bruce2012lu/AIDCtms_design202609/coolingplate/design/cfd_grace_cpu/GRACE_CPU_ICEM网格方案_v1.0.md

# Grace CPU 冷却区 ICEM 网格方案 v1.0

对象是 CP-GRACE-MC-01 的 CPU 区共轭传热网格：水、底板铜、肋、盖板帽和 TIM。这里的流固耦合是共轭传热，固体要解导热，流体壁面要解出层流速度剖面。不是结构应力网格。

几何取自《NVIDIA Grace GB300 冷板详细设计报告》v1.0 第 4 节，以及 `CP-GRACE-MC-01_calc.py`、`make_grace_concept.py` 的 `closeup()`。内存宽槽、整板孔板和盖板分流腔不在这个计算域里。

## 1. 通道

CPU 窗口 X 80–120 mm、Y 44–76 mm，热流 260 W / (40 mm × 32 mm) = 203125 W/m²。槽宽 0.40 mm，深 1.20 mm，节距 0.80 mm，沿 Y 长 32 mm，共 48 条。肋宽 0.40 mm。`closeup()` 用 49 根肋把 48 条槽夹在中间，肋场宽 38.8 mm，在 40 mm 窗口里每侧余 0.60 mm。

水力直径 0.60 mm。CPU 分到 0.47 L/min 时，槽内 0.34 m/s，Re = 310，层流。入口延长和出口延长各 6.0 mm，等于 10 Dh，截面与槽相同。延长段不加热。

水按报告的 40 °C：992 kg/m³，4179 J/kg·K，6.53×10⁻⁴ Pa·s，0.632 W/m·K。铜按 C11000，390 W/m·K。TIM 厚 80 μm 不在 Grace 图里，先用 B300 共轭算例的 8.818 W/m·K，等 TIM 图再换。

## 2. 单通道计算域

一个内部节距，x = 0 和 x = 0.80 mm 在肋的中面，对称。槽壁在 x = 0.20 和 0.60 mm。

局部 y 从上游延长段的端面算起，流动沿 +y。和冷板坐标的关系是板面 Y = 82 − y。y = 6 mm 是槽入口，板面 Y = 76；y = 38 mm 是槽出口，板面 Y = 44。冷液从后侧进液腔一侧进入，从前侧离开。

| 块 | 范围 (mm) | 单元 | 分布 |
|---|---|---|---|
| 左半肋 | x 0–0.20 | 6 | 贴槽壁 20 μm，比 1.203 |
| 流体 | x 0.20–0.60 | 32 | 两侧壁 2.5 μm，比 1.190 |
| 右半肋 | x 0.60–0.80 | 6 | 与左半肋镜像 |
| 进口延长 | y 0–6 | 30 | 0.20 mm |
| 加热段 | y 6–38 | 160 | 0.20 mm |
| 出口延长 | y 38–44 | 30 | 0.20 mm |
| TIM | z −0.08–0，仅加热段 | 4 | 均匀 20 μm |
| 底板铜 | z 0–2.0 | 18 | 上下表面 20 μm，比 1.404 |
| 槽高 | z 2.0–3.2 | 44 | 底和顶 2.5 μm，比 1.191 |
| 盖板帽 | z 3.2–4.2 | 9 | 贴流体 20 μm，比 1.404 |

z 3.2–3.5 的分型密封面含在盖板帽里。盖板在 z = 4.2 mm 以上没有进网格，切面是绝热。这条槽的热量从芯片侧进来，多出来的盖板铜对芯片温升只有零点几开的量级。

单元数：流体 309760，肋 116160，底板 174240，盖板帽 87120，TIM 28160，合计 **715440**。小于 100 万。

msh 用米。ICEM replay 用毫米。不要把两者叠在同一个视图里。

## 3. 边界层为什么够共轭计算

B300 方案里驻点要求首层 ≤ 3 μm、y⁺ < 1、壁面法向 ≥ 10 层、增长 ≤ 1.2，槽宽 ≥ 8、槽深 ≥ 12，肋和余铜厚度方向 ≥ 6。Grace 这条槽没有射流驻点，Re = 310，按层流矩形槽来落这些数。

槽宽的一半是 0.20 mm。首层 2.5 μm、增长不超过 1.2 时，16 层刚好铺到中面，整宽 32 层，相邻比 1.190。槽深的一半是 0.60 mm，同样的首层得到 22 层，整深 44 层，比 1.191。层流的速度剖面就是整条法向，所以没有再在边界层外面接一套粗核心。

充分发展矩形槽（Shah & London，短边/长边 = 1/3）的壁面摩擦给出 y⁺ = 0.214。入口剪切按充分发展的 5 倍估计，y⁺ = 0.48。两数都小于 1。这是估算，不是 Fluent 打出的 y⁺。

固体不跟流体共用 2.5 μm。铜里 20 W/cm² 穿过 2 mm 底板大约 1 K，首层 20 μm、增长 ≤ 1.5、厚度方向不少于 6 层。流体和铜在界面上的法向尺寸可以差一截，界面本身共节点。

流向 0.20 mm，第一层单元的长宽比是 80。正交六面体的正交质量是 1。长宽比 80 对这条层流槽可以接受；若把流向收到 0.10 mm，单通道会超过 100 万。

热充分发展长度比 32 mm 还长，整段都在发展。0.20 mm 的流向步长够描述沿程 Nu，不够代替实验。

## 4. 边界

| 区域 | 类型 | 值 |
|---|---|---|
| inlet | 质量流入口 | 1.61888889×10⁻⁴ kg/s，313.15 K |
| outlet | 压力出口 | 表压 0 |
| sym | 对称 | x = 0 和 x = 0.80 mm |
| wall_heat | 热流 | 203125 W/m²，在 TIM 底面 |
| wall_cu_fluid | 双侧壁 | 铜–水共轭 |
| wall_tim_cu | 双侧壁 | TIM–铜共轭 |
| wall_adi | 壁 | 热流 0 |

一个节距上的加热功率是 5.20 W。48 个这样的节距是 249.6 W；窗口两侧多出来的铜在整列网格里，凑满 260 W。

进口面积核对过：1408 个面，0.480 mm²，等于 0.40 × 1.20。出口同样 1408。加热面和 TIM–铜界面都是 7040。四个润湿面（底、顶、两侧）合计 33440，与 32×220×2 + 44×220×2 一致。进口面法向指向域内 +y，出口指向域内 −y，加热面指向域内 +z。

层流。不要套 B300 射流那套转捩 SST。

## 5. 整列 48 槽

单通道 715440 < 100 万，所以整列按同一套壁面法向往下排。

| 项 | 值 |
|---|---|
| 肋 / 槽 | 49 根肋，48 条槽，肋场 38.8 mm，居中于 X 80–120 |
| 窗口内余铜 | 每侧 0.60 mm，受热 |
| 窗口外肩 | 每侧 2.0 mm，不受热，用来留横向扩热 |
| 域 | 板面 X 78–122，Y 38–82（含两端延长），z −0.08–4.2 |
| 流体 | 32 × 48 = 1536 列，14868480 单元 |
| 内部肋 | 47 × 12 列；两根外肋各 6 列，只在贴流体的一侧加密 |
| 铜 | 18652040 |
| TIM | 1360640，只铺在 40 mm 窗口的加热段 |
| 合计 | **34881160** |

整列的铜是连在一起的，横向扩热在网格里。每条槽仍然是各自的进口和出口，流量按 48 等分。盖板里的进液腔、出液腔和入口孔板没有建。腔对 48 条槽的分配不在这套网格里。

3488 万单元的 ASCII msh 大约几个 GB，这次没有写出文件。骨架和单元预算在 `icem/build_grace_cpu_array.rpl` 和 `icem/array_budget.txt`。流体首层、增长和流向步长与单通道相同。

## 6. 文件

| 文件 | 作用 |
|---|---|
| `mesh/write_grace_cpu_hex.py` | 分布、单元预算、写 msh 和 replay |
| `mesh/grace_cpu_channel.msh` | 单通道 Fluent 网格，115 MB，米 |
| `mesh/grace_cpu_channel_info.txt` | 单元数、首层、y⁺ 估算、分区面数 |
| `icem/build_grace_cpu_channel.rpl` | 单通道 80 个角点、184 条边，毫米 |
| `icem/build_grace_cpu_array.rpl` | 整列 102 条分块线，毫米 |
| `fluent/grace_cpu_channel_check.jou` | 读网格并 mesh/check |
| `fluent/grace_cpu_channel_setup.jou` | 层流、能量、材料、边界，不迭代 |

ICEM：打开已有的 ICEM，File → Replay Scripts → Replay，选 rpl。Replay 保存 tetin 和边的节点数，不在批处理里生成 71 万六面体。Fluent 读 msh，不要读 tin。

本机 `E:\cae\programfiles\Ansys2026` 下没有 `fluent.exe` 和 `icemcfd.bat`，所以没有 ICEM 质量报告，也没有 Fluent 的 mesh/check。上面的面数和法向是对 msh 本身核对的。正交质量还没有软件打印。

重新生成：

```
python mesh/write_grace_cpu_hex.py
```
