bruce2012lu/AIDCtms_design202609/coolingplate/design/cfd_grace_cpu/GRACE_CPU_交错流网格方案_v1.0.md

# Grace CPU 冷却区交错流网格方案 v1.0

对象是 CP-GRACE-MC-01 的 CPU 区共轭传热网格。流固耦合指铜和水一起解导热与层流，不是结构应力。

坐标按《NVIDIA Grace GB300 冷板详细设计报告》v1.0 第 4 节：原点在冷板左下角，X 沿托盘宽度，Y 沿托盘进深、朝后面板和 GPU，芯片面 z = 0 朝下。CPU 窗口 X 80–120、Y 44–76，即 40 × 32 mm。

平行方案的 48 条槽沿 Y 同向流，流体沿程温升约 8 K，铜板温差落在 Y 上。本方案把相邻槽改成对向流，用肋和底板里的横向导热把这条沿程温差抹平。平均对流温升仍约 12 K。下面的 0.026 K 是集总估算，不是 CFD 结果。

平行槽的网格和说明留在 `mesh/grace_cpu_channel.msh`、`GRACE_CPU_ICEM网格方案_v1.0.md`。当前算例是这一对交错槽。

## 1. 一对槽

局部坐标：x 沿节距，y 沿流向，z 向上。局部 y = 0 是板面 Y = 44，局部 y = 32 是板面 Y = 76。板面 Y = 44 + 局部 y。

一对宽 1.60 mm，是两个 0.80 mm 节距。24 对就是原来的 48 条槽。本网格只含一对，对称面在肋中面 x = 0 和 x = 1.60。整列 48 槽没有写出。

| 块 | 局部 x (mm) | 流向 |
|---|---|---|
| 左半肋 | 0–0.20 | 对称面在 x = 0 |
| 偶数槽 | 0.20–0.60 | +Y，从前侧流向后面板 |
| 整肋 | 0.60–1.00 | |
| 奇数槽 | 1.00–1.40 | −Y，从后侧流向托盘前侧 |
| 右半肋 | 1.40–1.60 | 对称面在 x = 1.60 |

槽宽 0.40 mm，深 1.20 mm（z 2.0–3.2），加热段长 32 mm。水按报告 40 °C。铜 C11000，k = 390 W/m·K。TIM 厚 80 μm，k = 8.818 W/m·K，沿用 B300 共轭算例，等 Grace 的 TIM 图再换。热流 203125 W/m² 只加在局部 y 0–32 的 TIM 底面。

## 2. 进出口和 Z 向汇流

槽端在 Y 向封死。流体从水平廊道进入，碰到封板后经竖孔落入槽道。回液反过来，从槽端竖孔升进廊道再水平离开。供液在靠窗口的一侧，回液在外侧，两条槽不会短路。

| 口 | 局部 y | 板面 Y | 占的半节距 | 流动 |
|---|---|---|---|---|
| 奇数槽出口 | −8 | 36 | x 0.80–1.60 | 离开，朝前 |
| 偶数槽进口 | −4 | 40 | x 0–0.80 | 进入，朝后 |
| 加热段 | 0–32 | 44–76 | | |
| 奇数槽进口 | 36 | 80 | x 0.80–1.60 | 进入，朝前 |
| 偶数槽出口 | 40 | 84 | x 0–0.80 | 离开，朝后 |

偶数槽流体在局部 y −2.5 到 37.5，两端是铜壁。奇数槽流体在局部 y −5.5 到 34.5，两端是铜壁。竖孔只占槽宽 0.40 mm，z 3.2–4.3。廊道占半个节距 0.80 mm，z 4.3–5.6，高 1.30 mm。盖板网格收到 z = 6.6，顶面绝热。冷板总厚仍是 8.0 mm，z 6.6 以上没有进这个计算域。

这两个廊道是槽端的局部转弯，不是报告里横贯整板的后侧进液腔和前侧出液腔。把 24 对连起来的供液轨、回液轨不在网格里。两个进口各给一条槽的设计流量，用来代表汇流已经配好。

## 3. 网格

全六面体，正交。msh 用米，ICEM replay 用毫米。不要叠在同一个视图里。

| 项 | 值 |
|---|---|
| 单元 | 2487936（流体 718464，铜 1741312，TIM 28160） |
| 分割 | x 88，y 304，z 96 |
| 流向相邻比 | 最大 1.678 |
| 文件 | `mesh/grace_cpu_counterflow_pair.msh`，407 MB |

槽的三个润湿方向都有边界层。槽宽、槽深的流体首层 2.5 μm，增长不超过 1.2。槽宽 32 层，槽深 44 层。铜和 TIM 的首层 20 μm，增长不超过 1.5，厚度方向不少于 6 层。四个 Y 向封板的两侧都是 2.5 μm，所以封板两边的格子对齐。廊道和盖板不是受热面，那里用 20 μm 起的固体分布。流向核心格 0.40 mm。第一层流向长宽比约 160。

平行槽那次按充分发展摩擦估过 y⁺ = 0.214，入口剪切按 5 倍估是 0.48。这条槽的截面、Re 和首层与那次相同，量级仍小于 1。这是估算，不是 Fluent 打出的 y⁺。

偶数槽和奇数槽的流体没有共面，短路面数是 0。四个口的面积都是 1.04×10⁻⁶ m²，等于 0.80 mm × 1.30 mm。加热面 5.12×10⁻⁵ m²，等于 32 mm × 1.60 mm。一对的加热功率是 10.4 W，24 对是 249.6 W；窗口两侧多出来的铜在整列里，凑满 260 W。

进口面法向已在写出时核对：偶数进口指向域内 +Y，奇数进口指向域内 −Y，偶数出口指向域内 −Y，奇数出口指向域内 +Y。

## 4. 边界

| 区域 | 类型 | 值 |
|---|---|---|
| inlet_even、inlet_odd | 质量流入口 | 各 1.61888889×10⁻⁴ kg/s，313.15 K |
| outlet_even、outlet_odd | 压力出口 | 表压 0，回流温度 313.15 K |
| sym | 对称 | x = 0 和 x = 1.60 mm |
| wall_heat | 热流 | 203125 W/m²，TIM 底面 |
| wall_cu_fluid | 双侧壁 | 铜–水共轭 |
| wall_tim_cu | 双侧壁 | TIM–铜共轭 |
| wall_adi | 壁 | 热流 0 |

层流。不要套 B300 射流那套转捩 SST。

算例在 `fluent/grace_cpu_counterflow_setup.jou`，只读网格、设材料、能量、层流和边界，不迭代。`fluent/grace_cpu_counterflow_check.jou` 只做 mesh/check。本机 `E:\cae\programfiles\Ansys2026` 下没有 Fluent / ICEM 可执行文件，这两个 journal 还没有跑过。

ICEM 骨架是 `icem/build_grace_cpu_counterflow.rpl`。用 File → Replay Scripts → Replay 打开，不要另起一个 icemcfd。Fluent 只读 msh。

## 5. 一维对照

`calc_counterflow.py` 的输出。Nu = 4.8 仍是三边受热矩形槽的假设。两次 90° 转弯各取 K = 1.5，是估算。

| 量 | 平行 Y，48 槽 × 32 mm | 交错 Y，同样 48 槽 × 32 mm |
|---|---|---|
| 槽内流速 | 0.340 m/s | 0.340 m/s |
| Re | 310 | 310 |
| 槽道压降 | 0.707 kPa | 0.707 kPa |
| 两次转弯 | | 另加 0.172 kPa |
| 对流温升 | 11.96 K | 11.96 K |
| 流体温升 | 8.01 K | 8.01 K |
| 铜的沿程温差 | 约 8 K，沿 Y | 集总估算相邻槽壁面差 0.026 K |

肋和 2 mm 底板在 0.80 mm 节距上的横向导热，远大于一条槽沿 32 mm 把 8 K 拉平所需要的轴向导热。轴向导热算下来，8 K 温差只能带走 0.156 W。所以交错流要靠相邻槽的横向耦合，不是靠铜把热量沿流向传回去。
