bruce2012lu/AIDCtms_design202609/coolingplate/design/cfd_grace_LLDDRM/GRACE_LPDDR_ICEM网格方案_v1.0.md

# CP-GRACE-MC-01 LPDDR 冷却区 ICEM 网格 v1.0

对象是 Grace 冷板左侧 LPDDR5X 窗口里的平行宽槽，不是 CPU 的 48 条 0.40 mm 微通道。单通道节距单元 693770 个六面体，低于 100 万，因此按同一套边分布做了整侧 6 槽阵列，4162620 个六面体。

网格是按 ICEM 六面体分块的边参数生成的直角结构网格。Replay 只建几何。本文件没有 ICEM GUI 质量签字，也没有 Fluent 求解，所以 y+ 是层流摩阻估算，不是求解器输出。

## 1. 依据

口径来自 `design/NVIDIA_Grace_GB300_冷板详细设计报告_v1.0_20260926.html` 和 `design/memory/semantic/cp-grace-mc01.md`。概念图 `make_grace_concept.py` 里的内存肋是加粗示意，不作为网格尺寸。

| 项 | 冻结值 |
|---|---|
| 窗口 | 左窗 X 14–64，Y 25–95，即 50 × 70 mm。右窗同一套网格，X 平移到 136 |
| 槽 | 6 条，宽 1.20 mm，深 0.80 mm，流向沿 Y，长 70 mm |
| 节距 | 50/6 = 8.333333 mm。报告写「约 8 mm」，这里把它铺满候选窗口 |
| 槽间铜 | 壁到壁 7.133 mm。节距单元两侧各半条肋，半肋 3.5667 mm |
| 高度 | z 0–2.0 底板；z 2.0–2.8 槽或肋；z 2.8–3.2 槽顶铜 0.40 mm。CPU 槽才用满 1.20 mm 到分型面 |
| 流量 | 单侧 0.036 L/min，单槽 9.920×10⁻⁵ kg/s。水按 40 °C |
| 热流 | 一侧 20 W / (50×70 mm) = 5714.29 W/m²，加在 z = 0 |
| 不在本域 | 每侧入口限流缝 0.80 × 1.20 mm。它在进液腔上游，本网格入口已经是缝后的槽流量 |

局部坐标：x = X − 14，y = Y − 25，z = z。入口在 y = 70（板坐标 Y = 95），出口在 y = 0（Y = 25），流动沿 −Y。

## 2. 流固耦合对边界层的要求

这里的流固耦合指共轭传热：流体与 C11000 铜共节点，热流和壁面剪切都由近壁网格积分，不用壁面函数。

| 判据 | 采用值 | 本网格 |
|---|---|---|
| 流体第一层 | 12 μm | 槽宽、槽深两侧都是 12 μm |
| 贴壁 y+ | < 1 | 包络流速估算最大约 0.73 |
| 流体法向增长率 | ≤ 1.20 | 宽向 1.178，深向 1.173 |
| 壁到中心的层数 | ≥ 10 | 半宽 14 层，半深 12 层 |
| 铜侧第一层 | 与流体同为 12 μm | 肋、底板、槽顶都是 |
| 铜侧离开湿壁的增长率 | ≤ 1.25 | 肋 1.250，底板 1.246，槽顶 1.173 |
| 界面 | 共形，无悬挂节点 | 同一套直角分块 |
| 正交 | 直角六面体 | 正交质量为 1，未做 ICEM 行列式检查 |
| 长宽比 | 流体 ≤ 35，固体 ≤ 40 | 流体 33.2，固体 35.5 |

y+ 用矩形槽 Fanning 摩阻（Shah & London，短边/长边 = 0.667，fRe = 14.715，Darcy fRe = 58.86）。水力直径 0.96 mm。第一层 12 μm。1.5 是层流矩形槽最大剪切相对平均剪切的估算系数，不是 CFD 结果。

| 工况 | 流速 | Re | y+ = 1 的高度 | 12 μm 的平均 y+ | 乘 1.5 后 |
|---|---|---|---|---|---|
| 分流 0.104 m/s | 0.1042 m/s | 152 | 28.7 μm | 0.42 | 0.63 |
| 报告表 0.11 m/s | 0.110 m/s | 160 | 27.9 μm | 0.43 | 0.64 |
| 包络 0.70/0.55 | 0.140 m/s | 204 | 24.8 μm | 0.48 | 0.73 |

包络仍低于 1。设计点是层流，不需要 SST 壁面函数；12 μm 是为了把粘性底层直接算出来。

## 3. 分块

一个节距，x 从肋中面到肋中面：

```
z=3.2   wall_cap（绝热）
        +---------------- 槽顶铜 solid ----------------+
z=2.8   |  半肋 solid  |  流体 1.20×0.80  |  半肋 solid  |
z=2.0   +---------------- 底板铜 solid ----------------+
z=0     wall_heat（5714.29 W/m²）

x:  sym | 3.5667 mm | 1.20 mm | 3.5667 mm | sym
```

阵列把这个节距重复 6 次，铺满 x = 0–50 mm。窗外是实铜而不是镜像槽，所以阵列两侧用绝热壁 `wall_side`，不用对称。单通道节距单元才用肋中面 `sym`。

流向一条块，0–70 mm。入口端第一格 0.080 mm，出口端 0.20 mm，增长率 1.10，核心格不超过 0.40 mm。

## 4. ICEM 边参数（毫米）

流体两条边是两端对称的几何级数，可以直接填进 Blocking → Edge Params。

| 边 | 节点数 | 起点间距 | 比 1 | 终点间距 | 比 2 |
|---|---|---|---|---|---|
| 槽宽 1.20 | 29 | 0.012 | 1.1779 | 0.012 | 1.1779 |
| 槽深 0.80 | 25 | 0.012 | 1.1725 | 0.012 | 1.1725 |
| 流向 70 | 188 | 0.20（出口） | 1.10 | 0.080（入口） | 1.10，格不大于 0.40 |

铜边从湿壁向外几何增长，第一层仍是 0.012。

| 边 | 节点数 | 湿壁间距 | 比 |
|---|---|---|---|
| 半肋 3.5667 | 22 | 0.012 | 1.250，格不大于 0.45 |
| 底板 2.0，加密在 z=2 | 18 | 0.012 | 1.2459 |
| 槽顶 0.40，加密在 z=2.8 | 13 | 0.012 | 1.1725 |

## 5. 单元数

| 网格 | 单元 | 流体 | 铜 | nx × ny × nz |
|---|---|---|---|---|
| 单通道节距 | 693770 | 125664 | 568106 | 70 × 187 × 53 |
| 左侧 6 槽阵列 | 4162620 | 753984 | 3408636 | 420 × 187 × 53 |

单通道低于 100 万，所以阵列用了同一套分布，没有再加粗。阵列约为 6 倍节距，两侧半肋在相邻节距上合成整肋。

## 6. Fluent 边界

单位是米。两个单元区：`fluid`、`solid_cu`（C11000，k = 385 W/m·K）。耦合壁两侧都有单元，类型是 wall。

| 区 | 类型 | 单通道 | 阵列 |
|---|---|---|---|
| inlet | mass-flow-inlet | 9.920×10⁻⁵ kg/s，313.15 K | 5.952×10⁻⁴ kg/s，313.15 K |
| outlet | pressure-outlet | 0 Pa | 0 Pa |
| wall_heat | wall | z=0，5714.29 W/m² | 同左 |
| wall_cap | wall | z=3.2，绝热 | 同左 |
| wall_end | wall | 铜在 y=0 和 y=70 的端面，绝热 | 同左 |
| wall_cu_fluid | wall，coupled | 槽底、槽顶、两侧壁 | 6 条槽的全部湿壁 |
| sym | symmetry | 两个肋中面 | 无 |
| wall_side | wall，绝热 | 无 | x=0 和 x=50 |

粘性用层流。能量打开。这是边界设置，不是已经算完的场。

## 7. 文件

| 文件 | 作用 |
|---|---|
| `mesh/lpddr_mesh.py` | 边分布、单元预算、Fluent msh、ICEM replay |
| `mesh/sizing_report.txt` | 单元数、增长率、y+ 估算 |
| `mesh/lpddr_channel_cht.msh` | 单通道共轭网格，米 |
| `mesh/lpddr_array_cht.msh` | 6 槽阵列共轭网格，米 |
| `icem/build_lpddr_channel.rpl` | 单通道几何 replay，毫米 |
| `icem/build_lpddr_array.rpl` | 阵列几何 replay，毫米 |
| `icem/lpddr_channel.tin` / `lpddr_array.tin` | ICEM 已写出的几何 |
| `icem/run_channel.bat` / `run_array.bat` | 调 ANSYS 2026 R1 ICEM 批处理 |

两条 replay 已在本机批处理跑通，许可证检出 `cfd_preppost`，并写出上面两个 tin。tin 是几何和 part 名。体积网格是 Fluent msh，按同一套边参数生成，不是 ICEM Blocking 里求出的网格。

## 8. 还没有做的

- ICEM 只保存了几何 tin，没有在 Blocking 里做行列式、角度和负体积签字。直角分块的正交性来自坐标轴对齐。
- 没有跑 Fluent，因此没有求解器 y+、热阻和压降。
- 入口限流缝和进、出液腔没有划进这个窗口。六条槽的流量按均分给定。
- 右窗不另做网格，把左窗 msh 的 X 加上 122 mm 即可。
