bruce2012lu/AIDCtms_design202609/coolingplate/design/cfd_HBM/mesh/hbm_array_info.txt

case array
nx 400
ny 143
nz 84
cells_fluid 1121120
cells_cu 3340480
cells_tim 216000
cells_total 4677600
ratio_x 1.1779
ratio_y 1.2000
ratio_z 2.0000
yplus_DP-A 0.455 Re 516.8 tau 1.392
yplus_DP-B 0.499 Re 620.2 tau 1.671
first_fluid_mm 0.008
first_solid_mm 0.016
Le_mm 11.4286
heated_cells_y 90
nodes 4908240
faces 14142494
msh D:\agents2026\agents2026\agents\AIDCtms\coolingplate\design\cfd_HBM\mesh\hbm_w08h20.msh
mdot_kg_s 3.30733333e-03
q_Wm2 205000.0
k_tim 8.818342
width_mm 11.0
zone interior 13750970
zone wall_cu_fluid 136136
zone wall_tim_cu 36000
zone inlet 7840
zone outlet 7840
zone wall_heat 36000
zone wall_adiabat 144320
zone wall_side 23388
