bruce2012lu/AIDCtms_design202609/coolingplate/design/cfd/uc01b_2.4x3.0/UC01b_ICEM_Fluent_工作方案_v1.0.md

# UC-01b 单孔单元胞 ICEM / Fluent 工作方案与计划

**文档编号：** AIDC-B300-CFD-UC01b-PLAN-001  
**版本：** v1.0  
**日期：** 2026-09-21  
**算例：** UC-01b　各向异性单孔流体 coupon  
**目录：** `design/cfd/uc01b_2.4x3.0/`  
**本文件性质：** 开工方案 + 执行计划。**不是**仿真结果报告。结果报告只能在 Fluent 至少跑出残差 / 监视器之后另写。

---

> **2026-09-25 已收敛并写盘（DP-A，网格不改）。** 9×12 = 108 孔/die，共 216。施加 q''=579282.4074074075 W/m²（57.92824074074075 W/cm²，名义 55.16975308641976 的 1.05 倍），单孔 ṁ=1.2249382716049385×10⁻⁴ kg/s（不加 5%）。`fluent/uc01b_cht_v2_n216_q105.cas.h5`（115480951 字节，12:15:11）与 `.dat.h5`（461963782 字节，12:15:19）。日志 `logs/fluent_cht_v2_n216_q105.log`：`8587  1.6618e-07  1.3524e-07  1.7518e-07  2.5383e-07  9.9436e-07  5.8504e-07  2.4913e-04`，随后 `8587 solution is converged`，`write-case-data` 完成。4 核 + GPU。omega=2.4913e-04 不是收敛判据。当前结果是这场：U=0.9824 m/s，Re_D=597.1。TIM 底 341.9327 K，静压差 1088.1265 Pa。

## 0. 结论（先读）

本算例只做 **一孔 + 三短槽 + ±X 回液缝上抽** 的流体单元胞，禁止整板 95×75 mm、禁止 128 孔共轭、禁止把槽当成「一条长河」的 bank 流。

| 冻结项 | 值 |
|---|---|
| 单元胞 | \(S_x=3.0\) mm（沿槽）× \(S_y=2.4\) mm（跨槽） |
| 孔径 | **D = 0.40 mm**（主方案）。`model.py` GEO 默认仍是 0.50 mm，本文凡引用一维带会同时给出 D=0.50 原值与 D=0.40 重算 |
| 间隙 / 槽 | H = 2.0 mm；槽 0.40×1.50 mm，节距 0.80 mm，中槽对孔 |
| 回液 | 物理缝宽 0.80 mm，落在 ±X 端，上抽。本胞各见半缝 0.40 mm（与 X 向邻胞共享） |
| 单孔质量流 | **ṁ = 1.2249382716049385×10⁻⁴ kg/s** ＝ GPU 1.60 L/min ÷ 216 孔（DP-A，iter 8587）。**不是** 2.0 L/min/孔 |
| 工质 | DI 水 40 °C，常物性 |
| 第一案模型 | **层流必跑**（Re_D = 597.1）。SST 低 Re 为包络，有时间再跑 |
| 网格 | 首层 ≤ 3 μm，目标 y⁺ < 1；hex 优先，目标 0.8–2.5 M；hex blocking 过难则 tet/prism 并声明 |
| 整板压降窗 | **20 kPa 是冷板本体窗，不含 UQD** |
| 四步流程 | ① 本方案 → ② ICEM 几何+网格 → ③ Fluent 计算（必做）→ ④ 结果报告 HTML+MD |

ANSYS 本机根：`E:\cae\programfiles\Ansys2026`。实际版本树为 **2026 R1 / v261**：

- `AWP_ROOT261` = `E:\cae\programfiles\Ansys2026\ANSYS Inc261\v261`
- ICEM：`...\v261\icemcfd\win64_amd\bin\icemcfd.bat`
- Fluent：`...\v261\fluent\ntbin\win64\fluent.exe`

---

## 1. 目标、范围、非目标

### 1.1 目标

1. 用 ICEM 建出与 `calc/model.py` GEO + `UC01_壁面射流与三槽流路说明.html` / `fig_walljet.py` 对齐的 **单孔流体域**。
2. 打出可被 Fluent 读入的网格（优先结构化 hex：孔 O-grid + 槽 H 网格；不行则 tet/prism）。
3. 用 TUI journal 启动 Fluent：**层流、水 40 °C、ṁ = 1.224938e-4 kg/s、回液缝压力出口**。已收敛场是 iter 8587。
4. 至少得到残差曲线和若干监视器（ΔP、若可能则 wall_imp 面平均 h）。不要求过夜收敛。
5. 用实测残差/监视器写结果报告。禁止编造云图或「已收敛」的 Nu。

### 1.2 非目标（本周禁止）

- 95×75 mm 整板、128 孔、HBM 槽、静压箱+水嘴全模。
- 用本单元胞 h 外推整板 R_θ,c-in（设计报告 v2.0 §10.3）。
- 1/4 对称（进出口沿程不对称，报告已禁）。
- 长槽 bank 流（全流量单向穿全部槽）。真实拓扑是 **单孔就近排走**。
- PG25、热点 2.5×、堵塞 20%（C08–C10）。
- 把 2.0 L/min 当成单孔流量。
- 把 20 kPa 当成「含 UQD 的机柜接口压降」。

### 1.3 读者与责任

| 角色 | 责任 |
|---|---|
| Agent | 写方案、ICEM replay/Tcl、Fluent journal、批处理、日志、对照表；不得编造未跑出的场 |
| 人（仿真） | 许可证、ICEM GUI 救阻塞、目视网格、过夜收敛、是否开 SST |
| 人（热设计） | 出口定义若要改口、D=0.40 是否回写 GEO |

---

## 2. 几何冻结表

坐标系：原点在中槽底面中心；**+X 沿槽 / 平行槽**；**+Y 跨槽 / 垂直槽**；**+Z 向上**（射流 −Z 打到壁面）。

### 2.1 与代码 / 说明页的对照

| 量 | 符号 | UC-01b 本算例 | `model.py` GEO 默认 | 出处 |
|---|---|---|---|---|
| 沿槽节距 | S_x | **3.0 mm** | S_jet = 3.0 mm | 用户冻结；GEO |
| 跨槽节距 | S_y | **2.4 mm** | （原说明页曾按 3.0 画顶视） | 用户冻结；三槽刚好装满 |
| 孔径 | D | **0.40 mm** | 0.50 mm | 用户最近取值；说明页 UC-01b |
| 间隙（盖下表面→肋顶） | H | 2.0 mm | H_jet = 2.0 | GEO |
| H/D | — | **5.0** | 4.0 | 派生 |
| S_x/D，S_y/D | — | **7.5，6.0** | 6.0，6.0（按 S=3、D=0.50） | 派生 |
| 相对喷嘴面积 f | A_jet/(S_x S_y) | **0.01745** | 0.02182（D=0.50、S=3×3） | 派生 |
| 盖板厚 | t_lid | 2.5 mm（流体域建孔段；固体可切） | 2.5 | GEO |
| 短静压箱 | H_plenum | ≥ 2.0 mm（≥5D，能建就建） | 计划建议 ≥4D | 本方案 |
| 槽宽 × 槽深 | ch_w × ch_h | 0.40 × 1.50 mm | 同左 | GEO / fig_walljet |
| 槽节距 / 肋厚 | ch_p / rib | 0.80 / 0.40 mm | 同左 | GEO |
| 回液缝物理宽 | w_slit | 0.80 mm | 同左 | fig_walljet `SLIT` |
| 本胞可见半缝 | w_slit/2 | **0.40 mm**（±X 各一条） | 说明页「周期缝本胞各见一半」 | 冻结 |
| 余铜 | t_base,cu | 不建（流体-only） | 2.0 mm | UC-01；UC-02 才共轭 |

### 2.2 Y 向三槽装填（必须 2.4 mm 刚好）

`3×槽 + 2×满肋 + 2×半肋 = 3×0.40 + 2×0.40 + 2×0.20 = 2.40 mm`。

| Y 区间 (mm) | 零件 | 说明 |
|---|---|---|
| [−1.20, −1.00] | 半肋（周期/对称面） | 邻胞共享 |
| [−1.00, −0.60] | 侧槽 − | 中心 Y = −0.80 |
| [−0.60, −0.20] | 满肋 | |
| [−0.20, +0.20] | **中槽** | 正对孔 |
| [+0.20, +0.60] | 满肋 | |
| [+0.60, +1.00] | 侧槽 + | 中心 Y = +0.80 |
| [+1.00, +1.20] | 半肋（周期/对称面） | 邻胞共享 |

侧槽中心距孔轴 r = 0.80 mm ≈ **2.0 D**，落在壁面射流扫过带（说明页图 2）。

### 2.3 X 向回液与槽长

| X 区间 (mm) | 零件 |
|---|---|
| [−1.50, −1.10] | −X 半缝（上抽） |
| [−1.10, +1.10] | 三槽 + 间隙主体（槽长 2.20 mm） |
| [+1.10, +1.50] | +X 半缝（上抽） |

若有人要求「缝宽 0.80 全部落在本胞、不与 X 邻胞共享」，记为备选 **UC-01b-isolated**，本方案不采用。

### 2.4 Z 向堆叠（流体-only coupon）

| Z (mm) | 域 | 网格要点 |
|---|---|---|
| 0 → 1.50 | 三槽腔 + 两端回液缝根部 | 槽底 = wall_imp（中槽驻点在此） |
| 1.50 → 3.50 | 间隙 H=2.0；肋顶是壁面射流贴壁面 | 肋顶加密 |
| 3.50 → 6.00 | 盖板孔段 ⌀0.40，长 2.5 mm | 轴向 ≥ 8 层；径向 ≥ 8–12 |
| 6.00 → 8.00 | 短静压箱 ≥ 2 mm | 顶面 = inlet_jet |

固体铜、盖板实体、余铜 **第一案不建**。

### 2.5 流路（禁止改口）

**下射 → 驻点 → 壁面射流沿 ±X（并扫入侧槽）→ 回液缝向上抽走。**

- ① 自由射流：孔内 / 间隙中尚未撞壁，方向 −Z。
- ② 驻点：仅中槽底正对孔。
- ③ 壁面射流：转 90° 后贴肋顶 / 槽口的薄剪切层，**不是**槽底导管流。
- 回液：±X 端缝向上。Y 向邻孔在 Y=±1.2 mm 相遇，预期 **喷泉 / 上洗**。

### 2.6 命名零件（ICEM parts = Fluent zones）

| Part | 类型 | 位置 |
|---|---|---|
| `inlet_jet` | mass-flow-inlet | 静压箱顶（或孔顶，若未建箱） |
| `wall_orifice` | wall | 孔圆柱壁 |
| `wall_lid` | wall | 盖板下表面（间隙顶，除孔外） |
| `wall_imp` | wall，等温建议 50 °C | 槽底 + 驻点铜壁 |
| `fin` | wall | 肋侧壁 + 肋顶 |
| `return_slot` | pressure-outlet | 两条回液缝顶面（上抽出口） |
| `periodic_y` 或 `SYM` | periodic 或 symmetry | Y = ±1.2 mm |
| `fluid` | cell zone | 全部流体 |

X 向两端是回液出口，**不是**周期面。

### 2.7 D = 0.40 而不是 0.50

主方案锁定 **D = 0.40 mm**。仅当 ICEM 孔周 O-grid 在 0.40 上数值病态（边长比极端、负体积）时，允许先用 0.50 调试 blocking，但必须：

1. 在日志里写明原因；
2. **仍然交付 0.40 的 replay / 网格作为主文件**；
3. 不得把 0.50 网格的 Nu 当成 0.40 结果。

本方案判断：0.40 与槽宽同量级，blocking 并不比 0.50 更难，**不换直径**。

---

## 3. 水力 / 热力锚点（DP-A）

工质 DI 水 40 °C（`WATER40`）：ρ = 992.2 kg/m³，μ = 6.53×10⁻⁴ Pa·s，k = 0.631 W/m·K，c_p = 4179 J/kg·K，Pr = 4.325。

### 3.1 流量拆分（不得读错）

| 量 | 值 | 含义 |
|---|---|---|
| 冷板总流量 | **2.00 L/min** | DP-A 整板，**不是单孔** |
| GPU 份额 | 80% → **1.60 L/min** | `SPLIT_GPU` |
| HBM 份额 | 0.40 L/min | 本单元胞不建 |
| 孔数 | **216**（9×12 × 2 die） | iter 8587 的阵列 |
| 单孔体积流 | 1.60 / 128 = **0.0125 L/min** | |
| 单孔质量流 | 992.2 × (1.60/60000) / 216 = **1.224938×10⁻⁴ kg/s** | Fluent 入口，iter 8587 |

176 孔备选：ṁ = 1.503×10⁻⁴ kg/s。本算例 **不用**，除非书面改口。

### 3.2 射流状态（同一 ṁ，不同 D）

| | D = 0.50（GEO / 报告 §9） | **D = 0.40（本算例）** |
|---|---|---|
| U | 1.061 m/s | **0.9824 m/s**（iter 8587） |
| Re_D | 806 | **597.1** |
| 孔口 ΔP（K=1.8） | 1.01 kPa | **2.45 kPa** |
| Martin 有效域 | Re < 2000，外推 | **仍 < 2000，仍外推** |

V4 锚定（本几何、D=0.40）：把 ṁ 放到 Re_D = 3000 → ṁ ≈ 6.15×10⁻⁴ kg/s，V ≈ 4.94 m/s。**不是运行点**，本周不必跑；G3 关闭前不得把设计点 Nu 当成已锚定。

### 3.3 一维对照带（阶段 4 的尺子）

设计报告乐观/保守带按 **D=0.50、S=3×3、Re=806** 算出：

| 模型 | h 或 h_eff | 对流热阻 | 说明 |
|---|---|---|---|
| 乐观 Martin 面平均 | 51470 W/m²K | 0.0128 °C/W | Re 外推 |
| 保守 短槽+驻点核 | 27460 W/m²K | 0.0241 °C/W | h_ch≈6379，h_stag≈32181 |
| 目标 R_θ,c-in | — | 整板 0.028 °C/W | 单元胞 **不可比** |

Re_D=597.1，低于 Martin 1977 的 Re≥2000，不引用 Martin 的 h。  
**本周可比：** 孔口 ΔP 量级（对 2.45 kPa）、wall_imp 面平均 h 是否落在数万 W/m²K、层流残差是否下降。  
**本周不可比：** 整板 R、歧管 3–5 kPa、128 孔流量偏差。

### 3.4 必须写在方案里的两句约束

1. **20 kPa 是冷板本体压降窗（目标 18、上限 20），不含 UQD / 快接头。** 单元胞孔口只有约 1–3 kPa，对不上 20 kPa 是正常的。
2. **2.0 L/min 是整板总流量。** 单孔 0.0125 L/min。把 2.0 填进 mass-flow-inlet 视为本计划失败。

---

## 4. ICEM 工作流

顺序锁死：**几何 → 命名 parts → blocking → 生成网格 → 质量表 → 写出 Fluent msh**。不得先加密再补面名。

### 4.1 几何

优先在 ICEM 内用点/线/面/体素构造（便于 replay），不必先经过整板 STEP。

1. 建外盒与半缝、三槽腔、间隙、孔圆柱、短静压箱。
2. 布尔得到单一流体体。
3. 尺寸与 §2 误差 < 0.01 mm。
4. 孔必须是圆；第一案可用等面积方孔（边长 0.3545 mm）作 **应急网格**，但 ICEM 主文件仍应建圆孔。

批处理：

```bat
set AWP_ROOT261=E:\cae\programfiles\Ansys2026\ANSYS Inc261\v261
set AWP_ROOT=%AWP_ROOT261%
"%AWP_ROOT261%\icemcfd\win64_amd\bin\icemcfd.bat" -batch -script build_uc01b.rpl
```

GUI：ICEM → File → Replay Scripts → Replay / 打开本目录 `.rpl`。

### 4.2 Parts

按 §2.6 建 family。导出前用 `ic_geo_set_part` / blocking association 对齐，避免 Fluent 里出现 `wall.1` 匿名面。

### 4.3 Blocking（hex 优先）

| 区域 | 拓扑意图 |
|---|---|
| 孔 + 静压箱 | O-grid，径向 ≥ 8–12，轴向 ≥ 8 |
| 间隙 | H 网格，法向 ≥ 20；肋顶第一层 ≤ 3 μm |
| 三槽 | 各一条砖，槽宽 ≥ 8 层，槽深几何增长 |
| 回液缝 | 竖向砖，与槽端 1:1 对接 |
| Y 边界 | 半肋处周期或对称，两侧点数必须一致 |

若 O-grid 关联失败：改 tet + 壁面 prism（首层仍 ≤ 3 μm），在日志写明「非 hex」，**不要假称已做结构化质量检查**。

### 4.4 网格指标

| 指标 | 目标 | 第一案可接受 |
|---|---|---|
| 壁面第一层 | ≤ 3 μm | 必须 |
| 驻点法向层数 | ≥ 15 | ≥ 10 可开算，报告注明 |
| 孔径向 | ≥ 8–12 | 8 |
| 孔轴向 | ≥ 8 | 8 |
| 间隙法向 | ≥ 20 | 12 |
| 单元数（hex） | 0.8–2.5 M | 为出残差可先 0.2–0.8 M，正式套再加密 |
| 正交质量 | min > 0.15 | 负体积 = 失败 |
| y⁺（设计点） | < 1 | 用 V=1.66 m/s 估：3 μm 大约 y⁺≈0.5–1.2 |
| y⁺（V4 Re=3000） | < 1 | 速度×3，可能要 1 μm；本周可不跑 V4 |

粗/中/细 1 : 1.5 : 2.25 是 G2 关闭条件，不是第一次出残差的条件。

### 4.5 质量门（未跑 ICEM 不得声称已检查）

必须留下：单元数、min/max 正交、负体积数、第一层厚度、导出 `.msh` 路径。许可证或 GUI 挡住时，保留脚本 + 完整错误日志。

---

## 5. Fluent 设置（必做，不是可选项）

### 5.1 启动

```bat
set AWP_ROOT261=E:\cae\programfiles\Ansys2026\ANSYS Inc261\v261
"%AWP_ROOT261%\fluent\ntbin\win64\fluent.exe" 3ddp -t8 -g -i fluent\uc01b_laminar.jou
```

核数不得超过许可证。许可证失败必须原文记入日志，不得改写成「已算完」。

### 5.2 模型

| 项 | 第一案（必跑） | 第二案（有时间） |
|---|---|---|
| 名称 | UC-01b-L-1008 | UC-01b-S-1008 |
| 状态 | 稳态、不可压、双精度 | 同左 |
| 粘性 | **层流** | k-ω SST 低 Re / 增强壁面 |
| 能量 | 开（为了 h） | 开 |
| 工质 | 水，常物性 40 °C | 同左 |
| ṁ | 1.224938e-4 kg/s | 同左 |
| T_in | 313.15 K | 同左 |
| 出口 | return_slot，P_gauge = 0 | 同左 |
| wall_imp | 等温 323.15 K | 同左 |
| 其他壁 | 绝热 | 同左 |
| Y 面 | 先 SYM，后可改 periodic | 同左 |
| 迭代 | 50–200 步即可交差；过夜收敛另排 | 同左 |

γ-Re_θ 本单元胞不强制。

### 5.3 边界与 ṁ

- `inlet_jet`：mass-flow-inlet，ṁ = **1.224938e-4 kg/s**，垂直于面，T = 313.15 K。施加 q''=579282.41 W/m²。
- `return_slot`：pressure-outlet，0 Pa（表压），回流 T = 313.15 K。
- 禁止把 2.0 L/min 或 1.60 L/min 整支路填进单孔入口。

### 5.4 监视与提取

1. 连续性 / x,y,z 动量残差。
2. 能量残差（若开能量）。
3. 入口平均静压（相对出口 ≈ 孔+弯+缝 ΔP）。
4. 质量不平衡。
5. 若能量已开：`wall_imp` 面平均 h（参考 T = T_in）。

写出：`fluent/residual.out`、`fluent/monitors.csv`、`fluent/uc01b_L.cas.h5`（或 `.cas`）。  
**未迭代出的云图不得出现在结果报告里。**

### 5.5 收敛（过夜标准，本周不强制）

报告 §10.8：连续/动量 < 1e-4，能量 < 1e-6；h 与 ΔP 连续 500 步漂移 < 0.5%；质量不平衡 < 0.1%。  
本周成功定义：journal 能启动 + 至少数十步残差落盘。残差仍高必须照实写。

---

## 6. 闸门 G0–G4

前一扇门不关，后一扇门的「结论」不得宣布。脚本可以提前写。

| 闸门 | Go 条件 | 未满足时允许 | 禁止 |
|---|---|---|---|
| **G0 环境** | 找到 ICEM 与 Fluent 可执行文件；许可证能 checkout ≥ 4 核 | 写方案、写脚本、写几何 | 声称「CFD 已完成」 |
| **G1 几何** | 尺寸 = 冻结表，parts 名齐全 | 改 replay | 进入「网格已合格」 |
| **G2 网格** | 有 `.msh`；无负体积；第一层 ≤ 3 μm 或声明未达；单元数已记录 | 粗网格开 Fluent 出残差 | 声称 y⁺ 已检查（若求解器没跑） |
| **G3 短算** | Fluent 层流至少起步，残差/监视器落盘 | 写真实残差 | 编造 Nu、云图、过夜收敛 |
| **G4 与 1D 对照** | 报出 ΔP 与（若有）h；对照 §3；层流 vs SST 若只跑了层流必须声明 | 指出超带原因 | 改孔径/槽深、外推整板 R |

设计报告还有 G5 扩阵（8×8），本算例不做。

V4（Re≈3000 对 Martin <15%）仍是科学锚，本周不作为交货门；G4 只能说「设计点包络的起步」，不能说「Martin 已锚定」。

---

## 7. 风险

| 编号 | 风险 | 等级 | 缓解 |
|---|---|---|---|
| RK-Y1 | **Y=±1.2 mm 喷泉 / 上洗**。Sy/2 只有 3D，邻孔壁面射流在周期/对称面相撞，侧槽分流与 h 会被抬或被歪 | 高 | Y 面先 SYM（强制喷泉，与周期阵列一致）；结果里必须讨论；不得把 UC h 当整板边缘孔 |
| RK-Re | Re_D=597.1 < Martin 下限 2000（iter 8587） | 高 | 本周只报数字与带宽；V4 另案 |
| RK-HEX | 圆孔 + 三槽 + 半缝的 hex blocking 在纯 Tcl 下极易失败 | 中 | replay 先求「能出网格」；失败则 tet/prism 或等面积方孔应急 hex，日志诚实 |
| RK-LIC | 许可证拒绝 ICEM hexa / Fluent | 高 | 全文保留错误；不改写成成功 |
| RK-BC | 把回液缝建成 X 周期，或建成沿槽长出流（bank） | 高 | parts 名写死；flow 只许上抽 |
| RK-Q | 入口误填 2.0 L/min | 高 | journal 写死 1.224938e-4；方案 §3.4 |
| RK-dP | 用单元胞 ΔP 去对 20 kPa | 中 | 20 kPa 不含 UQD，且含歧管；单元胞只对孔口 kPa 量级 |
| RK-y+ | 3 μm 在驻点可能贴着 y⁺≈1，V4 会超 | 中 | 设计点先跑；V4 再减首层 |
| RK-RPL | 未在 GUI 录过的 replay 一改拓扑就断 | 中 | 人可录一条黄金 replay；Agent 只改参数 |

开放项（本方案已给默认，改口须书面）：

| 编号 | 默认 |
|---|---|
| O-01 出口 | ±X 半缝上抽 = UC-01b。不用环缝、不用槽端水平出流 |
| O-02 网格器 | ICEM hex 优先；失败 tet/prism 或应急笛卡尔 hex |
| O-03 Y 边界 | 先 SYM，后 periodic |
| O-04 孔数 | 128。不用 176 |
| O-05 孔径 | 0.40 mm 主文件 |

---

## 8. 成功判据（对 1D 的 h、ΔP）

| 提取 | 和谁比 | 本周通过线 |
|---|---|---|
| 残差文件存在 | — | journal 启动且迭代 ≥ 1 |
| 质量不平衡 | 0 | 能报出来就写；< 0.1% 是过夜线 |
| 入口–出口 ΔP | D=0.40、K=1.8 → **2.45 kPa** | 量级 0.5–8 kPa 可讨论；差一个数量级先查出口 |
| wall_imp 面平均 h | 报告带 2.7e4–5.1e4（D=0.50）；本几何 Martin 外推 ~6.5e4 | 能提取就对照；提取失败如实写 |
| 层流 vs SST | 差 >20% 只给区间 | 本周只跑层流则声明「无 SST 包络」 |
| 整板 R_θ,c-in | 0.0202–0.0355 °C/W | **禁止用本算例关闭** |

---

## 9. 文件树

```
design/cfd/uc01b_2.4x3.0/
  UC01b_ICEM_Fluent_工作方案_v1.0.html
  UC01b_ICEM_Fluent_工作方案_v1.0.md          ← 本文件
  README.md
  icem/
    build_uc01b.rpl / build_uc01b.tcl
    uc01b.prj, .tin, .blk, .uns            （跑通才有）
  mesh/
    write_hex_msh.py                       （应急笛卡尔 hex）
    uc01b.msh                              （跑通才有）
  fluent/
    uc01b_laminar.jou
    uc01b_sst.jou                          （可选）
    residual.out / monitors.csv            （跑通才有）
  logs/
    ansys_paths.txt
    icem_batch.log
    fluent_batch.log
  UC01b_ICEM_Fluent_结果报告_v1.0.html       ← 步骤 4，Fluent 起步后才写
  UC01b_ICEM_Fluent_结果报告_v1.0.md
```

---

## 10. 谁跑什么、工时

| 步骤 | 内容 | 谁 | 工时 |
|---|---|---|---|
| 1 | 本方案 HTML+MD | Agent | 1–1.5 h |
| 2a | ICEM 几何 + replay | Agent | 3–6 h（hex 上限） |
| 2b | 批处理出 msh；失败则 tet 或应急 hex | Agent；人救 GUI | 1–3 h |
| 2c | 网格 QA 表 | Agent 摘日志；人看切面 | 1–2 h |
| 3a | Fluent 层流 journal + 短残差 | Agent 批处理 | 1–3 h |
| 3b | SST 包络 | Agent / 人 | +1–2 h（可选） |
| 3c | 过夜收敛 | 人 | 另排，本周不占 |
| 4 | 结果报告 HTML+MD（只写真实输出） | Agent | 1–2 h |
| **合计（本周最小闭环）** | | | **约 8–16 h** |
| 正式三套网格 + V4 + SST | | | 再 +1–2 工作日 |

---

## 11. 执行顺序（冻结，四步）

1. **方案+计划**（本 HTML / 本 MD）写完并自检目录、闸门、ṁ、20 kPa、2.0 L/min。
2. **ICEM 几何 + 网格**。批处理优先；失败留日志。不得在无网格时写结果报告。
3. **Fluent 计算（必做）**。层流第一。即使只跑几十步，也要残差文件。
4. **结果报告 HTML+MD**。只引用步骤 3 的文件。没有残差就还不能写第 4 步。

---

## 12. 与既有文档的关系

| 文档 | 关系 |
|---|---|
| `calc/model.py` | 数值唯一源。本算例 D、S_y 按用户冻结覆盖 GEO |
| 设计报告 v2.0 §9 / §10 | Q1 局部 h 的需求规格；C01 整板不在本周 |
| `CFD-AI_Agent_能力评估与工作计划_v1.0` | 能力边界与 G0–G5；本文件是 UC-01b 的开工令 |
| `UC01_壁面射流与三槽流路说明.html` | 流路与三区；S_y 已从 3.0 收到 2.4 |

---

*AIDCtms / coolingplate / design / cfd / uc01b_2.4x3.0 · 工作方案 v1.0 · 2026-09-21*  
*保证点 DP-A 1100 W @ 2.0 L/min（整板）· GPU 1.60 L/min / 216 · ṁ_jet = 1.224938e-4 kg/s · iter 8587*  
*20 kPa 冷板窗不含 UQD。本文不是仿真报告。*
