bruce2012lu/AIDCtms_design202609/coolingplate/design/cfd/uc01b_2.4x3.0lessmesh/memory/semantic/uc01b-lessmesh-bc216.md

# UC-01b lessmesh 216 孔边界

- confidence: 0.85
- valid_until: 2026-12-31
- last_verified: 2026-09-25
- expired: false

当前设计场是 `fluent/uc01b_cht_less_bc216.cas.h5`，iter 421，`solution is converged`。`inlet_jet` 是单孔，质量流 **1.225e-4 kg/s**（未乘 108/216）。`wall_heat` 热流 **579282 W/m²**。Y 向胞 2.4 mm，未重划网格。静压降 **1091.51 Pa**。TIM 底 **342.096 K**。窗口在质量流报告 TUI 报错后退出（`set-batch-options` 遇错退出），场已在报错前写完。
