bruce2012lu/AIDCtms_design202609/coolingplate/design/cfd_grace_cpu/NVIDIA_Grace_GB300_冷板详细设计报告_v1.0_20260926.html

COLD PLATE DETAILED DESIGN · GRACE ON GB300 NVL2

# NVIDIA Grace GB300 冷板详细设计报告

一颗 Grace 一块铜。平行微通道覆盖 CPU 裸片，宽槽覆盖两侧 LPDDR5X。型号 CP-GRACE-MC-01。

AIDC-GRACE-CP-MC-001 v1.0 · 2026-09-26 单相水 · 紫铜 · 两层 300 W 含内存 候选外形 · 待盖板图

## 0. 结论

GB300 计算托盘上的 Grace 用一块独立的两层铜冷板，型号 CP-GRACE-MC-01。热设计点 300 W，已经包含 LPDDR5X。CPU 区走平行微通道，内存区走低速宽槽，板上不设微射流。进液口在板的左侧，出液口在右侧，从后面板沿 PCB 两侧绕过来，不穿过 B300 冷板。

300 W单颗 Grace，含内存

0.55 L/min设计流量 · 温升约 8 K

10 kPa支路压降目标，靠入口孔板配平

2 块 / 托盘每块 NVL2 一颗 Grace

这一版能冻结的，和还不能冻结的：功率、工质、流路拓扑、和 B300 冷板的水力关系可以冻结。平面外形、裸片窗口、螺孔还没有官方盖板图，下文尺寸凡是标「候选」的，等 ICD 替换，不作为加工发放尺寸。

## 1. 范围与口径

项 | 口径
对象 | Lenovo GB300 NVL72 计算托盘上的一颗 NVIDIA Grace。一块冷板盖住该颗 CPU 及其板载 LPDDR5X。
数量 | 每块 GB300 NVL2（一块 HPM）一颗 Grace、一块冷板。一个计算托盘两块。不覆盖 B300、CX-8、NVSwitch。
来源底账 | 参考摘录。功率以 Lenovo Press LP2357 为准。
不用的口径 | Grace CPU Superchip 的约 500 W 模块；Grace C1 的 140–250 W 档；宣传材料里的内存约 16 W；B300 冷板的 1100 W / 2.0 L/min / 128 孔。
核算 | 一维水力，脚本 CP-GRACE-MC-01_calc.py。对流用充分发展矩形槽 Nu = 4.8 的假设。这是方案筛选用的数量级，不是 CFD 证明。

## 2. 热源

项 | 设计采用 | 置信度
整板功率 | 300 W，Lenovo 写明含内存功耗 | 高
形态 | 72 核 Arm Neoverse V2，BGA 焊在 HPM 上。内存是板载 LPDDR5X，最高 480 GB / 颗，峰值带宽最高 384 GB/s | 高
功率分工 | CPU 裸片按 260 W 设计通道，两侧内存合计按 40 W 设计通道。两项相加仍是 300 W，不另加 | 中低 无官方功率地图。40 W 高于宣传材料里的约 16 W，用来给内存区留裕量
热图形状 | 一颗 CPU 裸片在中部，LPDDR5X 在两侧。公开模组是这个格局；GB300 盖板图未公布，窗口尺寸是候选 | 中
面热流（候选窗口） | CPU 窗口 40 × 32 mm 上 260 W → 20 W/cm²。一侧内存 50 × 70 mm 上 20 W → 0.6 W/cm²。裸片若缩到 25 × 25 mm，CPU 热流约 42 W/cm²，仍由微通道承担 | 随窗口变

进液按与 B300 冷板相同的计算温度 40 °C。结温上限公开页没有给死，本版不写保证结温，只给冷板侧的壳–进液目标。

## 3. 方案

B300 冷板用三层铜和 128 个微射流，是为了双 die 上大约 57 W/cm² 的平均热流和更高的热点。Grace 的整板只有 300 W，CPU 窗口上大约 20 W/cm²。这个热流用平行微通道就够，再做一层射流静压箱会多一道 0.5 mm 孔的堵塞风险，对这块板没有对应的热收益。

| CP-B300-JM-01 | CP-GRACE-MC-01
热设计点 | 1100 W（不含 Grace） | 300 W（含内存）
结构 | 三层：底板、喷嘴板、静压箱盖。总厚 12.5 mm | 两层：槽底板、带分流腔的盖板。总厚 8.0 mm
CPU / GPU 区 | 128 孔射流 + 短槽 | 48 条平行微通道，没有喷嘴
内存区 | HBM 无喷嘴、限速 | 两侧宽槽，近壁速度约 0.1 m/s
设计流量 | 2.0 L/min | 0.55 L/min
接头方向 | 进液边朝后面板，回液沿盖顶折返 | 左进右出，管子沿 PCB 两侧接到后面板
材料 | 三件都是 C11000 / TU1 | 两件都是 C11000 / TU1，与 GPU 冷板同材

两块冷板在托盘歧管上并联。Grace 的通道本身只有大约 0.7 kPa，若直接并到约 10 kPa 的 GPU 支路，Grace 会把流量吸走。所以在 Grace 入口设孔板，把整条 Grace 支路配到 10 kPa。孔板负责配平，通道负责换热，两件事分开。

## 4. 几何

坐标：原点在冷板左下角，X 沿托盘宽度，Y 沿托盘进深、朝向后面板和 GPU。芯片面是 z = 0，朝下贴 Grace 模组。

### 4.1 外形与厚度（候选平面，厚度按本方案）

特征 | 尺寸 | 状态
冷板外形 | 200 × 120 × 8.0 mm | 平面候选 宽度对齐两块并排的 B300 冷板，待盖板图
CPU 通道窗 | X 80–120，Y 44–76，即 40 × 32 mm，居中 | 候选
左 / 右内存窗 | 各 50 × 70 mm，X 14–64 与 X 136–186，Y 25–95 | 候选
密封边 | 四周 6 mm 实铜 | 方案
z 0–2.0 | 底板剩余铜 | 方案
z 2.0–3.2 | 通道，深 1.2 mm | 方案
z 3.2–3.5 | 分型密封面 | 方案
z 3.5–6.0 | 盖板内腔，深 2.5 mm。后侧为进液腔，前侧为出液腔 | 方案
z 6.0–8.0 | 盖板顶 | 方案

自绘图 1 · 俯视，芯片面朝下。冷液从左侧进入后侧进液腔，同时喂给 CPU 槽和两侧内存槽，再汇入前侧出液腔，从右侧离开。内存因此和 CPU 吃到同一股进液，而不是先流过一侧内存再进 CPU。

自绘图 2 · 厚度方向。两件铜。通道开在底板上，腔开在盖板上。总厚 8.0 mm，低于 B300 冷板的 12.5 mm。

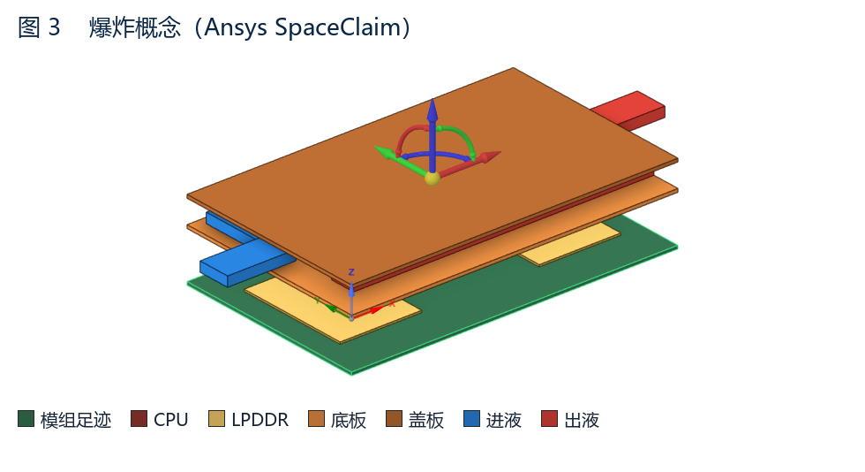
[picture p46: coolingplate/design/out/grace/fig_grace_iso.png]
SpaceClaim 爆炸概念图


图 3 · Ansys SpaceClaim 概念图。 自下而上：模组足迹（CPU 与两侧 LPDDR）、槽底板、进液腔与出液腔、盖板。左蓝右红是接头。图中小坐标轴是软件原点，不是流道。

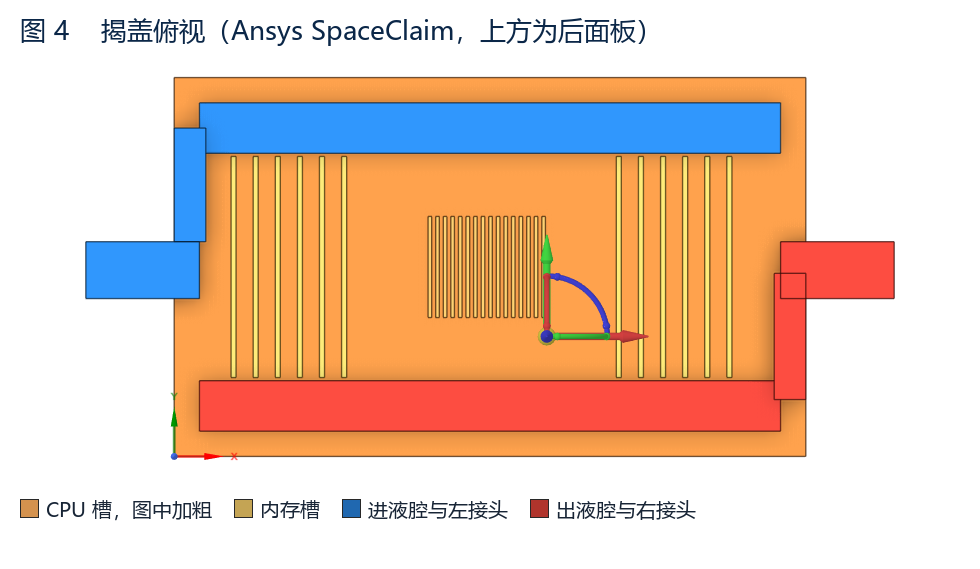
[picture p47: coolingplate/design/out/grace/fig_grace_top.png]
SpaceClaim 揭盖俯视


图 4 · 揭盖俯视。 上方蓝条是进液腔，朝后面板；下方红条是出液腔。冷液从左接头进入进液腔，穿过中部 CPU 槽和两侧内存槽，从右接头离开。为了在整板尺度上看得见，CPU 肋在这张图里加粗了，真实槽距见图 5。

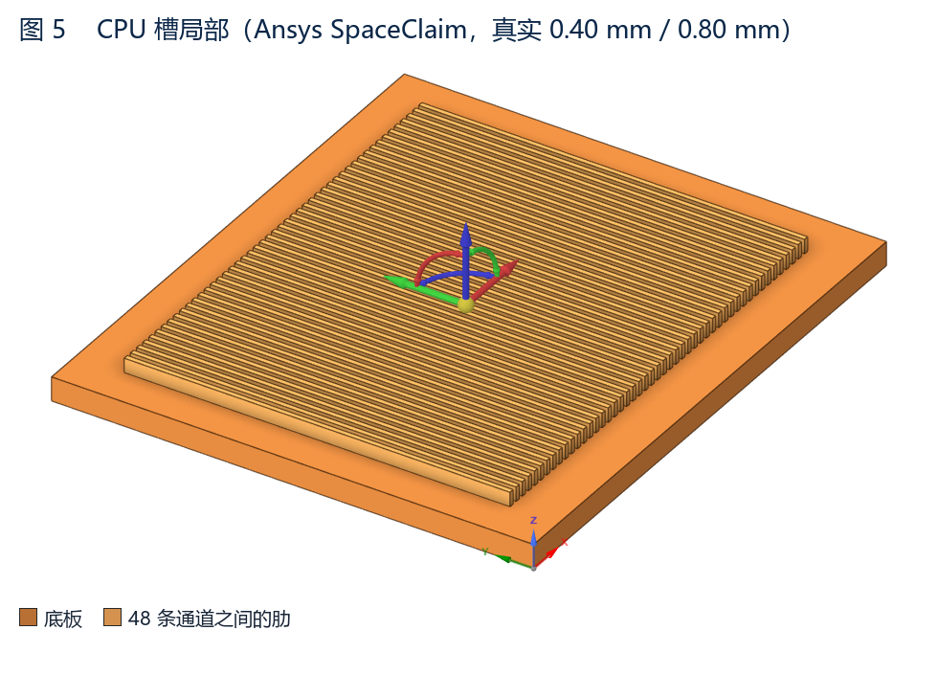
[picture p48: coolingplate/design/out/grace/fig_grace_channels.png]
SpaceClaim CPU 微通道局部


图 5 · CPU 区局部，按报告尺寸建模。 48 条通道，槽宽 0.40 mm，节距 0.80 mm，深 1.20 mm，流向沿 Y，长 32 mm。

### 4.2 通道

| CPU 区 | 每一侧内存区
条数 | 48 | 6
槽宽 × 深 | 0.40 × 1.20 mm | 1.20 × 0.80 mm
节距 | 0.80 mm | 约 8 mm，铺在 50 mm 窗内
流向长度 | 32 mm，沿 Y | 70 mm，沿 Y
水力直径 | 0.60 mm | 0.96 mm
入口限流 | 无。流量由整板入口孔板和通道自身阻力决定 | 每侧一条 0.80 × 1.20 mm 缝，把该侧压降补到与 CPU 通道同一量级

内存缝是为了分流比。若两侧宽槽直接并在同一对腔上，按层流阻力估算，内存会分走大约四成流量，而它只占大约 13% 的功率。缝把每侧在设计流量下的压降补到与 CPU 通道接近，使内存合计约 0.08 L/min、CPU 约 0.47 L/min。

### 4.3 接头与孔板

左右两侧各一个管接头，外径 8 mm、内径 6 mm，与 B300 冷板建议的管子同一规格。0.55 L/min 时管内流速约 0.32 m/s。接头钎在盖板侧面，落在腔的高度上。

入口孔板做在进液接头里，送样用可换镶件。4 个直径 1.04 mm 的孔，等效于一个直径 2.07 mm 的锐边孔（流量系数按 0.62）。四孔是为了避免单孔堵塞把整板切断。孔板在 0.55 L/min 下大约承担 9.3 kPa，加上 CPU 通道约 0.7 kPa，支路合计约 10 kPa。直径在托盘实测后冻结，本数是配平计算值。

## 5. 热工水力

水按 40 °C：密度 992 kg/m³，比热 4179 J/kg·K，粘度 6.53×10⁻⁴ Pa·s，导热系数 0.632 W/m·K。300 W、流体温升 8 K 时，体积流量为 0.543 L/min，设计取 0.55 L/min。包络流量 0.70 L/min，留给 PG25 或内存占比高于 40 W 的情况。B300 冷板在 2.0 L/min、1100 W 下的流体温升也是大约 8 K，两块板的温升口径一致。

量 | CPU 通道 | 单侧内存通道
分配流量 | 0.47 L/min | 0.036 L/min
槽内流速 | 0.34 m/s | 0.11 m/s
雷诺数 | 310 | 153
通道压降 | 0.71 kPa | 0.17 kPa（缝另外补约 0.5 kPa）
对流系数 | 约 5100 W/m²·K | 约 3200 W/m²·K
对流温升 | 260 W 下约 12 K | 20 W 下约 5 K

压降用充分发展层流 f = 64/Re，再加入口 0.5、出口 0.81 的局部损失。没有计入发展段的额外摩阻，所以 0.71 kPa 是通道压降的下限量级。即便发展段把它抬高一两倍，仍然远低于 10 kPa 的支路目标，差额继续由孔板承担。

对流用 Nu = 4.8（三边受热、深宽比 3 的充分发展矩形槽的量级假设）。发展段的真实 Nu 更高，所以 12 K 偏保守。换热面积按槽的两侧壁加槽底。这个 12 K 只是铜–流体，不含硅、TIM 和盖板内的梯度。

冷板侧目标：CPU 区壳–进液热阻 < 0.080 °C/W（260 W 下小于 21 K）。一维对流约占 0.046 °C/W，剩下留给 TIM2 和扩热。这是目标，要等共轭仿真和热测试件闭合。内存区 0.6 W/cm²，5 K 量级的对流温升不是设计驱动项，驱动项是速度和分流。

和托盘的水力关系：Grace 支路目标压降 10 kPa，窗口 8–12 kPa，与 B300 冷板的设计压降同一档。送样上限沿用 GPU 冷板的 18 kPa，极限 20 kPa。这样孔板可以把两路配平，而不是靠把 Grace 通道刻得很细去“制造”压降。

## 6. 材料、工艺与装配

项 | 推荐 | 原因
材料 | 底板、盖板都用 C11000 / TU1 | 与 B300 冷板同材，避免电偶、钎料和膨胀不一致
底板 | 送样 CNC。直槽在量产可以铲齿 | Grace 的槽是平行直槽，铲齿一次能成形。B300 的分区短槽做不到这一点
盖板 | CNC 铣腔 | 腔深 2.5 mm，没有微孔
送样装配 | 螺钉 + 密封圈，孔板镶件可换 | 配平孔的直径要在托盘上改，先不要焊死
量产装配 | 真空钎焊，焊后精铣贴芯片面 | 与 B300 冷板同一条产线逻辑。钎料槽躲开 0.40 mm 通道和内存缝
贴芯片面 | 平面度 ≤ 0.05 mm，Ra ≤ 0.8 μm | 与 B300 冷板同一进厂要求
过滤 | 回路仍按 ≤ 25 μm | 限制孔是 B300 的 0.50 mm 射流孔。Grace 的 1.04 mm 孔板不是回路里最小的孔

去离子水和 PG25 都要做流量–压降曲线。孔板若只在水上配平，换成 PG25 后支路压降会升高，托盘分流要重看。

## 7. 在托盘上的放法

芯片面朝下。冷板放在每块 NVL2 的前侧，两块 B300 冷板靠后面板。进液管沿 PCB 左缘从后面板供液歧管下来，接入左接头；出液管沿 PCB 右缘回到后面板回液歧管。管子在 GPU 冷板外侧，不从 GPU 冷板上面跨过。

零件只做一种手性。若两块 NVL2 在托盘上镜像，由管子对调左右，不另做一块镜像铜板。

单板 0.55 L/min 是冷板设计流量。托盘实际分到 Grace 的流量由歧管和孔板共同决定，要以托盘水力 ICD 为准。若四块 GPU 冷板实际是串联或半串联，Grace 仍应从供液歧管单独取水，避免吃到 GPU 的预热。

## 8. 待确认

# | 事项 | 现在的处理

1 | 盖板图、裸片与 LPDDR 坐标、螺孔 | 200 × 120 外形和两个窗口都是候选。通道数按窗口裁，节距不变
2 | CPU / 内存功率地图 | 260 / 40 是设计分工，总和锁在 300 W
3 | 结温与 TIM2 | 只给壳–进液目标 0.080 °C/W。TIM 品牌按整机
4 | 托盘串并联与单板实分流量 | 冷板按并联、0.55 L/min、支路 10 kPa 设计。ICD 若不同，只改孔板，不改槽
5 | 堆高 | 8.0 mm 低于 GPU 冷板。仍要核对 Grace 模组的压装高度
6 | 共轭仿真与热测试件 | 本报告的 12 K 是一维估算。发放前用 CFD 核对 Nu，并用热测试件核对壳温

核算脚本：CP-GRACE-MC-01_calc.py。记忆：memory/semantic/cp-grace-mc01.md。来源：参考_GB300_Grace_CPU与液冷边界_20260926.html。

CP-GRACE-MC-01 详细设计报告 v1.0 · 2026-09-26 · AIDCtms / coolingplate / design
功率来自 Lenovo GB300 公开规格。平面尺寸为候选。热阻与压降是一维估算，未经 CFD 与实件验证。
