bruce2012lu/AIDCtms_design202609/coolingplate/design/cfd/uc01b_2.4x3.0lessmesh12cells/UC01b_lessmesh_ICEM_Fluent_结果报告_v1.0.html

AIDC-B300-CFD-UC01b-LESS-RES-002 · iter 380 · m425_bc216

# UC-01b lessmesh ICEM / Fluent 结果报告 v1.0

当前场只有 iter 380，fluent/uc01b_cht_less_m425_bc216（cas 140055032 字节，13:37:13；dat 443504689 字节，13:37:24）。网格 4259680 HEXA。TIM 底 341.38529 K（68.24 °C）。静压差 1087.0927 Pa。残差已收敛。面速度积分入口、出口都是 1.22500×10⁻⁴ kg/s。质量加权能量比 1.0015。

2026-09-25 iter 380 已收敛 216 孔 · q'' 57.928 W/cm² Re_D = 597

TIM 底341.38529 K

静压 ΔP1087.0927 Pa

R(T_TIM−T_in)0.031341 K/W

能量比（质量加权）1.0015

温度、压差和热阻来自 logs/fluent_cht_less_m425_gpu.log。进出口流量和出口质量加权温度由同一 cas/dat 的面速度积分得到，Fluent 日志里没有这条积分。不是细网格 iter 8587（TIM 底 341.9327 K，ΔP 1088.1265 Pa）。也不是更稀的 2115436 单元 iter 421（ΔP 1091.51 Pa，TIM 底 342.096 K）。热流云图、总压差、GCI、y+ 本场未导出。

## 1. 边界与收敛

量 | iter 380
场 | uc01b_cht_less_m425_bc216.cas.h5 / .dat.h5
阵列 | 9×12 / die，两 die 216。单孔 D=0.40 mm。进口区只有 inlet_jet 一个孔
网格 | mesh/uc01b_cht_less.msh，11:42。2055516 + 2083716 + 120448 = 4259680 HEXA。Y 向胞宽 2.4 mm，孔心未移动
施加 q'' | 579282 W/m²（57.928 W/cm²），216 胞合计 900.899 W
ṁ | 期刊设定 1.225×10⁻⁴ kg/s。面速度积分：入口 1.22500×10⁻⁴ kg/s，出口 1.22500×10⁻⁴ kg/s（比入口 +0.00033%）。不是 ×108，也不是 ×216
入口 / 回流 | 313.15 K。出口 return_slot 表压 0。return_slot:015 为邻铜壁面
求解 | SST k-ω，能量，共轭。3ddp -t4 -gpu，4 进程共用 RTX 4090
残差 | 6.2412e-07 6.2793e-07 1.9747e-06 2.6352e-06 9.9059e-07 1.1046e-06 1.6245e-04，solution is converged
静压差 | 入口 1087.0927 Pa，出口 0，ΔP = 1087.0927 Pa

## 2. 温度

TIM 底 wall_heat 面积加权 341.38529 K（68.24 °C）。68.24 °C = 341.38529 − 273.15。

面 | iter 380
TIM 底 wall_heat | 面积加权 341.38529 K；本面 341.375–341.394 K
TIM 中面，z=−2.0364 mm | 338.991–339.010 K，低于底面
TIM–Cu wall_tim_cu | 面积加权 336.13005 K；切面 336.120–336.139 K
铜座中面，z=−1.0284 mm | 334.638–334.725 K
铜–水整个界面 wall_cu_fluid | 面积加权 326.59968 K（53.45 °C）
铜–水底面 z=0（界面的一部分） | 332.485–333.538 K
出口 return_slot | 面积加权 320.90984 K（47.76 °C）；质量加权 321.309 K；面上 318.693–322.009 K
入口 | 313.15 K（40 °C）。面速度均匀 0.98265 m/s
出口温升 / 能量温升 | 质量加权 8.159 K / 8.147 K = 1.0015。面积加权 7.760 K / 8.147 K = 0.952，是加权偏低，不是能量缺口

TIM bottom 380

图 2-1 iter 380，TIM 底面 wall_heat。面积加权 341.38529 K（68.24 °C）。本面 341.375–341.394 K。场 uc01b_cht_less_m425_bc216。

TIM mid 380

图 2-2 iter 380，TIM 中面 z=−2.0364 mm。338.991–339.010 K，低于底面 341.38529 K。

## 3. 热阻

R(T_TIM−T_in) = (341.38529 − 313.15) / 900.899 = 0.031341 K/W。已含 TIM、铜和对流，不再加 R_TIM2 与 R_wall。单胞 (341.38529 − 313.15) / 4.17083 = 6.770 K/W。

定义 | 两 die
R(T_TIM−T_in)，除以 900.899 W | 0.031341 K/W
R_conv = (326.59968 − 313.15) / 900.899 | 0.014929 K/W
R_c-in = R_TIM2(0.004–0.008) + R_wall(0.003392) + R_conv | 0.022321–0.026321 K/W
q''/(T_TIM−T_in) | 2.052×10⁴ W/(m²·K)。不是湿面局部对流系数
q''/(T_cu−water−T_in) | 4.307×10⁴ W/(m²·K)。同一施加 q''，不是局部对流系数

0.031341 与 0.022321–0.026321 不能相加。质量加权能量比 1.0015。Re_D=597 < 2000，不引用 Martin，不把目标热阻写成已经关闭。

## 4. 速度与 Re

U = ṁ / (ρ·π·D²/4) = 0.9825 m/s。ρ=992.2 kg/m³，D=0.40 mm，μ=6.53×10⁻⁴ Pa·s，ṁ=1.225×10⁻⁴ kg/s。Re_D = ρUD/μ = 597.1。入口面上速度是均匀的 0.98265 m/s。下表 |V|max 来自各切面，不要把 0.9825 m/s 当成切面极值。

切面 | 水温度 | |V|max
槽中水，最近平面 z=0.674 mm（网格上没有正好 0.750 mm 的面） | 313.45–331.91 K | 1.374 m/s
z=2.500 mm 间隙 | 313.15–324.28 K | 1.658 m/s
圆孔水，最近平面 z=4.750 mm（没有正好 4.711 mm 的面） | 313.15–322.05 K | 1.624 m/s（Vz 向下）
Y=0 | 313.15–332.68 K | 1.699 m/s
Y=0.800 mm | 317.50–333.44 K | 0.491 m/s
X=0 | 313.15–333.33 K | 1.699 m/s
X=0.566 mm | 315.74–333.36 K | 0.762 m/s
X=1.300 mm | 316.99–333.36 K；固体 333.33–339.96 K，与水同一温度色标 | 0.510 m/s
X=0.400 mm 孔外槽内 | 315.42–333.34 K；固体 318.59–339.95 K | 0.754 m/s
X=1.100 mm 回液缝唇 | 316.69–333.44 K；固体 318.67–339.96 K | 0.621 m/s
Y=0.400 mm 肋中 | 317.32–333.32 K；固体 318.59–339.96 K | 0.527 m/s
Y=1.000 mm 侧槽中心 | 317.76–333.32 K；固体 318.65–339.96 K | 0.436 m/s
z=0.217 mm 驻点上方（没有正好 0.150 mm 的面） | 313.90–332.72 K；固体 331.83–332.78 K | 0.966 m/s
z=3.500 mm 间隙顶全平面 | 313.15–322.35 K；固体 318.71–318.88 K | 1.699 m/s（轴向，平面内箭头低于作图阈值）
z=7.000 mm 上腔孔断面 | 313.15 K（入口水温） | 1.368 m/s（轴向）
回液缝入口 | 319.28–322.35 K | 0.137 m/s
回液缝中段 z=4.750 mm | 318.74–322.05 K | 0.118 m/s
出口 return_slot | 面积加权 320.90984 K；面上 318.69–322.01 K | 0.110 m/s

总压差、GCI、y+ 这场没有导出，本页不写。

## 5. 云图（iter 380）

下列图从 uc01b_cht_less_m425_bc216 的 cas/dat 切出，不是细网格的 n216_i8587_*.png。槽中水用网格上最近的 z=0.674 mm，圆孔用 z=4.750 mm。每张温度云图只有一把色标，流体和固体温度用这一把。速度是另一幅分图，用自己的速度色标。

TIM copper

图 5-1 TIM–Cu。336.120–336.139 K。面积加权仍是 336.13005 K。iter 380。

copper mid

图 5-2 铜座中面 z=−1.028 mm。334.638–334.725 K。iter 380。

copper floor

图 5-3 铜–水底面 z=0。332.485–333.538 K。整个铜–水界面面积加权仍是 326.59968 K。iter 380。

rib mid

图 5-4 肋中固体，z=0.674 mm。331.124–332.010 K。iter 380。

rib top

图 5-5 肋顶固体，z=1.500 mm。329.729–331.224 K。iter 380。

orifice and slots

图 5-6 z=4.750 mm。喷孔与出流导流槽。填色是速度，黑线是温度等值线。喷孔水 |V| 最大 1.624 m/s，水温 313.15–322.05 K。iter 380。

mid slot

图 5-7 槽中水 z=0.674 mm。313.45–331.91 K，|V|max 1.374 m/s。iter 380。

gap

图 5-8 z=2.500 mm 间隙水。313.15–324.28 K，|V|max 1.658 m/s。iter 380。

orifice fluid

图 5-9 z=4.750 mm 圆孔水。313.15–322.05 K，|Vz|max 1.624 m/s。iter 380。

slit inlet

图 5-10 回液缝入口。319.28–322.35 K，|V|max 0.137 m/s。iter 380。

return mid

图 5-11 回液缝中段 z=4.750 mm。318.74–322.05 K，|V|max 0.118 m/s。iter 380。

outlet

图 5-12 return_slot。面积加权 320.90984 K，面上 318.69–322.01 K，|V|max 0.110 m/s。iter 380。

Y0

图 5-13 Y=0。水 313.15–332.68 K，|V|max 1.699 m/s。iter 380。

side

图 5-14 Y=0.800 mm。水 317.50–333.44 K，|V|max 0.491 m/s。iter 380。

X0

图 5-15 X=0。水 313.15–333.33 K，|V|max 1.699 m/s。iter 380。

X mid

图 5-16 X=0.566 mm。水 315.74–333.36 K，|V|max 0.762 m/s。左图流体与固体共用一把温度色标，右图是速度。iter 380。

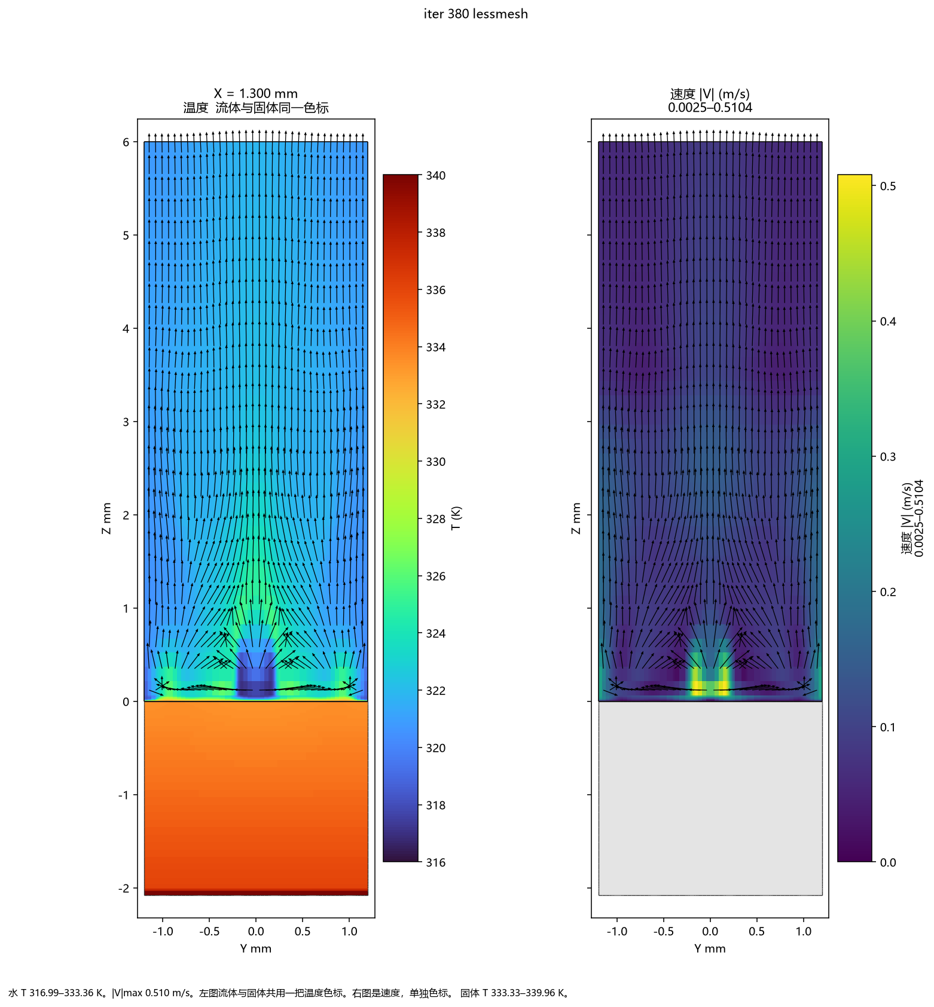
[picture p49: coolingplate/design/cfd/uc01b_2.4x3.0lessmesh12cells/figs/m425_x13_TV.png]
X 1.3


图 5-17 X=1.300 mm。水 316.99–333.36 K，固体 333.33–339.96 K，左图共用一把温度色标，箭头是平面内速度。右图 |V|max 0.510 m/s，单独速度色标。iter 380。

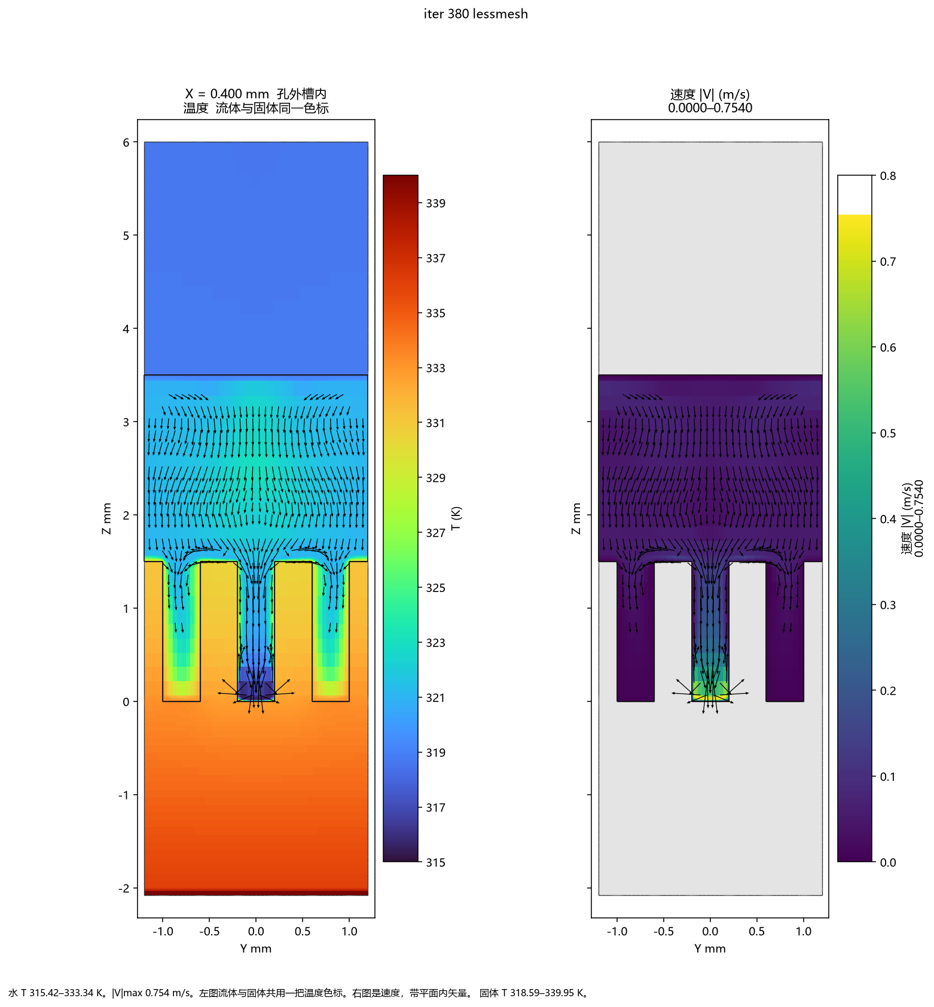
[picture p50: coolingplate/design/cfd/uc01b_2.4x3.0lessmesh12cells/figs/m425_x04_TV.png]
X 0.4


图 5-18 X=0.400 mm，孔外、槽内。X=0.200 mm 与圆孔相切，云图破碎，这张改到孔外。水 315.42–333.34 K，固体 318.59–339.95 K，|V|max 0.754 m/s。iter 380。

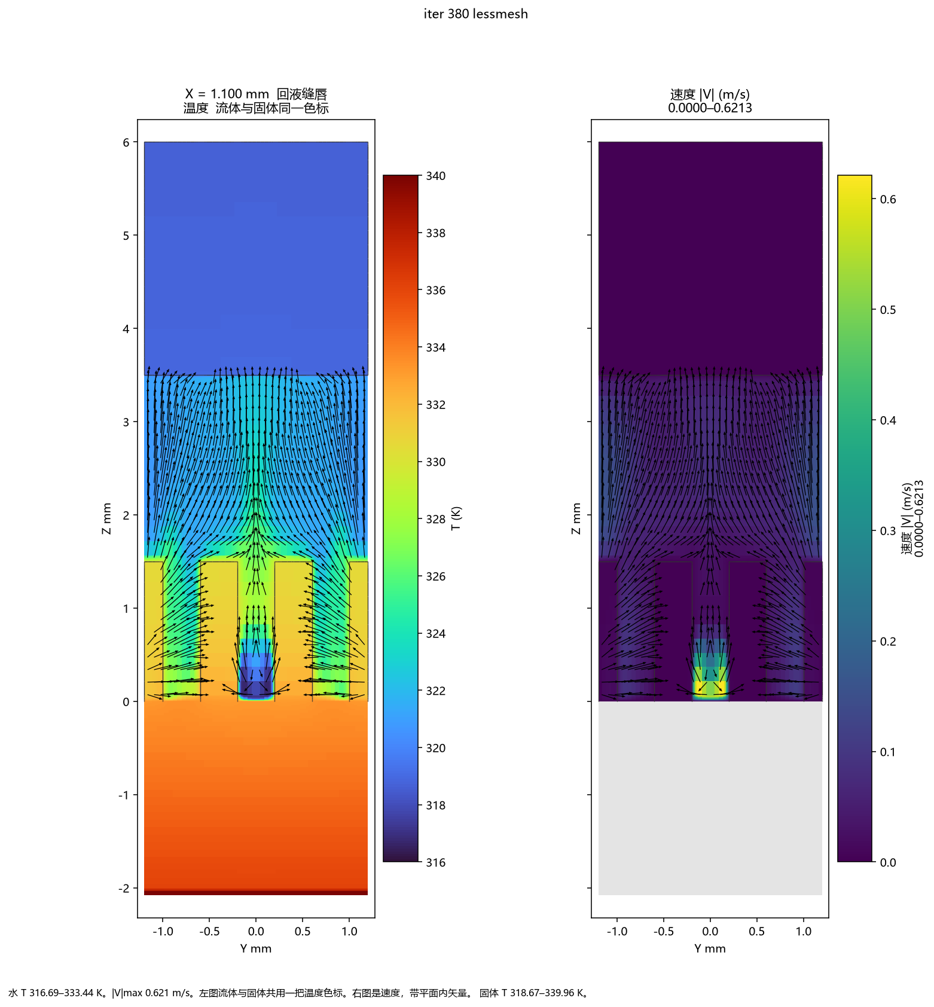
[picture p51: coolingplate/design/cfd/uc01b_2.4x3.0lessmesh12cells/figs/m425_x11_TV.png]
X 1.1


图 5-19 X=1.100 mm，回液缝唇。水 316.69–333.44 K，固体 318.67–339.96 K，|V|max 0.621 m/s。iter 380。

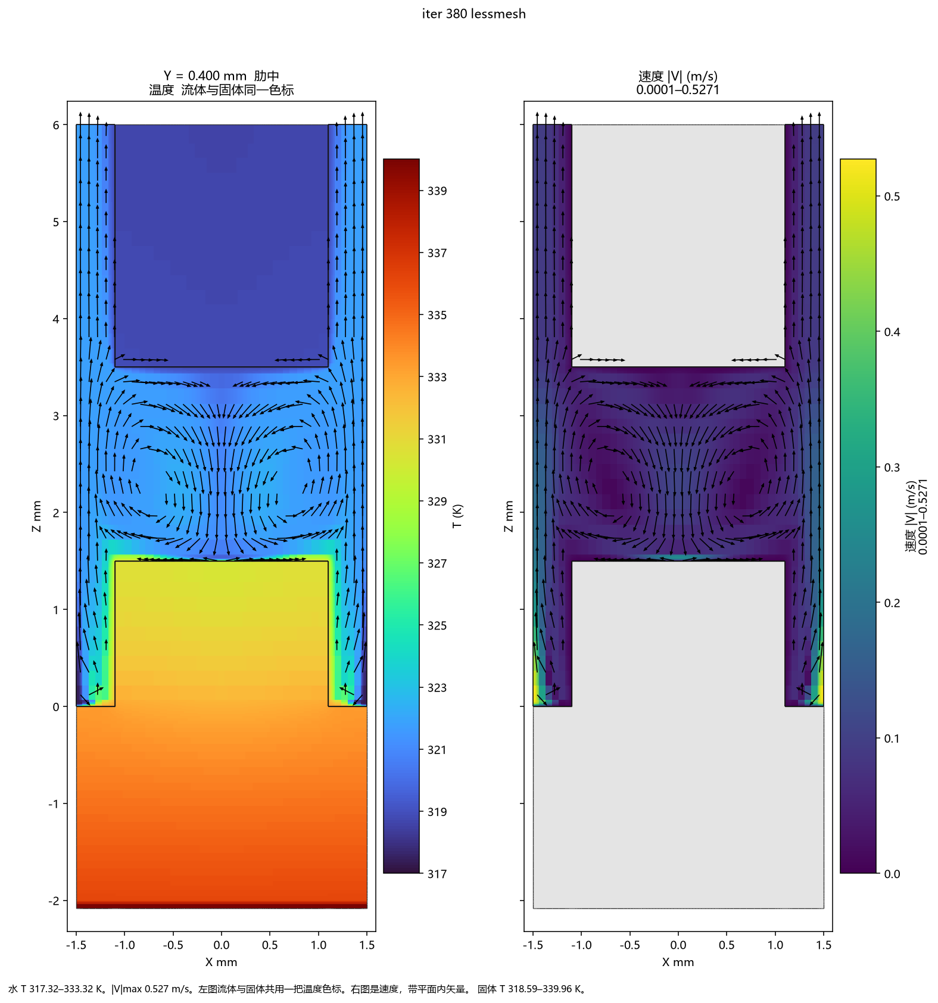
[picture p52: coolingplate/design/cfd/uc01b_2.4x3.0lessmesh12cells/figs/m425_y04_TV.png]
Y 0.4


图 5-20 Y=0.400 mm，肋中。Y=0.200 mm 是槽壁且与圆孔相切，云图破碎，这张改到肋内。水 317.32–333.32 K，固体 318.59–339.96 K，|V|max 0.527 m/s。iter 380。

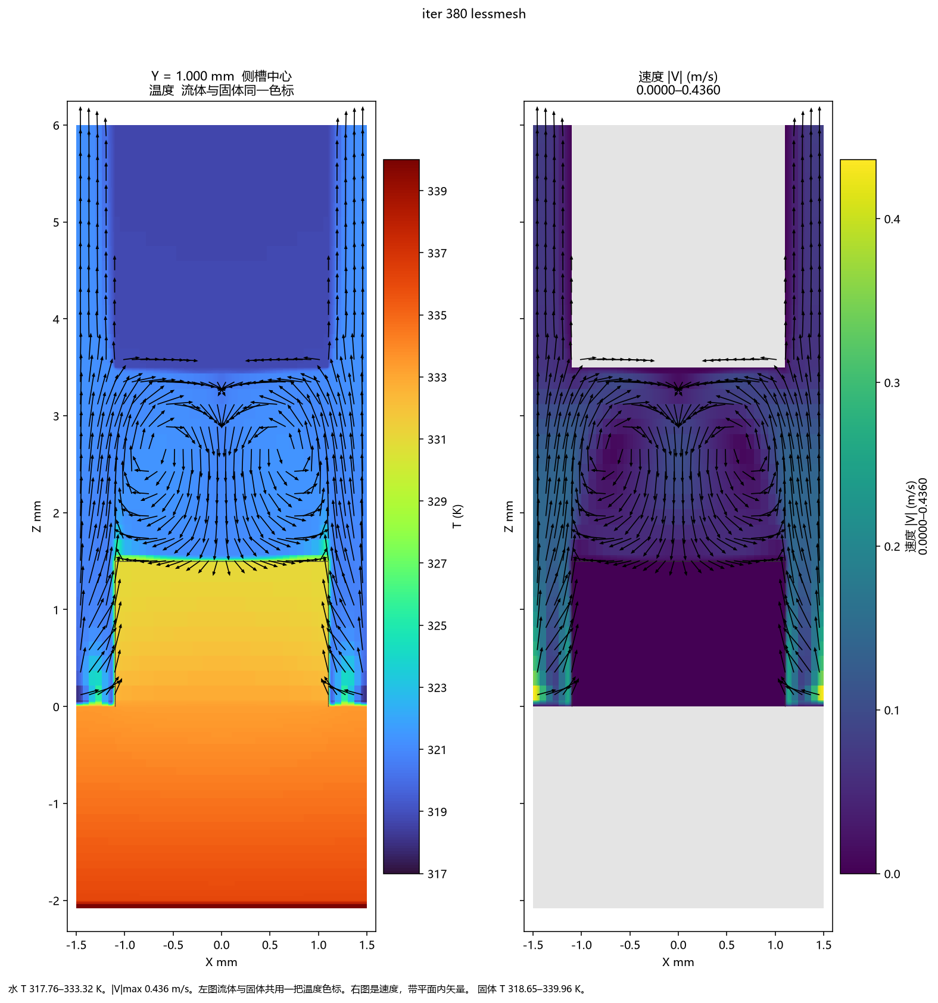
[picture p53: coolingplate/design/cfd/uc01b_2.4x3.0lessmesh12cells/figs/m425_y10_TV.png]
Y 1.0


图 5-21 Y=1.000 mm，侧槽中心。水 317.76–333.32 K，固体 318.65–339.96 K，|V|max 0.436 m/s。iter 380。

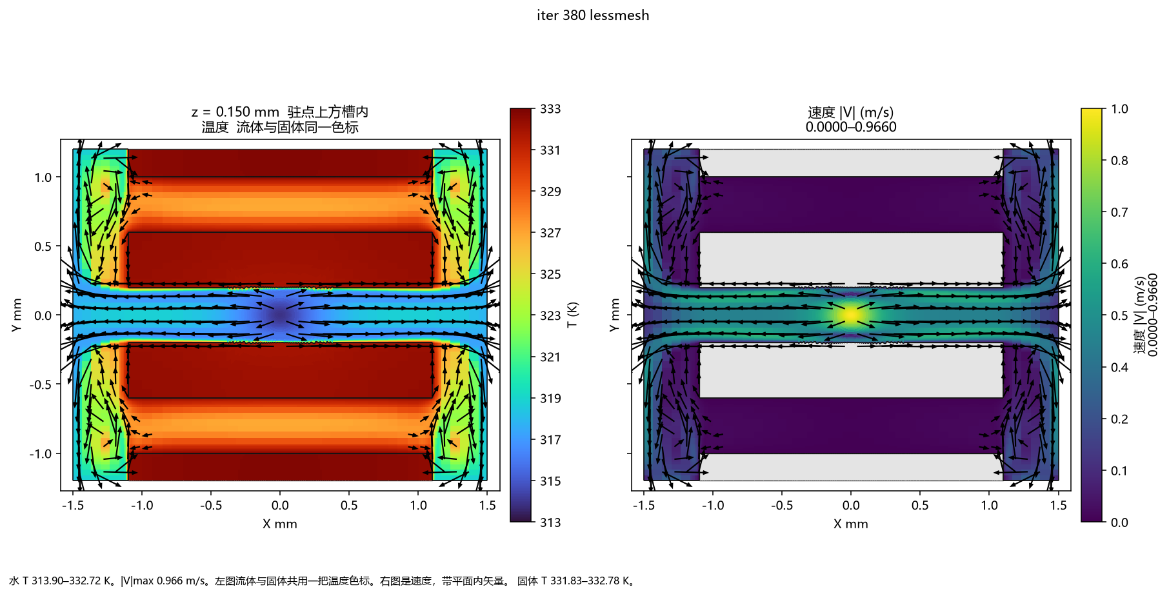
[picture p54: coolingplate/design/cfd/uc01b_2.4x3.0lessmesh12cells/figs/m425_z015_TV.png]
z impingement


图 5-22 z=0.217 mm，驻点上方槽内（网格上没有正好 0.150 mm 的面）。水 313.90–332.72 K，固体 331.83–332.78 K，|V|max 0.966 m/s。iter 380。

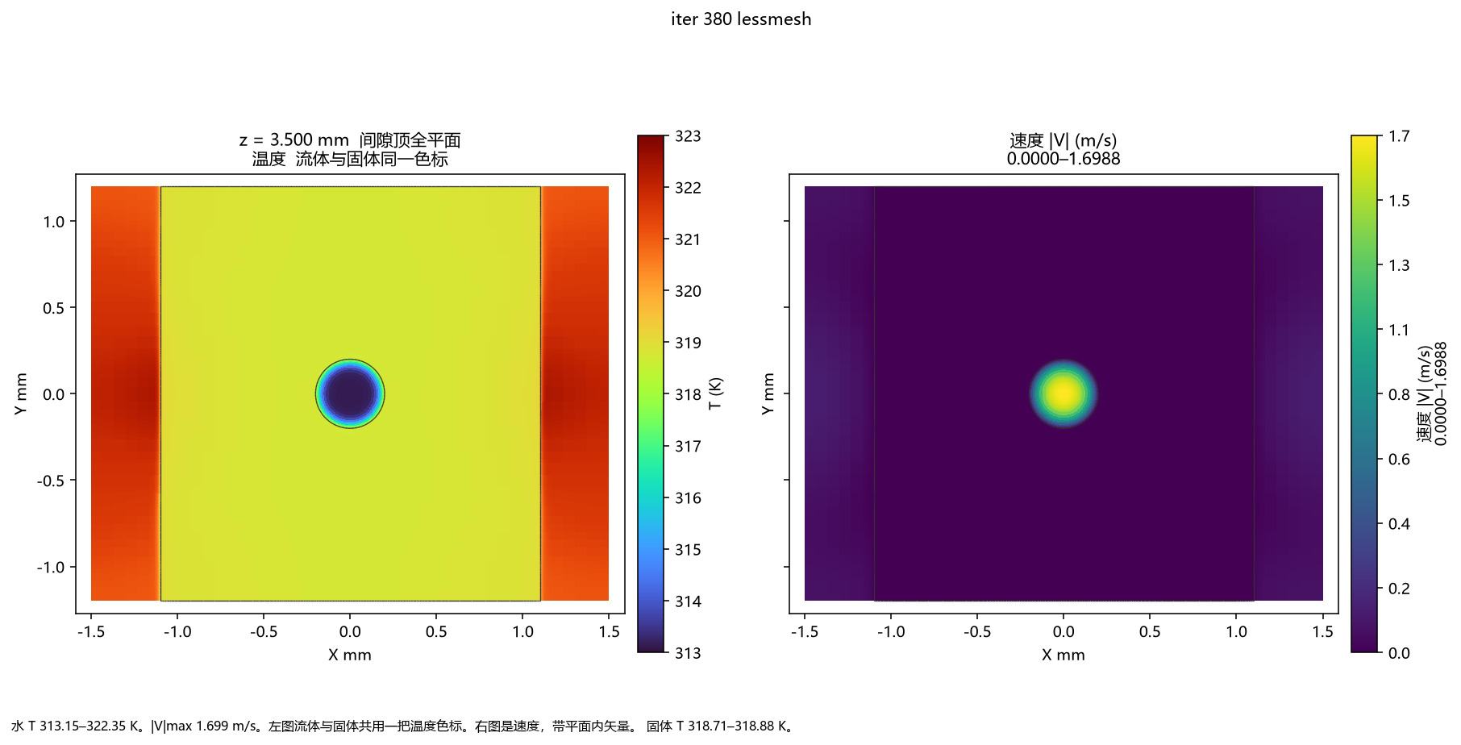
[picture p55: coolingplate/design/cfd/uc01b_2.4x3.0lessmesh12cells/figs/m425_z35_TV.png]
z 3.5 full


图 5-23 z=3.500 mm，间隙顶全平面。水 313.15–322.35 K，固体 318.71–318.88 K，|V|max 1.699 m/s。主速度沿轴向，平面内分量低于箭头阈值。iter 380。

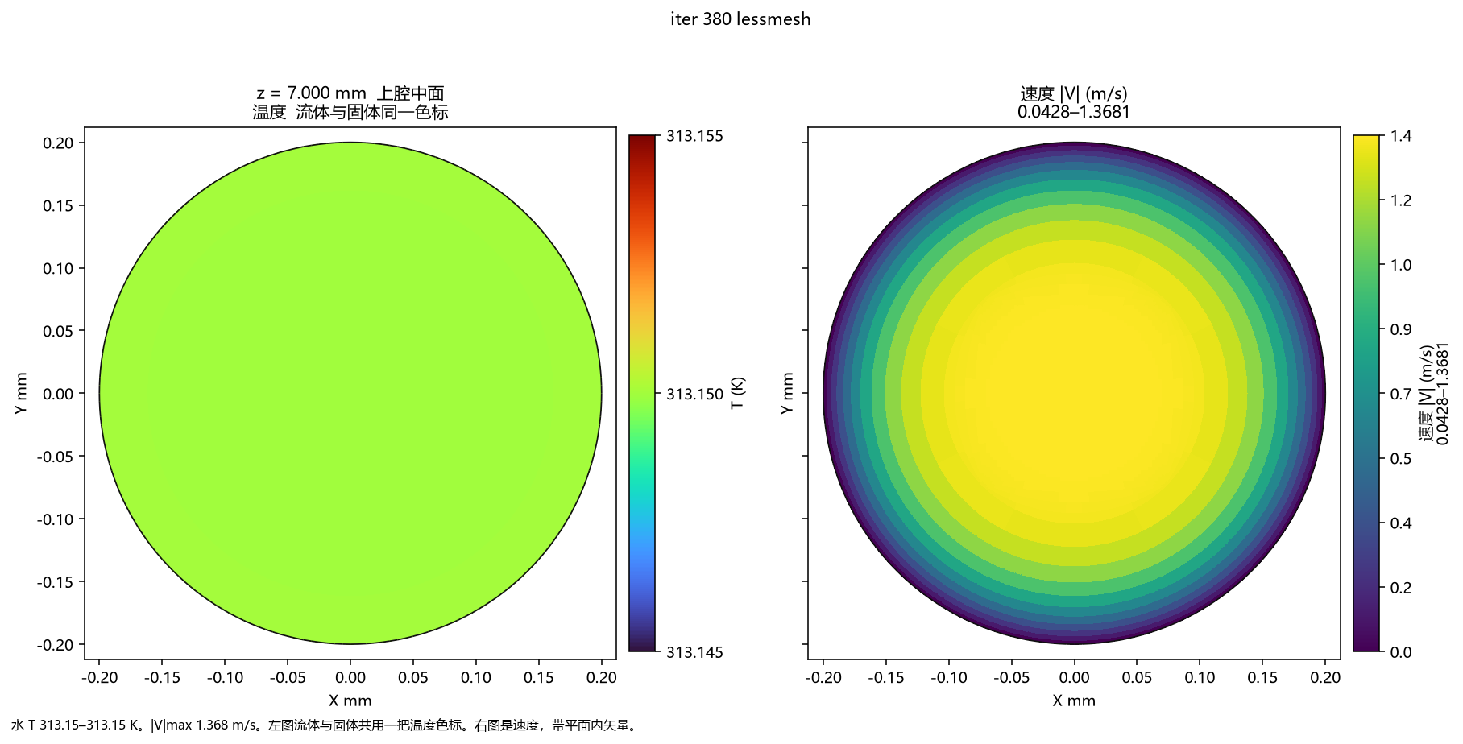
[picture p56: coolingplate/design/cfd/uc01b_2.4x3.0lessmesh12cells/figs/m425_z70_TV.png]
z 7 plenum


图 5-24 z=7.000 mm，上腔孔断面。只有圆孔里的水，313.15 K，|V|max 1.368 m/s，方向沿孔轴。iter 380。

## 6. 网格剖面（不是温度）

来源 mesh/uc01b_cht_less.msh，与 iter 380 同一套网格。4259680 HEXA，底面四边形 30112。首层 0.0025 mm，n_BL=10，增长 1.2。孔外过渡 0.080 mm，缝唇外 0.0675 mm，槽芯 Y 0.045 mm，肋芯 0.068 mm。图上只有单元面。

mesh TIM bottom

图 6-1 网格。TIM 底面 wall_heat。30112 个四边形。不是温度云图。

mesh floor

图 6-2 网格。铜–水底面，z=0。

mesh rib

图 6-3 网格。肋顶平面，z=1.500 mm。

mesh orifice

图 6-4 网格。孔板，z=4.750 mm。喷孔是圆。

mesh X0

图 6-5 网格。X=0 竖直切面。

mesh Y0

图 6-6 网格。Y=0 中槽竖直切面。

mesh boundary layer

图 6-7 网格。Y=0，放大铜–水底面附近。水侧有边界层加密。

AIDC-B300-CFD-UC01b-LESS-RES-002 · 2026-09-25
只收录 iter 380，场 uc01b_cht_less_m425_bc216。网格 4259680 HEXA。TIM 底 341.38529 K（68.24 °C）。静压差 1087.0927 Pa。入口、出口质量流量积分都是 1.22500×10⁻⁴ kg/s。质量加权能量比 1.0015。云图与网格剖面在 figs/m425_*.png。未导出的量：热流云图、总压差、GCI、y+。
