bruce2012lu/AIDCtms_design202609/coolingplate/design/cfd/uc01b_2.4x3.0/UC01b_1D与CFD契合性对比_v1.0.html

AIDC-B300-CFD-UC01b-CMP-001 · 对照 · 不关闭设计

# UC-01b 一维设计与 CFD 契合性对比 v1.0

DP-A、圆孔 D=0.40 mm、iter 529。CFD 来自 uc01b_cht_v2_n216_q105_sym。TIM 底 341.9268 K（68.78 °C）。X=0.556 mm 上 ±Y 温差中位 0.631 K，流场不能称为对称。

2026-09-25 边界契合 U / Re 契合 静压部分契合 能量未闭合 R_c-in 未关闭

施加 q''57.928 W/cm²

CFD 静压1085.97 Pa

能量比0.951

R(T_TIM−T_in)0.031942

X=0 上 ±Y 温差中位 0.0018 K，但 X=0.556 mm 上 ±Y 温差中位 0.631 K、最大 5.64 K，流场不能称为对称。CFD 列是 iter 529，场 uc01b_cht_v2_n216_q105_sym。

## 1. 分条结论

一维设计点仍是整板 1100 W、2.0 L/min。两 die GPU 热 858 W，GPU 支路 1.60 L/min。216 孔名义 q''=55.170 W/cm²。施加边界 ×1.05 = 57.928 W/cm²，这是边界冗余，不改 1100 W。单孔流量 0.007407 L/min，ṁ=1.2249382716049385×10⁻⁴ kg/s。

Re_D=597.1，低于 Martin 1977 的 Re≥2000，不引用 Martin h。能量比 0.951，未闭合，热阻不写成设计已关闭。R(T_TIM−T_in)=0.031942 K/W 已含导热，不再加 R_TIM2 与 R_wall。

## 2. 对照表

项目 | 一维设计点 | CFD iter 529
整板 | 1100 W，2.0 L/min | 本胞不是整板
两 die GPU | 858 W，1.60 L/min | 边界功率 900.9 W（858×1.05）
孔数 / 单孔流量 | 216；0.007407 L/min | 同一口径。质量流量积分未再打印
q'' | 名义 55.170 W/cm² | 施加 579282.4074074075 W/m²（57.928 W/cm²）
TIM 底 | — | 341.9268 K（68.78 °C），本面 341.905–341.947 K
铜–水 / 出口 | — | 326.8120 K / 320.8987 K
入口 | 313.15 K | 313.15 K
静压差 | 本页不另造孔口损失 | 1085.97 Pa（入口邻接流体 1085.97 Pa，出口约 0）
U / Re_D | Re<2000，Martin 不用 | 0.9824 m/s / 597.1
R(T_TIM−T_in) | — | 0.031942 K/W（除以 900.9 W，不加 R_TIM2、R_wall）
R_conv / R_c-in | — | 0.015165 / 0.022557–0.026557 K/W
能量 | — | 7.74875 / 8.14772 = 0.951，未闭合

## 3. 热阻两条链

场链 0.031942 K/W 与构造链 0.022557–0.026557 K/W 不能相加。总压差这场没有导出。

## 4. 压差

iter 529 的静压差是 1085.97 Pa。总压没有导出，不与静压混比。

## 5. 引用

收敛句在 logs/fluent_cht_v2_n216_q105_sym.log：529 solution is converged。喷孔 |V| 0.034–1.627 m/s，两侧导流槽 |V| 0.00053–0.111 m/s。槽中水 z=0.750 mm 为 313.40–332.32 K。dat 里的面热流数组不是 W/m²，施加值仍是 579282.4074074075。未导出：GCI、y+、质量流量积分。

AIDCtms / uc01b_2.4x3.0 · 1D 与 CFD 契合性对比 v1.0 · 2026-09-25
数值来自 iter 529 场 uc01b_cht_v2_n216_q105_sym。X=0.556 mm 上 ±Y 温差中位 0.631 K，流场不能称为对称。
