bruce2012lu/AIDCtms_design202609/coolingplate/design/cfd/uc01b_2.4x3.0/UC01b_ICEM_Fluent_工作方案_v1.0.html

AIDC-B300-CFD-UC01b-PLAN-001 · 方案 + 计划 · 不是结果报告

# UC-01b 单孔单元胞 ICEM / Fluent 工作方案与计划

各向异性流体 coupon：Sx=3.0 mm（沿槽）× Sy=2.4 mm（跨槽）。 2026-09-25 DP-A 已收敛：iter 8587，4 核 GPU。 施加 q''=579282.4074074075 W/m²，ṁ=1.2249382716049385×10⁻⁴ kg/s。 场 uc01b_cht_v2_n216_q105（cas 12:15:11，dat 12:15:19）。 残差 1.6618e-07 / 1.3524e-07 / 1.7518e-07 / 2.5383e-07 / 9.9436e-07 / 5.8504e-07 / 2.4913e-04。 TIM 底 341.9327 K，铜–水 326.81594 K，出口 320.90048 K，入口 313.15 K，静压差 1088.1265 Pa。 R(T_TIM−T_in)=0.031949 K/W（900.9 W），不再加 R_TIM2 与 R_wall。R_conv=0.015169 K/W，R_c-in=0.022561–0.026561 K/W。出口温升 7.75048 K / 能量 8.14772 K = 0.951，能量未闭合。 当前入口是 ṁ=1.224938×10⁻⁴ kg/s，U=0.9824 m/s，Re_D=597.1。 三槽 0.40×1.50 节距 0.80，D=0.40 mm（GEO 默认 0.50 仅作对照）， H=2.0 mm，±X 回液缝 0.80 上抽。 单孔 ṁ = 1.224938×10⁻⁴ kg/s（1.60 L/min ÷ 216）。

文档 PLAN-001 版本 v1.0 2026-09-21 ANSYS 2026 R1 / v261 D = 0.40 mm 2.4 × 3.0 mm ReD=597 < 2000 禁止整板起步

保证点 DP-A1100 W @ 2.0 L/min（整板）

单孔 ṁ1.224938e-4 kg/s

冷板压降窗20 kPa，不含 UQD

第一案模型层流 · 水 40 °C

## 0. 结论（先读这一页）

本算例只做一孔 + 三短槽 + ±X 回液缝上抽的流体单元胞。 禁止 95×75 mm 整板、禁止 128 孔共轭、禁止把槽当成「一条长河」的 bank 流。 2.0 L/min 是整板总流量，不是单孔。20 kPa 是冷板本体窗，不含 UQD。 本文是开工令，不是仿真报告；结果报告必须等 Fluent 至少写出残差。

2.4 × 3.0Sy 跨槽 × Sx 沿槽，mm

⌀0.40主孔径（GEO 默认 0.50 不覆盖）

597iter 8587 的 ReD，Martin 下限 2000

四步锁死方案 → 网格 → 求解 → 报告

ANSYS 已定位（2026 R1 / v261）。 AWP_ROOT261 = E:\cae\programfiles\Ansys2026\ANSYS Inc261\v261。 ICEM：icemcfd\win64_amd\bin\icemcfd.bat。 Fluent：fluent\ntbin\win64\fluent.exe。 许可证能否 checkout 要到批处理时才知道。

## 1. 目标、范围、非目标

### 1.1 目标

1. ICEM 建出与 calc/model.py GEO 及 UC01_壁面射流与三槽流路说明.html / fig_walljet.py 对齐的单孔流体域。
2. 打出 Fluent 可读网格：优先结构化 hex（孔 O-grid + 槽 H 网格）；不行则 tet/prism 并声明。
3. TUI journal 启动 Fluent：层流、水 40 °C、ṁ = 1.224938e-4 kg/s、回液缝压力出口。已收敛场是 iter 8587。
4. 至少得到残差与若干监视器（ΔP，若可能则 wall_imp 面平均 h）。不要求过夜收敛。
5. 用实测残差/监视器写结果报告。禁止编造云图。

### 1.2 非目标（本周禁止）

- 整板、128 孔、HBM、静压箱+水嘴全模；
- 用本单元胞 h 外推整板 Rθ,c-in（设计报告 v2.0 §10.3）；
- 1/4 对称；长槽 bank 流；
- PG25 / 热点 2.5× / 堵塞 20%；
- 把 2.0 L/min 当单孔流量；把 20 kPa 当「含 UQD 的接口压降」。

### 1.3 责任

角色 | 责任
Agent | 方案、replay/Tcl、journal、批处理、日志、对照表；不编造未跑出的场
人（仿真） | 许可证、ICEM GUI 救阻塞、目视网格、过夜收敛、是否开 SST
人（热设计） | 出口定义改口、D=0.40 是否回写 GEO

## 2. 几何冻结表

坐标系：原点在中槽底面中心；+X 沿槽；+Y 跨槽；+Z 向上（射流 −Z 打壁）。

### 2.1 与代码 / 说明页对照

量 | 符号 | UC-01b 本算例 | GEO 默认 | 出处
沿槽节距 | Sx | 3.0 mm | S_jet = 3.0 | 用户冻结；GEO
跨槽节距 | Sy | 2.4 mm | （说明页顶视曾按 3.0） | 用户冻结；三槽装满
孔径 | D | 0.40 mm | 0.50 mm | 用户取值；说明页
间隙 | H | 2.0 mm | 同左 | GEO
H/D | — | 5.0 | 4.0 | 派生
Sx/D，Sy/D | — | 7.5，6.0 | 6.0，6.0 | 派生
相对喷嘴面积 | f | 0.01745 | 0.02182 | Ajet/(SxSy)
盖板厚 | t_lid | 2.5 mm（流体建孔段） | 2.5 | GEO
短静压箱 | H_plenum | ≥ 2.0 mm（能建就建） | ≥4D 建议 | 本方案
短槽 | w×h，p | 0.40×1.50，节距 0.80 | 同左 | GEO / fig_walljet
回液缝物理宽 | w_slit | 0.80 mm | 同左 | fig_walljet
本胞可见半缝 | w_slit/2 | 0.40 mm × 2 | 周期缝各见一半 | 冻结
余铜 | t_base,cu | 不建（流体-only） | 2.0 mm | UC-02 才共轭

### 2.2 Y 向三槽装填（2.4 mm 刚好）

3×槽 + 2×满肋 + 2×半肋 = 1.20 + 0.80 + 0.40 = 2.40 mm。

Y 区间 (mm) | 零件 | 说明
[−1.20, −1.00] | 半肋 | 周期/对称面，邻胞共享
[−1.00, −0.60] | 侧槽 − | 中心 Y=−0.80，r/D≈2
[−0.60, −0.20] | 满肋
[−0.20, +0.20] | 中槽 | 正对孔，驻点在槽底
[+0.20, +0.60] | 满肋
[+0.60, +1.00] | 侧槽 + | 中心 Y=+0.80
[+1.00, +1.20] | 半肋 | 周期/对称面

### 2.3 X 向回液

X 区间 (mm) | 零件
[−1.50, −1.10] | −X 半缝（上抽）
[−1.10, +1.10] | 三槽 + 间隙主体，槽长 2.20 mm
[+1.10, +1.50] | +X 半缝（上抽）

备选「缝宽 0.80 全部落在本胞」记为 UC-01b-isolated，本方案不采用。

### 2.4 Z 向堆叠

Z (mm) | 域 | 网格要点
0 → 1.50 | 三槽腔 + 缝根 | 槽底 = wall_imp
1.50 → 3.50 | 间隙 H=2.0 | 肋顶 = 壁面射流贴壁，加密
3.50 → 6.00 | 盖板孔段 ⌀0.40 | 轴向 ≥8，径向 ≥8–12
6.00 → 8.00 | 短静压箱 ≥2 mm | 顶面 = inlet_jet

图 2-1 单孔各向异性单元胞 橙条 = 回液上抽。青块 = 三槽。禁止改成沿槽长出流。

### 2.5 流路（禁止改口）

下射 → 驻点 → 壁面射流沿 ±X（并扫入侧槽）→ 回液缝向上。 自由射流不是壁面射流；槽底导管流也不是。Y=±1.2 mm 处邻孔相撞，预期喷泉。

### 2.6 命名零件

Part | 类型 | 位置
inlet_jet | mass-flow-inlet | 静压箱顶
wall_orifice | wall | 孔圆柱壁
wall_lid | wall | 盖板下表面
wall_imp | wall，等温 50 °C | 槽底 / 驻点
fin | wall | 肋侧 + 肋顶
return_slot | pressure-outlet | 两条缝顶面
periodic_y 或 SYM | periodic / symmetry | Y=±1.2
fluid | cell zone | 全部流体

### 2.7 D=0.40 不换 0.50

仅当 0.40 的 O-grid 数值病态时允许用 0.50 调试 blocking，但必须交付 0.40 主文件，并写原因。 本方案判断两者难度同量级，不换直径。

## 3. 水力 / 热力锚点（DP-A）

工质 WATER40：ρ=992.2，μ=6.53×10⁻⁴，k=0.631，cp=4179，Pr=4.325。

### 3.1 流量拆分

量 | 值 | 含义
冷板总流量 | 2.00 L/min | 整板，不是单孔
GPU 份额 | 80% → 1.60 L/min | SPLIT_GPU
孔数 | 128 | 默认；176 须书面改口
单孔体积流 | 0.0125 L/min | 1.60/128
单孔质量流 | 1.224938×10⁻⁴ kg/s | Fluent 入口，iter 8587

ṁ₁ = ρ × Q_GPU / N_jet / 60000 = 992.2 × 1.60 / 128 / 60000 1.224938×10⁻⁴ kg/s 176 孔备选为 1.503×10⁻⁴ kg/s，本算例不用。

### 3.2 射流状态

| D=0.50（报告 §9） | D=0.40（本算例）
U | 1.061 m/s | 0.9824 m/s（iter 8587，ṁ=1.224938×10⁻⁴ kg/s）
ReD | 806 | 597.1
孔口 ΔP（K=1.8） | 1.01 kPa | 2.45 kPa
Martin 窗 | 外推 | 仍外推

V4 锚定（本几何）：ṁ≈6.15×10⁻⁴ kg/s 使 ReD=3000。本周不必跑。

### 3.3 一维对照带

模型 | h 或 h_eff | 说明
乐观 Martin（报告，D=0.50） | 51470 W/m²K | Re 外推
保守 短槽+驻点核 | 27460 W/m²K | h_ch≈6379，h_stag≈32181
Martin 改用本几何 D=0.40 | ~64600 W/m²K | 仍外推，仅作量级
整板 Rθ,c-in | 0.0202–0.0355 °C/W | 单元胞不可比

两句硬约束。 （1）20 kPa 是冷板本体窗（目标 18），不含 UQD；单元胞孔口只有约 1–3 kPa。 （2）2.0 L/min 是整板总流量。把 2.0 填进 mass-flow-inlet 视为计划失败。

## 4. ICEM 工作流

顺序锁死：几何 → 命名 parts → blocking → 网格 → 质量表 → Fluent msh。不得先加密再补面名。

### 4.1 几何

ICEM 内点/线/面/体素构造，布尔成单一流体体，与 §2 误差 < 0.01 mm。孔必须是圆；应急网格允许等面积方孔（边长 0.3545 mm），主 replay 仍建圆孔。

set AWP_ROOT261=E:\cae\programfiles\Ansys2026\ANSYS Inc261\v261 "%AWP_ROOT261%\icemcfd\win64_amd\bin\icemcfd.bat" -batch -script build_uc01b.rpl GUI：File → Replay Scripts → 打开本目录 .rpl。

### 4.2–4.3 Parts 与 blocking

Parts 见 §2.6。孔+箱 O-grid；间隙 H 网格；三槽各一砖；回液竖砖与槽端对接；Y 两侧点数一致。 O-grid 失败则 tet+prism（首层仍 ≤3 μm），日志写明「非 hex」。

### 4.4 网格指标

指标 | 目标 | 第一案可接受
壁面第一层 | ≤ 3 μm | 必须
驻点法向层数 | ≥ 15 | ≥10 可开算
孔径向 / 轴向 | ≥8–12 / ≥8 | 8 / 8
间隙法向 | ≥ 20 | 12
单元数（hex） | 0.8–2.5 M | 出残差可先 0.2–0.8 M
正交质量 | min > 0.15 | 负体积 = 失败
y⁺（设计点） | < 1 | 3 μm 约 0.5–1.2

未跑通 ICEM 不得声称网格已质量检查。许可证挡住则留脚本 + 完整错误日志。

## 5. Fluent 设置（必做）

"%AWP_ROOT261%\fluent\ntbin\win64\fluent.exe" 3ddp -t8 -g -i fluent\uc01b_laminar.jou 无 GUI 双精度；核数不得超过许可证

项 | 第一案（必跑） | 第二案（有时间）
名称 | UC-01b-L-1008 | UC-01b-S-1008
粘性 | 层流 | k-ω SST 低 Re
ṁ / T_in | 1.224938e-4 kg/s 313.15 K | 同左
出口 | return_slot，Pg=0 | 同左
wall_imp | 等温 323.15 K | 同左
Y 面 | 先 SYM | 同左
迭代 | 50–200 步交差 | 同左

监视：残差、入口平均静压、质量不平衡、wall_imp 面平均 h（参考 Tin）。 写出 residual.out / monitors.csv。 过夜标准（连续/动量 <1e-4，能量 <1e-6）本周不强制。 未迭代出的云图不得进结果报告。

## 6. 闸门 G0–G4

闸门 | Go 条件 | 未满足时允许 | 禁止
G0 环境 | ICEM+Fluent 可执行文件；许可 ≥4 核 | 写方案与脚本 | 声称 CFD 已完成
G1 几何 | 尺寸=冻结表，parts 齐全 | 改 replay | 宣称网格合格
G2 网格 | 有 msh、无负体积、单元数已记 | 粗网格出残差 | 未求解就报 y⁺
G3 短算 | 层流起步，残差落盘 | 写真实残差 | 编造 Nu / 云图
G4 对照 | 报出 ΔP 与（若有）h | 指出超带原因 | 改孔径、外推整板 R

G5 扩阵（8×8）本算例不做。V4 Martin 锚定本周不是交货门。

## 7. 风险与开放项

编号 | 风险 | 等级 | 缓解
RK-Y1 | Y=±1.2 mm 喷泉/上洗，侧槽 h 被歪 | 高 | 先 SYM；不把 UC h 当边缘孔
RK-Re | ReD=597.1 < 2000（iter 8587） | 高 | 只报数字与带宽；V4 另案
RK-HEX | 圆孔+三槽 hex Tcl 易失败 | 中 | tet/prism 或等面积方孔应急
RK-LIC | 许可证拒绝 | 高 | 全文保留错误
RK-BC | 回液建成 X 周期或 bank 出流 | 高 | parts 写死，只许上抽
RK-Q | 入口误填 2.0 L/min | 高 | journal 写死 1.224938e-4
RK-dP | 用单元胞 ΔP 对 20 kPa | 中 | 20 kPa 不含 UQD，且含歧管

开放项默认：O-01 半缝上抽；O-02 ICEM hex 优先；O-03 Y 先 SYM；O-04 128 孔；O-05 D=0.40。

## 8. 成功判据（对 1D 的 h、ΔP）

提取 | 对照 | 本周通过线
残差文件 | — | journal 启动且迭代 ≥1
入口–出口 ΔP | 2.45 kPa（K=1.8，D=0.40） | 量级 0.5–8 kPa 可讨论
wall_imp 面平均 h | 2.7e4–5.1e4（报告带）；本几何 ~6.5e4 | 能提取就对照
层流 vs SST | 差 >20% 只给区间 | 只跑层流须声明
整板 R | 0.0202–0.0355 °C/W | 禁止用本算例关闭

## 9. 文件树

design/cfd/uc01b_2.4x3.0/
  UC01b_ICEM_Fluent_工作方案_v1.0.html
  UC01b_ICEM_Fluent_工作方案_v1.0.md
  README.md
  icem/     build_uc01b.rpl .tcl   （.prj/.msh 跑通才有）
  mesh/     write_hex_msh.py       （应急笛卡尔 hex）
  fluent/   uc01b_laminar.jou
  logs/     ansys_paths.txt  icem_batch.log  fluent_batch.log
  UC01b_ICEM_Fluent_结果报告_v1.0.html / .md   ← 步骤 4，Fluent 起步后才写

## 10. 谁跑什么、工时

步骤 | 内容 | 谁 | 工时
1 | 本方案 HTML+MD | Agent | 1–1.5 h
2a–c | ICEM 几何/网格/QA | Agent；人救 GUI | 5–11 h
3a | Fluent 层流短残差 | Agent 批处理 | 1–3 h
3b | SST（可选） | Agent / 人 | +1–2 h
3c | 过夜收敛 | 人 | 另排
4 | 结果报告（只写真实输出） | Agent | 1–2 h
本周最小闭环合计约 8–16 h；正式三套网格 + V4 + SST 再 +1–2 工作日

## 11. 执行顺序（冻结，四步）

1. 方案+计划（本 HTML / 配套 MD）。
2. ICEM 几何 + 网格。失败留日志。
3. Fluent 计算（必做）。层流第一，至少数十步残差。
4. 结果报告 HTML+MD。只引用步骤 3。没有残差就不能写第 4 步。

## 12. 与既有文档的关系

文档 | 关系
calc/model.py | 数值唯一源。本算例 D、Sy 按用户冻结覆盖 GEO
设计报告 v2.0 §9 / §10 | Q1 局部 h；C01 整板不在本周
CFD-AI Agent 能力评估 v1.0 | 能力边界与 G0–G5；本文是 UC-01b 开工令
UC01 壁面射流说明 | 流路与三区；Sy 已从 3.0 收到 2.4

同目录 Markdown 与本文内容对等，可脱离浏览器阅读。结果报告是另一对 HTML+MD，必须在 Fluent 起步之后写。

AIDC-B300-CFD-UC01b-PLAN-001 · 工作方案 v1.0 · 2026-09-21
型号 CP-B300-JM-01 | DP-A 1100 W @ 2.0 L/min（整板） | GPU 1.60 L/min / 216 | ṁjet = 1.224938e-4 kg/s | iter 8587
20 kPa 冷板窗不含 UQD。本文不是仿真报告，不是许可证申请书。
ANSYS 2026 R1 / v261 | E:\cae\programfiles\Ansys2026\ANSYS Inc261\v261
