bruce2012lu/AIDCtms_design202609/coolingplate/design/cfd/uc01b_2.4x3.0/UC01b_ICEM_Fluent_结果报告_v1.0.html

AIDC-B300-CFD-UC01b-RES-001 · iter 529 · n216_q105_sym

# UC-01b ICEM / Fluent 结果报告 v1.0

当前场是 iter 529，fluent/uc01b_cht_v2_n216_q105_sym（2026-09-25 16:00，从混合初始化重算，不读 7900 或 8587 的数据）。TIM 底 341.9268 K（68.78 °C）。X=0.556 mm 上 ±Y 温差中位仍是 0.63 K，不能称为对称。上一场 8587 的中位差是 0.66 K。

2026-09-25 iter 529 已收敛 216 孔 · q'' 57.928 W/cm² Re_D = 597

TIM 底341.9268 K

静压 ΔP1085.97 Pa

R(T_TIM−T_in)0.031942 K/W

能量比0.951 未闭合

本页温度、压差和云图来自 uc01b_cht_v2_n216_q105_sym，iter 529。混合初始化后重算。X=0 上 ±Y 温差中位 0.0018 K；X=0.556 mm 上 ±Y 温差中位 0.63 K、最大 5.64 K，与上一场 8587 的 0.66 K / 5.70 K 同一量级，不称为对称场。没有 GCI，没有 y+。

## 1. 边界与收敛

量 | iter 529
场 | uc01b_cht_v2_n216_q105_sym.cas.h5（115480749 字节）/ .dat.h5（458025534 字节），16:00
阵列 | 9×12 / die，两 die 216。单孔 D=0.40 mm。没有对称边界
施加 q'' | 579282.41 W/m²（57.928 W/cm²），216 胞合计 900.9 W
ṁ | 1.2249382716049385×10⁻⁴ kg/s，方向 −Z。入口 W=−0.9826 m/s
残差 | 1.3062e-07 1.1074e-07 1.3559e-07 1.8577e-07 9.2473e-07 3.3142e-07 2.4924e-04，529 solution is converged
静压差 | 入口邻接流体 1085.97 Pa，出口 0.001 Pa，ΔP = 1085.97 Pa

## 2. 温度

TIM 底 wall_heat 面积加权 341.9268 K（68.78 °C）。68.78 °C = 341.9268 − 273.15。

面 | iter 529
TIM 底 wall_heat，z=−2.080 mm | 面积加权 341.9268 K；本面 341.905–341.947 K
TIM 中面，z=−2.0336 mm | 338.878–338.920 K
TIM–Cu wall_tim_cu | 面积加权 336.6716 K
铜–水整个界面 wall_cu_fluid | 面积加权 326.8120 K（53.66 °C）
出口 return_slot | 面积加权 320.8987 K（47.75 °C）；面上 318.652–322.318 K
入口 | 313.15 K（40 °C）
出口温升 / 能量温升 | 7.74875 K / 8.14772 K = 0.951，能量未闭合

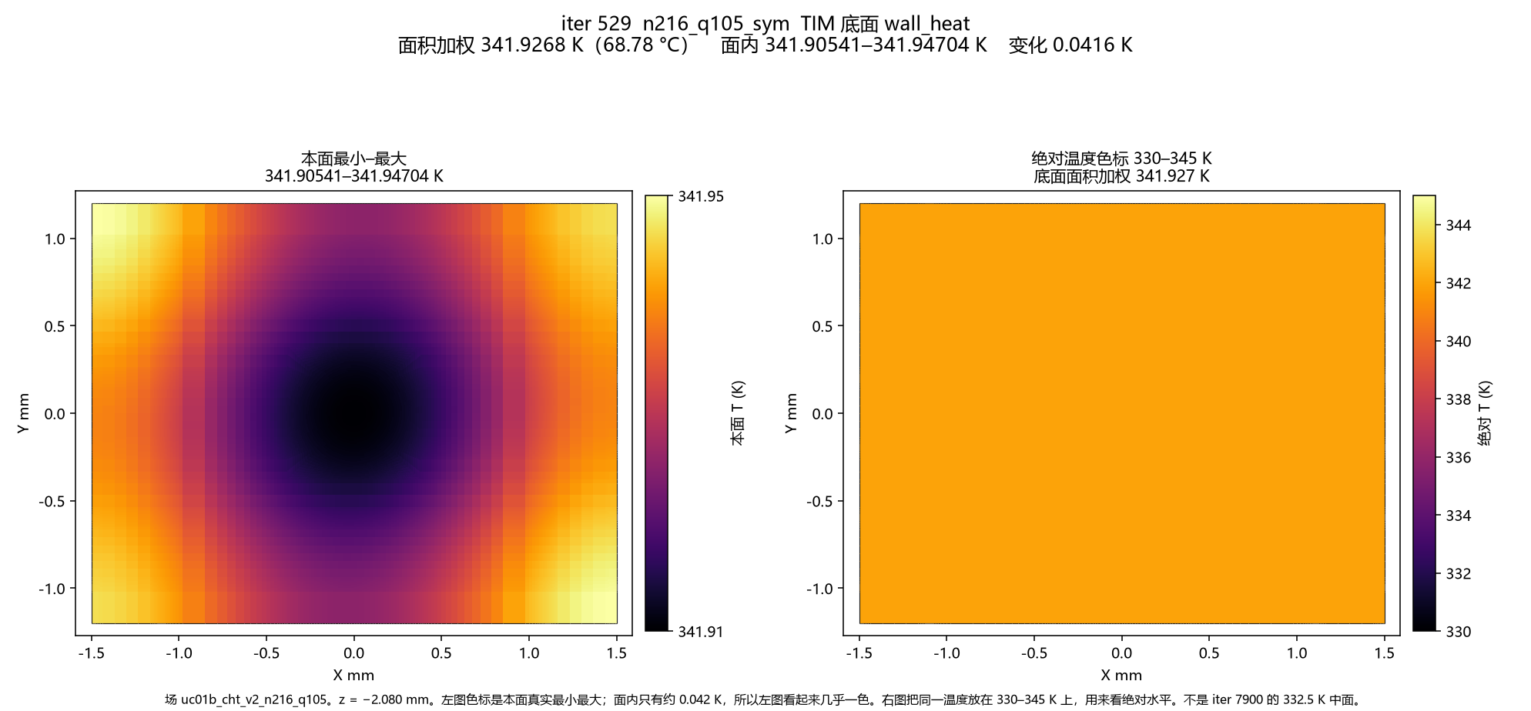
[picture p57: coolingplate/design/cfd/uc01b_2.4x3.0/figs/n216_sym_wall_heat_T.png]
TIM bottom iter 529


图 2-1 iter 529，TIM 底面 wall_heat，z=−2.080 mm。面积加权 341.9268 K（68.78 °C）。本面 341.905–341.947 K。右图色标 330–345 K。场 n216_q105_sym。

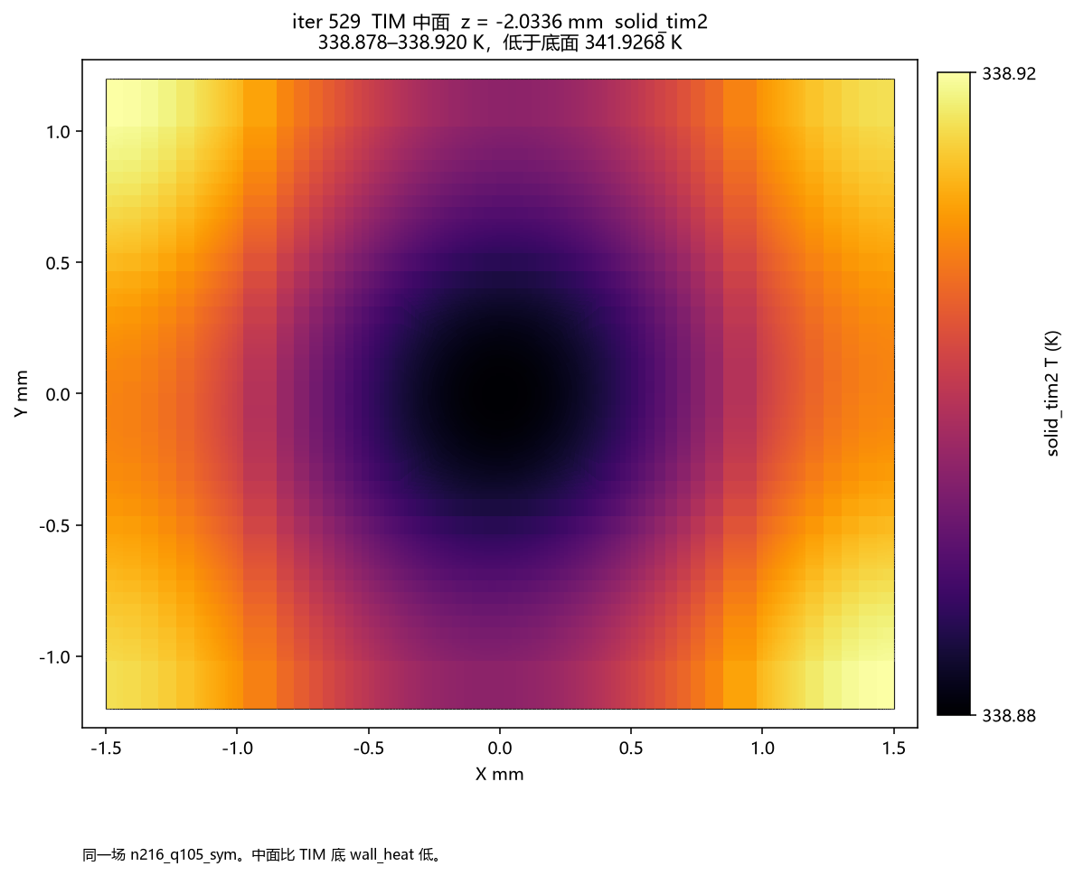
[picture p58: coolingplate/design/cfd/uc01b_2.4x3.0/figs/n216_sym_ztim_mid_T.png]
TIM mid iter 529


图 2-2 iter 529，TIM 中面 z=−2.0336 mm。338.878–338.920 K，低于底面。

## 3. 热阻

R(T_TIM−T_in) = (341.9268 − 313.15) / 900.9 = 0.031942 K/W。已含 TIM、铜和对流，不再加 R_TIM2 与 R_wall。

定义 | 两 die
R(T_TIM−T_in)，除以 900.9 W | 0.031942 K/W
R_conv = (326.8120 − 313.15) / 900.9 | 0.015165 K/W
R_c-in = R_TIM2(0.004–0.008) + R_wall(0.003392) + R_conv | 0.022557–0.026557 K/W

能量未闭合。Re_D=597 < 2000，不引用 Martin。X=0.556 mm 的 ±Y 偏置还在，热阻不写成设计已关闭。

## 4. 速度、Re 与对称性

U = 0.9824 m/s，Re_D = 597.1。入口 W=−0.9826 m/s，U=V=0。

X=0 的 ±Y 温差中位 0.0018 K，最大 0.092 K。两侧出流槽平均温度 320.616 K 与 320.614 K。X=0.556 mm 的 ±Y 温差中位 0.631 K，最大 5.64 K（肋顶 Y=±0.658 mm，Z=1.507 mm：321.89 K 对 327.52 K）。上一场 8587 是中位 0.66 K、最大 5.70 K。这一场不称为对称。

切面（iter 529） | 范围
z=4.711 mm 喷孔 | |V| 0.034–1.627 m/s；T 313.15–318.42 K
z=4.711 mm 两侧导流槽 | |V| 0.00053–0.111 m/s；T 318.70–322.38 K
X=0.556 mm 水 | T 315.73–334.18 K；|V|max 0.759 m/s

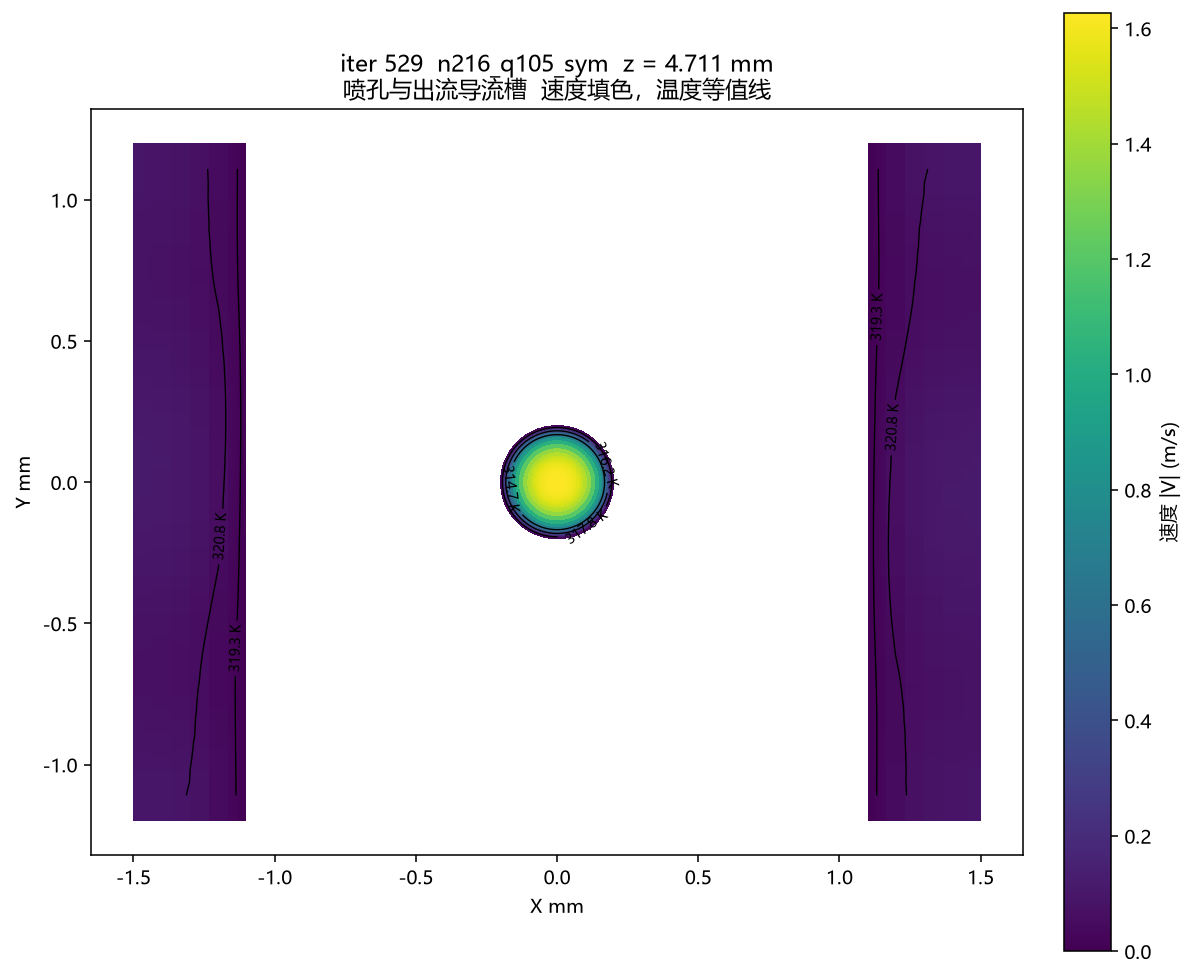
[picture p59: coolingplate/design/cfd/uc01b_2.4x3.0/figs/n216_sym_zorif_slot_vel.png]
orifice and slots


图 4-1 iter 529，z=4.711 mm。喷孔和两侧矩形出流槽都是流体。填色是速度，黑线是温度等值线。

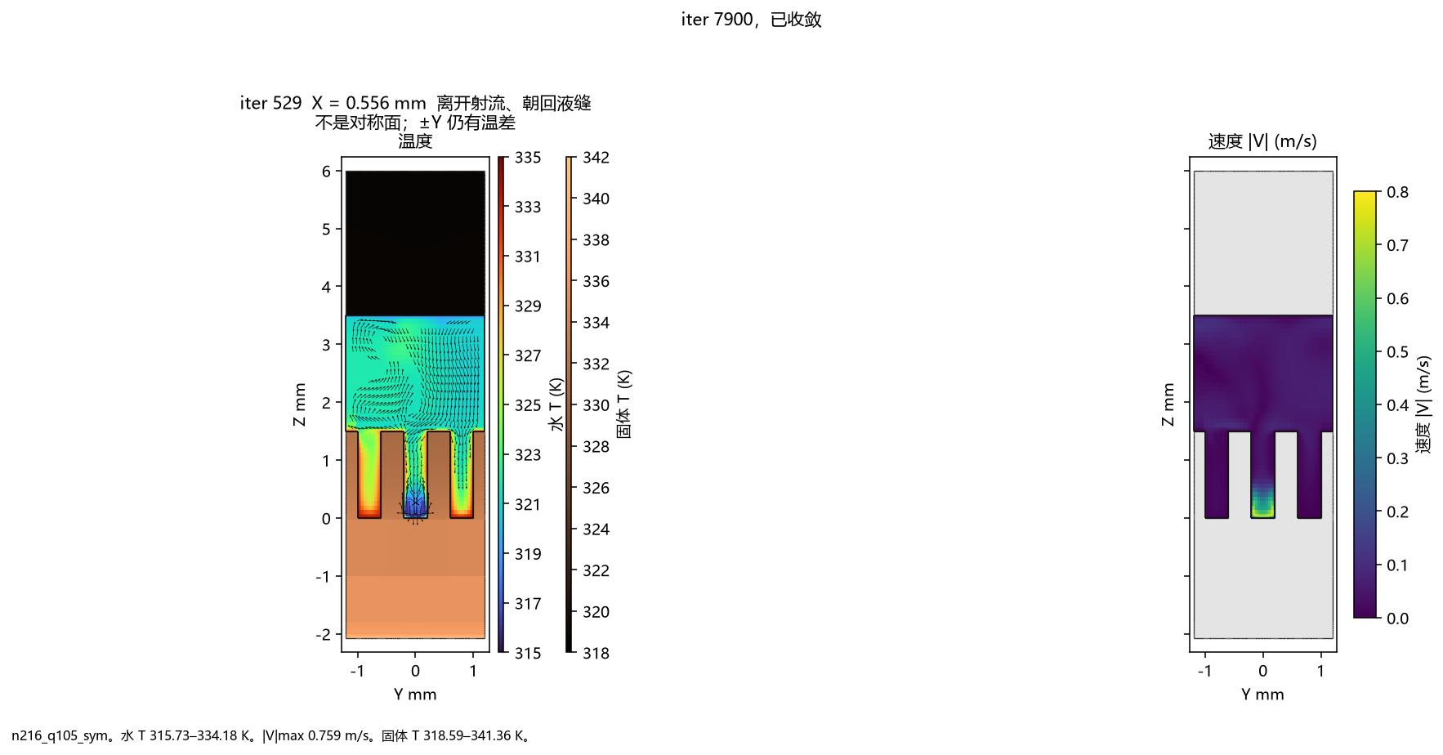
[picture p60: coolingplate/design/cfd/uc01b_2.4x3.0/figs/n216_sym_xmid_TV.png]
X 0.556


图 4-2 iter 529，X=0.556 mm。这一刀不是对称面。水 315.73–334.18 K，|V|max 0.759 m/s。±Y 温差中位仍是 0.63 K。

## 5. 剖面（iter 529）

下面都是 n216_q105_sym。X=0 上 ±Y 温差中位 0.0018 K，但 X=0.556 mm 上中位 0.631 K、最大 5.64 K，不称为对称。面积加权：TIM 底 341.9268 K，铜–水 326.8120 K，TIM–Cu 336.6716 K，出口 320.8987 K，入口 313.15 K。入口邻接流体静压 1085.97 Pa，出口 0.001 Pa。dat 里的面热流数组不是 W/m²，施加 q'' 仍是期刊 579282.4074074075。质量流量积分未再打印。

切面 | 温度或速度
TIM–Cu z=−2.000 mm | 336.650–336.692 K
铜座中面 z=−1.000 mm | 335.004–335.208 K
铜–水底面 z=0 | 332.67–334.34 K（固体侧；整个铜–水界面面积加权 326.8120 K）
肋中 z=0.750 mm 固体 | 331.258–332.398 K
肋顶 z=1.500 mm | 329.89–331.69 K
孔板固体 z=4.711 mm | 318.605–318.691 K
槽中水 z=0.750 mm | 313.40–332.32 K，|V|max 1.406 m/s
间隙 z=2.500 mm | 313.15–324.14 K，|V|max 1.656 m/s
圆孔水 z=4.711 mm | 313.15–322.38 K，|V|max 1.627 m/s
回液缝入口 z=3.500 mm | 319.15–322.64 K，|V|max 0.121 m/s
回液缝中段 z=4.711 mm | 318.702–322.375 K，|V|max 0.111 m/s
出口 z=6 mm | 318.65–322.32 K，|V|max 0.108 m/s
Y=0 | 水 313.15–333.33 K，|V|max 1.699 m/s
Y=0.800 mm | 水 317.84–334.23 K，|V|max 0.458 m/s
X=0 | 水 313.15–334.13 K，|V|max 1.699 m/s

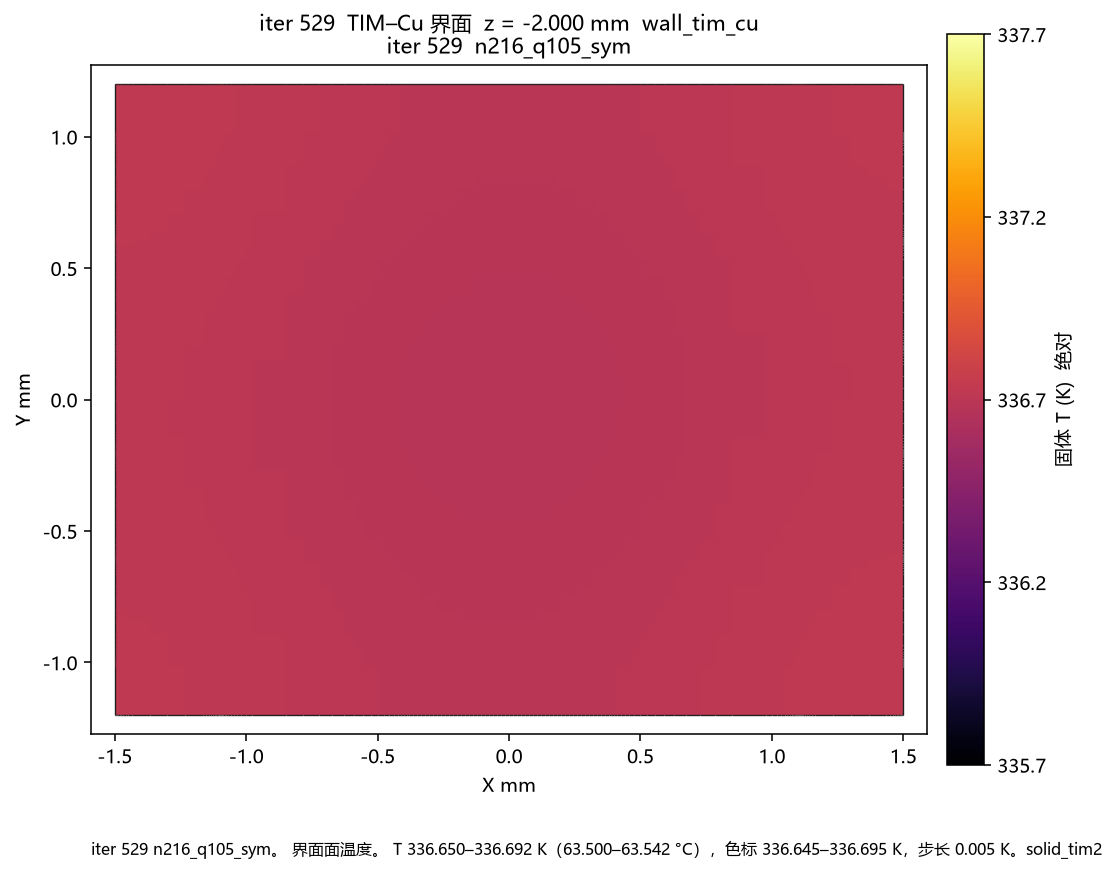
[picture p61: coolingplate/design/cfd/uc01b_2.4x3.0/figs/n216_sym_ztimcu_T.png]
TIM copper


图 5-1 iter 529，TIM–Cu，z=−2.000 mm。336.650–336.692 K。n216_q105_sym。

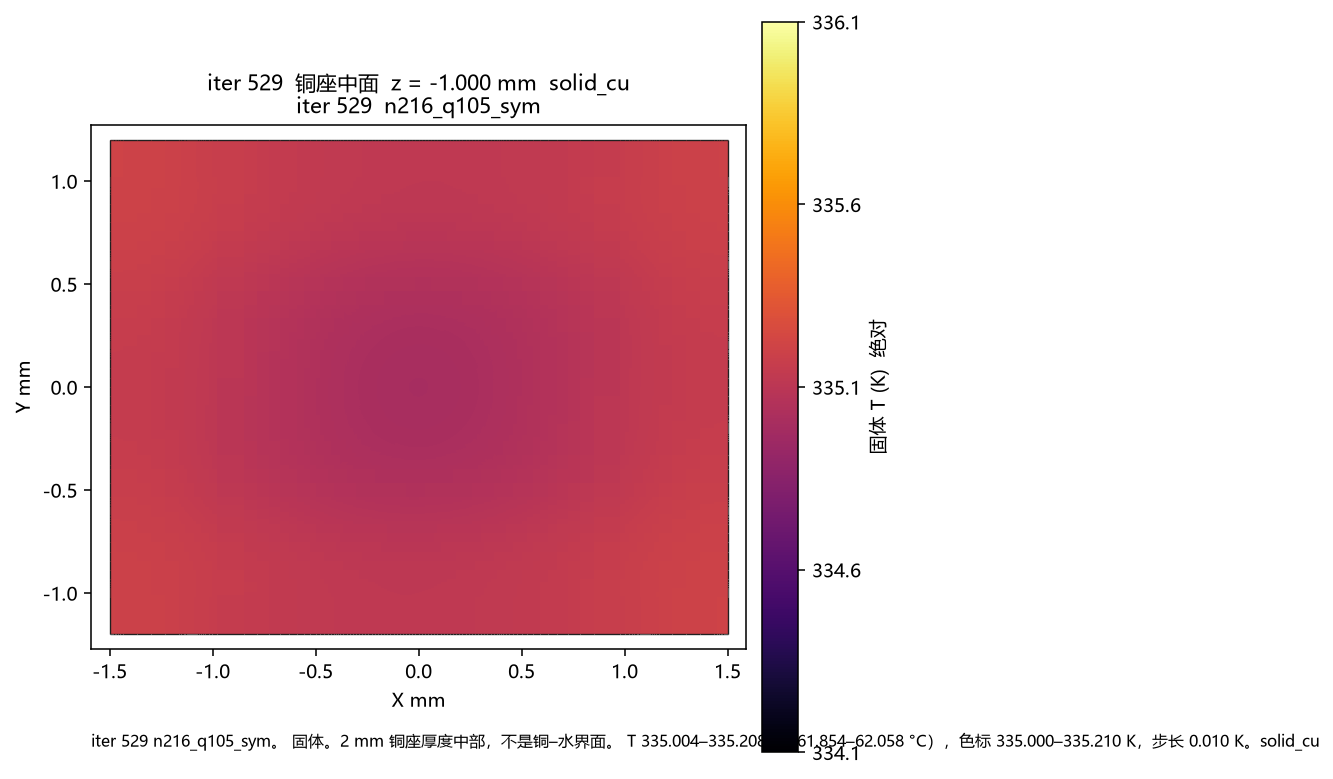
[picture p62: coolingplate/design/cfd/uc01b_2.4x3.0/figs/n216_sym_zcu_mid_T.png]
copper mid


图 5-2 iter 529，铜座中面，z=−1.000 mm。335.004–335.208 K。

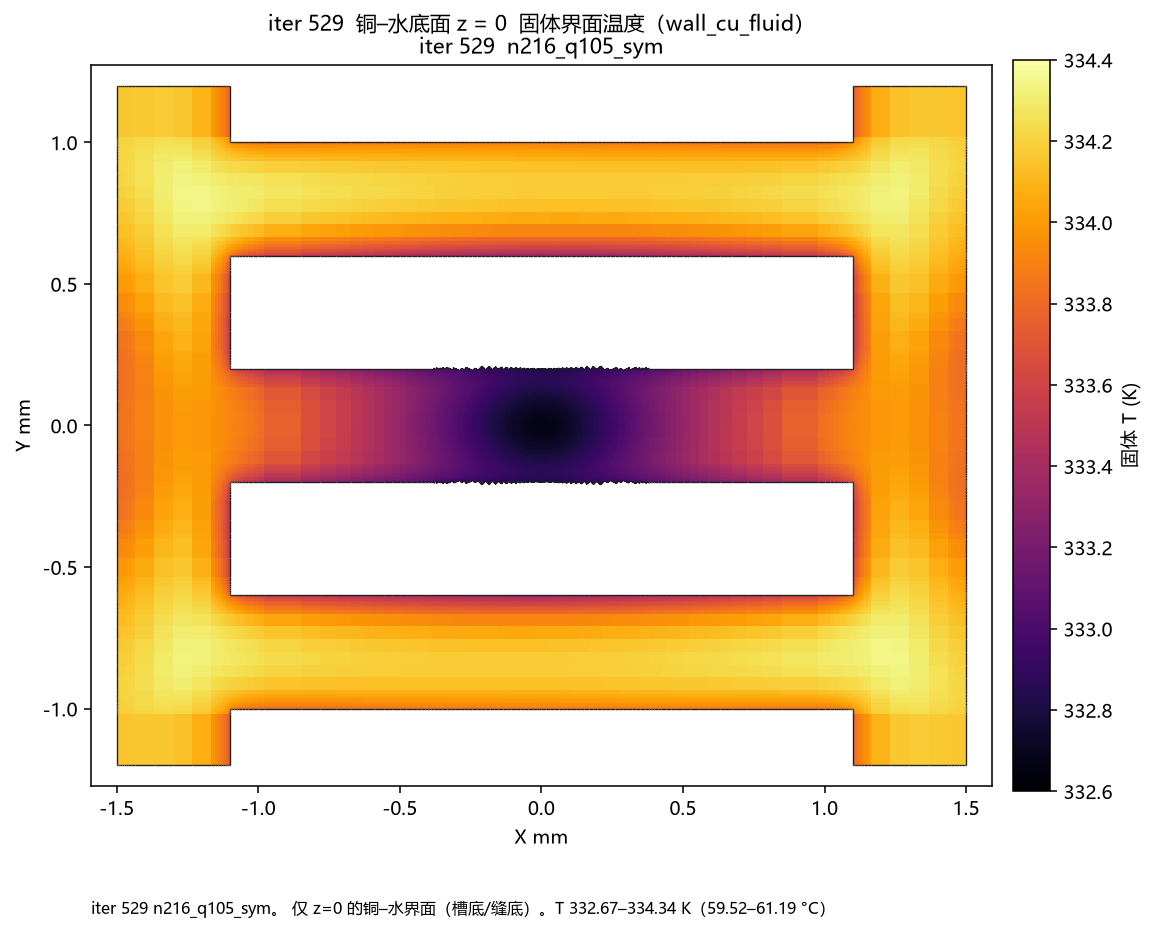
[picture p63: coolingplate/design/cfd/uc01b_2.4x3.0/figs/n216_sym_z0_T.png]
floor


图 5-3 iter 529，铜–水底面 z=0，固体侧。332.67–334.34 K。

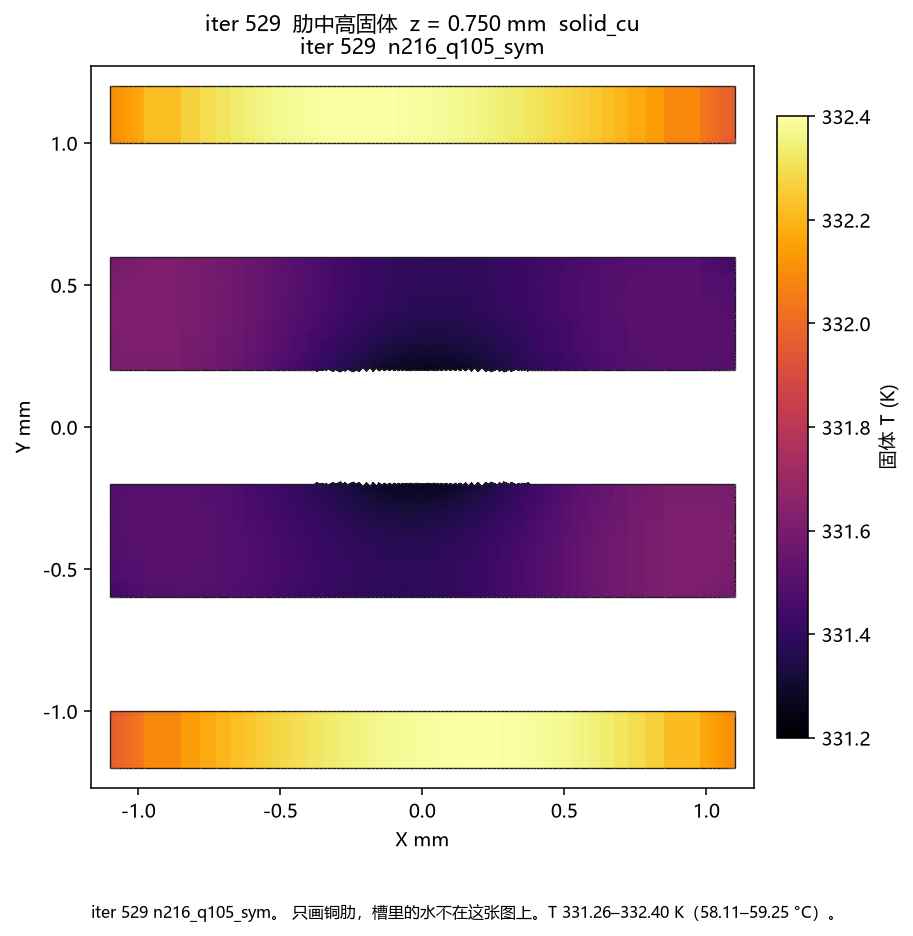
[picture p64: coolingplate/design/cfd/uc01b_2.4x3.0/figs/n216_sym_zrib_mid_T.png]
rib mid


图 5-4 iter 529，肋中固体，z=0.750 mm。331.258–332.398 K。

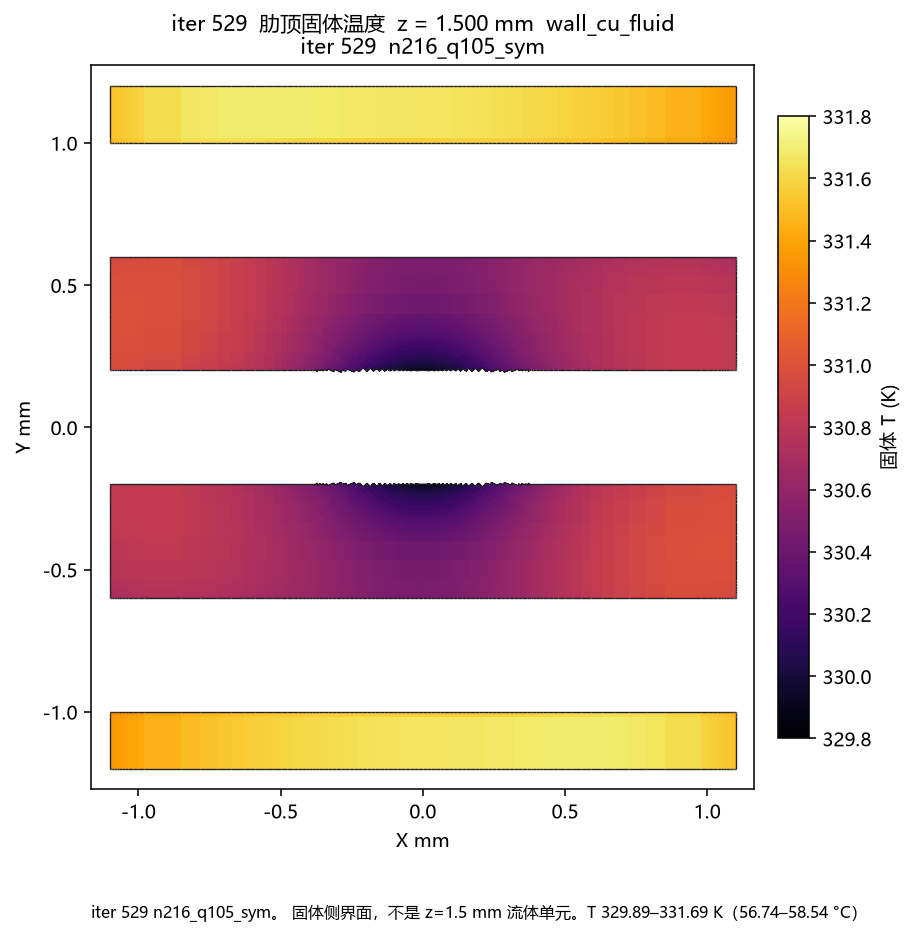
[picture p65: coolingplate/design/cfd/uc01b_2.4x3.0/figs/n216_sym_zrib_solid_T.png]
rib top


图 5-5 iter 529，肋顶，z=1.500 mm。329.89–331.69 K。

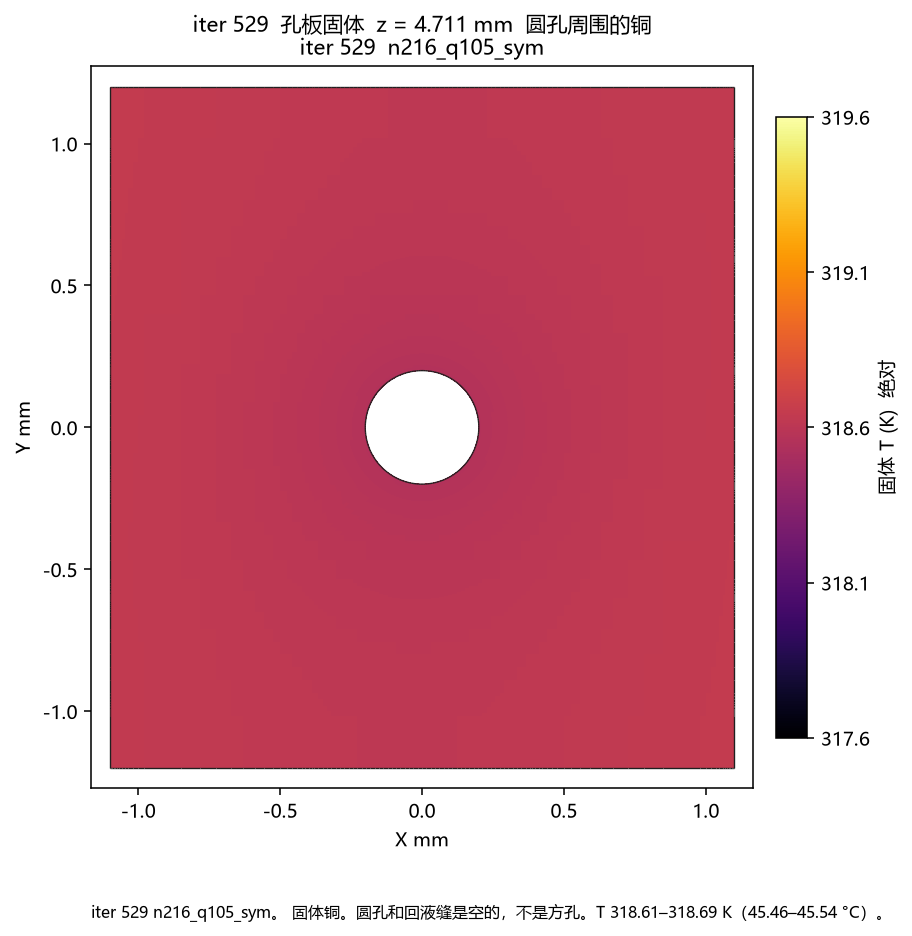
[picture p66: coolingplate/design/cfd/uc01b_2.4x3.0/figs/n216_sym_zorif_solid_T.png]
orifice solid


图 5-6 iter 529，孔板固体，z=4.711 mm。318.605–318.691 K。圆孔和导流槽在这张固体图上是空的；流体速度见图 4-1。

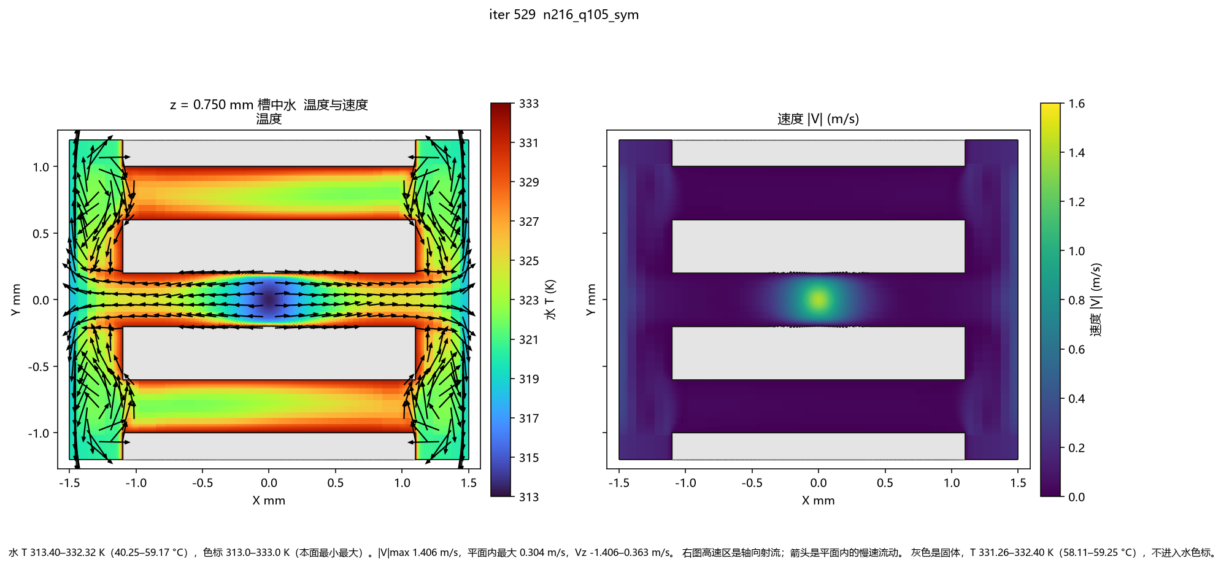
[picture p67: coolingplate/design/cfd/uc01b_2.4x3.0/figs/n216_sym_zmid_TV.png]
mid slot


图 5-7 iter 529，z=0.750 mm 槽中水。313.40–332.32 K，|V|max 1.406 m/s。

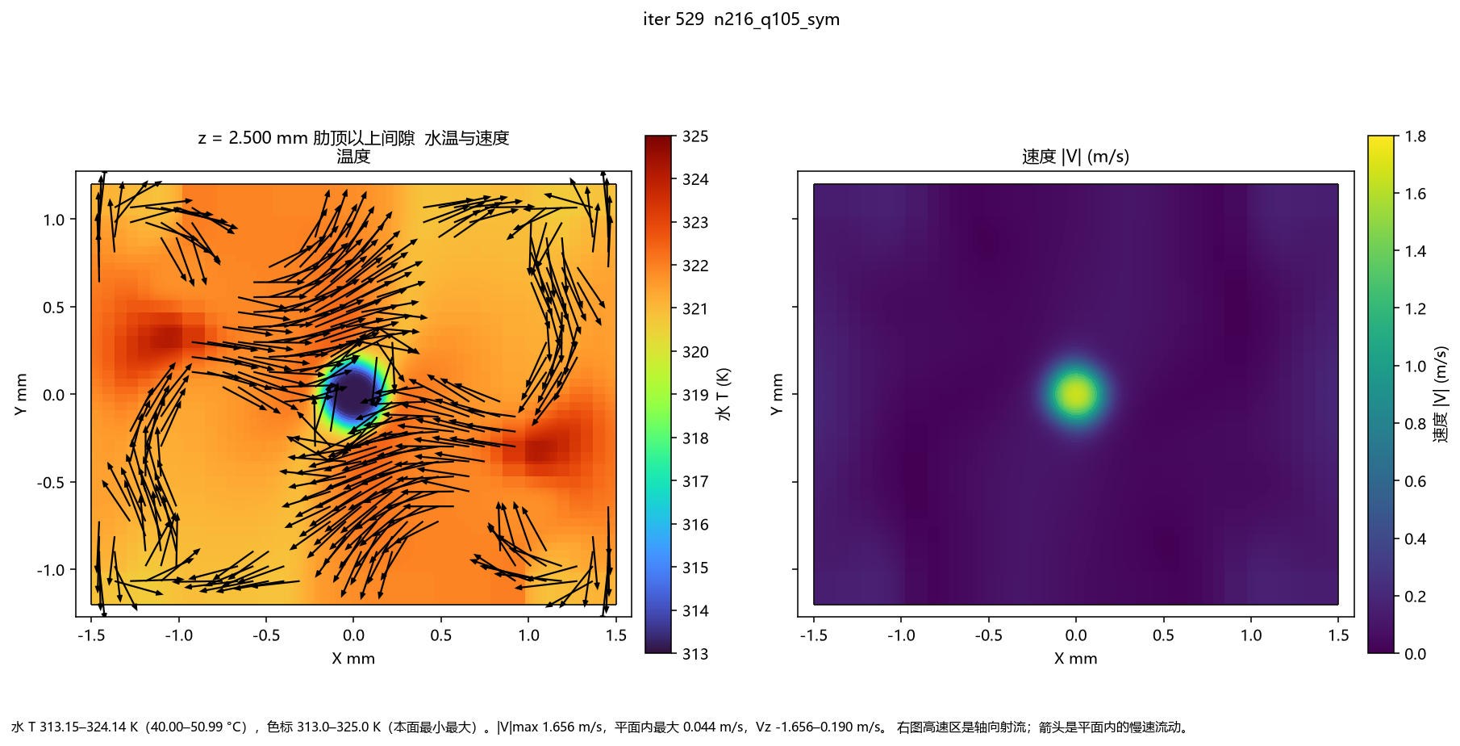
[picture p68: coolingplate/design/cfd/uc01b_2.4x3.0/figs/n216_sym_zgap_TV.png]
gap


图 5-8 iter 529，z=2.500 mm 间隙。313.15–324.14 K，|V|max 1.656 m/s。

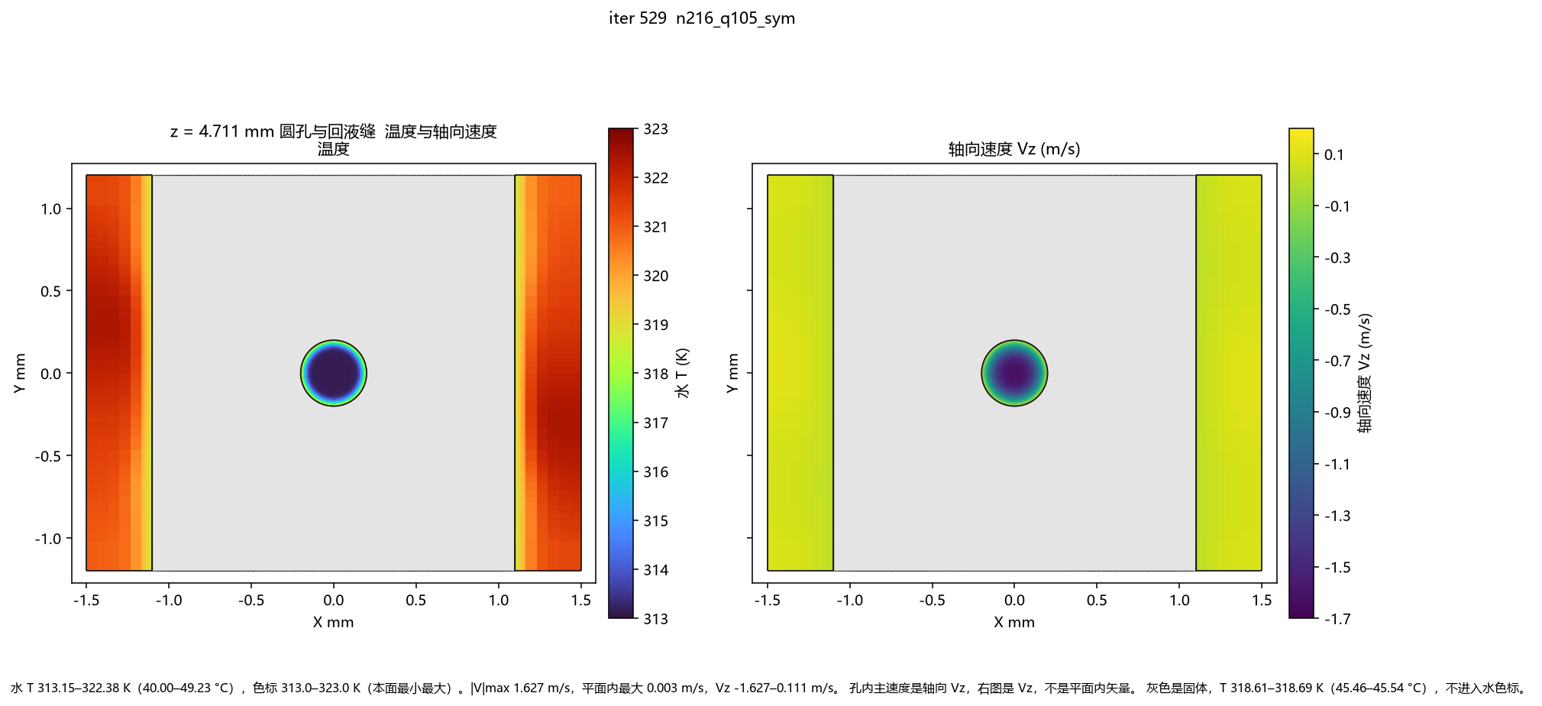
[picture p69: coolingplate/design/cfd/uc01b_2.4x3.0/figs/n216_sym_zorif_TV.png]
orifice fluid


图 5-9 iter 529，z=4.711 mm 圆孔与缝内的水。313.15–322.38 K，|V|max 1.627 m/s。

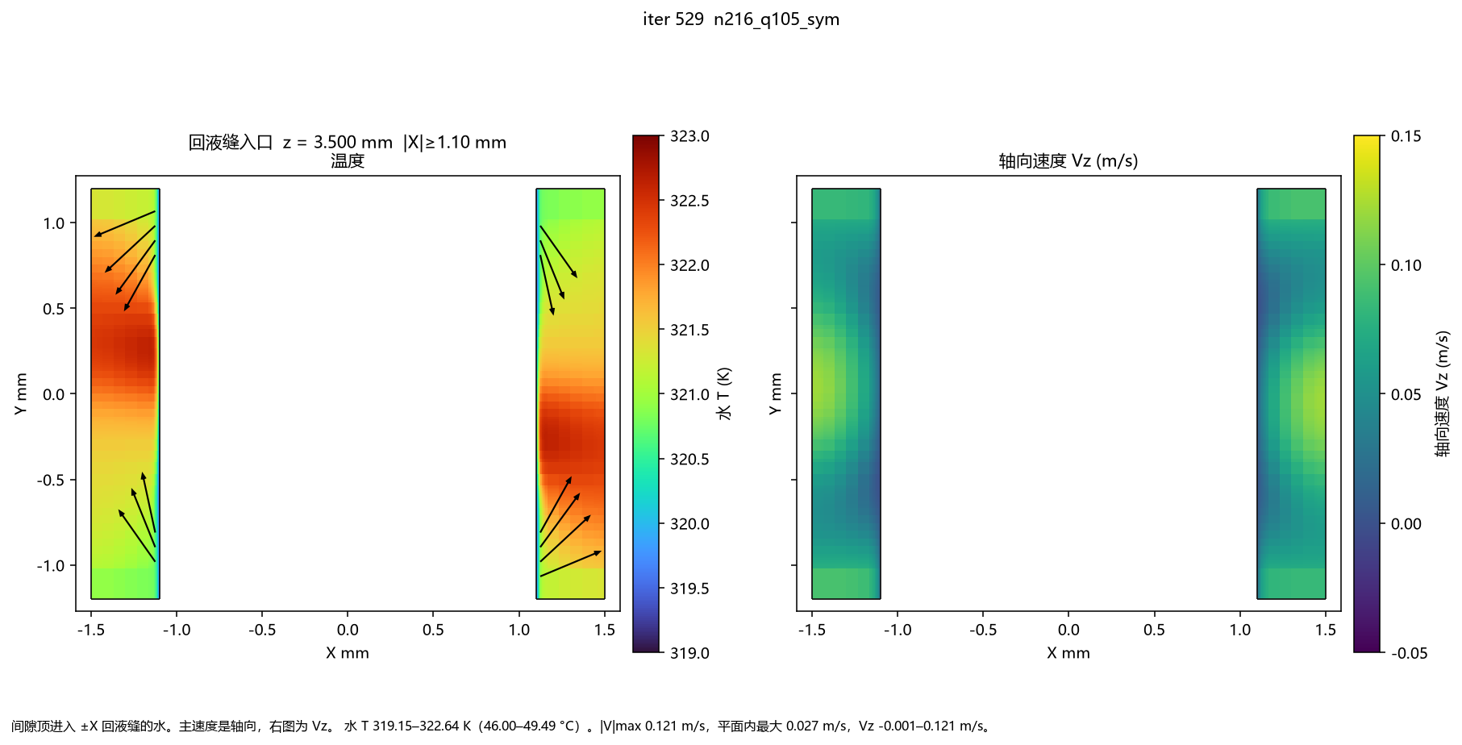
[picture p70: coolingplate/design/cfd/uc01b_2.4x3.0/figs/n216_sym_slitin_TV.png]
slit inlet


图 5-10 iter 529，回液缝入口 z=3.500 mm。319.15–322.64 K，|V|max 0.121 m/s。

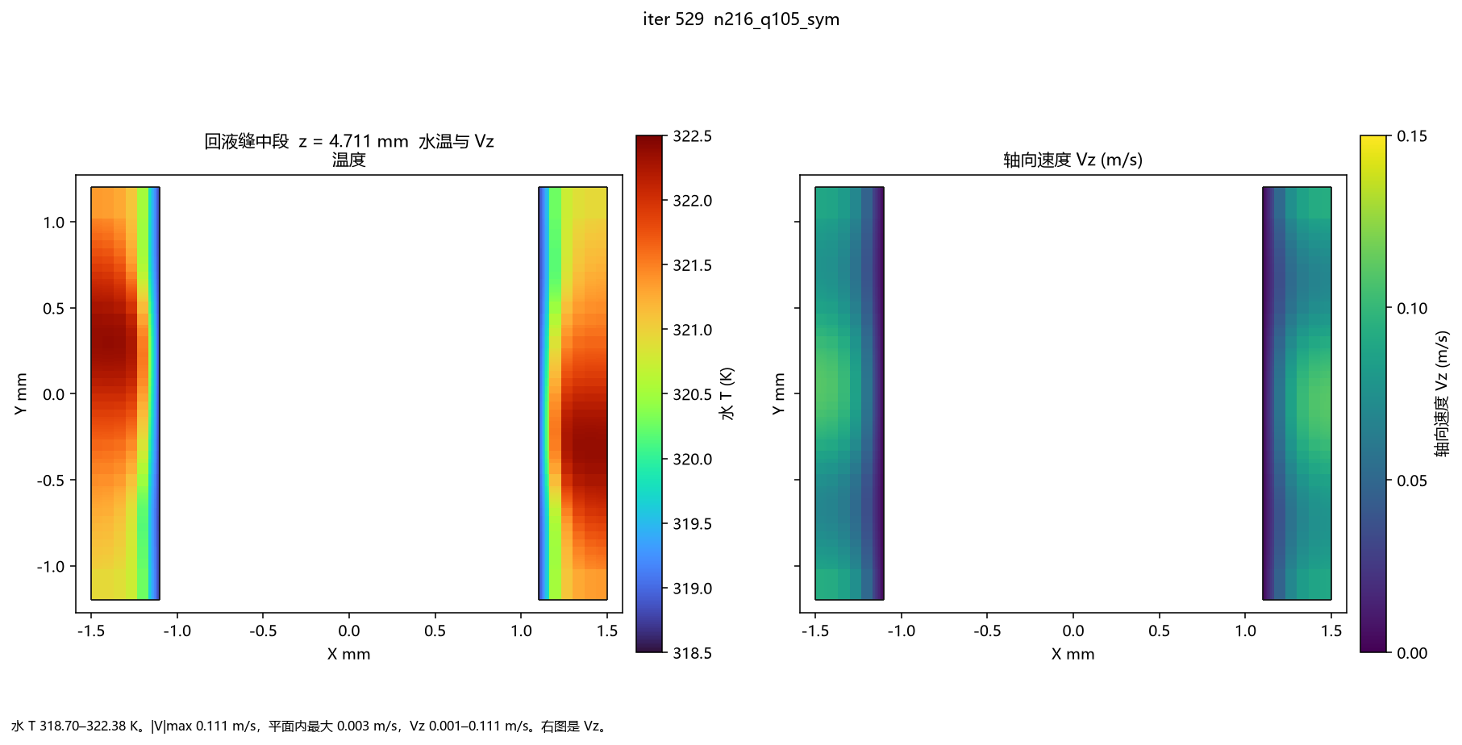
[picture p71: coolingplate/design/cfd/uc01b_2.4x3.0/figs/n216_sym_zreturn_mid_TV.png]
return mid


图 5-11 iter 529，回液缝中段 z=4.711 mm。318.702–322.375 K，|V|max 0.111 m/s。

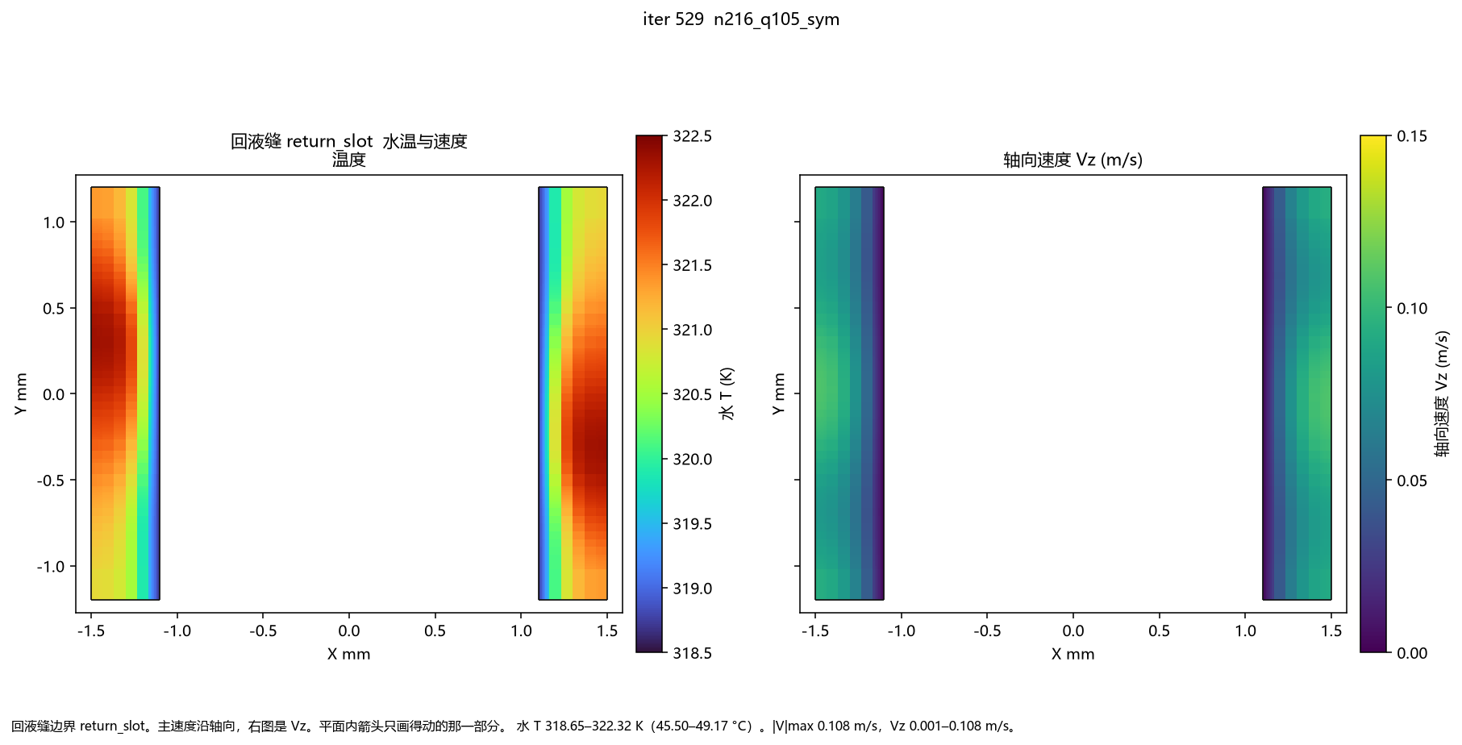
[picture p72: coolingplate/design/cfd/uc01b_2.4x3.0/figs/n216_sym_return_TV.png]
outlet


图 5-12 iter 529，出口 z=6 mm。318.65–322.32 K，|V|max 0.108 m/s。面积加权 320.8987 K。

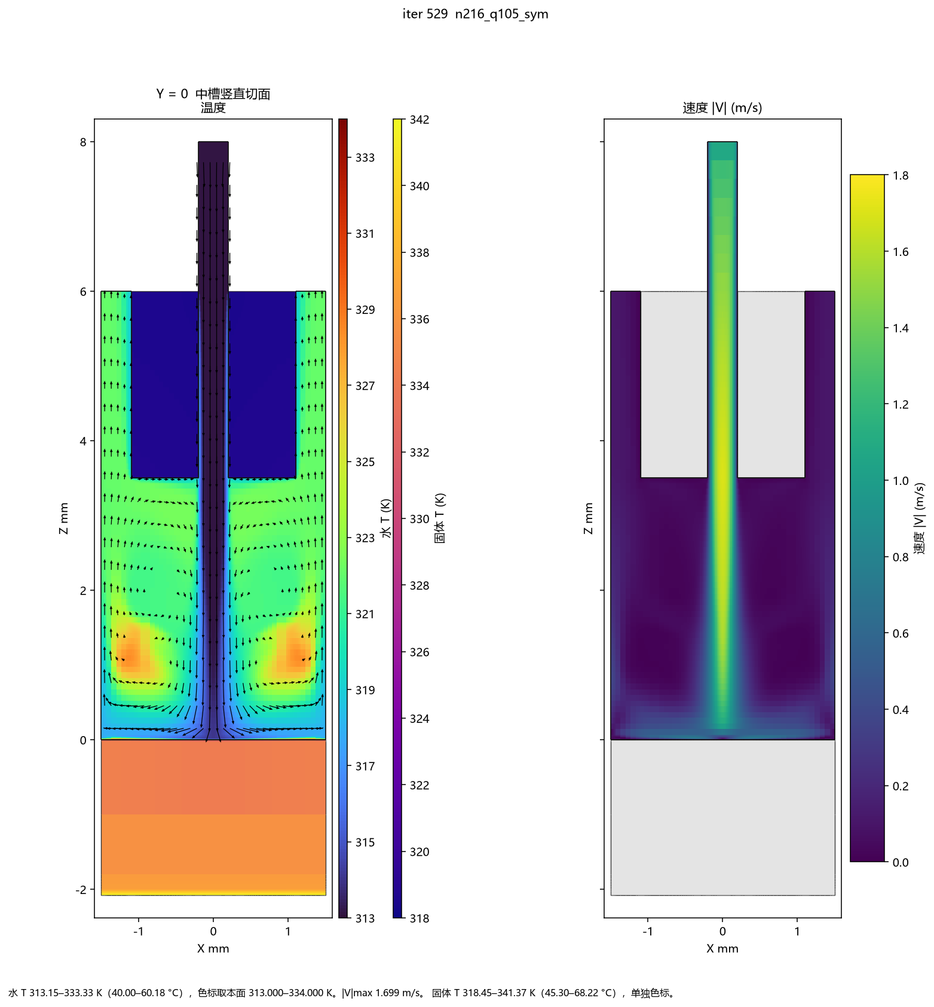
[picture p73: coolingplate/design/cfd/uc01b_2.4x3.0/figs/n216_sym_y0_TV.png]
Y0


图 5-13 iter 529，Y=0。水 313.15–333.33 K，|V|max 1.699 m/s。

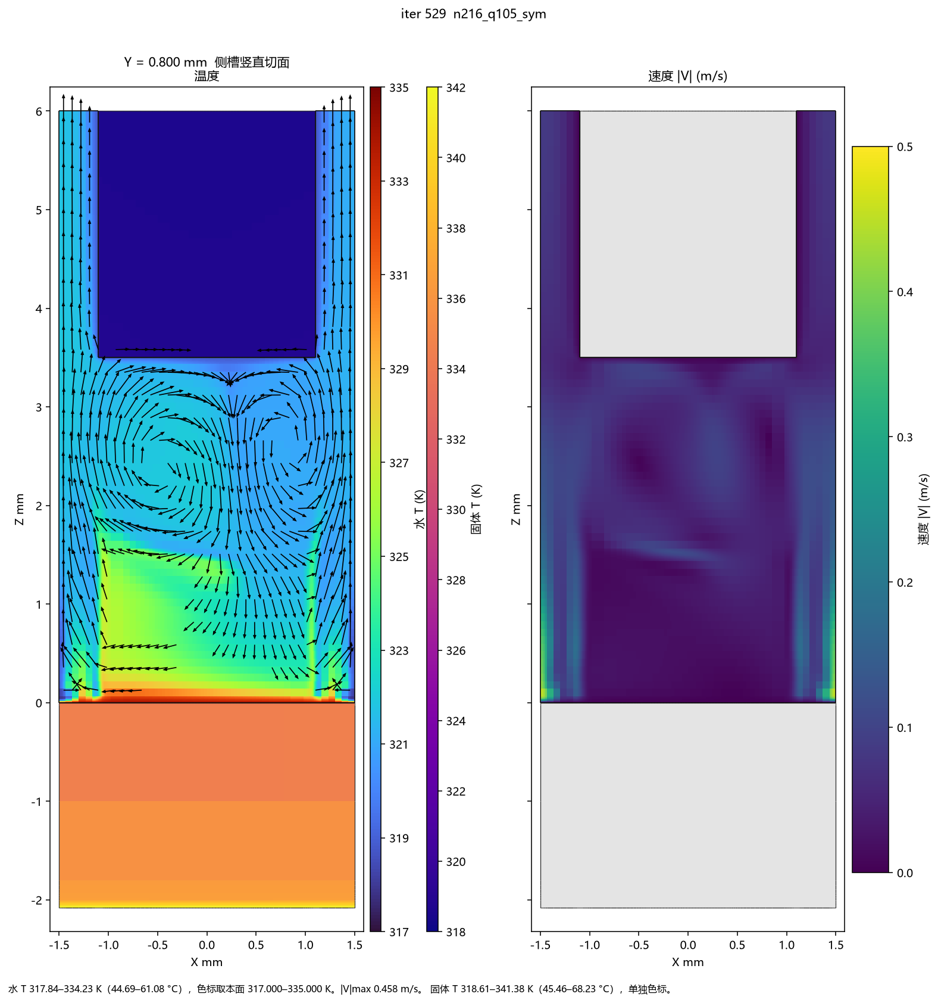
[picture p74: coolingplate/design/cfd/uc01b_2.4x3.0/figs/n216_sym_yside_TV.png]
Y side


图 5-14 iter 529，Y=0.800 mm。水 317.84–334.23 K，|V|max 0.458 m/s。

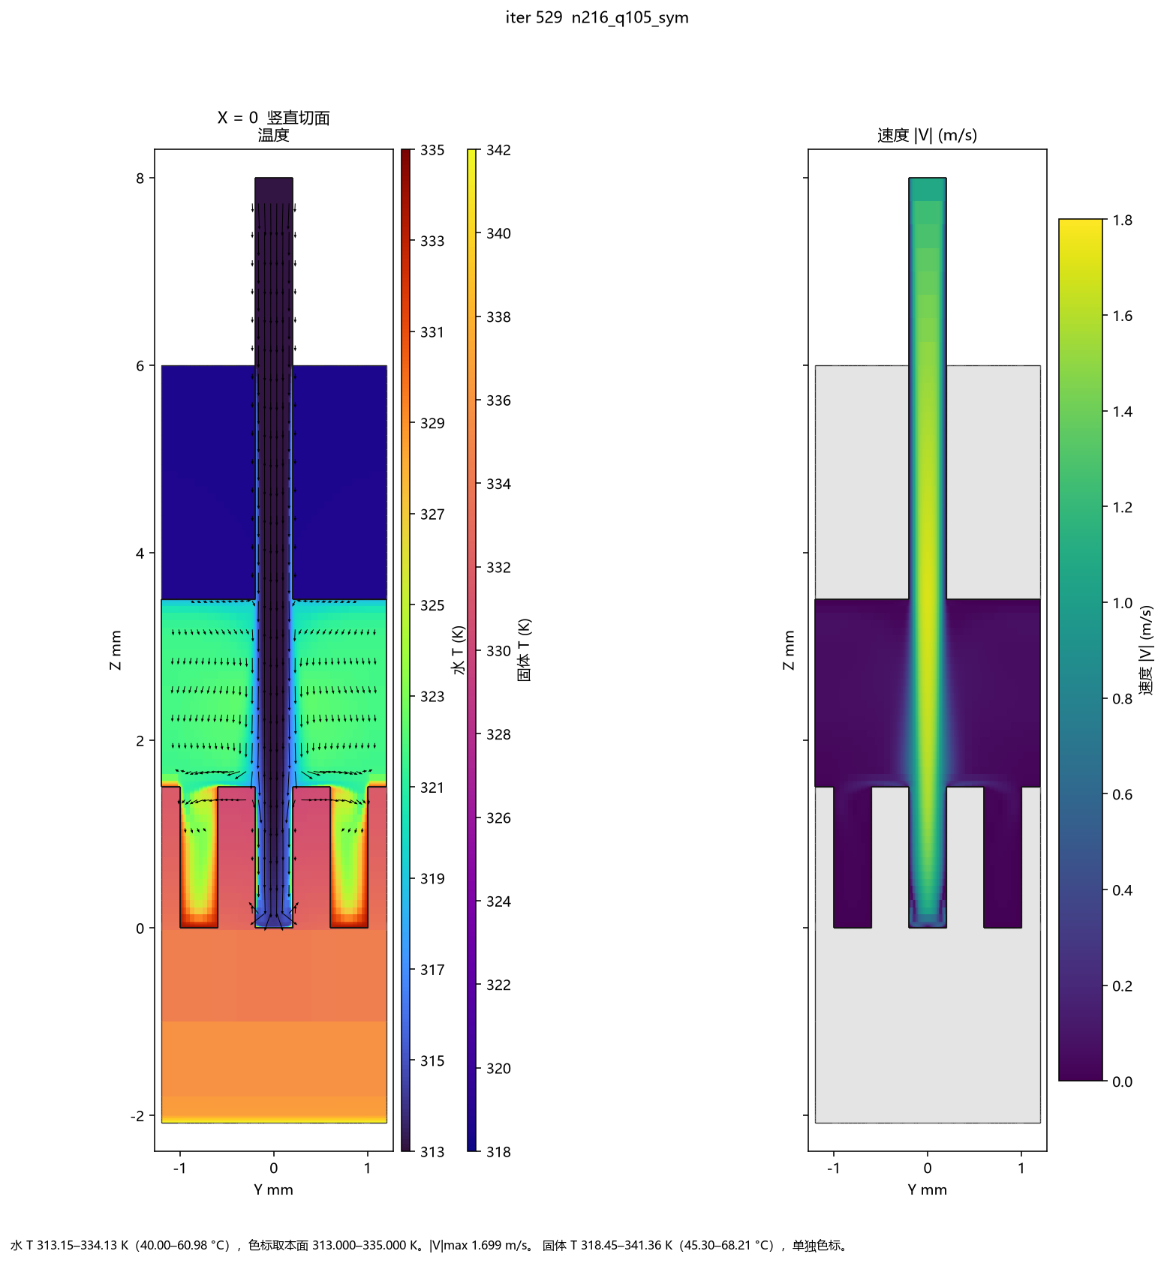
[picture p75: coolingplate/design/cfd/uc01b_2.4x3.0/figs/n216_sym_x0_TV.png]
X0


图 5-15 iter 529，X=0。水 313.15–334.13 K，|V|max 1.699 m/s。这一面 ±Y 温差中位 0.0018 K。

## 6. 网格剖面（不是温度）

来源 mesh/uc01b_cht_v2.msh，4472280 HEXA，与这场用的是同一套网格。图上只有单元面，没有温度。坐标是毫米。

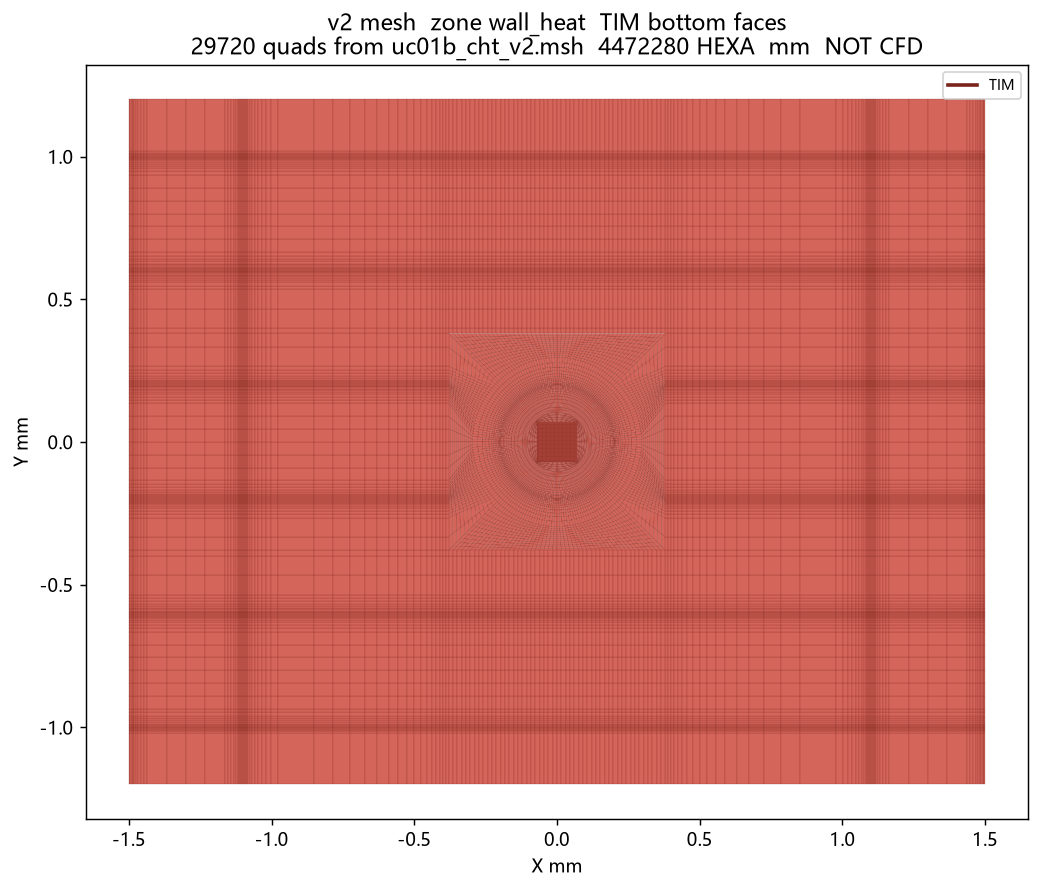
[picture p76: coolingplate/design/cfd/uc01b_2.4x3.0/figs/n216_mesh_wall_heat.png]
mesh TIM bottom


图 6-1 网格。TIM 底面区域 wall_heat，z=−2.080 mm。29720 个四边形。不是温度云图。

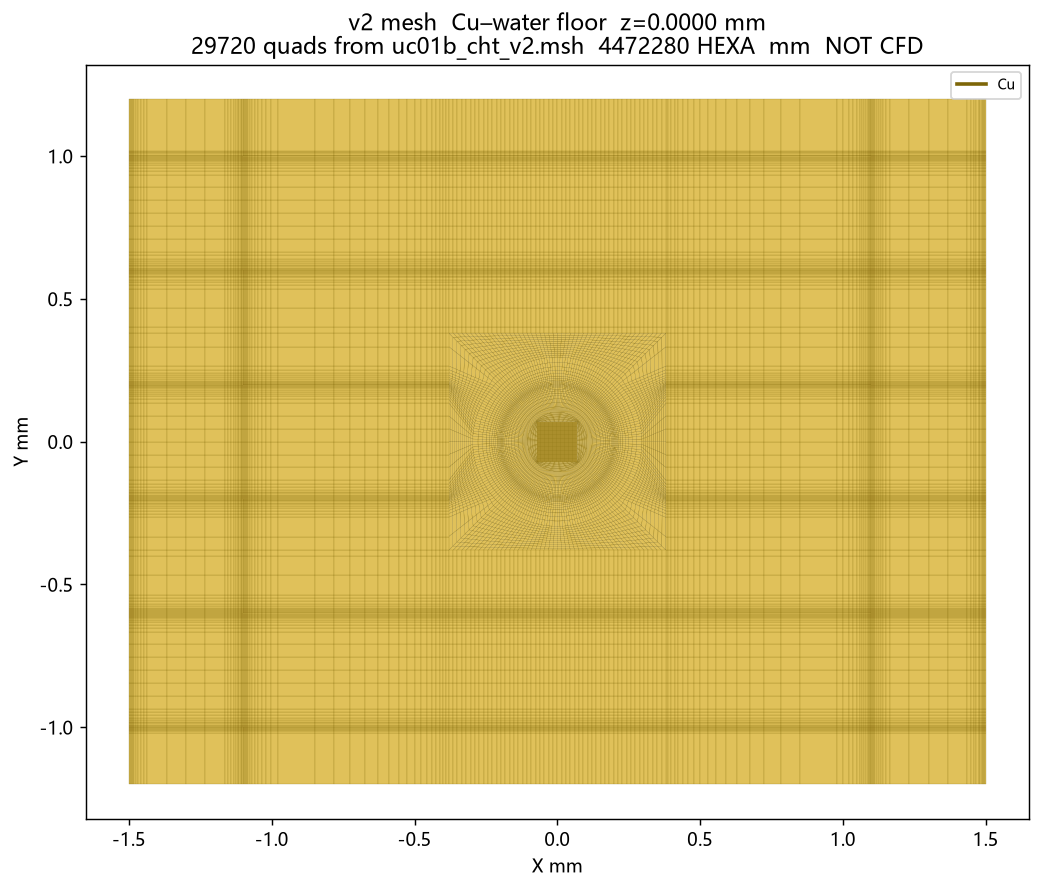
[picture p77: coolingplate/design/cfd/uc01b_2.4x3.0/figs/n216_mesh_z_floor.png]
mesh floor


图 6-2 网格。铜–水底面，z=0。

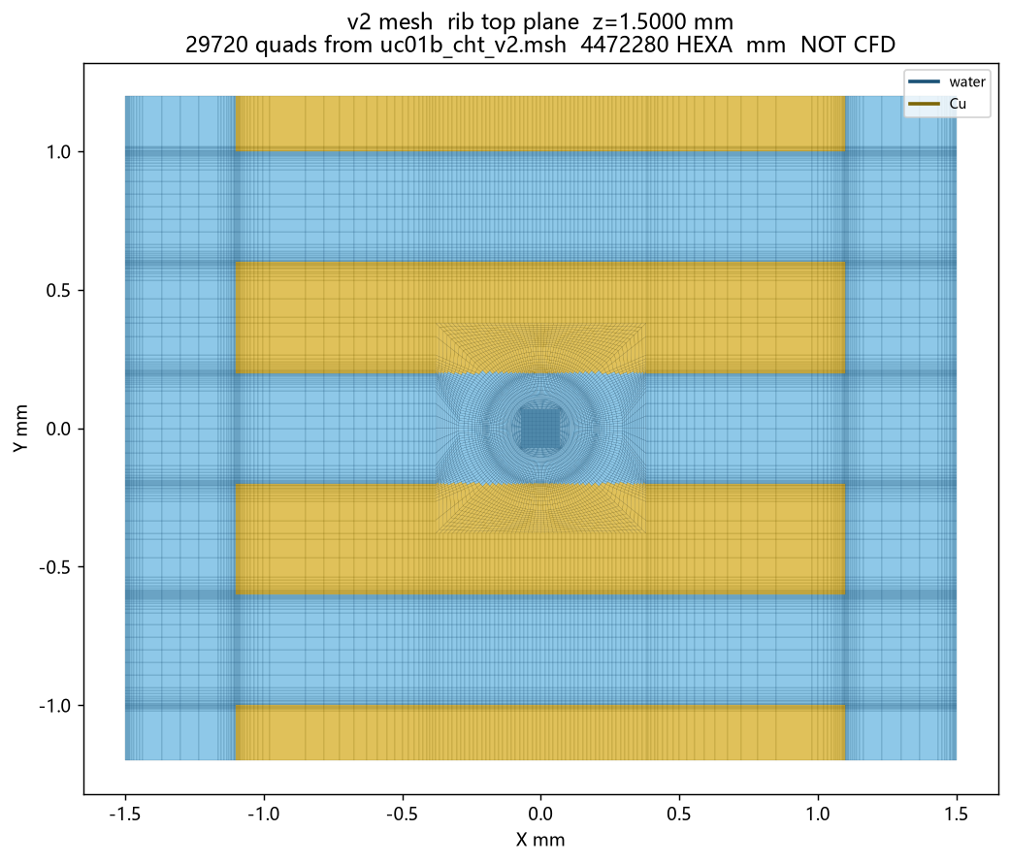
[picture p78: coolingplate/design/cfd/uc01b_2.4x3.0/figs/n216_mesh_z_rib.png]
mesh rib


图 6-3 网格。肋顶平面，z=1.500 mm。

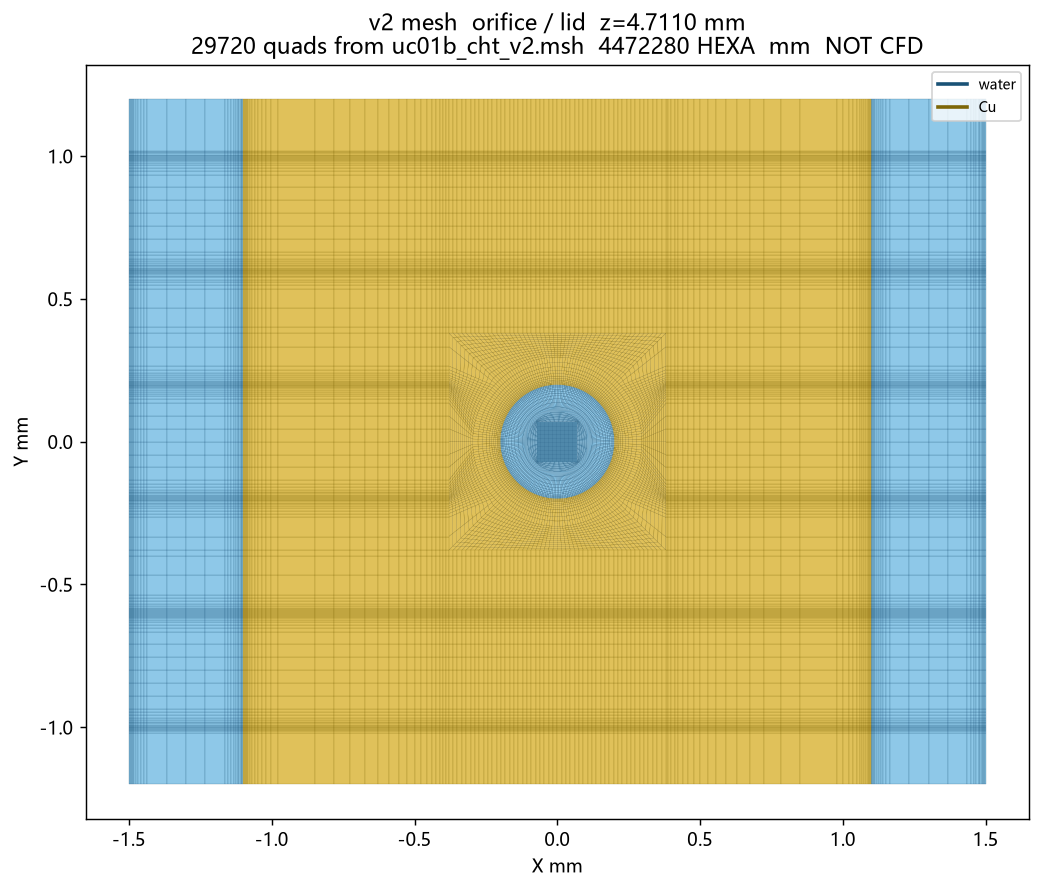
[picture p79: coolingplate/design/cfd/uc01b_2.4x3.0/figs/n216_mesh_z_orifice.png]
mesh orifice


图 6-4 网格。孔板，z=4.711 mm。喷孔是圆，周围有边界层加密。

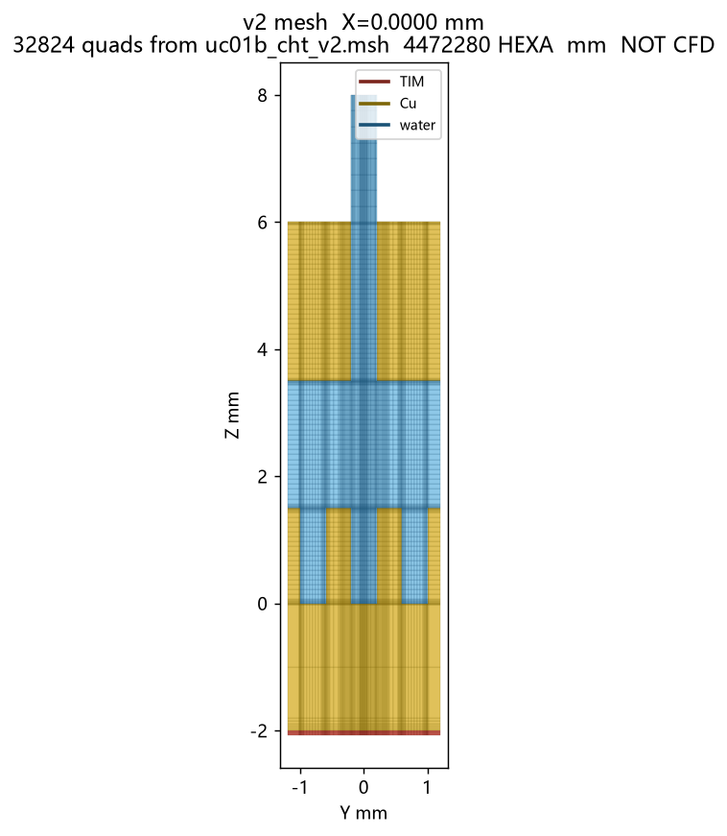
[picture p80: coolingplate/design/cfd/uc01b_2.4x3.0/figs/n216_mesh_x0.png]
mesh X0


图 6-5 网格。X=0 竖直切面。

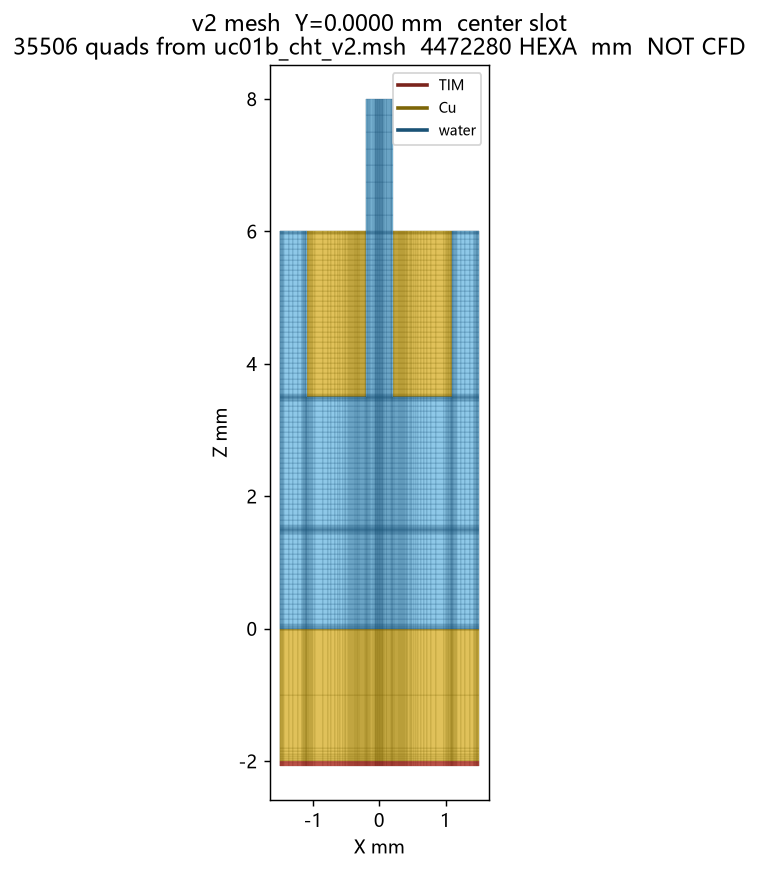
[picture p81: coolingplate/design/cfd/uc01b_2.4x3.0/figs/n216_mesh_y0.png]
mesh Y0


图 6-6 网格。Y=0 中槽竖直切面。

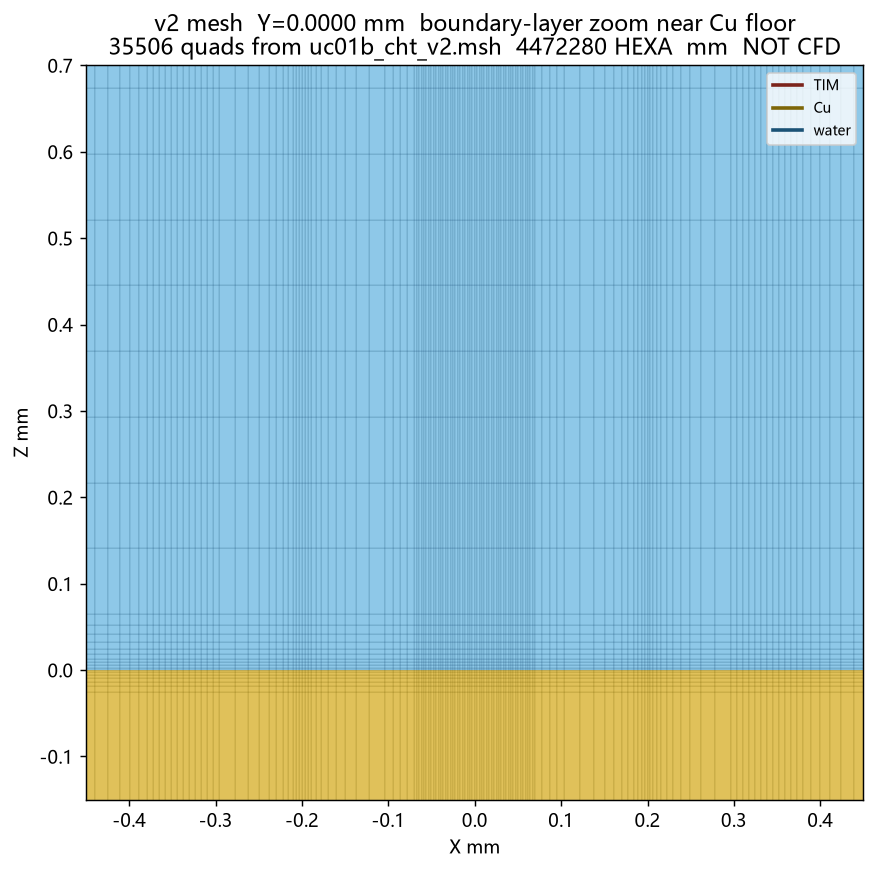
[picture p82: coolingplate/design/cfd/uc01b_2.4x3.0/figs/n216_mesh_y0_bl.png]
mesh boundary layer


图 6-7 网格。Y=0，放大铜–水底面附近。水侧在 z=0 以上有边界层加密，铜在 z=0 以下。

AIDC-B300-CFD-UC01b-RES-001 · 2026-09-25
只收录 iter 529，场 uc01b_cht_v2_n216_q105_sym。TIM 底 341.9268 K（68.78 °C）。X=0.556 mm 的 ±Y 温差中位 0.63 K，不称为对称。
