bruce2012lu/AIDCtms_design202609/coolingplate/design/cfd/uc01b_2.4x3.0/UC01b_共轭铜TIM网格方案_v1.0.html

AIDC-B300-CFD-UC01b-CHT-PLAN-001 · 详细方案 · 不是结果

# UC-01b 共轭铜 + TIM2 网格与计算方案 v1.0

单孔单元胞共轭传热（CHT）：水 + 铜底座/肋 + TIM2 各占一体区。 喷孔冻结 圆 D = 0.40 mm（不是 0.50，不是等面积方孔）。 TIM t = 80 μm，keff = 8.818 W/mK（RTIM2=0.006，两 die）。 下列图是几何示意 SVG，不是 Fluent 云图。

CHT-PLAN-001 2026-09-22 圆孔 D=0.40 t=80 μm / k_eff=8.818 ICEM+Fluent GUI 已开

胞3.0 × 2.4 mm

P_cell 名义3.9722 W

ṁ 单孔1.225×10⁻⁴ kg/s

medium HEXA425320

## 0. 冻结结论

数值只来自 calc/model.py 与已写出的网格计数。本页不写 Fluent 残差、ΔT、y⁺ 实测、GCI。那些只能进结果报告，且必须来自已开 GUI 的实跑。

项 | 冻结 | 出处 / 禁止项
单元胞 | Sx=3.0 mm（沿槽）× Sy=2.4 mm（跨槽） | UC-01b；S_jet=3.0；三槽刚好 3×0.80
喷孔 | 圆 D=0.40 mm | 不是 GEO 默认 0.50；不是方孔 0.3545
槽 / 肋 | ch_w=0.40，ch_h=1.50，pitch=0.80，肋厚 0.40 | GEO；Y 向 3 槽 + 2 满肋 + 2 半肋 = 2.40
间隙 / 盖 / 箱 | H_jet=2.0；t_lid=2.5（流体建孔，盖实体不建）；H_plenum=2.0 | GEO
回液 | 物理缝 0.80 mm 在 ±X，本胞各见半缝 0.40 | 与 X 邻胞共享；上抽
铜 | base_cu=2.0 mm + 肋（肋顶 z=1.50）；k=390 W/mK | K_CU / GEO['base_cu']
TIM2 | t=80 μm；k_eff=8.818 W/mK（R=0.006） | k=t/(R·A_2DIE)；A=1512 mm²
封装 | 实体不建；R_pkg=0.008–0.012 一维外叠 | model.py R_PKG
热流 | q''=56.746 W/cm² 在 TIM 底 | DP-A die 面平均；不是热点、不是 HBM
流量 | ṁ=2.067×10⁻⁴ kg/s | GPU 1.60 L/min / 128。2.0 L/min 是整板 DP-A，不是单孔
压降窗 | 冷板本体 20 kPa | 不含 UQD
工质 | DI 水 40 °C，Tref=313.15 K | WATER40：ρ=992.2，cp=4179，k=0.631，μ=6.53e-4

## 1. 几何（model.py 为权威）

坐标系：原点在中槽底面中心；+X 沿槽；+Y 跨槽；+Z 向上（射流 −Z 打到槽底 / 铜顶）。

### 1.1 平面装填

Y：3×0.40 槽 + 2×0.40 满肋 + 2×0.20 半肋 = 2.40 mm。侧槽中心距孔轴 0.80 mm = 2.0 D。

Y (mm) | 零件 | X (mm) | 零件
[−1.20, −1.00] | 半肋（SYM） | [−1.50, −1.10] | −X 半缝（上抽）
[−1.00, −0.60] | 侧槽 − | [−1.10, +1.10] | 三槽 + 间隙主体
[−0.60, −0.20] | 满肋 | [+1.10, +1.50] | +X 半缝
[−0.20, +0.20] | 中槽（对孔）
[+0.20, +1.20] | 满肋 / 侧槽+ / 半肋 | | 与上表对称

### 1.2 Z 堆叠（共轭）

Z (mm) | 体区 | 说明
−2.080 → −2.000 | solid_tim2 | 80 μm 全胞 XY；底面 = q''
−2.000 → 0 | solid_cu 底座 | 2.0 mm 余铜
0 → 1.50 | 槽/缝 = fluid；肋 = Cu | 肋顶 z=1.50
1.50 → 3.50 | fluid 间隙 | H=2.0，壁面射流贴肋顶
3.50 → 6.00 | 圆孔流体 + 回液缝 | 盖板实体不建；孔壁 = 圆柱 D=0.40
6.00 → 8.00 | 短静压箱 | 顶面 inlet_jet

流路不改口：下射 → 驻点（仅中槽底）→ 壁面射流沿 ±X 并扫入侧槽 → ±X 缝向上抽。 禁止 bank 长槽、禁止 1/4 对称。

## 2. 为什么必须共轭（不能再用 Cu 壳）

model.py 湿润面积增益：单 die 35 槽，A_fin=35×2×1.50×27 mm²，A_bot=35×0.40×27，A_wet/A_die = AREA_GAIN ≈ 4.25。热从 TIM 底进入后要在 2 mm 铜里横向扩展，再经肋导入三槽。Option A 把 q'' 打在流体底再加 2 mm 壳，铜内没有真实肋导热路径，也没有 TIM 厚向网格。

R_wall = t_base / (k_Cu · A_2DIE) = 0.002 / (390 × 1.512e-3) = 0.003392 °C/W R_c-in = R_TIM2 + R_wall + R_conv R_j-in = R_pkg + R_c-in R_TIM2 默认 0.006（链区间 0.004–0.008） R_pkg = 0.008–0.012

CHT 把 TIM 与铜建成实体：界面 wall_tim_cu、wall_cu_fluid 耦合。才能看到 spreading 和 AREA_GAIN，而不是壳上的一维 ΔT=q''·t/k。

## 3. 三维示意（SVG，不是 CFD）

图 3-1 等轴测示意。尺寸来自 model.py / UC-01b 冻结。不是网格云图，也不是 Fluent 场。

图 3-2 爆炸堆叠。热从 TIM 底进入，经铜扩展与肋，再交给水。封装层不建。

## 4. 三向二维剖面（材料 + BC + 网格意图）

下列剖面标材料分区、边界、以及打算怎么加密。不是算出的 T/|V|。独立 SVG：figs/scheme_iso.svg、scheme_explode.svg、scheme_yz.svg、scheme_xz.svg、scheme_zcuts.svg。

图 4-1 X=0。中槽对准圆孔。虚线：冲击底与孔壁打算做 Δy≤3 μm、增长≤1.2 的边界层。

图 4-2 Y=0。左右半缝上抽；中间圆孔下射。壁面射流沿 ±X。

图 4-3 Z 向三刀：圆孔平面、槽中、TIM/Cu。网格意图：孔用 O-grid，槽角与缝唇加密。

## 4b. 实网格截图（medium HEXA，不是云图）

下列 PNG 画的是 mesh/uc01b_cht_medium.msh 的单元边。源：同一套 write_cht_circle_msh.py（UC01B_MESH=medium）。体网格 425320 HEXA（fluid 321168 / Cu 88264 / TIM 15888）。msh 单位是米；图上坐标标成 mm 方便看。蓝=水，金=Cu，红=TIM。不是速度 / 温度 / 热流云图。没有 ICEM 导出 uc01b_cht_icem.msh。coarse 165112、fine 709664 同拓扑，本页只画 medium。

3D isometric mesh cutaway of UC-01b CHT HEXA

图 4b-1 三维等轴测：X=0 剖面上 18416 个 HEXA 面 + 5 层真实 XY 网格（17464 个 quad）。共 143520 条边。TIM 底（红）、Cu 座（金）、槽/间隙（蓝）、盖段只剩圆孔。0.50 mm 比例尺。不是 CFD 场。

X=0 mesh cut through the jet

图 4b-2 X=0（过射流 / YZ）。18416 个被切 HEXA 面。三槽 + 中间圆孔柱 + TIM 底条。0.40 mm 比例尺。

Y=0 mesh cut along the slot

图 4b-3 Y=0（沿槽 / XZ）。15352 个被切 HEXA 面。左右回液半缝上抽，中间圆孔下射。

Z cut at orifice plane

图 4b-4 Z 切盖段 zc=4.625 mm（层 k=106）。1576 个 quad：中心圆孔 O-grid + ±X 回液缝。盖实体未建，故中间空白。

Z cut at mid-gap

图 4b-5 Z 切间隙 zc=2.500 mm（层 k=78）。3972 个 quad，全是水。中心仍是圆孔 O-grid 投影。

Z cut at mid-slot

图 4b-6 Z 切槽中 zc=0.750 mm（层 k=34）。3972 个 quad。蓝=三槽+缝，金=肋/半肋。圆虚线是 r=0.20 参考，不是孔壁（此高度孔已结束）。

Z cut through TIM slab

图 4b-7 Z 切 TIM2 zc=−2.050 mm（层 k=1，TIM–Cu 界面邻层）。3972 个 quad，整面 TIM。XY 网格与上面各层共形。

Boundary layer and orifice lip mesh zooms

图 4b-8 加密局部。左：X=0 驻点，|Y|<0.22，1440 个切面单元；首层 Δz=2.5 μm（≤3 μm，y⁺<1 意图，未测）。右：孔唇 O-grid，zc=4.625 mm，736 个 quad，节点在 r=0.20 mm 上。50 μm / 80 μm 比例尺。

脚本：mesh/plot_cht_mesh_shots.py。计数见 figs/mesh_shot_info.txt。未启动 fluent.exe / icemcfd。

## 4c. 细化 fine 网格（含导流/回液槽壁面边界层）

已检查的体网格是 mesh/uc01b_cht_v2.msh（4472280 HEXA，圆孔 D=0.40 mm）。下面孔板切面来自该文件的真实单元面，不是方孔，也不是云图。中心小方块是 O-grid 内 H。

v2 circular orifice mesh

当前网格 z = 4.711 mm，uc01b_cht_v2.msh。喷孔边界为圆 D=0.40 mm。等面积方孔图已不用。

源：mesh/uc01b_cht_fine.msh（米），write_cht_circle_msh.py UC01B_MESH=fine。 4472280 HEXA（fluid 2760804 / Cu 1533156 / TIM 178320）。medium 425320 保留不覆盖。 圆孔 D=0.40 O-grid，孔壁径向首层 3.0 μm（800 条边实测 min=max=3.0）、≥10 层、增长≤1.2；孔周过渡到 r≈0.85 mm。 中槽 y∈[−0.20,0.20] 两侧壁 + 底/顶：首层 2.5 μm、n_BL=10、增长≤1.2（沿 ±X 贯穿单元胞，不只圆孔）。 侧槽与 ±X 回液缝同样 2.5 μm / 10 层。TIM 厚向 6 层；Cu 座 14 层；盖板 solid_cu。 射流核 Δx=2.8 μm。图是单元边，不是云图。无 Fluent y⁺。方孔 coupon（116320 HEXA）不是本节。

fine CHT isometric mesh

图 4c-1 fine 三维等轴测（X=0 抽层 + 3 个真实 Z 层）。4472280 HEXA。msh 米 / 图 mm。不是 CFD。

fine X=0 mesh

图 4c-2 X=0 网格边。三槽 + 圆孔柱 + 盖铜 + TIM。

fine Y=0 mesh

图 4c-3 Y=0 网格边。左右回液缝上抽，中间圆孔。

fine Z orifice

图 4c-4 Z 切盖段：圆孔 O-grid + 回液缝 + 盖铜（不再空白）。

fine Z slot

图 4c-5 Z 切槽中 zc=0.789 mm。三槽水 + Cu 肋。中槽 y=±0.20 沿 X 有壁面簇（笛卡尔段）；圆孔 O-grid 只占 |x|,|y|<0.38。侧槽不是中槽的替代。

orifice and impact BL

图 4c-6 孔壁 / 驻点。左：冲击底首层 2.5 μm、n_BL=10。右：圆孔壁径向首层 3.0 μm（800 条边实测），≥10 层，节点在 r=0.20。不是 y⁺ 实测。

TIM and Cu layers

图 4c-7 固体多层。TIM 6 层（80 μm）、Cu 座 14 层，偏 TIM–Cu 与 Cu–水。

return slit and drainage slot BL

图 4c-8 回液缝 + 侧槽（不是中槽）。左：Y=0 过 −X 回液唇 x=−1.10。右：X=0.80 过侧槽 y∈[0.60,1.00]。两侧首层 2.5 μm，n_BL=10，增长≤1.2。

center drainage slot wall BL

图 4c-9 中槽流体边界层（从 msh 的 Y/Z 节点量，不是口号）。左：Z 切 zc=0.789 mm，X∈[0.42,1.12]（笛卡尔段，躲开 O-grid），Y∈[−0.60,0.60]；红虚线 y=±0.20。右：X=0.80 的 YZ，两侧壁 + 底 z=0 + 顶 z=1.50。实测首层 2.5 μm，n_BL=10，增长≤1.2。50 μm 比例尺。

orifice and transition annulus

图 4c-10 喷孔 + 周边过渡。左：盖段 zc=4.75，实线 r=0.20、虚线 r=0.85。右：0.80 mm 窗口，孔壁径向簇（首层 3.0 μm）。

orifice vertical transition

图 4c-11 Y=0 过孔竖切：轴向孔柱 + 径向过渡（虚线 x=±0.20）。

CFD 状态：iter 7900 已收敛（continuity 4.0743e-07，日志 solution is converged）。场是 fluent/uc01b_cht_v2_i7900.cas.h5 / .dat.h5。圆孔 D=0.40。静压 ΔP = 2227.11 Pa = 2.227 kPa（表压，iter 7900，已收敛；见结果报告第 4 节）。方孔 0.048 与 iter 3861 / 1439 不是当前结果。云图见结果报告第 8 节。

## 4d. 网格规范与缺口

冻结规范（本档 fine，从 uc01b_cht_fine.msh 同源的 XY/Z 节点量；不是 Fluent y⁺）。旧 medium 盘上文件未重写：中槽 Y 向当时是 O-square 均匀段，中槽壁 FAIL（见图 4b-6）。

位置 | 规范 | fine 实测 | 结果
圆孔壁径向 | ≤3 μm，增长≤1.2，≥10 层 | 3.0 μm（800 边），环向≥10 | PASS
射流核 r<0.20 | 间距 10–20 μm 量级 | Δx=2.8 μm（更细） | PASS
孔周过渡 r=0.20→0.6–1.0 | 增长≤1.2，无 3 μm→0.1 mm 单跳 | 外环 + 笛卡尔到 T_ANN=0.85 mm | PASS
冲击底 / 中槽底 | ≤3 μm，≤1.2，≥8 层 | 2.5 μm，10 层 | PASS
中槽两侧壁 y=±0.20 | ≤3 μm，≤1.2，≥8 层，沿 X | 2.5 μm，10 层（笛卡尔 |x|>0.38） | PASS
中槽顶（肋顶 z=1.50） | ≤3 μm，≤1.2，≥8 层 | 2.5 μm，10 层 | PASS
侧槽壁 / 回液缝 | 同上 | 2.5 μm，10 层 | PASS
TIM 厚向 | ≥4 | 6 | PASS
Cu 座厚向 | ≥6 | 14 | PASS

O-grid 外框半边 S_FR=0.38 mm > 孔半径 0.20，圆与中槽同宽，O-grid 岛内 y=±0.20 不能再铺一套正交槽壁；槽壁边界层在笛卡尔段沿 X 贯通（图 4c-9）。无 y⁺ 数字。

## 5. TIM2、热流、流量（只重复已冻结公式）

A2DIE=27×28×2=1512 mm²。t=80 μm 固定。keff=t/(R·A)。

R_TIM2 | k_eff | 角色
0.004 | 13.228 W/mK | 乐观
0.006 | 8.818 W/mK | 默认 CHT
0.008 | 6.614 W/mK | 保守

k_eff 把键合线导热 + 接触/空洞捆在 80 μm 一层，用来收回报告热阻，不是牌号 k。q''=1100×0.39/(27×28 mm)=56.746 W/cm²，P_cell=4.0857 W。这是 die 面平均；热点 1.5–2.5×、HBM≈20.5 W/cm² 本胞不加。ṁ=ρ·(1.60 L/min)/128=2.067×10⁻⁴ kg/s。圆孔 V=ṁ/(ρA)≈1.66 m/s，Re_D≈1008（设计估计，用来定首层，不是 Fluent 打印）。

## 6. 网格意图与三档计划（无 GCI 数字）

圆孔必须 O-grid / 圆柱，节点在 r=0.20 mm 上。相对旧 116k 流体笛卡尔：先加密近壁与射流核，不三向同时 8×。增长硬顶 1.2。换热墙（冲击、肋、槽、孔）首层 Δy≤3 μm，设计目标 y⁺<1（Fluent 打印以前只是估计）。TIM ≥4 层；孔径向 ≥8–12。

档 | 文件 | HEXA | fluid / Cu / TIM | Δy / n_BL / 径向
coarse | uc01b_cht_coarse.msh | 165112 | 126112 / 32216 / 6784 | 3.0 μm / 10 / 8
medium | uc01b_cht_medium.msh | 425320 | 321168 / 88264 / 15888 | 2.5 μm / 12 / 10
fine | uc01b_cht_fine.msh | 4472280 | 2760804 / 1533156 / 178320 | 2.5 μm / 10 / 3.0 μm 孔壁

GCI / ΔP / T_w / R_conv 三档表：等 GUI 跑完再写。§10 门槛：相邻档 R_conv（两 die）变化 <3%。未跑完不填。

Python 圆孔 hex（米）已写出，给已开 Fluent 直接读。ICEM tetin（毫米）给已开 ICEM 做 O-grid / Fluent V6 导出；不要把 tin 和 msh 叠在同一视图。

## 7. 零件、材料、界面

Zone | 类型 | 材料 / BC
fluid | cell | water-liquid 40 °C（992.2 / 4179 / 0.631 / 6.53e-4）
solid_cu | cell | copper k=390
solid_tim2 | cell | tim2 k=8.818
inlet_jet | mass-flow-inlet | 2.067e-4 kg/s，T=313.15
return_slot | pressure-outlet | T=313.15 回流
wall_heat | wall | q''=567460.32 W/m²
wall_tim_cu | coupled wall | TIM–Cu
wall_cu_fluid | coupled wall | Cu–水（槽底/肋）
wall_orifice | wall | 圆柱 D=0.40
wall_lid / SYM | 绝热 / 对称 | 盖下；±X±Y

SST（主）；层流可作包络。Tref=313.15 K。20 kPa 是板内窗，不含 UQD。

## 8. 已开 ICEM / 已开 Fluent — 只 Replay / Read Journal

不要再启动 icemcfd.bat 或 fluent.exe。许可证已在两个 GUI 里。

短清单：GUI_STEPS.txt

ICEM（毫米 tin）
  File → Replay Scripts → Replay
  D:\agents2026\agents2026\agents\AIDCtms\coolingplate\design\cfd\uc01b_2.4x3.0\icem\replay_cht_circle.rpl
  等价 Tcl：icem\replay_cht_circle.tcl
  Fit (F9) → 应看到胞盒 + 圆 D=0.40 + TIM/Cu 点 + 槽/缝线
  （可选）Hexa O-grid 围圆，首层 ≤0.003 mm，增长 ≤1.2
  Output → Fluent V6（ICEM fluent6 写出器，勿再启 fluent.exe）
       → mesh\uc01b_cht_icem.msh
  详细：icem\OPEN_ICEM_THEN_FLUENT.txt

Fluent（米 msh）
  File → Read → Journal
  D:\agents2026\agents2026\agents\AIDCtms\coolingplate\design\cfd\uc01b_2.4x3.0\fluent\uc01b_cht_gui.jou
  默认读 mesh\uc01b_cht_medium.msh（圆孔 Python hex）
  若 ICEM 已导出 icem.msh，先改 journal 里的 read-case 再读
  Journal 不 /exit。80 步后写 fluent\uc01b_CHT

ICEM：...\v261\icemcfd\win64_amd\bin\icemcfd.bat（已开，勿再启）。Fluent：...\fluent\ntbin\win64\fluent.exe -r26.1.0（已开；journal 里不要写 -shortcut）。

AIDC-B300-CFD-UC01b-CHT-PLAN-001 · 2026-09-22
圆 D=0.40 · TIM 80 μm / 8.818 W/mK · 图 3–4 为 SVG 示意不是云图 · 无 GCI 数字 · 不 commit
