bruce2012lu/AIDCtms_design202609/coolingplate/design/cfd/uc01b_2.4x3.0lessmesh/NVIDIA_B300_微通道冲击换热冷板设计报告_v2.0_20260914.html

Cold Plate Detailed Design Report · B300 Blackwell Ultra

# NVIDIA B300 微通道 + 冲击换热 冷板设计报告

型号 CP-B300-JM-01。按 设计目标 → 芯片规格 → 设计输入 → 设计流程 → 性能设计 → 机械设计 → 原理图 → 详细设计（2D/3D/爆炸）→ 一维计算 → 三维仿真需求 组织。全文数值由 calc/ 下脚本生成， 工程图为按毫米真比例的矢量图。

文档 AIDC-B300-CP-HYB-002 版本 v2.0 2026-09-14 单相水基 · 紫铜冷板 水力达标 热性能待证（区间跨目标线） 非订单 ICD

保证点 DP-A1100 W @ 2.0 L/min

包络 DP-B1400 W @ 2.4 L/min

壳–进液热阻（实算区间） 0.0326 – 0.0366 °C/W

板内压降3.5 – 5.5 kPa（上限 20）

## 0. 摘要与结论

一句话：CP-B300-JM-01 的几何、工艺与接口方案是可行的，但热性能尚未被证明。用两套独立换热模型核算同一几何，壳–进液热阻落在 0.0326 – 0.0366 °C/W（DP-A）这个跨度近 2 倍的区间里：乐观端有余量，保守端越过 0.028 的目标线。因此本版把结论定为“方案通过、性能待证”，并给出明确的闭合路径（CFD → TTV → 孔径/TIM2 杠杆）。

1100 WDP-A 保证点 · Lenovo TGP

1400 WDP-B 包络 · NVIDIA 最大 TGP

0.033–0.037壳–进液热阻实算区间 °C/W

3.5–5.5板内压降 kPa（上限 20）

### 0.1 六条结论

1. 热源是非均匀的，冷板必须分区。B300 是双 reticle die + 8 组 12-Hi HBM3E。两颗 die 各约 429 W、面平均 56.7 W/cm²；单颗 HBM 约 24.8 W、20.5 W/cm²，低一个量级且怕冲蚀。结论：GPU 区用射流 + 短槽，HBM 区不设喷嘴、限近壁流速，中间用隔离肋做真正的水力隔墙。
2. 胞热流有名义值和 5% 边界冗余，流量不加这 5%。整板仍是 429+429+198+44 = 1100 W。两 die GPU 名义热 858 W 进 216 个胞，q''nominal = 55.170 W/cm²（551697.530864 W/m²）。施加边界取 1.05 倍：57.928 W/cm²（579282.407407 W/m²），对应胞功率 900.9 W，不是把板规格改成这个数。单孔流量仍是 1.224938e-04 kg/s（0.007407 L/min）。DP-B 名义 70.216 W/cm²，边界 73.727 W/cm²，单孔 1.469926e-04 kg/s。
3. 水力设计有大量余量，热设计没有。板内压降实算只有 3.5–5.5 kPa，离 20 kPa 上限很远；而热阻上界已经超标。这意味着正确的优化方向是“用压降换换热”，而不是继续压压降。
4. 孔径仍是压降杠杆，但 Martin 换热式不再使用。孔径 0.50 → 0.40 mm（孔数仍为 216），Re_D 从 478 升到 597，孔口压降从 0.35 kPa 升到 0.86 kPa。两侧 Re 都低于 2000，Martin 1977 不采用。
5. 射流雷诺数落在关联式有效域之外。设计点 Re_D ≈ 478（D=0.50 mm，216 孔），Martin 阵列关联式的下限是 2000。本报告不把 Martin 外推值当作设计热阻。壳–进液用短槽模型加 R_TIM2 区间。这是必须做三维共轭 CFD 的直接技术原因。
6. 短槽是肋，不是导管。按真实“就近抽走”拓扑，槽内流速只有 0.034 m/s（Re ≈ 33），压降 0.002 kPa 可忽略。它的作用是把湿润面积放大 4.25 倍（肋效率 0.948），而不是靠通道流速换热。v1.x 把它当 0.74 m/s 的导管算，隐含了与射流互相矛盾的流动拓扑。
7. PG25 不能沿用水的 Martin 百分比。ReD 低于 2000，Martin h 不采用。短槽模型对流热阻从 0.0252 变为 0.0318 °C/W（+26%）。若项目最终用 PG25，必须单独定流量，不能沿用水的 2.0 L/min。

### 0.2 放行判据（本版状态）

# | 判据 | 目标 | 本版状态 | 结论

1 | 壳–进液热阻 Rθ,c-in | DP-A < 0.028 °C/W | 0.0326 – 0.0366 | 不判定（区间跨目标线）
2 | 板内压降 @ 设计流量 | ≤ 18 kPa（上限 20） | 3.5 – 5.5 kPa | 通过（余量大）
3 | HBM 近壁流速 | ≤ 0.80 m/s | 0.463 m/s（DP-B 0.556） | 通过
4 | 流体温升 | 参考 < 10 K | 7.96 K（DP-B 8.44 K） | 通过
5 | 几何闭合（尺寸链） | X/Y/厚度自洽 | 5 项全部闭合 | 通过
6 | 承压与变形 | 3 bar 下应力 << 屈服 | 余铜跨槽弯曲应力约 0.02 MPa | 通过
7 | 可制造性 | 12–18 个月可交货 | 机加 + 真空钎焊，无增材出货件 | 通过
8 | 结温包络 | Tj ≤ 90 °C（常见口径） | 85 – 93 °C | 不判定（上界顶到包络）

本文件不是NVIDIA / Lenovo 订单 ICD，也不是 FAT 保证书。封装坐标、官方热图、单板额定流量三项未获得，第 5–9 章的几何与计算均为候选设计，用于评审与打样，不能直接写入采购合同。

## 1. 设计目标

设计目标分三层：项目目标（为什么做）、产品指标（做到什么程度）、验证判据（怎么算做到了）。每条指标都标注性质：门槛值不可谈判，目标值是设计瞄准点，拉伸值用于指导下一代。

### 1.1 项目目标

1. 为 NVIDIA B300（Blackwell Ultra）SXM 模块提供一款可在 12–18 个月内量产交付的单相液冷冷板，在 1100 W 保证点下满足结温包络，并对 1400 W 给出工程包络。
2. 以微通道 + 冲击射流分区杂交结构建立差异化技术资产，并与同目录专利分析报告的方案 A 权项结构对齐。
3. 工艺路线限定在机加工 + 真空钎焊，不把整板金属增材作为出货基线，以控制良率与交期风险。
4. 输出可被第三方复算的设计文档：所有数值有公式、有脚本、有来源。

### 1.2 产品指标（写入送样大纲）

类别 | 指标 | 门槛值 | 目标值 | 拉伸值 | 验证方法
热
热 | 壳–进液热阻 Rθ,c-in @ DP-A | ≤ 0.032 °C/W | < 0.028 °C/W | ≤ 0.024 °C/W | TTV 加热块 + 共轭 CFD
热 | 壳–进液热阻 @ DP-B（包络） | — | < 0.025 °C/W | ≤ 0.022 °C/W | 仅仿真包络，不作出厂保证
热 | 两 die 中心温差 | ≤ 8 K | ≤ 5 K | ≤ 3 K | TTV 双加热区 + 红外
热 | HBM 区最高壁温 | 低于 GPU 驻点壁温 | 同左 | — | 红外 / 热电偶
水力
水力 | 板内压降 @ 设计流量 | ≤ 20 kPa | ≤ 18 kPa | ≤ 12 kPa | 流阻曲线实测
水力 | 设计流量（水，40 °C） | — | 2.0 L/min | — | 候选值，待冻结（由托盘分流决定）
水力 | HBM 支路近壁流速 | ≤ 0.80 m/s | ≤ 0.60 m/s | — | CFD + 分区流量标定
水力 | 分区流量偏差 GPU : HBM | 80 : 20 ±15% | ±10% | ±5% | 分区流量计
机械与工艺
机械 | 接触面平面度 | ≤ 0.08 mm | ≤ 0.05 mm | ≤ 0.03 mm | 三坐标 / 平晶
机械 | 接触面粗糙度 Ra | ≤ 1.6 μm | ≤ 0.8 μm | ≤ 0.4 μm | 轮廓仪
机械 | 外形包络（不含快接） | — | 95×75×8.5 mm | — | 图纸 A0，待冻结
机械 | 整件质量 | ≤ 600 g | ≈ 440 g | — | 称重
工艺 | 耐压 / 密封 | 1.5× 工作压力保压 | 3 bar 保压 + 100% 氦检 | — | 氦质谱检漏
工艺 | 洁净度 / 过滤配套 | 系统 ≤ 50 μm | ≤ 孔径 1/10（50 μm） | — | 颗粒计数

### 1.3 热阻预算的来源：为什么是 0.028

目标值不是拍出来的，是从结温倒推的。取结温包络上限与进液温度之差作为全链可用温差，减去冷板拿不到的封装内热阻，剩下的才是冷板的预算：

Rθ,j-in(上限) = (Tj,max − Tin) / P ； Rθ,c-in(预算) = Rθ,j-in − RpkgRpkg = 硅扩散 + TIM1 + 封装盖，取 0.008–0.012 °C/W（NVIDIA 冻结，本设计不可改）

设计点 | P | Tin | Tj,max | 可用温差 | Rθ,j-in 上限 | 减 Rpkg 后预算 | 本报告取值
DP-A | 1100 W | 40 °C | 90 °C | 50 K | 0.0455 | 0.0335 – 0.0375 | < 0.028
DP-B | 1400 W | 40 °C | 90 °C | 50 K | 0.0357 | 0.0237 – 0.0277 | < 0.025
DP-A（最恶进液 45 °C） | 1100 W | 45 °C | 90 °C | 45 K | 0.0409 | 0.0289 – 0.0329 | 需复核

注意 DP-B 的数学事实：1400 W 下全链上限只有 0.0357 °C/W，扣掉封装内阻后冷板预算仅 0.0237–0.0277 °C/W。目标 0.025 已经落在这个区间的上沿，说明 1400 W + 独立冷板 + TIM2 的组合在物理上就很紧，这也是业界走向盖板一体化（MLCP，取消 TIM2）的原因。本设计因此只把 1100 W 作为保证点。

### 1.4 不在范围内

图 1-1 系统层级与设计边界。本报告只设计最右一格。

## 2. GB300 / B300 芯片规格数据

冷板要对的不是“一块 1100 W 的铜盖”，而是两颗 reticle 级计算 die + 八组 HBM3E 堆叠。本章把能查到的官方数据和必须假设的数据严格分开：高 为 NVIDIA / Lenovo 官方公开原文，中 为公开资料或合理工程估算，低 / 待冻结 为本设计假设，不得写入合同。

### 2.1 B300（Blackwell Ultra）芯片级规格

项目 | 官方值 | 对冷板设计的含义 | 置信度
硅与封装
架构 / 工艺 | Blackwell Ultra；TSMC 4NP | 与 B200 同代硅，功率与 HBM 容量加码 | 高
晶体管数 | 2080 亿（208B） | 双 reticle 才能放下 | 高
计算裸片 | 2 颗 reticle 级 die，NV-HBI 10 TB/s 互联，对 CUDA 仍是一颗 GPU | 两个主热点，各需一套独立射流阵列；中间 die-to-die 缝不应正对密集射流 | 高
SM / GPC | 最多 160 SM、8 GPC（SKU 可少） | 热图随 SM 开启数变化，喷嘴密度应随 power map 单调增加 | 高
Tensor Core | 640 个第五代；TMEM 256 KB/SM | 决定瞬态功率斜率，影响热惯量与失冷窗口 | 高
存储
HBM 容量 | 288 GB HBM3E（数据手册另有 279 GB 口径） | 容量口径差不影响冷板几何；但 HBM 必须被冷板完整盖住 | 高
HBM 带宽 | 8 TB/s（Lenovo 该页写 7.7 TB/s） | 带宽越高 HBM 自身功耗越高，次热点不可忽略 | 高
HBM 配置 | 8 组 12-Hi 堆叠；16 × 512-bit 控制器（合计 8192-bit） | 八个次热点，决定冷板 HBM 区布置；见 §2.3 口径辨析 | 高
互联与形态
NVLink | 第五代，1.8 TB/s 双向（18 链 × 100 GB/s） | 桥与 I/O 在封装边缘，冷板开孔与压装须避开 | 高
NVLink-C2C | 900 GB/s（对 Grace CPU 一致性互联） | 决定超级芯片拓扑，不直接影响单板冷板 | 高
主机接口 | PCIe Gen6 ×16 | 同上 | 高
形态 | SXM 模块，数据中心液冷；无消费级 PCIe 卡 | 必须 D2C 冷板，风冷不在范围 | 高
功率
最大 TGP | configurable up to 1400 W | 本设计 DP-B 包络 | 高
整机 SKU TGP | 1100 W（Lenovo SXM DLC） | 本设计 DP-A 保证点 | 高

### 2.2 GB300 NVL72 机柜级规格（约束来源）

项目 | 官方值 | 对冷板的含义 | 置信度
配置 | 72× Blackwell Ultra GPU + 36× Grace CPU，全液冷机柜 | 18 个计算托盘，每托盘 4× B300 → 本冷板 72 块/柜 | 高
超级芯片 | 1× Grace + 2× B300，NVLink-C2C；1 TB 统一内存（HBM3E + LPDDR5X） | Grace 用独立冷板，不与 B300 共一块铜 | 高
CPU 核 | 2592 个 Arm Neoverse V2 | 不在本供货 | 高
GPU 内存 / 带宽 | 20 TB / 最高 576 TB/s（整柜） | — | 高
快速内存 | 37 TB（整柜） | — | 高
NVLink 带宽 | 130 TB/s（整柜聚合） | — | 高
算力 | FP4 1440 PFLOPS（稀疏）/ 1080 PFLOPS（稠密）；1.44 exaFLOPS | 算力密度是液冷的根本驱动，不直接进冷板计算 | 高
机柜热负荷 | 135 kW TDP / 155 kW EDP | 约 90% 由液冷带走 → 单板热负荷来源 | 中
机柜水力表 | 进液 25–45 °C ↔ 59–177 L/min；系统压降 16–127 kPa | 整柜口径，不是单板保证值 | 中
网络 | ConnectX-8 SuperNIC 800 Gb/s | 不在本供货 | 高

### 2.3 口径辨析：HBM 堆叠是 8 组还是 12 组

NVIDIA 技术博客正文写“Eight 12-Hi stacks”，但该文末尾的更正声明写“corrected … to show the proper 12 HBM stacks instead of 8”。两处字面冲突，而这个数直接决定冷板 HBM 区的布置，必须用电气与容量两条独立线索交叉校核：

校核线索 | 若为 8 组 12-Hi | 若为 12 组 | 判据
总接口宽度 | HBM3E 每堆 1024-bit × 8 = 8192-bit，与官方“16×512-bit 控制器（8192-bit total）”完全吻合 | 12 × 1024 = 12288-bit，与官方 8192-bit 矛盾 | 支持 8 组
容量闭合 | 8 × 36 GB（12-Hi × 3 GB）= 288 GB，闭合 | 12 × 24 GB（12-Hi × 2 GB）= 288 GB，也能闭合 | 两者皆可，不能判别
同代对比 | B200 为 8 组 HBM3E，B300 沿用封装骨架、换 12-Hi 堆叠 | 需要重新设计基板与控制器数量 | 支持 8 组

本设计判定：按 8 组 12-Hi 布置。更正声明最可能的原意是“12-Hi（12 层高）而非 8-Hi”，被写成了“12 stacks instead of 8”。电气宽度 8192-bit 是硬证据，它只能对应 8 组 HBM3E。但这是一个带风险的判定：已登记为开放项 C-02，若 OEM 封装图确认为 12 组，则 §8 的 HBM 区坐标、隔离肋长度与 HBM 支路通道数必须重画（GPU 射流区不受影响）。

### 2.4 功率两档与热包络

参数 | DP-A（保证点） | DP-B（包络） | 来源
芯片功率 P | 1100 W | 1400 W | Lenovo SXM DLC TGP / NVIDIA 最大 TGP
设计进液温度 | 40 °C（计算基准） | 25–45 °C（OEM 表） | GB300 机柜表
设计流量（水） | 2.0 L/min | 2.4 L/min | 本设计候选，待冻结
结温包络 Tj | 83–90 °C | 同左 | 厂商常见口径，中
热阻目标 | < 0.028 °C/W | < 0.025 °C/W | §1.3 倒推

两档不得相加，也不得混成一个数。1400 W 是可配置上限，不是本冷板的出厂保证点；把 1400 写成保证值会在 FAT 时无法交付。同样，禁止把 ASHRAE W45 的 45 °C 直接当成机柜进液保证，也禁止用厂商宣传的“单 GPU 2400 W”当基线。

### 2.5 热源分区（设计假设，须官方热图冻结）

NVIDIA 未公开 B300 封装外形与 die 坐标。以下取值按同代双 die 量级设定，全部标 低 / 待冻结。功率拆分比例是本设计的假设，不是官方 power map。

对象 | 几何假设 | DP-A 功率 | DP-B 功率 | 热流密度（DP-A） | 设计含义
单计算 die | 27 × 28 mm （7.56 cm²） | 429 W（39%） | 546 W | 面均 56.7 W/cm² 热点估 142 W/cm² | 射流阵列主目标
NV-HBI 缝 | 3 mm 宽 | 低 | 低 | 低 | 不对缝打密集射流
单颗 HBM 堆 | 11 × 11 mm （1.21 cm²） | 24.8 W（合计 18%） | 31.5 W | 面均 20.5 W/cm² | 只需盖住 + 均温，禁射流
I/O 与其它 | 封装边缘 | 44 W（4%） | 56 W | 低 | 靠铜扩热
冷板作用面积 | 95 × 75 mm （71.2 cm²） | — | — | 板均 15.4 W/cm² | 用 footprint 平均会严重低估 die

图 2-1 能量分流校核：429+429+198+44 = 1100 W。这是功率去向，不是流量去向。

不要用 500–600 W/cm² 当整板平均。那类数字是按 1.5–2 cm² 活性核反推的热点上限。本设计按 die 面平均（56.7 W/cm²）加 2.5 倍热点系数（142 W/cm²）校核射流区，并在 CFD 中用真实热图替换该系数。

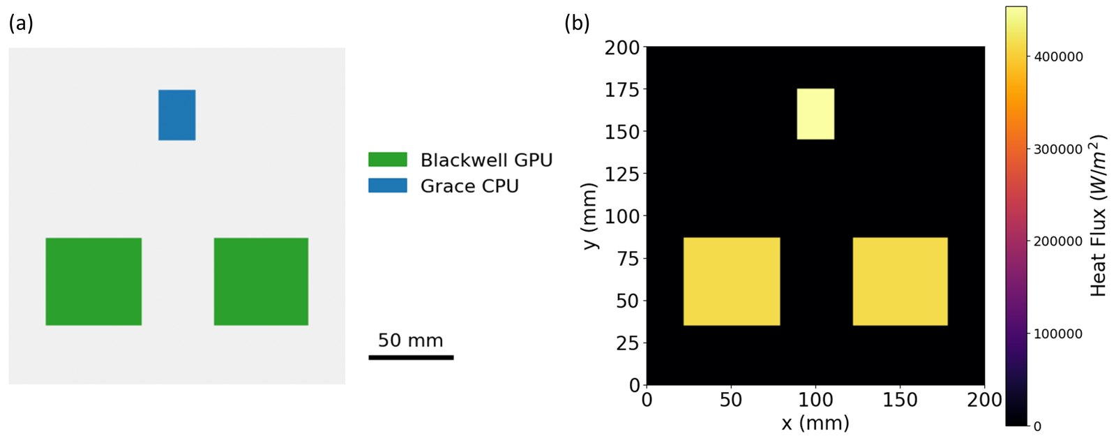
[picture p83: coolingplate/design/assets/src/gb200_fig1_layout_heatflux.jpg]
多芯片非均匀热图（GB200 模组，作类比）


图 2-2 多芯片非均匀热图（GB200 模组，作类比）2×GPU + CPU 的 footprint 平均只有 35–40 W/cm²，而 die 面平均高得多。B300 单封装没有 Grace，但仍是双 die + HBM 的强非均匀热源，不能用一条等宽长槽通铺。来源：arXiv:2604.10941, Fig. 1。

## 3. 设计输入

设计输入是可追溯的外部约束，与设计输出严格区分。每条输入标明来源、状态和一旦变化会影响哪一章 —— 这样输入变更时可以定位返工范围，而不是全文重做。

### 3.1 输入追溯矩阵

编号 | 输入项 | 取值 / 内容 | 来源 | 状态 | 影响章节
热输入
IN-T1 | 保证点功率 | 1100 W | Lenovo Press LP2357（B300 SXM DLC TGP） | 已冻结 | 全篇
IN-T2 | 包络功率 | 1400 W | NVIDIA Blackwell Ultra 博客 / 数据手册 | 已冻结 | §5, §9, §10
IN-T3 | 结温包络 | 83–90 °C | 厂商常见口径 | 待确认 | §1.3, §9.7
IN-T4 | 官方 power map（两 die + HBM 分布） | 未获得 | NVIDIA / OEM | 缺失 | §2.5, §5.2, §10.6
IN-T5 | 封装内热阻 Rpkg | 0.008–0.012 °C/W | 工程估算 | 估算 | §1.3, §9.7
IN-T6 | TIM2 面积热阻 | 0.1–0.2 °C·cm²/W | OCP / Meta 公开资料 | 估算 | §9.7
水力输入
IN-H1 | 机柜进液温度窗 | 25–45 °C | GB300 机柜表 / Lenovo Table 27 | 已冻结 | §9, §10.7
IN-H2 | 整柜流量 | 59–177 L/min（随温度） | 同上 | 已冻结 | §7.1
IN-H3 | 整柜系统压降 | 16–127 kPa | 同上 | 已冻结 | §7.1
IN-H4 | 单板额定流量与压降窗 | 未获得（本设计取 2.0 L/min） | 托盘分流计算 + 订单 ICD | 缺失 | §5.5, §9
IN-H5 | 工质 | DI 水（基线）/ PG25（校核） | 与 GB300 总体设计一致 | 待商务确认 | §9.9
IN-H6 | 系统过滤等级 | 投运 ≤ 25 μm | 系统侧要求 | 待确认 | §6.7, §12
机械与接口输入
IN-M1 | 封装外形、螺钉位、TIM 窗、die/HBM 坐标 | 未获得 | OEM 封装图 / SXM ICD | 缺失 | §6, §8
IN-M2 | 压装力与加载方式 | 未获得（估 300–500 N） | 订单 ICD | 缺失 | §6.4
IN-M3 | UQD 型号与水嘴方向 | 跟托盘，不自创口径 | 订单 ICD | 缺失 | §6.6, §7.1
IN-M4 | 托盘空间包络与相邻件 | 未获得 | OEM | 缺失 | §8.2
IN-M5 | 四板并联拓扑 | 并联，禁止串联 | GB300 总体设计 | 已冻结 | §7.1
上游文件继承
IN-R1 | 《GB300 NVL72 冷却系统总体设计报告 v2.2》 | 整柜 135/155 kW、约 90/10 液风分担、机柜水力表 | 本仓库 | 已冻结 | §2.2, §7.1
IN-R2 | 《AI 算力芯片液冷冷板专利分析报告 v1.4》 | 方案 A 权项结构（GPU 射流 / HBM 禁射流 / 隔离肋 / 压降窗）、工艺三分流 | 同目录 | 已冻结 | §5.1, §6.1
IN-R3 | 《AI 算力芯片液冷冷板技术调查分析报告 v1.3》 | 射流三区、H/D 与 S/D 窗、微通道强化综述 | 同目录 | 已冻结 | §5.4, §9.4

### 3.2 工质物性（计算基准）

工质 | 温度 | ρ / kg·m⁻³ | cp / J·kg⁻¹K⁻¹ | μ / Pa·s | k / W·m⁻¹K⁻¹ | Pr | 用途
DI DI | 40 °C | 992.2 | 4179 | 6.530e-04 | 0.631 | 4.32 | 设计基准
PG25（25% 丙二醇） | 40 °C | 1022.0 | 3900 | 1.150e-03 | 0.452 | 9.92 | 校核，见 §9.9

PG25 的 Pr 是水的 2.3 倍，导热率只有水的 72%，动力粘度是水的 1.76 倍。这三项共同决定了 §9.9 中约 29% 的换热损失 —— 不是经验拍的 15%。

### 3.3 假设登记册

以下每条都是设计假设，不是事实。登记的意义是：评审时逐条质询，输入到位后逐条替换。

编号 | 假设 | 取值 | 若假设错误的后果 | 替换条件
AS-1 | 两 die 合计占 78% 功率 | 各 39% | 射流阵列功率密度设计偏差；两 die 温差判据失效 | 官方 power map
AS-2 | HBM 合计占 18% | 单颗 24.8 W | HBM 支路 20% 流量分配可能不足或浪费 | 官方 power map
AS-3 | HBM 为 8 组 | 左右各 4 颗 | HBM 区坐标与隔离肋须重画（见 §2.3） | OEM 封装图
AS-4 | die 尺寸 27×28 mm | 7.56 cm²/颗 | 热流密度与射流阵面尺寸偏差 | OEM 封装图
AS-5 | 热点系数 2.5× | 142 W/cm² | 局部壁温预测偏低，驻点设计不足 | 官方热图 / CFD
AS-6 | TIM2 面积热阻 0.1–0.2 °C·cm²/W | 0.004–0.008 °C/W | 直接决定 §9.11 差距闭合可行性 | TIM2 选型 + 实测
AS-7 | 静压箱/隔墙压降 3–5 kPa | 占板内压降主项 | 压降预算失真（但余量大，风险低） | CFD
AS-8 | 槽内流动拓扑为“就近抽走” | Lf = 3.0 mm | 换热与压降模型选择错误（v1.x 的问题所在） | CFD 流线

## 4. 设计流程

流程的作用是把“算得对”和“做得出”分开评审，并规定什么条件下必须回头改几何。本报告 v2.0 完成到 ⑥（机械与图纸），⑤（三维仿真）只给需求规格，工具未选定；⑦（样件试验）未开始。

图 4-1 门控设计流程与两条强制迭代回路。

### 4.1 阶段门与交付物

门 | 名称 | 放行条件 | 交付物 | 本版状态
DR0 | 输入冻结 | IN-* 矩阵中“缺失”项全部有责任人与计划日期 | 输入追溯矩阵（§3.1）、假设登记册（§3.3） | 已完成（含 6 项缺失，已登记）
DR1 | 方案选定 | 权衡矩阵有量化权重；FTO 初筛无红灯 | 方案决策矩阵（§5.1）、分区策略（§5.2） | 已完成
DR2 | 性能基线 | 热阻预算闭合；一维计算可复算；敏感性给出杠杆 | 热阻预算（§5.3）、一维计算书（§9）、脚本 calc/ | 有条件通过（区间跨目标线）
DR3 | 仿真与图纸 | CFD 网格无关性达标；R 与 ΔP 落在目标内；图纸尺寸链闭合 | CFD 报告、2D/3D/爆炸图（§8） | 未完成（仿真未做）
DR4 | 送样放行 | 首件 TTV 热阻达标；氦检通过；流阻曲线符合 | FAT 报告、出厂三曲线 | 未开始

### 4.2 两条强制迭代回路

回路 | 触发条件 | 回到哪一步 | 可调杠杆（按优先级）
R1 仿真回路 | CFD 得到的 Rθ,c-in 超目标，或 ΔP 超 20 kPa，或分区流量偏差 > ±10% | 回 §5 性能设计 / §9 一维计算 | ① 孔径 0.50→0.40/0.35 mm（见 §9.10）② TIM2 升级到 ≤0.004 °C/W③ 流量 2.0→2.2/2.4 L/min④ 阵列加密到 10×10（须重算压降）⑤ 槽深 1.5→1.0 mm（减死体积，须重画厚度链）
R2 验证回路 | TTV 实测与 CFD 偏差 > 15% | 回 §5，并修正 §9 的关联式选择与经验系数 | ① 用实测反标定 h 模型② 复核 TIM2 装配压力与厚度③ 复核喷嘴孔一致性与堵塞

### 4.3 变更控制

- 几何冻结原则：§8 的锁定坐标表是全文唯一几何来源。任何图、任何计算与该表冲突，以该表为准；修改该表必须升版本号。
- 数值单一来源：本报告所有数值由 calc/model.py 计算，calc/cp_b300_1d.py 输出计算书，calc/build_report.py 生成本文件。不存在手抄数字，改参数即全文同步。
- 输入变更影响分析：按 §3.1 的“影响章节”列定位返工范围。

## 5. 性能设计

性能设计回答三个问题：选什么结构、热阻预算怎么分、射流与流量参数取在哪个窗口。详细的公式与逐步数值在 §9，本章只给设计决策与理由。

### 5.1 方案选型：为什么是分区杂交

评价维度 | 权重 | 纯铲齿微通道 | 纯射流平板 | 整板增材拓扑 | 分区杂交（本方案）
双 die 热点能力 | 25% | 3（沿程出口侧先超温） | 5（驻点 h 极高） | 4 | 5（每 die 独立阵列）
HBM 安全（冲蚀 / 偏载） | 20% | 3（流速易偏高） | 1（高速射流伤堆叠） | 3 | 5（无喷嘴 + 流速帽 + 隔离肋）
压降 | 15% | 2（长槽高） | 3（孔板集中） | 4 | 4（短槽 + 中等孔速）
可制造性 / 交期 | 20% | 5（成熟） | 3（三层对位） | 1（残粉、导热折损） | 4（机加 + 钎焊，12–18 个月）
可靠性 / 防堵 | 10% | 5 | 2（孔易堵） | 2 | 3（0.50 mm 孔 + 过滤）
专利可占位 | 10% | 1（直槽空间窄） | 2（阵列已密） | 3 | 5（HBM 禁射流 + 流速帽 + 隔离肋 + 压降窗）
加权得分 | 100% | 3.20 | 2.95 | 2.85 | 4.50

选型结论与同目录专利分析报告 v1.4 的方案 A 一致：GPU 区射流 + 短微通道，HBM 区仅低速微通道，中间隔离肋。规避要点：不能只写“分区用射流和微通道”（已被华为 WO2026103052A1 覆盖），必须把 HBM 无喷嘴、近壁流速上限、隔离肋的流动/力学双重功能、额定流量下压降窗 写成必要技术特征。

### 5.2 分区策略

| GPU 射流区（第一区） | HBM 微通道区（第二区） | 隔离肋
对应热源 | 2 颗计算 die | 8 组 12-Hi HBM3E | 两区之间
热流密度（DP-A） | die 面均 56.746；胞名义 55.170；边界 57.928 W/cm²（×1.05） | 面均 20.5 W/cm² | 5% 只在 GPU 胞边界，不改 1100 W
喷嘴 | 有，216 个 ⌀0.50 mm | 无（权项必要特征） | —
通道 | 0.40 × 1.50 mm，节距 0.80，35 条/die | 0.60 × 1.50 mm，16 条 | 实心铜，宽 2.0 mm
水力直径 | 0.632 mm | 0.857 mm（更大，用于降速） | —
流量分配（DP-A） | 1.60 L/min（80%） | 0.40 L/min（20%） | 0
特征速度 | 孔速 0.629 m/s | 近壁 0.463 m/s（帽 0.80） | —
设计意图 | 把热点边界层打断，就地抽走废液，抑制交叉流 | 盖住、均温、低剪切、不冲蚀焊球与堆叠 | 切断串流；压装时把载荷传到边框，减轻 HBM 偏载

为什么 80/20 而不是按面积或按功率平分：HBM 只占 18% 功率且热流低一个量级，多送水只会抬压降与冲蚀风险，对结温没有帮助；GPU 需要高 h，必须把大部分质量流量送到驻点。分配靠盖板开孔面积与隔墙实现，不用外置调节阀，样件用分区流量计标定。

### 5.3 热阻预算分配

图 5-1 结–进液热阻网络。冷板只拥有 TIM2 以下三段。

环节 | DP-A 分配 / °C/W | 占比（保守端） | 可控性 | 说明
硅扩散 + TIM1 + 封装盖 | 0.008–0.012 | —（在壳温之上） | 不可控 | NVIDIA 封装决定；只有 MLCP 才能动
TIM2 | 0.004–0.008 | 22% | 选型可控 | 面积热阻 0.1–0.2 °C·cm²/W ÷ 有效面积；保守端占掉近 1/4 预算
铜壁导热（余铜 2.0 mm） | 0.0034 | 9% | 几何可控 | 一维导热，按两 die 投影面积
对流（射流 + 短槽） | 0.0252 | 69% | 主攻 | Martin 因 Re<2000 不采用；只保留短槽模型，216 胞并联
合计 壳–进液 | 0.0326–0.0366 | 100% | — | 目标 < 0.028

图 5-2 四种组合下的热阻堆叠与目标线。虚线为目标，保守模型两档均越线。

### 5.4 射流参数设计窗

参数 | 符号 | 本设计取值 | 文献 / 关联式窗 | 是否在窗内 | 理由
孔径 | D | 0.50 mm | 0.3–1.0 mm（可微钻） | 是 | 可微钻、堵塞风险可接受、过滤要求合理
无量纲喷距 | H/D | 4.0 | 2–6 | 是 | 过近势核未展开，过远到达速度衰减
无量纲孔距 | Sx/D · Sy/D | 6.0 · 4.8 | 4–8 | 是 | 过密射流互扰，过疏覆盖不足
相对喷嘴面积 | f | 0.02727 | 0.004–0.04（Martin） | 是 | 落在关联式有效域
孔雷诺数 | ReD | 478 | ≥ 2000（Martin 有效域） | 否，外推 | 本设计最大不确定来源，见 §9.4
槽内流程 | Lf | 3.0 mm（上限 8） | 越短越抑交叉流 | 是 | 把“一条河”拆成 216 个小循环

图 5-3 冲击射流三区与本设计的无量纲取值窗。ReD 落在窗外，必须由 CFD 校正。

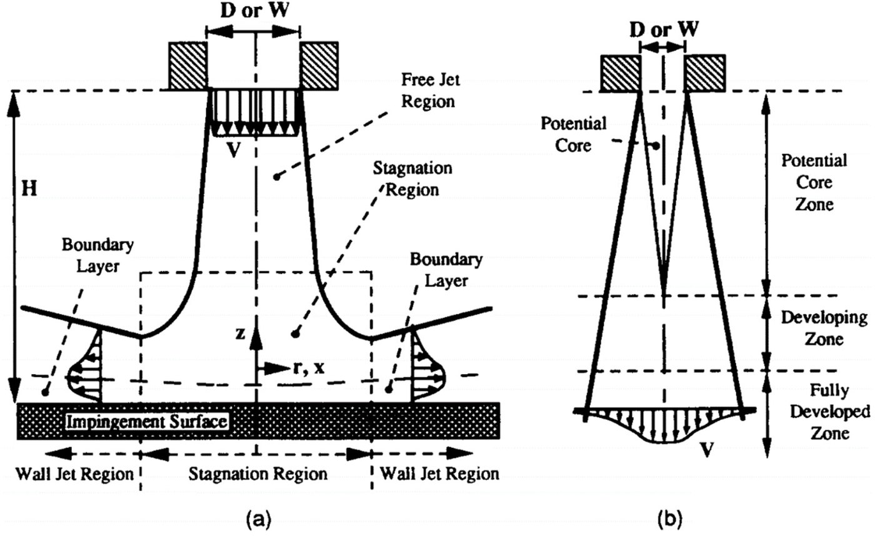
[picture p84: coolingplate/design/assets/src/hussain_fig1_jet_regions.jpg]
论文原图 · 射流三区


图 5-4 论文原图 · 射流三区自由射流、驻点、壁面射流。本设计 H/D=4 落在驻点核完整、交叉流尚未主导的窗口。来源：Hussain et al., Energies 2021, Fig. 1。

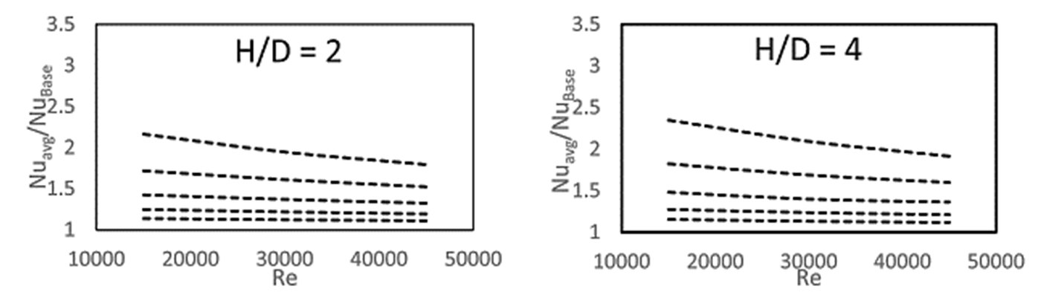
[picture p85: coolingplate/design/assets/src/hussain_fig7_HD.jpg]
论文原图 · H/D 对换热的影响


图 5-5 论文原图 · H/D 对换热的影响过近则势核未展开，过远则到达速度衰减。本设计取 4，不取 2 或 8。来源：Hussain et al., Energies 2021, Fig. 7。

为什么短槽必须短：若改成贯穿 28 mm 的长槽，下游孔看到的是上游废液，交叉流把驻点核推离 die 中心，两 die 温差与单 die 内部温差会一起坏。短槽把每条流程截在 8 mm 以内，等于把一条河拆成 216 个独立小循环。

### 5.5 流量与压降预算

项 | DP-A | DP-B | 说明
总流量（水） | 2.0 L/min | 2.4 L/min | 候选值，待冻结；比流量 1.82 L/min·kW⁻¹
GPU 支路 | 1.60 L/min | 1.92 L/min | 80% 是流量份额，由 216 孔总面积 42.41 mm² 限流
HBM 支路 | 0.40 L/min | 0.48 L/min | 20%，独立进液缝 + 宽槽
流体温升 | 7.96 K | 8.44 K | 0 维能量平衡，不可反推流量
板内压降（实算） | 3.5–5.5 kPa | 3.7–5.7 kPa | 目标 ≤18，上限 20
一对 UQD（参考） | 4–8 kPa | 同左 | 是否计入 20 kPa 窗须在 ICD 声明

流量不是用 10 K 反推出来的。1.0–1.5 L/min·kW⁻¹ 只是行业初筛区间。本设计取 2.0 L/min（约 1.82 L/min·kW⁻¹），理由是：① 要维持 216 个孔的孔速与驻点换热；② 给 PG25 与脏污留裕量。机柜侧仍服从整柜表，单板流量由托盘孔板决定，SAT 必须实测。

## 6. 机械设计

机械设计要同时满足四件事：导热（余铜足够厚）、刚度（压装不塌、承压不鼓）、可制造（槽宽与孔径在机加能力内）、可密封（钎料不流进 0.40 mm 槽）。这四件事互相拉扯，厚度链是它们的交汇点。

### 6.1 材料选型

零件 | 材料 | 关键性能 | 选择理由 | 备选
换热底板 JM01-100 | C110 / C1020 紫铜 | k ≈ 390 W·m⁻¹K⁻¹；退火态屈服 ≈ 70 MPa | 导热最优；铲齿/CNC 工艺成熟；与钎焊相容 | C102（含氧低）
喷嘴盖板 JM01-200 | 同铜 | 同上 | 与底板同材，避免钎焊热膨胀失配；微钻 0.50 mm 可行 | 无（异种材料会引入 CTE 失配）
钎料框 JM01-400 | Ag 基或 Cu-P 钎料 | 熔点 < 铜；润湿可控 | 真空钎焊工艺成熟；框形结构限制钎料流动路径 | 扩散焊（无钎料）
进出水嘴 JM01-310/320 | 铜或不锈钢 | 与 UQD 配合 | 跟托盘 UQD，不自创口径，待冻结 | —
接触面镀层 | 可选化学镀 Ni | 3–8 μm | 防氧化、改善与 TIM2 的浸润；不得进流道 | 无镀层

不采用整板金属增材（LPBF）作为出货基线。残粉对 ⌀0.50 mm 孔不可接受，且致密度不足会折损导热率。增材只允许用于喷嘴盖板的验证件，密封面仍须机加。

### 6.2 层叠结构与厚度链

层 | 厚度 / mm | 功能 | 工艺 | 厚度取值理由
进液盖 / 喷嘴板 | 2.5 | 静压箱 + 216 个喷嘴 + 回液缝；HBM 区无喷嘴 | 微钻或蚀刻；密封面精铣 | 孔长/孔径 = 5，保证射流出口方向稳定； 太薄则孔难加工且刚度不足
射流间隙 H | 2.0 | 自由射流段 | 由盖板与肋顶间距形成 | H/D = 4.0，落在 2–6 窗内
换热槽层 | 1.5 | GPU 短槽 + HBM 宽槽 + 隔离肋 | 铲齿或 CNC | 肋效率 0.948（仍 >0.9）； 偏厚，存在优化空间，见下方注
接触面余铜 | 2.0 | 扩热、刚度、防铣穿 | 与底板一体 | 一维热阻仅 0.0034 °C/W； 同时满足平面度 0.05 与防穿透
腔体小计 | 8.0 | — | — | 四层相加
周边钎缝 / 水嘴台阶 | 0.5 | 封接 | 钎焊 | 工艺余量
外形总厚 | 8.5 | — | — | 不含 UQD

已识别的优化项（登记为 OPT-1）：按真实“就近抽走”拓扑，槽内流速只有 0.034 m/s，说明 1.5 mm 槽深对这个流量明显过大，下部存在低速死体积。把槽深减到 0.8–1.0 mm 可以缩短导热路径并减重，但会改变厚度链与全套图纸。本版保留 1.5 mm 作为冻结基线（图纸自洽优先），槽深优化交由 CFD 在 DR3 一并判定。

### 6.3 承压与变形校核

模型：两端固支板条，试验压力 3 bar（表压）。σ = p·L²/(2t²)，挠度 w = p·L⁴/(32·E·t³)，铜屈服强度保守取 70 MPa（退火态）。

校核工况 | 弯曲应力 σ / MPa | 挠度 / μm | 安全系数 | 判定
余铜跨槽（跨 0.8 mm，t=2.0 mm） | 0.02 | 0.00 | 2,917 | 通过
盖板跨射流阵（跨 26 mm，t=2.5 mm） | 16.73 | 2.65 | 4 | 通过
盖板跨 HBM 区（跨 11 mm，t=2.5 mm） | 2.90 | 0.08 | 24 | 通过

三个工况的安全系数都在数百到数万量级，承压不是本设计的约束。真正的机械风险是压装偏载传到 HBM 焊球和焊后平面度，这两项由隔离肋布置与焊后精铣控制，不能靠应力计算证明，必须靠首件三坐标与红外验证。

### 6.4 压装与载荷路径

- 隔离肋参与承载：宽 2.0 mm，与封装加强环对位，把压装力从 GPU 区传到边框，使 HBM 区压强低于 GPU 区。
- 压装力：估 300–500 N（待 ICD，IN-M2）。加载点为四角 ⌀3.4 沉孔，须配弹性元件保证 TIM2 厚度稳定。
- TIM2 装配窗：冷板不规定 TIM2 品牌，但必须在 ICD 中约定装配压力与目标厚度 —— TIM2 在保守端占掉 22% 的热阻预算，是最敏感的装配变量。
- 禁止：把压装力全部经由薄盖板传递；盖板只封流道，不做主承载件。

### 6.5 公差与形位公差

部位 | 尺寸 / 公差 | 形位公差 | 检测手段 | 理由
接触面（与封装盖贴合） | — | 平面度 0.05 mm；Ra ≤ 0.8 μm | 三坐标 / 平晶 / 轮廓仪 | 直接决定 TIM2 厚度与接触热阻
GPU 短槽宽 | 0.40 ±0.03 mm | — | 影像测量 | 偏差影响流量分配与肋效率
喷嘴孔径 | ⌀0.50 +0.03 / 0 mm | 轴线垂直度 0.05 | 针规 / 影像 | 孔径散差直接造成射流不均
喷嘴阵与 die 对位 | ±0.20 mm | 位置度 ⌀0.4（MMC） | 焊后 X-ray / 工装定位 | 驻点必须对准 die 中心，偏了就出现冷斑错位
射流间隙 H | 2.0 ±0.10 mm | 平行度 0.05 | 焊后剖切抽检 | H/D 直接影响驻点 h
外形 | 95×75 ±0.15 mm | — | 卡尺 / 三坐标 | 托盘装配
总厚 | 8.5 ±0.10 mm | — | 千分尺 | 压装行程

### 6.6 工艺路线与封合

工序 | 内容 | 关键控制点
1 底板开流道 | 铲齿或 CNC 铣 GPU 短槽 + HBM 宽槽 + 隔离肋 | 槽宽 ±0.03；不得铣穿余铜（留 2.0 mm）
2 盖板加工 | 微钻 216 × ⌀0.50 mm + 回液缝 + 静压箱腔 | 孔无毛刺、不堵；孔位 ±0.10
3 清洗 | 超声 + 去离子冲洗 + 烘干 | 颗粒 ≤ 孔径 1/10（50 μm）
4 铺钎料框 | 空心框形，不是整层铺 | 钎料不得流入 0.40 mm 槽
5 对位与夹具 | 盖板与底板对位 ±0.20 | 工装定位销，不靠目视
6 真空钎焊 | 首选真空钎焊；备选扩散焊 | 温度曲线；防塌陷（细肋支撑）
7 接触面精铣 | 焊后加工 | 平面度 0.05；Ra ≤0.8
8 水嘴装配 | 钎焊或一体 | 跟 UQD 口径
9 检漏 | 100% 氦质谱检漏 + 保压 | 3 bar 保压
10 出厂测试 | 流量–压降曲线、TTV 热阻、红外 | 三条曲线随件出厂

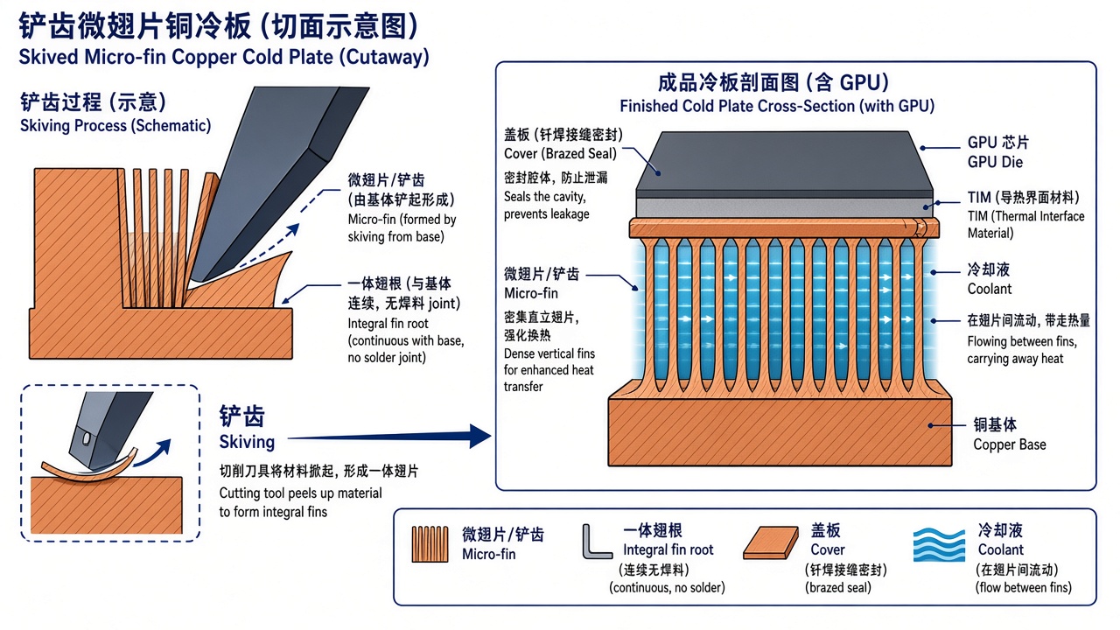
[picture p86: coolingplate/design/assets/principle-skived-fin.png]
铲齿铜底板工艺（自绘示意）


图 6-1 铲齿铜底板工艺（自绘示意）底板优先铲齿或 CNC 短槽，不是整板增材。铲齿一体翅根导热好、适合量产；本设计 GPU 区槽长短（≤8 mm），比传统长铲齿更易控流。

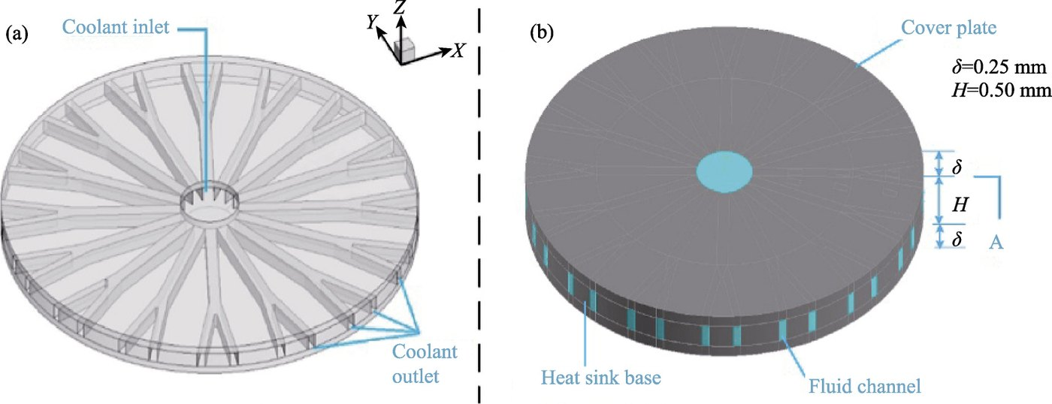
[picture p87: coolingplate/design/assets/src/sciopen_fig8_fmhs.jpg]
论文原图 · 盖板 + 微通道封合


图 6-2 论文原图 · 盖板 + 微通道封合机加/蚀刻盖板与底板封合，是本设计量产路线的同类结构。来源：SciOpen 微通道强化换热综述 Fig. 8。

### 6.7 质量与维护

项 | 值 / 要求 | 说明
外形体积 | 60.6 cm³ | 95×75×8.5 mm
估算质量 | ≈ 442 g | 按 82% 实体率、铜密度 8900 kg/m³
可维护性 | 本版为钎焊一体件，喷嘴盖不可现场拆卸 | 结构预留拆芯凸台，为专利方案 B（可换喷嘴芯）留接口
防堵策略 | 孔径 0.50 mm + 系统过滤 ≤25 μm + 跨板压差监测 | 压差上升即为堵塞前兆；本版不做在架反冲洗
失冷窗口 | 不写保证秒数 | 行业经验约 90 s，非 NVIDIA 官方指标，不作承诺

## 7. 原理图

三张原理图分别回答三个层次的问题：系统图说明冷板在回路中的位置与口径分界；内部流路图说明流量怎么分、压降落在哪里；机理图（见 §5.4 图 5-3）说明换热靠什么物理过程。

### 7.1 系统水力原理图

图 7-1 系统水力原理图。四块冷板必须并联。

界面 | 口径 | 责任方 | 本冷板的义务
机柜一次/二次侧 | 25–45 °C ↔ 59–177 L/min；16–127 kPa | CDU / 机柜 | 只吃掉自己的 ΔP，不对整柜曲线负责
托盘分流 | 由孔板分配到 4 块 GPU 冷板 | OEM | 设计按 2.0 L/min，SAT 实测确认
UQD 快接 | 参考 4–8 kPa/对 | OEM | 跟托盘口径，不自创；是否计入 20 kPa 窗须 ICD 明确
Grace 冷板 | 独立冷板，300 W 级 | OEM / 他方 | 不与 B300 共一块铜；本文件不画其流道
漏液链 | 分层：冷板本体氦检 | 冷板厂 / 系统 | 托盘与机柜漏液检测不在本供货

禁止的三种口径混用：① 把整柜 59–177 L/min 中的某一档写成单板保证流量；② 把 NVSwitch 托盘的 2–50 °C 水温窗写成 GPU 冷板保证；③ 把 ASHRAE W45 等级当成机柜进液保证值。

### 7.2 冷板内部流路原理图

图 7-2 内部流路与压降分段（DP-A 实算值）。

读图要点：流量 80/20 与功率 78/18 是两件不同的事。功率拆分决定各区要带走多少热；流量拆分决定各区能得到多少质量流量。两者比例接近只是巧合，不能互相推导。分流靠孔阻与隔墙实现，不靠外置阀门 —— 因为 72 块冷板不可能逐块调阀。

### 7.3 温度语义：三条不能混画的线

图 7-3 沿程三种温度。保守模型下 Tj 上界已顶到包络上沿。

符号 | 含义 | DP-A 量级（水 40 °C 进） | 图上怎么认 | 常见误用
Tf | 当地 / 混合流体温度 | 40 → 48.0 °C （+7.96 K） | 蓝色实线、箭头与歧管配色 | 把出液 48 °C 当成芯片温度
Tw / Tc | 铜壁 / 壳温 | 76 – 80 °C（驻点最高） | 橙色带（乐观↔保守） | 用一张虹彩图把壁温和流体温糊在一起
Tj | 结温 | 85 – 93 °C | 红色虚线，比壁峰更高 | 忽略封装内阻，直接拿壳温当结温

ΔTf = P / (ṁ · cp)，ṁ = ρ · Q = 992.2 × 2.0/60000 = 0.0331 kg/sΔTf = 7.96 K混合温升只由总功率与总流量决定，与是射流还是平槽无关

处处成立：Tj > Tw > Tf。出液流体即使到 48.0 °C，也比驻点壁温低二十多度。因此不能把出液歧管涂成“芯片红”，也不能用 10 K 温升反推流量 —— 那是把结果当成输入。

## 8. 详细设计：CAD 图纸

型号 CP-B300-JM-01，外形候选 95 × 75 × 8.5 mm（不含 UQD）。本章所有图为按毫米真比例绘制的矢量图，1 图形单位 = 1 mm，可直接量取。NVIDIA 未公布 B300 盖板轮廓，§8.1 的锁定坐标表是全文唯一几何来源。

### 8.1 锁定封装坐标（唯一几何来源）

原点：冷板左下角；X 向右，Y 向上；单位 mm。

对象 | x₀ | y₀ | 宽 × 高 | 数量 | 备注
冷板外形 | 0 | 0 | 95 × 75 × 8.5 | 1 | 候选，待冻结
Die-A | 19.0 | 23.5 | 27 × 28 | 1 | 左计算 die
NV-HBI 缝 | 46.0 | 23.5 | 3 × 28 | 1 | 不打密集射流
Die-B | 49.0 | 23.5 | 27 × 28 | 1 | 右计算 die
射流阵 A / B | 20.5 / 50.5 | 24.3 | 24.0 × 26.4 | 2 | 9×12，节距 3.0×2.4，中心距 24.0×26.4，覆盖 27.0×28.8，Y 向比 die 宽 0.8 mm，板外包络 29.2 mm，余 0.4 mm
HBM-L1…L4 | 5.0 | 12.5 + n×13 | 11 × 11 | 4 | y = 12.5 / 25.5 / 38.5 / 51.5
HBM-R1…R4 | 79.0 | 12.5 + n×13 | 11 × 11 | 4 | 同上
隔离肋 左 / 右 | 16.5 / 76.5 | 12.5 | 2.0 × 50 | 2 | 切断 GPU↔HBM 串流
隔离肋 南 / 北 | 19.0 | 21.5 / 51.5 | 57 × 2.0 | 2 | die 上下边
进液歧管带 | 8 | 66 | 79 × 7 | 1 | 板上沿，IN
出液歧管带 | 8 | 2 | 79 × 7 | 1 | 板下沿，OUT
安装沉孔 | 4.5 / 90.5 | 4.5 / 70.5 | ⌀3.4 | 4 | 四角，待冻结

#### 尺寸链闭合校核

校核项 | 算式 | 结果 / mm | 期望 / mm | 判定
X 向链 | 5+11+0.5+2+0.5+27+3+27+0.5+2+0.5+11+5 | 95.0 | 95.0 | 闭合
Y 向链 | 12.5+50+12.5 | 75.0 | 75.0 | 闭合
腔体厚度 | 2.0+1.5+2.0+2.5 | 8.0 | 8.0 | 闭合
射流中心距 X | (9-1)x3.0 | 24.0 | 24.0 | 闭合
射流中心距 Y | (12-1)x2.4 | 26.4 | 26.4 | 闭合
覆盖长度 X | 9x3.0 | 27.0 | 27.0 | 闭合
覆盖长度 Y | 12x2.4 | 28.8 | 28.8 | 闭合
Y 向超出 die | 28.8-28 | 0.8 | 0.8 | 闭合
Y 向板外包络 | 28+1.2 | 29.2 | 29.2 | 闭合
外包络余量 | 29.2-28.8 | 0.4 | 0.4 | 闭合
单 die 槽覆盖 | 35x0.8 | 28.0 | 28.0 | 闭合

五项尺寸链全部闭合，说明布置在几何上自洽。这是图纸可以出的前提 —— v1.x 未做此校核。

### 8.2 图纸清单

图号 | 名称 | 类型 | 比例 | 状态
JM01-A0 | 外形三视图（含标题栏、安装孔、剖切符号） | 2D 矢量 | 1:1 | 候选
JM01-A1 | 底板流道平面图 | 2D 矢量 | 1:1 | 候选
JM01-A2 | 剖面 A-A（过 Die-A 中心，GPU 射流区） | 2D 矢量 | 1:1 | 候选
JM01-A3 | 剖面 B-B（过 HBM 列，无射流） | 2D 矢量 | 1:1 | 候选
JM01-A4 | 射流单元详图 | 2D 矢量 | 1:1 | 候选
JM01-A5 | 喷嘴盖板孔位图 | 2D 矢量 | 1:1（孔径示意放大） | 候选
JM01-3D | 等轴测装配图 | 3D 等轴测 | 示意 | 候选
JM01-A6 | 爆炸装配图 | 3D 等轴测 | 示意 | 候选
JM01-L1 | 分区布置图（性能设计用） | 2D 矢量 | 1:1 | 见图 8-1

### 8.3 分区布置图

图 8-1 · JM01-L1 分区布置（1:1 真比例）。两颗 die 中心偏红 = 壁面驻点，不是流体 48 °C；青绿 8 块 = HBM，只走平流；深蓝竖条 = 隔离肋。密点为 9×12 射流落点。Y 向胞列 28.8 mm，比 die 的 28 mm 宽 0.8 mm。

### 8.4 2D：外形三视图（JM01-A0）

图 8-2 · JM01-A0 第三视角三视图。俯视图含 die/HBM 轮廓（虚线）、四角安装沉孔、水嘴中心线与 A-A / B-B 剖切符号；主视与左视按 8.5 mm 薄板真比例绘制。

### 8.5 2D：底板流道平面图（JM01-A1）

图 8-3 · JM01-A1 底板流道。GPU 区短槽沿 X 向、节距 0.80；HBM 区宽槽沿 Y 向；橙色虚线为盖板回液缝投影，它把槽内流程截断在 ≤8 mm。红色虚线为 die 轮廓。

### 8.6 2D：剖面图（JM01-A2 / A3）

图 8-4 · JM01-A2 剖面 A-A（GPU 射流区），1:1 真比例。厚度链：孔板 2.5 + H 2.0 + 槽 1.5 + 余铜 2.0 = 8.0 mm 腔体。水缝不得画得比余铜厚 —— 这是位图示意最常犯的错。

图 8-5 · JM01-A3 剖面 B-B（HBM 区），1:1。盖板此区无喷嘴，槽更宽（0.60 vs 0.40）以降低近壁流速。铜层厚度语言与 A-A 一致，便于对比。

### 8.7 2D：射流单元详图（JM01-A4）

图 8-6 · JM01-A4 射流单元，节距 3.0 mm × 2.4 mm，1:1。整板 GPU 区就是这一格重复 216 次。水缝与余铜同厚，箱体不能画成大厅。

### 8.8 2D：喷嘴盖板孔位图（JM01-A5）

图 8-7 · JM01-A5 216 个 ⌀0.50 mm 喷嘴按真实坐标绘制（图示直径放大 2.6× 以便看清），含阵列基准中心线、回液缝与 HBM 区“无喷嘴”明示。

### 8.9 3D：等轴测装配图（JM01-3D）

图 8-8 · JM01-3D 等轴测装配。按 8.5 mm 薄板绘制，不要理解成空心箱体。顶面蓝框为两处射流阵，绿框为 HBM 区（盖板无孔）。

### 8.10 3D：爆炸装配图（JM01-A6）

图 8-9 · JM01-A6 爆炸装配。只有三件 + 水嘴：喷嘴盖 2.5 + 钎焊框 0.5（空心框，不是整层水层）+ 底板 3.5。爆炸间隙仅为显示需要。

### 8.11 零件表（BOM）

图号 | 名称 | 数量 | 材料 | 关键特征 | 工艺
JM01-100 | 换热底板 | 1 | C110 / C1020 | GPU 短槽 35×2 条 + HBM 宽槽 16 条 + 隔离肋 4 条 | 铲齿或 CNC
JM01-200 | 喷嘴盖板 | 1 | 同铜 | 216 × ⌀0.50 喷嘴 + 回液缝 6 条 + 静压箱 | 微钻 / 蚀刻
JM01-310 | 进液水嘴 | 1 | 铜或不锈钢 | 跟 UQD，待冻结 | 钎焊或一体
JM01-320 | 出液水嘴 | 1 | 同上 | 同上 | 同上
JM01-400 | 钎料 / 封接框 | 1 套 | Ag 基或 Cu-P | 空心框；不得流入 0.40 mm 槽 | 真空钎焊
JM01-500 | 接触面（焊后精铣） | — | — | 平面度 0.05；Ra ≤0.8 μm | 精铣
JM01-600 | 接触面镀层（可选） | — | 化学镀 Ni 3–8 μm | 局部镀，不进流道 | 化学镀

本章图纸的工程状态：尺寸真实、尺寸链闭合、可用于评审与打样询价，但不是可直接投产的正式图纸。投产前必须补：完整公差标注体系（GD&T）、表面处理规范、焊接符号、检验要求表，并以 OEM 封装图替换 §8.1 的候选坐标。

## 9. 一维性能计算

本章是可复算的计算书：每一步给公式、代入值、结果。全部数值由 calc/model.py 计算，calc/cp_b300_1d.py 输出文本计算书。一维计算的作用是判断方案是否值得做三维仿真，不是给出保证值。

### 9.1 计算口径与方法学

项 | 取法 | 理由
工质物性 | 饱和水 40 °C（见 §3.2） | 设计进液温度；不随沿程温升修正（一维保守做法）
热源模型 | 两 die 面均热流 + 2.5 倍热点系数 | 官方 power map 未获得
换热模型 | 三个独立模型给上下界 | 单一关联式在本 Re 区间不可靠，见 §9.4
压降模型 | 孔口局部损失 + 层流摩阻 + 歧管估值 | 歧管段必须由 CFD 替换
安全取向 | 热阻取区间而非单值 | 避免用乐观单值掩盖不确定性

### 9.2 能量平衡与流体温升

ṁ = ρ·Q ； ΔTf = P / (ṁ·cp)

Q / L·min⁻¹ | ṁ / kg·s⁻¹ | ΔTf @ 1100 W | ΔTf @ 1400 W | 备注
1.6 | 0.0265 | 9.95 K | 12.66 K | GPU 支路流量
2.0 | 0.0331 | 7.96 K | 10.13 K | DP-A 设计点
2.2 | 0.0364 | 7.24 K | 9.21 K | PG25 备选
2.4 | 0.0397 | 6.63 K | 8.44 K | DP-B 设计点

设计点流体温升 7.96 K，与行业常用“<10 K”一致。但不得把这个关系倒过来用：先定 10 K 再除以功率得到流量，是把计算结果当成设计输入。流量必须由换热需求（孔速）和系统约束（托盘分流）共同决定。

### 9.3 射流水力

Ajet = N·πD²/4 = 216 × π × (0.50/2)² = 42.41 mm²

Vjet = QGPU / Ajet ； ReD = ρ·Vjet·D / μ ； ΔP孔口 = K·ρV²/2 (K = 1.8)

设计点 | QGPU / L·min⁻¹ | Vjet / m·s⁻¹ | ReD | ΔP孔口 / kPa | 流态判定
DP-A | 1.60 | 0.629 | 478 | 0.35 | 层流–过渡
DP-B | 1.92 | 0.755 | 573 | 0.51 | 层流–过渡

### 9.4 换热系数：三个模型的上下界

这是本报告最重要的一节。单一关联式在 ReD ≈ 478 这个区间不可靠，因此用三个物理含义不同的模型互相约束：

#### 模型 A · 驻点量级式（只代表驻点核）

Nu₀ = 0.5·ReD⁰.⁵·Pr⁰.⁴ ； hstag = Nu₀·k / Dhstag = 24,773 W·m⁻²K⁻¹只在孔正下方约 1 mm² 的核内成立，不能代表整区

#### 模型 B · Martin(1977) 圆孔阵列面平均（乐观）

Nu / Pr⁰.⁴² = K(f, H/D) · Re2/3 ； K = [1 + (H/D ÷ (0.6/√f))⁶]⁻⁰.⁰⁵ · √f · (2 − 2.2√f) / (1 + 0.2(H/D − 6)√f)K 与 Nu 不计算。Re_D = 478 < 2000，Martin 1977 不采用有效域：2000 ≤ Re ≤ 10⁵，0.004 ≤ f ≤ 0.04，2 ≤ H/D ≤ 12。本设计 f = 0.02727，H/D = 4.0，Re = 478，低于下限，关联式不采用

模型 B 不采用。设计点 ReD = 478，低于 Martin 1977 下限 2000。不把外推的 Nu 或 h 写进热阻。壳–进液只保留模型 C（短槽）加上 R_TIM2 区间。

#### 模型 C · 短槽当肋 + 导管对流（保守）

按真实“就近抽走”拓扑：每个孔的流量只在其 3.0 mm × 2.4 mm 的单元内左右分走，流程 Lf = 3.0 mm。此时槽内是低速流，槽的作用是扩展表面（肋），不是高速导管。

Nuch = max(4.0, 1.86·Gz1/3)，Gz = (Dh/L)·Re·Pr ； hch = Nu·k / DhNuch = 5.78，hch = 5,772 W·m⁻²K⁻¹恒热流全发展层流下界 Nu = 4.0；短槽属热入口段

肋效率 ηf = tanh(mL)/mL，m = √(2h/(kCu·t))ηf = 0.948肋厚 0.40 mm、肋高 1.50 mm、kCu = 390 W·m⁻¹K⁻¹

hA = hch·(A肋·ηf + A槽底) + (hstag − hch)·A驻点 （每 die，再 ×2）hA = 39.6 W/K → heff(footprint) = 25,477 W·m⁻²K⁻¹

#### 三模型对比

模型 | 物理含义 | h / W·m⁻²K⁻¹（DP-A） | Rconv / °C/W | 可靠性评价
A 驻点式 | 孔正下方核内峰值 | 24,773 | 不可直接用 | 只说明驻点量级
B Martin 阵列 | 整个冲击面的面平均 | 不采用 | 不采用 | Re<2000，不外推
C 肋 + 导管 | 把槽当扩展表面，叠加驻点强化 | 25,477 | 0.0252 | 保守下界，忽略射流对槽内的强化

模型 B 因 ReD < 2000 不采用，没有 Martin 下界可与模型 C 相除。设计热阻用模型 C：Rconv = 0.0252 °C/W，再加 R_wall = 0.0034 与 R_TIM2 = 0.004–0.008。DP-A 壳–进液 0.0326–0.0366 °C/W。把这个区间用三维共轭 CFD 收窄，仍是核心任务。

### 9.5 通道侧流动（两种拓扑对比）

Dh = 2wh/(w+h) = 2×0.40×1.50/(0.40+1.50) = 0.6316 mm ； f·Re = 17.98（Shah & London 矩形层流，α = 0.267）

拓扑模型 | 流动假设 | V / m·s⁻¹ | Re | L / mm | ΔP槽 / kPa | 评价
cell（真实） | 每孔流量在单元内就近左右分走 | 0.034 | 33 | 3.0 | 0.0015 | 与射流拓扑自洽
bank（对比） | 全流量单向穿过全部槽（相当于没有射流） | 0.635 | 609 | 8.0 | 0.0748 | v1.x 采用，与射流互相矛盾

项 | 值 | 说明
每 die 槽数 | 35 条 | 28 mm ÷ 0.80 mm 节距
单 die 肋面积 | 2916 mm² | 35 × 2 面 × 1.50 mm × 27 mm
单 die 槽底面积 | 389 mm² | —
单 die 湿润面积 | 3305 mm² | footprint 756 mm² 的 4.25 倍

这是对 v1.x 的一处实质修正。v1.x 按 bank 模型算出槽内 0.74 m/s、Re 710、ΔP 0.4 kPa，但那个流动图像要求全部流量从槽的一端流到另一端 —— 与“射流垂直冲击后就近抽走”不能同时成立。按自洽的 cell 模型，槽内压降可忽略，槽的价值在于 4.25 倍面积放大和 0.948 的肋效率。

### 9.6 HBM 区校核

Dh,HBM = 0.857 mm ； V = QHBM / (Nch·w·h) ； f·Re = 16.38

设计点 | QHBM / L·min⁻¹ | V / m·s⁻¹ | 流速帽 0.80 | Re | ΔP / kPa | 判定
DP-A | 0.40 | 0.463 | 余量 42% | 603 | 0.17 | 通过
DP-B | 0.48 | 0.556 | 余量 31% | 724 | 0.20 | 通过

### 9.7 热阻链与温度汇总

Rwall = t / (kCu·A2die) = 2.0e-3 / (390 × 15.12e-4)Rwall = 0.00339 °C/W

Rθ,c-in = RTIM2 + Rwall + Rconv ； Tc = Tin + Rθ,c-in·P ； Tj = Tc + Rpkg·P

设计点 | 组合 | RTIM2 | Rwall | Rconv | Rθ,c-in | ΔTc | Tc | Tj | 对目标
DP-A | 短槽 + TIM2=0.004 | 0.004 | 0.0034 | 0.0252 | 0.0326 | 35.9 K | 75.9 °C | 84.7 °C | 高于目标
DP-A | 短槽 + TIM2=0.008 | 0.008 | 0.0034 | 0.0252 | 0.0366 | 40.3 K | 80.3 °C | 93.5 °C | 高于目标
DP-B | 短槽 + TIM2=0.004 | 0.004 | 0.0034 | 0.0237 | 0.0311 | 43.6 K | 83.6 °C | 94.8 °C | 高于目标
DP-B | 短槽 + TIM2=0.008 | 0.008 | 0.0034 | 0.0237 | 0.0351 | 49.2 K | 89.2 °C | 106.0 °C | 高于目标

### 9.8 压降预算

分段 | 模型 | DP-A / kPa | DP-B / kPa | 备注
喷嘴孔口 | K·ρV²/2，K = 1.8 | 0.35 | 0.51 | 主要可控项
GPU 短槽 | 层流摩阻（cell 拓扑） | 0.002 | 0.002 | 可忽略
HBM 槽 | 层流摩阻，L = 50 mm | 0.17 | 0.20 | 低速
盖板静压箱 / 隔墙 | 估值 | 3 – 5 | 3 – 5 | 必须由 CFD 替换（AS-7）
板内合计 | — | 3.5 – 5.5 | 3.7 – 5.7 | 目标 ≤18，上限 20
一对 UQD（参考） | 厂家曲线 | 4 – 8 | 同左 | 不计入冷板窗则须 ICD 声明

压降余量是本设计最大的资产。板内只用掉 5.5 kPa，距 18 kPa 目标还有 12 kPa 可用。热阻却已超标 —— 所以正确的优化方向是拿压降去换换热（减小孔径、加密阵列），而不是继续优化压降。

### 9.9 PG25 复算

项 | DI 水 40 °C | PG25 40 °C | 变化 | 影响
Pr | 4.32 | 9.92 | ×2.29 | —
ReD（同流量） | 478 | 279 | -42% | 更深入层流区
Martin h | 不采用 | 不采用 | — | Re<2000，两侧都不外推
Rconv（模型 C） | 0.0252 | 0.0318 | +25.9% | 短槽模型，216 胞并联
ΔTf | 7.96 K | 8.28 K | +4.0% | cp 较低
ΔP孔口 | 0.35 kPa | 0.36 kPa | +3.0% | 密度略高，影响小

PG25 不沿用水的 Martin 百分比。两侧 Re 都低于 2000，Martin h 不计算。根因仍是 PG25 的导热率只有水的 72%，而粘度是 1.76 倍。短槽模型 R_conv 从 0.0252 变为 0.0318 °C/W。若项目最终选 PG25，必须单独定流量并重做 CFD，不能沿用水的 2.0 L/min。

### 9.10 敏感性分析：孔径

图 9-1 孔径敏感性。孔数固定 216，GPU 支路流量固定 1.60 L/min。ReD 全部低于 2000，Martin h 不采用。

D / mm | Sx/D | Sy/D | H/D | V / m·s⁻¹ | ReD | Martin | ΔP孔口 / kPa | 评价
0.50 | 6.0 | 4.8 | 4.0 | 0.629 | 478 | 不采用 | 0.35 | 当前基线
0.45 | 6.7 | 5.3 | 4.4 | 0.776 | 531 | 不采用 | 0.54 | 中间档
0.40 | 7.5 | 6.0 | 5.0 | 0.982 | 597 | 不采用 | 0.86 | CFD 单胞孔径，仍低于 Re=2000
0.35 | 8.6 | 6.9 | 5.7 | 1.283 | 682 | 不采用 | 1.47 | DP-B 储备（过滤收紧）
0.30 | 10.0 | 8.0 | 6.7 | 1.747 | 796 | 不采用 | 2.72 | 极限，堵塞风险高

Martin 1977 在 ReD < 2000 时不采用，因此本表不给 h，也不给由 Martin 反推的 Rθ,c-in。

杠杆 | 效果 | 代价 | 建议
孔径 0.50 → 0.40 mm | Re 478 → 597，仍低于 2000 | 孔口 ΔP 0.35 → 0.86 kPa；过滤收紧到 40 μm | 单胞 CFD 用 0.40 mm；Martin 仍不采用
孔径 → 0.35 mm | Re 682 | ΔP 1.47 kPa；堵塞后果严重 | 仅作 DP-B 储备
流量 2.0 → 2.4 L/min | Re 478 → 573 | 系统侧需确认分流能力；ΔP 上升 | 受托盘约束，非本方可控
TIM2 0.008 → 0.004 °C/W | 直接省 4 mK/W，约占预算 14% | TIM 成本与装配工艺 | 性价比最高，优先推进
阵列已定为 9×12 | 每 die 108 孔，两 die 216 孔 | Y 向胞列 28.8 mm，比 die 28 mm 宽 0.8 mm；板外包络 29.2 mm，余 0.4 mm | 热流按 216 胞摊全部 GPU 热量，不按 756 mm² 满铺

### 9.11 差距闭合矩阵

问题定义：保守模型给出的等效 h（footprint 基准）为 25,477 W·m⁻²K⁻¹。要达标需要多大的 h？

hrequired = 1 / [(Rtarget − Rwall − RTIM2) · Acovered]

设计点 | RTIM2 | TIM2 档次 | 需要 h / W·m⁻²K⁻¹ | 对比保守模型 | 闭合手段
DP-A | 0.008 | 常规导热垫（差） | 38,716 | 差 +52% | 需孔径优化 + 流量提升
DP-A | 0.006 | 常规导热垫（好） | 34,555 | 差 +36% | 需孔径优化 + 流量提升
DP-A | 0.004 | 高性能 TIM2 | 31,201 | 差 +22% | 需孔径优化 + 流量提升
DP-A | 0.002 | 液金 / 焊接 | 28,441 | 差 +12% | 需孔径优化
DP-B | 0.008 | 常规导热垫（差） | 47,251 | 差 +74% | 需孔径优化 + 流量提升
DP-B | 0.006 | 常规导热垫（好） | 41,196 | 差 +52% | 需孔径优化 + 流量提升
DP-B | 0.004 | 高性能 TIM2 | 36,517 | 差 +35% | 需孔径优化 + 流量提升
DP-B | 0.002 | 液金 / 焊接 | 32,792 | 差 +21% | 需孔径优化 + 流量提升

图 9-2 差距闭合。红线为保守模型天花板，线上方的柱子都是保守模型打不到的目标。

### 9.12 一维计算结论

1. 水力全面达标且余量大：压降、HBM 流速、流体温升三项均通过，余量充足。
2. 热性能不判定：区间跨越目标线，乐观端达标、保守端超标。一维计算无法收敛，这是转入三维仿真的技术理由。
3. 若真实性能接近保守端，DP-A 需要 TIM2 ≤ 0.004 °C/W 才勉强达标；DP-B 需要液金级 TIM2 叠加孔径优化。
4. 最优先的两个杠杆：TIM2 升级（省 4 mK/W，无几何代价）与孔径 0.50→0.40 mm（h +16%，ΔP 代价可接受）。
5. 已识别的模型缺陷：Re 低于关联式有效域（§9.4）、槽深过大存在死体积（§6.2 OPT-1）、歧管压降为估值（AS-7）。三项都只能由 CFD 关闭。

复算方法：cd design/calc && set PYTHONIOENCODING=utf-8 && python cp_b300_1d.py，输出 cp_b300_1d_out.txt。修改 model.py 中的 GEO / DESIGN_POINTS 后重新生成本报告，全文数值同步更新。

## 10. 三维仿真需求（CFD 工具待定）

本章是仿真需求规格书，不是仿真报告。它规定要回答什么问题、用什么网格和模型、以及什么条件下才算通过 —— 以便在工具选定后由任何一方执行并被复核。工具刻意不指定，只给能力要求。

### 10.1 仿真要回答的问题（按优先级）

# | 问题 | 为什么一维答不了 | 判据 / 交付

Q1 | 壳–进液热阻的真值是多少？ | Martin 因 Re = 478 < 2000 不采用，一维只剩短槽模型 | 给出 Rθ,c-in 单值，与网格无关性误差 < 3%
Q2 | 216 个孔的流量一致性如何？ | 一维无法解静压箱内部压力分布 | 各孔流量偏差 ≤ ±10%；给出最差孔位置
Q3 | 两 die 之间与 die 内部的温差分布？ | 一维是集中参数，没有空间分布 | 两 die 中心温差 ≤ 5 K；给出壁温云图
Q4 | 静压箱与隔墙的真实压降是多少？ | 一维只能给 3–5 kPa 估值（AS-7） | 替换 §9.8 的估值；总 ΔP ≤ 18 kPa
Q5 | 交叉流是否把下游驻点吹偏？ | 一维没有流场 | 驻点位置偏移 < 0.5 mm；给出流线图
Q6 | HBM 区是否存在局部高速冲蚀风险？ | 一维只算平均流速 | 全域近壁速度 ≤ 0.80 m/s
Q7 | 槽深从 1.5 减到 0.8–1.0 mm 是否更优？（OPT-1） | 一维无法评估死体积效应 | 给出槽深 0.8/1.0/1.5 mm 的 R 与 ΔP 对比
Q8 | PG25 工况下性能与流量需求？ | 一维外推更不可靠（Re 更低） | 给出 PG25 的推荐流量

### 10.2 工具候选与选型准则

工具待定。选型不按品牌，按以下能力要求判定：

能力要求 | 为什么必须 | 验证方法
共轭传热（CHT，流固耦合） | 铜的横向扩热是分区设计成立的前提，不能用等温壁代替 | 跑一个已知解析解的平板算例
低 Re / 转捩流动建模 | ReD ≈ 478 处于层流–过渡区，全湍流模型会高估换热 | 同一算例跑层流与转捩 SST，对比差异
高纵横比小特征网格 | ⌀0.50 mm 孔与 0.40 mm 槽，与 95 mm 板尺度相差 200 倍 | 网格质量指标：最小正交质量 > 0.15
多孔/多通道流量后处理 | Q2 要逐孔流量，需要面通量统计能力 | 能输出 128 个孔的质量流量列表
参数化与批量求解 | §10.7 工况矩阵有 12+ 算例，OPT-1 还要扫槽深 | 支持脚本化批处理

常见候选包括通用 CFD 求解器与电子散热专用求解器两类。专用电子散热工具的风险是对 0.5 mm 射流孔常用降阶/多孔介质模型，可能无法解析驻点边界层；通用求解器的风险是网格量与人工成本。建议：先用通用求解器做 1/4 对称精细模型定标，再用降阶模型做全板工况扫描。

### 10.3 计算域与简化

图 10-1 共轭计算域分层、网格要求与边界条件。

项 | 要求 | 理由
对称简化 | 允许沿 X 中线取 1/2；不允许取 1/4 | 两 die 对称可用；但 IN/OUT 沿 Y 不对称，Y 向不能切
入口延长段 | ≥ 10 Dh | 避免入口回流污染解
出口延长段 | ≥ 10 Dh | 避免出口回压反射
固体域 | 必须含余铜 + 槽肋 + 盖板；TIM2 与封装盖用等效导热层 | 铜横向扩热必须解出来
允许的简化 | 水嘴内部细节可简化为等效入口；安装沉孔可忽略 | 对 R 与 ΔP 影响 < 1%
禁止的简化 | ① 把喷嘴孔当多孔介质；② 用等温壁代替共轭；③ 只算 1 个单元胞外推整板 | 分别会丢掉驻点、扩热和边缘效应

### 10.4 网格要求

部位 | 网格要求 | 判据
驻点区（孔正下方） | 首层厚度 ≤ 3 μm，法向 ≥ 15 层 | y⁺ < 1
喷嘴孔内 | 径向 ≥ 12 单元，轴向 ≥ 8 单元 | 解析孔口收缩
射流间隙 H = 2.0 mm | 法向 ≥ 20 层 | 解析自由射流发展
短槽内（0.40 × 1.50） | 宽度方向 ≥ 8，深度方向 ≥ 12 | 层流剖面需解析
肋与余铜 | 厚度方向 ≥ 6 层 | 共轭导热梯度
总网格量 | 预计 3 000 万 – 8 000 万（全模） | 1/2 对称可减半
网格无关性 | 至少三套网格（粗/中/细，比例 1:1.5:2.25） | R 与 ΔP 相邻两套差异 < 3%

### 10.5 物理模型

项 | 设定 | 备注
流态 | 不可压、稳态为主 | 瞬态仅用于失冷/负载突变专题
湍流模型 | 转捩 SST（γ-Reθ）为基线；k-ω SST 低 Re 修正为对照 | ReD = 478 处于过渡区
层流对照算例 | 必做 | 与转捩模型构成包络；若两者差异 > 20% 需专题
浮升力 | 可忽略（Ri << 1） | 抽吸由压差驱动，与热浮力无关
物性 | 温变物性（μ、k 随温度） | 水在 40→48 °C 区间 μ 变化约 15%，不可忽略
固体导热 | Cu 390 W·m⁻¹K⁻¹（各向同性） | —
接触热阻 | TIM2 以等效热阻层加载，扫 0.004/0.008 两档 | TIM2 是最敏感参数（§9.11）

### 10.6 边界条件与热源加载

边界 | 类型 | 取值
入口 | 质量流入口 + 温度 | ṁ = 0.0331 kg/s（DP-A），T = 40 °C
出口 | 压力出口 | 0 Pa（表压）
外表面 | 绝热（保守） | 实际有少量对流散热，忽略偏保守
热源 — 基线 | 两 die 区域均匀面热流 | 56.7 W/cm² × 2；HBM 20.5 W/cm² × 8
热源 — 热点工况 | die 内叠加 2.5 倍热点分布 | 峰值 142 W/cm²；热点位置与面积须做敏感性
热源 — 真实热图 | 获得官方 power map 后必须重跑 | IN-T4，当前缺失
壁面 | 无滑移、光滑 | 粗糙度影响留作敏感性（Ra 0.8 μm）

### 10.7 工况矩阵（最小集）

# | 功率 / W | 流量 / L·min⁻¹ | 工质 | 进液 / °C | 热源分布 | 目的

C01 | 1100 | 2.0 | 水 | 40 | 均匀 | 基线，与 §9 对比
C02 | 1100 | 2.0 | 水 | 40 | 热点 2.5× | 壁温峰值
C03 | 1100 | 1.6 | 水 | 40 | 均匀 | 低流量敏感性
C04 | 1100 | 2.4 | 水 | 40 | 均匀 | 高流量收益
C05 | 1100 | 2.0 | 水 | 45 | 热点 2.5× | 最恶工况
C06 | 1400 | 2.4 | 水 | 40 | 热点 2.5× | DP-B 包络
C07 | 1400 | 2.4 | 水 | 45 | 热点 2.5× | DP-B 最恶
C08 | 1100 | 2.0 | PG25 | 40 | 均匀 | 工质敏感性（Q8）
C09 | 1100 | 2.2 | PG25 | 40 | 热点 2.5× | PG25 补流量后能否达标
C10 | 1100 | 2.0 | 水 | 40 | 均匀 | HBM 支路堵塞 20%（鲁棒性）
C11 | 1100 | 2.0 | 水 | 40 | 均匀 | 孔径 0.40 mm 变体（§9.10）
C12 | 1100 | 2.0 | 水 | 40 | 均匀 | 槽深 0.8 / 1.0 mm 变体（OPT-1）

### 10.8 收敛与后处理判据

项 | 判据
残差 | 连续性与动量 < 1e-4，能量 < 1e-6
监测量稳定 | Rθ,c-in 与 ΔP 连续 500 步漂移 < 0.5%
能量守恒 | 出入口焓差与总热源偏差 < 1%
质量守恒 | 进出口质量流偏差 < 0.1%
网格无关性 | 相邻网格 R 与 ΔP 差异 < 3%
模型不确定性 | 转捩 SST 与层流两模型差异须报告；若 > 20% 则结论只能给区间

#### 必须交付的后处理

- 壁温云图（余铜接触面），标出最高点坐标与两 die 中心温差；
- 流体温度云图与流线（含驻点与交叉流可视化）；
- 逐孔质量流量列表（216 行）与偏差统计；
- 沿程压力分段（入口→静压箱→孔口→槽→回液→出口）；
- 近壁速度云图，标出 HBM 区最大值；
- Rθ,c-in、ΔP、ΔTf 三个标量的汇总表（全工况）。

### 10.9 验证与确认（V&V）

层级 | 对比对象 | 可接受偏差 | 不达标怎么办
V1 代码验证 | 解析解（层流平板、圆管 f·Re） | < 2% | 换求解器或修正设置
V2 与一维对比 | §9 的 ΔTf（能量平衡） | < 2%（这是硬约束） | 能量不守恒，说明边界或热源加载错误
V3 与一维对比 | §9 的压降分段 | 孔口 < 20%；歧管以 CFD 为准 | 复核 K 值假设
V4 与文献对比 | Martin 阵列关联式（在其有效域内的算例） | < 15% | 先跑一个 Re = 3000 的算例落在有效域内做交叉验证
V5 与试验确认 | TTV 实测 Rθ,c-in | < 15% | 触发 §4.2 的 R2 回路，反标定模型

V4 是本项目特有的必要步骤。因为设计点 Re = 478 在关联式有效域之外，无法直接用文献校验。解决办法：额外跑一个 Re ≈ 3000 的算例（把流量临时提到有效域内），先证明 CFD 设置能复现 Martin 关联式，再用同一套设置外推到设计点。这一步不做，CFD 结果就没有可信度锚点。

### 10.10 仿真交付物清单

1. 仿真需求符合性矩阵（逐条对照 §10.1 Q1–Q8）；
2. 网格无关性研究报告（三套网格）；
3. 湍流模型敏感性报告（转捩 SST vs 层流）；
4. 全工况结果汇总表（§10.7 C01–C12）；
5. §10.8 的六类后处理图；
6. V&V 报告（§10.9 V1–V4，V5 待样件）；
7. 对 §9 一维模型的修正建议（哪个模型更接近真值、经验系数取值）；
8. 对 §8 几何的修改建议（孔径、槽深、歧管形状）。

## 11. 试验与验收

试验分三层：出厂检验（每件）、型式试验（首件 / 设计验证）、系统验收（装机后 SAT）。三层的判据不能互相替代。

### 11.1 出厂检验（100%）

# | 项目 | 方法 | 判据

1 | 外观与外形 | 目视 + 卡尺 | 95×75 ±0.15；无磕碰
2 | 接触面平面度与粗糙度 | 三坐标 / 轮廓仪 | 平面度 ≤0.05 mm；Ra ≤0.8 μm
3 | 密封性 | 氦质谱检漏 | 100% 检；3 bar 保压
4 | 流阻 | 水、40 °C 流量–压降曲线 | 2.0 L/min 下 ΔP ≤ 18 kPa
5 | 喷嘴通畅性 | 流量一致性或气流检查 | 无堵孔；总流量偏差 ≤ ±5%

### 11.2 型式试验（首件 / 设计验证）

# | 项目 | 方法 | 判据 | 对应设计目标

T1 | 热阻 | TTV 等效加热块（两块 25×25 mm 模拟双 die + 八块小加热块模拟 HBM），水 40 °C、2.0 L/min、1100 W | Rθ,c-in < 0.028 °C/W | §1.2 热-1
T2 | 均温性 | 两加热区温差 + 红外 | 两 die 中心温差 ≤ 5 K | §1.2 热-3
T3 | 驻点对位 | 红外热像 | 两驻点对准 die 中心；HBM 区无射流冷斑网格 | §5.2
T4 | 分区流量 | 分区流量计 | GPU : HBM = 80 : 20 ±10% | §1.2 水力-4
T5 | 包络工况 | 1400 W 仿真 + 试验校核 | R ≤ 0.025 °C/W；不写入首批保证 | §1.2 热-2
T6 | PG25 复测 | 同几何换工质 | 记录流量与热阻修正量（预期 h −29%） | §9.9
T7 | 耐久与堵塞 | 循环 + 颗粒注入 | 压差上升率可接受；无不可恢复堵塞 | §12
T8 | 压装影响 | 3 bar + 压装力下平面度与热阻复测 | 热阻变化 ≤ 5%；无永久变形 | §6.4

### 11.3 系统验收（SAT）

- 只验证本板落在 OEM 分流后的实际流量–压降点，以及该点下的壳温；
- 不得在冷板厂用 10 K 温升公式出系统报告；
- 整柜 25–45 °C ↔ 59–177 L/min 是机柜表，单板指标由托盘分流决定，必须实测。

在输入未闭合前可以做的事：按 §8 几何出 1:1 铜样和透明流道样（PMMA 盖板），用两块 25×25 mm 加热块模拟双 die、八块小加热块模拟 HBM，先把热阻量级、流量分配与可制造性打通。透明样件可以直接用 PIV 或染色法验证 §9.5 的流动拓扑争议（cell 还是 bank），成本远低于 CFD。

## 12. 风险登记册

等级 = 影响 × 概率。红需在 DR3 前关闭，橙需有缓解措施并监控。

编号 | 风险 | 影响 | 概率 | 等级 | 缓解措施 | 责任阶段
RK-01 | 热阻真值落在保守端，DP-A 无法达标 | 高（产品不可交付） | 中 | 红 | ① CFD 收窄区间；② TIM2 升级到 ≤0.004；③ 孔径 0.50→0.40 mm；④ 必要时提流量 | DR3
RK-02 | 射流 Re = 478 在关联式有效域外，一维预测系统性偏差 | 高（设计依据不可靠） | 高 | 红 | §10.9 V4：额外跑 Re≈3000 算例做关联式锚定 | DR3
RK-03 | HBM 实际为 12 组（§2.3 口径冲突） | 中（HBM 区须重画） | 低 | 橙 | 以电气宽度 8192-bit 判定为 8 组；索取 OEM 封装图确认 | DR0 / C-02
RK-04 | 喷嘴堵塞 | 高（热点失守） | 中 | 橙 | 孔径取 0.50 mm（非更小）；系统过滤 ≤25 μm；跨板压差监测；结构预留拆芯凸台 | 设计 + 运维
RK-05 | 钎料流入 0.40 mm 槽造成堵塞 | 高（整板报废） | 中 | 橙 | 钎料做成空心框、远离细槽；X-ray / CT 抽检；焊后流阻筛查 | 工艺
RK-06 | 交叉流把下游驻点吹偏 | 中（均温变差） | 中 | 橙 | 短槽 L≤8 mm + 回液缝错排；CFD Q5 验证 | DR3
RK-07 | 压装偏载传到 HBM 焊球 | 高（芯片损伤） | 低 | 橙 | 隔离肋参与承载并与加强环对位；HBM 区压强低于 GPU 区；ICD 明确压装力 | DR3 / ICD
RK-08 | PG25 性能损失比预期大（实算 −29%） | 中（需重定流量） | 中（若项目选 PG25） | 橙 | §9.9 已量化；PG25 单独定流量并重做 CFD（C08/C09） | DR3 / 商务
RK-09 | 单板流量与设计值不符（托盘分流） | 中 | 中 | 橙 | 设计按 2.0 L/min 并给 1.6/2.4 敏感性；SAT 实测确认 | SAT
RK-10 | 槽深 1.5 mm 存在低速死体积（OPT-1） | 低（性能与重量略损） | 高 | 黄 | CFD C12 扫槽深 0.8/1.0/1.5；DR3 决定是否改厚度链 | DR3
RK-11 | 失冷（断流）导致超温 | 高 | 低 | 橙 | 不承诺保证秒数；行业经验约 90 s 仅作参考，非 NVIDIA 官方指标；由系统侧冗余保障 | 系统

## 13. 开放项：开模 / 送样前必须关闭

编号 | 项 | 当前状态 | 关闭条件 | 关闭前的影响 | 门
C-01 | B300 封装外形、螺钉位、TIM 窗、die 坐标 | 缺失 | OEM 封装图或 SXM ICD | §8.1 全部坐标为候选，图纸不能投产 | DR0
C-02 | 官方热图（两 die + HBM 功率分布、堆叠数） | 缺失 | NVIDIA / OEM power map | AS-1/2/3/5 无法替换；CFD 热源只能用假设分布 | DR0
C-03 | 单板额定流量与压降窗 | 缺失 | 托盘分流计算 + 机柜表 | 2.0 L/min 为候选；所有性能结论随之浮动 | DR0
C-04 | UQD 型号、水嘴方向、压装力 | 缺失 | 订单 ICD | §6.4 载荷路径与 §8 水嘴位置不能定稿 | DR1
C-05 | 工质（DI 水 vs PG25）与缓蚀方案 | 待商务 | 订单 | 若选 PG25 需按 §9.9 重定流量 | DR2
C-06 | 保证点写 1100 还是兼 1400 | 待商务 | 商务决策 | 本设计默认只保证 1100 W | DR2
C-07 | 共轭 CFD 完成并达标 | 未做 | §10 全部交付物 + V&V 通过 | 热性能不判定，不得开量产模具 | DR3
C-08 | TIM2 选型与实测面积热阻 | 缺失 | TIM 供应商样品实测 | §9.11 显示 TIM2 决定能否达标 | DR3
C-09 | 首件 TTV 实测热阻 | 未做 | §11.2 T1–T4 通过 | 无实测锚点，模型不确定性无法消除 | DR4
C-10 | 正式 FTO（自由实施）检索 | 仅初筛 | 对 Intel DLMJ、US12029008B2、US10244654、CN111328245B、CN113871359A、WO2026103052A1 等做权利要求对照 | 存在侵权风险，不能量产 | DR3
OPT-1 | GPU 槽深优化（1.5 → 0.8–1.0 mm） | 已识别 | CFD C12 结果 | 当前保留 1.5 mm 以保图纸自洽 | DR3

C-01 至 C-03 是三块地基。它们不闭合，本报告的几何与性能结论就只能是候选方案。但这不意味着现在什么都做不了 —— 见 §11.3 的注：1:1 铜样 + 透明流道样 + TTV 加热块可以在输入闭合前把方案的物理可行性、流量分配和可制造性全部打通。

## 14. 来源、局限与版本

### 14.1 一次来源（官方）

1. NVIDIA，Inside NVIDIA Blackwell Ultra: The Chip Powering the AI Factory Era，NVIDIA Technical Blog。双 reticle die、NV-HBI 10 TB/s、208B 晶体管、TSMC 4NP、160 SM / 8 GPC / 640 第五代 Tensor Core、288 GB HBM3E / 8 TB/s、八组 12-Hi 堆叠 + 16×512-bit 控制器（8192-bit）、NVLink 5 1.8 TB/s、NVLink-C2C 900 GB/s、PCIe Gen6 ×16、最大 TGP up to 1400 W；Grace Blackwell Ultra 超级芯片 1 CPU + 2 GPU、1 TB 统一内存。注：该文末尾有 HBM 堆叠数更正声明，见 §2.3 辨析。
2. NVIDIA，GB300 NVL72 产品页与 Blackwell Ultra Datasheet。72 GPU + 36 Grace、2592 Arm Neoverse V2 核、NVLink 130 TB/s、快速内存 37 TB、GPU 内存 20 TB / 最高 576 TB/s、CPU 内存 17 TB LPDDR5X、FP4 1440 PFLOPS（稀疏）/ 1080 PFLOPS（稠密）、1.44 exaFLOPS、全液冷机架级架构；数据手册另有 279 GB HBM3E 口径。
3. Lenovo Press LP2357。B300 SXM DLC TGP 1100 W；GB300 NVL72 135 kW TDP / 155 kW EDP；Table 27 温度–流量–压降对应表（25–45 °C ↔ 59–177 L/min，16–127 kPa）；HBM 288 GB / 7.7 TB/s（该页口径）。

### 14.2 本仓库上游文件

1. 《NVIDIA GB300 NVL72 冷却系统总体设计报告 v2.2》—— 整柜热负荷、液风分担、机柜水力口径。
2. 《AI 算力芯片液冷冷板专利分析报告 v1.4》—— 方案 A 权项结构（GPU 射流 / HBM 禁射流 / 隔离肋 / 压降窗）、已公开杂交架构清单与规避要点、加工工艺三分流。
3. 《AI 算力芯片液冷冷板技术调查分析报告 v1.3》—— 射流三区、H/D 与 S/D 设计窗、微通道强化综述、行业热阻标尺。

### 14.3 关联式与文献

1. Martin, H. (1977), Heat and Mass Transfer between Impinging Gas Jets and Solid Surfaces, Advances in Heat Transfer. —— 圆孔阵列面平均换热关联式，本报告模型 B。有效域 2000 ≤ Re ≤ 10⁵。
2. Shah, R.K. & London, A.L., Laminar Flow Forced Convection in Ducts. —— 矩形通道层流 f·Re 与 Nu，本报告模型 C。
3. Hussain et al., Energies 2021 —— 射流三区与 H/D 影响（图 5-4、5-5 原图来源）。
4. SciOpen 2025 微通道强化换热综述 —— 盖板 + 微通道封合结构（图 6-2 原图来源）。
5. arXiv:2604.10941 —— GB200 模组非均匀热图（图 2-2 原图来源）。
6. OCP / Meta 公开资料 —— TIM2 面积热阻 0.1–0.2 °C·cm²/W。

### 14.4 局限声明

一、输入局限。B300 封装坐标、官方 power map、单板 ICD 流量三项均未获得。§2.5、§8.1 的几何与 §9 的计算是候选设计，用于评审和打样，不能直接作为采购保证。

二、模型局限。设计点射流 ReD = 478 低于 Martin 1977 下限 2000，模型 B 不采用。壳–进液只用短槽模型，R_conv = 0.0252 °C/W。本报告因此不给出由 Martin 外推的热阻单值。

三、状态局限。三维仿真未做，样件未做，FTO 仅初筛。本文件不是 NVIDIA / Lenovo 订单 ICD，不是 FAT 保证书，不构成侵权风险结论。

### 14.5 版本变更记录

版本 | 日期 | 主要变更
v1.0 / v1.1 | 2026-09-13 | 首版。提出分区杂交方案、几何候选、0 维估算与图纸清单。
v2.0 | 2026-09-14 | 结构重构 + 数值修正版：① 按设计目标 / 芯片规格 / 设计输入 / 设计流程 / 性能设计 / 机械设计 / 原理图 / 详细设计 / 一维计算 / 三维仿真需求 重新编排，消除 v1.x 中“工作原理”与第 3、6、7 章的大量重复；② 修复全部图片失效（v1.x 在 design/ 下引用 assets/ 但该目录只存在于 patent/）；③ 全部工程图改为按毫米真比例的矢量图，含尺寸标注、标题栏、剖切符号、三视图、爆炸图；④ 数值全部由脚本生成（calc/model.py），消除手抄不一致；⑤ 纠正槽内流动拓扑错误：v1.x 的 bank 模型（0.74 m/s）与射流冲击不自洽，改为 cell 模型并说明槽是肋而非导管（§9.5）；⑥ 指出 Re 低于关联式有效域，热阻改为给区间而非单值，结论由“可行”改为“方案通过、性能待证”（§9.4）；⑦ PG25 损失由假设 15% 修正为实算 29%（§9.9）；⑧ 新增尺寸链闭合校核、机械承压校核、孔径敏感性、差距闭合矩阵、CFD 需求规格书、风险登记册；⑨ 新增 HBM 堆叠数（8 vs 12）口径辨析（§2.3）。

## 附录 符号表与复算说明

### A 符号表

符号 | 含义 | 单位 | 本设计取值 / 来源
P | 芯片功率（TGP） | W | 1100（DP-A）/ 1400（DP-B）
Q | 体积流量 | L·min⁻¹ | 2.0 / 2.4
ṁ | 质量流量 | kg·s⁻¹ | 0.0331
D | 喷嘴孔径 | mm | 0.50
Sx × Sy | 喷嘴节距（沿 27 mm × 沿 28 mm） | mm | 3.0 × 2.4
H | 喷距（孔板到靶面） | mm | 2.0
N | 喷嘴总数 | — | 216（每 die 108）
f | 相对喷嘴面积 (πD²/4)/(Sx·Sy) | — | 0.02727
Dh | 水力直径 | mm | GPU 槽 0.6316；HBM 槽 0.857
ReD | 孔雷诺数 ρVD/μ | — | 478（DP-A）
Pr | 普朗特数 μcp/k | — | 水 4.32；PG25 9.92
Nu | 努塞尔数 hD/k 或 hDh/k | — | 见 §9.4
h | 对流换热系数 | W·m⁻²K⁻¹ | 见 §9.4 三模型
ηf | 肋效率 tanh(mL)/mL | — | 0.948
Rθ,c-in | 壳–进液热阻 | °C/W | 0.0326 – 0.0366
Rpkg | 封装内热阻（硅+TIM1+盖） | °C/W | 0.008–0.012（假设）
RTIM2 | TIM2 热阻 | °C/W | 0.004–0.008（假设）
Tf / Tw / Tj | 流体 / 壁面 / 结温 | °C | 见 §7.3
ΔTf | 流体混合温升 | K | 7.96（DP-A）
ΔP | 压降 | kPa | 板内 3.5–5.5
K | 孔口局部阻力系数 | — | 1.8
q″ | 热流密度 | W·cm⁻² | die 面均 56.7（DP-A）
kCu | 铜导热率 | W·m⁻¹K⁻¹ | 390

### B 复算与再生成

文件 | 作用
calc/model.py | 唯一数值来源：物性、几何、关联式、工况求解
calc/cp_b300_1d.py | 一维计算书，输出 cp_b300_1d_out.txt
calc/svg.py | SVG 原语：工程尺寸标注、剖面填充、等轴测投影
calc/figures.py | 详细设计图纸（三视图 / 流道 / 剖面 / 单元 / 孔位 / 3D / 爆炸）
calc/figures2.py | 原理图、流程图与数据图
calc/report_a.py / report_b.py | 报告正文章节
calc/build_report.py | 装配并输出本 HTML 文件

复算命令：
cd design/calc
set PYTHONIOENCODING=utf-8
python cp_b300_1d.py > cp_b300_1d_out.txt （生成计算书）
python build_report.py （重新生成本报告）

改变 model.py 中的几何或设计点后重新运行，报告全文数值、表格与图形会同步更新 —— 不存在需要手工同步的数字。

AIDC-B300-CP-HYB-002 · NVIDIA B300 微通道+冲击换热冷板设计报告 v2.0 · 2026-09-14
型号 CP-B300-JM-01 | 保证点 DP-A 1100 W | 包络 DP-B 1400 W | 与 GB300 NVL72 总体设计 v2.2 水力口径一致
本文件为内部设计评审文档，非 NVIDIA / Lenovo 订单 ICD，非 FAT 保证书。 几何与性能结论在 C-01～C-03、C-07 关闭前均为候选。
数值可复算：design/calc/cp_b300_1d.py； 报告可再生成：design/calc/build_report.py。
