bruce2012lu/AIDCtms_design202609/Bp/算力冷却商业调研报告_v3.2_演示版_20260905.pptx

Commercial Research Report · 演示版 / 20260905

算力冷却商业调研报告

高密 AI 基础设施液冷：需求、算力基建投资、液冷占比、
工程边界、竞争、准入、项目池与验证期权

本报告不构成证券投资建议、产品认证或采购承诺。总体结论 valid_until 2026-11-30；
第 2.6 / 2.7 章（投资与占比）valid_until 2027-02-28。本演示稿不修改任何既有报告与 BP 文件。

接近 30 → 约 70 亿美元

Dell'Oro 全球液冷设备制造商收入
2025 机构估计 → 2029 机构预测；TAM 主锚

0.3%–0.9% ／ 5%–11%

液冷设备收入占算力基建总投资 ／ 占 DCPI 设备市场
2025–2032；分母不同则量级完全不同

SAM 24m = 无数据

公开项目尚未同时闭环电力、融资、开工、
平台、服务与有效价格

版本：v3.2 Evidence-led

数据截止日：2026-08-22

演示日期：2026-09-05

研究范围：中国、东南亚、中东及全球对标

主边界：液冷设备制造商收入 / 项目级 CDU

配套 BP：《算力冷却系统新业务BP》v2.1_20260822

机密 · 仅供董事会与核心团队讨论

## Slide 2

结论先行

需求方向成立，但可得份额、价格、责任与现金回报尚未验证

当前证据只支持「受客户、工程、责任与现金门禁约束的小规模验证期权」，不支持按行业 CAGR 批准量产扩张。
报告第一层结论共六条，每条均标注置信度与失效条件；下方为原文裁决，未作增补或改写。

需求方向强，口径不可相加

设备、整机、宽产业是不同分母，任何两项不得相加

置信度 / valid_until：0.92 / 2027-01-31

1

工程壁垒是平台级适配

铭牌冷量不能证明平台兼容；水力、材料、冗余与故障态共同决定可用性

置信度 / valid_until：0.94 / 2026-11-30

2

竞争全栈化，增长不保证高毛利

全球服务、流体管理与责任承担成为壁垒；扩产爬坡与标准化压缩利润

置信度 / valid_until：0.90 / 2026-11-15

3

公开招标不能验证单位经济

无合格裸机成交价、四 SKU BOM 或故障成本：ASP、毛利、ROIC 均为无数据

置信度 / valid_until：0.96 / 正式合同发布即复核

4

液冷在算力投资中价值占比极低，且高度依赖分母

占总投资长期不到 1%，占设施侧约 1%–6%，占 DCPI 约 5%–11%

置信度 / valid_until：相对量级 0.80；任一点值 0.35 / 2027-02-28

算力冷却商业调研报告 · v3.2 Evidence-led · 数据截止 2026-08-22

5

最优策略是验证期权

只对已获电在建项目、付费 PoC 与可封顶责任释放资金，可限制下行损失

置信度 / valid_until：0.88 / 2026-12-31

机密 · 仅供董事会与核心团队

6

2

## Slide 3

阅读须知（一）

两套独立标签体系：来源等级决定证据力，数据性质决定这个数字是什么

全文每个数字都同时带来源等级与数据性质；机构端点、本报告桥接与本报告情景必须能被一眼区分。
「无数据」是一种裁决结果，不是遗漏 —— 报告中共有 SAM/SOM、ASP、毛利、ROIC、CDU 能力矩阵等多处保持无数据。


算力冷却商业调研报告 · v3.2 Evidence-led · 数据截止 2026-08-22

机密 · 仅供董事会与核心团队

3

## Slide 4

阅读须知（二）

口径纪律：不同分母不可相加、不可相减、不可用于计算份额

五层口径互不重叠，包含关系为：液冷设备市场 ⊂ DCPI 热管理 ⊂ DCPI ⊂ L1 ⊂ L3；L2 ⊂ L3；L1 ∩ L2 = ∅。
投资层级 L1 / L2 / L3 自 v3.2 起专指算力基建投资分层，与来源等级（一级/二级/三级）是两套独立编号。

口径 | 定义 | 用途 | 禁止事项
设备 TAM | 冷板、CDU、歧管、快接、浸没、RDHx 等制造商收入 | 全球市场主锚 | 不得与服务器整机或宽产业相加
算力基建投资 L1／L2／L3 | 设施侧 CapEx／IT 设备投资／两者之和 | 液冷占比的分母分层 | 不得与设备 TAM 相加；不得换算为公司收入
项目池 SAM | 24 个月内、五道项目门均闭环且可服务的项目收入 | 公司可服务市场 | 不得以公告 MW 或服务器台数代替
SOM | 合格项目中经 qualification、订单、交付、服务与回款约束后的可获收入 | 公司预算 | 不得用 TAM × 目标份额
单位经济 | 从净收入扣除完全项目成本并考虑现金占用 | 量产门禁 | 无报价、合同和试制数据时不得填点值

① 不可相加

设备制造商收入、服务器整机、宽产业、总用电、容量 GW 是不同分母

② 不可相减

需求 219 GW 与供给 200 GW 之差、全液冷 70 亿与 DLC 58 亿之差都不是可交付订单或路线规模

③ 不可算份额

任何「公司收入 ÷ 上述某一行」得到的比例都不具备可比性，不得进入董事会材料

算力冷却商业调研报告 · v3.2 Evidence-led · 数据截止 2026-08-22

机密 · 仅供董事会与核心团队

4

## Slide 5

市场篇（一）

需求方向没有争议：用电五年翻倍、容量需求五年增 1.7 倍，但三条曲线分母不同

2025 → 2030 机构端点：用电 485 → 950 TWh（IEA）；关键 IT 需求 82 → 219 GW（McKinsey）；设施供给 103 → 200 GW（JLL）。
需求 219 GW 高于供给 200 GW 不等于订单缺口：两者定义、基准、时点、占用与可交付性不同，不可相减。


算力冷却商业调研报告 · v3.2 Evidence-led · 数据截止 2026-08-22

机密 · 仅供董事会与核心团队

5

## Slide 6

市场篇（二）

机柜功率密度在一代内从 66 kW 跃到 264 kW —— 风冷延寿空间被物理压缩

Dell'Oro 称「1 MW 机柜正在临近」；NVIDIA Rubin 路线称 100% 液冷，Vera Rubin 计算托盘取消风扇。
但铭牌功率不是采购依据：Supermicro 250 kW 与 Dell 264 kW 分别是方案移热能力与特定配置最高值，口径不同。


算力冷却商业调研报告 · v3.2 Evidence-led · 数据截止 2026-08-22

机密 · 仅供董事会与核心团队

6

## Slide 7

市场篇（三）

真正约束液冷需求的不是规划容量，而是每年实际投运的 10–28 GW

JLL：2025 年 57% 项目延迟至少 3 个月，主要市场并网平均等待超过 4 年；C&W：全球大负荷平均供电周期 4.4 年。
管理动作：在建与规划 pipeline 不计入当年投运，也不计入任何 SAM；项目预算只跟随已获电、已开工、平台已冻结的批次。


逐年投运量无任何机构发布 —— 全部为本报告由 JLL 累计端点桥接的模型值。

算力冷却商业调研报告 · v3.2 Evidence-led · 数据截止 2026-08-22

机密 · 仅供董事会与核心团队

7

## Slide 8

市场篇（四）

AI 占存量容量约 25% → 50%，但占新增容量高达 76% —— 两个分母差一倍

v3.1 曾把存量份额当作新增份额使用；v3.2 已在表 2.5.2 列名中标明「存量口径」，并单列 65%–82% 的新增份额序列。
这一区分直接决定自下而上模型的 IT 腿：用错分母会把液冷相关容量低估近一半。


算力冷却商业调研报告 · v3.2 Evidence-led · 数据截止 2026-08-22

机密 · 仅供董事会与核心团队

8

## Slide 9

市场篇（五）

算力基建总投资 2025 年约 6,500–8,050 亿美元，2030 年约 1.64–2.05 万亿美元

先分层再谈占比：不同机构所称的「数据中心投资」相差十倍以上，主因是层级不同而非数据冲突。
使用边界（强制）：本序列仅用于外部市场锚定与情景分析，不得换算为公司收入预算、SAM/SOM、产能规划、ASP 或毛利率。


confidence 0.72 / valid_until 2027-02-28　·　机构只发布累计口径，全部年度序列为本报告模型

算力冷却商业调研报告 · v3.2 Evidence-led · 数据截止 2026-08-22

机密 · 仅供董事会与核心团队

9

## Slide 10

市场篇（六）

两条独立路径交叉验证后的裁决：McKinsey 6.7 万亿基准情景已过时，改用加速情景

路径 B 的 IT 腿自下而上低估约 36%（容量法 2,040 亿 vs IDC 实测 3,180 亿），四项原因逐条披露，不取平均掩盖。
处置：L1 以路径 B 为主锚（设施侧有 JLL、Epoch AI、Turner & Townsend 三个独立每 MW 证据），L2 以 IDC 实测为主锚。


反向风险：加速情景依赖 AI 投资回报持续被市场接受；若 2027 年融资收紧，实际路径可能快速回落到 A-基准甚至 A-受限。

算力冷却商业调研报告 · v3.2 Evidence-led · 数据截止 2026-08-22

机密 · 仅供董事会与核心团队

10

## Slide 11

市场篇（七）

四大厂商 CapEx 只作旁证：它证伪了基准情景，但不能除以 L3 得「份额」

四家使用三种不同 CapEx 定义，含办公、网络骨干、自研芯片预付等非数据中心支出，与全球 L3 口径不同。
四家之外还有 Oracle、xAI、CoreWeave、字节、阿里、腾讯与主权 AI 项目等大量投资主体，因此该表不得相加进 L3。


算力冷却商业调研报告 · v3.2 Evidence-led · 数据截止 2026-08-22

机密 · 仅供董事会与核心团队

11

## Slide 12

市场篇（八）

液冷设备市场：2029 年约 70 亿美元合理，但整条曲线只有两个机构端点

三重合理性校验（宏观占比、容量强度、机柜强度）均通过量级检查，但都不能独立闭环 —— 只能作异常检查。
董事会外部 TAM 采用 2032 年 90–140 亿美元（本报告模型），Base 约 115 亿；不是机构预测、不是 CDU SAM/SOM、不是公司可得收入。


invalidate_if：Dell'Oro 新版偏离 2029 年 60–80 亿美元；2027–2028 已获电投运或 AI 液冷采用显著落后；设备价格年降幅 >15% 且瓦数/配置不能抵消。

算力冷却商业调研报告 · v3.2 Evidence-led · 数据截止 2026-08-22

机密 · 仅供董事会与核心团队

12

## Slide 13

市场篇（九）

Dell'Oro 的四个版本必须隔离：70 − 58 = 12 不是浸没与 RDHx 的规模

这是本报告最关键的方法论纪律之一：三个数字分属三个发布版本、三个边界，底层逐年表与方法为付费内容，不可见。
禁止：母子精确拆分、跨版本相减、连成连续年度曲线、拼成一条占比序列。新版发布即重设端点。


算力冷却商业调研报告 · v3.2 Evidence-led · 数据截止 2026-08-22

机密 · 仅供董事会与核心团队

13

## Slide 14

市场篇（十）

液冷占比取决于分母，同一年三个比例相差约 30 倍

同一个分子（液冷设备制造商收入），换三个分母：占 L3 约 0.3%–0.9%，占 L1 约 1.3%–5.6%，占 DCPI 约 5%–11%。
任何引用必须同时写出分母层级与来源版本。只写「液冷约占 10%」或「液冷不到 1%」都是误导。


相对量级 confidence 0.80；任一年份的任一点值 confidence 0.35 —— 禁止点值引用。

算力冷却商业调研报告 · v3.2 Evidence-led · 数据截止 2026-08-22

机密 · 仅供董事会与核心团队

14

## Slide 15

市场篇（十一）

同一个分子、同一年，换 Dell'Oro 的版本就从 10%–13% 变成 5%–8%

变化几乎全部来自 Dell'Oro 扩大 DCPI 边界并上调预测，不是液冷竞争地位下降。
v3.1 正文的「2029 液冷约占旧版 DCPI 631 亿美元的 10%–13%」仍然正确 —— 但只在旧版口径下正确。


算力冷却商业调研报告 · v3.2 Evidence-led · 数据截止 2026-08-22

机密 · 仅供董事会与核心团队

15

## Slide 16

市场篇（十二）

三组占比各自回答不同的问题 —— 只有组③ 可以谈「份额」

引用任何一个占比时必须同时写出分母层级与发布版本，否则读者会把两个正确数字当成互相矛盾。
占比高低与新进入者的可得份额之间没有因果关系；分母是全球所有制造商的收入。

组 / 分母 | 结果 | 适用：回答什么问题 | 不适用：不能回答什么
① L3 算力基建总投资（最宽） | 0.3%–0.9% | 在整个 AI 算力投资盘子里，独立液冷设备的价值占多少。适用于向董事会解释「AI 投资巨大」与「液冷可得收入有限」之间的落差 | 不适用于评估液冷业务的相对增长性或竞争地位：分母中约 75%–85% 是 IT 设备，与液冷供应商无任何竞争或替代关系
② L1 设施侧 CapEx（中等） | 1.3%–5.6% | 在数据中心设施建设的每一元里，液冷设备制造商拿到多少。适用于与 EPC、机电总包、配电、UPS 等设施侧品类做相对规模比较 | 不适用于推导单个项目的液冷成本占比：L1 是全球混合平均，含大量风冷与非 AI 项目；单个高密 AI 项目的液冷占比远高于此
③ DCPI 设备市场（最窄、最可比） | 5%–11% | 液冷在物理基础设施设备制造商收入中的结构性权重与趋势。同一机构、同一收入确认规则，液冷是 DCPI 热管理的子集，是三组中唯一可以谈「份额」的分母 | 不适用于推导公司可得份额：分母已被 Ecolab/CoolIT、Eaton/Boyd、Schneider/Motivair、Vertiv、Modine 及各 OEM 自供占据

极差约 30 倍：2032 年 0.4%（组①下界）对 11%（组③上界）；2025 年 0.3% 对 9%。
用组③ 的量级去论证组① 的商业空间，会把可得市场高估一个量级以上。

算力冷却商业调研报告 · v3.2 Evidence-led · 数据截止 2026-08-22

机密 · 仅供董事会与核心团队

16

## Slide 17

市场篇（十三）

设施侧「液冷投入」是设备制造商收入的 5–6 倍 —— 差额被 EPC 与安装截留

这解释了工程口径与市场口径的表面矛盾：「液冷占 AI 机房造价 15%–33%」是项目造价科目，与本报告的 1%–6% 不在同一分母。
对本业务的含义：能进入独立设备供应商可争夺池子的，只有右侧那一段。


算力冷却商业调研报告 · v3.2 Evidence-led · 数据截止 2026-08-22

机密 · 仅供董事会与核心团队

17

## Slide 18

市场篇（十四）

占比不是稳定参数：四项推高、四项压低、一项方向不确定

2030 年组①、组② 同时出现台阶，主要来自 Dell'Oro 新版 DLC「超过 80 亿美元」造成的预测版本跳点，不解释为有机改善。
其中「OEM/ODM 垂直整合」与「设施侧 EPC 吃掉价值」两项对独立供应商的杀伤最直接。


算力冷却商业调研报告 · v3.2 Evidence-led · 数据截止 2026-08-22

机密 · 仅供董事会与核心团队

18

## Slide 19

技术与格局篇（一）

技术路线按成熟度三分：只有第一层已产品化，后两层不给性能点值

主边界是冷板式直接液冷（CDU、冷板、Manifold、UQD、工质、二次管路、控制、安装调试与流体运维）。
浸没、两相与设施侧冷源只作相邻路线比较，不进入本报告的收入分母。


算力冷却商业调研报告 · v3.2 Evidence-led · 数据截止 2026-08-22

机密 · 仅供董事会与核心团队

19

## Slide 20

技术与格局篇（二）

平台工程基线：铭牌冷量不能证明兼容，五项参数必须同时校核

只记录同一版本、同一回路可比较的数据；公开未披露即写「无数据」，不得用其他 OEM 参数替代。
选型须同时校核：IT 功率 · HCR/液体热负荷 · TCS/FWS 温度与工质 · Q–ΔP · 冗余与故障态。

平台 / 版本 | IT 功率 | 液体负荷 / HCR | TCS 温度 / 工质 | 工程裁决
Lenovo GB300 NVL72 2026-08-13 update | 135 kW TDP 155 kW peak | 约 90%；121.5–139.5 kW 为本报告推导 | 供液 25–45℃；DI water 或 PG25；回液无数据 | 当前最完整的一柜曲线； 项目须确认曲线对应工质
Lenovo N1380 / SC750 V4 | 54 kW / enclosure 三套 162 kW DC | 量热保证无数据；公开架构 称接近全水冷 | 供液 27/32/40/45℃； 处理洁净水；回液无数据 | 流量可加，支路压降不可 相加；HCR 保留条件
Huawei Atlas 900 A3 | 计算柜最大 66 kW | 约 70%，随配置；46.2 kW 仅为本报告粗算 | 液冷门供液 5–32℃； 纯水或 EG50；回液无数据 | 液冷门回路与计算柜 D2C 回路不得拼接
HPE GB200 NVL72 v4 | 132 kW / rack | 115 kW liquid + 17 kW air | 公开摘要无数据 | 液体负荷可用，水力须取 site readiness 包
Dell IR7000 + XE8712 | 特定配置最高 264 kW / rack | HCR / 液体 kW 无数据 | 28/32/36/40℃； Dell validated PG25 | 504 kW 是供电/busbar 生态 能力，非本配置液体负荷

NVIDIA DGX GB200（约 120 kW/rack）、Supermicro DLC-2（方案能力最高 250 kW，非固定 IT 铭牌）与 NVIDIA Rubin（原厂路线称 100% 液冷，固定 rack kW 未披露）三项关键字段为无数据，不承诺任何容量档覆盖柜数。
来源：Lenovo GB300 Product Guide Table 27；N1380 Configuration Guide Tables 1–4；Atlas 900 A3 技术规格；Dell Rack-Scale DLC Guidelines pp.4–5, 18–19。报告表 3.1。

算力冷却商业调研报告 · v3.2 Evidence-led · 数据截止 2026-08-22

机密 · 仅供董事会与核心团队

20

## Slide 21

技术与格局篇（三）

供液温度从 25℃ 升到 45℃：流量约 3 倍，压降约 8 倍

这是当前公开资料中最完整的一柜 Q–ΔP 曲线，也是「铭牌冷量不能证明兼容」最直观的证据。
项目必须确认曲线对应的工质（DI water 或 PG25）；不同 OEM 的流量与压降不可互相套用，支路压降不可相加。


算力冷却商业调研报告 · v3.2 Evidence-led · 数据截止 2026-08-22

机密 · 仅供董事会与核心团队

21

## Slide 22

技术与格局篇（四）

CDU 卖的是可验证系统与责任闭环，不是铭牌 kW

有效冷量随 ATD、供回液温度、工质、泵故障态、海拔与污堵变化，必须以矩阵而非单点表述。
控制层（应用控制算法、状态机、故障降级、BMS/DCIM 接口、远程诊断）是本业务自留的高附加值环节。


算力冷却商业调研报告 · v3.2 Evidence-led · 数据截止 2026-08-22

机密 · 仅供董事会与核心团队

22

## Slide 23

技术与格局篇（五）

容量档不是兼容承诺：四档 × 四类工况的有效能力当前全部为无数据

这不是资料收集不足，而是尚无样机热性能与 PQ 矩阵；解锁条件是客户 RFQ 加样机实测，不是更多公开检索。
在矩阵填实之前，任何「我们的 300 kW CDU 支持某平台」的表述都不成立。


算力冷却商业调研报告 · v3.2 Evidence-led · 数据截止 2026-08-22

机密 · 仅供董事会与核心团队

23

## Slide 24

技术与格局篇（六）

竞争已全栈化：三笔并购把液冷装进了水处理、电力与预制模块的全栈组合里

壁垒已从设备转向全球服务、流体管理与责任承担；新进入者要面对的是组合方案，不是单机比价。
所有可比数字必须按四层严格分列，不以集团收入或集团毛利冒充液冷收入或毛利。


算力冷却商业调研报告 · v3.2 Evidence-led · 数据截止 2026-08-22

机密 · 仅供董事会与核心团队

24

## Slide 25

技术与格局篇（七）

唯一可用的纯液冷毛利实绩：冷板 10.36%，与浸没 36.49% 相差三倍

这是报告中仅有的、口径较纯的历史可比毛利证据，也是「增长不保证高毛利」的直接支撑。
不得据此推导任何其他公司的 CDU 毛利率：报告已删除通用毛利率点值，且公开证据不足以恢复。


算力冷却商业调研报告 · v3.2 Evidence-led · 数据截止 2026-08-22

机密 · 仅供董事会与核心团队

25

## Slide 26

技术与格局篇（八）

不存在公开可验证的统一 CDU 认证 —— 准入是逐项目的九步 qualification

NPN 是伙伴计划，NVIDIA-Certified Systems 面向整机；华为有公司级供应商体系，但未公开 Atlas CDU 完整名录。
营销材料只可写具体项目、具体平台、具体版本的 qualification 状态，不得写「已获大厂认证」。


算力冷却商业调研报告 · v3.2 Evidence-led · 数据截止 2026-08-22

机密 · 仅供董事会与核心团队

26

## Slide 27

商业篇（一）

把资本压在微笑曲线两端：中段的器件、基础软件与制造交给受控供应商

自留七项价值控制点：需求权、架构权、版本权、变更权、放行权、数据权、客户权。
外协不转移最终责任：ISO 9001 外部过程控制原则与产品质量法都要求本公司保留最终放行、品牌与客户责任。


算力冷却商业调研报告 · v3.2 Evidence-led · 数据截止 2026-08-22

机密 · 仅供董事会与核心团队

27

## Slide 28

商业篇（二）

商业三步走：2027 启动，800 / 1,200 / 1,500 万元是阶段上限而非承诺额度

阶段 2、3 是条件期权。只有订单、贡献、回款、可靠性与现金跑道同时达标才解锁，缺一即冻结。
外部投资增速与液冷占比上升均不构成解锁条件 —— 这是市场章节与资金章节之间的硬隔离。


算力冷却商业调研报告 · v3.2 Evidence-led · 数据截止 2026-08-22

机密 · 仅供董事会与核心团队

28

## Slide 29

商业篇（三）

行业 TAM 增长推导不出公司收入：中间横着五道项目门和六个断点

六个断点：分母、可交付、准入、价格、现金、模型。任何一个都足以让「TAM × 目标份额」失效。
SAM 24m 与 SOM 当前均为无数据 —— 不是 0，而是公开可核验的合格项目尚未闭环。


算力冷却商业调研报告 · v3.2 Evidence-led · 数据截止 2026-08-22

机密 · 仅供董事会与核心团队

29

## Slide 30

商业篇（四）

单位经济现在是一张空模型：填实它需要的是书面证据，不是更好的估计

100 / 200 / 300 / 450 kW 四个 SKU 的额定工况、ASP、贡献毛利、ROIC 与盈亏平衡当前全部为「无数据」。
「无数据」不得改成 0，不得用二手区间填空，不得用容量在四个 SKU 之间线性插值生成 ASP、BOM 或毛利。

字段 | 四个容量档（100 / 200 / 300 / 450 kW）当前状态 | 解锁所需证据
额定工况 / 流量 / 压差 / 工质 / 冗余 | 无数据 | 客户 RFQ + 样机性能矩阵
CDU 净 ASP | 变量 ASP100 / ASP200 / ASP300 / ASP450 | 同边界书面报价或订单；至少两个可比样本
BOM（泵、板换、阀、过滤/脱气、PLC/VFD、传感、钣金、管件、工质） | 询价中 | 每类至少两家书面报价，含 MOQ / 交期 / 质保 / 付款
制造与测试（装配、清洗、压力、气密、FAT、良率、返工） | 待实测 | 至少三批试制工时、一次通过率与返修记录
贡献毛利 / ROIC / 盈亏平衡 | 无数据 | 以上字段全部解锁后才计算

两条公式（报告 12.2）
CM_i = 净收入 − BOM − 制造/FAT − 安装/SAT − 物流/税/保险 − 渠道/EPC − 质保 − 坏账/LD
现金调整后贡献 = CM_i − 保函融资费用 − 营运资金成本

隔离条款
2.6 / 2.7 章的每 MW 投资强度是设施与 IT 的宏观造价包络，不得当作 CDU ASP 或部件价值。
现金模型按周计算，传统 CCC 只作摘要，不能替代里程碑现金流。

算力冷却商业调研报告 · v3.2 Evidence-led · 数据截止 2026-08-22

机密 · 仅供董事会与核心团队

30

## Slide 31

商业篇（五）

资金门禁 G0–G3：证据不到位，钱就不出去

每道门同时约束工程、商业、质量、责任、现金与组织六个维度，任一硬门未达即自动冻结。
阶段上限与外部 TAM 无关，不因市场情景上修而调整。


算力冷却商业调研报告 · v3.2 Evidence-led · 数据截止 2026-08-22

机密 · 仅供董事会与核心团队

31

## Slide 32

风险与结论（一）

五条反命题决定这笔投资是否成立 —— 每条都配有先行指标与自动动作

内部阈值是管理门禁，不代表行业事实，须由董事会、客户合同与试制数据持续校准。

风险 / 反命题 | 概率 / 影响 | 先行指标 | 内部阈值与自动动作
并网 / 施工延期 | 高 / 高 | 接电协议、NTP、施工里程碑 | 缺电力、开工、平台任两项：移出 24 个月 SAM
Hyperscaler CapEx 放缓 | 中 / 高 | 四大云厂商指引与资产减值；IDC AI 基础设施季度修正方向 | 连续两季显著下修：冻结二期扩产，并把 2.6 章情景切换到 A-基准 / A-受限
OEM 指定 / 垂直整合 | 高 / 高 | RFQ 中指定 CDU 或 AVL 的比例 | 多数目标项目排除独立供应商：转 ODM、部件或服务
价格降幅快于成本 | 高 / 高 | 同工况 RFQ / 合同价、完全成本 | 现金调整后贡献持续为负：停止扩产并重定价
重大漏液 / 失流 | 中 / 极高 | FAT/SAT 缺陷、现场告警、质保索赔 | 重大事件：停发货、隔离批次、8D 与保险通知

另有五条同等重要的反命题（报告第 11 章）：算力投资融资条件收紧、回款与营运资金、GPU 许可 / 项目合规、水 / PFAS / F-gas 约束、来源口径与版本漂移。
六条核心结论各自的 invalidate_if 与本表互为补充：结论 5 的失效条件为 IDC 连续两季下修 AI 支出、Dell'Oro 再次重划 DCPI 边界、JLL 单位建设成本转降。

算力冷却商业调研报告 · v3.2 Evidence-led · 数据截止 2026-08-22

机密 · 仅供董事会与核心团队

32

## Slide 33

风险与结论（二）

季度跟踪清单：先行指标一旦触发，模型与资金动作是预先约定的

跟踪的目的是让模型失效可被提前发现，而不是事后解释。新版发布即复核，禁止跨版本拼接序列。

跟踪对象 | 先行指标 | 频率 | 触发的模型 / 管理动作
投运晚于管线 | 获电、NTP、施工、延迟率、并网周期 | 季度 | 下调新增投运与改造；不把 announced MW 计入 SAM
AI 份额 / 密度偏低 | AI 服务器与整柜出货、平均液冷 kW、推理占比 | 季度 / 平台代际 | 下调采用率与价值 / MW
价格与垂直整合 | 同工况报价、OEM 指定率、制造商收入 ÷ 液冷 MW | 半年 | 区分瓦数增长与收入增长
来源边界漂移 | Dell'Oro、JLL、IEA、IDC、McKinsey 新版定义 | 新版即复核 | 禁止跨版本拼序列，重设端点并重估三组占比
公司侧证据 | 付费 PoC、同边界合同价、试制批次、DSO / 峰值资金 | 月度 / 每周现金 | 达标才解锁阶段 2/3；未达自动冻结招聘与非关键 CapEx

有效期与复核触发
总体结论 valid_until 2026-11-30；2.6 / 2.7 章 valid_until 2027-02-28。
并购方新季报、平台新 revision、正式招标合同、项目状态变化或重大可靠性事故将提前触发复核。

研究充分性
SUFFICIENT WITH LIMITATIONS —— 足以重写报告，不等于商业参数或量产可行性已验证。
继续泛搜不替代管理层线下取证。

算力冷却商业调研报告 · v3.2 Evidence-led · 数据截止 2026-08-22

机密 · 仅供董事会与核心团队

33

## Slide 34

风险与结论（三）

下一步不是扩大研究，而是取得七类线下书面证据 —— 在此之前保持无数据

本轮可批准：阶段 1 上限 800 万元内的架构、样机、付费 PoC、供应链 / NPI、软件 / IP 与责任验证。
本轮不可批准：无订单扩产、无 NRE 开发冷板专线、无限责任项目、按 TAM 份额倒推收入。

待线下取得的证据清单（报告 12.3）

1. 价格　至少两个同工况、同冗余、同质保的正式分项中标或合同价；预算与限价不替代
2. BOM　四 SKU 的泵、板换、UQD、PLC/VFD、阀件、过滤/脱气、钣金与工质，每类至少两家书面报价
3. 客户　至少两个 OEM/客户项目 qualification 包，确认 PoC 收费、周期、转量产、平台边界与独立 CDU 准入
4. 合同　至少一份 CDU/EPC 分包合同，含验收、付款、漏液/停机/数据损失、责任上限、保险、PBG 与质保
5. 项目池　逐项目补齐接电、融资、NTP、平台/BOM、柜数、投运批次与本地服务
6. 试制　至少三批工时、良率、FAT 一次通过率、返修、现场故障与质保成本数据
7. 投资口径　取得 Dell'Oro DCPI 与液冷付费报告的逐年表与边界说明、IDC 分项、JLL 地区/密度拆分

90 / 180 / 365 日行动（BP v2.1 第 14 章）

0–90 日　冻结阶段 1 URS、架构、BSW 边界、DVP 与 100/200 kW 样机计划；发四 SKU 统一 RFQ；G0 包
91–180 日　工程样机、MIL/SIL/HIL、性能矩阵、故障注入；制造商 NPI/FAI；至少一个付费 PoC
181–365 日　两台代表样机可靠性与客户 SAT；≥2 付费验证；两个同边界合同价；G1 决策

在 PPT 中保持「无数据」的项目

SAM 24m · SOM · CDU 净 ASP · 四 SKU BOM 与毛利 · 贡献毛利 / ROIC / 盈亏平衡 · CDU 有效能力矩阵（四档 × 四工况）· 现金跑道
已删除且不予恢复：市场份额、前五集中度、部件价值占比、通用毛利率、CDU 静态 ASP、SAM/SOM 亿元点值、固定 PUE 区间、MTBF 与「零外漏」。

最终裁决：购买一个「下行封顶、证据逐步解锁」的验证期权，而不是按行业 CAGR 批准量产扩张。

算力冷却商业调研报告 · v3.2 Evidence-led · 数据截止 2026-08-22

机密 · 仅供董事会与核心团队

34

## Slide 35

算力冷却商业调研报告 · v3.2 Evidence-led

演示版 / 20260905　·　数据截止 2026-08-22　·　配套《算力冷却系统新业务BP》v2.1_20260822

本演示稿由《算力冷却商业调研报告 v3.2》整理而成，全部数据取自该报告正文，未引入报告中没有的数字，
未恢复报告已删除的伪精确点值。所有图表为本演示稿自绘（matplotlib + python-pptx），不含任何来源不明的外部图片。
本材料不构成证券投资建议、产品认证或采购承诺。总体结论 valid_until 2026-11-30；投资与占比章节 valid_until 2027-02-28。

机密 · 仅供董事会与核心团队讨论

35
