bruce2012lu/AIDCtms_design202609/Bp/assets/ppt/README.md

# 算力冷却商业调研报告 v3.2 演示版 —— 制作说明

本目录存放演示稿的全部图片素材与生成脚本，便于日后逐张替换、复算或重排。

> v3.3 演示版（`make_charts_v33.py` / `make_ppt_v33.py`，39 页）在 v3.2 脚本之上叠加生成；其 2026-09-06 新增的三分母嵌套饼图 `c30_denominator_pies.png` 的数据来源与生成方式见 **第 8 节**。

| 项目 | 内容 |
| --- | --- |
| 主交付 | `../../算力冷却商业调研报告_v3.2_演示版_20260905.pptx`（35 页，16:9，约 7.9 MB） |
| 唯一数据源 | `../../算力冷却商业调研报告_v3.2_20260822.html` |
| 商业口径参照 | `../../算力冷却系统新业务BP_v2.1_20260822.html` |
| 演示日期 | 2026-09-05 ｜ 数据截止 2026-08-22 ｜ 机密 · 仅供董事会与核心团队 |
| 主色系 | `#0b2239` 深蓝主色 · `#175cd3` 强调蓝 · `#087a70` 强调绿 · `#b42318` 警示红 · `#9a6700` 提示琥珀 |

> **本目录不修改任何既有 HTML 报告与 BP 文件。** 演示稿的全部数字均取自 v3.2 报告正文，未引入报告中没有的数字，未恢复报告已删除的伪精确点值。

---

## 1. 环境与依赖

```
Python 3.13.8
python-pptx 1.0.2
matplotlib 3.9.3
Pillow（随 matplotlib 安装）
pywin32（仅 export_preview.py 需要，用于调 PowerPoint 导出预览图）
中文字体：Microsoft YaHei（matplotlib 已在脚本中显式设置，回退顺序 SimHei → DengXian）
```

安装（如缺失）：

```powershell
python -m pip install python-pptx matplotlib pillow pywin32
```

## 2. 如何重新生成

```powershell
cd D:\agents2026\agents2026\agents\AIDCtms\Bp\assets\ppt

python make_charts.py      # 1) 重新渲染全部 26 张 PNG（300 dpi）到本目录
python make_ppt.py         # 2) 重新生成 35 页 pptx 到上两级目录
python verify_ppt.py       # 3) 结构 / 字体 / 数值 / 嵌入 / 页脚 自动校验
python export_preview.py   # 4) 可选：调本机 PowerPoint 导出 _preview/ 逐页 PNG 供目检
```

只重做某一张图（示例：只重做三组分母那张）：

```powershell
python -c "import make_charts as m; m.c09()"
python make_ppt.py
```

`_preview/` 是验证产物，可随时删除，不影响交付。

## 3. 替换单张图片的方法

三种方式，任选其一：

1. **改脚本重渲染（推荐）**：编辑 `make_charts.py` 中对应的 `cNN()` 函数，跑 `python -c "import make_charts as m; m.cNN()"`，再跑 `make_ppt.py`。数据、图注、来源标注都在同一个函数里，改完自洽。
2. **直接换 PNG**：用同名文件覆盖本目录下的 PNG，再跑 `make_ppt.py`。`make_ppt.py` 按比例自适应缩放，宽高比不必完全一致；但**分辨率需 ≥ 幻灯片显示尺寸的 200 dpi**，否则 `verify_ppt.py` 会报 FAIL。
3. **在 PowerPoint 里替换**：右键图片 → 更改图片。此法不会回写到本目录，下次跑 `make_ppt.py` 会被覆盖，仅适合一次性微调。

## 4. 图表清单

命名规则 `cNN_<语义>.png`；「函数」列为 `make_charts.py` 中的生成函数名。全部为 **300 dpi 自绘图**，在幻灯片中的有效分辨率为 220–326 dpi。

### 4.1 数据图表（数值严格取自 v3.2 报告）

| 文件 | 函数 | 用于页 | 报告出处 | 数据性质 | 来源机构与版本 |
| --- | --- | --- | --- | --- | --- |
| `c01_power_capacity.png` | `c01` | 5 | 表 2.2、2.5.2 | 2025/2030 机构端点；2026–2029 本报告几何桥接；2031–2032 本报告情景 | IEA《Key Questions on Energy and AI》2026-04-16；McKinsey《AI power》2024-10-29 Exhibit 1；JLL《2026 Global Data Center Outlook》2026-01-06 |
| `c02_rack_power.png` | `c02` | 6 | 表 3.1 | 原厂正式规格（实绩性质，一级来源） | Lenovo GB300 Product Guide 2026-08-13 Table 27；Lenovo N1380 Configuration Guide Tables 1–4；Huawei Atlas 900 A3 技术规格；Dell Rack-Scale DLC Guidelines pp.4–5, 18–19；HPE / Supermicro / NVIDIA 公开资料 |
| `c03_new_commissioned.png` | `c03` | 7 | 表 2.5.2 | 全部年份为本报告模型（由 JLL 累计端点桥接）；2031–2032 为本报告情景 | JLL 2026-01-06；Cushman & Wakefield 2026-05-20 |
| `c04_ai_share.png` | `c04` | 8 | 表 2.5.2 备注、2.6.3、2.6.4 | 存量口径 2025/2030 为 JLL 机构估计/预测，其余为本报告模型；新增口径全部为本报告模型 | JLL《2026 Global Data Center Outlook》2026-01-06 |
| `c05_capex_layers.png` | `c05` | 9 | 表 2.6.5 | L1、L3、AI 占比全部为本报告模型；L2 的 AI 部分锚定 IDC 机构估计/预测 | JLL 单位建设成本 2026-01-06；Epoch AI TCO 模型 2026-05-14；IDC AI Infrastructure Tracker 2026 |
| `c06_path_ab.png` | `c06` | 10 | 表 2.6.6 | 路径 A 累计总额为 McKinsey 机构预测，年度分配为本报告模型；路径 B 全部为本报告模型 | McKinsey《The cost of compute》2025-04-28；IDC 2026；IEA《World Energy Investment 2026》2026-05 |
| `c07_lc_scenarios.png` | `c07` | 12 | 表 2.5.2、2.5.3 | 仅 2025 / 2029 Base 为 Dell'Oro 机构端点，其余全部为本报告模型 / 情景 | Dell'Oro《Liquid Cooling Advanced Research》摘要 2026-01-08；《January-2026 DCPI Forecast》2026-02-10 |
| `c08_delloro_versions.png` | `c08` | 13 | 表 2.5.3、台账 D01/G05/G06/K01 | 2024/2025 机构估计；2029/2030 机构预测 | Dell'Oro 2025-08-15 / 2026-01-08 / 2026-02-10 / 2026-08-19 公开摘要 |
| `c09_three_denominators.png` | `c09` | 14 | 表 2.7.2 | 全部八年、全部三组均为本报告模型 | Dell'Oro 2026-01-08 / 2026-08-19；分母见表 2.6.5 |
| `c10_version_sensitivity.png` | `c10` | 15 | 表 2.7.4 | 全部比例为本报告模型；分母端点为 Dell'Oro 三版机构预测 | Dell'Oro 2025-08-15 / 2026-02-10 / 2026-08-19 |
| `c11_facility_vs_manufacturer.png` | `c11` | 17 | 2.7.5 | 左侧单价经三级转述、只作量级检查；右侧为机构端点 + 本报告模型 | Turner & Townsend（三级转述）；Dell'Oro 2026-01-08 |
| `c12_qdp_curve.png` | `c12` | 21 | 表 3.1、台账 E01 | 原厂正式规格（一级来源） | Lenovo GB300 Product Guide, 2026-08-13, Table 27（valid_until 2026-11-30） |
| `c13_margin_evidence.png` | `c13` | 25 | 第 5 章 | 全部为已披露实绩 | 曙光数创 2025 年报「收入构成」；Modine 2026 年 6 月季度财报 |
| `c14_hyperscaler_capex.png` | `c14` | 11 | 表 2.6.7、台账 K08 | 2024/2025 实绩；2026 公司指引（机构预测性质） | Alphabet / Amazon / Microsoft / Meta 2026 年 7 月下旬财报与业绩会（经二级媒体汇总） |
| `c26_cdu_matrix_na.png` | `c26` | 23 | 表 3.2、12.2 公式 | 全部为「无数据」裁决 | 报告表 3.2；BP v2.1 表 7.2 |

### 4.2 概念示意图（自绘，无外部素材）

| 文件 | 函数 | 用于页 | 报告出处 |
| --- | --- | --- | --- |
| `c16_smile_curve.png` | `c16` | 27 | BP v2.1 第 3 章（OEM 微笑曲线与价值链控制点） |
| `c17_cdu_schematic.png` | `c17` | 22 | 报告第 3 章（表 3.1、3.2）与 12.2 模型公式 |
| `c18_roadmap.png` | `c18` | 28 | 报告「两页核心观点②」与第 9 章；BP v2.1 第 2、10、12 章 |
| `c19_tam_sam_som.png` | `c19` | 29 | 报告第 7 章与 12.2 模型公式 |
| `c20_evidence_pyramid.png` | `c20` | 3 | 报告 1.1、1.2 |
| `c21_qualification_chain.png` | `c21` | 26 | 报告第 4 章（4.1、4.2、4.3） |
| `c22_gates.png` | `c22` | 31 | 报告第 9 章；BP v2.1 第 12 章 |
| `c23_tech_routes.png` | `c23` | 19 | 报告 3.3 |
| `c24_competition.png` | `c24` | 24 | 报告第 5 章与证据台账 C01、C02 |
| `c25_share_drivers.png` | `c25` | 18 | 报告表 2.7.5 |

### 4.3 备用素材（已生成，当前版本未上片）

| 文件 | 函数 | 说明 |
| --- | --- | --- |
| `c15_penetration.png` | `c15` | TrendForce 液冷渗透率两口径对照（AI 数据中心 14%→33%；AI 芯片 53% / 接近 60%）。内容已并入第 18 页的驱动因素图；如需单独成页，在 `make_ppt.py` 的 `build()` 中插入一个 `chart_slide(...)` 调用即可。 |

### 4.4 关于实物类图片

**本演示稿不含任何实物照片（AI 机柜、CDU 产品、冷板）。** 未找到可确认授权、可标注获取日期的厂商官方公开素材，按材料面向董事会的风险纪律，一律改用自绘示意图（`c17` CDU 系统框图、`c02` 机柜功率对比）替代。如日后需要补入实物图，请在本表新增一行，记录厂商、素材页面 URL、获取日期与授权依据，并在对应页脚标注来源。

## 5. 演示稿结构（35 页）

| 页 | 篇章 | 页面标题（结论句） |
| --- | --- | --- |
| 1 | — | 封面 |
| 2 | 结论先行 | 需求方向成立，但可得份额、价格、责任与现金回报尚未验证 |
| 3 | 阅读须知（一） | 两套独立标签体系：来源等级决定证据力，数据性质决定这个数字是什么 |
| 4 | 阅读须知（二） | 口径纪律：不同分母不可相加、不可相减、不可用于计算份额 |
| 5 | 市场篇（一） | 需求方向没有争议：用电五年翻倍、容量需求五年增 1.7 倍，但三条曲线分母不同 |
| 6 | 市场篇（二） | 机柜功率密度在一代内从 66 kW 跃到 264 kW —— 风冷延寿空间被物理压缩 |
| 7 | 市场篇（三） | 真正约束液冷需求的不是规划容量，而是每年实际投运的 10–28 GW |
| 8 | 市场篇（四） | AI 占存量容量约 25% → 50%，但占新增容量高达 76% —— 两个分母差一倍 |
| 9 | 市场篇（五） | 算力基建总投资 2025 年约 6,500–8,050 亿美元，2030 年约 1.64–2.05 万亿美元 |
| 10 | 市场篇（六） | 两条独立路径交叉验证后的裁决：McKinsey 6.7 万亿基准情景已过时，改用加速情景 |
| 11 | 市场篇（七） | 四大厂商 CapEx 只作旁证：它证伪了基准情景，但不能除以 L3 得「份额」 |
| 12 | 市场篇（八） | 液冷设备市场：2029 年约 70 亿美元合理，但整条曲线只有两个机构端点 |
| 13 | 市场篇（九） | Dell'Oro 的四个版本必须隔离：70 − 58 = 12 不是浸没与 RDHx 的规模 |
| 14 | 市场篇（十） | **液冷占比取决于分母，同一年三个比例相差约 30 倍** |
| 15 | 市场篇（十一） | 同一个分子、同一年，换 Dell'Oro 的版本就从 10%–13% 变成 5%–8% |
| 16 | 市场篇（十二） | 三组占比各自回答不同的问题 —— 只有组③ 可以谈「份额」 |
| 17 | 市场篇（十三） | 设施侧「液冷投入」是设备制造商收入的 5–6 倍 —— 差额被 EPC 与安装截留 |
| 18 | 市场篇（十四） | 占比不是稳定参数：四项推高、四项压低、一项方向不确定 |
| 19 | 技术与格局篇（一） | 技术路线按成熟度三分：只有第一层已产品化，后两层不给性能点值 |
| 20 | 技术与格局篇（二） | 平台工程基线：铭牌冷量不能证明兼容，五项参数必须同时校核 |
| 21 | 技术与格局篇（三） | 供液温度从 25℃ 升到 45℃：流量约 3 倍，压降约 8 倍 |
| 22 | 技术与格局篇（四） | CDU 卖的是可验证系统与责任闭环，不是铭牌 kW |
| 23 | 技术与格局篇（五） | 容量档不是兼容承诺：四档 × 四类工况的有效能力当前全部为无数据 |
| 24 | 技术与格局篇（六） | 竞争已全栈化：三笔并购把液冷装进了水处理、电力与预制模块的全栈组合里 |
| 25 | 技术与格局篇（七） | 唯一可用的纯液冷毛利实绩：冷板 10.36%，与浸没 36.49% 相差三倍 |
| 26 | 技术与格局篇（八） | 不存在公开可验证的统一 CDU 认证 —— 准入是逐项目的九步 qualification |
| 27 | 商业篇（一） | 把资本压在微笑曲线两端：中段的器件、基础软件与制造交给受控供应商 |
| 28 | 商业篇（二） | 商业三步走：2027 启动，800 / 1,200 / 1,500 万元是阶段上限而非承诺额度 |
| 29 | 商业篇（三） | 行业 TAM 增长推导不出公司收入：中间横着五道项目门和六个断点 |
| 30 | 商业篇（四） | 单位经济现在是一张空模型：填实它需要的是书面证据，不是更好的估计 |
| 31 | 商业篇（五） | 资金门禁 G0–G3：证据不到位，钱就不出去 |
| 32 | 风险与结论（一） | 五条反命题决定这笔投资是否成立 —— 每条都配有先行指标与自动动作 |
| 33 | 风险与结论（二） | 季度跟踪清单：先行指标一旦触发，模型与资金动作是预先约定的 |
| 34 | 风险与结论（三） | 下一步不是扩大研究，而是取得七类线下书面证据 —— 在此之前保持无数据 |
| 35 | — | 封底 |

> 第 2 页按报告原文保留**六条**核心结论（v3.2 已由五条扩为六条，新增「液冷在算力投资中价值占比极低，且高度依赖分母」）。

## 6. 内容纪律：在演示稿中保持「无数据」的项目

以下项目在 v3.2 报告中即为「无数据」或变量模型，演示稿逐字保持一致，未为了版面好看而填数：

- `SAM 24m` 与 `SOM`（第 29、34 页）—— 不是 0，是公开可核验的合格项目尚未闭环
- CDU 净 ASP（保留为变量 `ASP100 / ASP200 / ASP300 / ASP450`）、四 SKU BOM、贡献毛利 / ROIC / 盈亏平衡（第 30 页）
- CDU 有效能力矩阵：100 / 200 / 300 / 450 kW × ATD / 工质 / 泵故障态 / 滤网状态，共 16 格全部无数据（第 23 页）
- 现金跑道（BP v2.1 第 10.1 节裁决为 NA）

已删除且**不予恢复**的伪精确点值（`verify_ppt.py` 第 6 步会自动扫描）：市场份额、前五集中度、部件价值占比、通用毛利率、CDU 静态 ASP、SAM/SOM 亿元点值、固定 PUE 区间与 W-class 映射、MTBF、「零外漏 / 100% 拦截」。

其他强制标注：

- 2031–2032 的所有数值在图内均标为「本报告情景模型，无机构对应端点」（红色底纹区）。
- 涉及机构预测处一律标机构名与发布版本（如 Dell'Oro July-2025 / January-2026 / August-2026 三版分列）。
- 每张数据图的图注固定四段：单位 → 口径边界 → 数据性质（实绩/机构估计/机构预测/本报告模型/无数据）→ 来源机构与发布版本。

## 7. 验证记录（2026-09-05）

`verify_ppt.py` 全部通过：

| 检查项 | 结果 |
| --- | --- |
| 重新打开与页数 | python-pptx 可正常读取，35 页，文件无损坏 |
| 页面比例 | 13.3333 × 7.5 in，比例 1.7778 = 16:9 |
| 形状边界 | 全部形状在页面边界内（容差 0.02 in），无越界 |
| 图片嵌入 | 25 个图片形状 / 25 个包内媒体部件；无 `r:link` 外链，全部 `r:embed` 内嵌 |
| 图片分辨率 | 幻灯片中有效分辨率 220–326 dpi，全部 ≥ 200 dpi |
| 中文字体 | 476 个文本 run 全部显式指定 Microsoft YaHei，无未指定字体的 run |
| 数值核对 | 63 项关键数值 / 口径片段逐一比对 v3.2 报告原文，全部命中，无自造数字 |
| 伪精确点值扫描 | 未检出任何被禁止的点值模式 |
| 无数据声明 | 4 处必须保留的「无数据」裁决均在正文可检索到 |
| 页脚完整性 | 35 页全部含机密标识、版本、数据截止日与页码 |

目检：用本机 PowerPoint 将 35 页全部导出为 PNG（`export_preview.py` → `_preview/`），逐页确认中文渲染无方块、无缺字、无乱码，无文字溢出页面边界或压出图框。

---

## 8. v3.3 演示版 · 2026-09-06 页面修订：`c30_denominator_pies.png`（三分母嵌套饼图）

> 本节记录 v3.3 演示版（`../../算力冷却商业调研报告_v3.3_演示版_20260906.pptx`）的一次**同版本页面修订**：在第 14 页「液冷占比取决于分母」之后新增第 15 页，总页数 **38 → 39**，后续页码顺延，**不升版本号**。修订前原文件备份为 `../../算力冷却商业调研报告_v3.3_演示版_20260906_bak_before_pie.pptx`。未修改任何 HTML 报告。

### 8.1 页面与版面

| 项目 | 内容 |
| --- | --- |
| 页码 / 篇章 | 第 15 页 · 市场篇（十 · 续） |
| 页面标题 | 30 倍差距来自分母层级：L3 ⊃ L1 ⊃ DCPI ⊃ 液冷 |
| 版面方案 | **方案 B（独立成页）**：第 14 页保留对数坐标折线图不动，饼图单独成页，可读性优于把折线图缩到 55% 宽再塞三个饼 |
| 图片 | `c30_denominator_pies.png`，300 dpi，3,780 × 1,716 px；上片尺寸 10.33 × 4.69 in，有效分辨率约 366 dpi |
| 函数 | `make_charts_v33.py` → `c30()`；上片调用在 `make_ppt_v33.py` 的 `build()` 中（紧随 `c09` 页） |
| 字体 | Microsoft YaHei；YaHei 无 `⊂ / ⊃` 字形，含该符号的两段文字按 `["Microsoft YaHei", "Segoe UI Symbol", "Cambria"]` 回退（仅符号本身回退，其余字符仍为 YaHei）。PPT 标题中的 `⊃` 由 PowerPoint 自动回退渲染，导出目检正常 |

### 8.2 数据来源与复算（基准年 2029）

选 2029 而非 2025 的理由：2029 是 Dell'Oro 液冷「约 70 亿美元」机构预测的锚点年，也是报告 2.7.4 版本敏感性表的比较年；L1 / DCPI 的内部细分证据在两个年份同样缺失，因此没有改用 2025 的必要。

全部金额取自报告 v3.3 **表 2.6.5 的 2029 行 Base 值**（十亿美元）与 **表 2.7.2 备注**，不引入报告中没有的数字：

| 量 | 取值 | 报告出处 | 数据性质 |
| --- | --- | --- | --- |
| L1 设施侧 CapEx | 319 | 表 2.6.5 | 本报告模型（2029 强度为模型；JLL 强度仅 2025/2026 为机构值） |
| L2 IT 设备 | 1,383 | 表 2.6.5 | AI 部分 1.08 万亿为 IDC 机构预测；非 AI 部分为本报告模型 |
| L3 = L1 + L2 | 1,702 | 表 2.6.5 | 本报告模型 |
| DCPI（Aug-2026 版） | 106 | 表 2.6.5 | 本报告桥接（仅 2030 的 1,200 亿美元是 Dell'Oro 机构预测） |
| 液冷设备制造商收入 | 7.0（约 70 亿美元） | 表 2.7.2 备注 / 2.5.3 | Dell'Oro 机构预测（2029 端点） |

扇区比例复算（每个饼之和均为 100%）：

| 饼 | 扇区 | 复算 | 结果 | 与报告口径核对 |
| --- | --- | --- | --- | --- |
| ① L3 | L2 IT 设备 | 1,383 ÷ 1,702 | 81.3% | 2.7.3：分母中约 75%–85% 是 IT 设备 ✓ |
| ① L3 | L1 设施侧 CapEx | 319 ÷ 1,702 | 18.7% | 同上（100% − 75%–85%）✓ |
| ② L1 | DCPI 设备制造商收入 | 106 ÷ 319 | 33.2% | 区间法 95÷360 – 117÷280 = 26%–42%，Base 落在其中 ✓ |
| ② L1 | DCPI 以外 | (319 − 106) ÷ 319 | 66.8% | 几何余量，**不是**施工价值估算（2.6.1 禁止 DCPI 与 L1 相减推导施工价值） |
| ③ DCPI | 液冷 | 7.0 ÷ 106 | 6.6% | 表 2.7.2 组③ 2029 = 5%–8% ✓ |
| ③ DCPI | 其他品类 | (106 − 7.0) ÷ 106 | 93.4% | — |
| 链式校验 | 液冷 ÷ L1 | 7.0 ÷ 319 | 2.2% | 表 2.7.2 组② 2029 = 1.7%–2.9% ✓ |
| 链式校验 | 液冷 ÷ L3 | 7.0 ÷ 1,702 | 0.41% | 表 2.7.2 组① 2029 = 0.3%–0.5% ✓ |

> 任务口径提示「DCPI 约占 L1 的 25%–30%」，按表 2.6.5 实际复算 2029 Base 为 33.2%（区间 26%–42%）、2025 Base 为 26.0%（区间 21%–32%）；图中按复算值 33% 绘制，未采用 25%–30% 的近似说法。

### 8.3 哪些扇区是机构数据、哪些是模型

- **机构数据**：饼③ 的液冷扇区（Dell'Oro 2029 约 70 亿美元）；饼① L2 扇区中的 AI 部分（IDC 2029 1.08 万亿美元）。
- **本报告模型 / 桥接**：饼① 的 L1、L3 总额；饼② 的 L1 与 DCPI 2029 值；饼③ 的 DCPI 总额。三个饼的**全部百分比**都是本报告在明确分母定义下的推导，报告中没有任何机构发布过这些比例。
- **刻意不细分**：饼② 的「DCPI 以外」与饼③ 的「其他品类」——报告与 Dell'Oro 公开摘要均无建筑 / 电力 / 机电，或 UPS / 热管理 / 配电的金额，宁可合并为「其他」也不编造比例（图注与页脚均有说明）。
- **点值纪律**：扇区面积按 Base 值绘制、仅示意量级；可对外引用的只有区间（0.3%–0.5% / 1.7%–2.9% / 5%–8%），与报告「任一点值 confidence 0.35，禁止点值引用」一致。

### 8.4 重新生成与验证

```powershell
cd D:\agents2026\agents2026\agents\AIDCtms\Bp\assets\ppt
python -c "import make_charts_v33 as m; m.c30()"   # 只重渲染该图
python make_ppt_v33.py                              # 重新生成 39 页 pptx（原地覆盖；若文件正被 WPS/PowerPoint 打开会报 PermissionError，先关闭）
python verify_v33.py                                # 结构 / 字体 / 嵌入 / 越界 校验
python export_preview_v33.py                        # 导出 1/2/14/15/31–34/38 页到 _preview_v33/ 目检
```

2026-09-06 验证记录：python-pptx 重新打开 39 页；除新增第 15 页外其余 38 页正文与备份逐页一致（仅页脚页码顺延）；第 15 页 1 张图片以 `r:embed` 内嵌、无外链，全部文本 run 为 Microsoft YaHei，无形状越界；`verify_v33.py` 全部通过；`_preview_v33/p14.png`、`p15.png` 目检中文无乱码、标签无重叠、无出框。

---

## 9. v3.5 演示版 · 2026-09-06：接回第 3A 章工程深度

> 本节记录 v3.5 Integrated 演示版（`../../算力冷却商业调研报告_v3.5_演示版_20260906.pptx`，**43 页**）。以 v3.3 演示版为骨架：市场页（含第 15 页三分母嵌套饼图）与商业页数字原样保留；封面 / 页脚 / 结论改为 v3.5；工程篇新增 6 页（c31–c36），并改写平台矩阵为七量。未修改任何 HTML，未覆盖 v3.3 演示稿，未提交 Git。

### 9.1 如何重新生成

```powershell
cd D:\agents2026\agents2026\agents\AIDCtms\Bp\assets\ppt
python make_charts_v35.py     # 只渲染 c31–c36（不覆盖 c01–c30）
python make_ppt_v35.py        # 生成 43 页 pptx 到上两级目录（不覆盖 v3.3）
python verify_v35.py          # 结构 / 字体 / 嵌入 / 越界 / 18 组数字 / 术语
python export_preview_v35.py  # 导出 10 页到 _preview_v35/ 目检
```

### 9.2 新增图表（c31–c36，300 dpi，不覆盖 c01–c30）

| 文件 | 函数 | 用于页 | 报告出处 | 数据性质 | 生成方式 |
| --- | --- | --- | --- | --- | --- |
| `c31_cdu_architecture.png` | `make_charts_v35.c31` | 21 | §3A.4 / 图 3A-1 | 自绘示意图 | 按报告 SVG 四栏结构用 matplotlib 重绘，不上片外链矢量 |
| `c32_seven_checks.png` | `make_charts_v35.c32` | 22 | §3A.2 / §3A.5 / 图 3A-3 | 流程自绘；C_effective 为无数据裁决 | 按报告 SVG 七量流程重绘 |
| `c33_cdu_forms_ladder.png` | `make_charts_v35.c33` | 25 | §3A.4.2 / §3A.5.1 / §3A.7.1 | Vertiv 一级；OCP Deschutes 二级；形态区间二级/三级 | 形态卡片 + 额定工况示例；**已删 ASP** |
| `c34_coldplate_routes.png` | `make_charts_v35.c34` | 27 | §3A.3 / §3A.9.1 / §3A.9.3 | 工艺定性；热阻/良率/时点不接回 | CNC / 钎焊 / 扩散焊三列 + 成熟度三层 |
| `c35_standards_qualification.png` | `make_charts_v35.c35` | 28 | §8.1 / §8.1.1 / §8.3 | 标准状态一级；无统一认证为公开证据裁决 | 五分法 + 九步 qualification |
| `c36_software_stack.png` | `make_charts_v35.c36` | 29 | §3A.8 / BP v2.2 微笑曲线 | 职责分层，非收入预测 | 三层栈：应用控制自留 / BSW 外协 |

图注仍为四段式：单位 → 口径边界 → 数据性质 → 来源机构与版本。

### 9.3 演示稿结构（43 页）

相对 v3.3 的 39 页：+6 张 3A 工程页，−2 张被替换的旧工程页（原 c17 简框图由 c31 取代，原 c21 认证链由 c35 取代）。市场页 5–19 页序与数字未改，第 15 页饼图保留。

| 页 | 篇章 | 变更 | 页面标题（结论句） |
| --- | --- | --- | --- |
| 1 | — | 改 | 封面 · v3.5 Integrated / 配套 BP v2.2 |
| 2 | 结论先行 | 改 | 需求方向成立；工程壁垒在平台级适配，商业缺口已转化为可行域与生存条件 |
| 3–19 | 阅读须知 + 市场篇 | 保留 | 与 v3.3 同（第 15 页三分母嵌套饼图保留） |
| 20 | 工程篇（一） | 保留 | 技术路线按成熟度三分 |
| 21 | 工程篇（二） | **新** | CDU：一次侧 FWS / 本体 / 二次侧 TCS / 控制层 |
| 22 | 工程篇（三） | **新** | 七量缺一项即不能判定兼容：200/300/450 kW 不是平台兼容承诺 |
| 23 | 工程篇（四） | 改 | 平台工程基线：七个量必须同时校核 |
| 24 | 工程篇（五） | 保留 | 供液温度 25℃→45℃：流量约 3 倍，压降约 8 倍 |
| 25 | 工程篇（六） | **新** | 形态先选失效域；额定冷量必须写清工况 |
| 26 | 工程篇（七） | 保留 | 容量档不是兼容承诺：有效能力矩阵全为无数据 |
| 27 | 工程篇（八） | **新** | 冷板只做定性对比；禁止把托盘误称为 PCB 冷板 |
| 28 | 工程篇（九） | **新** | 不存在公开统一 CDU 认证；标准五分法 |
| 29 | 工程篇（十） | **新** | 应用控制自留，PLC 硬件与 BSW 授权外协 |
| 30–31 | 格局篇 | 保留 | 竞争全栈化；冷板毛利 10.36% |
| 32–39 | 商业篇 | 保留/改写页脚 | 微笑曲线、三步走 2027 / 800·1,200·1,500、TAM 断点、单位经济、价格可行域、责任敞口、G0.5 49:1、资金门禁 |
| 40–41 | 风险 | 保留 | 反命题；季度跟踪 |
| 42 | 风险与结论（三） | 保留口径 | 先取四项书面证据，再决定样机 |
| 43 | — | 改 | 封底 · v3.5 Integrated |

### 9.4 SVG 处理方式

报告图 3A-1（CDU 系统框图）与图 3A-3（七量校核流程）为 HTML 内嵌 SVG。python-pptx 不稳妥嵌入 SVG，故按原 SVG 栏位 / 色码 / 标注用 matplotlib 重绘为 300 dpi PNG（`c31` / `c32`），以内嵌 `r:embed` 写入 pptx，无外链。未把 SVG 拆成 pptx 形状，以免中文与箭头在不同 Office 版本走样。

### 9.5 验证记录（2026-09-06，精简加速版）

`verify_v35.py` 全部通过：

| 检查项 | 结果 |
| --- | --- |
| 重新打开与页数 | python-pptx 可正常读取，43 页，文件无损坏 |
| 页面比例 | 13.3333 × 7.5 in = 16:9 |
| 形状边界 | 全部形状在页面边界内（容差 0.02 in） |
| 图片嵌入 | 33 个 blip 全部 `r:embed`；幻灯片关系无 `TargetMode=External`；包内 33 个媒体文件 |
| 中文字体 | 全部文本 run 为 Microsoft YaHei |
| 18 组关键数字 | 10.36%、684.75、715、840、27%–37%、10.36%–23.83%、91 万元/MW、171、49:1、245、800、1,200、1,500、2027、1.76–2.52、6–8 周、< 5 万元、50–200 kW 均在 PPT / 报告 v3.5 / BP v2.2 交叉命中 |
| 术语扫描 | 「PCB 冷板」仅出现在术语纪律句；「统一认证」均为否定表述；未恢复份额 / 静态 ASP / MTBF 点值 / 零外漏承诺 |

目检：`export_preview_v35.py` 导出 10 页到 `_preview_v35/`（1 封面、2 一页结论、15 饼图、21 架构、22 七量、25 形态、27 冷板、28 标准、38 G0.5、42 下一步）。中文无方块、无缺字；标题为结论句；页脚为 v3.5 Integrated。

因加速未做的检查：未全量导出 43 页；未目检软件栈第 29 页与平台矩阵第 23 页的预览图；未用 PowerPoint 做逐形状文字溢出像素级测量（仅做形状包围盒越界检查）；未重跑 v3.2 的 63 项市场数字逐条比对（市场页未改）。
