bruce2012lu/AIDCtms_design202609/coolingplate/design/cfd/uc01b_2.4x3.0/UC01b_1D与CFD契合性对比_v1.0.md

# UC-01b 一维设计与 CFD 契合性对比 v1.0

CFD 列是 iter **529**，场 `fluent/uc01b_cht_v2_n216_q105_sym`（2026-09-25 16:00）。X=0 上 ±Y 温差中位 0.0018 K，但 X=0.556 mm 上 ±Y 温差中位 **0.631 K**、最大 5.64 K，**流场不能称为对称**。

一维设计点：整板 1100 W、2.0 L/min；两 die GPU 858 W、1.60 L/min；216 孔；名义 q''=55.170 W/cm²；施加边界 ×1.05 = 57.928 W/cm²（579282.4074074075 W/m²），这是边界冗余，不改 1100 W。单孔 0.007407 L/min，ṁ=1.2249382716049385×10⁻⁴ kg/s。Re_D=597.1 &lt; 2000，Martin 1977 不用。

| 项目 | 一维设计点 | CFD iter 529 |
|---|---|---|
| TIM 底 | — | **341.9268 K（68.78 °C）**，本面 341.905–341.947 K |
| 铜–水 / 出口 | — | 326.8120 K / 320.8987 K |
| 入口 | 313.15 K | 313.15 K |
| 静压差 | 本页不另造孔口损失 | **1085.97 Pa** |
| U / Re_D | Martin 不用 | 0.9824 m/s / 597.1 |
| R(T_TIM−T_in) | — | **0.031942 K/W**（900.9 W，不加 R_TIM2、R_wall） |
| R_conv / R_c-in | — | 0.015165 / 0.022557–0.026557 K/W |
| 能量 | — | 7.74875 / 8.14772 = 0.951，未闭合 |
| 残差 | — | `1.3062e-07  1.1074e-07  1.3559e-07  1.8577e-07  9.2473e-07  3.3142e-07  2.4924e-04`，已收敛 |

两条热阻不能相加。质量流量积分未再打印。dat 里的面热流数组不是 W/m²，施加 q'' 仍是 579282.4074074075。喷孔 |V| 0.034–1.627 m/s，导流槽 |V| 0.00053–0.111 m/s。没有 GCI 或 y+。
