bruce2012lu/AIDCtms_design202609/coolingplate/patent/AI算力芯片液冷冷板专利分析报告_20260907.md

# AI算力芯片液冷冷板技术专利分析报告

**版本**：v1.4 · 2026-09-07  
**范围**：芯片级 / 封装级 / 冷板级 Direct-to-Chip（D2C）液冷，不含机房侧 CDU、冷却塔与浸没液冷主体  
**技术焦点**：微通道、微翅片（含铲齿/针肋）、冲击射流、金刚石、纳米流体，以及其杂交结构  
**功率标尺**：英伟达最新 SKU（H100 → B300 → Rubin R100 / Ultra）  
**工艺**：机加工（铲齿/CNC/微钻）与金属 3D 打印（LPBF/ECAM）专章，见 §3.7  
**配图**：优先调研原图；无原图处自绘（杂交单元、已占四格、方案 A/B/C、铲齿、热阻链）  
**性质**：公开情报与专利态势研究，**不是**自由实施（FTO）法律意见，也不是权利要求逐条比对

---

## 0. 结论先行

1. **冷板式液冷已是未来 3–5 年 AI 服务器的主流散热形态**。欧洲专利库 2000–2023 年数据中心冷却专利显示，2015 年后液冷申请占比持续上升，近期时段液冷可占相关专利约八成，其中直接液冷（冷板）是主体。
2. **五条技术路线并不并列竞争，而是分层叠加**：
   - **微翅片/铲齿**：当前量产主力，工艺成熟、成本可控，但流阻与热点匹配能力见顶。
   - **微通道（含 MLCP/MCL）**：下一代 GPU/加速器的主攻方向，取消 TIM2、把流道做到盖板甚至硅内。
   - **冲击射流**：针对热点的局部强化换热，常与微通道/微翅片杂交，浪潮、JetCool、Intel 均有布局。
   - **金刚石**：不替代对流结构，而是把热从热点“摊开”；CVD 片材与金刚石/铜复合材料正在进入 GPU lid / 冷板嵌件。
   - **纳米流体**：工质侧增益，实验室换热可提升约 10–40%，但沉降、磨损、过滤与长期稳定性卡住规模化。
3. **国内外分工已经出现**：美欧日掌握基础结构与封装级微射流/微通道；台湾厂商卡位 NVIDIA MLCP/MCL 认证产线；大陆在系统级液冷（浪潮、曙光数创、英维克、华为）专利密度高，但**微米级蚀刻 + 真空扩散焊 + 半导体级洁净**仍是短板。
4. **最有价值的布局窗口**不在“再挖一条直通道”，而在：**分区/拓扑流道、射流–微通道杂交、去 TIM2 的盖板一体化、金刚石嵌件与键合、可制造性与防堵/防漏工艺**。
5. **工艺分三条产线**：机加工 + 钎焊保 B300 量产；蚀刻 + 扩散焊做 MLCP；金属 3D 打印做异形喷嘴与拓扑样件。量产推荐“机加底板 + 蚀刻/增材盖板”，整板打印不出货。

---

## 1. 调研范围、数据源与检索策略

### 1.1 问题定义

必须以**英伟达最新量产与在研 SKU**定功率密度，而不是停在 H100。公开链：H100/H200 **700 W** → B200 **1000 W** → B300 Lenovo TGP **1100 W** / NVL72 报道 **1400 W** → Rubin R100 报道 **1800 W（Max-Q）/ 2300 W（Max-P）**（软件功率档，不是两颗芯片）→ Rubin Ultra 路线图约 **3600 W/封装**。机柜：GB300 NVL72 为 Lenovo **135 kW TDP / 155 kW EDP**、NVIDIA RA **142 kW**；Vera Rubin NVL72 报道 **180–220 kW**。硅面积平均热流约 **65（B200）→ 158 W/cm²（R100 Max-P）**；500–600 W/cm² 只能当活性核热点上限。传统“铜盖 + TIM2 + 铲齿冷板”在 B300 已紧，Rubin 上必须靠微通道 / 射流杂交或 MLCP。完整 SKU 表、热阻反算见 HTML 报告第 2.4.0 节。

本报告只回答三件事：

- 国内外专利在五条技术方向上各自保护什么？
- 每条路线的优势、短板、工艺门槛是什么？
- 对后续研发、供应链与规避设计，哪些空白更值得占？

### 1.2 数据源头（国内外同时覆盖）

| 层级 | 国内 | 国际 |
|---|---|---|
| 官方专利库 | 中国国家知识产权局（CNIPA）公开文本；国家知识产权局专利检索及分析系统 | USPTO、EPO/Espacenet、WIPO Patentscope |
| 聚合检索 | Google Patents（CN 公开号）、Patsnap Eureka 公开页 | Google Patents（US/EP/WO）、Freepatentsonline |
| 学术/综述 | 华中科大等高校授权专利；国内券商/标准文件交叉验证 | *Energies* 2024, 17, 3615（斯图加特大学，EPO 2000–2023 数据中心冷却专利分类）；Mudawar 等换热综述 |
| 产业情报 | 浪潮、曙光数创、华为 CloudMatrix 公开材料 | NVIDIA/TSMC 供应链报道，JetCool、Element Six、Future Market Insights |

**说明**：本轮为公开网页与公开专利文本抽样，**不是** Derwent / Innography / 智慧芽全库定量检索。文中涉及“专利件数”处，凡来自企业自述或单篇论文，均标明出处；未做全库去重的家族计数一律按**量级判断**表述。法律状态以公开页为准，存在滞后。

### 1.3 建议检索式（可复用于正式库）

**分类号（优先组合）**

- `H01L 23/473` 半导体装置液体冷却
- `H05K 7/20254` / `H05K 7/20218` 电子设备液体冷却
- `F28F 3/12` 内部流体通道板
- `F28F 13/06` / `F28F 13/12` 射流、扰动强化
- `C09K 5/10` / `C09K 5/14` 传热液体、纳米分散
- `C23C 16/27` CVD 金刚石；`C22C 26/00` 金刚石复合材料

**中文关键词组**

```
(微通道 OR 微流道 OR 微翅片 OR 铲齿 OR 针肋 OR 冲击射流 OR 射流冲击
 OR 金刚石 OR 纳米流体) AND (冷板 OR 液冷板 OR 水冷板)
 AND (芯片 OR GPU OR CPU OR 加速器 OR 服务器 OR 数据中心)
```

**英文关键词组**

```
(microchannel OR microfluidic OR microfin OR skived OR pin-fin
 OR "jet impingement" OR microjet OR diamond OR nanofluid)
 AND ("cold plate" OR "coldplate" OR "liquid cooling")
 AND (GPU OR CPU OR accelerator OR "data center" OR server)
```

**过滤**：优先看独立权利要求中的流道几何、喷嘴阵列、盖板一体化、材料键合、工质配方；系统级机柜/CDU 仅作背景。

---

## 2. 产业与专利总态势

### 2.1 为什么冷板专利在 2015 年后加速

斯图加特大学对 EPO 2000–2023 数据中心冷却专利的分类结果表明：

- 相关样本约 **733** 件，其中判定相关约 **496** 件。
- 整体分布：液冷约 **35%**，风冷约 **27%**；液冷内部，直接液冷约 **20%**（冷板约 **17%**），浸没约 **9%**。
- 按时段看：风冷占比从早期约 **69%** 降到近期约 **9%**，液冷从约 **24%** 升到约 **84%**；直接液冷始终占液冷的 **58–68%**。
- 2018 年后风冷申请明显回落，优化空间被判定为接近耗尽。

市场侧同步给出需求：Direct-to-Chip 冷板市场有机构预测 2026 年约 **32 亿美元**，2036 年约 **139 亿美元**，CAGR 约 **15.8%**；其中微通道冷板约占需求 **42%**，HPC/AI 应用约占 **45%**（Future Market Insights，公开摘要口径）。

### 2.2 技术代际：从“贴一块铜板”到“把水做到硅旁边”

| 代际 | 结构 | 热阻瓶颈 | 典型工艺 | 产业状态 |
|---|---|---|---|---|
| G0 管式/冲压钎焊冷板 | 埋管或宽流道 | 对流面积不足 | 冲压 + 钎焊 | 成熟，AI 高热流不够用 |
| G1 铲齿/微翅片冷板 | 一体铲出密肋 | TIM2 + 沿程温升 + 流阻 | 铲齿 + 真空钎焊 / 搅拌摩擦焊 | **当前量产主力** |
| G2 微通道冷板 | 水力直径 0.1–1 mm 级通道 | 仍有 TIM2；堵塞与压降 | 蚀刻 / CNC + 扩散焊或钎焊 | 高端 GPU 快速导入 |
| G3 MLCP / MCL | 盖板或加强环内做微通道，取消独立冷板与 TIM2 | 封装翘曲、泄漏、洁净度 | 半导体级蚀刻 + 扩散焊 + 镀金 | NVIDIA Rubin 供应链验证中 |
| G4 硅内微流体 | 冷却液进入芯片或封装内部 | 蚀刻深度与机械强度、可靠性 | 光刻 / DRIE + 键合 | 微软+Corintis、TSMC 路线，验证阶段 |
| 并行增强 | 射流、金刚石嵌件、纳米工质、拓扑流道 | 各自独立短板 | 见第 3 章 | 与 G1–G4 叠加，而非替代 |

NVIDIA 一侧公开讨论的 MLCP（Microchannel Liquid Cold Plate / Microchannel Lid）核心，是把冷却液通道做到散热盖本身，砍掉 TIM2；供应商公开名单中多见 AVC、Cooler Master、Jentech、Delta、Auras。大陆厂商（蓝思、中航光电、宁波精达等）公开信息仍多处于送样/验证，量产良率与泄漏风险尚未过关。微软则与 Corintis 走更激进的**硅内叶脉分形微流体**，实验口径称温升可降约 **65%**、换热约为现有冷板的三倍。

### 2.3 申请人格局（抽样，按角色）

**国际（结构与封装）**

- **IBM**：硅微通道、分层歧管、热点加密、两相沸腾表面处理，基础专利厚。
- **Intel**：冷板开孔/翅片架构（如 US12133357B2）、封装级 Direct Liquid Micro Jet（DLMJ）。
- **NVIDIA**：数据中心智能冷板，微通道 + 热管主/被动切换（US12477696）。
- **Google**：机柜/模块化液冷与浸没混合架构（2024–2025 EP 等）。
- **JetCool**：微射流直接接触，WO2020210587A1、US11844193、US12100643B2。
- **CoolIT / Asetek / Boyd / Vertiv**：商业冷板与回路，专利偏系统与可维护性。
- **Element Six**：CVD 金刚石键合（WO2016087243A1 / US10403557 / EP3227914）。
- **Samsung（2025 公开）**：混合金刚石热中介层，面向 HBM + AI 加速器异构封装。
- **IMEC**：垂直进出液 + 芯片背面直接冲击。

**中国大陆（系统与结构并进）**

- **浪潮信息**：自称 2024 年液冷相关专利 **700+**（安全 250+、高密 130+、节能调控 220+、便捷 100+）；冷板从铲齿转向射流式；CN113871359A 为离心微通道 + 中心淹没射流。
- **曙光数创**：冷板/浸没双线，2025 年末授权相关专利约 **197**（液冷相关约 **158**），牵头国标《数据中心冷板式液冷系统技术规范》。
- **华为**：WO2026103052A1 分区换热冷板（射流 / 微通道 / 拓扑流道按热密度分区）；CloudMatrix 公开口径热阻可至 **0.03 °C·cm²/W**。
- **英维克**：NVIDIA NPN Tier-1 等系统级认证，专利偏 CDU/管路/整柜，冷板多为配套。
- **高校/材料**：华中科大纳米磁流体（CN113488444B）、广东蓝锐旁通微通道（CN120597664A/B）、山东烯力石墨烯/CNT 纳米流体（CN122278447A）。

**中国台湾（制造认证）**

- Jentech、AVC、Auras、Cooler Master、Delta：卡位 NVIDIA 盖板、均热板、MLCP 量产，专利与 know-how 集中在**可制造性、镀层、扩散焊、泄漏与翘曲控制**。

---

## 3. 五条技术路线：优势、短板、工艺与代表专利

### 3.1 微通道（Microchannel / MLCP / MCL）

**原理**  
水力直径约 **10 µm–1 mm** 的密排通道，用极大比表面积和薄边界层换高对流换热系数。演进路径：直通道 → 歧管微通道（缩短流程、降压降）→ 分形/叶脉/拓扑优化 → 盖板一体化（MLCP/MCL）→ 硅内微流体。

**优势**

- 同等流量下换热系数显著高于宏观流道；Tuckerman & Pease 经典水冷实验可达约 **790 W/cm²**（实验室、高压降）。
- 可按热图定制通道密度，适配 chiplet / HBM 不均匀热源。
- MLCP/MCL 取消 TIM2 与独立冷板，热路最短，是 2 kW 级 GPU 的现实路径。
- 与射流、针肋、金刚石嵌件兼容，专利上容易形成“结构组合”保护。

**短板**

- **压降随水力直径急剧上升**，泵功和 CDU 扬程成为系统约束；沿程温升导致出口侧结温偏高。
- **堵塞敏感**：钎料、颗粒、生物膜、纳米颗粒都可能堵死 100 µm 级通道。
- 盖板一体化后，冷板从“可更换配件”变成“封装的一部分”，泄漏等于毁片，可靠性门槛跃升。
- 基础几何与歧管结构已被 IBM、Intel、Asetek 等覆盖多年，**新申请若只写“平行微通道”很难授权**。

**工艺要求**

| 级别 | 典型工艺 | 适用 | 关键控制点 |
|---|---|---|---|
| 量产中端 | CNC / 铲齿 + 真空钎焊或搅拌摩擦焊 | 0.3–1.0 mm 通道 | 钎料不溢入通道、平面度、氦检漏 |
| 高端 MLCP | 化学蚀刻 / 光化学加工 + **真空扩散焊** | 30–200 µm 级、分支/波浪三维流道 | 无钎料堵孔、键合强度、残余应力、洁净度 |
| 封装/硅级 | 光刻 + DRIE + 硅-硅或硅-玻璃键合 | 芯片内或 lid 内微流体 | 蚀刻深宽比 vs 机械强度、密封、与 CoWoS 协同 |
| 新兴 | 纯铜电化学增材（ECAM）、选区激光熔化 | 拓扑流道、非直壁 | 表面粗糙度、残留粉末、耐压与腐蚀 |

公开供应链评论指出：MLCP 需要**半导体级光刻/蚀刻 + 真空扩散焊**，传统铲齿到此基本失效。这也是大陆厂商与台湾认证产线的主要代差。

**代表专利 / 公开文本**

| 公开号 | 权利人 | 要点 |
|---|---|---|
| US12133357B2 | Intel | 冷板开孔与翅片架构，面向器件液冷 |
| US12477696 | NVIDIA | 微通道主动液冷 + 热管被动备份 |
| US20200227341A1 | Intel 体系（DLMJ） | 微通道阵列上方叠加垂直微射流歧管 |
| CN109104844B | 中航雷华 | 多级分配、微通道只经过一次，降流阻与热量累积 |
| CN120597664A/B | 广东蓝锐 | 主通道 + 旁通 + SMA 微执行器，按负荷切换，降固定高压阻能耗 |
| CN122263715A | （拓扑优化自动设计） | 变密度法 + COMSOL-MATLAB 自动生成可制造微通道 |
| WO2026103052A1 | 华为 | 同一冷板内按热密度分区，混用射流/微通道/拓扑流道 |

学术侧，叶脉分形微通道 + PSO 优化可将仿真结温从约 128 °C 降至约 31 °C（*Materials* 2026, 19, 679，仿真结果，需实验复核）。Corintis Glacierware 用拓扑优化相对直通道可降约 **13%** 温升或约 **55%** 压降。

**专利布局特征**  
早期保护“有微通道”本身；现在保护**流量分配、旁通、可制造拓扑、与封装盖板的一体化、主动控制**。新进者应避开“平行直槽 + 盖板钎焊”的基础权利要求，转向热图驱动几何与工艺窗口。

---

### 3.2 微翅片（Micro-fin / 铲齿 / 针肋 / 微柱）

**原理**  
在铜（或铝）基体上形成高密度肋片或针肋，用扩展表面强化单相对流。铲齿（skiving / MDT）是把材料“刨起”而不是铣掉，肋根与基板一体，无焊接热阻。

**优势**

- **工艺最成熟、成本最低、供应链最完整**，是当前 AI 服务器冷板的默认形态。
- 一体成型，肋根导热好，真空钎焊盖板后可靠性已被数据中心验证。
- 设计参数少（肋高、肋厚、节距、流程），开模/换型快，适合多芯片 SKU。
- 可与射流盖板、倾斜射流、变肋宽组合，升级路径平滑。

**短板**

- 铲齿几何自由度低，**很难按热点做局部加密或三维分支**。
- 加密肋片必然抬高压降；直通道沿程温升明显，对 HBM 边缘热点不友好。
- 常规铜微加工通道宽度难稳定做到约 **100 µm** 以下（US12494408 正是为突破这一限制）。
- 浪潮公开指出：铲齿直通道“面积大但流阻大”，其射流冷板就是为了抬芯片功耗上限。

**工艺要求**

- 铜板铲齿：刀具角度、进给、肋高一致性；铲后去毛刺、电解抛光或化学清洗。
- 盖板封合：真空钎焊（成本低、有堵孔风险）或搅拌摩擦焊 / 激光焊（少填缝料）。
- 更高密度：双图案交替肋宽（先加工一组肋，填金属，再选择性腐蚀出第二组，通道约 100 µm）。
- 自适应肋：双金属片随温度弯曲，改变近壁/低阻通道分流（US12193201），工艺与疲劳寿命要求高。
- 下一代：ECAM 电化学增材可做出尖顶、锯齿等非矩形肋，Illinois 团队公开数据称冷却提升最高约 **32%**，同冷却下压降可降约 **68%**。

**代表专利 / 公开文本**

| 公开号 | 权利人 | 要点 |
|---|---|---|
| US9795057 | （铲齿冷板制法） | 铲齿成肋后再斜切成针，嵌入槽体形成液冷腔 |
| US5775187 | MDT 基础 | 微变形铲削，不去除材料抬肋 |
| US12494408 | （微冷却器） | 交替肋宽双图案，突破铜微加工通道下限 |
| US12193201 | — | 双金属三维自适应流道微/小通道冷板 |
| CN113871359A | 浪潮 | 中心射流 + 离心肋片 + 阿基米德导流，匹配 CPU 径向热图 |

**专利布局特征**  
纯铲齿结构专利空间窄，价值转向：**变截面肋、针肋阵列、自适应肋、铲齿与射流盖板组合、以及与芯片热图对齐的非均匀节距**。对国内厂商，这是“守住出货、用结构升级换性能”的主战场。

---

### 3.3 冲击射流（Jet Impingement / Microjet）

**原理**  
冷却液经喷嘴加速后垂直或倾斜冲击换热面，滞止区边界层被反复破坏，局部换热系数可比微通道高一个数量级。JetCool 公开口径：微射流换热系数可超过 **200,000 W/m²K**，并称微通道约 **20,000 W/m²K** 量级（厂商数据，需独立复测）。

**优势**

- **热点针对性最强**：喷嘴可以对准 SM、HBM 邻区、I/O 热点。
- 在限定压降或希望短流程时，往往比长微通道更合适；射流侧通常“大流量、相对低压降”，微通道则相反。
- 取消或减薄 TIM / 均热盖时，可做直接接触冷却（JetCool US11844193）。
- 与微通道杂交（槽道里再喷）可兼顾均温与极限热流：Sung & Mudawar 两相杂交实验做到约 **1127 W/cm²** 而未达 CHF。

**短板**

- 喷嘴压降集中，孔板需加厚防变形；边缘密封占位会导致**边缘欠冷**（US11310937 专门解决 near-edge jets）。
- 射流侵蚀、震动、回流干涉会造成温度花斑；多喷嘴阵列的回流设计是核心难点。
- 流量需求通常大于微通道，对 CDU 和二次侧管路更苛刻。
- 直接冲击芯片背面时，密封、应力、电气隔离风险上升。

**工艺要求**

- 喷嘴板：微钻孔 / 激光微孔 / 光刻电铸，孔径一致性与毛刺控制决定射流均匀性。
- 孔板刚度：高压差下防挠曲，常需厚板或支撑柱。
- 与肋化底板组装：倾斜射流 + 肋化槽道（US10244654）需角度公差。
- 旁通孔：一部分流体不经喷嘴，降低总压降并改善回流（US12255124）。
- 材料：铜或不锈钢喷嘴板 + 铜底板；直接接触方案要食品/电子级洁净与介电流体兼容。

**代表专利 / 公开文本**

| 公开号 | 权利人 | 要点 |
|---|---|---|
| WO2020210587A1 / US12100643B2 | JetCool | 微射流喷嘴与电子元件共位 |
| US11844193 | JetCool | 直接接触流体模块，微射流冲击封装表面 |
| US12002736 | — | 射流座/喷嘴对准功率器件热点 |
| US12255124 | — | 射流 + 旁通分流，降压降 |
| US10244654 | — | 倾斜射流 + 肋化槽道 |
| US11310937 | — | 近边缘射流歧管，补偿密封占位 |
| US10306801 | — | 两相冷板喷嘴区对准热点 |
| CN113871359A | 浪潮 | 中心淹没射流 + 离心微通道 |
| WO2026103052A1 | 华为 | 高热流分区采用射流结构 |

**专利布局特征**  
国际专利已较密：喷嘴阵列、旁通、近边缘、倾斜角、直接接触密封。国内相对强在**整机冷板形态**（浪潮射流冷板），弱在**微喷嘴板精密制造与直接接触密封**。杂交结构（射流供液 + 微通道排液）仍是可写空间。

---

### 3.4 金刚石（CVD 片材 / 金刚石–铜复合材料）

**原理**  
单晶或 CVD 金刚石室温热导率约 **1000–2000 W/(m·K)**，是铜的 2–5 倍，且热膨胀可调。它解决的是**导热与均热**，不是对流。典型用法：

1. TIM1 / lid 内嵌 CVD 金刚石均热片；
2. 金刚石/铜复合材料做盖板或冷板基板（公开热导约 **600–1500 W/(m·K)**）；
3. 金刚石热中介层，连接逻辑裸片与 HBM。

**优势**

- 把 chiplet 热点横向拉开，让下游微通道/射流“看到”更均匀的热流，常比单纯加密流道更有效。
- 可做 drop-in：Element Six 强调 Cu-Diamond 能沿用现有铜冷板加工路线，开细节距流道。
- 与 1 kW/cm² 量级局部功率密度匹配（Element Six 键合专利的设计目标）。
- 产业信号：公开报道称 NVIDIA H200 体系已出现金刚石导热部署；Samsung 2025 年就混合金刚石 interposer 提出 US/EP 申请。

**短板**

- **贵、脆、难加工、难金属化**。金刚石与铜润湿差，界面热阻可以把体材料优势吃掉。
- CTE 与硅/铜不匹配会导致翘曲、脱层；大尺寸薄片（边长 60–130 mm）成品率是瓶颈。
- 专利壁垒集中在**界面**：铬键合 vs 钛铂、磷酸盐玻璃梯度界面、PVD 镀铜后热压。
- 不能单独替代冷板对流；没有微通道/射流，只是一块更贵的均热片。

**工艺要求**

| 路线 | 关键步骤 | 难点 |
|---|---|---|
| CVD 金刚石片 | MPCVD 生长 → 抛光 → 金属化（Cr/Au 或 Ti/Pt/Au）→ 键合到 Si/Cu | 残余应力、界面热阻、大面积均匀性 |
| 金刚石/铜热压 | 金刚石镀铜或表面玻璃化 → 700–850 °C、30–50 MPa 热压 | 石墨化风险、孔隙、界面连续梯度 |
| 气压浸渗 | 镀膜金刚石预制体 + 铜熔渗 | 体积分数 60–85%、热导目标 1500 W/mK 级 |
| 冷板集成 | 复合材料 3D 打印流道或机加后激光焊盖板 | 可加工性、密封、与快接头连接 |

**代表专利 / 公开文本**

| 公开号 | 权利人 | 要点 |
|---|---|---|
| WO2016087243A1 / US10403557 / EP3227914 | Element Six | 金刚石上铬层 + 再金属层，面向 ≥1 kW/cm² |
| CN111500892B | — | 大尺寸片状金刚石/铜，热导达约 1500 W/mK |
| CN122161445A | — | 金刚石铜合金冷板，PVD 镀铜热压，3D 打印肋，激光焊密封 |
| CN122503683A | — | 磷酸盐玻璃膜 + 低温热压，形成金刚石–磷氧–铜磷–铜梯度界面 |
| Samsung 2025 US/EP（公开报道） | Samsung | 混合金刚石热中介层，逻辑 + HBM |

**专利布局特征**  
欧美控制**高功率密度键合**；中国申请密集在**复合材料制备与冷板结构**。规避 Element Six 时，应避开“金刚石 + 铬直接键合 + 高功率密度器件”的权利要求组合，转向其他碳化物形成元素、梯度界面或 Cu-Diamond 体材料嵌件。FTO 必须单独做家族与等同原则分析。

---

### 3.5 纳米流体（Nanofluid / 磁流体 / 纳米相变胶囊）

**原理**  
在水、乙二醇或介电流体中分散纳米颗粒（Al₂O₃、Cu、石墨烯、CNT、Fe₃O₄），提高有效热导率与对流换热。磁纳米流体还可外加磁场做热点定点冷却。

**优势**

- **不改冷板模具**即可尝试增益，适合作为现有微通道/铲齿的工质升级。
- 文献与专利常报告换热系数提升约 **10–40%**；磁流体可对动态热点做额外局部制冷。
- 与微通道、空化自分散、相变胶囊结合，形成“工质 + 结构”组合申请。

**短板（这是该路线的主矛盾）**

- **沉降、团聚、流挂**：停泵后再启动会堵微通道，这正是 CN118890850A、CN122278447A 要解决的问题。
- 颗粒磨损泵、快接头和微通道壁；过滤器与离子浓度控制困难。
- 电导率、腐蚀、微生物、与乙二醇/缓蚀剂配方冲突，数据中心 5–10 年寿命难证明。
- 增益幅度通常小于一次成功的流道改版；**作为产品主路径风险高，作为专利防御或特种场景更合适**。

**工艺 / 配方要求**

- 连续相：去离子水 + 丙二醇等；分散相：石墨烯、SWCNT、氧化物、磁性颗粒。
- 分散工艺：球磨 / 超声 + 表面活性剂（PVP 等）+ 流变改性，获得触变性与抗流挂。
- 微通道侧：空化喉部让气泡溃灭打散团聚（CN118890850A）；通道截面要留堵塞裕度。
- 系统侧：电磁阵列、辅助换热器（磁流体励磁热）、过滤与在线粒度监测。
- 服役验证：高速泵送 ↔ 静置循环、冷热冲击、金属溶出、电气绝缘。

**代表专利 / 公开文本**

| 公开号 | 权利人 | 要点 |
|---|---|---|
| CN118890850A | — | 水力空化流道，纳米流体自分散，防沉降 |
| CN122278447A | 山东烯力 | 石墨烯 + SWCNT，三元流变体系，抗流挂 |
| CN113488444B | 华中科技大学 | 纳米磁流体 + 电磁阵列，芯片热点定点冷却 |
| 202310386028（公开文本） | — | 纳米相变胶囊 + 反向热泳，微通道衬底 |
| CN122055001A | — | 冷板表面原位铜纳米线阵列替代涂覆 TIM（界面，非工质） |

**专利布局特征**  
中国高校与材料公司申请活跃，美欧数据中心主供应商很少把纳米流体写成产品核心——这本身说明**工程化成熟度不足**。若布局，应写“稳定配方 + 与特定流道的防堵结构 + 泵/滤兼容”，而不是“加入纳米颗粒提高热导”这种易被驳回的效果声称。

### 3.7 加工工艺：机加工与 3D 打印

完整表、原图与按 SKU 选产线见 HTML 第 3.7 节。结论如下。

**三条产线不要混：**

| 产线 | 开流道 | 封流道 | 角色 |
|---|---|---|---|
| 机加工量产 | 铲齿、CNC、微钻 | 真空钎焊（质）/ 隧道炉（量） | H100–B300 出货 |
| 蚀刻 + 扩散焊 | 30–200 μm 平面流道 | 真空扩散焊、镀层 | MLCP / Rubin 盖板 |
| 金属增材 | LPBF / ECAM | 去粉、HIP、密封面机加 | 异形喷嘴、MMC 样件、拓扑验证 |

**机加工：** 铲齿翅厚常见 0.2–0.5 mm，翅根无钎缝；CNC 通道常见 0.3–1.0 mm；钎焊可封到约 200 μm。做不到三维内歧管和人字/旋流孔。接触面平面度 ≤0.05 mm、*Ra* ≤0.8 μm。原图：SciOpen 图 8（盖板+底板）、Energies 2026 Fig. 9（装配栈）。

**3D 打印：** 价值是封闭内歧管、异形孔、生成式流道，不是替代铲齿降成本。LPBF 短板是残粉、*Ra* 数十 μm、铜导热打折。原图：SciOpen 图 6（SEM 粉末）、Energies 2026 Fig. 8（增材 MMC）、Energies 2024 Fig. 3（人字喷嘴）、arXiv:2604.10941 Fig. 2（平行槽 vs 生成式）。

**按英伟达选工艺：** B300 TGP 走铲齿+真空钎；1400 W / R100 走机加底板 + 蚀刻或增材喷嘴板；整板打印不作出货基线。推荐混合工艺与方案 A/B 对齐。

**专利：** 权项要带可制造约束（最小水力直径、可冲洗死区、压降窗）。增材优先写去粉/反冲洗和打印+机加混合，不要只写“3D 打印微通道”。买 SLM 补不了台湾蚀刻+扩散焊缺口。

---

## 4. 横向对比

### 4.1 性能与工程约束（量级，非承诺指标）

| 维度 | 微翅片/铲齿 | 微通道 / MLCP | 冲击射流 | 金刚石 | 纳米流体 |
|---|---|---|---|---|---|
| 主要作用 | 扩展对流面积 | 极限对流 + 短热路 | 局部破边界层 | 横向均热 | 提高工质物性 |
| 商业热流能力 | 约 50–150 W/cm² | 约 100–300 W/cm²；实验室 790 | 约 200–500；杂交两相 1100+ | 取决于下游对流；键合目标 1 kW/cm² | 相对基液 +10–40% HTC |
| 压降 | 中高 | 高（微米级很高） | 喷嘴局部高、系统中等 | 不直接决定 | 粘度上升则升高 |
| 均温性 | 沿程较差 | 直通道较差，分形/歧管较好 | 滞止区好、阵列干涉差 | 最好（均热） | 弱 |
| 堵塞风险 | 中 | 高 | 中（喷嘴） | 低 | **很高** |
| 泄漏/可靠性 | 成熟 | MLCP 极严 | 直接接触方案严 | 界面脱层 | 磨损与腐蚀 |
| 成本 | 低 | 中高 | 中高 | **很高** | 中（流体）+ 高（验证） |
| 产业化 | 已规模量产 | 高端导入 / MLCP 验证 | 小规模商用 | 导入期 | 实验室–中试 |
| 与 AI 2 kW 芯片匹配 | 需很大流量或液金 TIM | **主路径** | 热点补强 | **强烈建议叠加** | 谨慎试点 |

### 4.2 工艺门槛对照

| 工艺能力 | 铲齿冷板 | 微通道 MLCP | 微射流 | 金刚石嵌件 | 纳米工质 |
|---|---|---|---|---|---|
| 微米级蚀刻 | 不必 | **必须** | 喷嘴板需要 | 抛光/图形化 | 否 |
| 真空扩散焊 | 可选 | **必须（高端）** | 视结构 | 金属化键合 | 否 |
| 真空钎焊 | **主流** | 中端可用 | 可用 | 慎用（污染界面） | 否 |
| 半导体洁净 | 工业级 | **半导体级** | 高 | 高 | 配方洁净 |
| 材料科学 | 铜合金 | 铜/硅 | 铜/不锈钢 | **CVD + 界面冶金** | 胶体化学 |
| 认证周期 | 短 | 长（芯片厂+GPU 厂） | 中 | 长 | 很长（寿命） |

### 4.3 杂交才是专利与产品的交汇点

公开文本里重复出现的“能写又能做”的组合：

1. **倾斜/阵列射流 + 肋化或微通道排液**（US10244654，Sung-Mudawar 路线）
2. **中心射流 + 离心/分形微通道**（浪潮 CN113871359A）
3. **按热图分区：射流 / 微通道 / 拓扑流道混用**（华为 WO2026103052A1）
4. **金刚石或 Cu-Diamond 嵌件 + 铜微通道/铲齿**
5. **微通道 + 旁通/SMA 或双金属自适应**（CN120597664，US12193201）
6. **盖板微通道（去 TIM2）+ 液态金属 TIM1 + 金刚石均热**

单纯纳米流体与单纯直通道，授权和产品价值都偏低。

---

## 5. 地域、标准与供应链含义

### 5.1 地域

- **美国**：结构与封装基础专利最厚（IBM、Intel、NVIDIA、JetCool），诉讼与许可风险最高。
- **欧洲**：EPO 数据完整，Element Six、IMEC、ABB、Google EP 家族需纳入监控。
- **日本/韩国**：材料、封装、金刚石 interposer（Samsung）值得单独建库。
- **中国大陆**：申请量大、系统级与应用结构强，**制造工艺专利（扩散焊夹具、蚀刻液、在线检漏、微喷嘴板）相对少**，这是可补的空档。
- **中国台湾**：不一定专利数量最多，但卡在 NVIDIA 认证与 know-how，实际构成市场壁垒。

### 5.2 标准与“事实标准”

- 曙光数创牵头国标《数据中心冷板式液冷系统技术规范》，偏系统接口、安全、检测。
- NVIDIA 供应商认证、漏液、洁净、压降–流量曲线，是比国标更硬的**事实标准**。
- ASHRAE 液冷进液温度、ODCC / Open Compute 快接头与二次侧规范，决定冷板接口尺寸，间接影响权利要求中的“连接环/水嘴”布局。

### 5.3 大陆供应链的真实缺口

公开产业评论的判断与专利文本一致：

- 快接头、歧管：国产突破较早。
- 冷板本体（铲齿）：能做，性能上限不够。
- **MLCP**：蚀刻 + 扩散焊 + 镀金双件盖板，仍主要在台湾认证产线。
- 冷却液与纳米工质：专利多、上架少。
- 金刚石：材料专利多，与 GPU lid 公差链、TIM1 共设计的系统专利少。

---

## 6. 空白点、风险与建议布局

### 6.1 相对空白（更值得写、也更值得做）

1. **可制造的拓扑/分形流道**：算法专利已出现，缺的是“阈值化后仍能蚀刻/打印、能清洗、能检漏”的工艺权利要求。
2. **射流供液 + 微通道回流的一体化歧管**，特别是适配 chiplet 多热点、且压降落在现有 CDU 曲线内。
3. **Cu-Diamond 或 CVD 嵌件与铜微通道的低热阻连接**（避开铬键合独立权项）。
4. **去 TIM2 盖板的翘曲–密封–镀层**工艺（这是 Rubin 供应链正在付费验证的点）。
5. **防堵设计**：旁通、可反冲、可拆喷嘴板、对纳米或腐蚀产物不敏感的最小通道尺寸。
6. **在线热图感知 + 分区流量**（传感器或无源自调节），比再申请一条蛇形槽更有区分度。

### 6.2 高风险雷区（申请前必须做 FTO）

- IBM / Intel 微通道与微射流歧管基础家族
- Asetek / CoolIT 服务器冷板与快接头相关家族（视目标市场）
- JetCool 微射流直接接触与喷嘴共位
- Element Six 金刚石铬键合
- NVIDIA 智能冷板与盖板一体化相关后续家族（持续监控）

### 6.3 分阶段建议

**0–12 个月（守住出货）**

- 以铲齿/微翅片为基线，做**非均匀节距 + 中心射流盖板**，对标浪潮射流冷板与 Intel 开孔架构，做中文+PCT。
- 同步建立氦检、颗粒度、离子、钎料溢流的工艺数据包，把 know-how 写成方法权项。

**12–24 个月（跟上 MLCP）**

- 投资或联合蚀刻 + 扩散焊产线，目标通道 100–200 µm，先做独立冷板再做 lid 一体化。
- 专利写“蚀刻–清洗–扩散焊–镀层–检漏”连续工艺，而不是只写流道形状。
- 对 NVIDIA/AVC/Jentech 公开结构做家族监控，避免把认证规格直接写进权利要求。

**24–36 个月（材料差异化）**

- 金刚石/铜嵌件放在 GPU 热点正上方，外围仍用铜微通道；界面走梯度碳化物或玻璃相，规避 Cr 独立权项。
- 纳米流体只做**特种工况或军工/航天**中试，数据中心主循环继续用成熟水–乙二醇配方。

**申请策略**

- 国内先发明公开，12 个月内 PCT，指定 US/EP/JP/KR/TW。
- 结构、工艺、检测分三件，避免一件里既窄又容易被分案驳回。
- 权利要求用**热流密度分区、压降上限、可清洗最小水力直径**等工程量限定，减少“效果型”表述。

---

## 7. 核心专利速查（抽样）

完整字段与链接见同目录 `appendix_核心专利清单_20260907.md`。下表仅列本报告引用的骨架专利。

| 方向 | 公开号 | 申请人/权利人 | 区域 |
|---|---|---|---|
| 微通道冷板架构 | US12133357B2 | Intel | US |
| 微通道+热管智能冷板 | US12477696 | NVIDIA | US |
| 封装级微射流+微通道 | US20200227341A1 | Intel 体系 | US |
| 旁通可控微通道 | CN120597664A/B | 广东蓝锐 | CN |
| 多级分配微通道 | CN109104844B | 中航雷华 | CN |
| 分区混构冷板 | WO2026103052A1 | 华为 | PCT |
| 铲齿/针肋制法 | US9795057 | — | US |
| 交替微肋 | US12494408 | — | US |
| 自适应双金属肋 | US12193201 | — | US |
| 离心微通道+射流 | CN113871359A | 浪潮 | CN |
| 微射流共位 | WO2020210587A1 | JetCool | PCT |
| 直接接触微射流 | US11844193 | JetCool | US |
| 倾斜射流+肋槽 | US10244654 | — | US |
| 近边缘射流 | US11310937 | — | US |
| 射流+旁通 | US12255124 | — | US |
| 金刚石铬键合 | WO2016087243A1 / US10403557 | Element Six | WO/US/EP |
| 金刚石铜冷板 | CN122161445A | — | CN |
| 金刚石铜热压工艺 | CN122503683A | — | CN |
| 大尺寸金刚石/铜 | CN111500892B | — | CN |
| 纳米流体空化自分散 | CN118890850A | — | CN |
| 抗流挂纳米流体 | CN122278447A | 山东烯力 | CN |
| 纳米磁流体热点 | CN113488444B | 华中科技大学 | CN |

---

## 8. 方法局限与下一步

1. **未做全库家族去重与引证网络**。正式立项前，建议用智慧芽 / IncoPat / PatSnap / Derwent 按第 1.3 节检索式导出，做：申请趋势、家族规模、法律状态、引证爆炸点、权利要求树。
2. **未做权利要求逐条比对**，不能代替 FTO。进入开模或送样 NVIDIA/华为/浪潮规格前，应委托专利律师对目标市场做无效检索。
3. 厂商热流与热阻数据存在口径差（芯片面积、进液温度、流量、是否含 TIM）。对比时必须统一边界。
4. 建议下一轮交付三份配套件：  
   - 目标产品的**权利要求对照表**（自家方案 vs 第 7 节骨架专利）；  
   - **工艺 FMEA**（扩散焊堵孔、盖板泄漏、金刚石脱层、纳米沉降）；  
   - **监控清单**（NVIDIA、Intel、JetCool、Element Six、华为、浪潮，月更）。

---

## 9. 主要公开信息来源

1. Ott, Wenzel, Radgen, *Analysis of Cooling Technologies in the Data Center Sector on the Basis of Patent Applications*, Energies 2024, 17, 3615.  
2. Future Market Insights, Direct-to-Chip Cold Plate Market（2026–2036 公开摘要）。  
3. Tuckerman & Pease, 1981；Sung & Mudawar, *Int. J. Heat Mass Transfer* / *J. Heat Transfer* 杂交射流–微通道。  
4. 浪潮信息，2024-12-12，“布局四大专利群”。  
5. 曙光数创 2025 年报/研报公开专利与标准口径。  
6. 华为 WO2026103052A1；CloudMatrix 液冷拆解公开文。  
7. JetCool SmartPlate 产品页及 WO2020210587A1、US11844193。  
8. Element Six WO2016087243A1 / US10403557；公司热管理产品说明。  
9. NVIDIA US12477696；Rubin/MLCP 供应链公开报道（ITES、fiisual 等）。  
10. 微软微流体冷却公开实验口径；Corintis Glacierware arXiv:2408.15024。  
11. CNIPA / Google Patents 上列 CN、US、WO 公开文本。  
12. PatSnap 公开景观文：液态金属冷却、金刚石功率器件与热管理（2025–2026）。

---

**免责声明**：本报告基于 2026-09-07 前可获得的公开专利与产业信息，用于研发与知识产权策略讨论。专利法律状态、权属、保护范围以官方登记与授权文本为准。实施任何结构或工艺前，应完成正式检索与律师评估。
