bruce2012lu/AIDCtms_design202609/Bp/tools/客户访谈提纲_采购与责任_20260905.md

# 客户访谈提纲｜液冷 CDU 采购流程、验收、责任与付款

**版本：** v1.0 / 2026-09-05
**用途：** 取得"缺口一（可得份额）、缺口二（价格）、缺口三（责任）、缺口四（现金）"的一手客户证据
**访谈对象分类：** ①中小云／算力服务商　②区域 IDC／Colo　③电信运营商（省公司/集团）　④OEM／服务器厂商　⑤EPC／系统集成商

---

## 使用规则（访谈前必读）

1. **每类对象 10–15 题，一次访谈控制在 45–60 分钟。** 若时间有限，优先问带 ★ 的题（每类 4–5 题），它们直接对应 G1 门禁的最小验证集。
2. **全部为开放式问题。** 如对方给出"是/否"，必须追问"能否举一个具体项目的例子""当时具体是怎么操作的"。
3. **绝不引导。** 不要说"业内一般是 30% 预付款，你们呢"——这会污染证据。改问"你们上一个液冷项目的付款是怎么分段的"。
4. **数字必须问到出处。** 对方给出任何数字，追问"这是合同里写的，还是估计的""能否提供文件或截图"。记录时标注 `合同/口述/估计`。
5. **不承诺、不报价、不签任何文件。** 本轮是取证，不是销售。
6. **访谈记录格式：** 每题记录 `原话摘录 + 证据性质（合同/口述/估计）+ 是否可提供文件 + 置信度`。
7. **不得把单个客户的回答外推为行业惯例。** 客户访谈证据仅对该客户有效，有效期 6 个月。

---

## 通用开场（所有对象）

> "我们在做冷板式液冷 CDU 的产品定义，想了解真实项目里的采购和验收是怎么走的。今天我不推销，只想听你们的实际做法，尤其是那些和公开招标文件写的不太一样的地方。我会记录，但不会对外披露贵司名称和具体项目。有什么不方便说的您直接说跳过。"

---

## 一、中小云／算力服务商（10–15 题）

**画像：** 单项目 0.5–3 MW，决策链短，多为存量改造或新建小集群，价格敏感，服务半径要求高。这是阶段一最可能的目标客户层。

1. ★ 你们最近一个上了液冷的集群，从最初有这个想法到设备进场，中间经过了哪些环节？谁在哪一步说了最终的话？
2. ★ 那个项目的 CDU 是你们自己选的，还是服务器厂商/OEM 指定的？如果是指定的，指定到什么程度——指定品牌、指定型号，还是只给参数要求？
3. 你们现在有多少机柜是液冷的，单柜液体负荷大概在什么水平？这些柜里跑的是什么平台？
4. 如果我们要给你们报价，你希望报价包含到哪一步？只给 CDU，还是要连二次管路、工质、安装、和 IT 柜的对接一起做？
5. ★ 上一个项目从下单到你们付完最后一笔钱，一共分了几次付？每一次是什么条件触发的？（追问：有没有预付款？质保金留多少、留多久？）
6. 发票开出来之后，你们财务实际上多久付钱？和合同写的账期差多少？
7. 你们的验收是怎么做的？有没有第三方测试？带载测试是用真实业务负载还是模拟负载？验收从设备到场到签字一般拖多久？
8. ★ 如果 CDU 漏液，把一台服务器或者一块 GPU 板子弄坏了，你们期望供应商赔到什么程度？停机造成的业务损失算不算在里面？
9. 你们买设备的时候会不会要求供应商提供产品责任险？保额一般要求多少？有没有因为供应商保额不够而否掉过一家？
10. 你们对响应时间和换件时间有什么要求？如果供应商在你们所在城市没有备件库，是直接不考虑，还是可以接受别的安排？
11. ★ 什么情况下你们会换掉一个现有的液冷供应商？能举一个真实的例子吗？
12. 你们评估一个新供应商，最看重什么？如果一家技术过关但没有同类业绩，有没有可能给它第一个机会？在什么条件下？
13. 你们做过付费的 PoC 或者样机验证吗？谁出钱？周期多长？做完之后转成订单的比例大概是多少？
14. 你们内部有没有合格供应商名录？进名录要走什么流程，一般要多久？
15. 除了价格，你们在液冷这件事上最头疼的是什么？

---

## 二、区域 IDC／Colo（10–15 题）

**画像：** 自持机房，租户驱动，对可用性和 SLA 极敏感，责任分配复杂（设施方 vs 租户）。

1. ★ 你们上液冷是租户要求的，还是你们主动做的？如果是租户要求，租户对 CDU 有没有指定权？
2. 你们的液冷是按机房整体设计一次做完，还是按租户需求分批加？分批加的话，采购是怎么走的？
3. ★ CDU 是你们采购（OFCI）还是总包采购（CFCI）？为什么这么分？
4. 你们和租户之间，冷却系统故障的责任是怎么划分的？如果冷却液漏了把租户的服务器弄坏了，合同里怎么写？
5. ★ 你们和租户的合同里，间接损失（停机、业务中断、SLA 罚款）是排除的还是包含的？有没有责任上限？大概是合同额的什么比例？（追问：能否看到条款结构，不需要金额）
6. 你们买 CDU 的时候，要求供应商承担的责任上限是多少？和你们对租户承担的责任是背靠背的吗？如果不是，中间的差额谁承担？
7. 你们的财产险和业务中断险，冷却液泄漏造成的服务器损坏是明确承保的吗？有没有被保险公司以"污染"或"渐变渗漏"为理由拒过？
8. ★ 你们上一个液冷设备采购的付款是怎么分段的？终验的条件是什么？有没有"收到租户付款才付"这类条款？
9. 你们的验收有没有第三方参与？带载测试怎么做？验收报告谁签字？
10. 质保期你们要求多长？质保金留多少，能不能用银行保函替换？
11. 你们对供应商的现场服务有什么硬性要求（响应时间、换件时间、驻场、备件库位置）？
12. 一个新供应商要进你们的供应商库，需要什么资质？有没有"同类项目业绩金额"的门槛？具体多少？
13. ★ 你们评估过换供应商吗？触发条件是什么——是价格、是质量事故，还是交期？
14. 你们现在用的 CDU 出过什么问题？漏液、堵塞、泵故障、控制误报，哪种最多？
15. 如果一家新供应商愿意做付费 PoC，你们会接受吗？在什么条件下？

---

## 三、电信运营商（省公司／集团）（10–15 题）

**画像：** 公开招标，流程刚性，业绩门槛高，框架集采+份额分配，价格由限价机制压制。是阶段一最难进入但样本最公开的一类。

1. ★ 液冷 CDU 是省公司自己招，还是集团集采？两者的分工是怎么定的？什么规模以上必须走集团？
2. 一个液冷 CDU 项目从技术规范征求意见到中标，一般走多久？中间有哪些必经环节？
3. ★ 投标的资格门槛里，"同类项目业绩"具体怎么算——是合同金额、是台数，还是容量？一个从来没做过运营商项目的厂商，有没有可能通过联合体或分包进来？
4. 报价控制是用总价最高限价还是单价最高限价？限价是怎么定出来的——参考历史中标价、市场询价，还是成本测算？
5. ★ 一个项目的招标范围通常包到哪一步？CDU 本体、二次管路、工质、安装调试、和 IT 柜对接、深化设计，哪些在标内哪些在标外？
6. 中标之后的价格是固定的，还是按实际发生结算？框架合同的份额，历史上实际下单兑现率大概是多少？
7. ★ 付款是怎么分段的？到货付多少、初验付多少、终验付多少？质保金留多少、留多久？发票账期从哪一天起算？
8. 履约保证金比例多少？能不能用保函替代现金？质保金能不能用质量保函替换？
9. 验收流程是什么？有没有第三方测试？终验的实际时间和合同写的差多少？最长拖过多久？
10. ★ 如果 CDU 漏液损坏了服务器，合同里责任怎么写？有责任上限吗？间接损失（业务中断）是排除的吗？
11. 你们要求供应商提供什么保险？保额有没有硬性要求？
12. 现场服务有什么硬性要求（响应时限、换件时限、备件库、驻场）？是否要求在本省有服务点？
13. 除了 CDU 本身，你们对 PoC、样机测试、第三方检测有什么要求？谁出费用？
14. ★ 有没有 CDU 供应商因为质量或交期问题被处理过？处理方式是什么（扣款、降份额、清退）？
15. 你们现在对液冷最关心的技术指标是什么？未来两年的采购节奏大概是什么样？

---

## 四、OEM／服务器厂商（10–15 题）

**画像：** 平台定义者，掌握 qualification 门禁，是"OEM 指定"这一份额解锁事件的关键对象。

1. ★ 你们的整柜方案里，CDU 是你们自己供，还是客户自己买？如果客户自己买，你们对客户选什么 CDU 有多少发言权？
2. 你们有没有 CDU 的合格供应商名录？一家新的 CDU 厂商要进这个名录，要走什么流程？
3. ★ 那个流程一共几步，每一步要交什么东西，全部走完一般要多久？（追问：有没有过最快的例子？最慢的？）
4. 你们的供应商体系认证和具体某个平台的物料选型认证，是两件独立的事吗？过了体系认证，是不是每个新平台还要重新做？
5. ★ 认证里你们最看重什么——热工性能、水力曲线匹配、材料兼容、故障态能力、可靠性数据，还是产能和服务？哪一项最容易让厂商挂掉？
6. 你们会给候选 CDU 厂商提供什么资料？site-planning 包、Q–ΔP 曲线、接液材料清单，这些是公开的还是要签 NDA 之后才给？
7. 样机验证阶段谁出钱？你们会付 NRE 吗？还是要供应商自己承担？
8. ★ 通过认证之后，能拿到订单吗？还是只是获得投标资格？从通过认证到第一个 PO，一般多久？
9. 你们会给一个新供应商多少份额？有没有"第一年只给试单量"这样的惯例？
10. 你们和 CDU 供应商之间，漏液损坏服务器的责任怎么划分？你们要求供应商承担的责任上限是多少？
11. 你们要求 CDU 供应商提供什么保险？有没有要求把你们列为附加被保险人？
12. 你们对 CDU 供应商的全球服务能力有什么要求？如果一家厂商只能覆盖中国，能不能只做中国项目？
13. ★ 换 CDU 供应商的成本高吗？换一家要重新做多少验证？什么情况下你们会主动换？
14. 你们对下一代平台（更高功率、更高回液温度）的 CDU 有什么新要求？现在的供应商里有几家能跟上？
15. 一家新进入者最现实的切入方式是什么？直接做 CDU，还是先做部件、先做某个区域、还是先和你们的服务伙伴合作？

---

## 五、EPC／系统集成商（10–15 题）

**画像：** 项目总包，承接责任并向下分配，是新进入者最现实的第一层客户，也是"pay-when-paid"风险的来源。

1. ★ 你们做液冷项目时，CDU 是自己采购还是业主指定？业主指定的比例大概多少？
2. 你们选 CDU 供应商，最看重什么？有没有"必须有过 N 个同类项目"这样的硬门槛？
3. ★ 你们和 CDU 供应商签的分包合同，付款是怎么分段的？有没有"收到业主付款才付供应商"的条款？
4. 如果业主验收拖延，你们会把这个风险传给 CDU 供应商吗？怎么传？
5. 你们要求 CDU 供应商承担的责任上限是多少？和你们对业主承担的责任是背靠背的吗？
6. ★ 漏液损坏 IT 设备的责任，在业主—你们—CDU 供应商三方之间是怎么划的？有没有过实际争议的案例？
7. 你们要求 CDU 供应商提供什么保险？安装工程一切险由谁投？
8. 安装、调试、SAT 是你们做还是供应商做？如果是供应商做，你们怎么定价——按人天、按台，还是包干？
9. ★ 一个典型的液冷项目，CDU 本体占项目总价的比例大概是多少？二次管路、工质、安装分别占多少？
10. 你们在报价的时候，CDU 是按什么口径比价的——按台、按 kW，还是按整个包？
11. 交期你们怎么要求？下单后多少天到货？延期怎么罚？
12. 你们对供应商的现场服务有什么要求？质保期内的现场问题谁去处理？
13. ★ 一家新的 CDU 供应商，怎么才能进你们的短名单？有没有可能先做一个小项目试试？在什么条件下？
14. 你们做过海外液冷项目吗？海外和国内在价格、责任、验收上最大的差别是什么？
15. 你们和 CDU 供应商合作时，最常出问题的地方是什么？

---

## 六、跨对象追问库（按缺口分组）

> 任何对象给出相关话题时，用这些追问深挖。

### 缺口一｜可得份额
- 一家没有同类业绩的供应商，历史上有没有进来过？当时是什么条件让你们破例的？
- 你们的供应商名录上现在有几家 CDU 厂商？最近两年新进了几家、清退了几家？
- 份额是怎么分的？第一年给新供应商的量一般是多少？

### 缺口二｜价格
- 你们上一个项目 CDU 的成交价，折算成"元每千瓦"大概是多少？（追问：这个数含不含管路、工质、安装？）
- 同一个容量的 CDU，你们两年前买和现在买，价格差多少？
- 国内厂商和海外厂商报价差多少？差价主要在哪一项上？
- 你们内部有没有价格参考基准？是怎么定的？

### 缺口三｜责任
- 合同里的责任上限，你们通常写成合同价的百分之多少？（说明：不需要金额，只想知道结构）
- 间接损失排除条款有没有例外项？哪些情形是穿透排除的？
- 你们有没有实际发生过漏液索赔？当时怎么处理的，赔了多少比例？
- 保险公司在液冷这件事上有没有提出过额外要求或者除外责任？

### 缺口四｜现金
- 有没有预付款？如果有，要不要保函？保函谁出费用？
- 从终验签字到钱到账，实际上最长过多久？
- 质保金能不能用保函换？换的条件是什么？
- 如果项目延期，是谁承担资金占用成本？

---

## 七、访谈记录模板

| 字段 | 内容 |
|---|---|
| 访谈日期 | |
| 对象类型 | ①中小云 ②IDC ③运营商 ④OEM ⑤EPC |
| 受访人角色 | 技术/采购/项目/财务/管理层 |
| 是否有决策权 | 有/无/部分 |
| 访谈方式 | 面谈/电话/线上 |
| 时长 | |
| **本次取得的可用证据** | 逐条列出，每条标注 `合同/口述/估计` |
| 对方承诺可提供的文件 | |
| 与已有假设冲突之处 | **必须单列** |
| 需要二次确认的点 | |
| 本次访谈对四个缺口的贡献 | 缺口一/二/三/四 分别评 `强/中/弱/无` |
| 置信度 | 0–1 |
| valid_until | 访谈日 + 6 个月 |

---

## 八、访谈完成标准（用于判断证据是否足够）

| 缺口 | 最低样本要求 | 达成判据 |
|---|---|---|
| 一｜可得份额 | ≥2 个客户 + ≥1 个 OEM 或 EPC | 取得至少一条"新供应商破例进入"的具体路径 |
| 二｜价格 | ≥2 个可折算元/kW 的成交价，且供货边界明确 | 两个样本的供货边界可拆分对比 |
| 三｜责任 | ≥1 份客户书面责任条款结构（可脱敏金额） | 责任上限、间接损失排除、漏液归责三项均有明确表述 |
| 四｜现金 | ≥1 份客户书面付款条款 | 预付款、里程碑比例、账期起算日、质保金四项明确 |

**未达上表标准前，不得把访谈内容写入决策模型的基准值；只能进入敏感性分析的情景区间，并标注来源为"单一客户访谈，仅对该客户有效"。**
