bruce2012lu/AIDCtms_design202609/coolingplate/agent/practice01_0926/plan/实施计划_v1.0.md

# AI 驱动算力液冷系统设计平台 · 实施计划 v1.0

> 文档编号 AIDC-CP-PLAT-IMPL-001 · 版本 v1.0 · 2026-10-02 · 配套《项目规划_v1.0》
>
> 用法：你每次下一条指令（如"执行 S0.1"），智能体只做这一步，交付后等你验收；验收通过的方法与数字再沉淀为 skill 与 memory。Markdown 是唯一源文件，HTML 版由 `plan/build_html.py` 生成。

## 0 执行规则

### 0.1 单步执行循环

每一步都按同一个循环走：

1. **接指令**：你说"执行 S0.1"这类步骤编号，可附带修改意见。
2. **启动引导**：智能体读 `platform/CLAUDE.md`、`agent.md`、`memory/index.json` 中未过期且 `confidence ≥ 0.6` 的 semantic，以及该步骤列出的输入。
3. **执行**：只做本步骤；产物进 `runs/<时间戳>-<设计点>-<步骤>/` 或本步指定目录；不碰冻结 yaml 与已发放 STEP。
4. **交付**：给出"结论 + 证据等级 + 数字与来源 + 未冻结项 + 产物路径"，并自检验收标准。
5. **你验收**：通过 / 修改 / 否决。
6. **沉淀**：通过后写 episodic；新口径写 semantic 草案；新方法写 skill 草案。semantic 与 skill 在你确认后才定稿（见 §11）。
7. **提交提示**：关键步骤后生成 git 提交信息草案（`<type>(cp-design): <summary>`），真实 commit/push 由你在 GitKraken 中执行。

### 0.2 步骤卡字段说明

| 字段 | 含义 |
|---|---|
| 目标 | 这一步要回答的问题或交付的能力 |
| 输入 | 必须读取的文件、数据或前置步骤产物 |
| AI 与工具 | 智能体用什么工具、技能、外部软件 |
| 交付物 | 文件路径与格式 |
| 验收标准 | 你据此判定通过；含闸门 |
| 工时 | AI 执行 / 你审核（小时），求解机时另计 |
| 依赖 | 前置步骤 |
| 沉淀 | 预计产生的 skill / memory |

### 0.3 阶段总览

| 阶段 | 名称 | 步骤数 | 计划周期 | 里程碑 |
|---|---|---|---|---|
| P0 | 平台基线与治理 | 4 | 10-02 至 10-09 | M0 |
| P1 | 需求与输入 | 3 | 10-08 至 10-14 | M0/M1 |
| P2 | 一维设计计算平台化 | 6 | 10-12 至 10-23 | M1 |
| P3 | CAD 概念设计（AI+CAD） | 5 | 10-24 至 11-06 | M2 |
| P4 | 三维 CFD/CAE（AI+Ansys） | 7 | 11-07 至 12-04 | M3 |
| P5 | 工程图（AI+CAD） | 4 | 12-05 至 12-18 | M4 |
| P6 | 试验验证 | 4 | 12-10 至 2027-01-15 | M5 |
| P7 | 数字孪生 | 4 | 2027-01-04 至 02-26 | M6 |
| P8 | AI 在环控制 | 6 | 2027-02-01 至 03-31 | M7 |
| P9 | 平台集成与发布 | 3 | 贯穿，每里程碑一次 | 各 M |

## 1 P0 平台基线与治理

### S0.1 资产盘点与口径对账表（首步，可立即执行）

| 字段 | 内容 |
|---|---|
| 目标 | 把散落在报告、记忆、脚本、yaml 中的关键数字收成一张对账表，标出每个数字的设计点、证据等级、来源与冲突 |
| 输入 | `references/` 全部报告；`memory/semantic/*.md`；`cad/params/cp_b300_jm01.yaml`；`runs/20260926-140511/params.yaml`；`design/calc/model.py`（GEO、DESIGN_POINTS）；`cycle-20260926/out/cycle.json` |
| AI 与工具 | Python 脚本抽取 HTML 表格与 model.py 常量；MCP `oned_design`/`hbm_design`/`grace_design` 复算 DP-A、DP-B；人工可读的差异标注 |
| 交付物 | `plan/S0.1_口径对账表.md` 与 `.html`；`spec/ledger.json`（机器可读：参数、值、单位、设计点、证据等级、来源、日期） |
| 验收标准 | ① 覆盖功率拆分、工质、流量、孔径/孔数/节距、热阻、压降、HBM 方案、Grace 共 ≥ 40 个参数；② 每个冲突都列出（至少包含 D0.50 vs D0.40、水 vs PG25、1100 vs 1400 W、HBM 横流 vs 方案 D、Grace 孔板压降超限）；③ 复算值与报告值偏差 < 0.5% 或已解释 |
| 工时 | AI 3 / 你 1 |
| 依赖 | 无 |
| 沉淀 | memory：`semantic/design-point-ledger.md`（草案）；skill：`design-point`（草案） |

### S0.2 设计点登记表与 DesignSpec schema

| 字段 | 内容 |
|---|---|
| 目标 | 依据 S0.1 和你对 Q-01/Q-02 的决定，建立设计点登记表与 DesignSpec schema v0.1 |
| 输入 | S0.1 对账表；你的 Q-01（主设计点）、Q-02（孔径）决定；现有 `cad/params/cp_b300_jm01.yaml` 结构 |
| AI 与工具 | JSON Schema / pydantic 模型；`spec_validate` 原型（Python） |
| 交付物 | `spec/design_points.yaml`（至少 `B300-W-DPA`、`B300-W-DPB`、`B300-PG25-6K`、`GRACE-W`、`GRACE-PG25-6K`）；`spec/designspec.schema.json`；`spec/validate.py`；单元测试 |
| 验收标准 | ① 现有 v1 yaml 能被 schema 读入（v1 字段映射，不改原文件）；② 每个设计点标明状态（候选/锁定/废弃）与证据等级上限；③ 测试通过 |
| 工时 | AI 4 / 你 1 |
| 依赖 | S0.1；Q-01、Q-02 |
| 沉淀 | memory：`semantic/design-points.md`；skill：`design-point` 定稿 |

### S0.3 记忆健康检查

| 字段 | 内容 |
|---|---|
| 目标 | 检查本模块与继承记忆的过期、损坏与冲突；补齐 `evidence`、`design_point` 字段 |
| 输入 | `memory/index.json`；`inherit_from` 三份上游记忆；`design/cfd/uc01b_2.4x3.0lessmesh/memory/semantic/uc01b-lessmesh.md`（中文损坏） |
| AI 与工具 | Python 扫描 frontmatter；与 HTML 结果报告比对 |
| 交付物 | `plan/S0.3_记忆健康报告.md`；更新后的 semantic 草案（差异列表，等你确认再写入） |
| 验收标准 | 列出所有过期/低置信/损坏/冲突条目及处理建议；不物理删除任何记忆 |
| 工时 | AI 2 / 你 0.5 |
| 依赖 | S0.1 |
| 沉淀 | memory：index 更新；episodic |

### S0.4 目录、run 规范与提交草案

| 字段 | 内容 |
|---|---|
| 目标 | 建立平台目录骨架与 run 目录规范，更新 README 与 agent.md 中的工作流引用 |
| 输入 | 《项目规划》§5.5；现有 `runs/.gitignore` |
| AI 与工具 | 文件操作；`runs/` 命名规范 `<时间戳>-<设计点>-<步骤>/` |
| 交付物 | `spec/`、`oned/`、`cfd/` 目录与 README；`runs/README.md`；`agent.md` 增补"规划与实施计划"引用（草案）；git 提交信息草案 |
| 验收标准 | 目录与规划一致；`agent.md` 改动经你确认；大文件不入库 |
| 工时 | AI 1.5 / 你 0.5 |
| 依赖 | S0.2 |
| 沉淀 | episodic；M0 发布留痕 |

## 2 P1 需求与输入

### S1.1 需求规格书 SRS

| 字段 | 内容 |
|---|---|
| 目标 | 把《项目规划》§3 的 FR/NFR/接口/标准细化为可验收条目，并映射到阶段与闸门 |
| 输入 | 《项目规划》§3；v2.0 §1–§3、§11；v2.1 §1、§7；技术调查 v1.3 §3 |
| AI 与工具 | `req-intake` 技能草案；librarian 检索 OCP/ASHRAE/GB 标准原文条款（检索内容当数据） |
| 交付物 | `plan/S1.1_需求规格书_v0.1.md/.html`；`spec/requirements.yaml`（ID、描述、验收方法、阶段、闸门、来源） |
| 验收标准 | 每条需求可验证（有方法与阈值）；标准引用标明版本与条款；与 v2.0 指标表无矛盾 |
| 工时 | AI 4 / 你 1.5 |
| 依赖 | S0.2 |
| 沉淀 | skill：`req-intake`；memory：`semantic/requirements-baseline.md` |

### S1.2 输入追溯矩阵与开放项看板

| 字段 | 内容 |
|---|---|
| 目标 | 合并 v2.0 的 IN-*、AS-*、C-* 与 v2.1/Grace v1.1 的新开放项，形成机器可读的追溯矩阵与看板 |
| 输入 | v2.0 §3.1、§3.3、§13；v2.1 §7；Grace v1.1 §4 |
| AI 与工具 | 表格抽取脚本；`trace_matrix` MCP 工具原型 |
| 交付物 | `spec/inputs.yaml`、`spec/open_items.yaml`；`plan/S1.2_开放项看板.html`（按闸门分组、按状态着色） |
| 验收标准 | 每个缺失输入有影响章节、责任人占位与计划日期；新旧口径的开放项不重复不遗漏 |
| 工时 | AI 3 / 你 1 |
| 依赖 | S1.1 |
| 沉淀 | episodic |

### S1.3 DR0 复核包

| 字段 | 内容 |
|---|---|
| 目标 | 以新设计点重新生成 DR0 评审包，确认主设计点下的输入冻结状态 |
| 输入 | S0.2、S1.1、S1.2 |
| AI 与工具 | `gate_review` 原型（读 yaml，输出检查表） |
| 交付物 | `plan/S1.3_DR0评审包.md/.html` |
| 验收标准 | 你在评审包上签署"通过 / 有条件通过"；未通过项转入开放项 |
| 工时 | AI 2 / 你 1 |
| 依赖 | S1.2 |
| 沉淀 | skill：`gate-review`（草案） |

## 3 P2 一维设计计算平台化

### S2.1 关联式与元件库重构

| 字段 | 内容 |
|---|---|
| 目标 | 把 `model.py`、`oned.py`、`zones.py` 中的关联式与元件抽成带有效域检查的库，不改变任何现有结果 |
| 输入 | `design/calc/model.py`、`oned.py`、`zones.py`、`CP-GRACE-MC-01_calc.py` |
| AI 与工具 | Python 重构；pytest 回归（以 v2.0 §9 与 v2.1 表格为基准值） |
| 交付物 | `oned/correlations.py`（Martin、短槽发展段、Shah–London、驻点核、PG25 物性）、`oned/elements.py`（射流阵、短槽、HBM 槽、静压仓、孔板、UQD、管段）、`oned/tests/` |
| 验收标准 | 回归测试对 v2.0 DP-A/DP-B 全部关键数字误差为 0（或 < 1e-6 相对）；越出有效域时返回 warn 而不是静默外推 |
| 工时 | AI 5 / 你 1 |
| 依赖 | S0.2 |
| 沉淀 | skill：`oned-network`（草案） |

### S2.2 板级网络求解器

| 字段 | 内容 |
|---|---|
| 目标 | 实现板级"热阻网络 + 水力网络"求解：分区流量分配由各支路阻力自洽求出，而不是固定 80/20 |
| 输入 | S2.1 元件库；DesignSpec |
| AI 与工具 | Python（scipy.optimize / Newton）；MCP 新工具 `net_solve` |
| 交付物 | `oned/network.py`；`mcp/server.py` 增加 `net_solve`；计算书模板 |
| 验收标准 | ① 固定分流模式下与 S2.1 结果一致；② 自洽分流模式给出 GPU/HBM 分配与压降分段；③ 能量平衡误差 < 0.1% |
| 工时 | AI 5 / 你 1 |
| 依赖 | S2.1 |
| 沉淀 | memory：`semantic/oned-network.md` |

### S2.3 主设计点一维重算

| 字段 | 内容 |
|---|---|
| 目标 | 按 Q-01 选定的主设计点（如 PG25、1400 W、温升 6 °C）重算 B300 与 Grace：热阻区间、压降、流速、孔速、差距闭合矩阵 |
| 输入 | S2.2；`design_points.yaml` |
| AI 与工具 | `net_solve`、`oned_sweep`；报告流水线 |
| 交付物 | `runs/<ts>-B300-PG25-6K-S2.3/` 与计算书 `plan/S2.3_一维计算书.md/.html` |
| 验收标准 | 每个数字标设计点与 E1；结论明确"通过 / 不判定 / 不通过"；压降是否超 20 kPa 给出带假设的判断；Grace 孔板重配给出候选孔径区间 |
| 工时 | AI 3 / 你 1.5 |
| 依赖 | S2.2 |
| 沉淀 | memory：更新 `b300-design-lock.md`、`grace-and-tray.md`（经确认） |

### S2.4 托盘级水力网络

| 字段 | 内容 |
|---|---|
| 目标 | 建立 4 块 GPU 冷板 + 2 块 Grace 并联、后面板单进单出的托盘网络，评估分流均匀性与总压降 |
| 输入 | S2.2；`grace-and-tray.md`；GB/T 48023 均流判据（支路差 ≤ 平均 10%） |
| AI 与工具 | `net_solve`（托盘拓扑）；敏感性扫描（UQD、管径、孔板） |
| 交付物 | `oned/tray.py`；`plan/S2.4_托盘水力.md/.html` |
| 验收标准 | 给出各支路流量与偏差；不满足均流时给出孔板/管径调整建议；标注 ICD 未到的假设 |
| 工时 | AI 4 / 你 1 |
| 依赖 | S2.2 |
| 沉淀 | episodic |

### S2.5 Simulink/Simscape 对照模型

| 字段 | 内容 |
|---|---|
| 目标 | 由 `ai-matlab` 按同一 DesignSpec 搭建托盘级 Simscape 模型，做稳态交叉验证与瞬态响应，为 ⑧⑨ 准备 |
| 输入 | S2.4；Q-04（MATLAB 许可） |
| AI 与工具 | `ai-matlab` 智能体 + `user-matlab` MCP；Simscape Fluids（Thermal Liquid）；冷板用自定义热阻/压降查表块 |
| 交付物 | `twin/simscape/tray_model.slx`（或 `.m` 生成脚本）；对照报告 `plan/S2.5_Simscape对照.md/.html` |
| 验收标准 | 同工况下流量、压降、出口温度与 Python 网络偏差 < 2%；给出一次负载阶跃的瞬态曲线 |
| 工时 | AI 6 / 你 1.5 |
| 依赖 | S2.4；Q-04 |
| 沉淀 | skill：`simscape-bridge`（与 ai-matlab 共用，需评估是否上升为共享技能） |

### S2.6 一维回归与设计台集成

| 字段 | 内容 |
|---|---|
| 目标 | 把一维网络接入设计台"一维"页，加入回归测试与 DR2 复核包 |
| 输入 | S2.1–S2.4 |
| AI 与工具 | `ui/` 前端；`gate_review` |
| 交付物 | 设计台一维页更新；`plan/S2.6_DR2复核包.md/.html` |
| 验收标准 | 设计台改参数后 1 s 内出结果与判据；DR2 复核包经你签署 |
| 工时 | AI 3 / 你 1 |
| 依赖 | S2.3 |
| 沉淀 | episodic；M1 发布留痕 |

## 4 P3 CAD 概念设计（AI+CAD）

### S3.1 内核增加 pitch_x / pitch_y 与 v2 对账表

| 字段 | 内容 |
|---|---|
| 目标 | 参数化内核支持双节距，新增 v2 规则对账表（216 孔、9×12、Sx 3.0、Sy 2.4），v1 对账表保留不改 |
| 输入 | `cad/coldplate/`（model、rules、geometry）；`knowledge/cad-kernel-gap.md`；S0.2 schema |
| AI 与工具 | build123d/OCP（`cad/.venv`）；pytest；`cad_inspect` |
| 交付物 | 内核补丁（新文件优先，避免改冻结件）；`cad/params/` 下新增 v2 候选 yaml（不覆盖 `cp_b300_jm01.yaml`）；测试 |
| 验收标准 | v1 yaml 结果不变；v2 候选 yaml `gate=pass`；STEP 回读孔数 216、包围盒 95×75×8.5；**G-A 闸门：你确认后才把 v2 设为锁定** |
| 工时 | AI 5 / 你 1 |
| 依赖 | S0.2 |
| 沉淀 | skill：`cad-loop` 升级到 v2；memory：`cad-tracks.md` 更新 |

### S3.2 HBM 方案 D 与静压仓特征

| 字段 | 内容 |
|---|---|
| 目标 | 内核表达 HBM 方案 D（十一条槽并联、中间进水两侧出水、静压仓 z=3–7 mm、11 条 0.40×1.00 mm 中缝） |
| 输入 | `memory/semantic/b300-design-lock.md`；S3.1 |
| AI 与工具 | build123d；规则门新增：齿壁 ≥ 0.30、槽宽 ≥ 0.40、深宽比 ≤ 5、缝速 |
| 交付物 | 内核特征模块与参数；预览 PNG；STEP |
| 验收标准 | 几何与记忆中的尺寸一致；规则门全通过；与 CFD 网格 `hbm_d_slit_lt9m.msh` 的几何对照说明 |
| 工时 | AI 4 / 你 1 |
| 依赖 | S3.1 |
| 沉淀 | episodic |

### S3.3 水嘴、UQD 与安装接口

| 字段 | 内容 |
|---|---|
| 目标 | 增加进出水嘴、UQD 接口占位、四角沉孔、静压箱进液口等接口特征（ICD 未到前为候选） |
| 输入 | v2.0 §6.6、§8.1；`grace-and-tray.md`（芯片朝下、进液边朝后面板） |
| AI 与工具 | build123d；规则门 |
| 交付物 | 接口特征与参数；装配预览 |
| 验收标准 | 特征全部标"候选，待 ICD"；不影响已有尺寸链闭合 |
| 工时 | AI 3 / 你 0.5 |
| 依赖 | S3.1 |
| 沉淀 | episodic |

### S3.4 CFD 流体域抽取与命名选择

| 字段 | 内容 |
|---|---|
| 目标 | 从实体自动生成流体域（单胞、1/2 整板），并输出命名选择（入口、出口、热源面、对称面、交界面） |
| 输入 | S3.1–S3.3 |
| AI 与工具 | build123d 布尔（过切规避共面）；SpaceClaim 脚本做清理与共享拓扑（可选）；MCP `cad_fluid_extract`、`cad_named_selections` |
| 交付物 | `runs/<ts>/fluid_cell.step`、`fluid_half.step`、`named_selections.json` |
| 验收标准 | 流体体积与理论值偏差 < 0.5%；命名选择在 Fluent Meshing 读入后完整 |
| 工时 | AI 5 / 你 1 |
| 依赖 | S3.1 |
| 沉淀 | skill：`mesh-loop`（前半段草案） |

### S3.5 Grace 接入规则门

| 字段 | 内容 |
|---|---|
| 目标 | 把 `design/make_grace_concept.py` 接入共用 Spec 与规则门，形成 `grace-parametric` 轨道 |
| 输入 | Grace v1.0/v1.1；`make_grace_concept.py`；`cad-tracks.json` |
| AI 与工具 | build123d；规则门 |
| 交付物 | Grace 轨道参数与规则；STEP；`cad-tracks.json` 更新草案 |
| 验收标准 | 与 v1.1 几何一致（48×0.40×1.20、节距 0.80、200×120×8）；B300 参数不被混用 |
| 工时 | AI 4 / 你 1 |
| 依赖 | S3.1 |
| 沉淀 | memory：`cad-tracks.md` 更新；M2 发布留痕 |

## 5 P4 三维 CFD/CAE（AI+Ansys）

### S4.1 V1 代码验证与 V4 Martin 锚定算例

| 字段 | 内容 |
|---|---|
| 目标 | 先证明 CFD 设置可信：解析算例（层流圆管 f·Re、层流平板）误差 < 2%；Re≈3000 的单胞复现 Martin 关联式误差 < 15% |
| 输入 | v2.0 §10.9；`cfd-loop` 技能；单胞网格模板 |
| AI 与工具 | Fluent 2026 R1 批处理 journal / PyFluent；`cfd_journal`、`cfd_submit`、`cfd_monitor` |
| 交付物 | `cfd/vv/` 算例与 journal；`plan/S4.1_VV报告.md/.html` |
| 验收标准 | V1 < 2%；V4 < 15%；不达标则停止并分析设置，不进入后续步骤 |
| 工时 | AI 6 / 你 1.5（求解约 4–8 h） |
| 依赖 | S3.4（或沿用现有单胞网格） |
| 沉淀 | skill：`cfd-vv`（草案）；memory：`semantic/cfd-vv-anchor.md` |

### S4.2 单胞网格无关性与模型对照

| 字段 | 内容 |
|---|---|
| 目标 | 主设计点单胞三套网格（1 : 1.5 : 2.25），转捩 SST 与层流对照，收敛判据按 v2.0 §10.8 |
| 输入 | S4.1；现有 m425、bc216、12 层网格日志 |
| AI 与工具 | ICEM 或 Fluent Meshing；PyFluent；GPU 显存规则（≤ 900 万单元才开 `-t1 -gpu`） |
| 交付物 | `plan/S4.2_单胞网格无关性.md/.html`；更新 `cfd-uc01b.md` 草案 |
| 验收标准 | 相邻网格 R、ΔP 差 < 3%；两模型差异报告（> 20% 则结论给区间）；能量守恒 < 1% |
| 工时 | AI 5 / 你 1（求解约 8–16 h） |
| 依赖 | S4.1 |
| 沉淀 | memory：`cfd-uc01b.md` 升级 |

### S4.3 1/2 整板共轭 CFD

| 字段 | 内容 |
|---|---|
| 目标 | 沿 X 中线 1/2 对称整板 CHT，回答 v2.0 §10.1 的 Q1–Q6（热阻真值、逐孔流量、两 die 温差、静压箱压降、驻点偏移、HBM 近壁速度） |
| 输入 | S3.4 `fluid_half.step`；S4.2 网格参数 |
| AI 与工具 | Fluent Meshing（poly-hexcore）；Fluent CPU 并行（网格超 900 万不开 GPU）；`cfd_post` 逐孔统计 |
| 交付物 | `runs/<ts>-B300-*-S4.3/`；`plan/S4.3_整板CFD报告.md/.html` |
| 验收标准 | 收敛与守恒判据满足；六类后处理齐全；证据等级 E3；**G-C 闸门：启动前你确认网格规模与预计机时** |
| 工时 | AI 8 / 你 2（求解 1–3 天） |
| 依赖 | S4.2；Q-03、Q-06 |
| 沉淀 | memory：`semantic/b300-fullplate-cfd.md` |

### S4.4 工况矩阵批处理

| 字段 | 内容 |
|---|---|
| 目标 | 按 v2.0 §10.7（并按主设计点改写）跑 C01–C12，含孔径 D0.40/D0.50 与槽深 0.8/1.0/1.5 变体 |
| 输入 | S4.3 模板 |
| AI 与工具 | 批量 journal；队列调度（夜间运行）；自动汇总表 |
| 交付物 | 全工况汇总 `plan/S4.4_工况矩阵.md/.html`；`summary.csv` |
| 验收标准 | 每个工况收敛；汇总表含 R、ΔP、ΔTf、两 die 温差、HBM 最大近壁速度 |
| 工时 | AI 6 / 你 1.5（求解按工况数） |
| 依赖 | S4.3 |
| 沉淀 | episodic；为 P7 提供 DOE 数据 |

### S4.5 R1 回路：结果回灌一维

| 字段 | 内容 |
|---|---|
| 目标 | 用整板 CFD 反标定一维（静压箱 K 值、短槽强化系数、驻点核面积），并决定是否触发 R1 改几何 |
| 输入 | S4.3、S4.4；S2.2 网络 |
| AI 与工具 | 参数拟合；`calibrate`；杠杆排序 |
| 交付物 | `plan/S4.5_一维反标定.md/.html`；一维模型修正建议 |
| 验收标准 | 修正后一维与 CFD 的 R、ΔP 偏差 < 10%；若不达标，列出 R1 候选几何并经一维预筛 |
| 工时 | AI 4 / 你 1.5 |
| 依赖 | S4.4 |
| 沉淀 | memory：`oned-network.md` 更新；skill：`cfd-vv` 定稿 |

### S4.6 结构 FEA：承压、压装、热变形

| 字段 | 内容 |
|---|---|
| 目标 | 用 Mechanical 校核 3 bar 承压、300–500 N 压装下接触面平面度、CFD 温度场映射后的热变形 |
| 输入 | S3.1–S3.3 实体；S4.3 温度场；v2.0 §6.3–§6.5 |
| AI 与工具 | PyMechanical / Mechanical 脚本；`fea_run` |
| 交付物 | `plan/S4.6_结构分析.md/.html` |
| 验收标准 | 应力安全系数、平面度变化 ≤ 0.05 mm 判定；与解析板条结果对照 |
| 工时 | AI 6 / 你 1.5 |
| 依赖 | S4.3；Q-03 |
| 沉淀 | skill：`fea-loop`（草案） |

### S4.7 DR3（仿真）评审包

| 字段 | 内容 |
|---|---|
| 目标 | 汇总 V&V、整板 CFD、工况矩阵、结构分析，生成 DR3 仿真评审包 |
| 输入 | S4.1–S4.6 |
| AI 与工具 | `gate_review`；报告流水线 |
| 交付物 | `plan/S4.7_DR3仿真评审包.md/.html` |
| 验收标准 | 逐条对照 v2.0 §10.10 交付物清单；你签署 |
| 工时 | AI 3 / 你 2 |
| 依赖 | S4.5、S4.6 |
| 沉淀 | episodic；M3 发布留痕 |

## 6 P5 工程图（AI+CAD）

### S5.1 出图后端扩展

| 字段 | 内容 |
|---|---|
| 目标 | 在内核 DXF 后端基础上生成三视图、剖面 A-A/B-B、射流单元详图、孔位图，按 GB/T 14689 图幅与标题栏 |
| 输入 | 锁定的 v2 几何；v2.0 §8.2 图纸清单 |
| AI 与工具 | build123d 投影 + ezdxf；或 SolidWorks 宏后端（Q-05） |
| 交付物 | `runs/<ts>/drawings/*.dxf` 与 PDF |
| 验收标准 | 图号与 v2.0 §8.2 一致；尺寸与 Spec 一致 |
| 工时 | AI 6 / 你 1.5 |
| 依赖 | S3.3；Q-05 |
| 沉淀 | skill：`drawing-gen`（草案） |

### S5.2 GD&T、技术要求与 BOM

| 字段 | 内容 |
|---|---|
| 目标 | 按 v2.0 §6.5 加注形位公差与技术要求，生成 BOM 与检验要求表 |
| 输入 | S5.1；v2.0 §6.5、§8.11 |
| AI 与工具 | GD&T 规则表（GB/T 1182）；BOM 生成 |
| 交付物 | 带标注的 DXF/PDF；`bom.csv`；检验要求表 |
| 验收标准 | 接触面平面度 0.05、Ra 0.8、孔径 ⌀0.50 +0.03/0、阵列位置度 ⌀0.4 MMC、H 2.0±0.10 等全部标注 |
| 工时 | AI 4 / 你 1.5 |
| 依赖 | S5.1 |
| 沉淀 | memory：`semantic/drawing-standards.md` |

### S5.3 AI 审图

| 字段 | 内容 |
|---|---|
| 目标 | 自动检查尺寸链闭合、Spec 一致性、公差可加工性、焊接符号与检验项完整性 |
| 输入 | S5.2 |
| AI 与工具 | `drawing_review`（读 DXF 实体 + Spec + 规则表） |
| 交付物 | 审图记录 `plan/S5.3_审图记录.md` |
| 验收标准 | 审图问题清单逐条关闭或说明 |
| 工时 | AI 3 / 你 1 |
| 依赖 | S5.2 |
| 沉淀 | skill：`drawing-gen` 定稿 |

### S5.4 DR3（图纸）评审与发放准备

| 字段 | 内容 |
|---|---|
| 目标 | 形成可打样询价的图纸包 |
| 输入 | S5.1–S5.3；S4.7 |
| AI 与工具 | `gate_review` |
| 交付物 | 图纸包（PDF + DXF + STEP + BOM + 技术要求） |
| 验收标准 | **G-B 闸门：你确认后才对外发放** |
| 工时 | AI 2 / 你 2 |
| 依赖 | S5.3 |
| 沉淀 | episodic；M4 发布留痕 |

## 7 P6 试验验证

### S6.1 试验大纲

| 字段 | 内容 |
|---|---|
| 目标 | 依据 v2.0 §11 生成型式试验 T1–T8 与透明样 PIV、流阻、红外的试验大纲，含工况矩阵、传感器布置、不确定度预算 |
| 输入 | v2.0 §11；S4.4 工况；Q-07 |
| AI 与工具 | `test_plan`；不确定度分析（ASME PTC 19.1 方法） |
| 交付物 | `plan/S6.1_试验大纲.md/.html`；加热块与透明样件图（由 P5 后端出图） |
| 验收标准 | 每项试验有判据、方法、仪器精度与扩展不确定度；热阻测量不确定度 < 10% |
| 工时 | AI 4 / 你 2 |
| 依赖 | S4.4 |
| 沉淀 | skill：`test-vv`（草案） |

### S6.2 数据采集 schema 与摄入脚本

| 字段 | 内容 |
|---|---|
| 目标 | 定义试验数据格式（CSV + 元数据 YAML），实现清洗、稳态段识别、物理量换算 |
| 输入 | S6.1 |
| AI 与工具 | Python（pandas）；`test_ingest` |
| 交付物 | `test/schema.yaml`、`test/ingest.py`、示例数据（合成）与测试 |
| 验收标准 | 合成数据端到端处理正确；稳态识别规则可配置 |
| 工时 | AI 4 / 你 1 |
| 依赖 | S6.1 |
| 沉淀 | episodic |

### S6.3 V&V 偏差分析与 R2 回路

| 字段 | 内容 |
|---|---|
| 目标 | 样件试验数据到位后，自动对比 CFD/一维，偏差 > 15% 触发 R2 反标定建议 |
| 输入 | S6.2；S4.4；试验数据 |
| AI 与工具 | `test_vv`、`calibrate` |
| 交付物 | `plan/S6.3_VV偏差报告.md/.html` |
| 验收标准 | 偏差表、不确定度带、反标定建议；模型修改经你确认后执行 |
| 工时 | AI 4 / 你 2 |
| 依赖 | S6.2；**G-D 闸门：样件下单与通电试验由你确认** |
| 沉淀 | skill：`test-vv` 定稿；memory：`semantic/vv-calibration.md` |

### S6.4 DR4 送样放行包

| 字段 | 内容 |
|---|---|
| 目标 | 汇总出厂检验、型式试验、V&V 结果，形成 DR4 评审包 |
| 输入 | S6.3 |
| AI 与工具 | `gate_review` |
| 交付物 | `plan/S6.4_DR4评审包.md/.html` |
| 验收标准 | 你签署 |
| 工时 | AI 2 / 你 2 |
| 依赖 | S6.3 |
| 沉淀 | episodic；M5 发布留痕 |

## 8 P7 数字孪生

### S7.1 DOE 设计与数据集

| 字段 | 内容 |
|---|---|
| 目标 | 设计 ROM 训练用的 DOE（流量、进液温度、功率拆分、工质、孔径、TIM2），复用 S4.4 结果并补点 |
| 输入 | S4.4 `summary.csv`；S4.5 反标定后一维 |
| AI 与工具 | 拉丁超立方 / 自适应采样；一维先行填充，CFD 只补关键点；`rom_doe` |
| 交付物 | `twin/doe.yaml`、`twin/dataset.parquet` |
| 验收标准 | 训练域覆盖主设计点 ±20% 流量、25–45 °C 进液、水与 PG25 |
| 工时 | AI 4 / 你 1（CFD 补点另计） |
| 依赖 | S4.5 |
| 沉淀 | skill：`rom-build`（草案） |

### S7.2 代理模型训练与验证

| 字段 | 内容 |
|---|---|
| 目标 | 训练冷板 ROM：R、ΔP、最高壁温、两 die 温差；必要时 POD 温度场 |
| 输入 | S7.1 |
| AI 与工具 | scikit-learn GPR / PyTorch MLP；或 optiSLang（Q-03）；`rom_train`、`rom_eval` |
| 交付物 | `twin/rom/` 模型文件与验证报告 `plan/S7.2_ROM验证.md/.html` |
| 验收标准 | 留出集误差 < 5%；训练域边界检查，越域报警 |
| 工时 | AI 6 / 你 1.5 |
| 依赖 | S7.1 |
| 沉淀 | skill：`rom-build` 定稿 |

### S7.3 系统级孪生与 FMU

| 字段 | 内容 |
|---|---|
| 目标 | 托盘→CDU 系统模型（Simscape 或 Python 网络），冷板用 ROM 替换，导出 FMU |
| 输入 | S2.4/S2.5；S7.2 |
| AI 与工具 | Simscape → FMU（`ai-matlab`）或 PythonFMU；FMPy 回放验证 |
| 交付物 | `twin/fmu/tray_twin.fmu`；`plan/S7.3_系统孪生.md/.html` |
| 验收标准 | FMU 在 FMPy 中运行；与原模型同工况偏差 < 2% |
| 工时 | AI 8 / 你 2 |
| 依赖 | S7.2 |
| 沉淀 | skill：`twin-calib`（草案） |

### S7.4 在线校准与孪生看板

| 字段 | 内容 |
|---|---|
| 目标 | 实现基于台架/运行数据的参数辨识（h 系数、TIM2、K 值），设计台新增孪生页 |
| 输入 | S7.3；S6.2 数据格式 |
| AI 与工具 | 卡尔曼滤波 / 贝叶斯辨识；`twin_calibrate`；`ui/` |
| 交付物 | `twin/calibrate.py`；设计台孪生页；DR5 评审包 |
| 验收标准 | 合成数据下参数辨识误差 < 5%；有台架数据时偏差 < 10%；DR5 你签署 |
| 工时 | AI 6 / 你 2 |
| 依赖 | S7.3 |
| 沉淀 | skill：`twin-calib` 定稿；M6 发布留痕 |

## 9 P8 AI 在环控制

### S8.1 控制需求与安全约束

| 字段 | 内容 |
|---|---|
| 目标 | 定义被控量、执行器、约束、扰动（AI 训练/推理负载曲线）、性能指标与故障场景 |
| 输入 | 《项目规划》§6.7；S7.3 |
| AI 与工具 | `ctrl-design` 技能草案；thermal-management 协作 |
| 交付物 | `plan/S8.1_控制需求.md/.html`；`ctrl/constraints.yaml` |
| 验收标准 | 约束可机检（Tj ≤ 90 °C、ΔP 上限、露点 +3 K、泵速/阀位范围） |
| 工时 | AI 3 / 你 1.5 |
| 依赖 | S7.3 |
| 沉淀 | skill：`ctrl-design`（草案） |

### S8.2 场景库

| 字段 | 内容 |
|---|---|
| 目标 | 生成 MIL/SIL 场景库：负载阶跃、周期性训练负载、泵故障、单板堵塞 20%、进液 45 °C、传感器漂移 |
| 输入 | S8.1 |
| AI 与工具 | `ctrl_scenarios`；FMU 驱动 |
| 交付物 | `ctrl/scenarios/` |
| 验收标准 | ≥ 20 个场景，可在 FMU 上批量回放 |
| 工时 | AI 3 / 你 1 |
| 依赖 | S8.1 |
| 沉淀 | episodic |

### S8.3 PID 基线（MIL）

| 字段 | 内容 |
|---|---|
| 目标 | 供液温度 + 压差双环 PID，整定后在场景库上建立基线指标 |
| 输入 | S8.2 |
| AI 与工具 | python-control 或 Simulink；`ctrl_eval` |
| 交付物 | `ctrl/pid/`；基线报告 |
| 验收标准 | 场景库零越限（或明确列出越限场景）；记录泵功、超调、调节时间 |
| 工时 | AI 3 / 你 1 |
| 依赖 | S8.2 |
| 沉淀 | episodic |

### S8.4 MPC

| 字段 | 内容 |
|---|---|
| 目标 | 基于 ROM/一维的 MPC，目标泵功最小，约束硬保证 |
| 输入 | S8.3 |
| AI 与工具 | do-mpc / CasADi 或 MATLAB MPC Toolbox |
| 交付物 | `ctrl/mpc/`；对比报告 |
| 验收标准 | 相对 PID 泵功下降、零越限；求解时间满足控制周期 |
| 工时 | AI 5 / 你 1.5 |
| 依赖 | S8.3 |
| 沉淀 | skill：`ctrl-design` 更新 |

### S8.5 安全 RL

| 字段 | 内容 |
|---|---|
| 目标 | 在孪生中训练 PPO/SAC 策略，配约束屏蔽层（越限切回 PID） |
| 输入 | S8.3、S8.4 |
| AI 与工具 | Gymnasium 包装 FMU；Stable-Baselines3 |
| 交付物 | `ctrl/rl/`；训练曲线与评估报告 |
| 验收标准 | 场景库零越限；与 MPC、PID 三方对比；未见场景泛化测试 |
| 工时 | AI 8 / 你 2 |
| 依赖 | S8.4 |
| 沉淀 | memory：`semantic/ctrl-benchmark.md` |

### S8.6 SIL 与 HIL 方案、DR6

| 字段 | 内容 |
|---|---|
| 目标 | 控制器代码化（Python/C 或 PLC 结构化文本）在 SIL 中运行；输出 HIL 台架方案；DR6 评审 |
| 输入 | S8.3–S8.5 |
| AI 与工具 | SIL 框架；`gate_review` |
| 交付物 | SIL 报告、HIL 方案、`plan/S8.6_DR6评审包.md/.html` |
| 验收标准 | KPI-6 达成；**G-E 闸门：任何写入实物控制器的动作由你确认**；DR6 你签署 |
| 工时 | AI 5 / 你 2 |
| 依赖 | S8.5 |
| 沉淀 | skill：`ctrl-design` 定稿；M7 发布留痕 |

## 10 P9 平台集成与发布

### S9.1 MCP 工具与设计台迭代

| 字段 | 内容 |
|---|---|
| 目标 | 每个里程碑把新工具接入 `mcp/server.py` 与设计台，保持"界面只是 API 的壳" |
| 输入 | 各阶段新增脚本 |
| AI 与工具 | MCP stdio/HTTP；`ui/` |
| 交付物 | 工具清单更新、`README.md` 更新 |
| 验收标准 | 对话与设计台调用同一工具得到同一结果 |
| 工时 | 每里程碑 AI 2 / 你 0.5 |
| 依赖 | 各阶段 |
| 沉淀 | episodic |

### S9.2 报告流水线

| 字段 | 内容 |
|---|---|
| 目标 | 统一的报告生成器：数字从 run `summary.json` 读取，输出 MD + HTML（左侧可折叠目录，与本计划同一模板） |
| 输入 | `plan/build_html.py`；各阶段 summary |
| AI 与工具 | Python markdown + 模板 |
| 交付物 | `report-build` 技能与脚本 |
| 验收标准 | 报告中无手抄数字；重新运行可再生成 |
| 工时 | AI 4 / 你 1 |
| 依赖 | S0.4 |
| 沉淀 | skill：`report-build`（评估上升为共享技能，走第①道闸门） |

### S9.3 里程碑发布

| 字段 | 内容 |
|---|---|
| 目标 | 每个里程碑：记忆复核、索引更新、提交信息草案、发布留痕 |
| 输入 | 本里程碑全部 episodic |
| AI 与工具 | `memory_list`；git diff 摘要 |
| 交付物 | 发布 episodic；提交信息草案 |
| 验收标准 | 你在 GitKraken 中 commit 并 push 到 `origin/main` |
| 工时 | 每里程碑 AI 1 / 你 0.5 |
| 依赖 | 各里程碑 |
| 沉淀 | episodic（发布留痕） |

## 11 Skill 与 Memory 沉淀流程

### 11.1 流程

1. 步骤交付并经你验收通过。
2. 智能体写 `memory/episodic/<date>-<step>.json`（自动，无需确认）。
3. 若本步产生了新的或修正的**口径、数字、环境事实**，智能体起草 semantic 差异（新文件或对已有文件的修改），列出 `confidence`、`valid_until`、`evidence`、`design_point`。
4. 若本步形成了**可复用的做法**（被你认可，且至少成功执行一次），智能体起草 `skills/<name>/SKILL.md`，状态 `draft`。
5. 你确认后：semantic 写入并更新 `memory/index.json`；skill 状态改为 `verified`。被否决的草案不写入，只在 episodic 的 `rejected` 里留一句原因。
6. 需要跨模块共享的 skill：复制到 `platform/shared/skills/_staging/<name>/`，你确认后登记 `platform/shared/skills/_meta/skill-registry.json`（第①道闸门）。
7. 过期记忆不删除，由 `platform/hooks/memory_gc.py` 标记 `expired`。

### 11.2 Skill 模板

```markdown
---
name: <skill-name>
description: <一句话：做什么、何时用；触发词>
status: draft            # draft → verified → deprecated
version: 0.1
owner: cp-design
verified_by: <你的名字或"待确认">
last_verified: 2026-10-02
valid_until: 2027-03-31
evidence: E1             # E1 一维 / E2 单胞 CFD / E3 整板 CFD / E4 实测
---

# <技能名>

## 何时使用
- 触发条件……

## 输入
- 文件 / 参数 / 前置步骤……

## 步骤
1. ……
2. 规则门：……（block / warn / pass 的处理）
3. ……

## 验收
- 判据与阈值……

## 禁令
- 不要……（来自踩坑）

## 已知坑与修正
- 日期：现象 → 修正命令（报错改过的命令写回这里）

## 产物
- 路径与命名规范……
```

### 11.3 Semantic 记忆模板

```markdown
---
confidence: 0.8
valid_until: 2027-03-31
last_verified: 2026-10-02
expired: false
evidence: E2
design_point: B300-PG25-6K
source: runs/20261002-xxxx/summary.json; 报告 v2.1 §3
---

# <主题>

一句话结论（带数字与单位）。

适用范围与前提：……

不要这样用：……（例如：单胞热阻不得写成整板保证值）

冲突与待定：……
```

### 11.4 Episodic 记忆模板

```json
{
  "date": "2026-10-02",
  "step": "S0.1",
  "task": "资产盘点与口径对账表",
  "design_point": "B300-PG25-6K",
  "evidence": "E1",
  "confidence": 0.8,
  "valid_until": "2027-03-31",
  "last_verified": "2026-10-02",
  "expired": false,
  "accepted_by_user": true,
  "done": ["……"],
  "outputs": ["plan/S0.1_口径对账表.md"],
  "open": ["……"],
  "rejected": [],
  "skills_drafted": ["design-point"],
  "semantic_drafted": ["design-point-ledger.md"]
}
```

### 11.5 Index 更新规则

`memory/index.json` 的 `semantic` 列表只列未过期条目；`inherit_from` 只列经第②道闸门筛过的上游记忆；每次增删在 `updated` 写日期，并在 `note` 中写变更原因。

## 12 近期排程（第一周）

| 日期 | 步骤 | 说明 |
|---|---|---|
| 10-02（今天） | S0.1 | 资产盘点与口径对账表，可立即开始 |
| 10-03 | 你决策 Q-01、Q-02（主设计点、孔径）与 Q-03–Q-05（许可、CAD 平台） | S0.2 的前提 |
| 10-04 至 10-05 | S0.2、S0.3 | 设计点登记表、schema、记忆健康检查 |
| 10-06 至 10-08 | S0.4、S1.1 | 目录规范、需求规格书 |
| 10-09 | M0 评审 | 你确认后提交并推送 |

### 12.1 首步执行说明（S0.1）

你只需回复"执行 S0.1"。智能体将：

1. 用脚本从 8 份参考报告抽取所有参数表（已验证可以从 HTML 抽成文本）。
2. 读 `design/calc/model.py` 的 `GEO`、`DESIGN_POINTS`、物性常量，以及两份 yaml。
3. 调 `oned_design`、`hbm_design`、`grace_design` 复算 DP-A、DP-B，与报告逐项比对。
4. 生成对账表（参数 × 设计点 × 证据等级 × 来源 × 冲突标记），并列出需要你裁决的冲突。
5. 写 episodic；起草 `design-point` 技能与 `design-point-ledger.md` 语义记忆，等你确认。

## 13 工时汇总

| 阶段 | AI 执行（小时） | 你审核（小时） |
|---|---|---|
| P0 | 10.5 | 3 |
| P1 | 9 | 3.5 |
| P2 | 26 | 7 |
| P3 | 21 | 4.5 |
| P4 | 38 | 11 |
| P5 | 15 | 6 |
| P6 | 14 | 7 |
| P7 | 24 | 6.5 |
| P8 | 27 | 9 |
| P9 | 约 12（分摊） | 约 4 |
| 合计 | 约 197 | 约 62 |

求解机时、样件制造与台架准备时间另计。
