bruce2012lu/AIDCtms_design202609/coolingplate/agent/practice01_0926/plan/项目规划_v1.0.md

# AI 驱动算力液冷系统设计平台 · 项目规划 v1.0

> 文档编号 AIDC-CP-PLAT-PLAN-001 · 版本 v1.0 · 2026-10-02 · 模块 `cp-design`（`agents/AIDCtms/coolingplate/agent/practice01_0926/`）
>
> 本文件与 `实施计划_v1.0.md` 配套。Markdown 是唯一源文件，HTML 版由 `plan/build_html.py` 生成，两者内容一致。

## 0 结论先行

**一句话**：在现有 `cp-design` 智能体（一维脚本、参数化 CAD 内核、MCP 工具、Fluent 技能、本地设计台）的基础上，把附图的 ①–⑦ 门控流程补成 ①–⑨ 的完整链路（新增 ⑧ 数字孪生、⑨ AI 在环控制），用"单一参数源 + MCP 工具 + 技能 + 治理记忆"四件套把每一步做成 AI 可调用、人可审核、结果可复算的工作单元。

**置信度**：0.75。架构与选型基于仓库内已经跑通的工具链（build123d/OCP、Ansys 2026 R1 Fluent、Python 一维模型、MCP 服务），可行性较高；数字孪生与 AI 控制两段没有本地先例，置信度较低（约 0.6）。

**五条核心判断**

1. **先统一设计口径，再加功能。** 目前并存两套设计点：v2.0 水基线（1100 W、2.0 L/min、壳–进液 0.0326–0.0366 °C/W）和 v2.1 PG25 口径（1400 W、冷却液温升 6 °C、模组 3.512 L/min）。孔径也并存 D0.50（一维/CAD）与 D0.40（已收敛 CFD 网格）。平台第一件事是建立"设计点登记表"，让每个数字都挂在一个设计点和一个证据等级上。
2. **一维走"自研 Python 为主、Simulink 为辅"。** 已有的 `design/calc/model.py`、`oned.py`、`zones.py` 已经覆盖板级热阻与水力，并带 Martin 有效域、钻孔下限等规则门，应扩展成"板级热阻网络 + 托盘/CDU 水力网络"。MATLAB/Simulink（Simscape Fluids/Thermal）交给已有的 `ai-matlab` 智能体，负责系统级瞬态、交叉验证和 ⑧⑨ 所需的 FMU。
3. **三维 CFD/CAE 锁定 Ansys（本机已有 2026 R1）+ PyAnsys/journal 自动化**，OpenFOAM 只作备选。验证顺序必须遵守 v2.0 §10.9：先做 Re≈3000 的 Martin 锚定算例（V4），再做网格无关性，再做 1/2 整板。
4. **CAD 继续以 build123d/OCP 参数化内核为"设计真源"**，SpaceClaim 负责几何清理与 CFD 流体域，SolidWorks/NX 只在需要正式工程图交付时作为出图端（视许可而定）。内核的首个升级是 `pitch_x/pitch_y`，否则 v2 的 216 孔几何进不了内核。
5. **AI 的价值点不在"替人拍板"，而在"把每轮迭代从几天压到几小时"**：自动跑一维–CAD–网格–求解–后处理–报告，自动做规则门和偏差判读，人只在 DR 闸门做决策。所有经用户认可的做法沉淀为 skill，所有经验证的数字沉淀为带 `confidence / valid_until / last_verified` 的 semantic 记忆。

**最需要你尽快拍板的三件事**（详见 §12）：主设计点用哪套口径；Ansys 许可里有哪些模块（Fluent/Mechanical/optiSLang/Twin Builder）以及 MATLAB 是否有 Simscape；正式工程图的 CAD 平台（SolidWorks / NX / 只用开源）。

## 1 现状盘点

本节依据 2026-10-02 对工作目录全部文档的通读：`agent.md`、`README.md`、`软件界面方案.md`、`memory/`（profile、2 条 episodic、6 条 semantic）、`knowledge/`（3 份）、`skills/`（4 个）、`mcp/server.py`、`oned.py`、`zones.py`、`ui/`、`cycle-20260926/`（5 页报告 + 2 个脚本 + STEP/PNG 产物）、`runs/20260926-140511/`、`references/`（8 份 HTML 报告）。

### 1.1 已完成资产

| 流程阶段 | 已有成果 | 证据等级 | 来源 |
|---|---|---|---|
| ① 需求与输入 | 输入追溯矩阵 IN-T/H/M/R、假设登记册 AS-1…AS-8、芯片规格与热包络 | 文档（含 6 项缺失输入） | B300 报告 v2.0 §2–§3 |
| ② 概念与选型 | 分区杂交方案（GPU 射流 + 短槽，HBM 无喷嘴 + 流速帽，隔离肋），加权 4.50 分；专利方案 A 对齐 | 文档 | v2.0 §5.1；专利报告 v1.4；技术调查 v1.3 |
| ③ 性能设计 | 热阻预算（目标 < 0.028 °C/W）、射流参数窗、流量与压降预算 | 一维 | v2.0 §5 |
| ④ 一维计算 | `model.py` 单一数值源；`oned.py`/`zones.py` 带 Martin 有效域、钻孔、HBM 流速帽等判据；PG25 复算 | 一维（可复算） | v2.0 §9；v2.1；`cycle-20260926/01` |
| ⑤ 三维仿真 | UC-01b 单孔单元胞 CHT：m425 网格 426 万六面体，iter 380 收敛，压降 1087 Pa，壳侧热阻 0.0313 °C/W；HBM 方案 D 网格 861 万；Fluent GUI 取图技能 | 单元胞 CFD（不是整板） | `memory/semantic/cfd-uc01b.md`；`cycle-20260926/03` |
| ⑥ 机械与图纸 | 参数化内核 v1.0（128 孔）可建 STEP/DXF/PNG；按 v2 几何脚本生成的三件冷板 STEP（95×75×8.5，216×D0.50）；报告内 1:1 矢量工程图；3 bar 解析承压 | 候选几何 + 解析校核 | `cycle-20260926/02、04`；v2.0 §6、§8 |
| ⑦ 样件与试验 | 试验大纲（出厂、型式 T1–T8、SAT）已在报告中定义 | 未开始 | v2.0 §11 |
| Grace 冷板 | CP-GRACE-MC-01 平行微通道，v1.1 PG25 复核 | 一维 | Grace 报告 v1.0/v1.1 |
| 平台化 | MCP 服务 `cp-design`（8 个工具）、本地设计台 `http://127.0.0.1:8765`、run 目录隔离、冻结 yaml 只读 | 可运行 | `mcp/server.py`、`ui/` |

### 1.2 关键设计参数（当前锁定口径）

| 参数 | v2.0 水基线 | v2.1 PG25 口径 | 备注 |
|---|---|---|---|
| 功率 | DP-A 1100 W 保证点；DP-B 1400 W 包络 | 模组 1400 W（GPU 核心 910 W，HBM 8×43.7 W，其他 140 W） | 两套功率拆分不同 |
| 工质 / 进液 | DI 水 40 °C | PG25 40 °C | PG25 换热约差 26–29% |
| 流量 | 整板 2.0 L/min（GPU 1.60 / HBM 0.40） | 冷却液温升 6 °C：模组 3.512 L/min，GPU 核心 2.283，HBM 单颗 0.1096 | 6 °C 是项目要求，非 OCP/NVIDIA 指标 |
| 射流 | 216 孔（每 die 9×12），D0.50，Sx 3.0 × Sy 2.4，H 2.0 | 同几何，孔速上限 2.0 m/s | Re 419–597，均低于 Martin 下限 2000 |
| 壳–进液热阻 | 0.0326–0.0366 °C/W（目标 < 0.028，门槛 ≤ 0.032） | 未重算 | 单胞 CFD 0.0313（D0.40） |
| 板内压降 | 3.5–5.5 kPa（静压箱 3–5 kPa 为估值） | 外推 14–24 kPa，可能超 20 kPa 上限 | 需整板 CFD 或实测 |
| HBM | 横流，近壁 0.463 m/s（帽 0.80） | 八颗并联、中点进液、方案 D 静压仓 | 详见 `b300-design-lock.md` |
| 外形 / 材料 | 95×75×8.5 mm，C11000/TU1，真空钎焊 | 同 | 送样螺接可拆 |
| Grace | 300 W，0.55 L/min（水） | 0.753 L/min（6 °C）；现有 4×1.04 mm 孔板 22.9 kPa 超限 | 孔板镶件需重配 |

### 1.3 已有工具链与智能体资产

| 类别 | 资产 | 状态 |
|---|---|---|
| 一维 | `design/calc/model.py`（物性、几何、关联式、工况）；`oned.py`（GPU 射流区）；`zones.py`（HBM、Grace）；`CP-GRACE-MC-01_calc.py` | 可用；只覆盖单板稳态 |
| CAD | `cad/coldplate`（参数→派生→规则→实体→后端），后端 STEP/STL、DXF、PNG、SolidWorks 宏；`cad/.venv`（build123d、OCP、ezdxf） | v1.0 可用；缺 `pitch_x/pitch_y`、静压仓、水嘴 |
| CFD | Ansys 2026 R1（`E:\cae\programfiles\Ansys2026\ANSYS Inc261\v261`）；ICEM 网格 + Fluent 批处理 journal；GPU 求解显存规则（RTX 4090，单进程 ≤ 900 万单元） | 单胞可用；整板未做 |
| 渲染 | SpaceClaim `/RunScript` 上色；Fluent GUI 期刊取图技能 | 可用 |
| MCP | `kb_catalog`、`memory_list`、`cad_tracks`、`cad_inspect`、`cad_build`、`oned_design`、`hbm_design`、`grace_design` | 可用 |
| 界面 | 本地 HTML 设计台（CAD 页、一维页） | 可用 |
| 技能 | `design-loop`、`cad-loop`、`cfd-loop`、`fluent-gui-capture` | 已验证 |
| 相邻智能体 | `ai-matlab`（MATLAB/Simulink/Simscape + `user-matlab` MCP）、`thermal-management`、`librarian`（Dify RAG） | 已登记 |

### 1.4 缺口与未决事项

**输入缺口**（v2.0 §13，开模前必须关闭）：C-01 封装坐标、C-02 官方热图、C-03 单板额定流量与压降窗、C-04 UQD 与压装力、C-05 工质、C-06 保证点、C-07 整板 CFD、C-08 TIM2 实测、C-09 首件 TTV、C-10 正式 FTO。

**工具缺口**

- 一维只到单板稳态，没有托盘四板并联 + Grace 支路的水力网络，也没有瞬态与控制接口。
- CAD 内核表达不了 v2（216 孔、双节距）、asm_0921 三层板、HBM 方案 D 静压仓、水嘴/UQD。
- CFD 只有单元胞；没有网格无关性三套网格、Martin 锚定算例（V4）、整板模型、工况矩阵批处理和 Mechanical 结构分析。
- 工程图停留在报告内的 SVG 矢量图，没有可交付的 DXF/DWG 带 GD&T 图纸。
- ⑦ 试验、⑧ 数字孪生、⑨ AI 控制完全空白。

**治理缺口**

- 两套设计口径并存，没有设计点登记表。
- `uc01b-lessmesh.md` 中文损坏；12 层网格续算结果未读取。
- v2.1 声称数字以 `GB300_冷板液冷热量与流量分配表_PG25_20260929.xlsx` 为准，但该工作簿不在本模块目录。

## 2 愿景、范围与成功判据

### 2.1 愿景

建成一个面向 AIDC 冷板液冷的 **AI 原生设计与桌面验证平台**：输入芯片热包络和系统水力边界，平台在人监督下自动完成"需求→选型→一维→CAD→CFD/CAE→工程图→试验 V&V→数字孪生→AI 控制"全链路，所有结论带证据等级和来源，可复算、可审计、可迁移到下一代芯片（Rubin 1.8–2.3 kW）。

### 2.2 范围

| 在范围内 | 不在范围内 |
|---|---|
| B300 GPU 冷板（CP-B300-JM-01）、Grace CPU 冷板（CP-GRACE-MC-01） | 机柜 CDU 本体的机械设计 |
| 托盘级水力（4 GPU + 2 Grace 并联）、系统级到 CDU 的一维/孪生模型 | 冷却塔、一次侧设施水系统详细设计 |
| 桌面验证：一维、CFD/CAE、透明样件与 TTV 试验方案及数据 V&V | 量产工艺开发、供应链管理 |
| 数字孪生（ROM + 系统 FMU）、AI 控制模型（MIL/SIL，HIL 方案） | 真实机房控制系统上线（只到 HIL 台架） |
| 平台化：MCP 工具、技能、记忆、设计台、报告流水线 | 商务报价、订单 ICD 签署 |

### 2.3 成功判据

| 编号 | 判据 | 目标值 | 验证方法 |
|---|---|---|---|
| KPI-1 | 单设计点迭代周期（改参→一维→CAD→单胞 CFD→报告） | ≤ 1 工作日（求解时间除外 ≤ 2 小时人工） | 计时记录 |
| KPI-2 | 一维与 CFD 能量平衡偏差 | < 2%（V2 硬约束） | 自动 V&V 报告 |
| KPI-3 | 整板 CFD 网格无关性 | 相邻网格 R 与 ΔP 差 < 3% | 三套网格 |
| KPI-4 | CFD 与试验偏差 | < 15%（超出触发 R2 回路） | TTV 试验 |
| KPI-5 | ROM 代理模型精度 | 测试集 R、ΔP 误差 < 5% | 留出集验证 |
| KPI-6 | AI 控制相对 PID 基线 | 在同等温度约束下泵功降低 ≥ 10%，零越限 | SIL 场景库 |
| KPI-7 | 知识沉淀 | 每个完成步骤至少 1 条 episodic；被认可方法 100% 进 skill | 记忆索引审计 |
| KPI-8 | 可复算性 | 报告中所有数字可由脚本再生成 | 回归测试 |

## 3 需求分析

### 3.1 干系人与用例

| 干系人 | 关心什么 | 典型用例 |
|---|---|---|
| 热设计工程师（你） | 快速迭代、结论可信 | 改孔径后 1 小时内看到一维 + 单胞 CFD 对比 |
| 结构/工艺工程师 | 可制造、尺寸链闭合 | 自动出 STEP + DXF + 规则门报告 |
| 试验工程师 | 试验大纲、数据处理 | 上传 TTV 数据，自动出 V&V 偏差报告 |
| 系统/控制工程师 | 托盘与 CDU 动态、控制策略 | 用孪生模型做泵速/阀位策略仿真 |
| 项目/评审 | 闸门状态、风险 | 打开看板查看 DR0–DR6 状态与开放项 |
| AI 智能体 | 清晰的工具契约与边界 | 通过 MCP 调工具、按技能执行、写记忆 |

### 3.2 功能需求

| 编号 | 功能 | 优先级 | 对应阶段 |
|---|---|---|---|
| FR-01 | 设计点登记表：每个设计点含功率拆分、工质、流量、几何版本、证据等级 | 必须 | ①④ |
| FR-02 | 输入追溯矩阵与开放项看板，可由 AI 从报告中抽取并更新 | 必须 | ① |
| FR-03 | 方案权衡矩阵与专利/FTO 检索辅助（经 librarian） | 应该 | ② |
| FR-04 | 一维板级热阻网络 + 水力网络求解，含规则门（Martin 域、钻孔下限、流速帽、压降上限） | 必须 | ③④ |
| FR-05 | 托盘/CDU 级一维水力网络与稳态/瞬态求解 | 必须 | ④⑧ |
| FR-06 | Simulink/Simscape 对照模型与 FMU 导出 | 应该 | ④⑧⑨ |
| FR-07 | 参数化 CAD：轨道选择→规则门→建模→导出（STEP/STL/DXF/PNG） | 必须 | ⑥ |
| FR-08 | CFD 流体域自动抽取与命名选择 | 必须 | ⑤ |
| FR-09 | 网格生成与质量检查自动化（ICEM/Fluent Meshing） | 必须 | ⑤ |
| FR-10 | Fluent 求解编排：journal 生成、批处理、残差/监视量监控、收敛判据 | 必须 | ⑤ |
| FR-11 | 后处理与 GUI 取图、逐孔流量统计、V&V 报告 | 必须 | ⑤ |
| FR-12 | 结构 FEA（承压、压装、热变形）自动化 | 应该 | ⑥ |
| FR-13 | 工程图自动生成（视图、尺寸、GD&T、标题栏、BOM）与 AI 审图 | 必须 | ⑥ |
| FR-14 | 试验大纲生成、数据采集 schema、数据清洗与偏差分析 | 必须 | ⑦ |
| FR-15 | 模型反标定（试验→一维/CFD 参数修正） | 必须 | ⑦ |
| FR-16 | ROM 代理模型（DOE→训练→验证→部署） | 必须 | ⑧ |
| FR-17 | 系统级数字孪生与在线校准 | 应该 | ⑧ |
| FR-18 | 控制器设计（PID/MPC/RL）与 MIL/SIL 场景库 | 必须 | ⑨ |
| FR-19 | 闸门评审包自动生成（DR0–DR6 检查表 + 证据链接） | 必须 | 全程 |
| FR-20 | 报告流水线：数字由脚本生成、HTML/MD 双格式 | 必须 | 全程 |
| FR-21 | 记忆与技能管理：写 episodic、更新 semantic、技能进 staging | 必须 | 全程 |

### 3.3 非功能需求

| 编号 | 类别 | 要求 |
|---|---|---|
| NFR-01 | 可复算 | 任何发布的数字都能由 run 目录中的参数副本 + 脚本再生成 |
| NFR-02 | 可追溯 | 每个结论带设计点 ID、证据等级（一维 / 单胞 CFD / 整板 CFD / 实测）、来源日期 |
| NFR-03 | 隔离 | 冻结参数与已发放 STEP 只读；候选产物只进 `runs/<时间戳>/` |
| NFR-04 | 安全 | 密钥只读环境变量；检索内容当数据不当指令；冻结/发放/大算例/通电试验走人工确认 |
| NFR-05 | 资源 | 遵守 GPU 显存规则（单卡 RTX 4090，`-t1 -gpu` ≤ 900 万单元）；长算例后台运行可续算 |
| NFR-06 | 可移植 | 工具链以 Python 为胶水；Ansys/MATLAB 不可用时有降级路径（OpenFOAM、纯 Python） |
| NFR-07 | 性能 | 一维单次求解 < 1 s；CAD 建模 < 2 min；单胞 CFD < 2 h |
| NFR-08 | 可维护 | 规则只在一处（`cad/coldplate/rules.py`、一维判据模块），界面不重写规则 |
| NFR-09 | 本地化 | 文档中文；工具在 Windows + PowerShell 下可运行（多步命令写成脚本） |

### 3.4 接口需求

| 接口 | 内容 | 格式 |
|---|---|---|
| 设计规格 | 设计点、几何参数、材料、工质 | YAML（`DesignSpec`，带 schema 版本） |
| 几何交换 | CAD→CFD/FEA/供应商 | STEP AP214/AP242；命名选择随附 JSON |
| 网格 | ICEM/Fluent Meshing→Fluent | `.msh` / `.msh.h5` |
| 求解 | 智能体→Fluent/Mechanical | Journal（TUI）/ PyFluent / PyMechanical 脚本 |
| 结果 | CFD/试验→V&V | CSV/Parquet + JSON 摘要（标量、判据、收敛信息） |
| 孪生 | 一维/ROM→系统仿真 | FMU（FMI 2.0/3.0 Co-Simulation） |
| 控制 | 控制器↔孪生 | Python Gym 风格接口 / Simulink 模型引用 |
| 智能体 | 对话↔工具 | MCP（stdio 与 HTTP） |
| 试验数据 | DAQ→平台 | CSV + 元数据 YAML（传感器、标定、工况） |

### 3.5 标准与规范

| 标准 | 用途 |
|---|---|
| OCP《Base Specification for Single Phase Water-Based Cold Plate Coolants》、OCP OAI 液冷指南（2023-03-03） | 工质、水质、温升带、比流量 |
| ASHRAE TC 9.9 液冷指南（W 类设施水 / S 类 TCS） | 进液温度等级与口径区分 |
| GB/T 48023-2026（技术调查报告引用：支路流量差 ≤ 平均 10%） | 均流判据 |
| ASTM D8040 | 工质腐蚀试验 |
| ASME V&V 20 | CFD 与传热计算的验证与确认方法 |
| JEDEC JESD238B / JESD235D | HBM 器件热相关口径（表面极差无官方值） |
| GB/T 1182（几何公差）、GB/T 1804 / ISO 2768（一般公差）、GB/T 14689、GB/T 4458 | 工程图 |
| 氦质谱检漏惯例（≤ 1×10⁻⁹ mbar·L/s）或项目保压 | 密封 |
| FMI 2.0/3.0 | 数字孪生模型交换 |
| IEC 61131-3 / IEC 61508（参考） | 控制器部署与功能安全参考 |

## 4 设计流程扩展：门控 + 三回路

附图的 ①–⑦ 流程保留不动，向后增加 ⑧ 数字孪生、⑨ AI 在环控制两个阶段和 DR5、DR6 两道闸门，并在 R1（仿真回路）、R2（V&V 回路）之外增加 R3（运行数据回路）。下图中每个阶段下方的小字是 AI 赋能点。

<figure class="flow">
<svg viewBox="0 0 1200 515" xmlns="http://www.w3.org/2000/svg" font-family="Microsoft YaHei, PingFang SC, sans-serif">
<defs>
<marker id="ar" markerWidth="10" markerHeight="10" refX="8" refY="5" orient="auto"><path d="M0,0 L10,5 L0,10 z" fill="#b5462e"/></marker>
<marker id="ar2" markerWidth="10" markerHeight="10" refX="8" refY="5" orient="auto"><path d="M0,0 L10,5 L0,10 z" fill="#555"/></marker>
</defs>
<text x="12" y="22" font-size="15" font-weight="bold" fill="#1f2d3d">AI 驱动冷板设计流程：门控 + 三回路（①–④ 已由 v2.0 报告覆盖，⑤⑥ 部分完成，⑦–⑨ 未开始）</text>
<rect x="6" y="34" width="526" height="250" rx="10" fill="none" stroke="#1a8f6a" stroke-width="2" stroke-dasharray="7 5"/>
<text x="200" y="50" font-size="12" fill="#1a8f6a">已完成（v2.0 / v2.1 报告）</text>
<rect x="534" y="34" width="262" height="250" rx="10" fill="none" stroke="#d48a00" stroke-width="2" stroke-dasharray="7 5"/>
<text x="585" y="50" font-size="12" fill="#d48a00">部分完成（单胞 CFD、候选 STEP）</text>
<g font-size="12" fill="#1f2d3d">
<rect x="12" y="58" width="120" height="118" rx="8" fill="#eef7f3" stroke="#1a8f6a"/>
<text x="72" y="80" text-anchor="middle" font-weight="bold">① 需求与输入</text>
<text x="20" y="102">· 芯片规格/热包络</text><text x="20" y="120">· 机柜水力表</text><text x="20" y="138">· 接口与标准</text>
<rect x="144" y="58" width="120" height="118" rx="8" fill="#eef7f3" stroke="#1a8f6a"/>
<text x="204" y="80" text-anchor="middle" font-weight="bold">② 概念与选型</text>
<text x="152" y="102">· 方案权衡矩阵</text><text x="152" y="120">· 分区策略</text><text x="152" y="138">· 专利 FTO 初筛</text>
<rect x="276" y="58" width="120" height="118" rx="8" fill="#eef7f3" stroke="#1a8f6a"/>
<text x="336" y="80" text-anchor="middle" font-weight="bold">③ 性能设计</text>
<text x="284" y="102">· 热阻预算分配</text><text x="284" y="120">· 射流参数窗</text><text x="284" y="138">· 流量/压降预算</text>
<rect x="408" y="58" width="120" height="118" rx="8" fill="#eef7f3" stroke="#1a8f6a"/>
<text x="468" y="80" text-anchor="middle" font-weight="bold">④ 一维计算</text>
<text x="416" y="102">· 热阻+水力网络</text><text x="416" y="120">· 水/PG25 双口径</text><text x="416" y="138">· 敏感性与差距</text>
<rect x="540" y="58" width="120" height="118" rx="8" fill="#fff6e5" stroke="#d48a00"/>
<text x="600" y="80" text-anchor="middle" font-weight="bold">⑤ 三维仿真</text>
<text x="548" y="102">· 共轭 CHT CFD</text><text x="548" y="120">· 网格无关性</text><text x="548" y="138">· 工况矩阵</text>
<rect x="672" y="58" width="120" height="118" rx="8" fill="#fff6e5" stroke="#d48a00"/>
<text x="732" y="80" text-anchor="middle" font-weight="bold">⑥ 机械与图纸</text>
<text x="680" y="102">· 承压/压装 FEA</text><text x="680" y="120">· 2D/3D/爆炸</text><text x="680" y="138">· GD&amp;T/BOM</text>
<rect x="804" y="58" width="120" height="118" rx="8" fill="#f3f4f6" stroke="#8a94a6"/>
<text x="864" y="80" text-anchor="middle" font-weight="bold">⑦ 样件与试验</text>
<text x="812" y="102">· TTV 热阻</text><text x="812" y="120">· 流阻曲线</text><text x="812" y="138">· 红外/PIV</text>
<rect x="936" y="58" width="120" height="118" rx="8" fill="#eef2fb" stroke="#3f63c5"/>
<text x="996" y="80" text-anchor="middle" font-weight="bold">⑧ 数字孪生</text>
<text x="944" y="102">· ROM 代理模型</text><text x="944" y="120">· 系统级 FMU</text><text x="944" y="138">· 在线校准</text>
<rect x="1068" y="58" width="120" height="118" rx="8" fill="#eef2fb" stroke="#3f63c5"/>
<text x="1128" y="80" text-anchor="middle" font-weight="bold">⑨ AI 在环控制</text>
<text x="1076" y="102">· PID→MPC→RL</text><text x="1076" y="120">· MIL/SIL/HIL</text><text x="1076" y="138">· 安全约束</text>
</g>
<g stroke="#555" stroke-width="1.6" marker-end="url(#ar2)">
<line x1="132" y1="117" x2="142" y2="117"/><line x1="264" y1="117" x2="274" y2="117"/><line x1="396" y1="117" x2="406" y2="117"/><line x1="528" y1="117" x2="538" y2="117"/><line x1="660" y1="117" x2="670" y2="117"/><line x1="792" y1="117" x2="802" y2="117"/><line x1="924" y1="117" x2="934" y2="117"/><line x1="1056" y1="117" x2="1066" y2="117"/>
</g>
<g font-size="11" fill="#7a4b00" text-anchor="middle">
<g fill="#fff3d6" stroke="#c98a1b"><polygon points="72,196 122,214 72,232 22,214"/><polygon points="204,196 254,214 204,232 154,214"/><polygon points="336,196 386,214 336,232 286,214"/><polygon points="468,196 518,214 468,232 418,214"/><polygon points="600,196 650,214 600,232 550,214"/><polygon points="732,196 782,214 732,232 682,214"/><polygon points="864,196 914,214 864,232 814,214"/><polygon points="996,196 1046,214 996,232 946,214"/><polygon points="1128,196 1178,214 1128,232 1078,214"/></g>
<text x="72" y="218">DR0 输入冻结</text><text x="204" y="218">DR1 方案选定</text><text x="336" y="218">DR2 性能基线</text><text x="468" y="218">DR2 闸门</text><text x="600" y="218">DR3 仿真</text><text x="732" y="218">DR3 图纸</text><text x="864" y="218">DR4 送样放行</text><text x="996" y="218">DR5 孪生确认</text><text x="1128" y="218">DR6 控制放行</text>
</g>
<g stroke="#bbb" stroke-dasharray="3 3"><line x1="72" y1="176" x2="72" y2="196"/><line x1="204" y1="176" x2="204" y2="196"/><line x1="336" y1="176" x2="336" y2="196"/><line x1="468" y1="176" x2="468" y2="196"/><line x1="600" y1="176" x2="600" y2="196"/><line x1="732" y1="176" x2="732" y2="196"/><line x1="864" y1="176" x2="864" y2="196"/><line x1="996" y1="176" x2="996" y2="196"/><line x1="1128" y1="176" x2="1128" y2="196"/></g>
<g font-size="10.5" fill="#3f63c5" text-anchor="middle">
<text x="72" y="252">AI：文档抽取</text><text x="72" y="266">追溯矩阵</text>
<text x="204" y="252">AI：方案打分</text><text x="204" y="266">专利检索</text>
<text x="336" y="252">AI：预算闭合</text><text x="336" y="266">参数窗校核</text>
<text x="468" y="252">AI：自研求解器</text><text x="468" y="266">Simulink agent</text>
<text x="600" y="252">AI：PyFluent/journal</text><text x="600" y="266">残差监控</text>
<text x="732" y="252">AI：规则门建模</text><text x="732" y="266">自动出图/审图</text>
<text x="864" y="252">AI：试验大纲</text><text x="864" y="266">数据 V&amp;V</text>
<text x="996" y="252">AI：代理模型</text><text x="996" y="266">参数辨识</text>
<text x="1128" y="252">AI：MPC/RL</text><text x="1128" y="266">场景生成</text>
</g>
<g fill="none" stroke="#b5462e" stroke-width="1.8" stroke-dasharray="6 4" marker-end="url(#ar)">
<path d="M600,286 C600,320 400,320 400,276"/>
<path d="M864,286 C864,370 336,370 336,276"/>
<path d="M1128,286 C1128,440 468,440 468,276"/>
</g>
<g font-size="12" font-weight="bold" fill="#b5462e" text-anchor="middle">
<text x="500" y="328">R1</text><text x="600" y="366">R2</text><text x="798" y="420">R3</text>
</g>
<g font-size="12.5" fill="#b5462e">
<text x="20" y="456">R1 仿真回路：仿真不达标 → 回 ③/④ 改几何（孔径、阵列、槽深、TIM2）</text>
<text x="20" y="478">R2 V&amp;V 回路：试验与仿真偏差 &gt; 15% → 修正模型并回 ③</text>
<text x="20" y="500">R3 运行回路：台架/运行数据 → 孪生在线校准 → 回 ④ 更新一维与 ROM</text>
</g>
</svg>
<figcaption>图 4-1　扩展后的门控流程。绿色虚框为已完成，橙色虚框为部分完成；蓝色小字为各阶段 AI 赋能点。</figcaption>
</figure>

### 4.1 阶段门定义

| 门 | 名称 | 放行条件 | 平台自动生成的证据 | 当前状态 |
|---|---|---|---|---|
| DR0 | 输入冻结 | IN-* 缺失项均有责任人与日期；设计点登记表确定主设计点 | 追溯矩阵、设计点表、开放项看板 | 已完成（含 6 项缺失；设计点需重定） |
| DR1 | 方案选定 | 权衡矩阵量化；FTO 初筛无红灯 | 方案矩阵、专利对照表 | 已完成 |
| DR2 | 性能基线 | 热阻预算闭合；一维可复算；敏感性给出杠杆 | 一维计算书、回归测试、敏感性图 | 有条件通过（区间跨目标线） |
| DR3 | 仿真与图纸 | V1/V4 通过；网格无关 < 3%；R 与 ΔP 达标；图纸尺寸链闭合 | CFD 报告、V&V 报告、STEP/DXF、审图记录 | 未完成 |
| DR4 | 送样放行 | TTV 热阻达标；氦检通过；流阻曲线符合 | 试验报告、偏差分析 | 未开始 |
| DR5 | 孪生确认 | ROM 误差 < 5%；系统孪生对台架数据偏差 < 10% | ROM 验证报告、校准记录 | 新增 |
| DR6 | 控制放行 | SIL 场景库零越限；相对 PID 达到 KPI-6；HIL 方案评审通过 | 场景库结果、安全约束证明 | 新增 |

### 4.2 三条迭代回路

| 回路 | 触发条件 | 回到哪一步 | 智能体动作 |
|---|---|---|---|
| R1 仿真回路 | CFD 得到的 Rθ,c-in 超目标、ΔP > 20 kPa，或分区流量偏差 > ±10% | ③/④ | 按杠杆优先级（孔径→TIM2→流量→阵列→槽深）生成候选，一维预筛后只把前 2–3 个送 CFD |
| R2 V&V 回路 | 试验与 CFD 偏差 > 15% | ③，并修正 ④ 的关联式与系数 | 自动做反标定，生成"模型修正建议"，人确认后才改模型 |
| R3 运行回路 | 台架/运行数据与孪生偏差超阈值 | ④ 与 ⑧ | 在线参数辨识更新 ROM；偏差持续则提议改设计 |

## 5 平台总体技术架构

### 5.1 分层架构

<figure class="flow">
<svg viewBox="0 0 1200 400" xmlns="http://www.w3.org/2000/svg" font-family="Microsoft YaHei, PingFang SC, sans-serif" font-size="13">
<rect x="10" y="10" width="1180" height="62" rx="8" fill="#eef2fb" stroke="#3f63c5"/>
<text x="24" y="36" font-weight="bold" fill="#3f63c5">L4 交互层</text>
<text x="24" y="58" fill="#1f2d3d">Cursor / Claude Code 对话 · 本地设计台（HTML，127.0.0.1:8765）· 闸门看板 · HTML/MD 报告 · 后续 pywebview 桌面壳</text>
<rect x="10" y="82" width="1180" height="72" rx="8" fill="#f4effa" stroke="#7b4bb7"/>
<text x="24" y="108" font-weight="bold" fill="#7b4bb7">L3 智能体编排层</text>
<text x="24" y="130" fill="#1f2d3d">orchestrator（薄编排）→ cp-design（主控，技能：design/cad/mesh/cfd/fea/drawing/test/rom/twin/ctrl/gate）</text>
<text x="24" y="148" fill="#1f2d3d">协作：ai-matlab（Simulink/Simscape/FMU）· thermal-management（系统热管理）· librarian（Dify RAG）· 模型路由 A 主 / B 备</text>
<rect x="10" y="164" width="1180" height="72" rx="8" fill="#eef7f3" stroke="#1a8f6a"/>
<text x="24" y="190" font-weight="bold" fill="#1a8f6a">L2 工具适配层（MCP）</text>
<text x="24" y="212" fill="#1f2d3d">cp-design MCP：kb/memory · cad_tracks/inspect/build · oned/hbm/grace_design · 新增 spec_* · net_solve · mesh_* · cfd_* · fea_* · drawing_* · test_* · rom_* · twin_* · ctrl_* · gate_review</text>
<text x="24" y="230" fill="#1f2d3d">外部 MCP：user-matlab（MATLAB 引擎）· 后续 PyAnsys 服务（Fluent/Mechanical 会话）</text>
<rect x="10" y="246" width="1180" height="72" rx="8" fill="#fff6e5" stroke="#d48a00"/>
<text x="24" y="272" font-weight="bold" fill="#b06f00">L1 工程内核层</text>
<text x="24" y="294" fill="#1f2d3d">一维：model.py / oned / zones → net（热阻+水力网络）· CAD：cad/coldplate（build123d/OCP）· SpaceClaim · ICEM/Fluent Meshing · Fluent · Mechanical</text>
<text x="24" y="312" fill="#1f2d3d">ROM：scikit-learn / PyTorch / optiSLang（可选）· 系统：Simscape / Modelica · 控制：python-control / do-mpc / Stable-Baselines3 · Simulink</text>
<rect x="10" y="328" width="1180" height="62" rx="8" fill="#f3f4f6" stroke="#8a94a6"/>
<text x="24" y="354" font-weight="bold" fill="#4b5565">L0 数据与知识层</text>
<text x="24" y="376" fill="#1f2d3d">DesignSpec YAML（单一参数源）· 设计点登记表 · runs/&lt;时间戳&gt;/ · 结果 JSON/CSV/Parquet · 报告 · memory（profile/semantic/episodic）· skills · knowledge · git 审计链 · Dify 知识库</text>
</svg>
<figcaption>图 5-1　平台五层架构。规则只在 L1 实现一次，L2 只做适配与门控，L4 不重写规则。</figcaption>
</figure>

### 5.2 核心数据模型

**DesignSpec（单一参数源）**：在现有 `cad/params/*.yaml` 基础上扩展为带 `schema_version` 的设计规格，分为 `meta`（型号、设计点 ID、来源报告、证据等级、置信度）、`thermal`（功率拆分）、`coolant`（工质与物性引用）、`hydraulics`（流量、分流、压降窗）、`geometry`（外形、die/HBM 坐标、射流 `pitch_x/pitch_y`、槽、静压仓、水嘴）、`material`、`process`。一维、CAD、CFD、FEA、出图全部读同一份 Spec。

**设计点登记表**：`design_points.yaml`，每条含 ID（如 `B300-W-DPA`、`B300-PG25-6K`、`GRACE-PG25-6K`）、功率拆分、工质、流量、几何版本、状态（候选 / 锁定 / 废弃）、证据等级上限。任何报告中的数字必须标注所属设计点。

**Run 目录**：`runs/<时间戳>-<设计点>-<阶段>/` 内放 `spec.yaml`（副本）、`gate.json`（规则门结果）、`log/`、产物（STEP/msh/cas/png）、`summary.json`（标量、判据、收敛信息）。冻结 yaml 与已发放 STEP 只读。

**证据等级**：E1 一维、E2 单元胞 CFD、E3 整板 CFD、E4 实测。结论只能引用不高于其来源的等级；单胞结果不得写成整板保证值。

### 5.3 MCP 工具矩阵

| 工具组 | 现有 | 新增（规划） | 阶段 |
|---|---|---|---|
| 知识与记忆 | `kb_catalog`、`memory_list` | `memory_write`（写 episodic，semantic 只出草案）、`trace_matrix` | 全程 |
| 设计规格 | — | `spec_validate`、`spec_diff`、`design_point_list` | ①④ |
| 一维 | `oned_design`、`hbm_design`、`grace_design` | `net_solve`（板/托盘网络）、`oned_sweep`（敏感性）、`oned_regress` | ④ |
| CAD | `cad_tracks`、`cad_inspect`、`cad_build` | `cad_fluid_extract`、`cad_named_selections` | ⑥⑤ |
| 网格 | — | `mesh_build`、`mesh_quality` | ⑤ |
| CFD | — | `cfd_journal`、`cfd_submit`、`cfd_monitor`、`cfd_post`、`cfd_vv` | ⑤ |
| 结构 | — | `fea_run`（承压/压装/热变形） | ⑥ |
| 出图 | — | `drawing_build`、`drawing_review` | ⑥ |
| 试验 | — | `test_plan`、`test_ingest`、`test_vv`、`calibrate` | ⑦ |
| 孪生 | — | `rom_doe`、`rom_train`、`rom_eval`、`twin_export_fmu`、`twin_calibrate` | ⑧ |
| 控制 | — | `ctrl_scenarios`、`ctrl_train`、`ctrl_eval` | ⑨ |
| 闸门 | — | `gate_review`（DR0–DR6 检查表 + 证据链接） | 全程 |

所有"改变冻结状态"或"耗时长"的工具（`cad_build`、`cfd_submit`、`fea_run`、`twin_export_fmu` 等）都必须带 `confirm=true`，对应设计台上的人工勾选。

### 5.4 模型路由

沿用 `platform/router.config.json`：`cp-design` 主模型 claude-sonnet，`backup_chain` 为 DeepSeek › GLM › Kimi，`token_budget` 90000；触发 `on_error / on_quota / on_sensitive_data` 时降级。设计数据含未公开封装信息时按 `on_sensitive_data` 处理。复杂推理（方案权衡、闸门评审）可经 orchestrator 用 claude-opus。密钥只读环境变量。

### 5.5 目录规划

```text
agents/AIDCtms/coolingplate/
├─ design/            # 报告、calc/model.py（一维数值源）、cfd/ 算例（保持现状）
├─ cad/               # 参数化内核 coldplate/、params/（冻结 yaml 只读）、.venv
└─ agent/practice01_0926/          # cp-design 模块
   ├─ agent.md  README.md
   ├─ plan/           # 本规划与实施计划（MD 源 + HTML）
   ├─ spec/           # 新增：DesignSpec schema、design_points.yaml
   ├─ oned/           # 新增：net 网络求解器（可由 oned.py/zones.py 迁入）
   ├─ cfd/            # 新增：journal 模板、PyFluent 编排、V&V 脚本
   ├─ fea/  drawing/  test/  twin/  ctrl/   # 后续阶段按需新建
   ├─ mcp/server.py   ui/
   ├─ skills/  memory/  knowledge/
   └─ runs/           # 候选产物（git 忽略大文件）
```

## 6 各阶段 AI 与工具选型

### 6.1 一维设计计算（④，并服务 ⑧⑨）

| 方案 | 优点 | 缺点 | 结论 |
|---|---|---|---|
| A 自研 Python 热阻 + 水力网络 | 已有 `model.py`/`oned.py`/`zones.py` 与规则门；AI 改代码快；可直接做 MCP 工具和回归测试；无许可依赖 | 瞬态与控制需自己写；大系统建模不如图形化直观 | **主线** |
| B MATLAB Simulink + Simscape Fluids/Thermal，经 `ai-matlab` 智能体 | 系统级瞬态、泵阀管路库成熟；可导出 FMU；控制设计工具链完整 | 依赖许可；冷板内部射流/低 Re 关联式需自定义块；版本管理较重 | **辅线**：托盘/CDU 瞬态、交叉验证、FMU |
| C Modelica（OpenModelica + ThermoSysPro/Buildings） | 开源、可导出 FMU | 团队无积累；液冷库需二次开发 | 备选（MATLAB 不可用时） |
| D Flownex / Ansys Twin Builder 一维 | 商业一维流网成熟 | 许可成本；与现有脚本割裂 | 不推荐首选 |

**做法**：把一维拆成三层——关联式库（Martin、短槽发展段、Shah–London、驻点核，含有效域）、元件库（射流阵、短槽、HBM 槽、静压仓、孔板、UQD、管段）、网络求解器（节点压力/流量 + 热阻网络，稳态用 Newton，瞬态用集总热容 ODE）。板级结果对 v2.0 回归（误差 0），托盘级再加四板并联和 Grace 支路。Simulink 模型由 `ai-matlab` 按同一份 DesignSpec 搭建，两边对同一工况的偏差 < 2% 才算一致。

### 6.2 CAD 概念设计（⑥ 前段）

| 方案 | 优点 | 缺点 | 结论 |
|---|---|---|---|
| A build123d/OCP 参数化内核（现有 `cad/coldplate`） | 已分层、已接 MCP 规则门；纯代码 AI 友好；出 STEP/DXF | OCC 共面布尔段错误需过切；复杂曲面弱 | **设计真源** |
| B CadQuery | 与 A 同内核，社区大 | 与现有代码重复 | 不另起 |
| C FreeCAD（Python API / TechDraw） | 开源、带工程图工作台 | API 不稳定、自动化脆弱 | 出图备选 |
| D SolidWorks API / 宏 | 工程图与 GD&T 成熟；供应商通用 | 许可；Windows COM 自动化 | 正式图纸交付端（视许可） |
| E NX Open | asm_0921 来自 NX 12；高端制造通用 | 许可与学习成本高 | 仅当客户/供应商要求 |
| F SpaceClaim 脚本 | 本机已有；几何清理、流体域抽取、上色 | 不适合作为参数源 | **CFD 前处理** |

**AI+CAD 模式**：AI 不直接"画"，而是改 DesignSpec→规则门（`rules.py`）→内核建模→回读校核（包围盒、体积、孔数）→出预览图让人确认。首要升级：`pitch_x/pitch_y`、v2 规则对账表、HBM 方案 D 静压仓、水嘴/UQD 接口、asm_0921 三层板轨道参数化。

### 6.3 三维 CFD/CAE（⑤ 与 ⑥ 结构部分）

| 方案 | 优点 | 缺点 | 结论 |
|---|---|---|---|
| A Ansys Fluent 2026 R1 + journal/PyFluent | 本机已有且已跑通单胞 CHT；GPU 原生求解；转捩 SST、层流对照 | 整板网格 3000–8000 万，单卡显存不够需 CPU；许可并发 | **主线** |
| B Ansys Icepak | 电子散热前处理快 | 对 0.5 mm 射流常用降阶，解析驻点不足（v2.0 §10.2 已指出） | 只做整机/托盘级 |
| C Ansys Mechanical + PyMechanical | 承压、压装、热应力、钎焊变形 | 需与 Fluent 温度场映射 | **结构主线** |
| D optiSLang / Fluent ROM / Twin Builder | DOE、敏感性、ROM 导出 FMU | 需确认许可 | ⑧ 首选（若有许可） |
| E OpenFOAM（chtMultiRegionFoam） | 开源、可大规模并行 | 设置与验证成本高 | 备选 / 交叉验证 |
| F ICEM（现有）/ Fluent Meshing watertight | ICEM 已有六面体单胞经验；Fluent Meshing 适合整板 poly-hexcore | ICEM 整板人工量大 | 单胞 ICEM，整板 Fluent Meshing |

**验证路线（不可跳步）**：V1 解析算例（层流平板、圆管 f·Re）→ V4 Martin 锚定（Re≈3000 单胞，误差 < 15%）→ 单胞三套网格无关性 → 单胞转捩 SST 与层流对照 → 1/2 整板（沿 X 中线对称）→ 工况矩阵 C01–C12 → 结果回灌一维（R1）。资源上遵守 `cfd-loop` 的显存规则：超过 900 万单元不开 `-gpu`。

**AI+Ansys 模式**：AI 生成 journal/PyFluent 脚本副本（文件名带孔径、孔数、热流），后台提交，定时读残差与监视量，按 §10.8 判据判收敛，收敛后自动做后处理（逐孔流量、分段压降、壁温最高点、两 die 温差），报告云图走 `fluent-gui-capture`。

### 6.4 工程图（⑥ 后段）

| 方案 | 结论 |
|---|---|
| build123d → DXF（ezdxf）+ 报告 SVG | **概念/评审图**：现有后端扩展视图、剖面、尺寸 |
| SolidWorks 宏（内核已有 `sw` 后端）→ SLDDRW/PDF/DWG | **正式发放图**（若有许可） |
| FreeCAD TechDraw | 无商业许可时的正式图备选 |

**AI 赋能**：按 GB/T 1182 生成 GD&T 标注建议（接触面平面度 0.05、Ra 0.8、孔位置度 ⌀0.4 MMC 等）、自动填标题栏与 BOM、"AI 审图"检查表（尺寸链闭合、关键尺寸与 Spec 一致、公差可加工、焊接符号、检验表）。发放必须人工确认。

### 6.5 试验验证（⑦）

| 内容 | 方案 | AI 赋能 |
|---|---|---|
| 输入闭合前的桌面验证 | 1:1 铜样 + PMMA 透明流道样；两块 25×25 mm 加热块模拟双 die、八块小加热块模拟 HBM | 生成试验矩阵与样件图 |
| 热阻 | TTV 加热块、热电偶阵列、恒温水箱、科氏/涡轮流量计 | 自动不确定度分析（ASME PTC 19.1 方法） |
| 流阻与分区流量 | 差压变送器、分区流量计 | 流阻曲线拟合 K 值 |
| 流动拓扑 | 透明样 PIV / 染色（验证 cell vs bank 拓扑） | 图像处理与流线提取 |
| 温度场 | 红外热像 | 与 CFD 壁温云图自动配准对比 |
| 数据链 | DAQ（NI / 国产采集卡）→ CSV + 元数据 YAML → 平台 | `test_ingest` 清洗、`test_vv` 偏差、`calibrate` 反标定 |

### 6.6 数字孪生（⑧）

| 层级 | 模型 | 工具 |
|---|---|---|
| 部件孪生（冷板） | CFD DOE → 代理模型：R(Q, Tin, P 分布, 工质)、ΔP(Q, 工质)；必要时 POD 温度场 | 首选 optiSLang/Fluent ROM（有许可时）；否则 scikit-learn GPR / PyTorch MLP |
| 系统孪生（托盘→CDU） | 一维网络（Python）或 Simscape 模型，冷板用 ROM 替换 | Simscape → FMU；或 Python → FMU（PythonFMU） |
| 在线校准 | 卡尔曼滤波 / 贝叶斯参数辨识更新 h 系数、TIM2、K 值 | Python（filterpy / PyMC） |
| 可视化 | 设计台新增"孪生"页：实时温度、流量、偏差 | 现有 HTML 设计台 |

### 6.7 AI 在环控制（⑨）

| 阶段 | 内容 | 工具 |
|---|---|---|
| 控制需求 | 被控量：GPU 壳温/结温估计、供液温度、压差；执行器：CDU 泵速、旁通阀、二次侧阀位；约束：Tj ≤ 90 °C、ΔP ≤ 上限、露点 +3 K | 需求文档 + 安全约束表 |
| 基线 | PID（供液温度 + 压差双环） | python-control / Simulink |
| 优化 | MPC（基于一维/ROM 线性化或非线性 MPC），以泵功最小为目标 | do-mpc / CasADi / MATLAB MPC Toolbox |
| 学习 | 安全 RL（PPO/SAC + 约束屏蔽），在孪生中训练，负载曲线来自 AI 训练/推理工况 | Gymnasium 包装 FMU + Stable-Baselines3 |
| 验证 | MIL → SIL（场景库：负载阶跃、泵故障、单板堵塞 20%、进液 45 °C）→ HIL 方案（台架 PLC/工控机） | 场景库自动生成与评估 |

**安全边界**：AI 控制只在仿真和台架内运行；任何上真实系统的参数变更都属于人工闸门；RL 策略必须有规则层兜底（越限即切回 PID）。

### 6.8 选型结论汇总

| 阶段 | 主线 | 辅线 / 备选 | 前提 |
|---|---|---|---|
| ④ 一维 | 自研 Python 网络求解器 | Simulink/Simscape（`ai-matlab`）；Modelica | MATLAB 许可含 Simscape |
| ⑥ CAD | build123d/OCP 参数化内核 | SpaceClaim（前处理）；SolidWorks/NX（正式图） | — |
| ⑤ CFD | Fluent 2026 R1 + journal/PyFluent | OpenFOAM；Icepak（托盘级） | Fluent 许可并发数 |
| ⑥ 结构 | Mechanical + PyMechanical | 解析板条校核（现有） | Mechanical 许可 |
| ⑥ 出图 | DXF 概念图 + SolidWorks 宏正式图 | FreeCAD TechDraw | SolidWorks 许可 |
| ⑦ 试验 | TTV + 透明样 + Python 数据链 | — | 台架资源 |
| ⑧ 孪生 | ROM（GPR/MLP 或 optiSLang）+ 系统 FMU | Twin Builder | — |
| ⑨ 控制 | PID → MPC → 安全 RL，MIL/SIL | Simulink 控制工具链 | — |

## 7 智能体体系设计

### 7.1 编排结构

平台宪法规定"限派生 ≤ 1 层，且仅 `quant-research` 可派生 `t-*`"。因此本平台**不为 cp-design 派生子智能体**，而采用"一个主控领域智能体 + 多技能 + 跨智能体协作"的结构：

- **cp-design（主控）**：负责冷板全链路，按任务加载对应技能（相当于"角色帽"）。
- **ai-matlab（协作）**：Simulink/Simscape 建模、FMU 导出、MATLAB MPC，经 orchestrator 路由或 cp-design 交接。
- **thermal-management（协作）**：托盘/机柜/CDU 系统级热管理口径。
- **librarian（协作）**：文献、标准、专利检索（Dify RAG）。
- **orchestrator**：跨智能体任务拆解与汇总。

若后续 CFD 或控制工作量大到需要独立智能体（例如 `cp-cfd`、`cp-twin`），按平台规则作为**同级领域智能体**新建模块、薄加载器并在 `registry.json` 与 `router.config.json` 登记——这是平台层变更，需你确认。

### 7.2 技能体系

| 技能 | 状态 | 用途 |
|---|---|---|
| `design-loop` | 已有 | 设计迭代总流程 |
| `cad-loop` | 已有（需升级 v2） | 轨道→规则门→建模 |
| `cfd-loop` | 已有 | journal、残差、显存规则 |
| `fluent-gui-capture` | 已有 | 报告云图取图 |
| `req-intake` | 新增 | 从报告/ICD 抽取输入，更新追溯矩阵与开放项 |
| `design-point` | 新增 | 设计点登记、口径对账、证据等级标注 |
| `oned-network` | 新增 | 板级/托盘级网络建模与回归 |
| `simscape-bridge` | 新增（与 ai-matlab 共用） | DesignSpec → Simscape 模型 → FMU |
| `mesh-loop` | 新增 | 流体域抽取、网格、质量检查 |
| `cfd-vv` | 新增 | V1–V5、网格无关性、模型对照 |
| `fea-loop` | 新增 | 承压、压装、热变形 |
| `drawing-gen` | 新增 | 出图、GD&T、AI 审图 |
| `test-vv` | 新增 | 试验大纲、数据摄入、偏差与反标定 |
| `rom-build` | 新增 | DOE、代理模型训练与验证 |
| `twin-calib` | 新增 | 系统孪生与在线校准 |
| `ctrl-design` | 新增 | PID/MPC/RL 与场景库 |
| `gate-review` | 新增 | DR0–DR6 评审包 |
| `report-build` | 新增 | 报告流水线（脚本生成数字、MD/HTML 双格式） |

新技能先放 `skills/<name>/SKILL.md` 草案；**只有经你认可的才定稿**。若某技能对其他模块也有价值（如 `report-build`），再提议上升为平台共享技能，走 `platform/shared/skills/_staging/` 与第①道闸门。

### 7.3 记忆体系

| 类型 | 位置 | 写入条件 | 治理字段 |
|---|---|---|---|
| profile | `memory/profile.md` | 角色或边界变化 | — |
| semantic | `memory/semantic/<topic>.md` | 经验证或经你认可的口径、规则、环境事实 | `confidence / valid_until / last_verified / expired`，并加 `evidence`（E1–E4）与 `design_point` |
| episodic | `memory/episodic/<date>-<task>.json` | 每个步骤完成 | 同上 + `done / open / outputs` |
| index | `memory/index.json` | 每次增删记忆 | `inherit_from` 列表 |

继承规则沿用平台第②道闸门：只采纳 `confidence ≥ 0.6`、未过期、近期复核的条目；损坏或冲突条目只作线索。

### 7.4 工程闸门（本项目补充）

平台宪法的三道闸门（技能安装、记忆继承、实盘资金动作）原样遵守。第③道针对金融，本项目不触发。另按工程风险补充以下**项目级人工确认点**（不修改平台宪法）：

| 工程闸门 | 触发动作 |
|---|---|
| G-A 参数冻结 | 修改锁定设计点、改写冻结 yaml、升级内核对账表到 v2 |
| G-B 发放 | 覆盖已发放 STEP、发放图纸给供应商 |
| G-C 大算例 | 启动 > 900 万单元或预计 > 8 小时的求解、占用全部许可 |
| G-D 实物 | 样件下单、台架通电试验 |
| G-E 控制部署 | 任何控制参数写入实物控制器 |

## 8 门控与 V&V 闭环的智能体落地

1. **每个工具调用都返回 `gate`**（pass / warn / block）和判据列表，沿用现有 `cad_inspect` 与 `oned_design` 的格式。
2. **闸门评审包由 `gate_review` 自动生成**：读取设计点表、run 目录 `summary.json`、记忆和开放项，按 §4.1 条件逐条打勾，并附证据链接；人只需审阅"未通过 / 待定"项。
3. **偏差自动判读**：`cfd_vv` 与 `test_vv` 按 V1–V5 阈值输出偏差表；超过阈值时自动起草 R1/R2 回路建议（杠杆排序 + 一维预筛结果），但不自动改模型。
4. **证据等级强制**：报告生成器拒绝把 E2 数字放进"整板保证值"字段；单胞热阻、单胞压降只能出现在"单胞"章节。
5. **冲突检测**：同一参数在两个锁定设计点中取值不同（如孔径 D0.50 与 D0.40）时，`spec_diff` 报警，要求人选定。

## 9 里程碑与路线图

| 里程碑 | 目标日期 | 内容 | 闸门 |
|---|---|---|---|
| M0 平台基线 | 2026-10-09 | 资产对账、设计点登记表、DesignSpec schema、目录与 run 规范 | 你确认主设计点 |
| M1 一维平台化 | 2026-10-23 | 网络求解器（板级 + 托盘级）、PG25 6 °C 重算、回归测试、Simulink 对照模型立项 | DR2 复核 |
| M2 CAD v2 内核 | 2026-11-06 | `pitch_x/pitch_y`、v2 对账表、HBM 方案 D、水嘴接口、流体域抽取 | G-A |
| M3 CFD V&V 与整板 | 2026-12-04 | V1/V4、单胞网格无关、1/2 整板、工况矩阵首批 | DR3（仿真） |
| M4 结构与工程图 | 2026-12-18 | Mechanical 承压/压装、DXF/SolidWorks 图纸、AI 审图 | DR3（图纸）、G-B |
| M5 试验方案与 V&V 链 | 2027-01-15 | 试验大纲、DAQ schema、透明样与 TTV 方案、数据 V&V 脚本（样件到货后执行） | DR4 准备、G-D |
| M6 数字孪生 | 2027-02-26 | ROM 代理模型、托盘→CDU 系统 FMU、校准框架 | DR5 |
| M7 AI 控制 | 2027-03-31 | PID/MPC/RL、SIL 场景库、HIL 方案 | DR6 |

M3 之后，M4 与 M5 可以并行；M6 依赖 M3 的 CFD DOE 数据；M7 依赖 M6。

## 10 风险与对策

| 编号 | 风险 | 等级 | 对策 |
|---|---|---|---|
| PR-01 | 两套设计口径长期并存，结论互相污染 | 红 | M0 建设计点登记表；`spec_diff` 冲突报警；报告强制标设计点 |
| PR-02 | 热阻真值落在保守端（RK-01） | 红 | 按 V4 锚定后的整板 CFD 收窄区间；R1 杠杆：孔径、TIM2、流量 |
| PR-03 | Ansys 许可或算力不足以跑整板（3000–8000 万单元） | 橙 | 1/2 对称；先单胞 + 子模型；CPU 并行；必要时云 HPC；OpenFOAM 备选 |
| PR-04 | OEM 输入（C-01–C-03）长期缺失 | 橙 | 平台以"候选几何 + 假设登记"推进；输入到位后脚本一键重算 |
| PR-05 | OCC 段错误、Windows/PowerShell 兼容问题 | 黄 | 过切、重试、多步命令写脚本（已沉淀在 `environment.md`） |
| PR-06 | AI 生成的脚本/结论出错且未被发现 | 橙 | 规则门 + 回归测试 + 证据等级；闸门人工审核 |
| PR-07 | ROM 外推失真 | 橙 | 训练域边界检查，越域即回退到一维/CFD |
| PR-08 | RL 控制不安全 | 橙 | 只在孪生内训练；规则层兜底；G-E 闸门 |
| PR-09 | 记忆膨胀、过期口径被引用 | 黄 | `memory_gc` 打 expired；index 只列有效条目；每里程碑复核 |
| PR-10 | 单张 RTX 4090 同时负责显示，GPU 求解卡死桌面 | 黄 | 遵守显存规则；大网格只用 CPU |

## 11 投入估算

| 阶段 | AI 执行（小时） | 你的审核（小时） | 主要外部依赖 |
|---|---|---|---|
| M0 平台基线 | 8 | 3 | — |
| M1 一维平台化 | 24 | 6 | MATLAB（辅线） |
| M2 CAD v2 | 24 | 6 | — |
| M3 CFD V&V 与整板 | 40 + 求解机时 | 10 | Fluent 许可、算力 |
| M4 结构与工程图 | 24 | 8 | Mechanical、SolidWorks |
| M5 试验方案 | 16 | 8 | 台架、样件 |
| M6 数字孪生 | 32 | 8 | optiSLang（可选） |
| M7 AI 控制 | 32 | 8 | — |
| 合计 | 约 200 | 约 60 | — |

估算基于"AI 执行 + 人审核"的模式，求解机时与样件制造周期另计。逐步骤工时见《实施计划》§13。

## 12 需要你决策的开放问题

| 编号 | 问题 | 选项 | 影响 |
|---|---|---|---|
| Q-01 | 主设计点 | A：v2.1 PG25、1400 W、温升 6 °C 为主，水 1100 W 留作基线；B：v2.0 水 1100 W 为主；C：两者并行 | 一维、CFD 工况、流量、压降上限判定 |
| Q-02 | 整板孔径 | D0.50（一维/CAD）或 D0.40（CFD 网格），或两者都进工况矩阵 | CAD 内核、CFD 网格 |
| Q-03 | Ansys 许可模块 | Fluent / Mechanical / Fluent Meshing / optiSLang / Twin Builder / Icepak 各是否可用，并发数 | ⑤⑥⑧ 选型 |
| Q-04 | MATLAB 许可 | 是否有 Simulink、Simscape Fluids/Thermal、MPC Toolbox、Reinforcement Learning Toolbox | 一维辅线、⑨ 工具 |
| Q-05 | 正式工程图平台 | SolidWorks / NX / 只用开源（FreeCAD） | ⑥ 出图后端 |
| Q-06 | 算力 | 是否有可用的 CPU 集群或云 HPC | 整板 CFD 规模与周期 |
| Q-07 | 试验资源 | 是否有台架（恒温水箱、流量计、红外、PIV）或外协 | ⑦ 计划 |
| Q-08 | 智能体结构 | 保持单一 cp-design + 技能，还是新登记 `cp-cfd`/`cp-twin` 同级智能体 | 平台层变更 |
| Q-09 | PG25 分配工作簿 | `GB300_冷板液冷热量与流量分配表_PG25_20260929.xlsx` 的位置，是否作为输入纳入 spec | 设计点登记表 |

## 13 附录：来源文件

| 文件 | 日期 | 用途 |
|---|---|---|
| `references/NVIDIA_B300_微通道冲击换热冷板设计报告_v2.0_20260914new.html` | 2026-09-14 | 水基线设计全文（目标、输入、流程、一维、CFD 需求、试验、风险、开放项） |
| `references/NVIDIA_B300_微通道冲击换热冷板设计报告_v2.1_PG25_20260929.html` | 2026-09-29 | PG25、1400 W、温升 6 °C 口径 |
| `references/NVIDIA_Grace_GB300_冷板详细设计报告_v1.0/v1.1` | 2026-09-26/29 | Grace 冷板 |
| `references/UC01_壁面射流与三槽流路说明.html` | 2026-09-20 | 单元胞流动机理 |
| `references/参考_GB300_Grace_CPU与液冷边界_20260926.html` | 2026-09-26 | Grace 边界摘录 |
| `references/AI算力芯片液冷冷板技术调查分析报告_v1.3_20260907.html` | 2026-09-07 | 技术路线、规格包络、水质标准 |
| `references/AI算力芯片液冷冷板专利分析报告_v1.4_20260907.html` | 2026-09-07 | 方案 A 权项、FTO 风险 |
| `cycle-20260926/*.html` | 2026-09-26 | 一维–CAD–单胞 CFD–结构一轮循环 |
| `memory/`、`knowledge/`、`skills/` | 2026-09-26 至 10-01 | 锁定口径、环境、CAD 轨道、CFD 规则 |
| `mcp/server.py`、`oned.py`、`zones.py`、`ui/` | 2026-09-26 | 现有工具 |
| `platform/CLAUDE.md`、`platform/router.config.json` | 2026-09-26 | 平台宪法与路由 |
