bruce2012lu/AIDCtms_design202609/coolingplate/agent/practice01_0926/planning/项目规划_v1.0_20261002.md

# AI 赋能的算例驱动液冷冷板系统设计平台 · 项目规划 v1.0

> 文档编号 AIDC-CP-PLAT-PLAN-001 · 版本 v1.0 · 2026-10-02 · 模块 `cp-design`（`agents/AIDCtms/coolingplate/agent/practice01_0926/`）
> 配套文件：[实施计划 v1.0](实施计划_v1.0_20261002.md)。本文件是规划，不是设计报告，也不是订单 ICD；文中所有设计数字都来自已有报告与记忆，并注明出处与证据等级。
> 状态：**规划草案，待用户评审**。本轮不安装技能，不写正式记忆，不提交 git。

## 1 结论先行

> **一句话**：以现有 B300 冷板 v2.0（①–④ 已完成）为第一个标杆算例，建设一个“算例驱动、AI 编排、人工把关”的冷板设计平台。平台按 ①–⑦ 门控流程补齐 ⑤ 三维仿真、⑥ 机械与图纸、⑦ 样件与试验，再延伸出 ⑧ 数字孪生和 ⑨ 孪生在环 AI 控制。两条迭代回路 R1（仿真）和 R2（V&V）由 AI 自动化推进，几何冻结、启动大算例、外协花钱和动实物这四类动作必须先经人确认。（置信度：中高。工具许可和 OEM 输入未确认，它们决定工期。）

**推荐技术栈（首期）**：

| 环节 | 主力 | 交叉验证 / 备选 | 依据 |
|---|---|---|---|
| ④ 一维 | 自研 Python 一维网络包（在 `design/calc/model.py`、`oned.py`、`zones.py` 基础上扩展） | MATLAB R2025b + Simscape Fluids（经 `ai-matlab`），用于托盘/CDU 系统级与瞬态 | 已有、可复算、与报告同源；本机已装 MATLAB 与 Simscape Fluids |
| ⑥ CAD | build123d（`cad/.venv`，已接入 rules 门与 MCP） | SpaceClaim 脚本（已装）做流体域与命名选择；SolidWorks/NX 只在客户要求原生图时引入 | 规则门已在用，AI 易写，免许可 |
| ⑤ CFD/CAE | Ansys Fluent 2026 R1（journal + PyFluent）+ Fluent Meshing；Mechanical 做压装/承压 | OpenFOAM chtMultiRegionFoam 作免许可交叉验证；Icepak 只用于托盘级 | 已有 UC-01b 收敛经验与技能 |
| ⑥ 工程图 | build123d → ezdxf DXF + AutoCAD 2024 审图（已装） | SolidWorks 工程图 API（需许可） | 可脚本、可审 |
| ⑦ 试验 | 自建 TTV 测试台 + Python DAQ + ASME V&V 20 / PTC 19.1 不确定度 | 外协第三方实验室 | v2.0 §11 已给型式试验大纲 |
| ⑧ 孪生 | 校准后的一维网络 + CFD 代理模型（optiSLang/GPR），打包 FMU | Ansys Twin Builder/TwinAI ROM、Simscape 系统模型 | 先物理、后数据；FMU 统一接口 |
| ⑨ 控制 | Simulink + MPC Toolbox，PID 作基线 | RL Toolbox（带安全屏蔽）；Python do-mpc/CasADi | 本机已装 MPC、RL、Simulink Test |

**阶段与工期概要**：8 个阶段（P0 基线整理 → P7 孪生在环控制），自 2026-10-05（W1）起约 **40 周**，到 2027-07 上旬结束。关键路径是 P3 整板 CFD → P4 图纸 → P5 样件与试验。详细排期见 [实施计划](实施计划_v1.0_20261002.md)。

| 阶段 | 内容 | 周次 | 门控 |
|---|---|---|---|
| P0 | 基线整理与平台骨架 | W1–W2 | G0 基线评审 |
| P1 | 一维工具（Python 主 + Simscape 交叉） | W2–W7 | DR2′ 一维再基线 |
| P2 | AI + CAD 概念（内核升 v2） | W5–W10 | DR1′ 几何再选定 |
| P3 | 三维 CFD / CAE | W8–W20 | DR3·仿真评审 |
| P4 | 工程图 | W17–W22 | DR3·图纸闸门 |
| P5 | 样件、试验与 V&V | W19–W32 | DR4 送样放行 |
| P6 | 数字孪生 | W24–W34 | DT 精度门 |
| P7 | 孪生在环 AI 控制 | W30–W40 | CTRL 安全门 |

**最先要用户拍板的三件事**：① 主设计点用 v2.1 PG25 / 1400 W / 6 °C，还是 v2.0 水 / 1100 W；② Ansys、MATLAB 各模块的许可与整板 CFD 的算力预算；③ 是否授权把参数化内核升级到 v2（`pitch_x/pitch_y`、216 孔），并给冻结 yaml 升版本。完整清单见第 15 章。

## 2 项目愿景与范围

### 2.1 愿景

把“冷板设计 → 桌面验证 → 样件试验 → 数字孪生 → 智能控制”做成一条可复算、可审计、可迭代的平台流水线。AI 承担计算、脚本、批处理、对账、报告和簿记，人负责判断、冻结、花钱和动实物。所有资产以纯文本落在本仓库，遵循平台层 `platform/` → 模块 `agents/<id>/` 的继承结构。

### 2.2 “算例驱动”的含义

平台的基本单位是**算例**（case）。一个算例就是一个设计对象在一组设计点下的完整证据包：输入追溯、一维计算、几何、仿真、图纸、试验、孪生、控制。

| 算例 | 对象 | 当前进度 | 平台中的角色 |
|---|---|---|---|
| CASE-01 | CP-B300-JM-01 B300 冲击微通道冷板 | ①–④ 完成，⑤ 单元胞 CFD 部分完成 | 标杆算例，首个走完 ①–⑨ |
| CASE-02 | CP-GRACE-MC-01 Grace 平行微通道冷板 | ①–④ 一维完成（v1.0 / v1.1） | 第二算例，验证平台对“非射流”构型的通用性 |
| CASE-03 | GB300 计算托盘 4 GPU + 2 Grace 并联回路（含 CDU 二次侧） | 只有分配表与原则 | 系统级算例，是数字孪生与在环控制的被控对象 |

每个算例都按同一套门控（DR0–DR4 + DT + CTRL）推进，复用同一套技能与工具适配器，数字只有一个来源。

### 2.3 范围

| 范围内 | 范围外 |
|---|---|
| 单相冷板（水 / PG25）设计计算、几何、CFD/CAE、图纸、送样试验、V&V | 两相冷板、浸没式、纳米流体工质（技术调查 v1.3 已判定不进 TCS 基线） |
| 托盘级并联回路与 CDU 二次侧泵阀的一维/系统模型、孪生与控制 | CDU 一次侧、冷却塔、FWS 设施侧设计 |
| 试验台方案、DOE、数据采集脚本、不确定度与 V&V | 量产线工艺开发、FAT 保证书 |
| 专利/FTO 初筛清单（非法律意见） | 正式 FTO 法律意见 |
| AI 智能体、技能、记忆、MCP 适配器的规划与沉淀机制 | 修改平台层宪法（只提建议，由人决定） |

### 2.4 成功标准

1. CASE-01 在 DR3 拿到网格无关（GCI < 3%）的整板（或 1/2 对称）共轭结果，并关闭 v2.0 §10.1 的 Q1–Q8。
2. CASE-01 首件 TTV 实测与 CFD 偏差的绝对值 ≤ 15%，或触发 R2 后完成模型修正并闭环。
3. 孪生 ROM 在设计包络内相对 CFD 偏差 ≤ 5%、相对试验 ≤ 10%，单次评估时间 < 1 s。
4. 孪生在环控制在 MIL/SIL 场景下零安全约束违约，泵功比 PID 基线降低 ≥ 10%（目标值，待 P7 标定）。
5. 至少 8 个经用户验证的技能和 10 条经验证的语义记忆入库，字段齐全、可继承。

## 3 现状盘点

### 3.1 已有资产

| 类别 | 资产 | 位置 | 状态 |
|---|---|---|---|
| 智能体模块 | `cp-design` 角色、画像、薄加载器、registry 登记 | `agent.md`、`memory/profile.md`、`.claude/agents/cp-design.md`、`platform/registry.json` | 可用 |
| 技能 | `design-loop`、`cad-loop`、`cfd-loop`、`fluent-gui-capture` | `skills/` | 已验证，在用 |
| 语义记忆 | B300 设计锁定、UC-01b CFD、本机环境、Grace 与托盘、四条 CAD 轨道、Fluent 取图 | `memory/semantic/` | 字段齐全，置信度 0.75–0.9 |
| MCP | `cp-design` 服务：`kb_catalog`、`memory_list`、`cad_tracks`、`cad_inspect`、`cad_build`、`oned_design`、`hbm_design`、`grace_design` | `mcp/server.py` | stdio + HTTP 8765 |
| 设计台 | 本地 HTML 设计台（总览 / 1D / HBM / Grace / CAD / CFD / 知识库 / 记忆） | `ui/`、`启动冷板设计台.ps1` | 可用 |
| 一维 | `design/calc/model.py`（唯一数值源）、`oned.py`（Martin 有效域门 + 低 Re 准则）、`zones.py`（HBM / Grace） | 模块根与 `design/calc/` | 可复算 |
| CAD | 参数化内核 v1.0（128 孔、单一节距）；本轮 `build_cad.py` 按 model.py 出 216 孔整板与单孔胞 STEP | `cad/`、`cycle-20260926/out/cad/` | 内核未升 v2 |
| CFD | UC-01b 单元胞（ICEM + Fluent）、HBM 七槽交错流、HBM 方案 D 网格 | `design/cfd*/` | 单元胞已收敛，整板未做 |
| 报告 | B300 v2.0 / v2.1、Grace v1.0 / v1.1、UC01 说明、Grace 边界摘录、技术调查 v1.3、专利分析 v1.4 | `references/` | 已读 |
| 本机 | i9-14900KF 24 核 / 128 GB / RTX 4090 24 GB；Ansys 2026 R1；MATLAB R2025b；AutoCAD 2024 | 环境记忆 + 2026-10-02 探测 | 许可未确认 |

### 3.2 v2.0 已完成 ①–④ 的关键结论（水基线）

来源：《NVIDIA B300 微通道冲击换热冷板设计报告 v2.0》（2026-09-14），证据等级：一维。

| # | 项 | 结论 / 数据 |
|---|---|---|
| 1 | 对象与结构 | CP-B300-JM-01，95 × 75 × 8.5 mm，紫铜 C11000/TU1，三件（底板 / 喷嘴板 / 钎料框），送样螺接、量产真空钎焊，不用整板增材 |
| 2 | 设计点 | DP-A 保证点 1100 W @ 水 40 °C、2.0 L/min（GPU 1.60 / HBM 0.40）；DP-B 包络 1400 W @ 2.4 L/min |
| 3 | 方案选型（DR1） | GPU 区射流 + 短槽、HBM 区无喷嘴 + 流速帽 0.80 m/s、隔离肋，加权 4.50 分，对齐专利方案 A |
| 4 | 射流几何 | 每 die 9 × 12，两 die 216 孔，D 0.50 mm，Sx 3.0 × Sy 2.4 mm，H 2.0 mm（H/D 4），f = 0.0273 |
| 5 | 关联式有效域 | Re_D ≈ 478，低于 Martin 1977 下限 2000，不采用 Martin；保证值改用低 Re 短槽肋模型（槽是肋不是导管，cell 拓扑 0.034 m/s） |
| 6 | 热性能（DR2 有条件通过） | 壳–进液 0.0326–0.0366 °C/W，目标 < 0.028、门槛 ≤ 0.032，区间跨目标线，结论为“方案通过、性能待证”；Tj 85–93 °C |
| 7 | 水力 | 板内压降 3.5–5.5 kPa（目标 ≤ 18，上限 20，其中静压箱 3–5 kPa 为估值 AS-7）；HBM 近壁 0.463 m/s；流体温升 7.96 K |
| 8 | 杠杆（R1 优先级） | 孔径 0.50 → 0.40/0.35、TIM2 ≤ 0.004 °C/W、流量 2.0 → 2.4、阵列加密、槽深 1.5 → 0.8–1.0（OPT-1） |
| 9 | 门控状态 | DR0 完成（含 6 项缺失输入）、DR1 完成、DR2 有条件通过、DR3 未完成、DR4 未开始 |
| 10 | 开放项 | C-01 封装图、C-02 power map、C-03 单板额定流量（三块地基）；C-07 共轭 CFD、C-08 TIM2、C-09 首件 TTV、C-10 正式 FTO |

### 3.3 v2.1 PG25 修订与口径并存

来源：B300 v2.1、Grace v1.1（2026-09-29，2026-09-30 修订），证据等级：一维。

- 工质改为 PG25 40 °C，模组功率按项目值 **1400 W**（GPU 核心 910 W、HBM 八堆 350 W、其他 140 W），设计冷却液温升按项目要求 **6 °C**。模组设计流量 3.512 L/min，单颗 HBM 0.1096 L/min，Grace 0.753 L/min，机柜约 351.2 L/min。
- 限值：射流孔速 ≤ 2.0 m/s，HBM 近壁 ≤ 0.80 m/s，板内压降上限仍为 20 kPa。0.50 mm 孔在 GPU 2.283 L/min 下孔速 0.897 m/s，通过。
- **未闭合**：PG25 大流量下整板压降是否 < 20 kPa（按流量平方外推约 14–24 kPa，只是外推）；壳–进液热阻未按 PG25 重算；HBM 中点进液歧管孔位未定；Grace 现有 4 × 1.04 mm 孔板在 PG25 0.8 L/min 下约 22.9 kPa，超过 20 kPa，需要重配。
- v2.0 的水结论保留为**水基线**，两套口径同时成立，平台必须用“设计点注册表”把它们分开（第 8.2 节）。

### 3.4 ⑤ 三维仿真与 ⑥ CAD 的已有进展

| 项 | 结果 | 证据等级 / 来源 |
|---|---|---|
| UC-01b 单元胞（D 0.40，2.4 × 3.0 mm） | m425 网格 4,259,680 HEXA，iter 380 收敛；压降 1087.09 Pa；TIM 底 341.385 K；R(TIM–进液) 0.0313 °C/W，R_conv 0.0149 °C/W；能量闭合 1.0015 | 单元胞 CFD · `cycle-20260926/03`、UC01b 契合性报告 |
| 一维与单元胞对照 | 压降 CFD 比孔口一维高 26.1%（路径不同，一维只有孔口项）；质量加权温升偏差 +0.15% | UC01b 契合性报告 2026-09-25 |
| HBM 七槽交错流（0.80 × 2.00） | iter 200，连续性残差 2.6 × 10⁻⁴ 未达 10⁻⁴；温升比一维高 7.96%，标“限制” | HBM 契合性报告 2026-09-28 |
| HBM 方案 D（2026-10-01） | 十一条槽并联、中间进水、PG25 每颗 0.15 L/min，静压仓 + 中缝；网格 861 万；汇流槽网格 1223 万超出单卡 GPU 显存，仅 CPU | 语义记忆 `b300-design-lock` |
| 参数化内核 | 锁 v1.0：128 × D0.50、单一节距；缺 `pitch_x/pitch_y`，建不了 v2 216 孔 | `cad-kernel-gap.md` |
| 本轮整板 STEP | `build_cad.py` 按 model.py 生成 216 × D0.50 三件，包围盒 95 × 75 × 8.5 mm 回读核对通过；不含水嘴、UQD、静压箱 | `cycle-20260926/02` |
| 结构 | 3 bar 板条解析校核，盖板跨射流阵安全系数 4；非 Mechanical 全场 | `cycle-20260926/04` |

### 3.5 差距与 ⑤⑥⑦ 待办

| 环节 | 差距 | 平台要补的能力 |
|---|---|---|
| ① 输入 | OEM 封装图、power map、单板流量窗、UQD、压装力缺失 | 输入追溯矩阵自动维护；缺失项责任人 / 日期提醒；ICD 到位后的影响分析 |
| ④ 一维 | 单点关联式，不含歧管网络与温变物性；PG25 与水两套脚本；无系统级瞬态 | 一维网络求解 + 不确定度传播 + 校准接口；Simscape 系统模型 |
| ⑤ CFD | 只有单元胞；无整板 / 半板；无网格无关性、无 V4 锚定；PG25 整板压降未知 | 批处理与监控、GCI、契合性自动报告、工况矩阵 C01–C12、Mechanical |
| ⑥ CAD / 图纸 | 内核 v1；无水嘴 / UQD / 静压箱特征；Grace 未接规则门；无 GD&T 图纸 | 内核 v2、流体域抽取、自动出图与 GD&T 检查表 |
| ⑦ 试验 | 未开始 | 测试台、DOE、DAQ、不确定度、V&V 20 |
| ⑧⑨ | 不存在 | ROM / FMU、在线校准、MPC / RL、MIL → SIL → HIL |

### 3.6 需要在 P0 收口的口径冲突

| # | 冲突 | 现状 | 处理建议 |
|---|---|---|---|
| K-1 | 主设计点 | v2.0 水 1100 W / 2.0 L/min 与 v2.1 PG25 1400 W / 6 °C 并存 | 用户决策；建议 PG25 为主、水为对照基线 |
| K-2 | 孔径 | model.py GEO 为 D 0.50；已收敛单元胞网格为 D 0.40 | 在注册表里两档并列，DR3 用 C11 变体收口 |
| K-3 | 孔数 | 内核 / asm_0921 为 128；v2 文字 / model.py 为 216 | 内核升 v2 后统一；v1 保留为历史轨道 |
| K-4 | HBM 截面 | v2.1 报告写 7 × 0.80 × 2.00 mm；2026-10-01 语义记忆写方案 D 11 × 0.45 × 2.00 mm | 读最新 HBM 日志后由用户确认哪一个是当前点 |
| K-5 | 过滤等级 | 报告 / 参数集写 25 μm；按孔径 1/10 规则为 50 μm | 取更严的 25 μm，写明理由 |
| K-6 | 损坏记忆 | `uc01b-lessmesh.md` 中文损坏 | 不整篇继承，P0 标注并只引用 bc216 版 |

## 4 需求分析

### 4.1 干系人

| 干系人 | 关注点 | 平台中的交互 |
|---|---|---|
| 项目负责人 / 冷板设计师（用户） | 设计正确、进度、成本、知识沉淀 | 下指令、验证产出、过闸门、决策 |
| OEM / 客户（ICD 提供方） | 封装接口、流量窗、可交付性 | 提供 C-01–C-04 输入；评审 DR3/DR4 |
| 托盘 / CDU 系统设计方 | 并联分流、压降窗、泵阀策略 | CASE-03 输入；孪生与控制的被控对象 |
| 工艺与外协加工厂 | 可制造性、公差、交期 | 图纸与询价包的接收方 |
| 试验室 / 技术员 | 测试台、安全、数据 | 执行 ⑦ |
| IP / 专利 | FTO、权利要求布局 | 接收专利对照清单 |
| 平台维护者（orchestrator / 各 agent） | 命名零漂移、记忆治理、成本 | 技能 / 记忆入库、registry 登记 |
| AI 智能体（cp-design、ai-matlab、librarian、thermal-management） | 清楚的边界、可调用的工具 | 执行与簿记 |

### 4.2 功能需求

| 编号 | 需求 | 对应流程 | 优先级 |
|---|---|---|---|
| FR-01 | 输入追溯矩阵与假设登记册：从 ICD / 规格 / 报告中抽取，标来源、状态、影响章节 | ① DR0 | 高 |
| FR-02 | 设计点注册表：同一对象的多套口径（水 / PG25、1100 / 1400 W）分开登记、可选用 | ①–⑨ | 高 |
| FR-03 | 文献 / 专利检索与权衡矩阵生成（经 librarian） | ② DR1 | 中 |
| FR-04 | 一维网络求解：歧管、静压箱、孔口、短槽、HBM 支路、Grace 支路，温变物性，关联式有效域门 | ③④ | 高 |
| FR-05 | DOE、敏感性、不确定度传播（蒙特卡洛 / 拉丁超立方） | ④ | 高 |
| FR-06 | 系统级（托盘 / CDU）一维瞬态模型 | ④⑧⑨ | 中 |
| FR-07 | 参数化 CAD v2：各向异性节距、HBM 中心进液、静压仓、水嘴 / UQD 接口，规则门先于建模 | ⑥ DR1′ | 高 |
| FR-08 | 流体域抽取、命名选择、网格前处理脚本 | ⑤ | 高 |
| FR-09 | CFD 批处理：journal / PyFluent 生成、提交、监控残差与监测量、显存 / 算力门 | ⑤ | 高 |
| FR-10 | 网格无关性（GCI）与一维–CFD 契合性自动报告 | ⑤ DR3 | 高 |
| FR-11 | 回路 R1 自动化：不达标时按杠杆优先级提出变体，经人确认后重跑一维 → CAD → CFD | ⑤ → ③④ | 高 |
| FR-12 | 结构分析：承压、压装、钎焊热变形、平面度 | ⑥ | 中 |
| FR-13 | 工程图自动生成：三视图、剖面、孔位、BOM、GD&T、焊接符号、检验表 | ⑥ DR3 | 高 |
| FR-14 | 试验大纲、DOE、DAQ 采集脚本、数据清洗与不确定度预算 | ⑦ | 高 |
| FR-15 | V&V 20 对比与回路 R2 自动判读 | ⑦ → ③ | 高 |
| FR-16 | ROM / 代理模型训练、FMU 打包、在线校准 | ⑧ | 中 |
| FR-17 | 孪生在环控制：PID / MPC / RL，MIL → SIL → HIL | ⑨ | 中 |
| FR-18 | 报告与规划 md + html 双格式生成（单文件自包含、左侧折叠目录） | 全流程 | 中 |
| FR-19 | 技能 / 记忆候选登记、闸门确认、入库、过期标记 | 治理 | 高 |
| FR-20 | 设计台 UI 增加 CFD 监控页、算例总览与门控看板 | 交互 | 低 |

### 4.3 非功能需求

| 编号 | 需求 | 度量 |
|---|---|---|
| NFR-01 可复算 | 任何报告数字可由脚本重算 | 报告数字 100% 有脚本来源；回归测试通过 |
| NFR-02 可追溯 | 每个 run 有 manifest（输入哈希、工具版本、设计点、证据等级、收敛状态） | 100% run 有 manifest |
| NFR-03 证据分级 | 结论带“一维 / 单元胞 / 整板 / 实测”与日期 | 报告抽查无缺 |
| NFR-04 离线可用 | 报告、规划、设计台离线可打开 | 无外部 CDN / 字体依赖 |
| NFR-05 安全 | 密钥只读环境变量；客户 ICD 机密按 `on_sensitive_data` 路由 | 仓库扫描无密钥 |
| NFR-06 人工闸门 | 冻结几何、大算例、外协下单、实物控制都需人确认 | 工具 `confirm=true` 强制 |
| NFR-07 性能 | 一维单点 < 1 s；1000 点 DOE < 10 min；ROM 单次 < 1 s | 基准测试 |
| NFR-08 可扩展 | 新算例只需新增设计点与几何轨道，不改核心 | CASE-02 接入验证 |
| NFR-09 不破坏冻结件 | 冻结 yaml、已发放 STEP 只读；候选产物只进 `runs/` | 规则门 + git diff 检查 |
| NFR-10 本机资源保护 | GPU 显存与桌面占用遵守 `cfd-loop` 显存门；长作业可中断续算 | 无桌面卡死事件 |

### 4.4 输入工况与指标

| 设计点 ID | 对象 | 工质 / 进液 | 功率 | 流量 | 主要指标 | 来源 / 状态 |
|---|---|---|---|---|---|---|
| B300-W-DPA | B300 整板 | 水 40 °C | 1100 W | 2.0 L/min（GPU 1.60 / HBM 0.40） | 壳–进液 < 0.028 °C/W（门槛 ≤ 0.032）；压降 ≤ 18 kPa（上限 20）；HBM 近壁 ≤ 0.80 m/s；两 die 中心温差 ≤ 5 K | v2.0，水基线 |
| B300-W-DPB | B300 整板 | 水 40 °C | 1400 W | 2.4 L/min | 壳–进液 < 0.025 °C/W（仅仿真包络） | v2.0 |
| B300-W-WORST | B300 整板 | 水 45 °C | 1100 W | 2.0 L/min | 需复核（预算 0.0289–0.0329） | v2.0 §1.3 |
| B300-P25-6K | B300 模组 | PG25 40 °C | 1400 W（GPU 910 / HBM 350 / 其他 140） | 3.512 L/min（原分配表 4.0–4.2） | 冷却液温升 6 °C；孔速 ≤ 2.0 m/s；HBM 近壁 ≤ 0.80 m/s；压降 ≤ 20 kPa（待证）；热阻待重算 | v2.1，建议主设计点 |
| HBM-P25 | 单颗 HBM | PG25 40 °C | 43.7 W | 0.1096 L/min（原表 0.15–0.18） | 近壁 ≤ 0.80 m/s；表面极差无官方限值 | v2.1 |
| GRACE-W | Grace 冷板 | 水 40 °C | 300 W | 0.55 L/min（包络 0.70） | 壳–进液 < 0.080 °C/W；支路 8–12 kPa | Grace v1.0 |
| GRACE-P25 | Grace 冷板 | PG25 40 °C | 300 W | 0.753 L/min（原表 0.8） | 孔板重配后支路 ≤ 20 kPa | Grace v1.1 |
| TRAY-P25 | 计算托盘 | PG25 | 6.2 kW | 18–20 L/min（原表） | 并联分流偏差、托盘压降 | v2.1 分配表 |

试验与孪生阶段另需：瞬态工况（负载阶跃 0 → 100% / 100% → 30%）、断流 / 泵故障、进液温度阶跃 40 → 45 °C、HBM 支路堵塞 20%（C10）。

### 4.5 验收准则

| 编号 | 准则 | 判据 | 对应门 |
|---|---|---|---|
| AC-1 | 一维工具复现既有报告 | 复现 v2.0 §9、v2.1 第 1–4 节、Grace v1.1 第 3 节的数字，相对偏差 ≤ 0.5% | DR2′ |
| AC-2 | CAD v2 | 216 孔 / 各向异性节距 / HBM 当前方案可建；规则门 pass；STEP 回读包围盒与体积校核通过 | DR1′ |
| AC-3 | CFD 可信 | 残差（连续 / 动量 < 1e-4，能量 < 1e-6）；能量守恒 < 1%；质量 < 0.1%；GCI < 3%；V4 锚定相对 Martin ≤ 15% | DR3·仿真 |
| AC-4 | 性能结论 | Q1–Q8 有单值或可信区间，并判定是否满足 4.4 指标 | DR3·仿真 |
| AC-5 | 图纸可外协 | 尺寸链闭合；GD&T、表面处理、焊接、检验要求齐全；外协能据此报价 | DR3·图纸 |
| AC-6 | 试验可判 | 热阻测量扩展不确定度 ≤ ±5%（k = 2）；出厂三曲线齐全 | DR4 |
| AC-7 | V&V 闭环 | 偏差绝对值 ≤ 15%，或 R2 修正后复核通过 | DR4 |
| AC-8 | 孪生精度 | 包络内相对 CFD ≤ 5%、相对试验 ≤ 10%；评估 < 1 s | DT 门 |
| AC-9 | 控制安全 | MIL/SIL 全场景零约束违约；HIL 下发前人工确认 + 硬件联锁 | CTRL 门 |
| AC-10 | 治理 | 每步有 manifest；入库记忆字段齐全；无冻结件被改写 | 每步 |

## 5 技术架构

### 5.1 架构原则

1. **平台化继承**：共享能力放 `platform/shared/`（如报告生成、V&V 统计），冷板专属放 `cp-design` 模块。按平台规则，`cp-design` 不派生子智能体，靠技能与跨智能体协作扩展。
2. **单一数值来源**：设计数字只来自脚本和注册表，报告由脚本生成，不手抄。
3. **规则门先于执行**：几何先 `inspect` 再 `build`，CFD 先过显存 / 算力门再提交，试验先过安全检查表再加热。
4. **证据分级**：一维、单元胞、整板、实测四级，结论不跨级外推。
5. **人收口**：AI 做到草案、模拟、候选为止，冻结、花钱、动实物由人确认。
6. **工具可替换**：工具适配层统一接口，求解器换了不影响编排与数据层。

### 5.2 分层架构

```svg:arch
交互层：Cursor / Claude Code 对话 | 冷板设计台 UI(8765) | md+html 报告
智能体编排层：orchestrator(薄) → cp-design(主责) + ai-matlab + librarian + thermal-management
技能层：design-loop / cad-loop / cfd-loop / fluent-gui-capture（已有）+ 候选技能
工具适配层(MCP)：cp-design MCP | user-matlab MCP | Ansys 适配 | DAQ 适配 | 报告生成
求解与工具层：Python 一维 | MATLAB/Simscape | build123d | SpaceClaim | Fluent | Mechanical | optiSLang | AutoCAD | DAQ
知识与数据层：references | 设计点注册表 | memory | runs/算例包 | 大文件存储 | Dify RAG
右侧纵条：人工闸门 ①技能安装 ②记忆继承 ③资金动作 + 工程闸门 E1–E4（建议）
```

*图 5-1　平台分层架构。实线框为已有，虚线框为本规划新增或候选。*

| 层 | 职责 | 已有 | 新增（本规划） |
|---|---|---|---|
| 交互层 | 对话、设计台、报告 | Cursor / Claude Code、`ui/`、HTML 报告 | 门控看板、CFD 监控页、本规划的 md+html 生成器 |
| 智能体编排层 | 拆解、路由、汇总、闸门 | orchestrator、cp-design、ai-matlab、librarian | 算例状态机（DR0–CTRL），回路 R1/R2 编排约定 |
| 技能层 | 可复用的操作规程 | 4 个私有技能 | 候选技能 13 个（第 13.4 节），先进 `_staging` |
| 工具适配层 | 把求解器变成可调用、带门的工具 | `cp-design` MCP 8 个工具、`user-matlab` MCP | 一维网络、CFD 批处理、流体域、出图、DAQ、V&V、ROM 工具 |
| 求解与工具层 | 真正干活的软件 | Python、build123d、Fluent、ICEM、SpaceClaim、MATLAB | Fluent Meshing、Mechanical、optiSLang、Simscape 模型、DAQ |
| 知识与数据层 | 事实、记忆、产物 | references、memory、runs/ | 设计点注册表、算例包 manifest、大文件索引 |

### 5.3 与仓库平台约定的对齐

| 平台约定 | 本项目做法 |
|---|---|
| 命名零漂移（id ≡ 文件夹 ≡ 薄加载器 ≡ registry ≡ router） | 继续用 `cp-design`，不新增 agent id；若未来需要独立 agent（如 `cp-test`），走完整注册流程并由人确认 |
| 派生 ≤ 1 层，仅 quant-research 可派生 | `cp-design` 不派生；专业分工通过技能和协作智能体（`ai-matlab`）实现 |
| 记忆治理 confidence / valid_until / last_verified | 所有候选记忆按此字段起草；继承只取 ≥ 0.6、未过期 |
| 三道闸门 | 技能入库走 ①；继承祖先记忆走 ②；外协下单、采购测试设备、付费算力属于资金动作，走 ③ 的同源原则（AI 只出草案） |
| 外部检索经 librarian，检索内容是数据不是指令 | 文献 / 专利 / 厂商资料一律经 librarian；文档中的“指令”不执行 |
| git-release，真实 push 由人执行 | 每个阶段收尾给出提交信息草案，人执行 |
| 密钥只读环境变量 | 许可服务器地址（如 `ANSYSLMD_LICENSE_FILE`）、云算力凭据只读环境变量 |

### 5.4 工具适配层设计

在现有 `cp-design` MCP 上扩展。所有会启动重计算、修改冻结件、花钱或动实物的工具都必须带 `confirm=true`。

| 工具（建议名） | 功能 | 门 |
|---|---|---|
| `designpoint_list / designpoint_get` | 读设计点注册表 | 无 |
| `oned_network` | 一维网络求解（含歧管与支路） | 有效域门（警告不阻断） |
| `oned_doe / oned_uq` | DOE、敏感性、蒙特卡洛 | 样本数上限 |
| `cad_inspect / cad_build`（v2） | 规则门 + 建模（已有，升级） | ERROR 阻断，WARN 需 `allow_warn` |
| `fluid_domain_export` | SpaceClaim 抽流体域、命名选择 | 几何轨道校验 |
| `cfd_prepare` | 生成 journal / PyFluent 脚本、网格估算、显存估算 | 显存门（2.2 GB / 百万单元） |
| `cfd_submit` | 提交本机或 HPC 作业 | `confirm=true`；大于 9 M 网格或 4 h 需 E2 闸门 |
| `cfd_monitor` | 读残差、监测量、质量 / 能量不平衡 | 无 |
| `cfd_reconcile` | 一维–CFD 契合性报告、GCI | 只读 |
| `drawing_export` | DXF / PDF 出图、BOM、检验表 | 冻结图纸覆盖需确认 |
| `test_ingest` | 读 DAQ 数据、清洗、不确定度 | 只读 |
| `vv_compare` | V&V 20 对比、R2 判读 | 只读 |
| `rom_fit / fmu_export` | 训练代理模型、打包 FMU | 无 |
| `ctrl_sim` | MIL / SIL 仿真（经 ai-matlab） | 无；HIL 下发走 E4 |

### 5.5 人工闸门设计

平台三道闸门保持不变。下面四道工程闸门是本规划的**建议**。写进平台宪法属于平台层变更，需用户决定。

| 闸门 | 触发 | AI 能做到 | 人确认后 |
|---|---|---|---|
| 平台 ① 技能安装 | 新技能入库 / 第三方技能 | 起草 SKILL.md 放 `_staging` | 登记 registry |
| 平台 ② 记忆继承 | 采纳祖先记忆 | 筛选 ≥ 0.6、未过期 | 采纳 |
| 平台 ③ 资金动作（同源） | 外协下单、采购、付费云算力 | 询价包、采购清单草案 | 下单 / 付费 |
| E1 几何冻结变更 | 改冻结 yaml、覆盖已发放 STEP、内核升版 | 候选几何进 `runs/` | 升版并冻结 |
| E2 大算例启动 | 网格 > 9 M（单卡 GPU 门）、预计 > 4 h、占用 HPC | 估算网格 / 显存 / 时长 / 费用 | 提交 |
| E3 门控放行 | DR0–DR4、DT、CTRL 放行 | 准备证据包与判读 | 放行或退回 |
| E4 实物动作 | 测试台加热、泵阀控制、HIL 下发 | 模拟、草案、安全检查表 | 上电 / 下发（硬件联锁在先） |

## 6 各环节工具选型

### 6.1 选型准则

按权重打分：本机可用性与许可（25%）、能力匹配（25%）、AI 可编程性（20%）、与现有资产衔接（15%）、成本（10%）、团队 / 客户认可度（5%）。“已装”指本机已安装，许可是否覆盖待用户确认（2026-10-02 探测）。

### 6.2 一维设计计算

| 候选 | 优点 | 短板 | 本机 | 结论 |
|---|---|---|---|---|
| 自研 Python 一维网络包（扩展 `model.py` / `oned.py` / `zones.py`） | 已有且与报告同源；关联式有效域门已实现；AI 易改；免许可；可做 DOE / UQ | 系统级瞬态与控制需另建；验证要自己做 | 已有 | **主力：冷板级稳态、DOE、UQ、校准** |
| MATLAB / Simulink + Simscape Fluids（Thermal Liquid），经 `ai-matlab` + `user-matlab` MCP | 物理网络瞬态；泵、阀、换热器、管路库齐全；直接衔接 MPC / RL；可导 FMU | 冷板内部低 Re 关联式要自写 Simscape 组件；slx 二进制难做 diff；许可待确认 | 已装 R2025b，含 fluids、mpc、rl、sldo | **主力：托盘 / CDU 系统级、瞬态、控制对象** |
| Flownex | 热流网络成熟，有数据中心与泵阀库 | 未装；需许可；AI 接口弱 | 无 | 不推荐首期 |
| Ansys Twin Builder / Modelica（OpenModelica） | 原生 FMU；Modelica 开源 | 学习成本；与现有 Python 重复 | Twin 相关目录可见，许可未知 | P6 评估 |
| Excel 工作簿（现有 PG25 分配表） | 人易读 | 难复算、难版本管理 | 已有 | 降级为输出视图，由 Python 生成 |

**一维工具的推荐设计**：新包 `oned/`，分为物性（水 / PG25 温变）、关联式库（每个关联式自带有效域和来源）、元件（孔口、短槽肋、静压箱、歧管、HBM 中心进液支路、Grace 交错槽、孔板）、网络求解（Newton 迭代求压力–流量，耦合热阻网络）、UQ（拉丁超立方 / 蒙特卡洛）、校准（用 CFD / 试验反标定 K 与 Nu 系数）、报告。原 `model.py` 保持为回归基准，新包必须先复现它（AC-1）。

### 6.3 CAD 概念设计（AI + CAD）

| 候选 | 优点 | 短板 | 本机 | 结论 |
|---|---|---|---|---|
| build123d（OCP / OpenCascade）脚本化 | 已接 rules 门与 MCP；参数化；AI 易写；免许可 | OCC 共面布尔段错误（已有过切规避）；出工程图弱 | `cad/.venv` | **主力** |
| CadQuery | 同一 OCC 内核，社区大 | 与 build123d 重复 | 无 | 不另引入 |
| FreeCAD Python API | 开源；TechDraw 可出图；有 FEM | API 不稳，批处理脆 | 无 | 出图备选 |
| SpaceClaim / Discovery 脚本 | Ansys 原生；流体域抽取、共享拓扑、命名选择、修模 | IronPython 脚本，版本敏感 | 已装 v261 | **CFD 前处理主力** |
| SolidWorks API | 客户常用；工程图与 GD&T 强；已有 `.swp.bas` 宏后端 | 本机未装；许可费 | 无 | 客户要求原生图时引入 |
| NX Open / Creo Toolkit | 大厂标准（asm_0921 即 NX 12 导出） | 未装；成本高 | 无 | 不推荐首期 |

**AI 在 CAD 的角色**：把设计意图翻译成参数覆盖（overlay），先跑规则门（尺寸链、余铜、最小孔径、齿壁、深宽比、阵列越界、HBM 流速帽、过滤），通过后才建模；批量生成概念变体（孔径、阵列、槽深 OPT-1、HBM 方案），交给一维快速筛选，再挑 2–3 个进 CFD。生成式拓扑流道（arXiv 2604.10941 / 2608.22787）列为 P6 之后的研究选项。

### 6.4 三维 CFD / CAE（AI + Ansys）

| 候选 | 优点 | 短板 | 本机 | 结论 |
|---|---|---|---|---|
| Ansys Fluent 2026 R1 + journal / PyFluent | 已有 UC-01b 收敛经验与 `cfd-loop`、`fluent-gui-capture` 技能；共轭传热、转捩 SST、层流对照；原生 GPU 求解器 | 许可与 HPC 包；整板 30–80 M 网格超本机 | 已装 | **主力** |
| Fluent Meshing（水密流程、poly-hexcore） | 复杂整板几何可脚本化 | 需建立黄金流程 | 已装 | **整板网格主力** |
| ICEM CFD | 已有单元胞六面体网格 | replay 脆，复杂几何难 | 已装 | 只用于单元胞 |
| Icepak | 电子散热建模快 | 对 0.5 mm 射流常用多孔介质 / 降阶，会丢驻点（v2.0 §10.2） | 未确认 | 只用于托盘级系统散热 |
| Ansys Mechanical | 压装、承压、钎焊热变形；可映射 Fluent 温度场 | 许可 | 已装（aisol） | **结构主力** |
| optiSLang | DOE、优化、MOP 代理模型 | 许可 | 已装 | 优化与 ROM |
| OpenFOAM（chtMultiRegionFoam） | 免许可；可大规模并行 | 设置与验证成本高；Windows 需 WSL2 | 无 | 交叉验证 / 许可不足时的备份 |
| STAR-CCM+ / COMSOL | 能力强 | 未装 | 无 | 不推荐 |

**分级仿真路线**（避免整板起步）：

| 级别 | 对象 | 网格量级 | 本机可行性 | 目的 |
|---|---|---|---|---|
| L0 | 代码验证（层流圆管 fRe、平板） | < 1 M | 可 | V1 |
| L1 | 单元胞（已有）+ Re ≈ 3000 锚定 | 2–5 M | 可（`-t1 -gpu` ≤ 9 M） | V4、局部 h、孔口压降 |
| L2 | 单 die 条带 / 1/4 die | 8–15 M | CPU 可，GPU 不行 | 交叉流、流量一致性趋势 |
| L3 | 1/2 对称整板共轭 | 15–40 M | 需 HPC / 云 | Q1–Q8 正式结论 |
| L4 | 全板 + 水嘴 + 歧管 | 30–80 M | 需 HPC | DR3 终版、PG25 压降 |
| S1 | Mechanical 压装 / 承压 / 热变形 | 1–5 M | 可 | 平面度、HBM 偏载 |

### 6.5 工程图（AI + CAD）

| 候选 | 优点 | 短板 | 本机 | 结论 |
|---|---|---|---|---|
| build123d 投影 → ezdxf DXF → AutoCAD 2024 审图与标注 | 全脚本；已有 DXF 后端；AutoCAD 已装 | GD&T 符号需块库 / 模板 | 已装 | **首期主力** |
| FreeCAD TechDraw | 开源；可出 PDF | GD&T 支持有限 | 无 | 备选 |
| SolidWorks 工程图 / MBD API | GD&T 完整，外协认可度高 | 需许可 | 无 | 量产图或客户要求时 |
| STEP AP242 PMI（模型即定义） | 一份模型带公差 | 工具链支持不齐 | — | 远期 |

AI 负责：图纸清单与模板、视图与剖面自动生成、尺寸链与公差一致性检查、GD&T 检查表（平面度 0.05、Ra ≤ 0.8 μm、孔径 ⌀0.50 +0.03/0、喷嘴阵位置度 ⌀0.4 MMC、射流间隙 2.0 ± 0.10 等，来自 v2.0 §6.5）、焊接符号与检验要求表、BOM 与工艺卡。人负责最终审图与签发。

### 6.6 试验验证

| 项 | 方案 | 说明 |
|---|---|---|
| 测试对象 | 铜样（螺接可拆）+ PMMA 透明流道样 | 透明样用 PIV / 染色验证 cell / bank 流动拓扑（v2.0 §11.3） |
| 热源 | TTV：2 块 25 × 25 mm 加热块模拟双 die + 8 块小加热块模拟 HBM | 功率分区可调，覆盖 1100 / 1400 W |
| 回路 | 恒温循环机（40 / 45 °C，水与 PG25）、齿轮泵或变频泵、过滤 25 μm、科氏或电磁流量计、差压变送器 | 支持 P7 的泵阀控制 |
| 测量 | T 型热电偶 / RTD 埋入加热块、壳温测点、红外热像仪、分区流量计 | 按 ASME PTC 19.1 做不确定度预算 |
| 采集 | NI cDAQ 或 Keysight DAQ970A 等；Python `nidaqmx` / `pyvisa` | 采集脚本由 AI 写，人审接线与安全 |
| DOE | 流量 × 功率 × 进液温度 × 工质的分层析因 + 中心点重复 | 先做可判性（重复性）再做全矩阵 |
| 判据 | v2.0 §11.1 出厂检验 5 项、§11.2 型式试验 T1–T8 | DR4 |
| 方式选择 | 自建台（可支撑 P7 HIL）或外协实验室（快，但 HIL 难） | 用户决策 |

### 6.7 数字孪生（ROM）

| ROM 类型 | 工具 | 优点 | 短板 | 用途 |
|---|---|---|---|---|
| 校准后的一维物理网络 | Python 一维包 / Simscape | 外推性好、可解释 | 局部场缺失 | 孪生主体 |
| 稳态代理模型（GPR / PCE / 神经网络） | optiSLang MOP、scikit-learn | 快、可给不确定度 | 只在训练包络内可信 | Rθ、ΔP、Tmax 快速预测 |
| 降阶场模型（SVD / LTI ROM） | Ansys Fluent ROM / Twin Builder（许可待确认） | 能给温度场 | 许可、训练成本 | 热点位置 |
| 系统孪生 | Simscape Thermal Liquid | 泵阀、管路、瞬态 | 冷板内部需嵌 ROM | P7 被控对象 |
| 打包与运行 | FMU（FMI 2.0 / 3.0），Python `fmpy` 或 Simulink 运行 | 工具无关 | 需统一变量命名 | 统一交付 |

在线校准：试验数据到来后用扩展卡尔曼滤波或贝叶斯更新 TIM2 等效热阻、分区流量系数，校准量写回设计点注册表的“实测修正”字段，并触发证据等级升级。

```svg:twin
实体对象(测试台/CDU+冷板) → 传感器(T/P/Q/红外) → 状态估计(EKF) → 数字孪生 ROM(FMU)
        ↑                                                         ↓
   执行器(泵/阀/加热) ← 安全屏蔽 + 人工闸门 E4 ← 控制器(PID/MPC/RL)
阶段：MIL → SIL → HIL；虚线：试验数据 → ROM 再标定
```

*图 6-1　数字孪生在环控制回路。HIL 阶段任何下发到实物的指令都要先过安全屏蔽和人工闸门 E4。*

### 6.8 数字孪生在环 AI 控制

| 项 | 内容 |
|---|---|
| 被控对象 | CASE-03 托盘二次侧：CDU 泵转速、旁通阀 / 分支阀开度、供液温度设定；测试台上为单板回路 |
| 目标 | 在 Tcase / Tj 与 HBM 温度约束下，最小化泵功与流量；抑制负载阶跃时的温度超调；故障（堵塞、泵降级）下保持安全 |
| 控制器梯度 | PID（基线）→ 增益调度 PID → MPC（显式约束，MPC Toolbox 或 do-mpc / CasADi）→ RL（RL Toolbox 或 Stable-Baselines3，训练在孪生上，带安全屏蔽） |
| 验证梯度 | MIL（Simulink + 孪生 FMU）→ SIL（生成代码或 FMU 联合仿真，Simulink Test 场景库）→ HIL（测试台泵阀 + 实时控制器 / PLC，经 Modbus 或 OPC UA） |
| 安全 | 硬件联锁（过温断加热、低流量断加热、漏液检测）先于软件；RL 动作经约束投影或 MPC 安全滤波；HIL 每次下发需 E4 |
| 评价指标 | 约束违约次数（必须为 0）、泵功、温度超调与调节时间、对孪生误差的鲁棒性 |

### 6.9 推荐技术栈总表

| 层 / 环节 | 推荐 | 本机状态 | 需确认 |
|---|---|---|---|
| 编排 | Claude Code / Cursor + `cp-design` + `ai-matlab` + `librarian` | 已有 | — |
| 一维 | Python 一维网络包 + Simscape Fluids | Python 已有；MATLAB 已装 | Simscape Fluids 许可 |
| CAD | build123d + SpaceClaim 脚本 | 已有 / 已装 | SpaceClaim 许可 |
| CFD | Fluent + Fluent Meshing + PyFluent | 已装（PyFluent 未装） | Fluent HPC / GPU 许可；PyFluent 安装许可 |
| 结构 | Ansys Mechanical | 已装 | Mechanical 许可 |
| 优化 / 代理 | optiSLang、scikit-learn | 已装 / 已有 | optiSLang 许可 |
| 图纸 | ezdxf + AutoCAD 2024 | 已有 / 已装 | 是否需要 SolidWorks |
| 试验 | Python DAQ + 测试台 | 无 | 自建或外协、预算 |
| 孪生 | 一维 + 代理模型 + FMU（fmpy） | fmpy 未装 | Twin Builder 许可（可选） |
| 控制 | Simulink + MPC / RL Toolbox + Simulink Test | 已装 | 许可；HIL 硬件 |
| 交叉验证 | OpenFOAM（WSL2） | 无 | 是否需要 |

## 7 AI 辅助方式与智能体 / 技能划分

### 7.1 门控流程与两条回路（平台化版本）

```svg:flow
①需求与输入 → ②概念与选型 → ③性能设计 → ④一维计算 → ⑤三维仿真 → ⑥机械与图纸 → ⑦样件与试验 → ⑧数字孪生 → ⑨在环控制
   DR0           DR1            DR2          DR2          DR3·仿真       DR3·图纸        DR4           DT 门         CTRL 门
R1：⑤ 仿真不达标 → 回 ③/④ 改几何（孔径、阵列密度、TIM2）
R2：⑦ 试验与仿真偏差 > 15% → 修正模型并回 ③（V&V 闭环）
```

*图 7-1　门控流程。①–④ 已由 v2.0 完成（青色框），⑤–⑦ 是本平台重点补齐（橙色框），⑧⑨ 为新增（紫色框）。下排是各阶段主责智能体。*

### 7.2 阶段 × AI 角色矩阵

| 阶段 | AI 做什么 | 人做什么 | 主责 / 协作 | 技能（已有 / 候选） | 门控自动检查 |
|---|---|---|---|---|---|
| ① 需求与输入 | 从 ICD / 规格 / 报告抽取输入，维护追溯矩阵与假设登记册，标冲突与缺失 | 提供 ICD、确认冲突处理 | cp-design + librarian | 候选 `input-trace` | 缺失项均有责任人与日期 |
| ② 概念与选型 | 文献 / 专利检索摘要、权衡矩阵、FTO 初筛清单 | 定权重、选方案 | cp-design + librarian + thermal-management | 候选 `trade-matrix` | 权重有量化、无红灯 |
| ③ 性能设计 | 热阻预算倒推、设计窗检查（H/D、S/D、f、Re） | 定目标值 | cp-design | `design-loop` | 预算闭合 |
| ④ 一维计算 | 网络求解、DOE、敏感性、UQ、有效域门、报告 | 审结论 | cp-design（+ ai-matlab 系统级） | 候选 `oned-network`、`oned-uq` | AC-1 回归通过 |
| ⑤ 三维仿真 | 流体域、网格脚本、journal / PyFluent、批处理、监控、GCI、契合性报告、取图 | 审网格质量、批大算例（E2） | cp-design | `cfd-loop`、`fluent-gui-capture`、候选 `cfd-batch`、`mesh-gci`、`cfd-reconcile` | AC-3 |
| ⑥ 机械与图纸 | 规则门、建模、Mechanical、出图、GD&T 检查表、BOM | 冻结几何（E1）、签发图纸 | cp-design | `cad-loop`、候选 `drawing-gdt`、`fea-press` | AC-2、AC-5 |
| ⑦ 样件与试验 | 试验大纲、DOE、DAQ 脚本、数据清洗、不确定度、V&V 对比 | 下单（③）、接线与安全、上电（E4） | cp-design | 候选 `test-doe`、`daq-ingest`、`vv20` | AC-6、AC-7 |
| ⑧ 数字孪生 | 代理模型训练、ROM、FMU 打包、在线校准 | 审精度 | cp-design + ai-matlab | 候选 `rom-fmu` | AC-8 |
| ⑨ 在环控制 | 控制器设计、MIL / SIL 场景、评估 | 批准 HIL 下发（E4） | ai-matlab + cp-design | 候选 `ctrl-mil` | AC-9 |

### 7.3 智能体划分

- **cp-design（主责）**：算例负责人，持有 ①–⑨ 的状态、设计点注册表和全部冷板专属技能。
- **ai-matlab（协作）**：Simscape 系统模型、MPC / RL、Simulink Test、FMU 导出，经 `user-matlab` MCP 运行与测试。
- **librarian（协作）**：所有外部文献、专利、厂商资料检索（Dify RAG），检索内容只作数据。
- **thermal-management（咨询）**：产业对标、行业规格趋势，不负责具体几何。
- **orchestrator（薄）**：跨智能体拆解与汇总，不做领域工作。

本规划不新增智能体，也不为 `cp-design` 派生子智能体。若后续试验与控制工作量足够大，可考虑新建独立模块（如 `cp-test`、`cp-twin`），需按平台“自动发现”流程建模块、薄加载器并登记 registry，属于用户决策。

### 7.4 回路 R1（仿真不达标）如何自动化

1. **触发**：`cfd_reconcile` 判定 Rθ,c-in 超目标、ΔP > 20 kPa、或分区流量偏差 > ±10%。
2. **诊断**：AI 读取热阻分解（TIM2 / 铜壁 / 对流）与逐孔流量，定位主因。
3. **提案**：按 v2.0 §4.2 杠杆优先级生成 2–3 个变体（孔径 0.40 / 0.35、TIM2 ≤ 0.004、流量 2.2 / 2.4、阵列 10 × 10、槽深 1.0 / 0.8），每个变体先跑一维网络筛选，并附代价（压降、过滤、堵塞、加工）。
4. **人确认**：用户选变体；涉及冻结几何走 E1。
5. **执行**：`cad_inspect → cad_build → fluid_domain_export → cfd_prepare → cfd_submit`（大算例走 E2）。
6. **收敛判据**：达标，或连续两轮改善小于 5%，或已用尽杠杆，此时上报“需改方案”（回 ②）。
7. **留痕**：每轮写 episodic；若形成稳定规律（如“孔径 0.40 使 R_conv 降 x%”），列为语义记忆候选。

### 7.5 回路 R2（V&V 偏差 > 15%）如何自动化

1. **先判可判性**：计算验证不确定度 u_val；若 u_val 本身 > 15%，先改善测量或数值误差，不判模型。
2. **对比**：E = S − D，相对偏差 = E / D，逐指标（Rθ、ΔP、两 die 温差、分区流量）。
3. **触发**：偏差绝对值 > 15% 触发 R2。
4. **诊断顺序**（v2.0 §4.2）：实测反标定 h 模型 → 复核 TIM2 装配压力与厚度 → 复核喷嘴一致性与堵塞 → 复核边界条件与物性。
5. **修正**：更新一维关联式系数或 CFD 设置（如转捩模型、接触热阻），在注册表登记“修正版本”，重跑受影响算例。
6. **人确认**：修正后的模型替代旧模型作为设计依据，需 E3。
7. **沉淀**：经确认的修正系数与适用范围写成语义记忆候选（高价值）。

### 7.6 AI 能做与不能做的边界

| AI 主责 | 人主责 |
|---|---|
| 写脚本、批处理、读日志、对账、出报告、生成变体、检索摘要、起草图纸与试验大纲 | 冻结几何与设计点、签发图纸、外协下单与采购、上电与动实物、门控放行 |
| 估算网格 / 显存 / 时长 / 费用 | 决定是否用 HPC、是否付费 |
| 在规则门内生成候选 | 改规则本身 |
| 起草技能与记忆候选 | 批准入库 |

参照《CFD-AI Agent 能力评估 v1.0》：AI 是“脚本与簿记员”，不是网格主任工程师，也不是许可证服务器。GUI 只作 QA 附件，不作控制面（取图例外，按 `fluent-gui-capture` 执行）。

## 8 数据与模型管理

### 8.1 单一数值来源

- 物性、几何、设计点、关联式只在代码与注册表中定义。报告、设计台、Excel 都是生成的视图。
- 现有 `design/calc/model.py` 保留为回归基准；新一维包上线前必须复现它（AC-1）。
- 任何手改的数字都视为缺陷。

### 8.2 设计点注册表

建议新增 `knowledge/design_points.yaml`（候选，P0 由用户确认后落盘），每条包含：`id`、对象、工质与物性来源、功率拆分、流量、限值、来源报告与章节、状态（基线 / 当前 / 已撤下）、证据等级、`confidence / valid_until / last_verified`。4.4 节表格就是它的初稿。

### 8.3 算例包与 run 目录

```text
runs/<YYYYMMDD-HHMMSS>-<case>-<stage>/
  manifest.json      # 设计点 id、输入哈希、工具与版本、命令、证据等级、收敛状态、结论摘要
  params.yaml        # 参数副本（冻结件只读引用）
  logs/              # 求解日志、残差
  out/               # STEP / msh / cas.h5 / png / csv
  report.md|html     # 本次产出说明
```

`runs/` 已在 `.gitignore` 中整体忽略。大文件（cas / dat / msh / STEP > 10 MB）不进 git，在 manifest 里记 SHA-256 与存放路径（本机或 NAS）。需要长期保存的结论性结果，经用户确认后把摘要与小文件提升到 `knowledge/` 或报告。

### 8.4 证据等级

| 等级 | 含义 | 能写成什么 |
|---|---|---|
| E-1D | 一维 / 解析 | 方案筛选、区间 |
| E-UC | 单元胞 CFD | 局部 h、孔口压降、模型标定；不能外推整板 |
| E-FP | 整板 / 半板 CFD（网格无关） | 设计结论候选 |
| E-TEST | 实测（不确定度已评估） | 保证值依据 |

### 8.5 版本与命名

- 文档：`<名称>_v<主>.<次>_<YYYYMMDD>.md|html`，与现有报告一致。
- 设计点、几何轨道、技能、记忆的 id 用英文短横线；报告文件名可用中文。
- 每个阶段收尾按 `git-release` 给出提交信息草案，真实提交与推送由人执行。

## 9 V&V 方法

### 9.1 分层 V1–V5（沿用 v2.0 §10.9）

| 层 | 对比 | 可接受偏差 | 不达标处理 |
|---|---|---|---|
| V1 代码验证 | 解析解（层流平板、圆管 fRe） | < 2% | 换设置或求解器 |
| V2 能量平衡 | 一维 ΔTf | < 2%（硬约束） | 查边界与热源加载 |
| V3 压降分段 | 一维分段 | 孔口 < 20%；歧管以 CFD 为准 | 复核 K |
| V4 文献锚定 | Martin（Re ≈ 3000，有效域内） | < 15% | 先锚定再外推设计点 |
| V5 试验确认 | TTV 实测 | < 15% | 触发 R2 |

### 9.2 ASME V&V 20 框架

- 对比误差 E = S − D（S 为仿真值，D 为试验值）。
- 验证不确定度 u_val = sqrt(u_num² + u_input² + u_D²)。
- 模型误差 δ_model 落在 E ± k·u_val 内（k 按置信水平取，通常约 2）。
- 判读：偏差绝对值 ≤ 15% 且 E 与 u_val 同量级，模型可用；偏差 > 15% 触发 R2；若 u_val > 15%，结论为“不可判”，先降不确定度。

### 9.3 数值不确定度 u_num

- 三套网格，加密比 r ≥ 1.3（v2.0 要求 1 : 1.5 : 2.25）。
- Roache GCI：观测阶 p 由三套解求得，GCI_fine = 1.25 · 相对差 / (r^p − 1)；按 V&V 20 推荐方法由 GCI 折算标准不确定度（系数以标准原文为准）。
- 迭代误差：监测量连续 500 步漂移 < 0.5%。

### 9.4 输入不确定度 u_input

以一维网络或代理模型做灵敏度系数，再蒙特卡洛传播：TIM2 面积热阻 0.1–0.2 °C·cm²/W、功率分区、流量 ±2%、进液温度 ±0.2 K、孔径公差 +0.03/0、物性（PG25 浓度 ±2%）。

### 9.5 试验不确定度 u_D

按 ASME PTC 19.1 / GUM：热电偶标定（±0.1–0.2 K）、流量计（±0.5–1%）、功率（电压电流 ±0.5%）、热损失修正、重复性（至少 3 次）。目标：热阻扩展不确定度 ≤ ±5%（k = 2）。

### 9.6 对已有一维–CFD 对照的再判读

| 对照 | 偏差 | 再判读 | 后续 |
|---|---|---|---|
| UC-01b 压降 | +26.1% | 路径不同（一维只有孔口，CFD 含槽与回液缝），不是模型误差 | 一维网络加入槽与回液缝元件，再对比 |
| UC-01b 质量加权温升 | +0.15% | 能量闭合，V2 通过 | — |
| HBM 七槽温升 | +7.96% | 残差未达 10⁻⁴，结论受限 | 续算到判据后再判 |
| HBM 七槽压降 | +571% | 不可比（含延长段与发展段） | 一维加入发展段与局部损失 |

这些都是一维与 CFD 之间的对比，不是 V5，不触发 R2，但它们是 P1 一维网络校准的第一批数据。

## 10 风险与对策

| 编号 | 风险 | 影响 | 概率 | 对策 | 阶段 |
|---|---|---|---|---|---|
| PR-01 | Ansys / MATLAB 模块许可不覆盖（HPC、GPU、Mechanical、Simscape Fluids、MPC、RL） | 高 | 中 | P0 做许可盘点；OpenFOAM、Python do-mpc 作备份 | P0 |
| PR-02 | 整板 30–80 M 网格超本机算力 | 高 | 高 | 分级仿真 L0–L4；1/2 对称；HPC / 云预算申请（E2、③） | P3 |
| PR-03 | OEM 封装图、power map、单板流量缺失（C-01–C-03） | 高 | 高 | 用假设登记册 + 敏感性；ICD 到位后的影响分析脚本 | 全程 |
| PR-04 | 口径混用（水 / PG25、1100 / 1400 W、128 / 216 孔、HBM 方案） | 高 | 中 | 设计点注册表 + 报告生成器强制引用注册表 id | P0 |
| PR-05 | AI 编造或手抄数字 | 高 | 中 | 单一数值来源；报告数字回溯脚本；用户抽查 | 全程 |
| PR-06 | 热性能真值落在保守端，DP 无法达标（RK-01） | 高 | 中 | R1 杠杆；TIM2 升级；必要时回 ② 改方案 | P3 |
| PR-07 | 低 Re 区关联式与转捩模型不确定（RK-02） | 高 | 高 | V4 锚定 + 层流 / 转捩包络 | P3 |
| PR-08 | PG25 大流量下整板压降超 20 kPa | 中 | 中 | L4 歧管 CFD；静压箱优化 | P3 |
| PR-09 | 样件外协交期与春节（2027-02-06 前后）冲突 | 中 | 高 | W16 前发询价，避开春节下单；交期留 2 周缓冲 | P4–P5 |
| PR-10 | 测试台安全（1400 W 加热、PG25 泄漏、电气） | 高 | 低 | 硬件联锁、漏液检测、E4、安全检查表 | P5 |
| PR-11 | PyFluent / Fluent 版本 API 漂移，GUI 自动化脆 | 中 | 中 | journal 优先、PyFluent 版本锁定；GUI 只用于取图 | P3 |
| PR-12 | 本机 GPU 兼作显示，显存占满导致卡死 | 中 | 中 | 遵守 `cfd-loop` 显存门（≤ 9 M 用 `-t1 -gpu`） | P3 |
| PR-13 | 记忆污染（损坏中文、过期结论被继承） | 中 | 中 | 继承前筛选；损坏文件不整篇继承；GC 标记 | 全程 |
| PR-14 | 孪生外推出训练包络，控制器依赖错误预测 | 高 | 中 | 包络检测 + 不确定度输出；超包络回退 PID | P6–P7 |
| PR-15 | RL 控制在实物上出现不安全动作 | 高 | 低 | 只在孪生上训练；安全屏蔽；HIL 每次下发经 E4 | P7 |
| PR-16 | FTO 风险（Intel DLMJ、华为 WO2026103052A1 等） | 高 | 中 | 专利对照清单交 IP；不作法律结论 | P4 前 |
| PR-17 | 客户 ICD 机密外泄 | 高 | 低 | `on_sensitive_data` 路由；机密文件不进公共仓库 | 全程 |
| PR-18 | 用户投入时间不足，指令节奏慢 | 中 | 中 | 每步颗粒度小；可并行的 AI 任务预先排队 | 全程 |

## 11 许可与资源需求

### 11.1 软件

| 软件 / 模块 | 用途 | 本机（2026-10-02 探测） | 需确认 |
|---|---|---|---|
| Ansys Fluent + Fluent Meshing | CFD | v261 已装（`fluent`、`meshing`） | 求解器许可数、HPC 包、GPU 求解许可 |
| Ansys ICEM CFD | 单元胞网格 | 已装 | — |
| Ansys SpaceClaim / Discovery | 流体域、修模、渲染 | 已装（`scdm`、`Discovery`） | 许可 |
| Ansys Mechanical | 结构 | 已装（`aisol`） | 许可 |
| Ansys optiSLang | DOE / 优化 / 代理 | 已装 | 许可 |
| Ansys Twin Builder / TwinAI | ROM | `TwinAI` 目录可见 | 是否有许可（可选） |
| PyFluent（ansys-fluent-core） | Fluent 编程接口 | 未装 | 安装许可（免费包，进 `cad/.venv` 或新 venv） |
| MATLAB R2025b + Simulink | 系统模型、控制 | 已装 | 许可 |
| Simscape / Simscape Fluids | 热流体网络 | 已装（`physmod/simscape`、`fluids`） | 许可 |
| MPC Toolbox / RL Toolbox / Simulink Design Optimization / Simulink Test / Control System Toolbox | 控制与参数辨识 | 已装 | 许可；Simulink Coder（SIL 代码生成）是否有 |
| build123d / OCP / ezdxf | CAD / 出图 | `cad/.venv` 已有 | — |
| scikit-learn / scipy / torch / pandas | 代理模型、数据 | 系统 Python 已有（torch 仅系统环境） | 平台 venv 规划 |
| AutoCAD 2024 | 审图 | 已装 | — |
| SolidWorks / NX | 原生工程图 | 未装 | 是否需要 |
| OpenFOAM（WSL2） | 交叉验证 | 未装 | 是否需要 |
| fmpy / gmsh / pyvista | FMU、网格、可视化 | 未装 | 安装许可 |

### 11.2 算力

| 场景 | 需求 | 本机能力 | 缺口 |
|---|---|---|---|
| 一维 / DOE / 代理 | CPU 少量 | 足够 | 无 |
| L1 单元胞（≤ 9 M） | 单卡 GPU 或 24 核 CPU | RTX 4090 24 GB（空闲约 21.5 GB）；i9-14900KF 24 核；128 GB | 无 |
| L2（8–15 M） | CPU 24 核、64–128 GB | 可，但慢（数小时到一天） | 无 |
| L3 / L4（15–80 M） | 按 2.2 GB / 百万单元估：80 M 约 176 GB 显存，需 3 张以上 80 GB GPU；或 128–256 核 CPU、0.5–1 TB 内存 | 不足 | HPC / 云，预计 L3 + L4 共 20–40 次求解 |
| Mechanical | 中等 | 可 | 无 |
| RL 训练 | GPU / 多核 | 4090 可 | 无 |

### 11.3 试验设备（P5，估算清单，采购走闸门 ③）

恒温循环机（水 / PG25，40–45 °C，≥ 2 kW 冷量）、变频泵与旁通阀、25 μm 过滤器、流量计 2–3 台（总流量 + 分区）、差压变送器（0–50 kPa）、T 型热电偶 / RTD 若干与标定、红外热像仪（可租）、DAQ 机箱与模块、可编程直流电源或调功器（≥ 1.6 kW）、TTV 加热块与夹具、漏液检测与急停、PMMA 透明样与染色 / PIV（可外协）。

### 11.4 人员

| 角色 | 投入 | 说明 |
|---|---|---|
| 项目负责人 / 冷板设计师（用户） | 建议每周 ≥ 10–15 h | 指令、验证、闸门、决策；工期按此估算 |
| AI 智能体 | 按指令执行 | cp-design、ai-matlab、librarian |
| CFD 评审（可选外部） | DR3 前 2–3 天 | 网格与模型独立评审 |
| 试验技术员 | P5 约 6–8 周 | 接线、安全、操作 |
| 外协加工 | P5 | CNC、真空钎焊、透明样 |
| IP 顾问 | P4 前 | FTO 对照 |

## 12 数字孪生与控制的数据接口约定

为避免 P6 / P7 返工，从 P1 起统一变量命名与单位（SI，温度 K，流量 kg/s 与 L/min 并列）：

| 类别 | 变量（示例） |
|---|---|
| 输入 | `P_die_A`、`P_die_B`、`P_hbm[i]`、`m_dot_in`、`T_in`、`coolant`、`pump_speed`、`valve_pos[j]` |
| 状态 | `T_case`、`T_cu_max`、`T_hbm[i]`、`dP_plate`、`m_dot_branch[k]` |
| 参数（可校准） | `R_tim2_area`、`K_orifice`、`Nu_scale_gpu`、`Nu_scale_hbm`、`K_branch[k]` |
| 输出指标 | `R_c_in`、`R_j_in`、`dT_die`、`W_pump` |

FMU 端口、Simscape 模型、DAQ 通道名和一维网络都使用同一套名称；对照表放 `knowledge/`（P1 起草）。

## 13 skills 与 memories 沉淀机制

### 13.1 原则

1. 只沉淀**经验证或经用户认可**的条目。半成品、未收敛结论、一次性经验进 episodic，不进 semantic。
2. 每条语义记忆带 `confidence / valid_until / last_verified / expired`；继承时只采纳 ≥ 0.6、未过期的条目（平台闸门 ②）。
3. 技能先进暂存区：私有技能建议放模块 `skills/_staging/<name>/`，共享技能放 `platform/shared/skills/_staging/`；人工确认后才登记（平台闸门 ①）。
4. 报错改过的命令写回对应技能（沿用 `fluent-gui-capture` 的做法），同一个坑不踩两次。
5. 过期不删除，由 `platform/hooks/memory_gc.py` 打 `expired` 标记，保留 git 审计链。

### 13.2 沉淀流程

```svg:govern
步骤产出 → 用户验证 → 候选登记(candidate) → 人工闸门 → 入库(semantic / skill) → 继承筛选(≥0.6 未过期) → GC 标记 expired
                └ 不通过 → 只留 episodic 或丢弃
```

*图 13-1　技能与记忆沉淀流程。*

### 13.3 字段规范

语义记忆（`memory/semantic/<topic>.md`）头部：

```yaml
---
confidence: 0.8          # 0–1；实测 ≥ 0.85，整板 CFD 0.7–0.85，一维 / 单元胞 0.6–0.75
valid_until: 2027-03-31  # 到期复核
last_verified: 2026-10-02
expired: false
evidence: E-UC           # E-1D / E-UC / E-FP / E-TEST
source: design/cfd/...   # 来源路径或报告章节
status: candidate        # candidate → active（闸门确认后）
---
```

技能（`SKILL.md`）frontmatter：`name`、`description`、`version`、`status: staging | active`、`scope: private | platform`、`verified_by`（哪次步骤、哪天由用户认可）。

### 13.4 候选 skills 清单（全部 candidate，未创建）

| 名称 | 作用 | 来源阶段 | 建议范围 | 状态 |
|---|---|---|---|---|
| `design-point-registry` | 设计点注册、选用、口径冲突检查 | P0 | 私有 | candidate |
| `input-trace` | ICD / 规格抽取、追溯矩阵与假设登记册维护 | P0 | 私有 | candidate |
| `oned-network` | 一维网络建模、有效域门、回归测试 | P1 | 私有 | candidate |
| `oned-uq` | DOE、敏感性、蒙特卡洛不确定度 | P1 | 可升共享 | candidate |
| `simscape-tray`（与 ai-matlab 协作） | 托盘 / CDU Simscape 模型搭建规程 | P1 | 私有 | candidate |
| `cad-v2-kernel`（并入 `cad-loop` 升版） | 各向异性节距、HBM 方案、接口特征 | P2 | 私有 | candidate |
| `fluid-domain` | SpaceClaim 流体域抽取与命名选择 | P2–P3 | 私有 | candidate |
| `cfd-batch` | journal / PyFluent 生成、提交、监控、显存门（扩 `cfd-loop`） | P3 | 私有 | candidate |
| `mesh-gci` | 三套网格 GCI 与迭代误差 | P3 | 可升共享 | candidate |
| `cfd-reconcile` | 一维–CFD 契合性报告（契合 / 限制 / 不可比） | P3 | 私有 | candidate |
| `r1-loop` | R1 回路编排规程 | P3 | 私有 | candidate |
| `drawing-gdt` | DXF 出图、GD&T 检查表、BOM、检验表 | P4 | 私有 | candidate |
| `test-doe` / `daq-ingest` | 试验 DOE、采集脚本、数据清洗 | P5 | 私有 | candidate |
| `vv20` | V&V 20 对比与 R2 判读 | P5 | 可升共享 | candidate |
| `rom-fmu` | 代理模型、ROM、FMU 打包与校准 | P6 | 私有 | candidate |
| `ctrl-mil`（与 ai-matlab 协作） | MIL / SIL 场景、MPC / RL、安全屏蔽规程 | P7 | 私有 | candidate |
| `html-report-toc` | md + html 双格式、左侧折叠目录报告生成 | 本规划 | 可升共享 | candidate |

### 13.5 候选 memories 清单（全部 candidate，未写入）

| 主题 | 内容要点 | 证据 | 建议置信度 | 状态 |
|---|---|---|---|---|
| `design-points` | 水基线与 PG25 6 °C 两套设计点的正式口径与选用规则 | E-1D | 0.8 | candidate（待 K-1 决策） |
| `hbm-current-scheme` | HBM 当前截面与流路（解决 K-4 后） | E-1D / E-UC | 0.7 | candidate |
| `oned-cfd-offsets` | 一维–CFD 系统偏差：UC-01b 压降 +26%（路径差）、温升闭合 1.0015 | E-UC | 0.75 | candidate |
| `tool-license-inventory` | 各软件许可与 feature 实测（P0 盘点后） | 实测 | 0.9 | candidate |
| `compute-thresholds` | 网格规模与本机 / HPC 选择阈值（显存 2.2 GB / 百万单元等，已在 `cfd-loop`） | 手册 + 实测 | 0.85 | candidate |
| `vv-thresholds` | 15% 闸门、u_val 可判性规则、GCI 判据 | 标准 + 用户认可 | 0.85 | candidate |
| `gci-results-b300` | B300 单元胞 / 半板网格无关性结论（P3 后） | E-FP | 0.8 | candidate（未产生） |
| `calibration-tim2` | TTV 反标定的 TIM2 等效热阻与装配条件（P5 后） | E-TEST | 0.9 | candidate（未产生） |
| `fluent-meshing-recipe` | 整板水密流程的黄金参数（P3 后） | 实测 | 0.8 | candidate（未产生） |
| `test-bench-config` | 测试台配置、标定与安全联锁（P5 后） | 实测 | 0.85 | candidate（未产生） |
| `rom-envelope` | ROM 训练包络与精度（P6 后） | E-FP / E-TEST | 0.8 | candidate（未产生） |
| `plan-governance` | 本规划确立的工程闸门 E1–E4（若用户采纳） | 用户认可 | 0.9 | candidate |

## 14 实施计划概要

详细计划（每阶段的目标、输入、交付物、工具、AI 角色、门控、工期、依赖、用户决策、步骤清单与甘特图）见独立文件 [实施计划 v1.0](实施计划_v1.0_20261002.md)。核心约定：

- **按指令分步实施**：每一步都是“用户指令 → AI 执行 → 产出 → 用户验证 → 沉淀候选 → 人工闸门确认后入库 → 提交建议（人 push）”。
- 步骤编号 `S<阶段>.<序号>`，例如 `S0.1`。用户可以直接说“执行 S0.1”。
- 关键路径：P3 整板 CFD（依赖 HPC）→ P4 图纸 → P5 样件交期与试验。P1、P2 可以并行推进。

## 15 开放问题与需用户决策

| # | 问题 | 影响 | 建议 |
|---|---|---|---|
| D-01 | 主设计点：v2.1 PG25 / 1400 W / 6 °C，还是 v2.0 水 / 1100 W？ | 全部阶段 | PG25 为主，水为对照 |
| D-02 | Ansys 2026 R1 哪些 feature 有许可（Fluent 求解器数 / HPC 包 / GPU、Meshing、Mechanical、SpaceClaim、optiSLang、Twin Builder）？ | P3、P6 | P0 盘点 |
| D-03 | MATLAB 哪些工具箱有许可（Simscape Fluids、MPC、RL、SLDO、Simulink Test、Simulink Coder）？ | P1、P6、P7 | P0 盘点 |
| D-04 | 是否允许安装 PyFluent、fmpy、gmsh 等 Python 包，装进哪个 venv？ | P3、P6 | 新建 `cae/.venv`，不动系统 Python |
| D-05 | 整板 CFD 的 HPC / 云算力预算与渠道 | P3 关键路径 | W10 前确定 |
| D-06 | 是否需要 SolidWorks / NX 原生图（客户或外协要求）？ | P4 | 首期 DXF + PDF |
| D-07 | OEM 封装图、power map、单板流量窗、UQD、压装力何时能拿到？ | 全程 | 维持假设登记册 |
| D-08 | HBM 当前截面：7 × 0.80 × 2.00（v2.1）还是方案 D 11 × 0.45 × 2.00（10-01 记忆）？ | P1–P3 | P0 读日志后确认 |
| D-09 | 孔径最终口径 0.50 还是 0.40？ | P2–P4 | DR3 用 C11 变体收口 |
| D-10 | 授权内核升 v2（`pitch_x/pitch_y`）并给冻结 yaml 升版吗？ | P2 | 建议授权，旧版保留 |
| D-11 | 试验：自建测试台还是外协实验室？预算上限？PG25 能否在台上用？ | P5、P7 | 自建可支撑 HIL |
| D-12 | 样件外协厂与预算；是否同时做 PMMA 透明样？ | P5 | 建议同时做 |
| D-13 | 孪生 / 控制对象：只做单板测试台，还是有真实托盘 / CDU 可接？ | P6、P7 | 先测试台，后托盘 |
| D-14 | Grace（CASE-02）是否同步推进，优先级如何？ | 资源 | P2 起作第二算例 |
| D-15 | 是否采纳工程闸门 E1–E4，并写入平台层？ | 治理 | 先在模块内试行 |
| D-16 | 是否保持“不为 cp-design 派生子智能体”，或新建 `cp-test` / `cp-twin` 模块？ | 架构 | 先技能化 |
| D-17 | 结温限值与 TIM2 选型（C-08）由谁负责？ | P3、P5 | 列为输入项 |
| D-18 | UC-01b 12 层网格续算与 HBM 方案 D 汇流槽算例是否继续？ | P0、P3 | P0 读最新日志后定 |
| D-19 | 用户每周可投入时长 | 工期 | 按 10–15 h / 周估 |

## 16 来源与版本

**本规划依据的文件**（均已阅读，证据等级见各章）：

- 平台：`platform/CLAUDE.md`、`platform/registry.json`、`platform/shared/skills/git-release/SKILL.md`。
- 模块：`agent.md`、`README.md`、`软件界面方案.md`、`memory/`（profile、index、6 条 semantic、2 条 episodic）、`skills/`（4 个）、`knowledge/`（catalog、cad-tracks、cad-kernel-gap）、`mcp/server.py`、`ui/`、`oned.py`、`zones.py`、`cycle-20260926/`（5 页报告、cycle.json、make_cycle.py、build_cad.py）、`runs/20260926-140511/params.yaml`。
- references：B300 设计报告 v2.0（2026-09-14）与 v2.1 PG25（2026-09-29）、Grace 详细设计 v1.0（2026-09-26）与 v1.1 PG25（2026-09-29）、UC01 壁面射流说明、GB300 Grace 边界参考摘录、技术调查报告 v1.3、专利分析报告 v1.4（2026-09-07）。
- 相邻佐证：`design/cfd_HBM/HBM_w08h20_1D_CFD契合性分析报告.html`、`UC01b_lessmesh_1D_CFD契合性分析报告.html`、`design/CFD-AI_Agent_能力评估与工作计划_v1.0_20260920.html`。
- 本机探测（2026-10-02）：Ansys v261 目录、MATLAB R2025b 工具箱目录、Python 包、GPU。

**未逐一读取的文件**：STEP（几何二进制，规模以报告为准）、PNG 图件、`__pycache__`。`1Dtools/` 为空目录。

| 版本 | 日期 | 变更 |
|---|---|---|
| v1.0 | 2026-10-02 | 首版：愿景范围、现状盘点、需求、架构、选型、AI 分工、数据与 V&V、风险、资源、沉淀机制、开放问题 |
