bruce2012lu/AIDCtms_design202609/coolingplate/agent/practice01_0926/docs/knowledge/PG25物性溯源与推荐_20261002.md

# PG25 物性溯源与推荐（2026-10-02）

> 只读调研产物。没有改动任何已有文件，也没有写入正式 memory，没有安装软件包，没有 push。
> 配套核算脚本：`docs/knowledge/pg25_props_calc_20261002.py`（本次新建，只读数据、只打印结果）。

## 0　结论先行

1. **仓库里共有三套 PG25 物性**，另有一套水的基线：
   - **A 套 `model.py` 的 `PG25_40`**：ρ 1022、cp 3900、μ 1.15×10⁻³ Pa·s、k 0.452、Pr 9.92（40 °C）。B300 v2.0 §3.2、v2.1、Grace v1.1 和 PG25 分配表 xlsx 都用这套。**来源不可追溯**：v2.1 自己就写了"计算模块没有附手册页码"。
   - **B 套 DOWFROST LC 25 技术数据表（TDS）40 °C 那一行**：ρ 1022.5、cp 3900（表值是 3.92 kJ/(kg·K)，引用时取整成 3.9）、μ 1.58×10⁻³、k 0.476。HBM 方案 D 的一维脚本、Fluent 日志和 HBM 1D 报告用这套。
   - **C 套 CDU / 系统报告**：只有 ρ≈1025、cp≈3.78 kJ/(kg·K) 两个量，用于机柜流量估算。
2. **37% 粘度差的来源**：1.58 / 1.15 = 1.374。拆开看分两段：
   - **约 14% 来自 Dow 官方两份文件本身不一致**。TDS 给 1.58，LC 工程与操作指南给 1.39，两份文件都写 25 vol%。
   - **约 21% 是 A 套的数据错误**。1.39 / 1.15 = 1.21，而 1.39 这一侧有 Dow 通用 PG 表、CoolProp MPG、Dynalene PG-D25 三家互相印证。A 套的四个量对不上同一个温度或浓度：μ 1.15 相当于 TDS 的 55 °C 或 MPG 的 19 wt%，k 0.452 相当于 MPG 在 40 °C 的 31.5 wt%，ρ 对应 37–41 °C。所以它是一组拼凑值，不是"温度点取错"。
   - **质量分数和体积分数混用不是主因**。25 vol% ≈ 25.6 wt%，粘度只差约 2%。
3. **推荐物性**：设计基线用 **DOWFROST LC 25 TDS 表加温度拟合式**。它的粘度在各来源中最高，压降最保守，射流换热也偏保守约 3%。以 Dow 指南 / MPG 25.6 wt% 作为低粘度一侧的敏感性下限。取值温度用平均液温 \(T_m = T_{supply} + \Delta T/2\)。**A 套建议停用**（本次未改 `model.py`）。
4. **供液温度**：仓库内设计值统一是 **40 °C**，上限或最恶工况是 **45 °C**（来自 Lenovo LP2357 表 27）。
5. **流量重算**（1400 W，供液 40 °C，推荐物性）：温升 6 / 8 / 10 K 对应 **3.490 / 2.616 / 2.092 L/min**。同流量下 1100 W 的温升是 **4.72 / 6.29 / 7.86 K**。v2.1 的 3.512 L/min 只比推荐值高 0.6%，**能量平衡流量对物性选择不敏感**。真正受影响的是 Re、粘性压降和 Pr。
6. 置信度：推荐表 0.7（待采购牌号与 TDS 确认），出处清单 0.9，流量重算 0.85。

---

## 1　仓库内出处清单

路径相对仓库根 `D:\agents2026\agents2026`，`CP` = `agents/AIDCtms/coolingplate`，`W` = `CP/agent/practice01_0926`。

### 1.1 PG25 物性取值

| # | 文件:行 | 套别 | T / °C | ρ kg/m³ | cp J/(kg·K) | k W/(m·K) | μ Pa·s | Pr | 浓度口径 | 备注 |
|---|---|---|---|---|---|---|---|---|---|---|
| 1 | `CP/design/calc/model.py:21` | A | 40 | 1022.0 | 3900 | 0.452 | 1.15e-3 | 9.92 | 只写"PG25" | 唯一数值来源，无手册页码 |
| 2 | `CP/design/calc/report_a.py:504-507` | A | 40 | 引用 1 | | | | | "25% 丙二醇" | 生成 v2.0 §3.2 表 |
| 3 | `CP/design/calc/cp_b300_1d.py:25,46,124-135` | A | 40 | 引用 1 | | | | | — | "实算 h 掉约 29%" 基于 A 套 |
| 4 | `CP/design/cfd_HBM/logs/report_v2_plain.txt:748,2185,2227` | A | 40 | 引用 1 | | | | | — | "Pr 2.3 倍、k 72%、μ 1.76 倍" |
| 5 | `W/references/NVIDIA_B300_…_v2.1_PG25_20260929.html:127,131` | A | 40 | 1022 | 3900 | 0.452 | 1.15e-3 | 9.92 | **按体积分数 25% 解读** | 自认"计算模块没有附手册页码" |
| 6 | `W/references/NVIDIA_Grace_GB300_…_v1.1_PG25_20260929.html:78` | A | 40 | 1022 | 3900 | 0.452 | 1.15e-3 | 9.92 | 按体积分数 25% 解读 | 同 v2.1 |
| 7 | `CP/cad/尺寸链计算/GB300_冷板液冷热量与流量分配表_PG25_20260929.xlsx` 工质物性!A5:G5，说明 A2 | A | 40 | 1022 | 3900 | 0.452 | 0.00115 | =E5*D5/F5 | 按体积分数 25% 解读 | 全表流量、Re、孔口压降都引用 C5/D5/E5 |
| 8 | `CP/design/cfd_HBM/hbm_1d_parallel_pg25.py:16-23` | B | 40 | 1022.5 | 3900 | 0.476 | 1.58e-3 | 12.95 | **"DOWFROST LC 25 (25 vol%)"** | 注释写明 cp 表值 3.9 |
| 9 | `CP/design/cfd_HBM/fluent/hbm_d_pg25_gui_solve.jou:3` | B | 40 | 1022.5 | 3900 | 0.476 | 1.58e-3 | — | — | 写入 Fluent 的 water-liquid 槽位 |
| 10 | `CP/design/cfd_HBM/logs/hbm_d_slit_lt9m_gpu2_solve.log:150,157,164,171` | B | 40 | 1022.5 | 3900 | 0.476 | 1.58e-3 | — | — | Fluent 实际接收的值，其余 `hbm_d_*` 日志同 |
| 11 | `CP/design/cfd_HBM/HBM微通道冷板_1D设计报告_v1.0_20260929.html:62,69` | B | 40 | 1022.5 | 3900 | — | — | 12.95 | "体积分数 25%" | |
| 12 | `CP/design/cfd_HBM/NVIDIA_B300_…_v2.0_20260914.html:227` | B | 40 | 1022.5 | 3900 | 0.476 | 0.00158 | — | "按 DOWFROST LC 25" | design 目录下的 v2.0 副本，与 W/references 版不同 |
| 13 | `solutions/total/NVIDIA_GB300_NVL72_CDU系统设计报告_v1.19_20260905.html:262`（另有 v1.17、v1.18 和 20260906汇报 副本） | C | 未注 | ≈1025 | ≈3780 | — | — | — | 未注 | 用于 200 kW、10 K 估流量 18.6 m³/h |
| 14 | `solutions/total/GB300_NVL72液冷系统综合研究报告_v1.0_20260905.html:516`，`…_v2.0…:945` | C | 未注 | ≈1025 | ≈3780 | — | — | — | 未注 | 同 13 |

### 1.2 相关但不是 PG25 物性的取值（容易混用）

| 文件:行 | 内容 | 风险 |
|---|---|---|
| `CP/design/calc/model.py:20` | `WATER40`：992.2 / 4179 / 6.53e-4 / 0.631 | 水基线 |
| `W/oned.py:53`、`W/zones.py:50` | `fl = M.WATER40`，**写死为水** | S04/S05 若直接调用，PG25 工况会静默按水计算 |
| `W/zones.py:110` | Grace 分支 992 / 4179 / 6.53e-4 / 0.632 | 水 |
| `CP/cad/尺寸链计算/HBM微通道冷板_1D设计计算_20260929.xlsx` 输入!C5:C10 | 水 40 °C 的 ρ/cp/μ/k，入口 40 °C | 文件名是 HBM 1D，但工质是水，不是 PG25 |
| `CP/cad/尺寸链计算/汇总报告/build_summary.py:494` | IN-12 冷却液"水，40 °C，假设；若改 PG25 要重算流量" | 汇总报告仍是水口径 |
| `W/docs/plan/AIDC液冷设计平台_实施计划_v1.0_20261002.md:158,205,651` | 计划建 `props/pg25_model.yaml` 与 `props/pg25_dowfrost.yaml`，semantic `pg25-properties.md` 待定 | 本报告可直接作为输入 |

### 1.3 浓度口径、冰点、供液温度出处

| 项 | 取值 | 出处 |
|---|---|---|
| 浓度口径 | 仓库内凡写明口径的都是**体积分数 25%**（DOWFROST LC 25 的定义） | #5、#6、#7、#8、#11 |
| 冰点 | 仓库内没有 PG25 冰点数字 | —（外部值见 §2） |
| 供液温度：设计 | **40 °C** | `model.py:31,33`（DP-A/DP-B Tin=40）；`hbm_1d_parallel_pg25.py:24`（TIN=40）；`hbm_d_pg25_gui_solve.jou:135`（313.15 K）；HBM 1D xlsx 输入!C10；v2.1 第 89 行"物性温度 40 °C" |
| 供液温度：上限或最恶 | **45 °C** | 分配表 xlsx 工质物性!B21（Lenovo LP2357 表 27，45 °C 对应 177 L/min、18.4 psi）；v2.1 第 75、194 行；`W/planning/实施计划_v1.0_20261002.md:172`"45 °C 最恶工况" |
| 外部 CDU 参考 | Vertiv CoolChip CDU 二次侧供液 42 °C（CDU70），范围 10–45 °C，工质"去离子水、25% 丙二醇" | `agents/AIDCtms/solutions/维谛技术(Vertiv) CoolChip CDU 冷板液冷解决方案_20250808.pdf` 第 5 页 |

### 1.4 仓库内 PDF 检索结果

用 PyMuPDF 全文检索了 `agents/AIDCtms/**/*.pdf`，共 16 份（不含 `.venv`），关键词包括 propylene glycol、glycol、PG25、丙二醇、乙二醇。**没有任何一份含 PG 水溶液物性表。**命中只有三类：Vertiv CDU 的工质与供液温度、纳米流体综述里的乙二醇基液、冲击射流综述里的 EG/水对照。`CP/papers/pdfs/04_ASHRAE_LiquidCooling_Mainstream_WP.pdf` 不含 glycol 字样。`CP/papers/文献清单与下载索引.md:31` 记载 OCP 冷却液规范 PDF 下载时返回 403。

---

## 2　权威来源对照

### 2.1 来源与口径

| 代号 | 来源 | 浓度口径 | 获取方式 | 可信度说明 |
|---|---|---|---|---|
| TDS | Dow **DOWFROST™ LC Heat Transfer Fluid TDS**，"Physical Properties of DOWFROST LC 25"（chempoint / globalindustrial / lentus 镜像）；**INTERCOOL DC-300 25%** 产品公告逐行同表 | 25 **vol%** | 联网，2026-10-02 | 成品实测类典型值，"not to be construed as specifications" |
| GUIDE | Dow **DOWFROST™ LC Engineering & Operating Guide** 表 2（chemworld / chempoint 镜像） | 25 **vol%**；表 5：25.0 wt% = 24.4 vol%，冰点 −9.6 °C | 联网 | 与 Dow 通用 DOWFROST 表 14/18/22 按 25 vol% 插值逐点一致 |
| DOW-G | Dow **DOWFROST / DOWFROST HD Engineering & Operating Guide**（180-01286）SI 表 14 粘度、18 导热、22 比热，按 20/30 vol% 插值到 25 vol% | vol% | 联网 | 通用抑制型 PG 数据，ASHRAE 的 PG 图表即源自此类 Dow 数据 |
| MPG | **CoolProp INCOMP::MPG**（Melinder 2010），`MPG.json` 系数手算 | **wt%**（`xid: mass`） | 本机未装 CoolProp，**没有安装**；从 GitHub 取系数后用 Python 计算 | 纯 PG + 水，无缓蚀剂。x=0 时与 IAPWS 水相差 ≤0.4%（992.5 / 4178 / 0.630 / 6.50e-4） |
| DYN | Dynalene PG-D25 TDS（2025-09） | 25%（未注口径） | 联网 | 第三方旁证：40 °C 时 1015 / 3965 / 0.483 / 1.38 mPa·s |
| OCP | **OCP Base Specification for Single-Phase PG25 v1.0**，§5.2、§8.3 | **25–28 wt%（约 24.5–27.5 vol%）** | 联网 | 定义口径；要求厂商 TDS 必须"在最终产品上实测" |
| ASHRAE | ASHRAE Handbook—Fundamentals Ch.31 表 11/13（PG 比热、粘度），图 16"抑制型 PG（vol.%）粘度" | 表/图口径不同 | **只拿到目录，原表未取得** | 未核对数值 |
| ETB | Engineering Toolbox 丙二醇页 | — | Cloudflare 拦截，未取得 | — |
| MEGlobal | 乙二醇厂商，没有 PG 产品数据 | — | 不适用 | — |

### 2.2 20–50 °C 对照表

ρ kg/m³，cp kJ/(kg·K)，k W/(m·K)，μ mPa·s。TDS、GUIDE 是表值，MPG 是计算值。

**粘度 μ（差异的核心）**

| T °C | TDS 25 vol% | GUIDE 25 vol% | DOW-G 插值 25 vol% | MPG 25 wt% | MPG 25.6 wt%（≈25 vol%） | A 套 model.py |
|---|---|---|---|---|---|---|
| 20 | 2.84 | 2.48 | 2.49 | 2.445 | 2.502 | — |
| 25 | 2.39 | 2.12 | 2.11 | 2.071 | 2.115 | — |
| 30 | 2.05 | 1.82 | 1.82 | 1.776 | 1.812 | — |
| 35 | 1.78 | 1.59 | 1.59 | 1.542 | 1.571 | — |
| 40 | **1.58** | **1.39** | 1.39 | 1.353 | 1.377 | **1.15** |
| 45 | 1.41 | 1.23 | 1.23 | 1.199 | 1.220 | — |
| 50 | 1.27 | 1.10 | 1.09 | 1.073 | 1.090 | — |

**密度、比热、导热、Pr**

| T °C | TDS ρ / cp / k / Pr | GUIDE ρ / cp / k / Pr | MPG 25 wt% ρ / cp / k / Pr | MPG 25.6 wt% ρ / cp / k / Pr |
|---|---|---|---|---|
| 20 | 1032.7 / 3.87 / 0.456 / 24.10 | 1033.7 / 3.87 / 0.456 / 21.05 | 1019.3 / 3.920 / 0.468 / 20.49 | 1019.8 / 3.913 / 0.465 / 21.05 |
| 25 | 1030.3 / 3.88 / 0.462 / 20.07 | 1031.5 / 3.88 / 0.462 / 17.80 | 1017.2 / 3.933 / 0.472 / 17.24 | 1017.7 / 3.926 / 0.469 / 17.69 |
| 30 | 1027.8 / 3.89 / 0.467 / 17.08 | 1029.3 / 3.89 / 0.467 / 15.16 | 1014.9 / 3.945 / 0.477 / 14.69 | 1015.4 / 3.938 / 0.474 / 15.06 |
| 35 | 1025.2 / 3.90 / 0.472 / 14.71 | 1026.9 / 3.90 / 0.472 / 13.14 | 1012.5 / 3.957 / 0.481 / 12.67 | 1012.9 / 3.950 / 0.478 / 12.97 |
| 40 | 1022.5 / 3.92 / 0.476 / 13.01 | 1024.4 / 3.92 / 0.476 / 11.45 | 1009.9 / 3.969 / 0.486 / 11.05 | 1010.3 / 3.962 / 0.483 / 11.30 |
| 45 | 1019.7 / 3.93 / 0.481 / 11.52 | 1021.7 / 3.93 / 0.481 / 10.05 | 1007.2 / 3.981 / 0.490 / 9.74 | 1007.6 / 3.974 / 0.487 / 9.95 |
| 50 | 1016.8 / 3.94 / 0.485 / 10.32 | 1019.0 / 3.94 / 0.485 / 8.94 | 1004.4 / 3.992 / 0.495 / 8.66 | 1004.8 / 3.986 / 0.491 / 8.84 |

补充：
- DOW-G 在 40 °C、25 vol% 下 k ≈ 0.478、cp ≈ 3.913，与 TDS 和 GUIDE 一致。DOW-G 有两张 SI 密度表（DOWFROST 与 DOWFROST HD），25 vol% 插值分别约 1015.5 和 1024.0。提取的文本表头有错位，哪张对应哪个产品没有完全确认。
- 冰点：TDS 为 −10 °C（25 vol%）；GUIDE 表 5 为 −9.6 °C（25.0 wt% / 24.4 vol%）；MPG 为 −9.8 °C（25 wt%）、−10.1 °C（25.6 wt%）。三者一致。
- 成品（含缓蚀剂和染料）的密度比纯 PG/水（MPG）高约 12 kg/m³，约 1.2%；cp 低约 1%；k 低约 1–2%。

---

## 3　差异原因

### 3.1 37% 怎么来的

以 40 °C 计：

\[
\frac{\mu_{TDS}}{\mu_{A}} = \frac{1.58}{1.15} = 1.374
= \underbrace{\frac{1.58}{1.39}}_{1.137\ \text{Dow 两份 LC 文件不一致}} \times \underbrace{\frac{1.39}{1.15}}_{1.209\ \text{A 套偏低}}
\]

### 3.2 逐项排除

| 假设 | 检验 | 结论 |
|---|---|---|
| 质量分数和体积分数混用 | 25 vol% ≈ 25.6 wt%（GUIDE 表 5、OCP §5.2）。MPG 在 25 wt% 和 25.6 wt% 之间，40 °C 的 μ 是 1.353 和 1.377，只差 1.8%。即使把"25%"当作 25 wt% 去读 vol% 表，误差也只有 2–3% | **不是主因** |
| 温度点取错 | 若 A 套是别的温度下的值：μ=1.15 对应 TDS 的 54.9 °C 或 GUIDE 的 48.0 °C；而 ρ=1022 对应 TDS 37.2 °C 或 GUIDE 40.7 °C；cp=3.90 对应约 31 °C 或"3.92 取整"；k=0.452 在 20–55 °C 的任何 25% 表里都找不到，TDS 要外推到约 16 °C 才是 0.452 | 四个量**不对应同一个温度**，**不是单纯的温度错位** |
| 浓度取错 | 用 MPG 在 40 °C 反查：μ=1.15 对应 19.3 wt%，k=0.452 对应 31.5 wt% | 四个量**也不对应同一个浓度** |
| 数据错误或拼凑 | `model.py` 没有出处；v2.1 第 127 行承认"没有附手册页码"；数值彼此不自洽 | **A 套是来源不明的拼凑值，判为数据错误**（置信 0.85） |
| Dow 两版表 | TDS 与 GUIDE 的 ρ 差 0.2%，cp、k 完全相同，μ 在 20–55 °C 内**系统性**高 13–16%。GUIDE 与 Dow 通用 PG 表、CoolProp MPG（25.6 wt%）、Dynalene 一致到 ±2% | TDS 的 μ 偏高原因不明，可能来自缓蚀剂包，也可能是实际浓度略高（μ=1.58 约对应 29 vol%）。**无法在本次调研中裁定** |

### 3.3 对计算的实际影响

| 量 | 依赖物性 | 推荐（TDS，T_m=43 °C）相对 A 套 |
|---|---|---|
| 能量平衡流量 \(Q=P/(\rho c_p \Delta T)\) | ρ·cp | ρ·cp：A 套 3.986e6，TDS 4.005e6，GUIDE 4.013e6，MPG 4.009e6 → **流量差 ≤0.8%** |
| Re | ρ/μ | ×0.78（μ 1.470 对 1.15）。v2.1 的孔口 Re 419/454（2.4/2.6 L/min）→ 约 **327/355**；6 K 设计点 2.283 L/min、0.50 mm 孔 Re 约 399 → **约 311** |
| 层流摩擦压降（f=64/Re 一类） | μ | **×1.28**。Grace 0.8 L/min 的 CPU 槽 2.44 kPa 中，摩擦部分同比增大；转弯和孔口项不随 μ 变 |
| 孔口/局部压降 \(K\rho V^2/2\) | ρ | 不变（ρ 差 0.1%） |
| Pr | μcp/k | 9.92 → **12.04** |
| 射流 Martin 型 \(h\propto k\,Re^{2/3}Pr^{0.42}/D\) | | ≈ **−2.5%** |
| 层流发展段（Graetz 型，\(Gz=Re\,Pr\,D_h/L\) 与 μ 无关） | k、ρcp | k 提高 6%，h 略**升**；v2.0/cp_b300_1d 的"PG25 使 h 掉约 29%"需用新物性重算 |

结论：物性选择**主要影响压降和 Re**，能量平衡流量几乎不变。PG25 压降可能超 20 kPa（规划 G-08）在新物性下会更紧。

---

## 4　推荐物性

### 4.1 选择与理由

- **设计基线：DOWFROST LC 25 TDS 表（25 vol% ≈ 25.6 wt%）。**
  1. 它是仓库已拍板工质"PG25"的成品数据，HBM 方案 D 的 1D 和 CFD 已在用；
  2. OCP PG25 规范 §8.3 要求以**厂商 TDS、最终产品实测值**为准；
  3. 各来源中 μ 最高，压降保守，换热也略保守，适合放行判据。
- **敏感性下限：GUIDE 表**（等同 Dow 通用 25 vol% 和 MPG 25.6 wt%），μ 低约 12%。
- **停用 A 套 `PG25_40`**。本次没有改 `model.py`，建议在 S02 物性注册表里标为 `deprecated`，只保留用于回归复现 v2.1。
- **采购后替换**：确定实际牌号后，用该牌号的 TDS 替换本表，流程不变。

### 4.2 取值温度

\[
T_m = T_{supply} + \frac{\Delta T}{2}
\]

- 供液 40 °C（设计）：温升 6 / 8 / 10 K 时 \(T_m\) = 43 / 44 / 45 °C
- 供液 45 °C（上限）：\(T_m\) = 48 / 49 / 50 °C
- 体积流量按**供液温度下的密度**换算（流量计一般装在供液侧）。与按 \(T_m\) 换算相差约 0.2%。

### 4.3 推荐值（TDS 拟合）

| T °C | ρ kg/m³ | cp J/(kg·K) | k W/(m·K) | μ mPa·s | Pr | 用途 |
|---|---|---|---|---|---|---|
| 20 | 1032.7 | 3870 | 0.456 | 2.84 | 24.1 | 冷态 / 充注 |
| 25 | 1030.3 | 3880 | 0.462 | 2.39 | 20.1 | |
| 30 | 1027.8 | 3890 | 0.467 | 2.05 | 17.1 | |
| **35** | **1025.2** | **3904** | **0.472** | **1.785** | **14.77** | |
| **40** | **1022.5** | **3916** | **0.4765** | **1.576** | **12.95** | 供液 40 °C |
| 43 | 1020.8 | 3923 | 0.4791 | 1.470 | 12.04 | 40 °C + 6 K 平均 |
| 44 | 1020.3 | 3925 | 0.4799 | 1.438 | 11.76 | 40 °C + 8 K 平均 |
| **45** | **1019.7** | **3928** | **0.4808** | **1.407** | **11.49** | 40 °C + 10 K 平均 / 供液上限 |
| 48 | 1017.9 | 3935 | 0.4831 | 1.321 | 10.75 | 45 °C + 6 K 平均 |
| 50 | 1016.8 | 3940 | 0.4847 | 1.268 | 10.31 | 45 °C + 10 K 平均 |

20–30 °C 行直接取表值；35 °C 及以上取拟合值，与表值偏差不超过 0.8%。冰点 −10 °C。

### 4.4 拟合式（T 单位 °C，适用 20–55 °C）

TDS（推荐）：

\[
\rho = 1041.1375 - 0.379167\,T - 0.002167\,T^2 \quad [\mathrm{kg/m^3}]
\]
\[
c_p = 3820.714 + 2.381\,T \quad [\mathrm{J/(kg\cdot K)}]
\]
\[
k = 0.430196 + 1.43452\times10^{-3}\,T - 6.9\times10^{-6}\,T^2 \quad [\mathrm{W/(m\cdot K)}]
\]
\[
\ln\mu_{[\mathrm{mPa\cdot s}]} = -2.01892 + \frac{257.257}{T + 64.0}\quad(\text{最大相对误差 }0.31\%)
\]

GUIDE（敏感性下限）：cp、k 与 TDS 相同；

\[
\rho = 1041.0071 - 0.316667\,T - 0.002476\,T^2,\qquad
\ln\mu_{[\mathrm{mPa\cdot s}]} = -3.52641 + \frac{592.158}{T + 113.5}\quad(0.26\%)
\]

也可直接按 §2.2 的表格做线性插值，μ 用对数插值。

---

## 5　工况流量重算

推荐物性，模组 1400 W，供液 40 °C。\(\dot m = P/(c_p(T_m)\,\Delta T)\)，\(Q_{in} = \dot m/\rho(T_{in})\)。

| 设计温升 | T_m °C | Q（供液侧）L/min | Q（T_m 侧）L/min | 比流量 L/(min·kW) | 同流量 1100 W 温升 | 相对 v2.1 的 3.512 |
|---|---|---|---|---|---|---|
| **6 K** | 43 | **3.490** | 3.496 | 2.493 | **4.72 K** | −0.62% |
| **8 K** | 44 | **2.616** | 2.622 | 1.869 | **6.29 K** | −25.5% |
| **10 K** | 45 | **2.092** | 2.097 | 1.494 | **7.86 K** | −40.4% |

- **供液 45 °C**：6/8/10 K 分别为 3.489 / 2.615 / 2.091 L/min，与 40 °C 相差不到 0.05%。
- **GUIDE 物性**：3.484 / 2.611 / 2.088 L/min，与 TDS 相差约 0.2%。
- **v2.1 的 3.512 L/min 反算**：推荐物性下 1400 W 温升 5.96 K，1100 W 温升 4.69 K。3.512 来自 A 套 ρ·cp=1022×3900 的 6 K 闭合（算出来 3.5125），与推荐值只差 0.6%，可以继续用作 6 K 档流量，误差在流量计精度内。
- **C 套（1025 × 3780）**：6 K 需要 3.613 L/min，偏高 3.5%，原因是 cp=3.78 偏低。建议机柜级估算也换用推荐物性。
- **分项流量**（6 K，推荐物性，按功率比例）：GPU 核心 910 W 约 2.269 L/min（v2.1 为 2.283）；单颗 HBM 43.7 W 约 0.1089 L/min（v2.1 为 0.1096）；Grace 300 W 约 0.748 L/min（v2.1 为 0.753）。
- **8 K、10 K 档要单独复核孔速和 Re**：流量降低后，孔速、Re 和近壁流速都会同比下降。例如 10 K 档 GPU 核心流量约 1.36 L/min，0.50 mm 孔速约 0.53 m/s。热阻也要重新评估。

---

## 6　对后续一维步骤的使用建议

**S02/S03（注册表与决策）**
- `props/pg25_dowfrost.yaml` 直接用 §4.4 的拟合式和 §2.2 的 TDS 表，字段写 `source: DOWFROST LC TDS; basis: 25 vol% (~25.6 wt%); T_range: 20-55 °C`。
- `props/pg25_model.yaml` 只保留 A 套原值，标 `status: deprecated（仅供复现 v2.1）`。
- 另建 `props/pg25_guide.yaml` 作敏感性下限。
- S03 决策卡请用户确认：①实际采购牌号和 TDS；②供液温度 40 °C 还是 45 °C；③设计温升最终取 6 / 8 / 10 K 哪一档。

**S04（回归基线）**
- 黄金数据**保持 A 套**，才能复现 v2.0 和 v2.1 的原数。
- 测试里显式断言 `fluid` 参数。`oned.py:53`、`zones.py:50` 目前写死为 `M.WATER40`，需要在 S06 包装层把工质作为参数传入，防止 PG25 工况静默按水计算。本次没有改这两个文件。

**S05（PG25 复算）**
- 同一组几何和流量，分别用 A / TDS / GUIDE 三套跑一遍，输出 Re、粘性压降、局部压降、Pr、h、R 的差异表。按 §3.3，预计 TDS 相对 A 套 Re ×0.78、层流摩擦压降 ×1.28、射流 h 约 −2.5%。
- 物性一律在 \(T_m\) 取值，不再固定 40 °C。
- 重点复核：Grace 支路 22.9 kPa（摩擦部分将增大）；B300 整板 14–24 kPa 外推；HBM 方案 D 已经用 TDS，无需重算。
- 重算 v2.0 / `cp_b300_1d.py` 的"PG25 使 h 掉约 29%"，那一结论基于 A 套。

**S07/S08（敏感性与水力网络）**
- 把工质物性作为 DOE 的一个因子：TDS 与 GUIDE 两档，或 μ 在 ±12% 范围内连续变化。
- 压降放行判据用 TDS，换热乐观边界用 GUIDE。

**CFD**：Fluent 已用 TDS 40 °C 常数物性（`hbm_d_*`）。后续可改为分段线性 μ(T)，按 §4.3 输入。常物性取 \(T_m\) 而不是供液温度。

---

## 7　候选 memory 条目（candidate，未写入正式 memory）

下列条目按记忆治理格式起草，需经人工确认（第②道闸门）后才可写入 `memory/semantic/`。

```yaml
- id: pg25-properties
  status: candidate
  type: semantic
  confidence: 0.70
  valid_until: 2027-03-31        # 或采购牌号 TDS 到手即复核
  last_verified: 2026-10-02
  text: >
    PG25 设计物性用 DOWFROST LC 25 TDS（25 vol% ≈ 25.6 wt%）及其拟合式，
    在平均液温 T_m = T_supply + ΔT/2 取值。40 °C：ρ 1022.5、cp 3916、k 0.4765、
    μ 1.576 mPa·s、Pr 12.95；45 °C：1019.7 / 3928 / 0.4808 / 1.407 / 11.49。
    敏感性下限用 Dow LC 工程指南表（40 °C μ 1.39），与 CoolProp MPG 25.6 wt% 一致。
  source: docs/knowledge/PG25物性溯源与推荐_20261002.md §4

- id: pg25-model-py-deprecated
  status: candidate
  type: semantic
  confidence: 0.85
  valid_until: 2027-10-02
  last_verified: 2026-10-02
  text: >
    design/calc/model.py 的 PG25_40（1022/3900/1.15e-3/0.452）无出处、四项物性
    互不自洽，μ 比所有 25% PG 数据在 40 °C 低 15–27%，k 低约 5%。v2.0 §3.2、v2.1、
    Grace v1.1、PG25 分配表 xlsx 均沿用它。仅用于复现旧报告，不作新设计依据。
  source: 同上 §3

- id: pg25-concentration-basis
  status: candidate
  type: semantic
  confidence: 0.85
  valid_until: 2027-10-02
  last_verified: 2026-10-02
  text: >
    "PG25" 在 DOWFROST LC 25 里是 25 vol%（= 约 25.6 wt%；25.0 wt% = 24.4 vol%）；
    OCP PG25 Base Spec §5.2 定义为 25–28 wt%（约 24.5–27.5 vol%）。vol/wt 口径差对
    μ 的影响约 2%，不是 37% 差异的来源。冰点约 −10 °C。
  source: 同上 §2、§3

- id: pg25-flow-6-8-10K
  status: candidate
  type: semantic
  confidence: 0.80
  valid_until: 2027-03-31
  last_verified: 2026-10-02
  text: >
    1400 W、供液 40 °C、推荐物性：温升 6/8/10 K 需 3.490/2.616/2.092 L/min（供液侧）；
    同流量 1100 W 温升 4.72/6.29/7.86 K。v2.1 的 3.512 L/min 偏差 0.6%，可沿用为 6 K 档。
    能量平衡流量对物性套别不敏感（≤0.8%），物性主要影响 Re 与粘性压降。
  source: 同上 §5

- id: coolant-supply-temperature
  status: candidate
  type: semantic
  confidence: 0.60              # 待用户确认
  valid_until: 2026-12-31
  last_verified: 2026-10-02
  text: >
    仓库内冷板设计供液温度统一 40 °C（model.py DP、HBM 1D、Fluent 313.15 K）；
    上限/最恶工况 45 °C（Lenovo LP2357 表 27，分配表 xlsx 工质物性!B21）。
    Vertiv CDU 参考二次侧 42 °C、范围 10–45 °C。
  source: 同上 §1.3
```

---

## 8　风险、反证与待确认

| 项 | 说明 | 处理 |
|---|---|---|
| Dow 两份 LC 文件 μ 相差 14% | 无法判断哪份对应现行配方 | 以采购牌号的 TDS 为准；未确认前设计用 TDS，敏感性用 GUIDE |
| ASHRAE 原表未取得 | 只拿到目录，数值未核对 | 有手册时补核 40 °C 一行即可 |
| CoolProp 为手算 | 未安装 CoolProp，按 `MPG.json` 系数计算 | 已用 x=0 水极限验证；若后续装了 CoolProp（需人工同意），可对比 `PropsSI(...,'INCOMP::MPG[0.256]')` |
| 采购牌号未知 | DOWFROST LC 25、INTERCOOL DC-300、Dynalene PG-D25 等成品之间 μ 相差可达约 15% | **需用户确认** |
| 供液温度 | 40 °C 还是 45 °C 作为主基准 | **需用户确认**；对流量影响 <0.1%，对 μ 影响约 −11% |
| 温升档位 | 6 K 是项目要求，8/10 K 是可调范围 | 8/10 K 档需重算孔速、Re、热阻 |

复盘建议：取得采购牌号 TDS 后，或在 S05 完成时（以先到者为准）复核本报告与候选 memory。
