bruce2012lu/AIDCtms_design202609/Bp/assets/ppt/c31_cdu_architecture.png

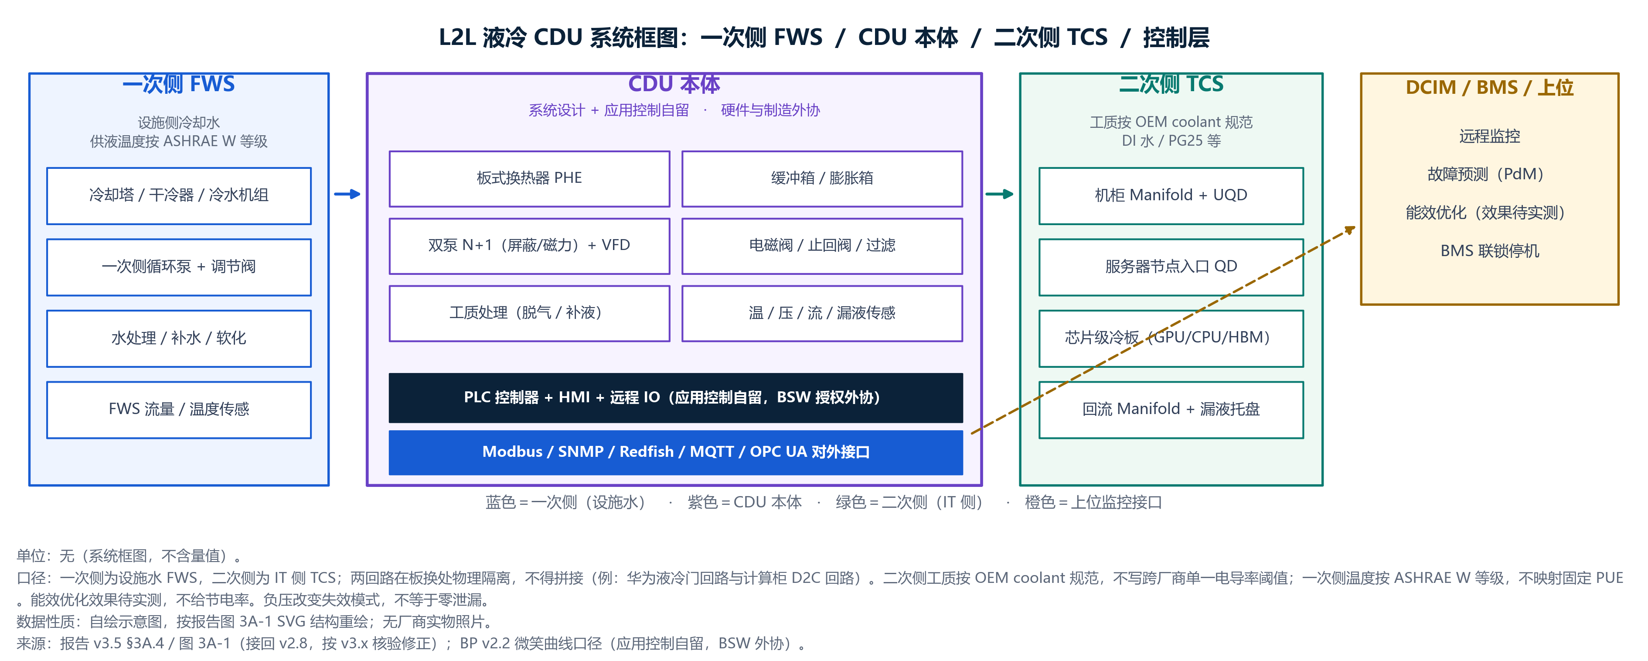
Bp/assets/ppt/c31_cdu_architecture.png
