bruce2012lu/AIDCtms_design202609/coolingplate/design/cfd/uc01b_2.4x3.0/figs/cfd_pl_x0_V.png

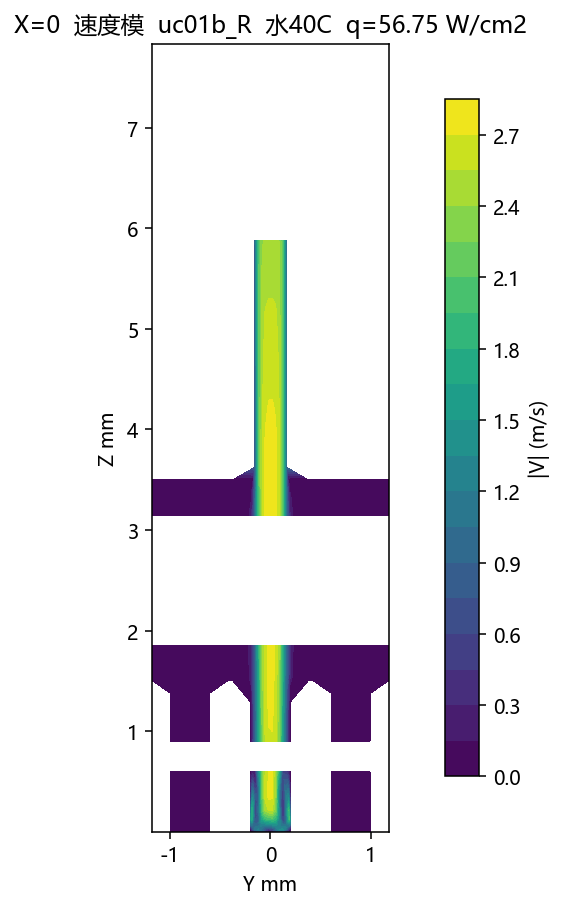
coolingplate/design/cfd/uc01b_2.4x3.0/figs/cfd_pl_x0_V.png
