bruce2012lu/AIDCtms_design202609/coolingplate/design/cfd/uc01b_2.4x3.0/figs/cfd_pl_y0_T.png

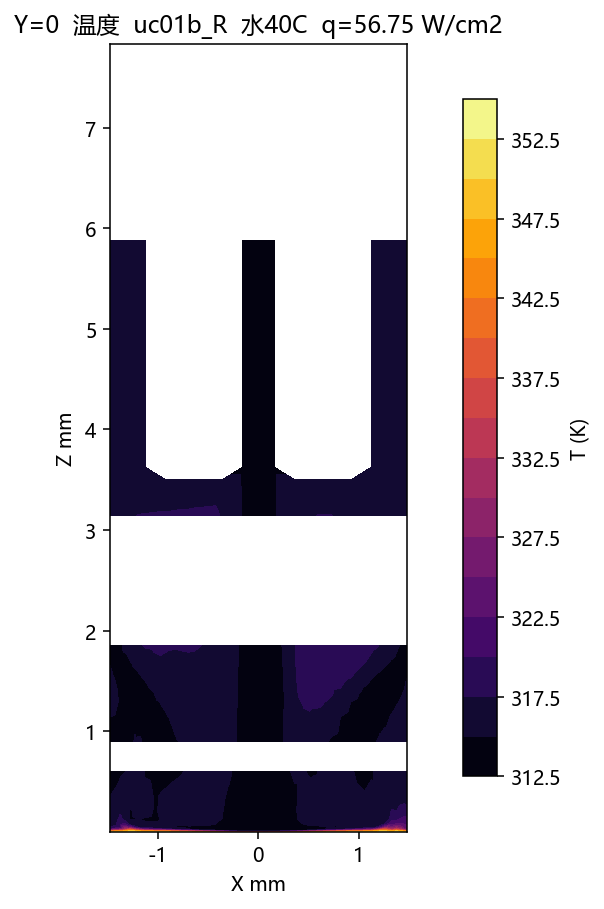
coolingplate/design/cfd/uc01b_2.4x3.0/figs/cfd_pl_y0_T.png
