bruce2012lu/AIDCtms_design202609/coolingplate/design/cfd/uc01b_2.4x3.0/figs/cht_mesh_cut_z075.png

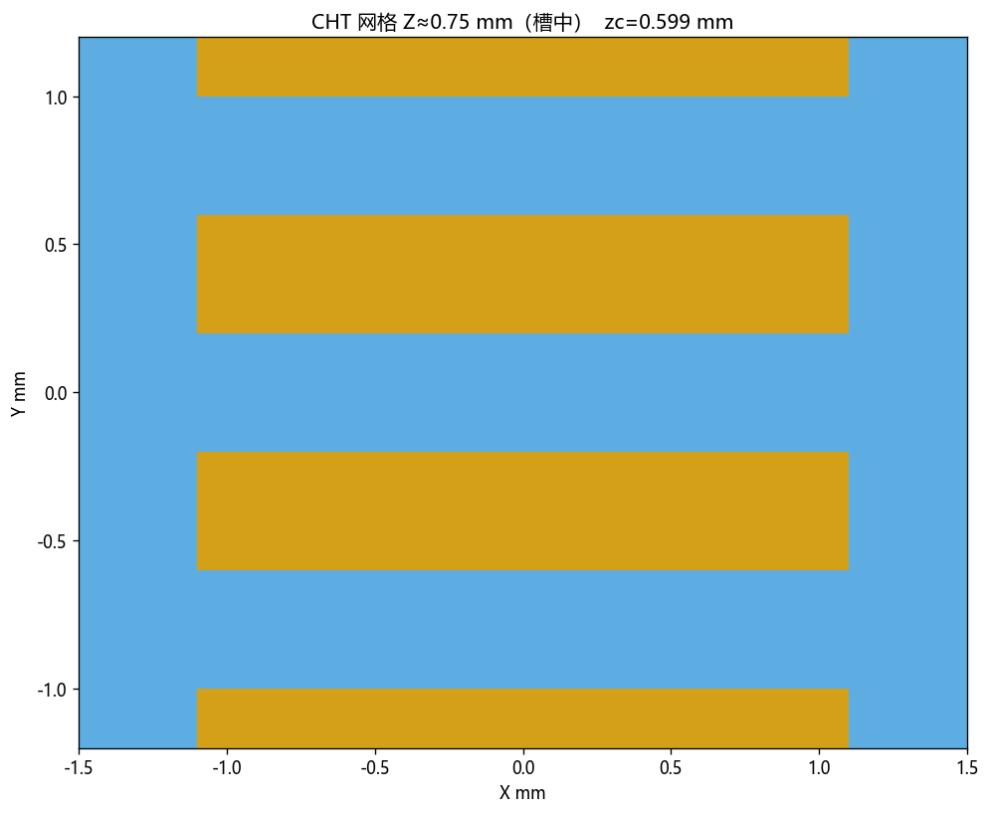
coolingplate/design/cfd/uc01b_2.4x3.0/figs/cht_mesh_cut_z075.png
