bruce2012lu/AIDCtms_design202609/coolingplate/design/cfd/uc01b_2.4x3.0/figs/cht_orifice_circle_zoom.png

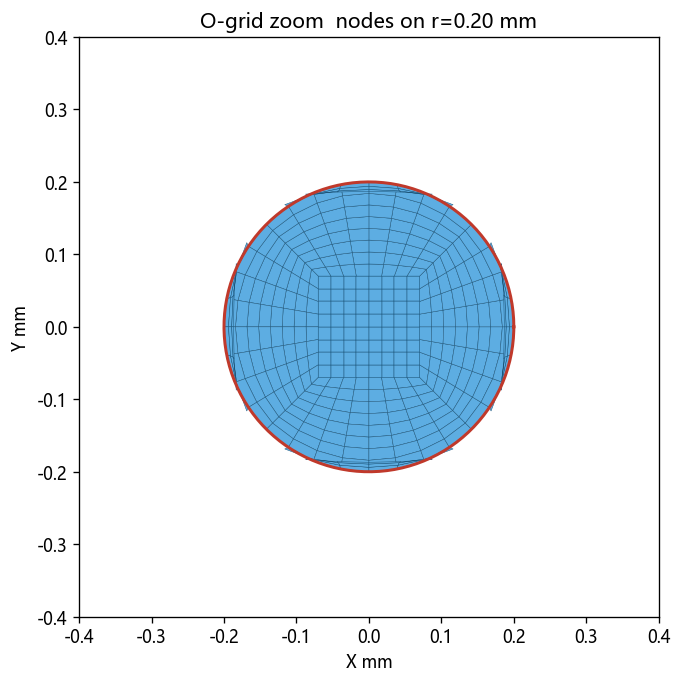
coolingplate/design/cfd/uc01b_2.4x3.0/figs/cht_orifice_circle_zoom.png
