bruce2012lu/AIDCtms_design202609/coolingplate/design/cfd/uc01b_2.4x3.0/figs/cht_stack_bar.png

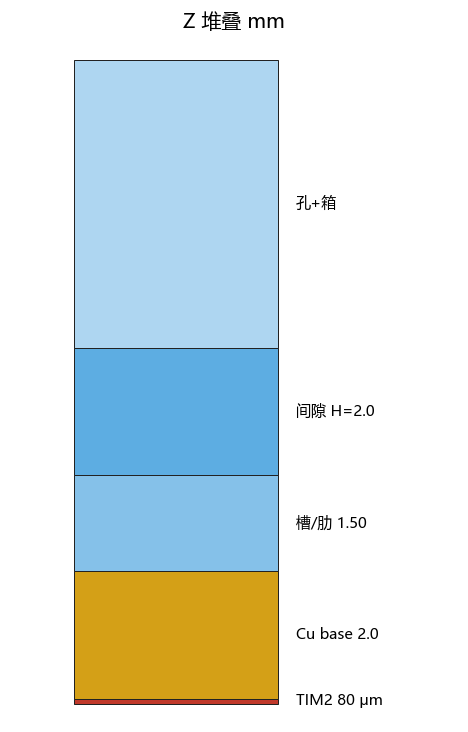
coolingplate/design/cfd/uc01b_2.4x3.0/figs/cht_stack_bar.png
