bruce2012lu/AIDCtms_design202609/coolingplate/design/cfd/uc01b_2.4x3.0/figs/fine_mesh_cut_z_gap.png

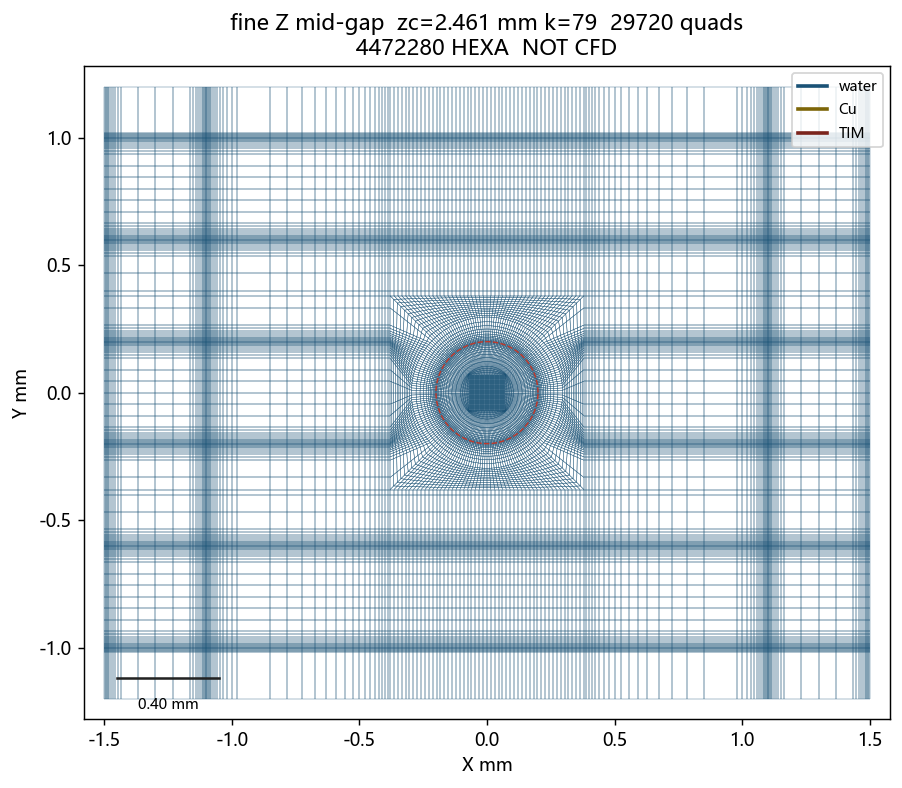
coolingplate/design/cfd/uc01b_2.4x3.0/figs/fine_mesh_cut_z_gap.png
