bruce2012lu/AIDCtms_design202609/coolingplate/design/cfd/uc01b_2.4x3.0/figs/mesh_iso3d.png

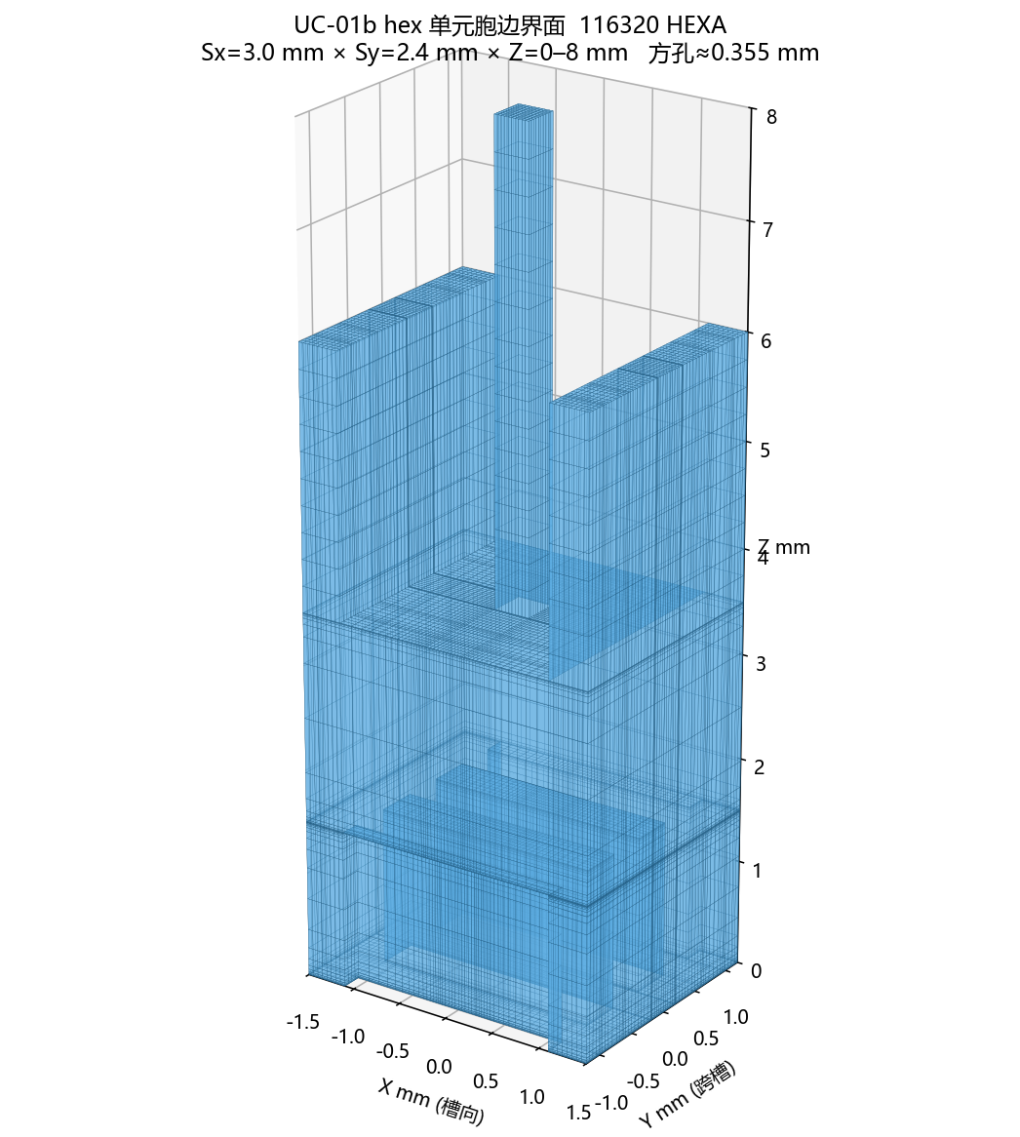
coolingplate/design/cfd/uc01b_2.4x3.0/figs/mesh_iso3d.png
