bruce2012lu/AIDCtms_design202609/coolingplate/design/cfd/uc01b_2.4x3.0/figs/n216_i8587_xmid_TV.png

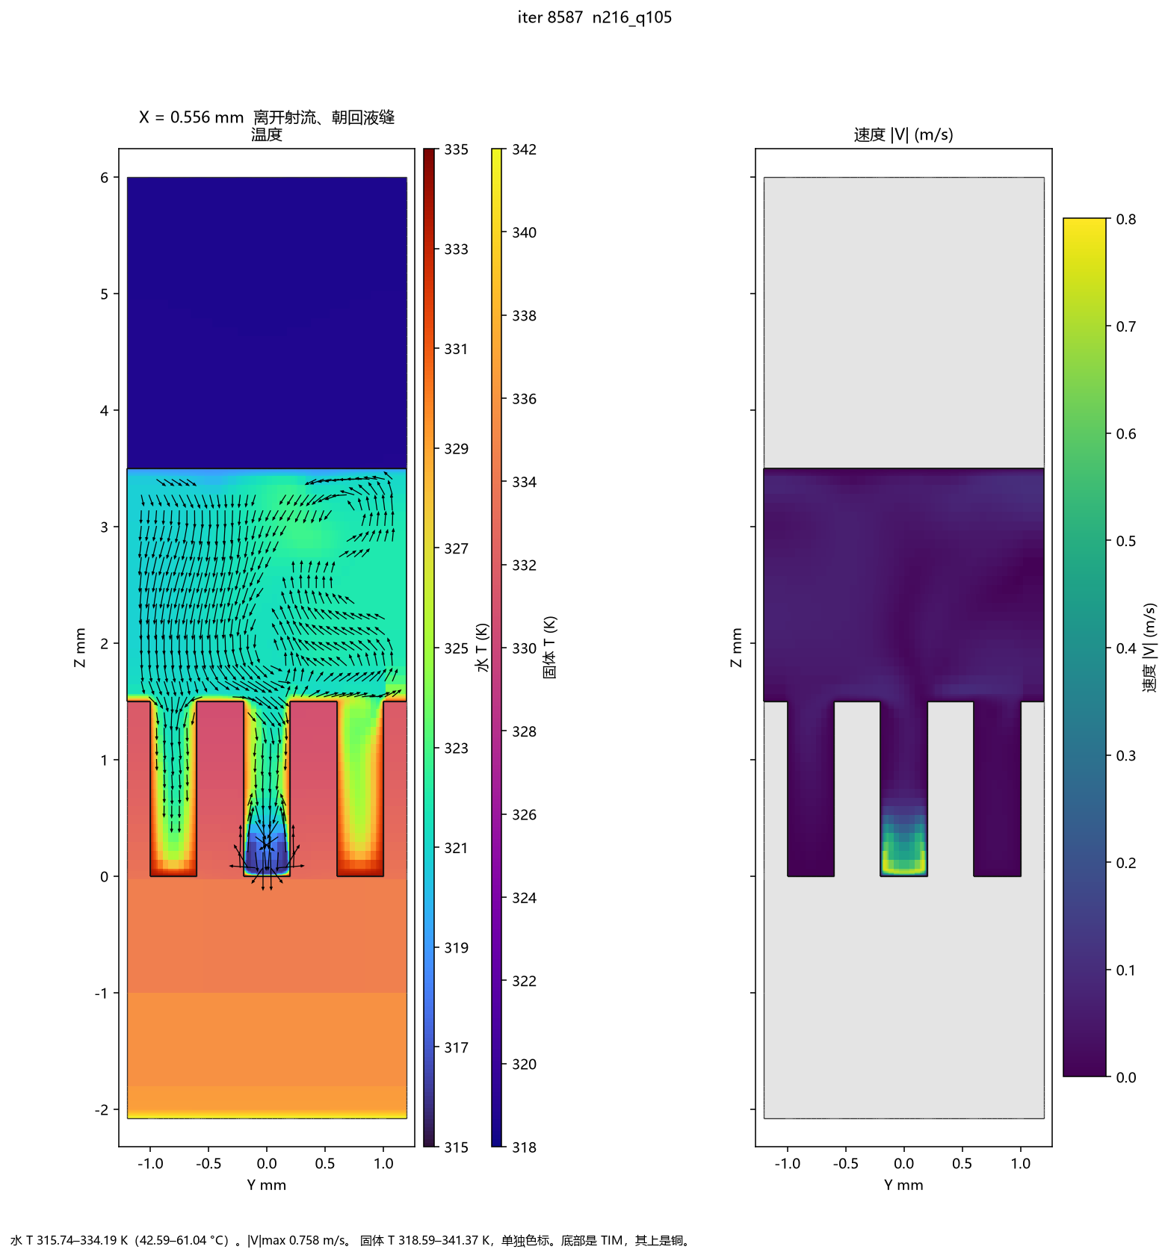
coolingplate/design/cfd/uc01b_2.4x3.0/figs/n216_i8587_xmid_TV.png
