bruce2012lu/AIDCtms_design202609/coolingplate/design/cfd/uc01b_2.4x3.0/figs/n216_mesh_y_side.png

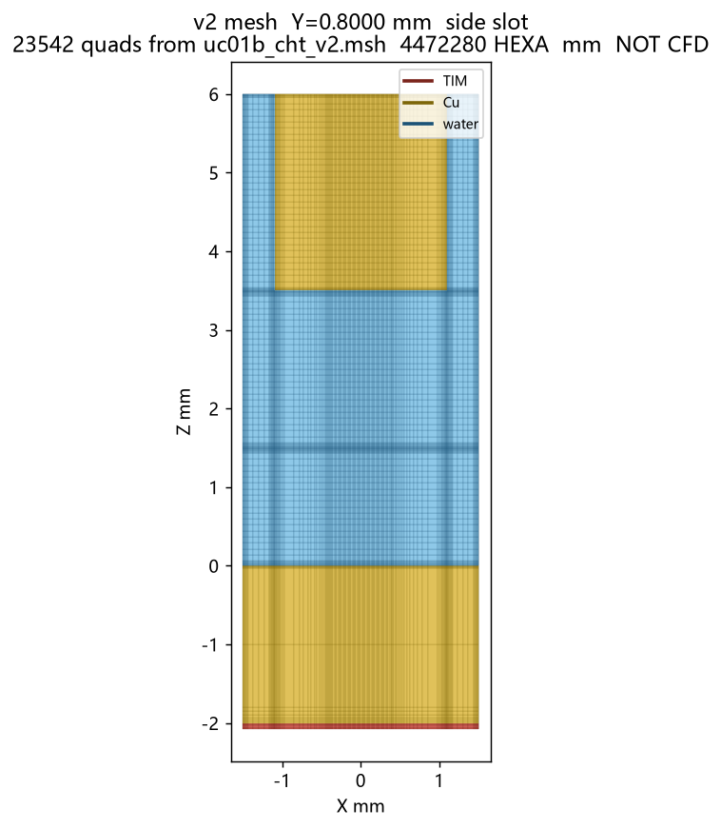
coolingplate/design/cfd/uc01b_2.4x3.0/figs/n216_mesh_y_side.png
