bruce2012lu/AIDCtms_design202609/coolingplate/design/cfd/uc01b_2.4x3.0/figs/v2cur_zrib_solid_T.png

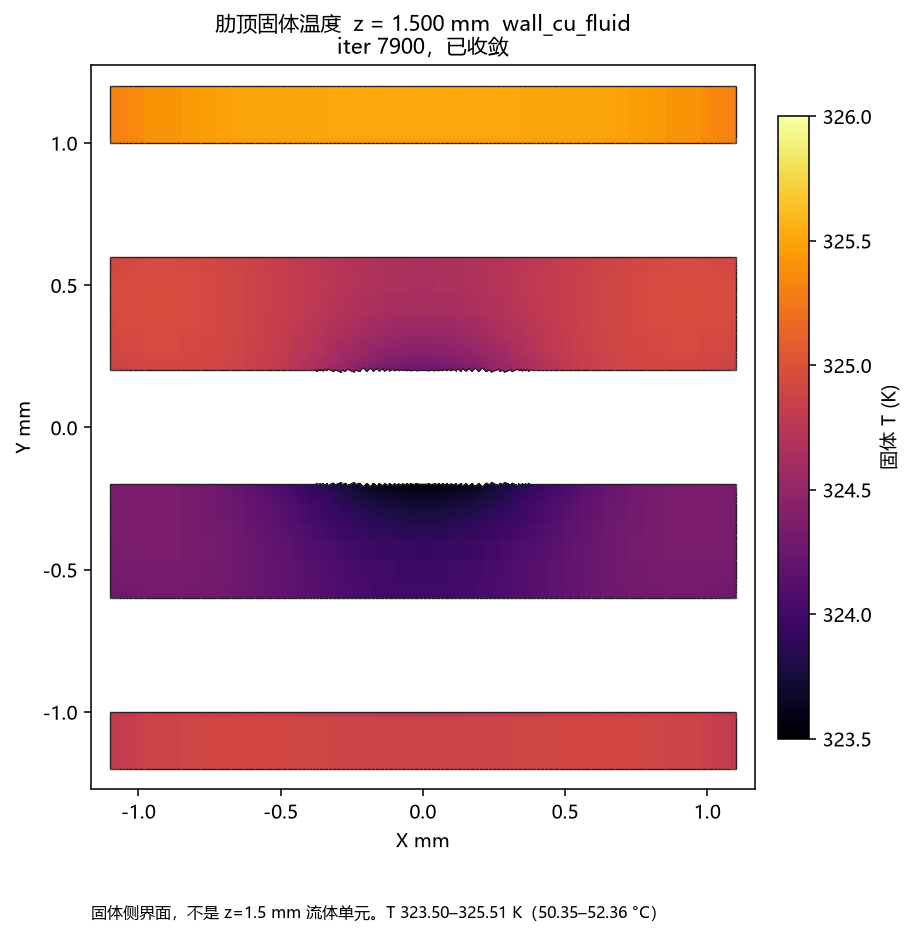
coolingplate/design/cfd/uc01b_2.4x3.0/figs/v2cur_zrib_solid_T.png
