bruce2012lu/AIDCtms_design202609/coolingplate/design/cfd/uc01b_2.4x3.0lessmesh12cells/figs/i300/return_TV.png

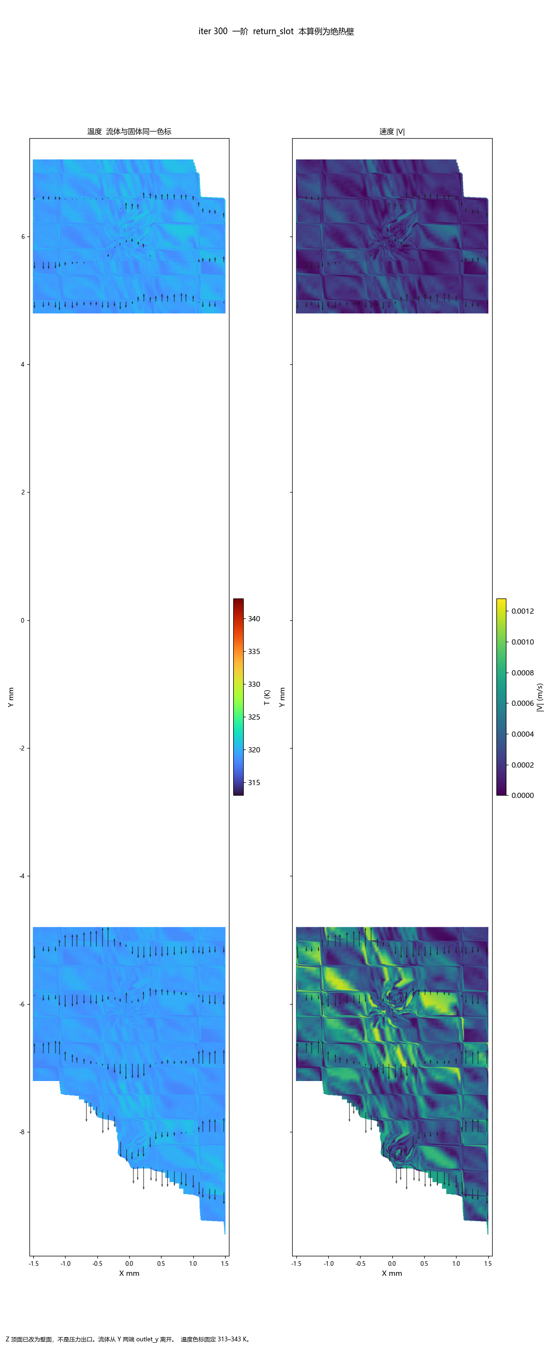
coolingplate/design/cfd/uc01b_2.4x3.0lessmesh12cells/figs/i300/return_TV.png
