bruce2012lu/AIDCtms_design202609/coolingplate/design/cfd/uc01b_2.4x3.0lessmesh12cells/figs/m425_mesh_center_zoom.png

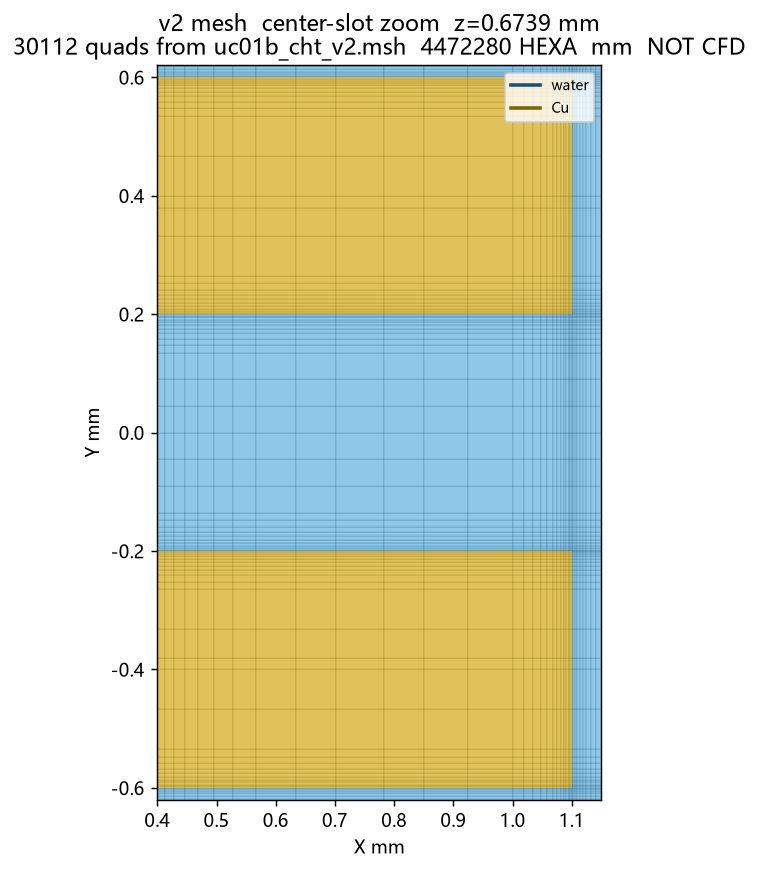
coolingplate/design/cfd/uc01b_2.4x3.0lessmesh12cells/figs/m425_mesh_center_zoom.png
