bruce2012lu/AIDCtms_design202609/coolingplate/design/cfd/uc01b_2.4x3.0lessmesh12cells/figs/m425_x01_TV.png

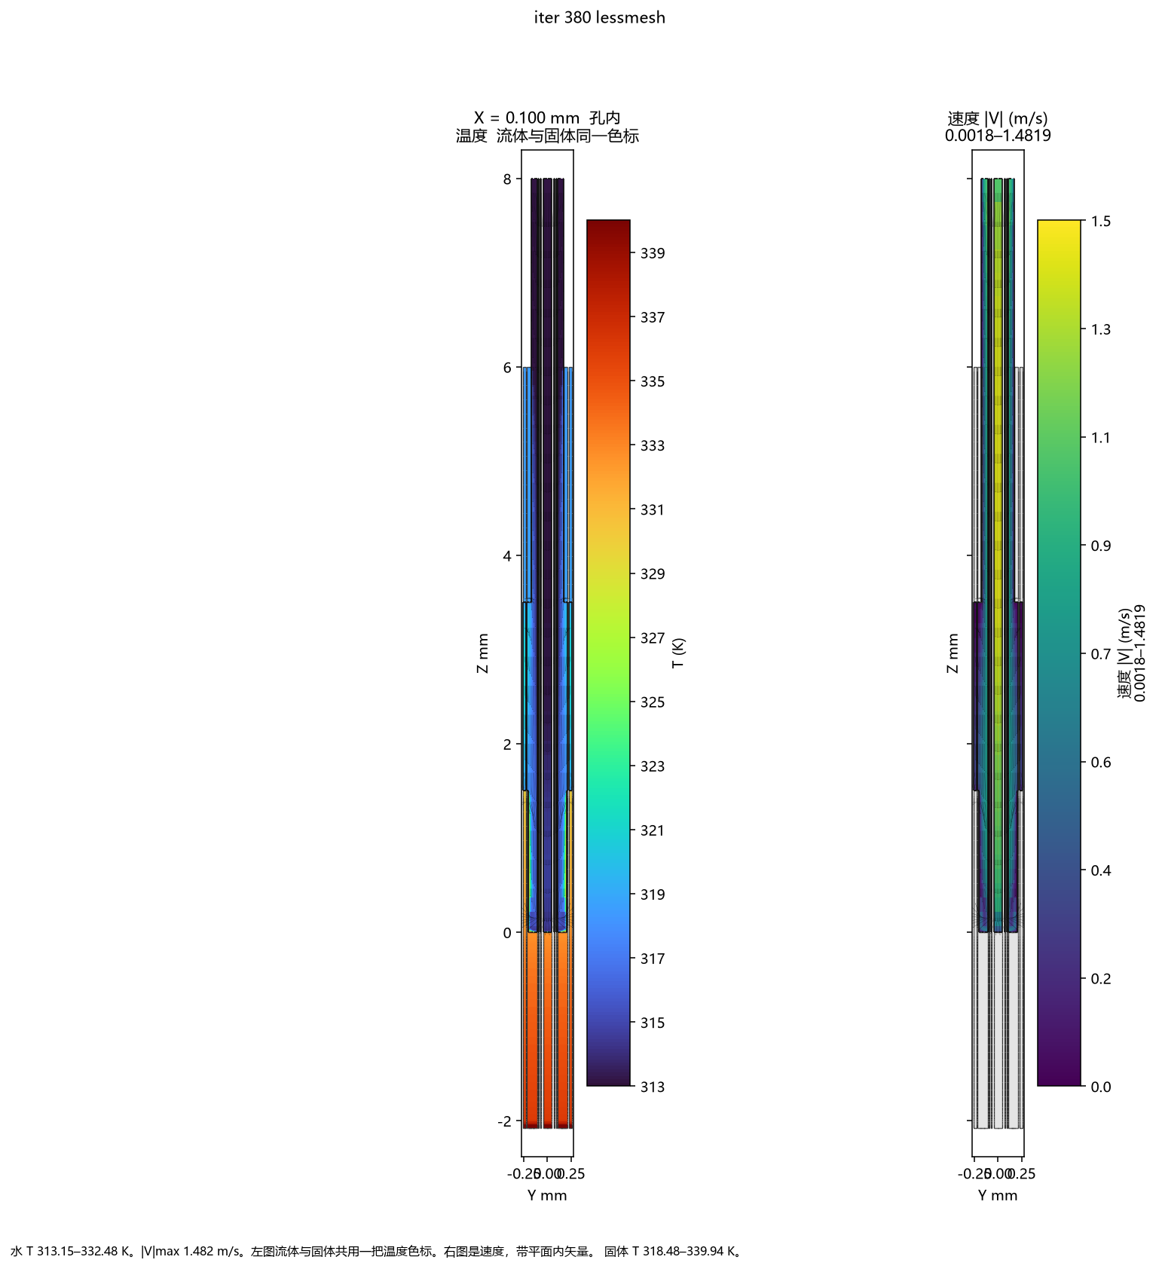
coolingplate/design/cfd/uc01b_2.4x3.0lessmesh12cells/figs/m425_x01_TV.png
