bruce2012lu/AIDCtms_design202609/coolingplate/design/cfd_HBM/figs/cf_i200/wall_heat_center_temperature.png

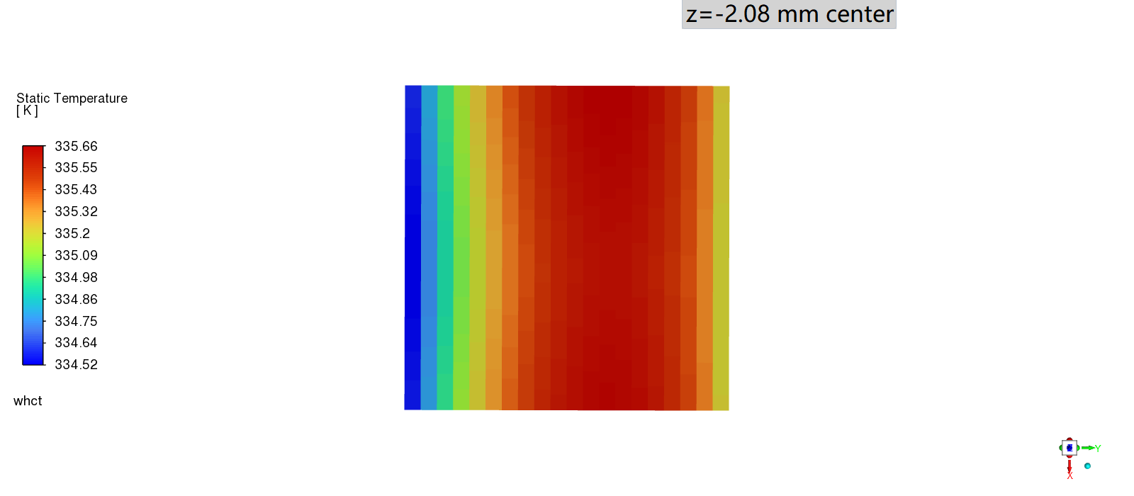
coolingplate/design/cfd_HBM/figs/cf_i200/wall_heat_center_temperature.png
