bruce2012lu/AIDCtms_design202609/coolingplate/design/cfd_HBM/figs/cf_i200/x550_center_velocity.png

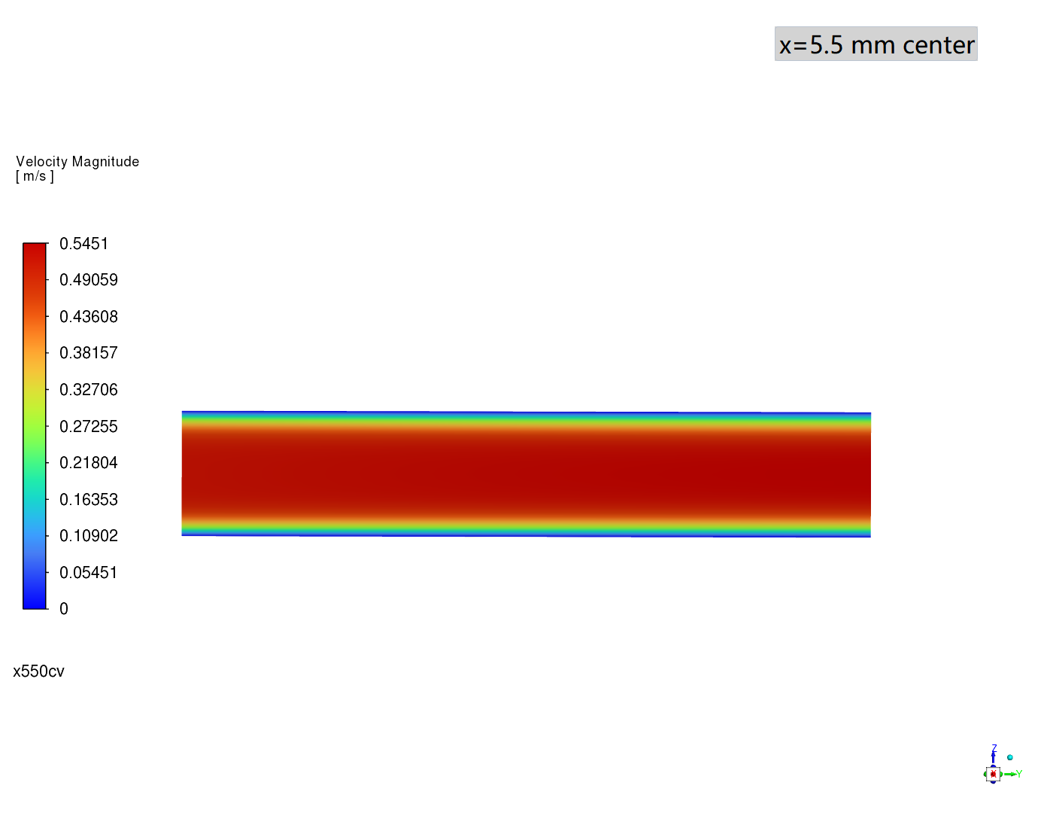
coolingplate/design/cfd_HBM/figs/cf_i200/x550_center_velocity.png
