bruce2012lu/AIDCtms_design202609/coolingplate/design/cfd_HBM/figs/i200/outlet_velocity.png

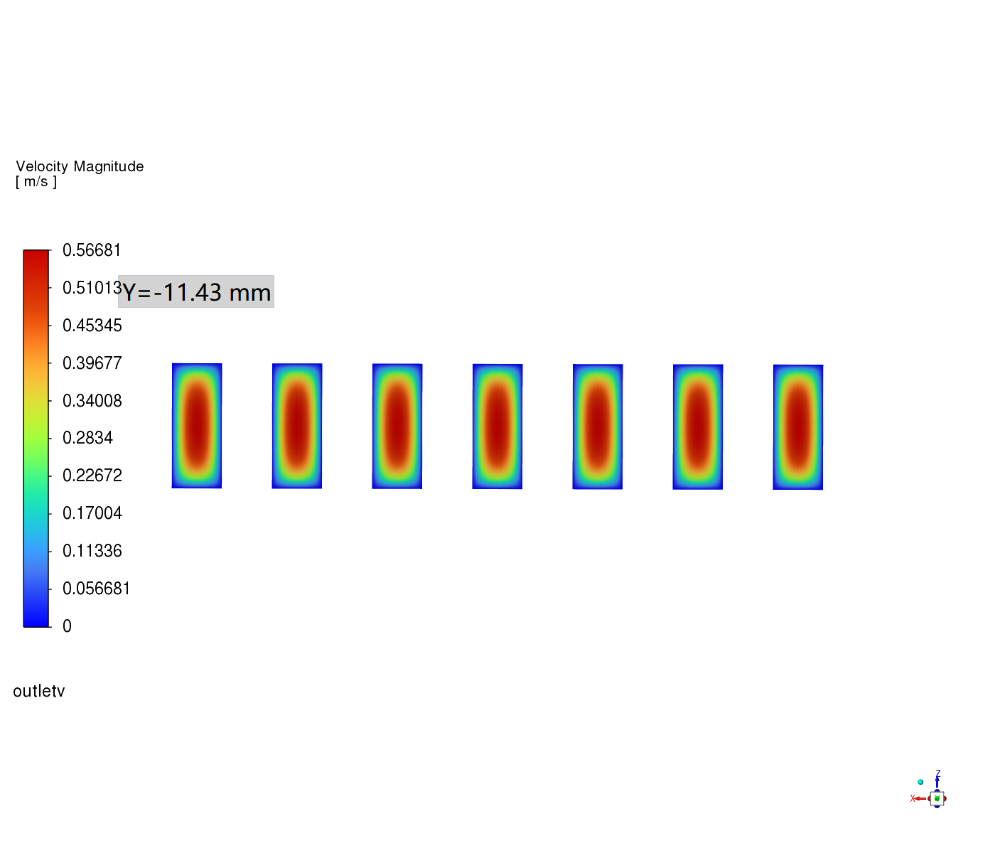
coolingplate/design/cfd_HBM/figs/i200/outlet_velocity.png
