bruce2012lu/AIDCtms_design202609/coolingplate/design/cfd_HBM/figs/i200/wall_heat_temperature.png

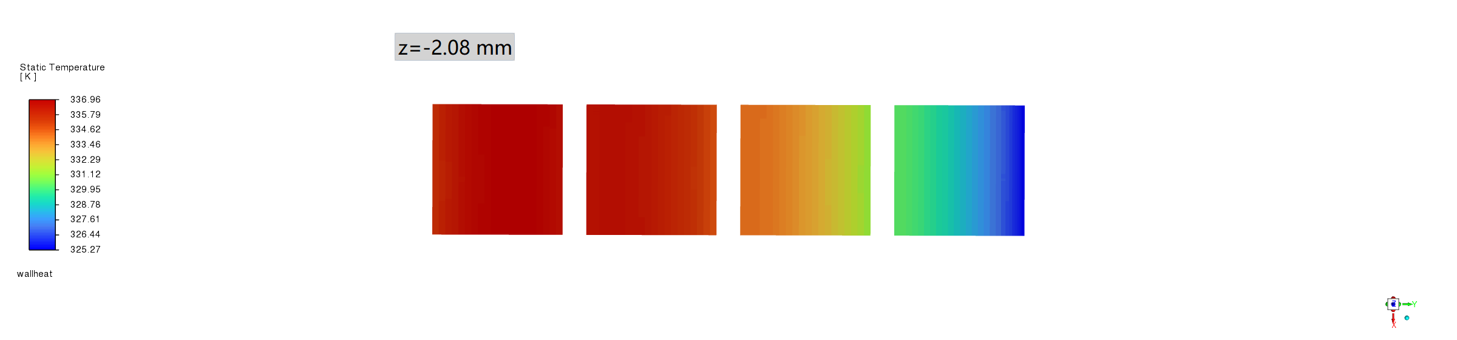
coolingplate/design/cfd_HBM/figs/i200/wall_heat_temperature.png
