bruce2012lu/AIDCtms_design202609/coolingplate/design/cfd_HBM/figs/i200/x550_center_velocity_vector.png

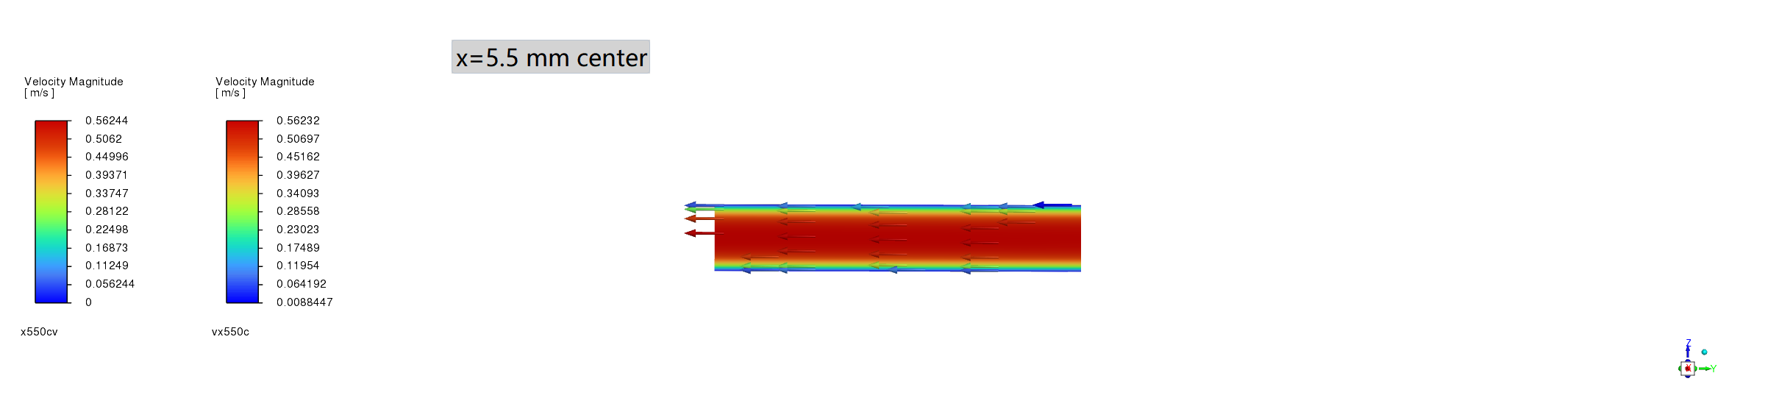
coolingplate/design/cfd_HBM/figs/i200/x550_center_velocity_vector.png
