bruce2012lu/AIDCtms_design202609/coolingplate/design/cfd_HBM/figs/i400/x095_temperature.png

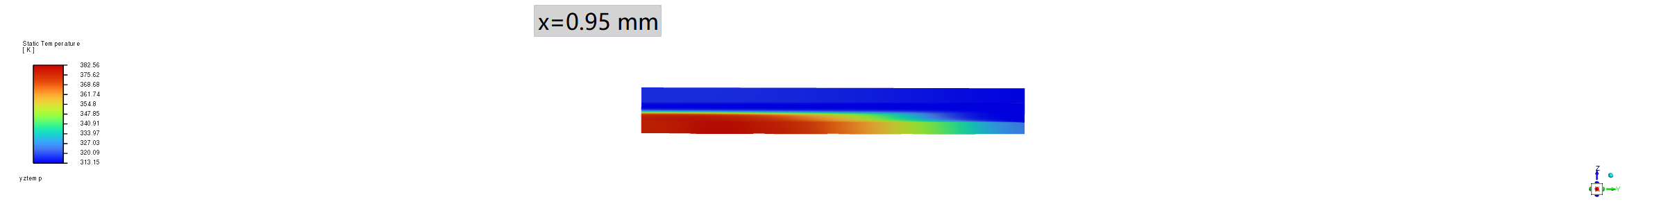
coolingplate/design/cfd_HBM/figs/i400/x095_temperature.png
