bruce2012lu/AIDCtms_design202609/coolingplate/design/cfd_HBM/figs/i400/y25_temperature.png

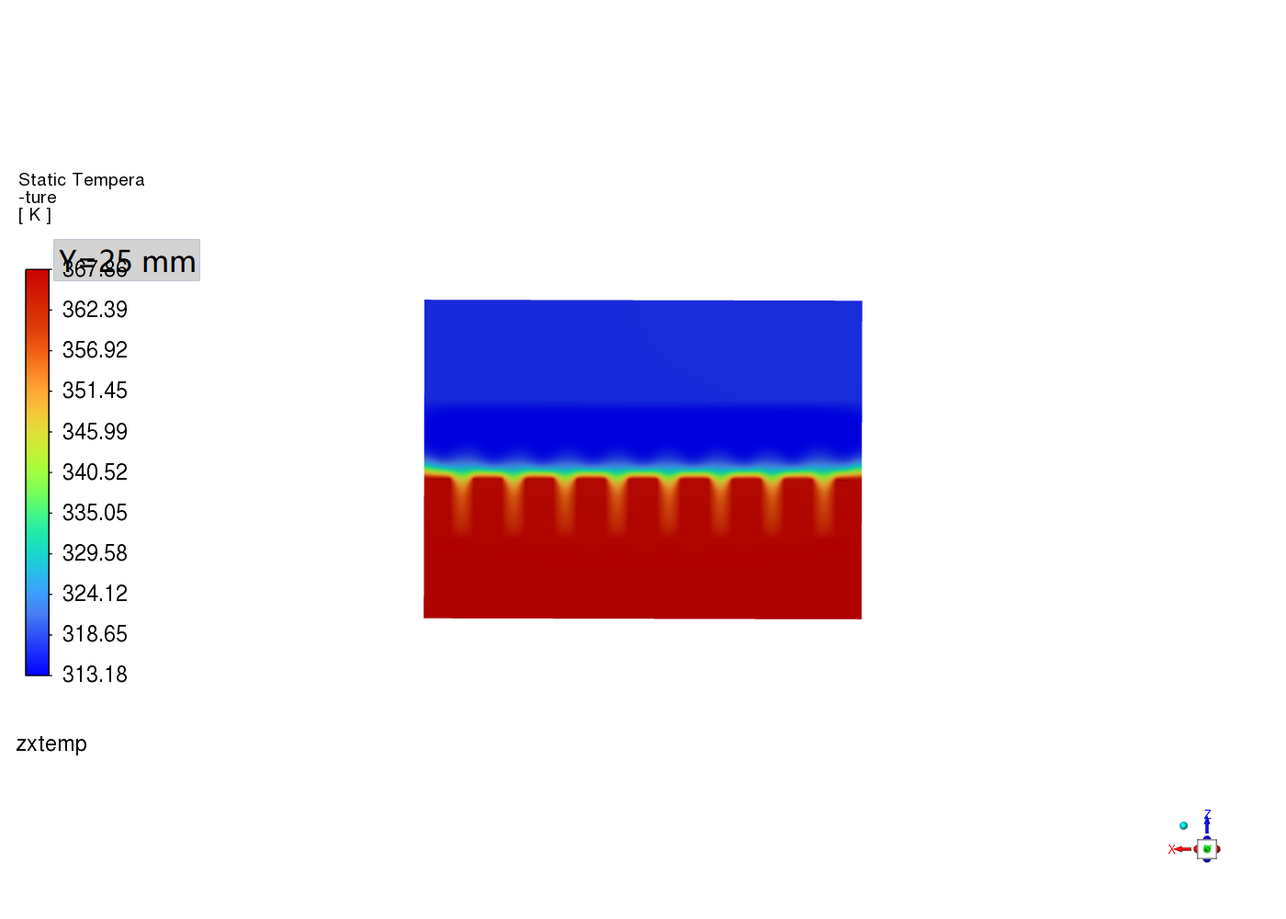
coolingplate/design/cfd_HBM/figs/i400/y25_temperature.png
