bruce2012lu/AIDCtms_design202609/coolingplate/papers/figures/chip_fig5_gpu_air_liquid.jpg

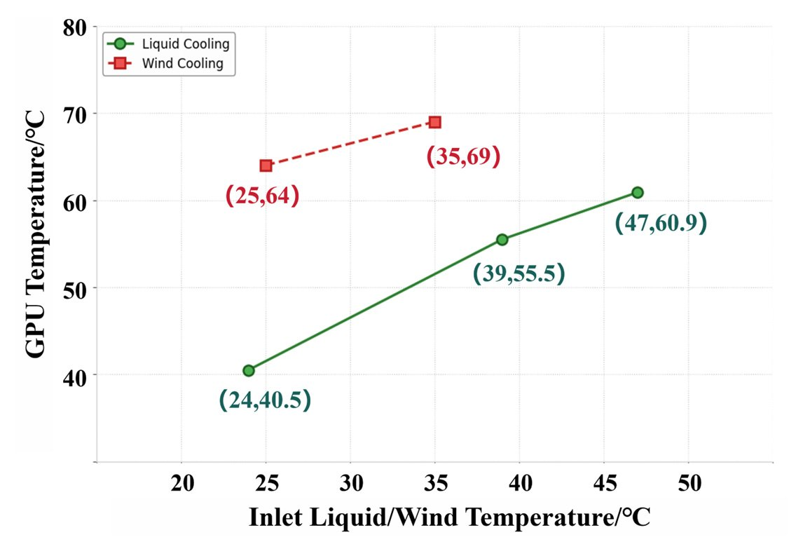
coolingplate/papers/figures/chip_fig5_gpu_air_liquid.jpg
