bruce2012lu/AIDCtms_design202609/coolingplate/papers/figures/chip_fig10_diamond_cu.jpg

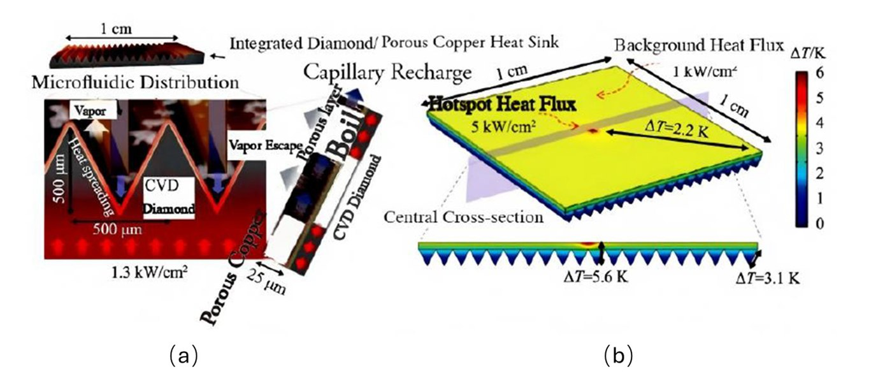
coolingplate/papers/figures/chip_fig10_diamond_cu.jpg
