bruce2012lu/AIDCtms_design202609/coolingplate/papers/figures/chip_fig18_serpentine.jpg

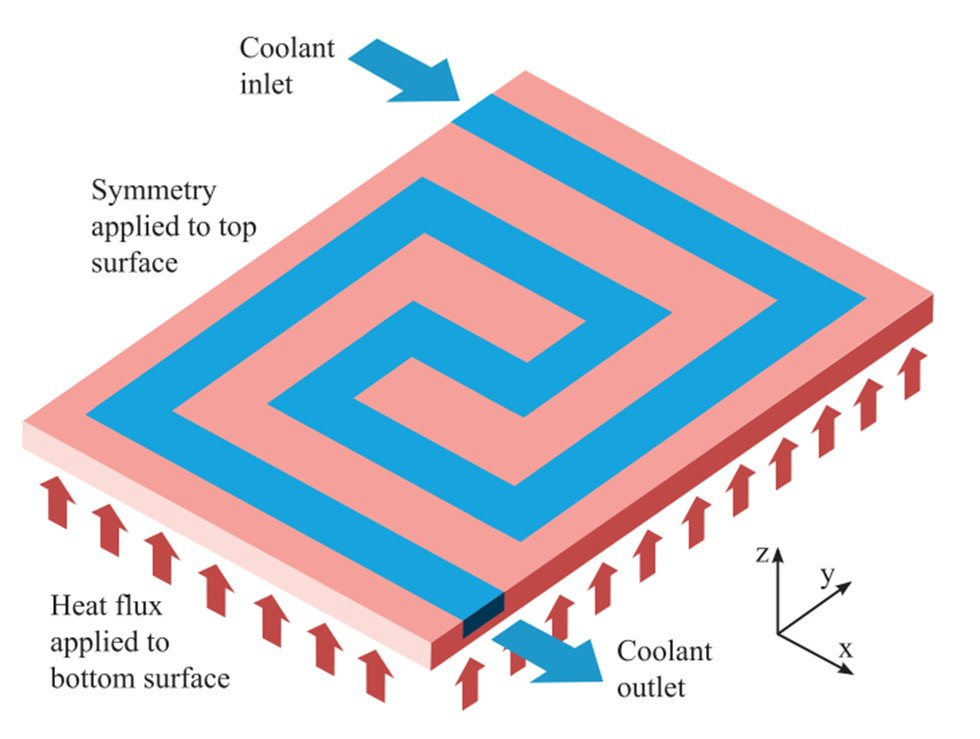
coolingplate/papers/figures/chip_fig18_serpentine.jpg
