bruce2012lu/AIDCtms_design202609/coolingplate/papers/figures/chip_fig19_dc_coldplate.jpg

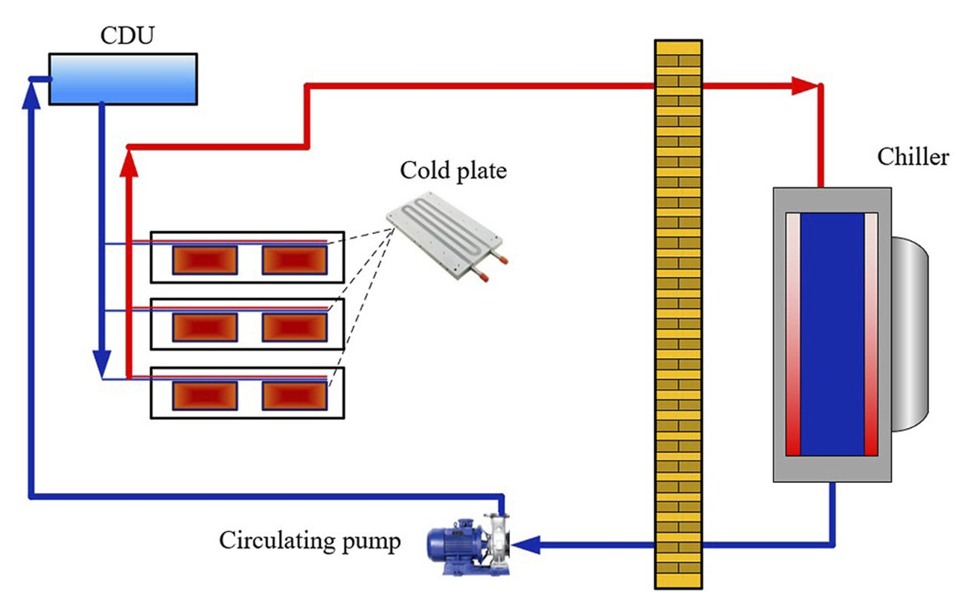
coolingplate/papers/figures/chip_fig19_dc_coldplate.jpg
