bruce2012lu/AIDCtms_design202609/coolingplate/papers/figures/chip_fig20_topo_cu.jpg

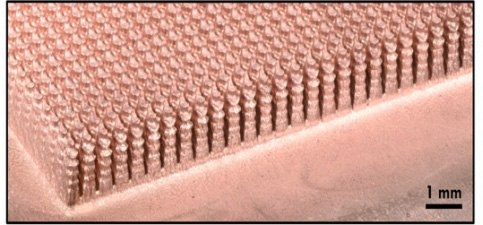
coolingplate/papers/figures/chip_fig20_topo_cu.jpg
