bruce2012lu/AIDCtms_design202609/coolingplate/papers/figures/chip_fig21_serrated.jpg

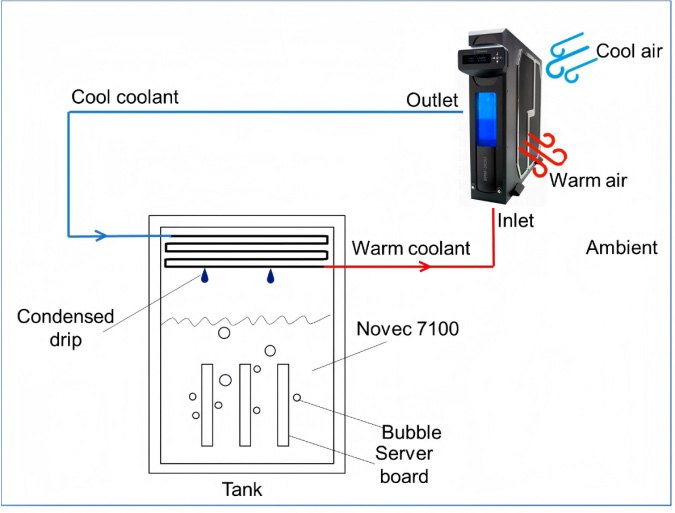
coolingplate/papers/figures/chip_fig21_serrated.jpg
