bruce2012lu/AIDCtms_design202609/coolingplate/papers/figures/e6_fig4_ir.jpg

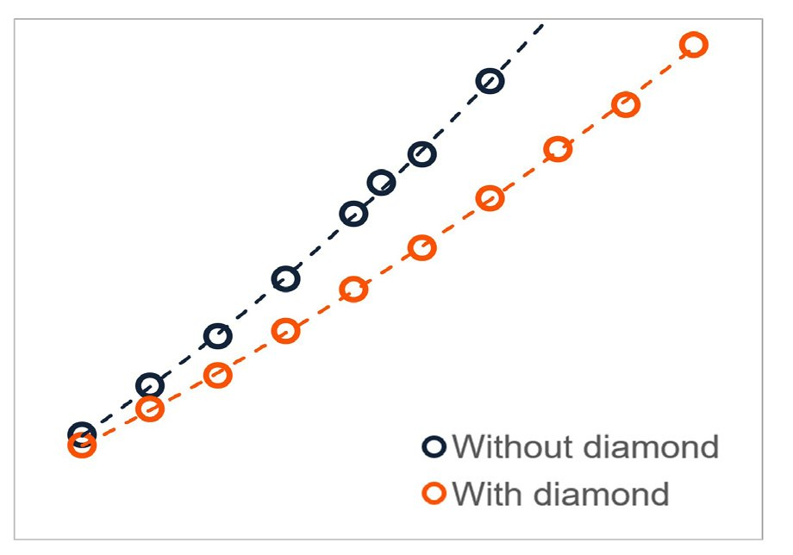
coolingplate/papers/figures/e6_fig4_ir.jpg
