bruce2012lu/AIDCtms_design202609/coolingplate/papers/figures/gen25d_fig4_temp.jpg

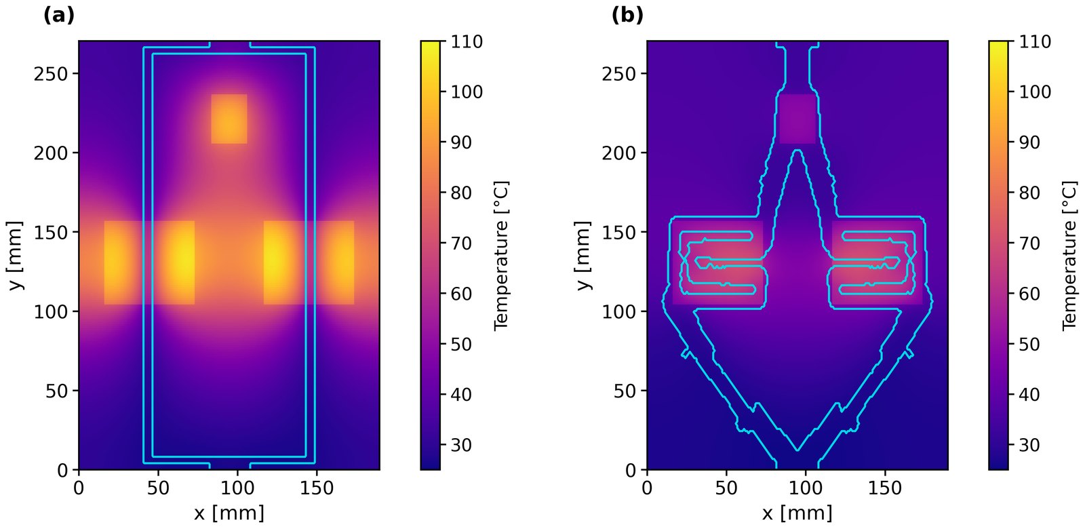
coolingplate/papers/figures/gen25d_fig4_temp.jpg
