bruce2012lu/AIDCtms_design202609/coolingplate/papers/figures/hussain_fig2_jet_model.jpg

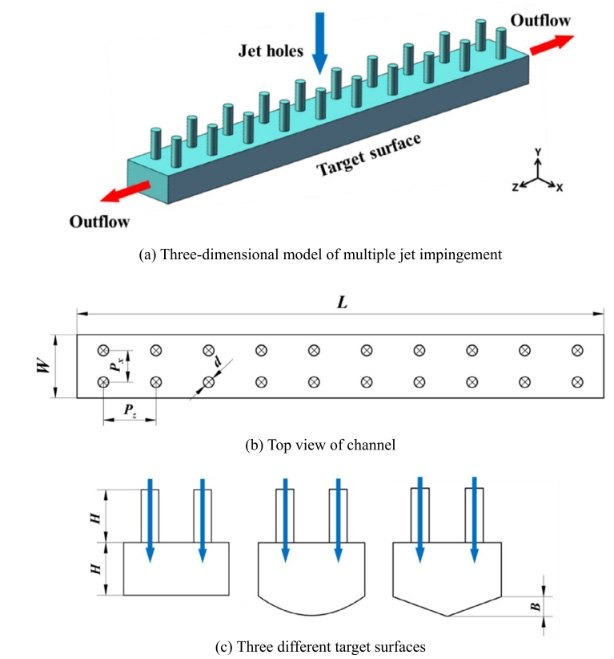
coolingplate/papers/figures/hussain_fig2_jet_model.jpg
