bruce2012lu/AIDCtms_design202609/coolingplate/papers/figures/mgo_fig1_nozzle_arr.jpg

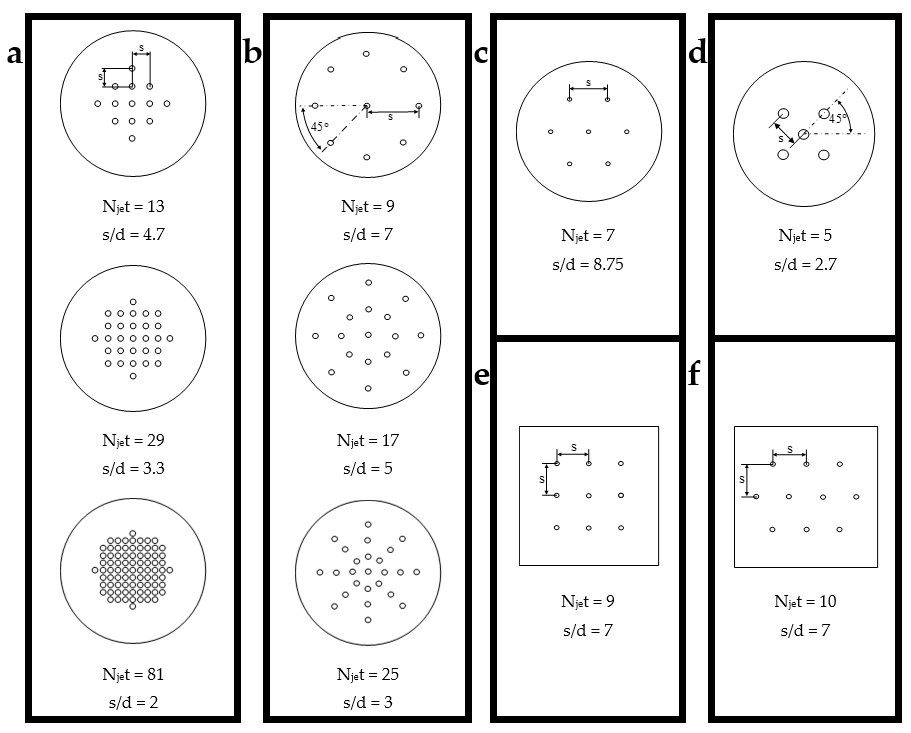
coolingplate/papers/figures/mgo_fig1_nozzle_arr.jpg
