bruce2012lu/AIDCtms_design202609/coolingplate/papers/figures/multichip_fig1_power.jpg

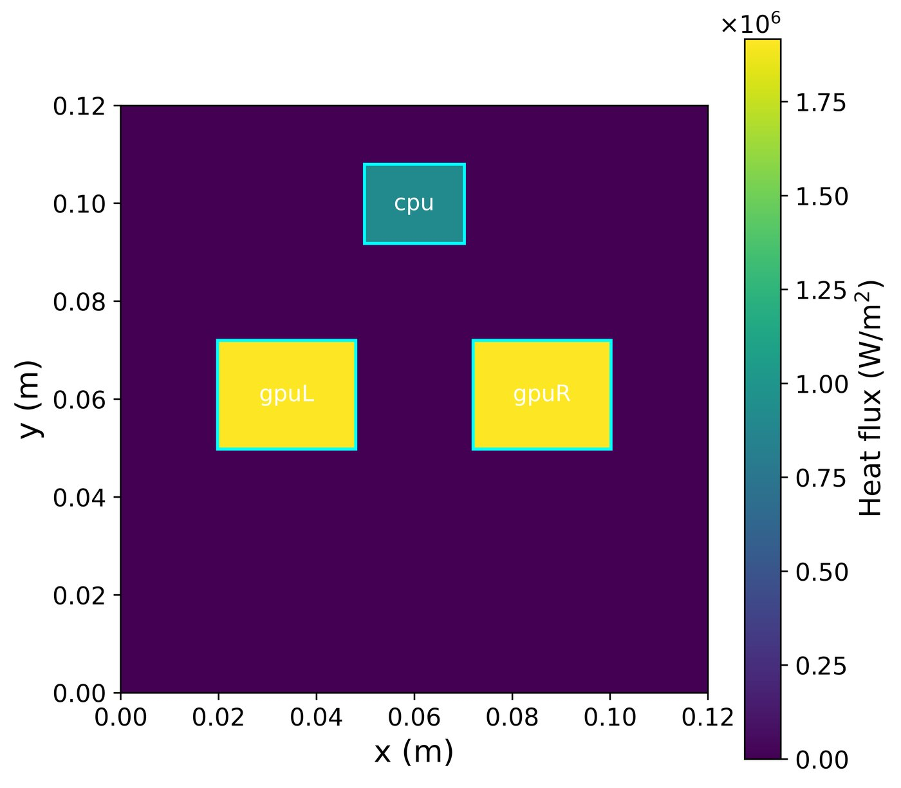
coolingplate/papers/figures/multichip_fig1_power.jpg
