bruce2012lu/AIDCtms_design202609/coolingplate/papers/figures/nano_fig5_jet_block.jpg

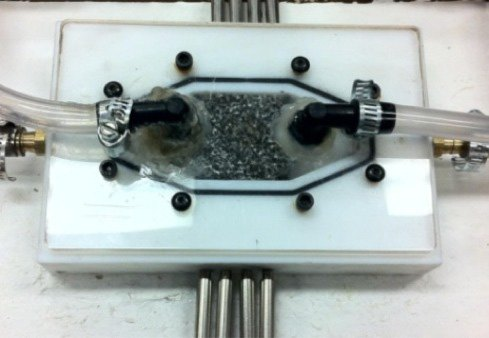
coolingplate/papers/figures/nano_fig5_jet_block.jpg
