bruce2012lu/AIDCtms_design202609/coolingplate/papers/figures/sciopen_fig1_cuar.jpg

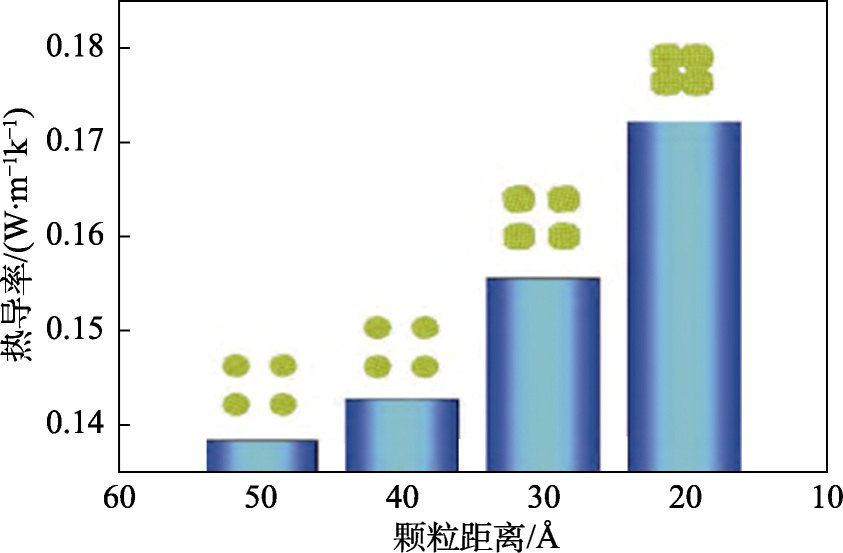
coolingplate/papers/figures/sciopen_fig1_cuar.jpg
