bruce2012lu/AIDCtms_design202609/solutions/assets/3d/system_3d_overview.png

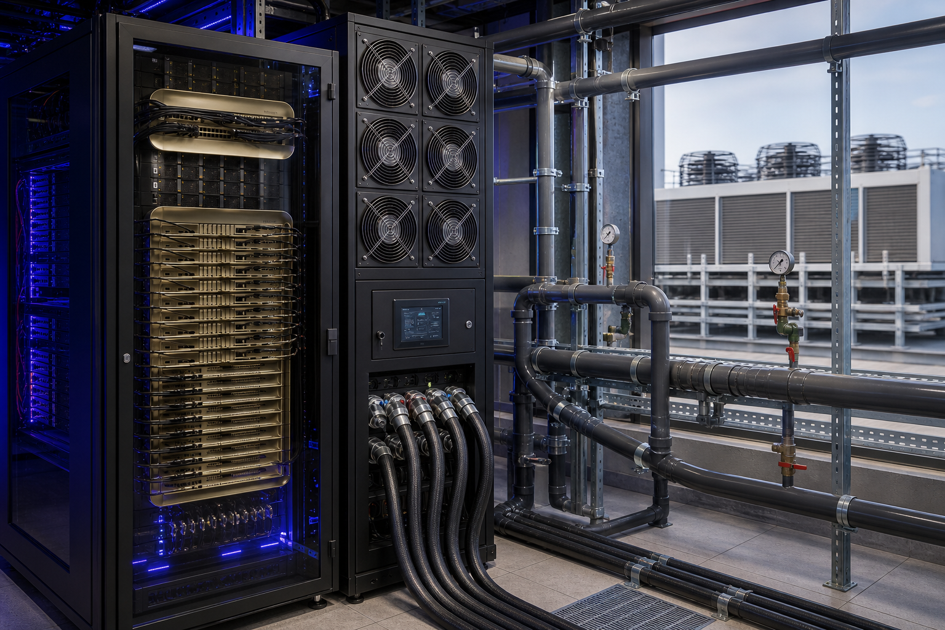
solutions/assets/3d/system_3d_overview.png
