bruce2012lu/AIDCtms_design202609/coolingplate/patent/appendix_核心专利清单_20260907.md

# 附录：AI算力芯片液冷冷板核心专利清单（抽样）

配套主报告：`AI算力芯片液冷冷板专利分析报告_20260907.md`  
检索日：2026-09-07。法律状态以官方库为准；下表“状态”仅来自公开聚合页，**不能**作为授权结论。

## A. 微通道 / 盖板一体化

| 公开号 | 标题要点 | 申请人 | 优先权/公开 | 链接 |
|---|---|---|---|---|
| US12133357B2 | Cold plate architecture for liquid cooling of devices | Intel | 2020 / 授权 2024 | https://patents.google.com/patent/US12133357B2 |
| US12477696 | Intelligent cold plate: microchannels + heat pipe | NVIDIA | 授权 | https://patents.google.com/patent/US12477696 |
| US20200227341A1 | Direct liquid micro jet over microchannel array | Intel 体系 | 2020 | https://www.patents-review.com/a/20200227341-direct-liquid-micro-jet-dlmj-structures-addressing-flow.html |
| CN109104844B | 多级流量分配微通道冷板 | 中航雷华 | 2018 申请，已授权 | https://patents.google.com/patent/CN109104844B |
| CN120597664A/B | 旁通 + SMA 执行器的微通道构建 | 广东蓝锐 | 2025 | https://patents.google.com/patent/CN120597664A |
| CN122263715A | 拓扑优化微通道自动设计 | — | 公开文本 | Patsnap Eureka 公开页 |
| WO2026103052A1 | 分区混构冷板（射流/微通道/拓扑） | 华为 | PCT 2026-05 | Patsnap Eureka 公开页 |

## B. 微翅片 / 铲齿 / 针肋

| 公开号 | 标题要点 | 申请人 | 备注 | 链接 |
|---|---|---|---|---|
| US5775187 | Micro deformation technology（铲齿基础） | — | 1998 | Google Patents |
| US9795057 | Method of producing a liquid cooled coldplate | — | 铲齿后斜切成针 | https://patents.google.com/patent/US9795057 |
| US12494408 | Double patterned microcooler, alternating fin widths | — | ~100 µm 通道 | https://patents.google.com/patent/US12494408 |
| US12193201 | Mini-channel, bi-metal adaptive fins | — | 无源自调节 | https://patents.google.com/patent/US12193201 |
| CN113871359A | 离心微通道 + 中心淹没射流 | 浪潮 | H01L23/473 | 公开文本 |

## C. 冲击射流

| 公开号 | 标题要点 | 申请人 | 备注 | 链接 |
|---|---|---|---|---|
| WO2020210587A1 | Microjet nozzles co-located with electronics | JetCool | PCT | https://patents.google.com/patent/WO2020210587A1 |
| US12100643B2 | 同上家族 US | JetCool | | Google Patents |
| US11844193 | Direct contact fluid cooling module | JetCool | 可含微射流 | https://patents.google.com/patent/US11844193 |
| US12002736 | Jet impingement for high power devices | — | 射流座对准热点 | https://patents.google.com/patent/US12002736 |
| US12255124 | Jet impingement with bypass | — | 降压降 | https://patents.google.com/patent/US12255124 |
| US10244654 | Inclined impingement + ribbed channels | — | 杂交 | https://patents.google.com/patent/US10244654 |
| US11310937 | Near-edge jet manifold | — | 边缘密封补偿 | https://patents.google.com/patent/US11310937 |
| US10306801 | Two-phase cold plate, nozzle on hotspot | — | 两相 | https://patents.google.com/patent/US10306801 |

## D. 金刚石

| 公开号 | 标题要点 | 申请人 | 备注 | 链接 |
|---|---|---|---|---|
| WO2016087243A1 | Diamond bonding, Cr layer, ≥1 kW/cm² | Element Six | 同族 EP3227914, US10403557 | https://patents.google.com/patent/WO2016087243A1 |
| US10403557 | 同上 US | Element Six | 授权 | https://patents.google.com/patent/US10403557 |
| CN111500892B | 大尺寸片状金刚石/铜，~1500 W/mK | — | 已授权 | Patsnap / CNIPA |
| CN122161445A | 金刚石合金散热冷板 | — | PVD+热压+3D 打印肋 | Patsnap Eureka |
| CN122503683A | 磷酸盐玻璃梯度界面金刚石铜 | — | 700–850 °C 热压 | Patsnap Eureka |

## E. 纳米流体与纳米界面

| 公开号 | 标题要点 | 申请人 | 备注 | 链接 |
|---|---|---|---|---|
| CN118890850A | 纳米流体空化自分散微通道热沉 | — | 防沉降 | https://patents.google.com/patent/CN118890850A |
| CN122278447A | 高稳定抗流挂液冷复合纳米流体 | 山东烯力 | 石墨烯+SWCNT | CNIPA 公开 |
| CN113488444B | 纳米磁流体芯片热点冷却 | 华中科技大学 | 已授权 2022 | CNIPA |
| CN122055001A | 冷板原位金属纳米线阵列替代 TIM | — | 界面而非工质 | Patsnap Eureka |
| 202310386028 | 纳米相变胶囊 + 反向热泳微通道衬底 | — | 公开文本 | 专利之星等转载 |

## F. 建议正式库补充检索的申请人

国际：IBM, Intel, NVIDIA, Google, Microsoft, JetCool Technologies, CoolIT, Asetek, Boyd, Vertiv, IMEC, ABB, Element Six, Samsung, TSMC, Corintis, EmCool  
中国大陆：浪潮信息/苏州浪潮, 曙光数创, 华为, 英维克, 中航光电, 立讯/领益, 广东蓝锐, 山东烯力, 华中科技大学  
中国台湾：Jentech 健策, AVC 奇宏, Auras 双鸿, Cooler Master, Delta  

分类号组合见主报告 §1.3。
