bruce2012lu/AIDCtms_design202609/Bp/tools/RFQ_四SKU物料询价模板_20260905.md

# 询价函｜冷板式液冷 CDU 四容量档关键物料统一询价

**文件编号：** RFQ-CDU-2026-001
**发出日期：** ____________
**报价截止：** 发出后 **10 个工作日**（如需延期请在 3 个工作日内书面提出）
**采购方联系人：** ____________　**电话/邮箱：** ____________
**币种：** 人民币（如为进口件请同时报 USD/EUR 并注明汇率基准日）
**税率：** 请报**不含税**单价，并另行注明适用增值税率
**报价有效期：** 请注明（不少于 30 天）

---

## 致供应商

我方正在开发面向数据中心的冷板式液冷冷量分配单元（CDU），容量档为 **100 / 200 / 300 / 450 kW** 四档。本次询价目的是取得**同工况、同边界、可横向比较**的书面报价，用于产品定义与成本结构核算。

**请注意三点：**

1. 本询价**不构成采购承诺**，也不构成排他性安排。
2. 请**不要**用容量线性插值填写四个容量档的价格。如某容量档的选型与相邻档位相同（例如 100 kW 与 200 kW 共用同一泵型），请明确注明"与 XXX kW 档同型号"。
3. 若我方所列技术要求存在遗漏，但该物料为系统完整运行所必需，**请主动列出并报价**，并在"补充建议"栏说明。我方将把主动补齐视为正向评价因素。

**保密：** 本文件及贵方报价互为保密信息。如需签署 NDA，请在收到本函后 2 个工作日内提出。

---

## 第一部分｜统一工况说明（所有报价必须基于本工况）

> 除特别说明，以下工况适用于全部四个容量档。选型如需偏离，请在"偏离说明"栏逐项列出。

### 1.1 热工与水力

| 项目 | 要求 |
|---|---|
| 一次侧（设施侧 FWS）供/回液温度 | **37 / 45 ℃** |
| 二次侧（技术侧 TCS）供/回液温度 | **40 / 50 ℃** |
| 接近温差 ATD（一次侧进液与二次侧出液之差） | **≤ 5 K**，请注明选型实际值 |
| 二次侧最高工作压力 | **3.5 bar(g)** |
| 二次侧设计压力 | **≥ 6 bar(g)**，耐压试验 ≥ 1.5 倍设计压力 |
| 二次侧工质 | **乙二醇水溶液 20%–25%（EG20–25）**；请同时报 **丙二醇 25%（PG25）** 选型差异 |
| 一次侧工质 | 冷却水（可含 EG，视项目） |
| 额定热负荷 | 按各容量档铭牌值，在上述工况下满足 |
| 二次侧额定流量 | 由供应商按 ΔT=10 K 选型后填写 |
| 二次侧额定扬程／可用压差 | 请给出 Q–ΔP 曲线，并标注额定工作点 |
| 过滤 | 二次侧全流量过滤，过滤精度请建议（我方倾向 ≤ 50 μm），含压差监测 |
| 水质 | 参照 OCP《Base Specification for Single Phase Water-Based Cold Plate Coolants》v1.3（2026-08-06 生效）；请注明兼容性 |

### 1.2 冗余与可维护性

| 项目 | 要求 |
|---|---|
| 泵冗余 | **N+1**（两台泵，单台可承担 100% 额定负荷）；请另报 **2N** 选项 |
| 泵切换 | 自动切换，切换过程二次侧不得断流；请给出切换时间 |
| 控制冗余 | 请说明是否支持控制器冗余，并另报价 |
| 电源 | 双路电源输入 + 自动切换（ATS）；请另报单路选项 |
| 维护方式 | 泵、过滤器、传感器要求**不停机可维护**（热插拔或旁通隔离）；请说明实现方式 |
| 故障态能力 | 请给出**单泵故障状态下**的额定能力（不得只给正常态） |

### 1.3 电气与控制

| 项目 | 要求 |
|---|---|
| 供电 | 380 V ± 10%，3P+N+PE，50 Hz |
| 控制器 | PLC + 本地 HMI（触摸屏 ≥ 7"） |
| 通信 | Modbus TCP **必需**；SNMP v3 与 Redfish 为**加分项**，请分别注明是否支持及是否加价 |
| 遥测点位 | 二次侧供/回液温度、流量、进出口压力、压差、泵转速/电流/运行时长、过滤器压差、液位、电导率、漏液报警、阀位、故障与冗余状态 |
| 报警与联锁 | 高/低液位、高/低压、超温、流量低、漏液、泵故障、通信中断；漏液报警须支持**联动切断** |
| 传感器校准 | 请说明出厂校准与现场调试校准要求，并提供校准证书 |

### 1.4 结构与接口

| 项目 | 要求 |
|---|---|
| 形式 | 落地式机柜（in-row 或 end-of-row），请注明外形尺寸与重量 |
| 防护等级 | 柜体 ≥ IP32（机房内），电气腔 ≥ IP54 |
| 接口 | 一次侧/二次侧法兰或卡箍，请注明规格 |
| 湿态接触材料（wetted materials） | **请逐项列出全部接液材料清单**（含垫片、O 圈、密封、涂层），这是必填项 |
| 漏液防护 | 底部集液盘 + 排水口 + 漏液检测绳/点式检测 |
| 噪声 | ≤ 75 dB(A) @ 1 m，请注明实测或计算值 |
| 颜色/铭牌 | 待定，请注明是否可定制及最小批量 |

### 1.5 试验与文件

| 项目 | 要求 |
|---|---|
| 出厂试验（FAT） | 泵运行、流量/压力性能、换热能力、过滤/脱气、控制逻辑、报警、冗余切换（参照 OCP CDU 指导 §3.6） |
| 耐压与气密 | 请注明试验压力、保压时间、判定标准 |
| 清洁度 | 请注明清洗工艺与颗粒度判定标准 |
| 随机文件 | 合格证、材质证明、校准证书、Q–ΔP 曲线、接液材料清单、操作维护手册（中文）、竣工图、点表 |
| 第三方测试 | 若可提供第三方性能测试报告，请注明机构、项目与费用 |

---

## 第二部分｜物料询价清单

> **填写说明：**
> - "技术要求"列由我方填写，"供应商填写"各列由贵方填写。
> - 每档如有多个可选方案（如经济型/高可靠型），请**复制该行**分别报价，并在"方案名称"栏区分。
> - 数量按**单台 CDU 所需**填写。**不得按容量线性放大**：N+1 冗余下的数量变化请如实填写。
> - 单价请报**不含税、人民币、到我方指定地点（含运费）**；如为 EXW，请在"贸易条件"栏注明。

### 表 A｜泵组

| 序号 | 物料 | 技术要求（我方） | 100 kW | 200 kW | 300 kW | 450 kW |
|---|---|---|---|---|---|---|
| A1 | 循环泵（二次侧） | 类型（离心/屏蔽/磁力驱动）：请建议；N+1 冗余；单台承担 100% 额定；EG20–25 兼容；不停机可更换 | | | | |
| A2 | 泵用变频器 VFD | 与 A1 匹配；支持 Modbus TCP；内置或外置请注明 | | | | |
| A3 | 泵隔离阀与旁通 | 支持不停机更换泵 | | | | |
| A4 | 减振与柔性接管 | | | | | |

**每个物料请填写以下字段（可另附 Excel）：**

| 字段 | 说明 |
|---|---|
| 方案名称 | 如"标准型"/"高可靠型" |
| 品牌 | |
| 型号 | |
| 单台 CDU 所需数量 | |
| 关键参数 | 流量/扬程/功率/效率/转速；请附性能曲线 |
| 接液材料 | 泵体、叶轮、轴、密封、O 圈逐项 |
| **单价（不含税，元）** | |
| **MOQ（最小起订量）** | |
| **阶梯价** | 请给出 1 / 10 / 50 / 200 台（对应 CDU 台数）的阶梯单价 |
| **交期（首件/批量，日历日）** | |
| **质保期（月）** | 起算点：出厂/到货/终验，请注明 |
| **付款条件** | 预付比例/账期/是否接受银行承兑 |
| 贸易条件 | EXW / FCA / DAP（含运费到我方地点） |
| 产地 | |
| 是否有替代/双源建议 | |
| 备件价格与可获得年限 | |
| 偏离说明 | 与我方技术要求不符之处 |

### 表 B｜换热器

| 序号 | 物料 | 技术要求（我方） | 100 kW | 200 kW | 300 kW | 450 kW |
|---|---|---|---|---|---|---|
| B1 | 板式换热器 | 在 §1.1 工况下满足额定热负荷；ATD ≤ 5 K；一次/二次侧压降请分别给出；钎焊或可拆卸请注明并说明可维护性差异 | | | | |
| B2 | 换热器隔离阀 | | | | | |
| B3 | 保温 | | | | | |

> 请特别注明：**换热面积、板片材质、钎焊料、垫片材质（如可拆卸）、设计压力、污垢系数假设**。

### 表 C｜快接与歧管（UQD / Manifold）

| 序号 | 物料 | 技术要求（我方） | 100 kW | 200 kW | 300 kW | 450 kW |
|---|---|---|---|---|---|---|
| C1 | UQD 快接头（公/母成对） | 请注明系列（如 CPC Everis / Stäubli SPT / Parker FEM 或国产等效）；**必填：额定循环寿命（次）、单次断开残留漏量（ml）、额定流量下压降、推荐安装扭矩** | | | | |
| C2 | 二次侧歧管 Manifold | 请注明材质、支管数量、焊接工艺、耐压 | | | | |
| C3 | 软管总成 | 请注明内衬材质、爆破压力、弯曲半径、寿命 | | | | |

> **C1 为责任风险最高的物料。** 请务必提供：循环寿命试验报告、残留漏量测试数据、扭矩窗口、是否提供产品责任险、是否接受背靠背质保。

### 表 D｜阀件、过滤、脱气与补液

| 序号 | 物料 | 技术要求（我方） | 100 kW | 200 kW | 300 kW | 450 kW |
|---|---|---|---|---|---|---|
| D1 | 全流量过滤器 | 精度请建议（倾向 ≤ 50 μm）；含压差监测；不停机更换滤芯 | | | | |
| D2 | 滤芯（备件） | 请另报年度耗材成本 | | | | |
| D3 | 脱气/排气装置 | 自动排气 + 真空脱气（如适用） | | | | |
| D4 | 定压补液装置 | 含膨胀罐、补液泵、液位控制 | | | | |
| D5 | 电动调节阀 | 一次侧流量/温度调节 | | | | |
| D6 | 手动隔离阀/止回阀/安全阀 | 请按套报价并列明数量 | | | | |
| D7 | 旁通与混水阀组 | 用于二次侧温度控制 | | | | |

### 表 E｜传感与仪表

| 序号 | 物料 | 技术要求（我方） | 100 kW | 200 kW | 300 kW | 450 kW |
|---|---|---|---|---|---|---|
| E1 | 温度传感器 | 精度 ≤ ±0.5 K；数量按点表 | | | | |
| E2 | 压力传感器 | 精度 ≤ ±1% FS | | | | |
| E3 | 差压传感器 | | | | | |
| E4 | 流量计 | 类型（电磁/超声）请建议；精度 ≤ ±1% | | | | |
| E5 | 电导率/水质传感器 | | | | | |
| E6 | 液位传感器 | | | | | |
| E7 | 漏液检测（绳式 + 点式） | 须支持联动切断输出 | | | | |

### 表 F｜控制与电气

| 序号 | 物料 | 技术要求（我方） | 100 kW | 200 kW | 300 kW | 450 kW |
|---|---|---|---|---|---|---|
| F1 | PLC 主机与 I/O 模块 | 按 §1.3 点位；请列 I/O 点数余量 | | | | |
| F2 | HMI 触摸屏 | ≥ 7"，中文 | | | | |
| F3 | 通信模块 | Modbus TCP 必需；SNMP v3 / Redfish 加分 | | | | |
| F4 | 双路电源切换（ATS） | | | | | |
| F5 | 配电元件（断路器、接触器、浪涌、UPS 控制电源） | | | | | |
| F6 | 线束与端子 | | | | | |
| F7 | 控制软件（如需授权） | 请注明授权模式、单机/站点、年费与源码托管 | | | | |

### 表 G｜结构、钣金与管件

| 序号 | 物料 | 技术要求（我方） | 100 kW | 200 kW | 300 kW | 450 kW |
|---|---|---|---|---|---|---|
| G1 | 柜体钣金（含喷涂） | 请注明板厚、材质、工艺、模具费是否单列 | | | | |
| G2 | 内部管路（不锈钢/铜） | 请注明材质牌号（如 304/316L）、规格、焊接工艺 | | | | |
| G3 | 集液盘与排水 | | | | | |
| G4 | 管件、法兰、卡箍、垫片 | 垫片材质须与工质兼容并列入接液材料清单 | | | | |
| G5 | 保温与防凝露 | | | | | |
| G6 | 脚轮/减震/固定件 | | | | | |
| **G0** | **一次性工装/模具费** | **请单独列明，不摊入单价**；并注明摊销建议台数 | | | | |

### 表 H｜工质

| 序号 | 物料 | 技术要求（我方） | 100 kW | 200 kW | 300 kW | 450 kW |
|---|---|---|---|---|---|---|
| H1 | 乙二醇水溶液 EG20–25 | 请报单位价格（元/L 与元/kg）及单台 CDU 初装量（L） | | | | |
| H2 | 丙二醇水溶液 PG25 | 同上 | | | | |
| H3 | 缓蚀剂/杀菌剂/添加剂 | 请注明是否已含在 H1/H2 内 | | | | |
| H4 | COA 与合规文件 | 请注明是否符合 OCP coolant base spec v1.3，是否提供 COA，是否含 PFAS | | | | |
| H5 | 年度补液/换液量估算 | 请给出建议更换周期与年度耗量 | | | | |

### 表 I｜制造、测试与服务（如贵方提供）

| 序号 | 项目 | 技术要求（我方） | 100 kW | 200 kW | 300 kW | 450 kW |
|---|---|---|---|---|---|---|
| I1 | 整机代工/委托装配（含 FAT） | 若贵方可提供整机装配，请按单台报价并列明含/不含物料 | | | | |
| I2 | 耐压/气密试验 | 按台或按批报价 | | | | |
| I3 | 清洗与清洁度检测 | | | | | |
| I4 | 第三方性能测试 | 请注明机构与费用 | | | | |
| I5 | 现场安装/调试支持（人天） | 请报人天单价、差旅计费方式、覆盖区域 | | | | |
| I6 | 备件寄售/服务网点 | 请说明可覆盖区域与响应时限 | | | | |

---

## 第三部分｜供应商能力与商务条件（必填）

| 项目 | 贵方填写 |
|---|---|
| 公司全称与统一社会信用代码 | |
| 主要生产地址 | |
| 年产能（对应物料） | |
| 同类数据中心液冷项目经历（项目名、年份、数量、容量） | |
| 质量体系认证（ISO 9001 等，含证书号与有效期） | |
| 产品认证（CE / UL / CQC 等，请注明适用型号） | |
| 是否投保产品责任险；保额与承保范围 | |
| 是否接受**背靠背质保**（我方对最终客户的质保义务同等传递给贵方） | 是 / 否 / 可谈 |
| 是否接受**产品变更通知（PCN）**约束（变更前书面通知并需我方确认） | 是 / 否 / 可谈 |
| 是否接受**批次可追溯**要求 | 是 / 否 |
| 是否接受被列为我方客户保单的**附加被保险人** | 是 / 否 / 可谈 |
| 是否可提供**第二产地/双源** | |
| 关键原材料的价格联动机制（如铜、不锈钢） | 请说明调价触发条件与幅度 |
| 汇率风险承担（进口件） | |
| 是否接受寄售/VMI 库存 | |
| 最长报价有效期 | |
| 我方遗漏但系统必需的物料（**补充建议**） | |

---

## 第四部分｜评审与后续

1. **评审维度：** 技术符合度（含 Q–ΔP 与故障态能力）、接液材料完整性、单价与阶梯价、MOQ、交期、质保与服务、付款条件、双源可行性、责任与保险配合度。
2. **不以最低价为唯一标准。** 接液材料清单缺失、拒绝提供 Q–ΔP 曲线、拒绝背靠背质保的报价将被降级。
3. **我方将在收到报价后 10 个工作日内反馈是否进入技术澄清。**
4. **每类关键物料我方计划保留至少 2 家合格供应商。**

---

## 附录｜供应商自查清单（提交前请逐项确认）

- [ ] 四个容量档均已分别报价，且未使用线性插值
- [ ] 已提供 Q–ΔP 曲线，并标注对应工质（EG20–25 或 PG25）
- [ ] 已提供**完整接液材料清单**（含垫片、O 圈、密封、涂层）
- [ ] 已给出**单泵故障状态下**的额定能力
- [ ] 已列明单价、MOQ、阶梯价、交期、质保、付款条件五项完整
- [ ] 一次性工装/模具费已单独列出，未摊入单价
- [ ] UQD 已提供循环寿命、残留漏量、压降、安装扭矩四项数据
- [ ] 工质已注明是否符合 OCP coolant base spec v1.3、是否提供 COA、是否含 PFAS
- [ ] 已回答背靠背质保、PCN、批次追溯、附加被保险人四项商务问题
- [ ] 已填写"补充建议"栏（如无遗漏请注明"无"）

---

> 本模板依据：OCP《CDU Performance & Specification Guidance for Modular TCS》§3.6（FAT/SAT 项）；OCP《Base Specification for Single Phase Water-Based Cold Plate Coolants》v1.3（2026-08-06 生效）；广东移动佛山三水项目公开工况（37/45 ℃ 一次侧、40/50 ℃ 二次侧、二次侧 3.5 bar、EG 20%–25%、双泵）。
> 工况参数取自公开招标文件，用于建立可比基准；实际项目须以客户书面平台包替换。
