bruce2012lu/AIDCtms_design202609/Bp/tools/合同条款审查清单_20260905.md

# 合同条款审查清单｜液冷 CDU 供货／安装／服务合同

**版本：** v1.0 / 2026-09-05
**适用：** 冷板式液冷 CDU 及配套（二次管路、工质、UQD/Manifold）的供货、安装、调试与质保合同；作为供应商（我方）签约前的强制审查工具
**审查人：** ____________　**复核人（法务/财务）：** ____________　**审查日期：** ____________

---

## 使用规则

**三级标注定义：**

| 标注 | 含义 | 处置 |
|---|---|---|
| 🔴 **红线** | 无法达成即**不接单**。这些条款决定的不是利润高低，而是单次事故是否会消灭整个业务 | 必须获得，无例外授权不得签署 |
| 🟡 **可谈判** | 影响利润与现金，但可通过定价、保险或技术手段对冲 | 未获得时须书面记录对冲方案与定价补偿 |
| 🟢 **可接受** | 行业常见，接受即可，但须知悉成本并计入报价 | 计入报价成本，无需上升 |

**审查纪律：**
1. **红线条款有 8 条。任何一条未达成，不得签署，须提交管理层专项决议。**
2. 每条填写"合同实际文本"栏，**不得只填"符合/不符合"**。要摘录原文。
3. 涉及金额的条款必须换算成"占合同额百分比"和"绝对金额"两个口径。
4. 责任类条款须同时检查**上限**和**上限的例外（carve-out）**。只看上限会严重低估敞口。
5. 保险类条款须与责任类条款**逐条对照**：合同要我方赔的，保险必须能保。不能保的部分是自留风险，须量化。

---

## 一、责任与赔偿（决定业务是否成立）

| # | 条款 | 标注 | 我方要求 | 合同实际文本 | 判定 |
|---|---|---|---|---|---|
| 1.1 | **累计责任上限** | 🔴 **红线 R1** | 明示金额或明确公式，且 **≤ 含服务的合同总价**。不接受"无上限"、"按法律规定"或未提及 | | ☐通过 ☐不通过 |
| 1.2 | **间接／后果性损失排除** | 🔴 **红线 R2** | 明示排除：利润损失、收入损失、数据损失、算力/训练机会损失、客户流失、商誉损失、SLA 罚款、客户对第三方的赔偿、监管处罚与监管资本占用 | | ☐通过 ☐不通过 |
| 1.3 | **责任上限的例外项（carve-out）** | 🔴 **红线 R1 附属** | 例外项限于：故意不当行为、重大过失、人身伤亡、保密与数据违约、知识产权侵权。**不接受**把"漏液导致的 IT 设备损坏"或"停机"列为例外 | | ☐通过 ☐不通过 |
| 1.4 | **漏液责任的归责方法** | 🔴 **红线 R3** | 按"原因 + 控制权 + 验收状态"归责，不按"设备归谁"。参照 Digi Power X–Cerebras MSA Art. 11.2(b)(c) 结构 | | ☐通过 ☐不通过 |
| 1.5 | **一次侧责任界面** | 🔴 **红线 R4** | 一次侧水质失控、异物侵入、误操作、压力异常导致二次侧污染或损坏，责任在设施方。我方责任始于二次侧法兰/接口 | | ☐通过 ☐不通过 |
| 1.6 | **客户与第三方行为免责** | 🔴 **红线 R5** | 客户或第三方安装/拆装 UQD、不当运维、超工况运行、未按手册维护造成的漏液或损坏，不计入我方责任 | | ☐通过 ☐不通过 |
| 1.7 | **责任界面矩阵** | 🟡 可谈判 | 要求合同附件逐项列明责任方：CDU 本体、一次侧、二次侧主管、支管/Manifold、UQD/软管、冷板、工质、水质、漏液检测、排水/托盘、BMS/DCIM、施工、运维 | | ☐通过 ☐可谈 |
| 1.8 | **第三方索赔的处理** | 🟡 可谈判 | 明确抗辩权归属、和解须我方书面同意、费用分担 | | ☐通过 ☐可谈 |
| 1.9 | **污染与环境清理责任** | 🟡 可谈判 | 工质释放的清理责任、费用上限、是否属于责任上限之内 | | ☐通过 ☐可谈 |
| 1.10 | **连带责任** | 🟡 可谈判 | 联合体/分包情形下拒绝无限连带；按各自供货范围承担 | | ☐通过 ☐可谈 |

> **审查提示（1.1–1.3）：** 律所专业评论指出，业主常要求把数据丢失与网络安全加入上限例外，而承包商强烈抵制，理由是单次事件的责任可达远超项目价值与可获得保险额度。反证：C-DAC 2024 招标澄清中，供应商自拟的"责任限于合同总价 + 排除间接损失"文本被采购人**删除**，改为适用 GeM 标准责任条款。**因此本组条款必须视为需要主动争取的对象，不能假定默认可得。**

---

## 二、保险（决定责任能否转移）

| # | 条款 | 标注 | 我方要求 | 合同实际文本 | 判定 |
|---|---|---|---|---|---|
| 2.1 | **保险与赔偿义务背靠背** | 🔴 **红线 R6** | 合同要求我方承担的赔偿义务，必须落在保单承保范围内；免赔额、除外责任、分项限额已书面确认。**不可保部分须量化为自留风险并计入报价** | | ☐通过 ☐不通过 |
| 2.2 | **冷却液释放明列为承保的直接财产损失** | 🔴 **红线 R6 附属** | 保单须明确"冷却液释放造成的直接物理损坏"为承保，而非按"污染"或"渐变渗漏"除外 | | ☐通过 ☐不通过 |
| 2.3 | 产品责任险／CGL 保额与承保范围 | 🟡 可谈判 | 保额须与 §一 的责任上限匹配；须覆盖合同赔偿义务（contractual liability） | | ☐通过 ☐可谈 |
| 2.4 | 安装工程一切险（CAR） | 🟡 可谈判 | 明确投保方、覆盖期间（含调试与试运行）、被保险人范围 | | ☐通过 ☐可谈 |
| 2.5 | 货物运输险 | 🟢 可接受 | 明确投保方与 Incoterms 一致 | | ☐通过 |
| 2.6 | 超额／伞式责任险 | 🟡 可谈判 | 触发层与限额；是否为客户强制要求 | | ☐通过 ☐可谈 |
| 2.7 | 附加被保险人与代位求偿放弃 | 🟢 可接受 | 客户列为附加被保险人是常见要求；须核算保费增量 | | ☐通过 |
| 2.8 | 保险凭证提交时点 | 🟢 可接受 | 通常在进场前；须提前安排 | | ☐通过 |
| 2.9 | **渐变劣化除外的影响** | 🟡 可谈判 | 冷板点蚀、生物污堵等长期劣化可能被认定为"劣化"而非"突发意外"，机器损坏险的渐变除外可能触发。须与保险人书面确认此类情形的处理 | | ☐通过 ☐可谈 |
| 2.10 | PFAS 与含氟工质除外 | 🟢 可接受（单相水基）/🟡（两相） | 单相水/乙二醇体系一般无此问题；若涉两相含氟工质，环境责任市场普遍带 PFAS 除外，须专项确认 | | ☐通过 ☐可谈 |
| 2.11 | 保险赔款的现金处理 | 🟢 可接受 | 合同中不得约定"保险赔款视为已履行赔偿"；**内部纪律：保险赔款在承保范围、免赔额和除外责任确认前不计入现金流入** | | ☐通过 |

---

## 三、验收（决定收入确认与回款起点）

| # | 条款 | 标注 | 我方要求 | 合同实际文本 | 判定 |
|---|---|---|---|---|---|
| 3.1 | FAT 的工况、仪器精度与通过阈值 | 🟡 可谈判 | 逐项写明测试工况、仪器精度、通过判据、整改次数上限、签字主体。参照 OCP CDU 指导 §3.6：泵运行、流量/压力、换热能力、过滤/脱气、控制逻辑、报警、冗余切换 | | ☐通过 ☐可谈 |
| 3.2 | SAT 的范围与前置条件 | 🔴 **准红线** | SAT 须以"客户已完成一次侧、供电、IT 侧就位与水质达标"为前置条件；前置条件未满足导致的延误不计入我方违约 | | ☐通过 ☐不通过 |
| 3.3 | **验收与付款的绑定** | 🟡 可谈判（但见 3.4） | 我方收款应绑定"到货 + FAT + SAT"，尽量不绑定最终客户验收 | | ☐通过 ☐可谈 |
| 3.4 | **"以收到最终客户付款为前提"（pay-when-paid）** | 🔴 **准红线** | **拒绝**无条件背靠背至最终客户付款。参照 TCIL 2024 合同：付款明确"以收到最终客户付款为前提"，并将节点延伸至带载运行 6 个月、投运满 1 年——此结构会使回款不确定性无限延长 | | ☐通过 ☐不通过 |
| 3.5 | 第三方验证测试 | 🟡 可谈判 | 明确机构、范围、费用承担、失败后的整改与复测次数。参照联通中卫项目以"第三方验证测试 + 最终客户验收"为完成标准 | | ☐通过 ☐可谈 |
| 3.6 | 带载测试的负载来源 | 🟡 可谈判 | 明确用真实业务负载还是模拟负载；模拟负载设备由谁提供、谁付费 | | ☐通过 ☐可谈 |
| 3.7 | 视为验收（deemed acceptance） | 🟡 可谈判 | 争取"客户在 N 日内未提出书面异议即视为验收"；N 建议 ≤30 日 | | ☐通过 ☐可谈 |
| 3.8 | 缺陷清单与分级 | 🟢 可接受 | 区分"影响验收的重大缺陷"与"不影响验收的次要缺陷"；次要缺陷不得阻碍验收与付款 | | ☐通过 |
| 3.9 | 竣工资料与培训 | 🟢 可接受 | 明确资料清单、语言、培训人次与时长；计入成本 | | ☐通过 |
| 3.10 | BMS/DCIM 集成 | 🟡 可谈判 | 点表、协议、集成责任方、联调窗口须明确；客户侧系统未就绪不计入我方延误 | | ☐通过 ☐可谈 |

---

## 四、质保与售后（决定尾部成本）

| # | 条款 | 标注 | 我方要求 | 合同实际文本 | 判定 |
|---|---|---|---|---|---|
| 4.1 | 质保期长度与起算点 | 🟢 可接受 | 已核验区间：24 个月（浙江移动，终验后起算）至 60 个月（C-DAC 现场综合质保）。**起算点必须明确**，"终验后"与"到货后"差异可达数月 | | ☐通过 |
| 4.2 | **替换件是否重新起算质保** | 🟡 可谈判 | 争取"替换件质保不超过原质保期结束后 6 个月"。反证：C-DAC 2024 中供应商请求"5.5 年封顶且替换件不重新起算"，采购人回复"不变" | | ☐通过 ☐可谈 |
| 4.3 | 响应与修复时限 | 🟡 可谈判 | 已核验：C-DAC 要求 8 小时响应、零件/模块最长 72 小时更换。**该时限直接决定备件库位置与服务网络成本，必须在报价中定量** | | ☐通过 ☐可谈 |
| 4.4 | 现场免费更换与运保费 | 🟢 可接受 | 已核验为常见条款（C-DAC、TCIL 均要求运费保险由供应商承担）；计入质保准备 | | ☐通过 |
| 4.5 | 备件库存与可获得年限 | 🟡 可谈判 | 明确备件品种、数量、存放地、盘点方式；争取"停产后 N 年可获得"而非无限期 | | ☐通过 ☐可谈 |
| 4.6 | 质保范围的除外 | 🟡 可谈判 | 明确除外：客户误操作、超工况、水质不达标、未按手册维护、第三方改动、不可抗力 | | ☐通过 ☐可谈 |
| 4.7 | 质保期后的 CAMC/年度维保 | 🟢 可接受 | 参照 TCIL：3 年质保后接 3 年 CAMC。可作为服务收入机会 | | ☐通过 |
| 4.8 | 可用性/SLA 服务积分 | 🟡 可谈判 | 若客户要求可用性 SLA，须明确统计口径、免责窗口、积分上限，并确认是否计入责任上限之内 | | ☐通过 ☐可谈 |

---

## 五、性能保证（PG）与违约金（LD）

| # | 条款 | 标注 | 我方要求 | 合同实际文本 | 判定 |
|---|---|---|---|---|---|
| 5.1 | **PG 的测量工况与仪器精度** | 🔴 **准红线** | 保证值必须绑定明确工况（一次/二次侧温度、流量、工质浓度、环境）与仪器精度。**不接受"在任何工况下满足额定容量"** | | ☐通过 ☐不通过 |
| 5.2 | **PG 未达标的后果限于扣款** | 🔴 **红线 R8** | 未达标以性能扣款（Performance LD）为限，**不触发合同终止、全额退货或无限整改** | | ☐通过 ☐不通过 |
| 5.3 | 性能 LD 上限 | 🟡 可谈判 | 行业指引转引的常见区间为合同价 10%–15%（宽者 5%–25%）。**该数据为三级来源（行业指引转引），仅作谈判参照，不得写入报告作为事实** | | ☐通过 ☐可谈 |
| 5.4 | **迟延 LD 的费率与上限** | 🔴 **红线 R7** | 上限 ≤ 合同价 5%，且与责任上限**合并**计算而非叠加。先例：C-DAC 2024 将迟延 LD 由"每周 0.5%、最高 10%"调整为"最高 5% 的未税基础合同额" | | ☐通过 ☐不通过 |
| 5.5 | 延误的免责事由 | 🟡 可谈判 | 客户原因（图纸/一次侧/供电/IT 侧就位延迟、水质不达标、现场不具备条件）、不可抗力、客户变更、进口清关延误须明列为免责 | | ☐通过 ☐可谈 |
| 5.6 | LD 是否为唯一救济 | 🟡 可谈判 | 争取"LD 为客户就该项违约的唯一救济"（sole remedy） | | ☐通过 ☐可谈 |
| 5.7 | 效率/PUE 类保证 | 🟡 可谈判 | 若客户要求 PUE 或能效保证，须明确边界（我方只能对二次侧负责，不能对整机房 PUE 负责） | | ☐通过 ☐可谈 |

---

## 六、付款、担保与现金（决定生存）

| # | 条款 | 标注 | 我方要求 | 合同实际文本 | 判定 |
|---|---|---|---|---|---|
| 6.1 | **预付款比例** | 🟡 可谈判（**最高杠杆项**） | 争取 ≥20%，理想 30%。参照 C-DAC：最高 30% 预付款但需同额银行保函（有效 12 个月）。**30% 预付款可使单项目峰值现金占用下降约 40%** | | ☐通过 ☐可谈 |
| 6.2 | 付款里程碑分段 | 🟡 可谈判 | 争取"到货实物核验后累计至 80%"（C-DAC 先例）；避免大比例集中在终验后 | | ☐通过 ☐可谈 |
| 6.3 | **账期起算日** | 🔴 **准红线** | 必须明确从"合规发票开具日"或"验收签字日"起算，且客户不得以内部流程延后起算。已核验常见账期为 30 日 | | ☐通过 ☐不通过 |
| 6.4 | 履约保证金 | 🟢 可接受 | 已核验：合同额 5%（江苏移动为含税成交额 5%；C-DAC 为未税额 5%）。须核算保函费率与授信占用 | | ☐通过 |
| 6.5 | 质保金／PBG | 🟡 可谈判 | 争取以银行保函替代现金留存。参照 C-DAC：末 10% 凭 3% PBG 释放，PBG 有效 62 个月。**注意：保函释放现金但不释放授信** | | ☐通过 ☐可谈 |
| 6.6 | 保函的费用与有效期 | 🟢 可接受 | 明确费用承担、有效期、自动展期条款；计入现金调整后贡献 | | ☐通过 |
| 6.7 | 投标保证金 | 🟢 可接受 | 已核验：江苏移动 4 万元。计入投标成本 | | ☐通过 |
| 6.8 | 无条件见索即付保函 | 🟡 可谈判 | 尽量争取有条件保函；无条件保函应换取更高预付款或更低比例 | | ☐通过 ☐可谈 |
| 6.9 | 价格调整机制 | 🟡 可谈判 | 铜、不锈钢、汇率、关税的调价触发条件与幅度。**框架合同尤其重要：浙江移动框架有效至 2028-03-31，跨期两年以上** | | ☐通过 ☐可谈 |
| 6.10 | 按实结算 vs 固定总价 | 🟡 可谈判 | 江苏移动为"按实际发生内容结算"的框架。须明确工程量确认流程与争议解决 | | ☐通过 ☐可谈 |
| 6.11 | 抵扣权 | 🟡 可谈判 | 限制客户从里程碑款中任意扣减；争取"争议金额不得扣减"或"扣减需书面依据" | | ☐通过 ☐可谈 |
| 6.12 | 币种与汇率风险 | 🟢 可接受 | 进口件与出口项目须明确 | | ☐通过 |

---

## 七、知识产权与保密

| # | 条款 | 标注 | 我方要求 | 合同实际文本 | 判定 |
|---|---|---|---|---|---|
| 7.1 | 背景 IP 归属 | 🔴 **准红线** | 我方既有设计、软件、算法、工艺归我方；不因项目交付而转移 | | ☐通过 ☐不通过 |
| 7.2 | 前景 IP（项目产生的 IP） | 🟡 可谈判 | 客户出 NRE 的定制部分可授予客户使用权/独占使用权，但**底层平台 IP 不转移**；避免"客户出资即全部归客户" | | ☐通过 ☐可谈 |
| 7.3 | 软件授权模式 | 🟡 可谈判 | 明确单机/站点/永久/订阅、升级义务、源码托管（escrow）触发条件 | | ☐通过 ☐可谈 |
| 7.4 | IP 侵权赔偿 | 🟡 可谈判 | 我方通常需提供 IP 侵权赔偿；争取上限，或至少明确抗辩权与替代方案权（修改/替换/退款） | | ☐通过 ☐可谈 |
| 7.5 | 开源与第三方组件 | 🟢 可接受 | 披露清单与许可证；确认无 copyleft 污染 | | ☐通过 |
| 7.6 | 保密义务与期限 | 🟢 可接受 | 双向、期限明确、返还/销毁义务 | | ☐通过 |
| 7.7 | 客户数据与遥测 | 🟡 可谈判 | 我方通过 BMS/远程诊断获取的运行数据的使用权；争取"匿名化后可用于产品改进" | | ☐通过 ☐可谈 |
| 7.8 | 名称与案例使用权 | 🟢 可接受 | 争取在获得书面同意后可作案例宣传（对新进入者取得业绩门槛至关重要） | | ☐通过 |

---

## 八、变更、终止与其他

| # | 条款 | 标注 | 我方要求 | 合同实际文本 | 判定 |
|---|---|---|---|---|---|
| 8.1 | **漏项责任** | 🔴 **准红线** | 已核验：C-DAC 与 TCIL 均规定"满足完整功能所需但漏报的物料由中标人免费补齐"。**必须在投标阶段用"供货范围清单 + 明确排除项"限定此风险** | | ☐通过 ☐不通过 |
| 8.2 | 变更流程 | 🟡 可谈判 | 书面变更单、报价确认、工期调整、未确认不施工 | | ☐通过 ☐可谈 |
| 8.3 | 客户变更导致的成本与工期 | 🟡 可谈判 | 明确补偿机制；避免"设计优化不计变更" | | ☐通过 ☐可谈 |
| 8.4 | 便利终止（termination for convenience） | 🟡 可谈判 | 若客户可随时终止，必须约定已投入成本、在制品、专用物料、利润损失的补偿 | | ☐通过 ☐可谈 |
| 8.5 | 违约终止的救济 | 🟡 可谈判 | 争取"补正期（cure period）≥30 日"与"仅重大违约可终止" | | ☐通过 ☐可谈 |
| 8.6 | **框架份额不构成采购承诺** | 🟢 可接受（须知悉） | 已核验：浙江移动明确以中标金额乘份额为框架上限，实际收入取决于订单。**内部纪律：框架金额与份额不得计入收入预测或产能规划** | | ☐通过 |
| 8.7 | 订单取消/延后的补偿 | 🟡 可谈判 | 框架合同下已排产、已采购专用件的取消补偿机制 | | ☐通过 ☐可谈 |
| 8.8 | 风险转移时点 | 🟡 可谈判 | 已核验反证：C-DAC 规定"货物在成功安装、调试并由最终用户接收前，风险、责任和负担仍由供应商承担"。**该结构使我方在长验收期内持续承担风险，须计入保险与报价** | | ☐通过 ☐可谈 |
| 8.9 | Incoterms 与费用承担 | 🟢 可接受 | 已核验：C-DAC 为 DAP 到场含包装运输保险装卸；TCIL 为 CIF 且卖方承担清关关税；PPC RFI 要求 DDP。**须逐项核算** | | ☐通过 |
| 8.10 | 转让与分包 | 🟡 可谈判 | 我方分包权（尤其安装服务）；客户转让合同须我方同意 | | ☐通过 ☐可谈 |
| 8.11 | 不可抗力 | 🟢 可接受 | 涵盖疫情、出口管制、芯片/关键件断供、限电 | | ☐通过 |
| 8.12 | 出口管制与合规 | 🟡 可谈判 | 海外项目须确认目的地合规（CE/UL）、出口管制、制裁名单、反腐败条款 | | ☐通过 ☐可谈 |
| 8.13 | 争议解决与适用法 | 🟡 可谈判 | 争取我方所在地或中立地仲裁；海外项目避免对方本地法院 | | ☐通过 ☐可谈 |
| 8.14 | 审计权 | 🟢 可接受 | 客户对我方的审计范围应限于本项目质量记录，不涉及成本与其他客户信息 | | ☐通过 |

---

## 九、红线汇总表（签约前必须逐条确认）

| 红线 | 条款编号 | 内容 | 状态 | 未达成时的处置 |
|---|---|---|---|---|
| **R1** | 1.1 + 1.3 | 累计责任上限 ≤ 含服务合同总价，且例外项不含漏液损坏 IT 设备与停机 | ☐达成 ☐未达成 | **不接单** |
| **R2** | 1.2 | 明示排除间接／后果性损失（利润、收入、数据、算力机会、客户流失、SLA 罚款、监管资本） | ☐达成 ☐未达成 | **不接单** |
| **R3** | 1.4 | 责任按"原因 + 控制权 + 验收状态"分配 | ☐达成 ☐未达成 | **不接单** |
| **R4** | 1.5 | 一次侧水质/异物/误操作导致的二次侧损坏，责任在设施方 | ☐达成 ☐未达成 | **不接单** |
| **R5** | 1.6 | 客户或第三方安装/拆装 UQD、不当运维造成的漏液不计入我方责任 | ☐达成 ☐未达成 | **不接单** |
| **R6** | 2.1 + 2.2 | 保险与赔偿义务背靠背；冷却液释放明列为承保的直接财产损失 | ☐达成 ☐未达成 | **不接单** |
| **R7** | 5.4 | 迟延 LD ≤ 合同价 5%，且与责任上限合并计算 | ☐达成 ☐未达成 | **不接单** |
| **R8** | 5.2 | PG 未达标以性能扣款为限，不触发终止或全额退货 | ☐达成 ☐未达成 | **不接单** |

**准红线（4 条，未达成须管理层专项决议）：** 3.2 SAT 前置条件、3.4 拒绝 pay-when-paid、5.1 PG 工况绑定、6.3 账期起算日、7.1 背景 IP、8.1 漏项责任范围限定。

---

## 十、为什么这 8 条是红线（量化依据）

以 200 kW CDU 配套包为例，按已核验的国内运营商包价上限计算：

| 项 | 值 |
|---|---|
| 合同额（715 元/kW × 200 kW） | **14.30 万元** |
| 项目毛利（按曙光数创冷板液冷 10.36% 实证锚点） | **1.48 万元** |
| 单块 GPU 基板更换成本（3.5–5.0 万美元，三级来源，汇率 7.2） | **25.2–36.0 万元** |
| 单柜 IT 资产价值（Epoch AI 21.2 美元/W × 135 kW，汇率 7.2） | **2,060.6 万元** |
| 该 CDU 覆盖的 IT 资产（200 ÷ 121.5 = 1.65 柜） | **3,392 万元** |
| 行业指引转引的责任上限（合同价 10%–20%，三级） | **1.43–2.86 万元** |

**结论：**

1. **一次 50 ml 冷却液滴落造成的单块基板损坏（25.2–36.0 万元），等于合同额的 1.76–2.52 倍、项目毛利的 17.0–24.3 倍。** 在最小可想象的事故中，供应商已赔掉 17–24 个同规模项目的全部毛利。
2. **单柜全损（2,060.6 万元）等于合同额的 144 倍、项目毛利的 1,391 倍，且是阶段一全部预算（800 万元）的 2.58 倍。** 即一次事故可以消灭整个业务。
3. **行业惯例的"合同价 10%–20% 责任上限"只有 1.43–2.86 万元，仅为单块基板成本的 4%–11%，连一块基板都赔不起。** 因此客户的理性诉求必然是不封顶或设超级上限——这正是谈判会破裂的地方，也正是这些条款必须成为红线的原因。
4. **责任封顶不是谈判技巧，而是业务成立的前提条件。** 若无法取得 R1–R6，该项目的数学期望是负的，无论定价多高。

复算：`715×200÷10,000 = 14.30`；`14.30×10.36% = 1.4815`；`35,000×7.2÷10,000 = 25.2`；`50,000×7.2÷10,000 = 36.0`；`25.2÷1.4815 = 17.01`；`36.0÷1.4815 = 24.30`；`21.2×135,000×7.2÷10,000 = 2,060.64`；`2,060.64÷14.30 = 144.10`；`2,060.64÷1.4815 = 1,390.93`；`2,060.64÷800 = 2.576`；`200÷121.5 = 1.6461`；`1.6461×2,060.64 = 3,392.0`

---

## 十一、审查结论

| 项 | 内容 |
|---|---|
| 红线达成情况 | ____ / 8 |
| 准红线达成情况 | ____ / 6 |
| 可谈判项未达成清单及对冲方案 | |
| 未投保的自留风险量化（万元） | |
| 单项目峰值现金占用（万元） | |
| 回款延迟容忍度（周） | |
| **审查结论** | ☐ 可签署　☐ 修改后可签署　☐ **不可签署** |
| 审查人签字 / 日期 | |
| 法务复核 / 日期 | |
| 财务复核 / 日期 | |
| 管理层批准（红线例外授权，如有） | |

---

## 附｜条款先例来源

| 先例 | 用途 | 等级 |
|---|---|---|
| Digi Power X–Cerebras《Data Center Colocation and MSA》，生效 2026-05-04，SEC 申报 | Art. 10（保险）、11.2(b)(c)（漏液归责）、12.1–12.3（间接损失排除与责任上限）、14.2(b)（客户造成损坏） | **一级（监管申报合同）** |
| C-DAC《Integrated DCLC Solutions》招标，2022-12-13 | p.12 §12 付款（30% 预付+保函 / 80% 到货 / 10% 调试验收 / 10% 凭 3% PBG）；5% 履约保证；5 年现场质保；8h/72h 服务；漏项责任；DAP | **一级（采购人原件）** |
| C-DAC《Annexure B – Corrigendum, GEM/2024/B/5031803》，2024-07 | 迟延 LD 上限调整为 5%；维持 5 年质保；替换件质保不重新起算被拒；供应商自拟责任封顶被删除 | **一级** |
| TCIL《ITBD/CDOT/I/2024 Data Centre Turnkey RFP》，2024-05-22 | 里程碑付款；"以收到最终客户付款为前提"；3% PBG；CAR 险；CIF 与关税；3 年质保 + 3 年 CAMC；迟延 LD 最高 10% | **一级** |
| 中国移动江苏南京科创 C2 栋招标公告，2026-07-31 | 5% 履约保证金（含税成交额）；4 万元投标保证金；框架按实结算；施工资质要求 | 三级（完整镜像，0.91） |
| 中国移动浙江 2026–2027 液冷 CDU 框架，2025-12-26 | 50 台 300 kW；68%/32% 份额；订单后 45 日到货；终验后 ≥24 个月保修；框架有效至 2028-03-31；≥200 万元业绩门槛 | 三级（完整镜像，0.90） |
| 中国移动广东佛山三水询比公告，2026-07-22 | 6×420 kW 工况；总价最高限价 1,725,576.99 元；45 日到货；验收后 2 年保修 | 三级（完整镜像，0.92） |
| OCP《CDU Performance & Specification Guidance for Modular TCS》 | §3.6 FAT/SAT 项；BMS/DCIM 集成；传感器校准。**是开放规范指导，不自动并入合同** | 二级 |
| Reed Smith《Liability clauses in data center construction contracts》 | 责任上限按合同价百分比设定；间接损失排除；上限例外的常见范围与谈判张力 | 二级（律所评论） |
| 《The Definitive Guide to AI Data Centers》§2.4 | 性能 LD 常见封顶 10%–15%（宽者 5%–25%）；累计责任上限常见 10%–20% | **三级（行业指引，转引 Womble Bond Dickinson）** |
| 保险行业风险分析（多篇） | 冷却液释放在标准财产险下可能按污染/渐变渗漏除外；EEI 与 M&BD 灰区；PFAS 除外；BI 修复期口径缺口 | **三级（经纪商/行业分析，须以保单原件替换）** |

> **引用纪律：** 三级来源的百分比区间（10%–20% 责任上限、10%–15% 性能 LD）仅可作为谈判参照，**不得**在对外材料中写成行业事实、法规或标准。所有金额与比例在取得客户书面条款后必须替换。
