bruce2012lu/AIDCtms_design202609/coolingplate/papers/文献清单与下载索引.md

# 文献清单与下载索引

对应主报告：`AI算力芯片液冷冷板技术调查分析报告.md`  
下载目录：`pdfs/`  
抽出原图：`figures/`（嵌入 HTML 报告 v1.3 各节结论旁）  
日期：2026-09-07

## 已下载全文（`pdfs/`）

| 文件 | 文献 | 与本报告的关系 |
|---|---|---|
| `01_MDPI_2021_Hussain_JetImpingement_Review.pdf` | Hussain et al., *Energies* 2021, 14(20):6458. 射流强化换热综述 | Barewar 2023 的开放获取平行综述：靶面、*H/D*、激励、纳米流体/PCM、PEC |
| `02_MDPI_2024_SSH_JetImpingement_Review.pdf` | *Energies* 2024, 17(17):4510. 异形孔射流流场与换热 | 增材异形孔、旋流孔、均温性与冷斑问题 |
| `03_MDPI_2024_Nanofluids_DataCenter_Review.pdf` | *Energies* 2024, 17(13):3151. 数据中心纳米流体应用与挑战 | 稳定性、污垢、磨损、电导率；TCS 不宜采用的主要依据 |
| `04_ASHRAE_LiquidCooling_Mainstream_WP.pdf` | ASHRAE 液冷进入主流数据中心白皮书 | W 类水温、设施与 IT 侧分工 |
| `05_ElementSix_Diamond_HeatSpreader_CaseStudy.pdf` | Element Six Diafilm 金刚石均热器案例 | 热点温降 4–45 °C；与硅基微射流/微通道集成 |
| `07_SciOpen_2025_Microchannel_HT_Enhancement.pdf` | 微通道散热器传热增强研究进展，2025 | 结构强化、金刚石/陶瓷基材、两相 |
| `08_arXiv_2604.10941_GenerativeDesign_D2C.pdf` | Generative Design for D2C Liquid Cooling | 非均匀热图下流道生成式设计 |
| `09_arXiv_2608.22787_Generative_2p5D3D.pdf` | 2.5D/3D 封装液冷流道生成式设计 | GB200 类 2 GPU+1 CPU 热源布局 |
| `10_arXiv_2605.20657_CoolingChannel_Multichip.pdf` | 高功率多芯片封装流道优化 | 歧管/树状/平行通道对比框架 |
| `13_MDPI_2026_ChipLevel_ThermalMgmt_Review.pdf` | *Energies* 2026, 19(14):3304. 高功率处理器芯片级热管理 | 近结区、嵌入式微通道、3D 封装 |
| `14_MDPI_2022_NEPCM_JetImpingement.pdf` | *Energies* 2022, 15:1034. 纳米胶囊 PCM 射流 | Barewar 工质路线的开放实验对照 |
| `15_MDPI_2023_MgO_MultiJet_Nanofluid.pdf` | *Materials* 2023, 16:3942. MgO–水多孔射流 | 多孔射流 + 纳米流体的流场与换热 |

## 未能稳定下载全文（已用摘要/规范页交叉引用）

| 文献 | 原因 | 替代 |
|---|---|---|
| Barewar et al., TSEP 2023, 101697 | Elsevier 付费；Sci-Hub 镜像超时 | 用 Hussain 2021、异形孔 2024 及该文被引信息重建参数框架 |
| Zou et al., *制冷学报* 2026 | SciOpen PDF 接口未返回有效文件 | 已用期刊页摘要（冷板/近结区/浸没三分法） |
| OCP 水基冷板冷却液规范 v1.3 PDF | opencompute.org 403 | 已用规范页公开条文（pH、腐蚀、微生物、PG25） |
| Nature Sci. Rep. 2025 TiO2 缝射流 PDF | 直链返回非 PDF | 未作为定量依据 |

## 已嵌入 HTML 的论文原图（`figures/` → 报告结论）

| 图文件 | 对应结论 | 原文 |
|---|---|---|
| `gb200_fig1_layout_heatflux.jpg` | GB200 2GPU+CPU 热图非均匀；footprint 平均 ≠ die 平均 | arXiv:2604.10941 Fig.1 |
| `chip_fig2_25d3d.jpg` | 2.5D/3D Chiplet 热点不在几何中心 | Energies 2026 Fig.2 |
| `ashrae_fig4_air_vs_liquid.jpg` | 风冷约 400 W 封顶，H100 已必须液冷 | ASHRAE WP Fig.4 |
| `chip_fig5_gpu_air_liquid.jpg` | 暖水液冷仍能压住 GPU 结温 | Energies 2026 Fig.5 |
| `ashrae_fig1_rth_vs_socket.jpg` / `ashrae_fig2_…` | 热阻被功率逐年压薄 | ASHRAE WP Fig.1–2 |
| `chip_fig6_embedded_mc.jpg` / `chip_fig14_evolution.jpg` | 平行微通道长沟失效 → MMC | Energies 2026 Fig.6/14 |
| `hussain_fig1_jet_regions.jpg` / `hussain_fig7_HD.jpg` | 射流三区；*H/D* 窗 | Energies 2021 Fig.1/7 |
| `nepcm_fig1_stagnation.jpg` / `ssh_fig3_chevron.jpg` | 驻点剖面；异形喷嘴换均温 | Energies 2022 / 2024 |
| `e6_fig1_k_compare_v2.jpg` / `e6_fig1_k_compare.jpg` | 金刚石导热位差；片+射流/微通道叠层 | Element Six Fig.1–2 |
| `nano_fig11_future.jpg` | 纳米流体未关闭问题 → 不进 TCS | Energies 2024 Fig.11 |
| `chip_fig13_mmc.jpg` / `chip_fig9_integrated_mc.jpg` | MMC；封装内集成（构型 D） | Energies 2026 |
| `gb200_fig2_generative.jpg` / `gen25d_fig4_temp.jpg` / `multichip_fig4_opt.jpg` | 按 power map 生成流道 | arXiv 三篇 |

完整带图报告：`AI算力芯片液冷冷板技术调查分析报告_v1.3_20260907.html`。

## 建议补下（有订阅或作者稿时）

1. Barewar et al., DOI 10.1016/j.tsep.2023.101697（锚点全文）  
2. Zou et al., DOI 10.12465/issn.0253-4339.20251011001  
3. ITherm 2025 两相微通道 GPU 热沉（IEEE）  
4. Purdue/NSF 两相射流服务器级两篇（PAR 10704495 / 10704496）  
5. OCP ACS 盲插歧管与水基冷却液正式 PDF  
6. MSU：Advances and Future Perspectives of Diamond Microchannel Heat Sinks
