bruce2012lu/AIDCtms_design202609/coolingplate/cad/asm_0921.stp

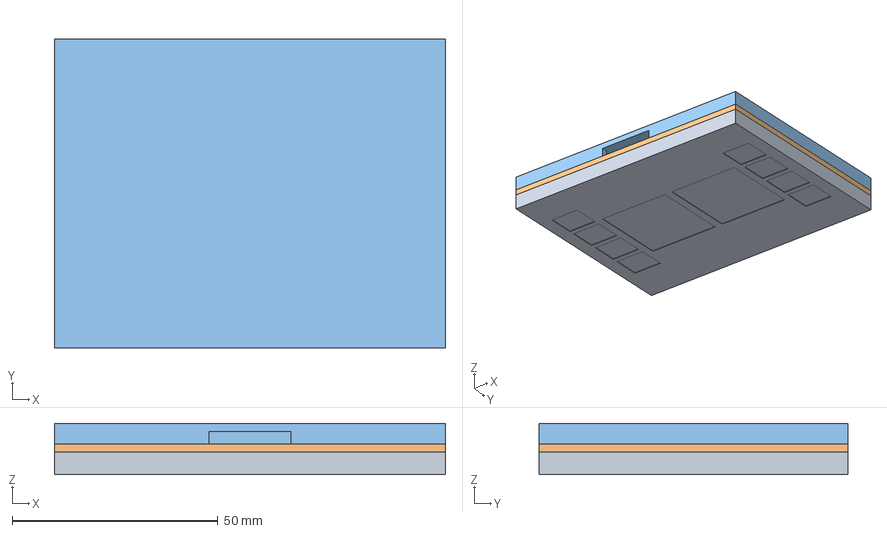
[picture p194: CAD file, 2026-10-02]
coolingplate/cad/asm_0921.stp
95.0 x 75.0 x 12.5 mm
plate
cover1
cover2
