bruce2012lu/AIDCtms_design202609/coolingplate/cad/out/CP-B300-JM-01_assembly.step

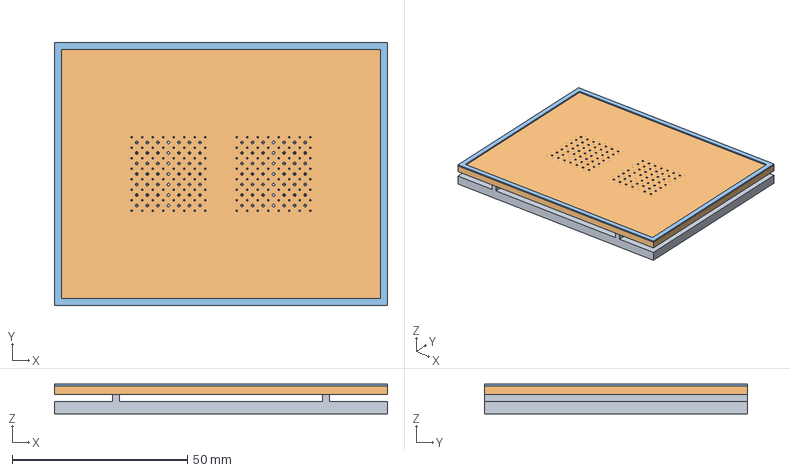
[picture p195: CAD file, 2026-10-02]
coolingplate/cad/out/CP-B300-JM-01_assembly.step
95.0 x 75.0 x 8.50 mm
JM01-100_base_plate
JM01-200_nozzle_plate
JM01-400_seal_frame
