bruce2012lu/AIDCtms_design202609/coolingplate/agent/practice01_0926/cycle-20260926/out/cad/cell_d040_assembly.step

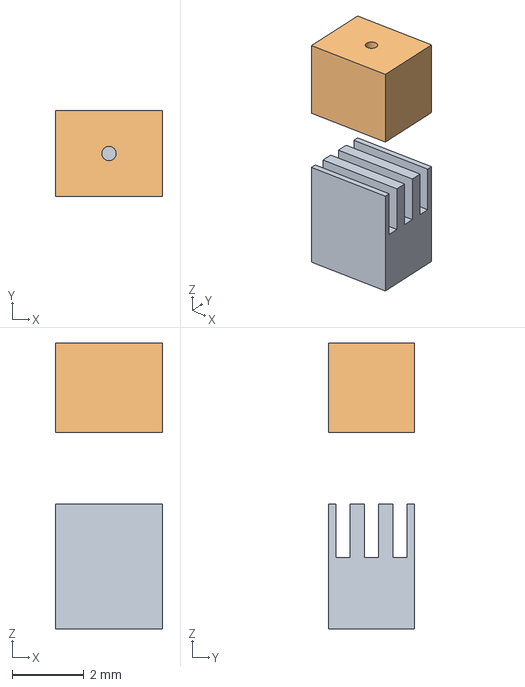
[picture p196: CAD file, 2026-10-02]
coolingplate/agent/practice01_0926/cycle-20260926/out/cad/cell_d040_assembly.step
3.00 x 2.40 x 8.00 mm
