bruce2012lu/AIDCtms_design202609/coolingplate/agent/practice01_0926/cycle-20260926/out/cad/plate_seal.step

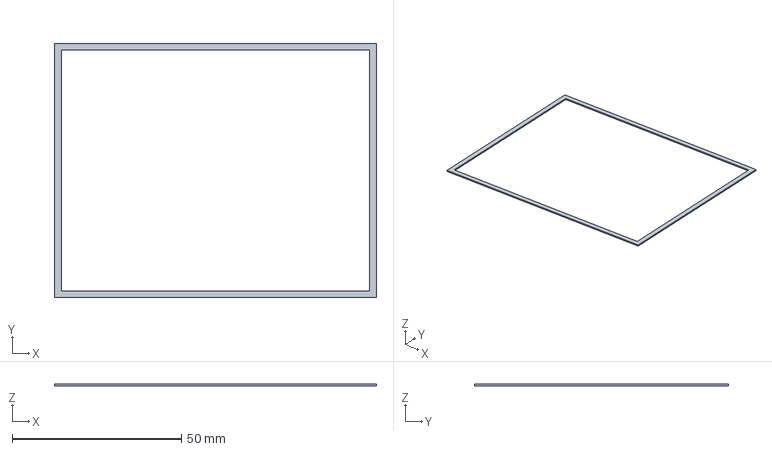
[picture p197: CAD file, 2026-10-02]
coolingplate/agent/practice01_0926/cycle-20260926/out/cad/plate_seal.step
95.0 x 75.0 x 0.5 mm
