bruce2012lu/AIDCtms_design202609/coolingplate/cad/out/asm0921/step_layout/tray_rear.stp

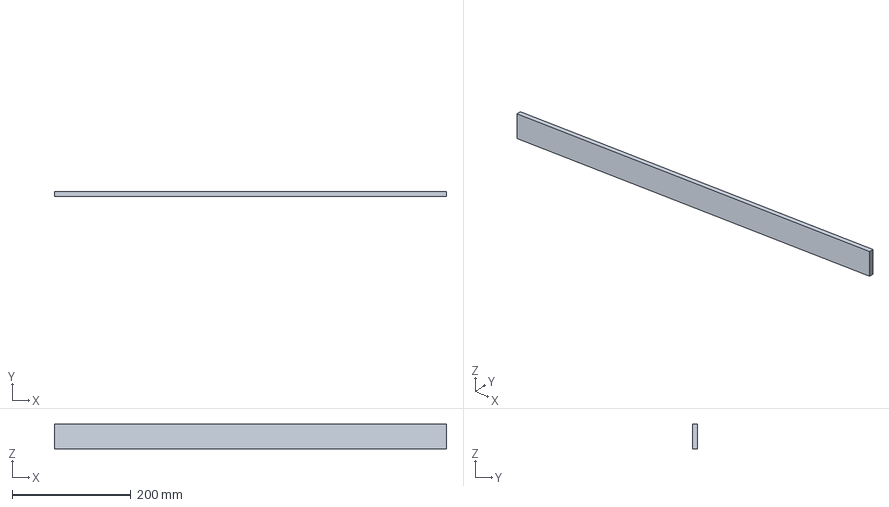
[picture p198: CAD file, 2026-10-02]
coolingplate/cad/out/asm0921/step_layout/tray_rear.stp
660.0 x 8.00 x 42.0 mm
