bruce2012lu/AIDCtms_design202609/coolingplate/cad/out/CP-B300-JM-01_top_view.dxf

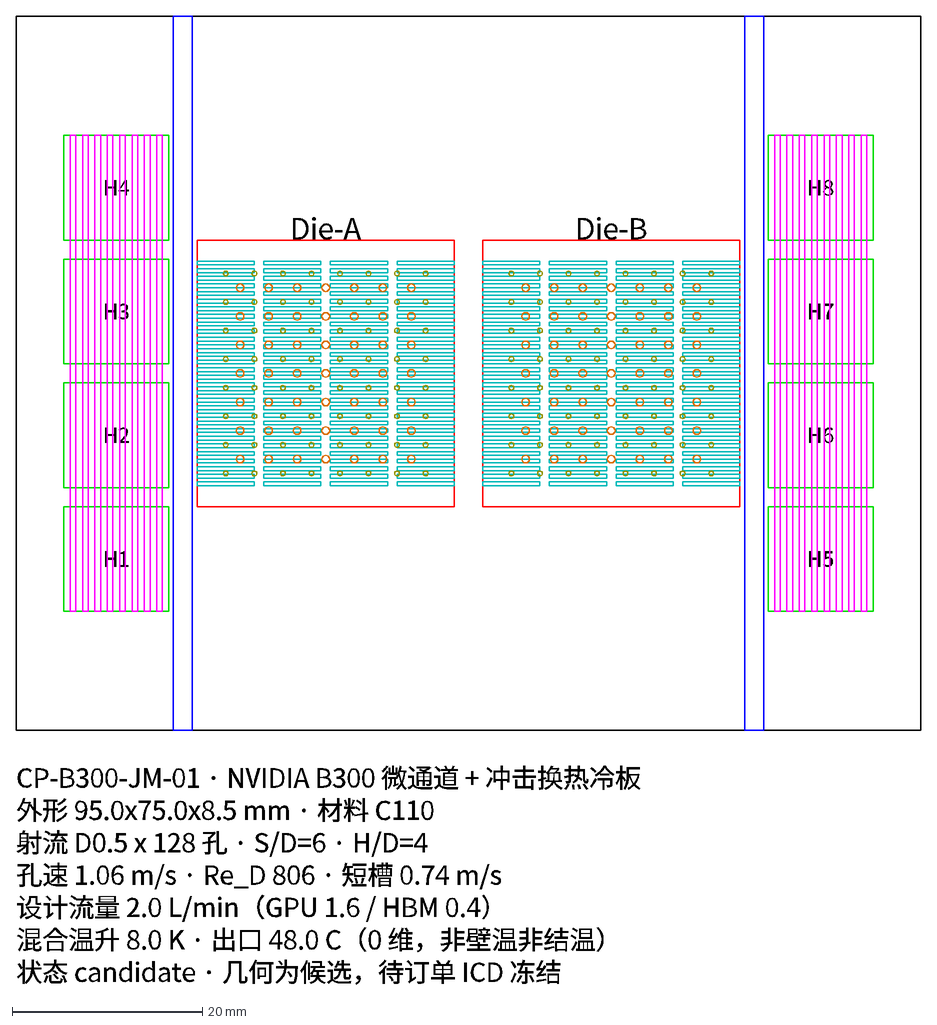
[picture p199: CAD file, 2026-10-02]
coolingplate/cad/out/CP-B300-JM-01_top_view.dxf
Die-A
Die-B
H1
H2
H3
H4
H5
H6
H7
H8
CP-B300-JM-01 · NVIDIA B300 微通道 + 冲击换热冷板
外形 95.0x75.0x8.5 mm · 材料 C110
射流 D0.5 x 128 孔 · S/D=6 · H/D=4
孔速 1.06 m/s · Re_D 806 · 短槽 0.74 m/s
设计流量 2.0 L/min（GPU 1.6 / HBM 0.4）
混合温升 8.0 K · 出口 48.0 C（0 维，非壁温非结温）
状态 candidate · 几何为候选，待订单 ICD 冻结
