bruce2012lu/AIDCtms_design202609/coolingplate/design/out/grace/step/ov_cpu.stp

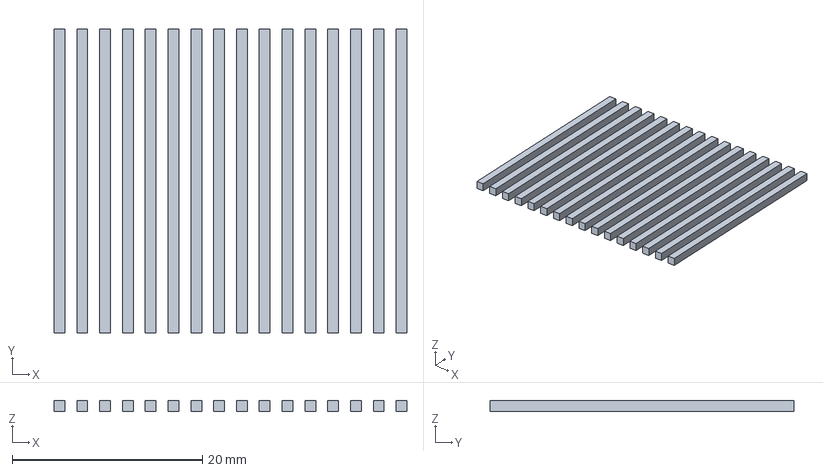
[picture p200: CAD file, 2026-10-02]
coolingplate/design/out/grace/step/ov_cpu.stp
37.2 x 32.0 x 1.20 mm
