bruce2012lu/AIDCtms_design202609/coolingplate/cad/out/asm0921/step_layout/tray_supply.stp

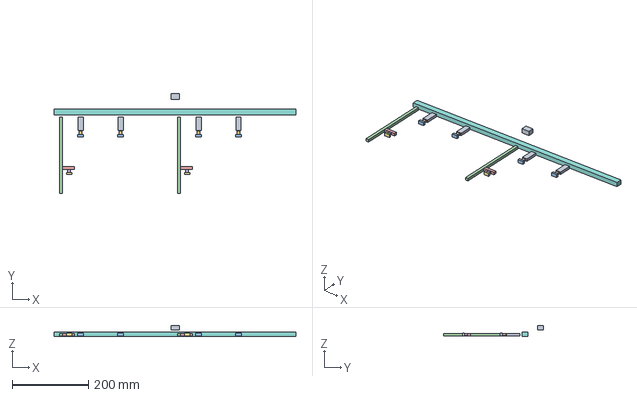
[picture p202: CAD file, 2026-10-02]
coolingplate/cad/out/asm0921/step_layout/tray_supply.stp
636.0 x 262.0 x 30.0 mm
