bruce2012lu/AIDCtms_design202609/coolingplate/design/out/grace/step/ov_base.stp

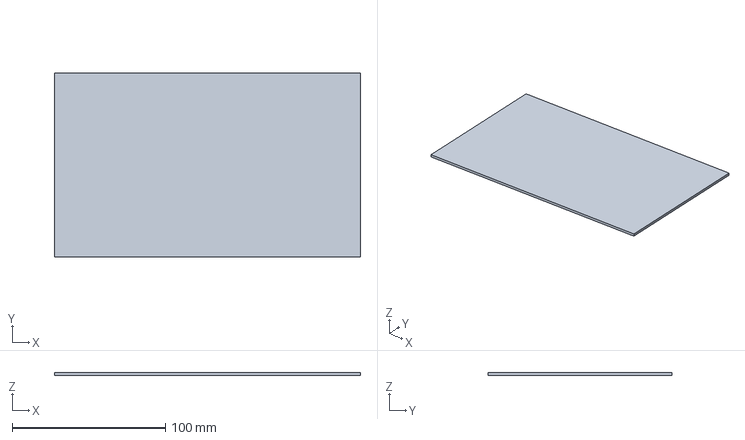
[picture p203: CAD file, 2026-10-02]
coolingplate/design/out/grace/step/ov_base.stp
200.0 x 120.0 x 2.00 mm
