bruce2012lu/AIDCtms_design202609/coolingplate/agent/practice01_0926/cycle-20260926/out/cad/plate_base.step

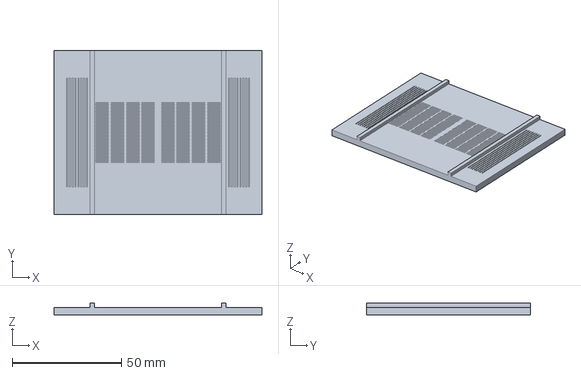
[picture p204: CAD file, 2026-10-02]
coolingplate/agent/practice01_0926/cycle-20260926/out/cad/plate_base.step
95.0 x 75.0 x 5.50 mm
