bruce2012lu/AIDCtms_design202609/coolingplate/cad/out/asm0921/step_layout/tray_pcb.stp

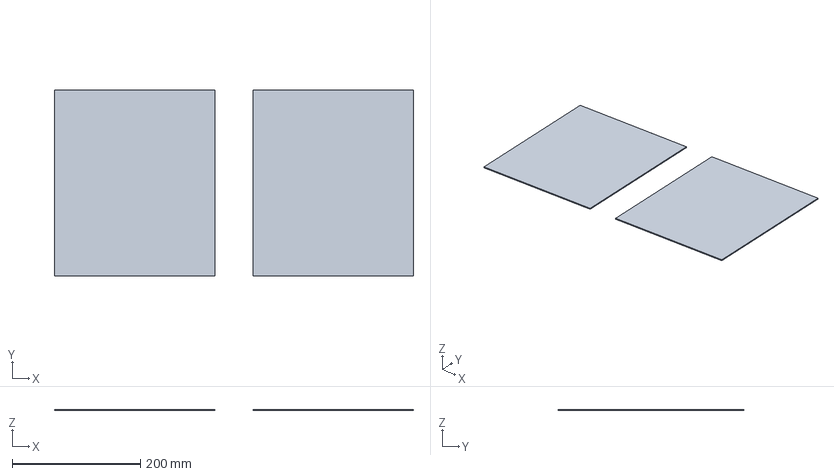
[picture p205: CAD file, 2026-10-02]
coolingplate/cad/out/asm0921/step_layout/tray_pcb.stp
560.0 x 290.0 x 2.00 mm
