bruce2012lu/AIDCtms_design202609/coolingplate/cad/out/asm0921/step_layout/tray_grace.stp

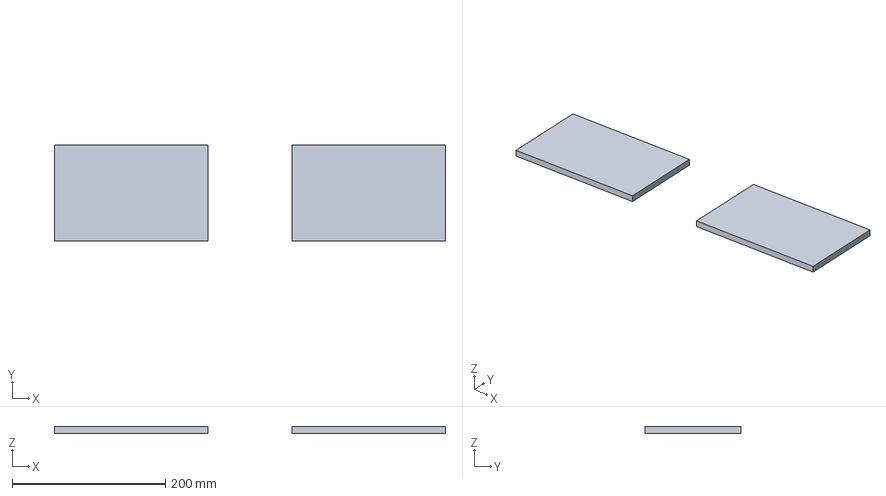
[picture p206: CAD file, 2026-10-02]
coolingplate/cad/out/asm0921/step_layout/tray_grace.stp
510.0 x 125.0 x 9.00 mm
