bruce2012lu/AIDCtms_design202609/coolingplate/design/out/grace/step/cu_floor.stp

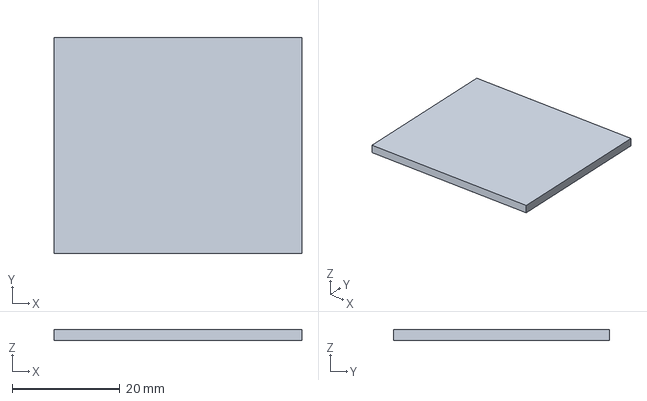
[picture p207: CAD file, 2026-10-02]
coolingplate/design/out/grace/step/cu_floor.stp
46.0 x 40.0 x 2.00 mm
