bruce2012lu/AIDCtms_design202609/coolingplate/cad/out/asm0921/step_layout/tray_return.stp

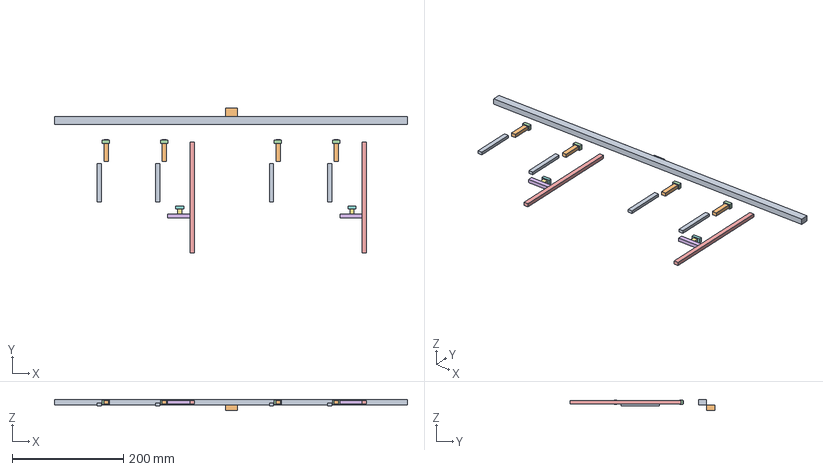
[picture p209: CAD file, 2026-10-02]
coolingplate/cad/out/asm0921/step_layout/tray_return.stp
636.0 x 262.0 x 20.0 mm
