bruce2012lu/AIDCtms_design202609/coolingplate/cad/out/CP-B300-JM-01_JM01-100_base_plate.step

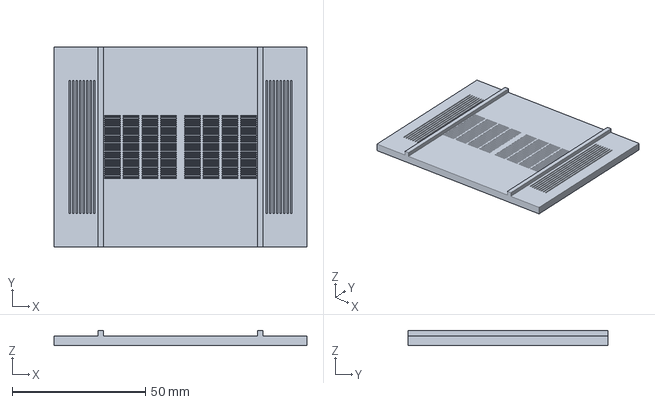
[picture p210: CAD file, 2026-10-02]
coolingplate/cad/out/CP-B300-JM-01_JM01-100_base_plate.step
95.0 x 75.0 x 5.50 mm
