bruce2012lu/AIDCtms_design202609/coolingplate/design/out/grace/step/ov_supply.stp

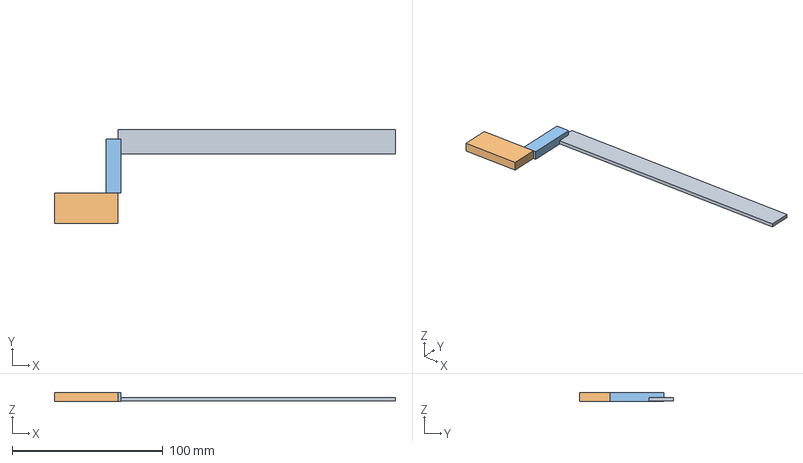
[picture p211: CAD file, 2026-10-02]
coolingplate/design/out/grace/step/ov_supply.stp
226.0 x 62.0 x 6.00 mm
