bruce2012lu/AIDCtms_design202609/coolingplate/cad/out/asm0921/step_layout/tray_gpu.stp

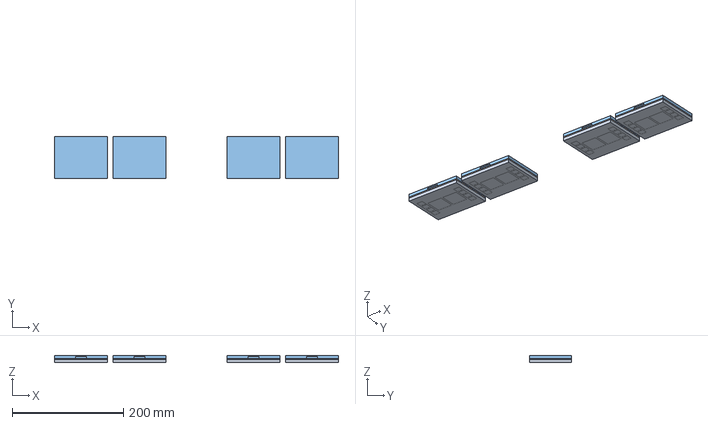
[picture p213: CAD file, 2026-10-02]
coolingplate/cad/out/asm0921/step_layout/tray_gpu.stp
510.0 x 75.0 x 12.5 mm
