bruce2012lu/AIDCtms_design202609/coolingplate/design/out/grace/step/pl_return.stp

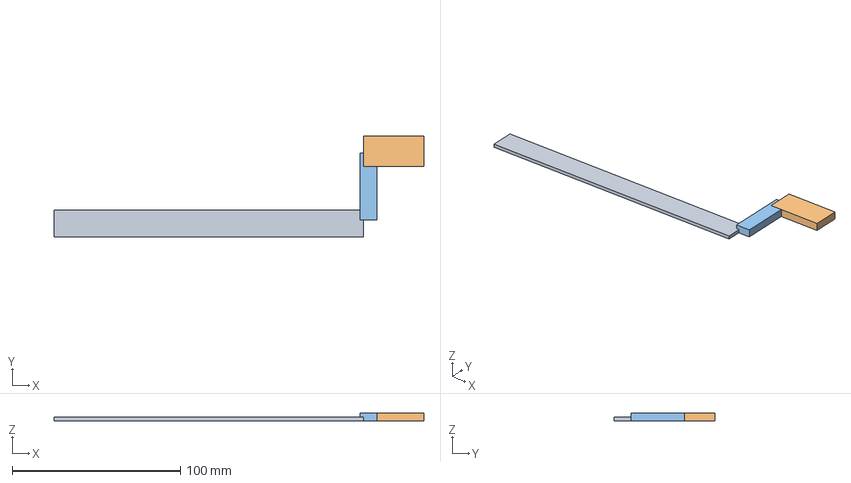
[picture p214: CAD file, 2026-10-02]
coolingplate/design/out/grace/step/pl_return.stp
220.0 x 60.0 x 5.00 mm
