bruce2012lu/AIDCtms_design202609/coolingplate/cad/out/asm0921/step_layout/plate_hbm.stp

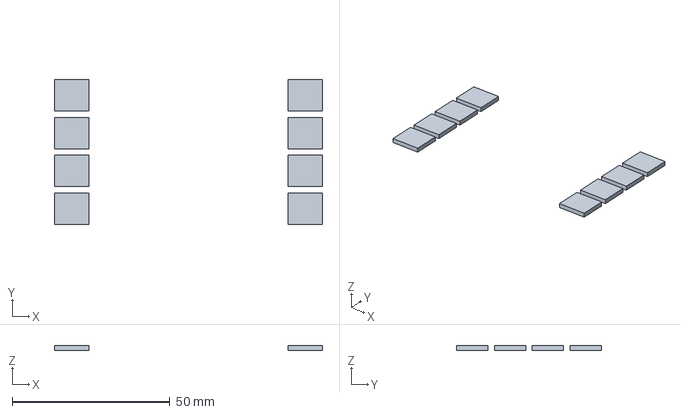
[picture p215: CAD file, 2026-10-02]
coolingplate/cad/out/asm0921/step_layout/plate_hbm.stp
85.0 x 46.0 x 1.60 mm
