bruce2012lu/AIDCtms_design202609/coolingplate/design/out/grace/step/pl_memrib.stp

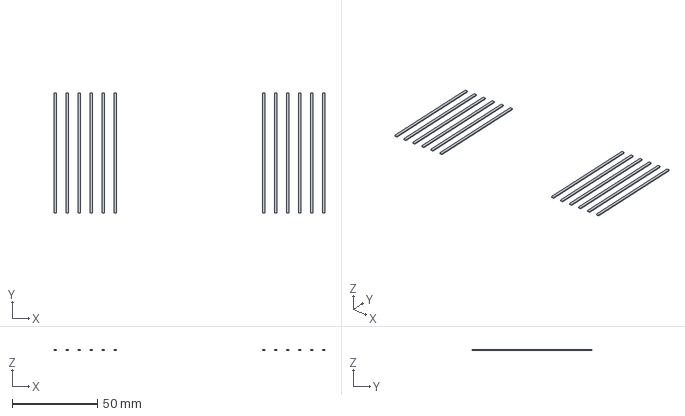
[picture p216: CAD file, 2026-10-02]
coolingplate/design/out/grace/step/pl_memrib.stp
158.6 x 70.0 x 0.8 mm
