bruce2012lu/AIDCtms_design202609/coolingplate/agent/practice01_0926/cycle-20260926/out/cad/cell_d050_lid.step

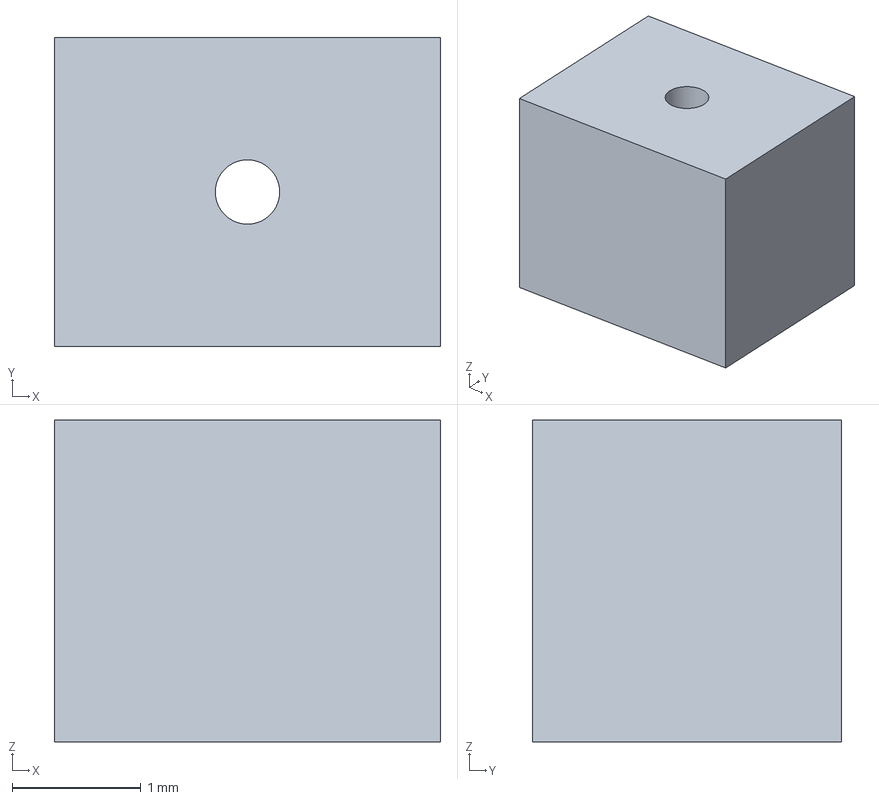
[picture p217: CAD file, 2026-10-02]
coolingplate/agent/practice01_0926/cycle-20260926/out/cad/cell_d050_lid.step
3.00 x 2.40 x 2.50 mm
