bruce2012lu/AIDCtms_design202609/coolingplate/cad/out/asm0921/step_layout/plate_supply.stp

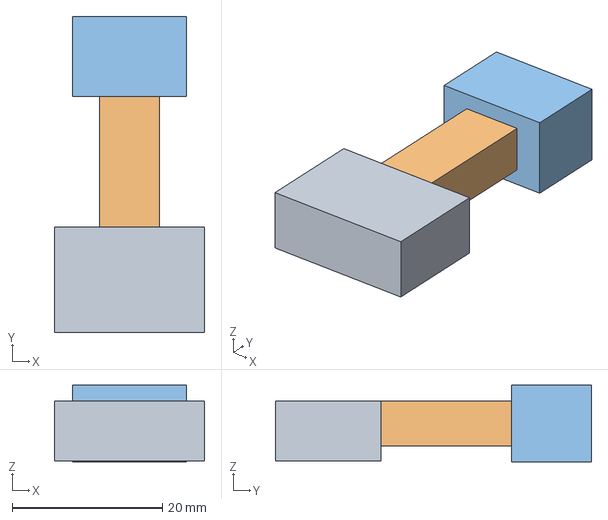
[picture p218: CAD file, 2026-10-02]
coolingplate/cad/out/asm0921/step_layout/plate_supply.stp
20.0 x 42.0 x 10.2 mm
