bruce2012lu/AIDCtms_design202609/coolingplate/cad/out/asm0921/step_layout/plate_pkg.stp

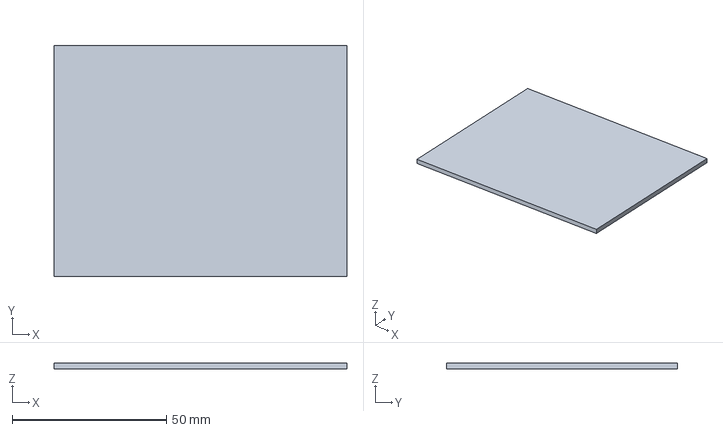
[picture p219: CAD file, 2026-10-02]
coolingplate/cad/out/asm0921/step_layout/plate_pkg.stp
95.0 x 75.0 x 2.00 mm
