bruce2012lu/AIDCtms_design202609/coolingplate/design/out/grace/step/pl_supply.stp

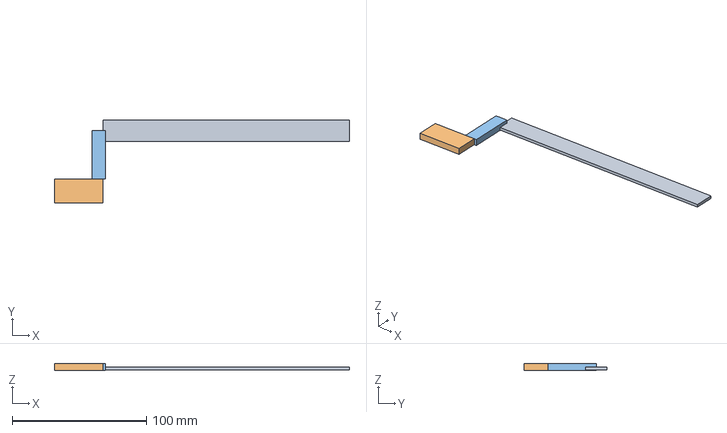
[picture p220: CAD file, 2026-10-02]
coolingplate/design/out/grace/step/pl_supply.stp
220.0 x 62.0 x 5.00 mm
