bruce2012lu/AIDCtms_design202609/coolingplate/cad/out/asm0921/step_layout/plate_die.stp

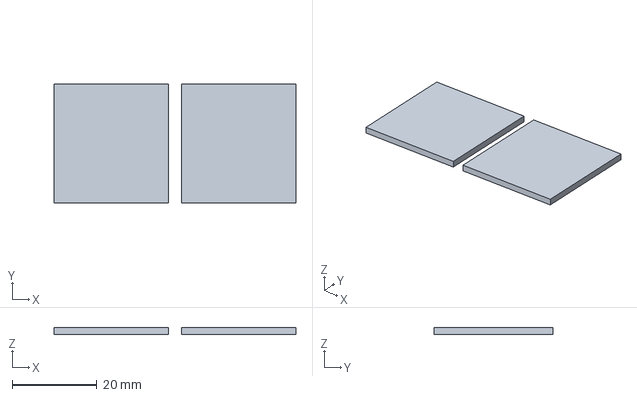
[picture p221: CAD file, 2026-10-02]
coolingplate/cad/out/asm0921/step_layout/plate_die.stp
57.0 x 28.0 x 1.60 mm
