bruce2012lu/AIDCtms_design202609/coolingplate/design/out/grace/step/cu_fins.stp

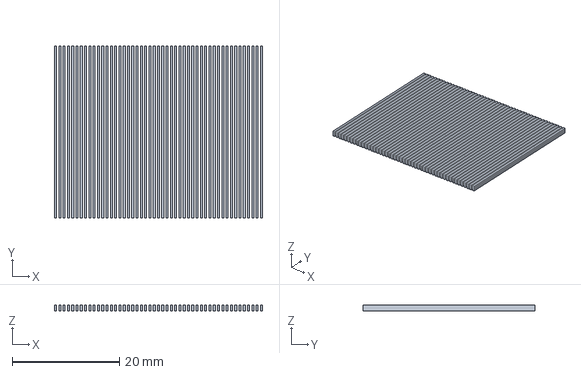
[picture p222: CAD file, 2026-10-02]
coolingplate/design/out/grace/step/cu_fins.stp
38.8 x 32.0 x 1.20 mm
