bruce2012lu/AIDCtms_design202609/coolingplate/cad/out/asm0921/step_layout/plate_return.stp

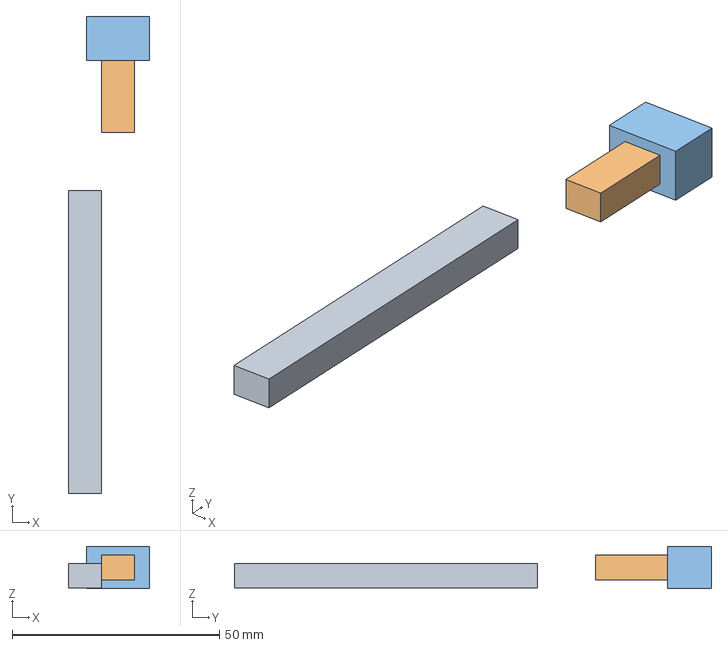
[picture p223: CAD file, 2026-10-02]
coolingplate/cad/out/asm0921/step_layout/plate_return.stp
19.6 x 115.0 x 10.2 mm
