bruce2012lu/AIDCtms_design202609/coolingplate/design/out/grace/step/ov_mem.stp

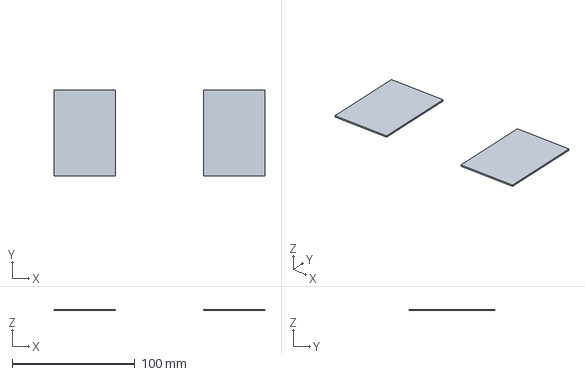
[picture p224: CAD file, 2026-10-02]
coolingplate/design/out/grace/step/ov_mem.stp
172.0 x 70.0 x 1.20 mm
