bruce2012lu/AIDCtms_design202609/coolingplate/design/out/grace/step/ov_die.stp

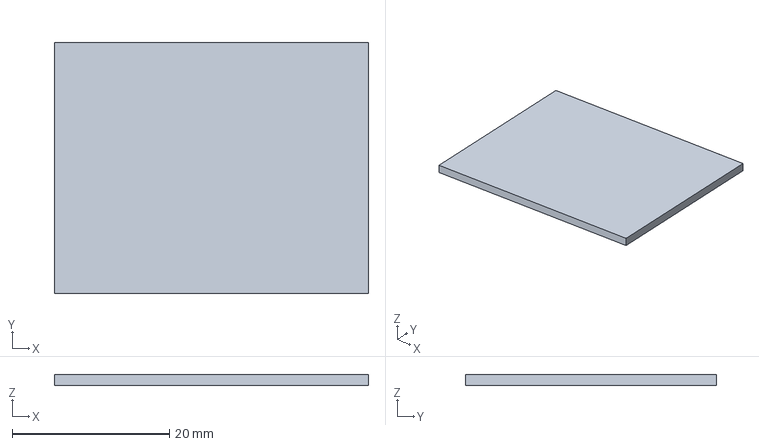
[picture p225: CAD file, 2026-10-02]
coolingplate/design/out/grace/step/ov_die.stp
40.0 x 32.0 x 1.40 mm
