bruce2012lu/AIDCtms_design202609/(list of files, cad)

Other CAD files:
coolingplate/agent/practice01_0926/cycle-20260926/out/cad/plate_assembly.step
coolingplate/agent/practice01_0926/cycle-20260926/out/cad/cell_d050_assembly.step
coolingplate/cad/out/CP-B300-JM-01_JM01-400_seal_frame.step
coolingplate/design/out/grace/step/pl_base.stp
coolingplate/cad/out/CP-B300-JM-01_JM01-200_nozzle_plate.step
coolingplate/cad/out/asm0921/step_layout/plate_cu.stp
coolingplate/design/out/grace/step/ov_return.stp
coolingplate/design/out/grace/step/ov_lid.stp
coolingplate/design/out/grace/step/ov_memrib.stp
coolingplate/design/out/grace/step/ov_pkg.stp
coolingplate/design/out/grace/step/pl_cpu.stp
coolingplate/cad/out/CP-B300-JM-01_assembly.stl
