bruce2012lu/AIDCtms_design202609/coolingplate/design/cfd/uc01b_2.4x3.0lessmesh12cells/UC01b_lessmesh_1D_CFD契合性分析报告_12cells_600step.html

# UC-01b 12 格 lessmesh 一维与 CFD 契合性分析

文档编号：AIDC-B300-CFD-UC01b-12Y-CMP-600。日期：2026-09-27。对照记录。设计点仍是 216 孔、q''=579282 W/m²、单孔 ṁ=1.225×10⁻⁴ kg/s。本页 CFD 是 Y 向 12 格、28,005,504 HEXA、iter 600、二阶格式。

相对差 = (CFD − 1D) / 1D。定义相同且约在 ±20% 内，记为接近。定义不同，记为不可比。Re<2000、以及和单胞不是同一条出口路径的量，标为限制。

iter 600 是二阶迎风。一阶场在 iter 300。两份都单独成页。。单胞 iter 380 的 TIM 底 341.38529 K、ΔP 1087.09 Pa、能量比 1.0015 只作参照，不作为本场结果。return_slot 在本场是绝热壁，出口是 outlet_y_front 和 outlet_y_back。

## 1. 口径

项 | 一维 / 设定 | 写入 Fluent 的值
孔数 | 每颗 108，两颗 216 | 网格是沿 Y 的 12 个单孔单元。进口 inlet_jet_01…12，每孔面积约 1.26×10⁻⁷ m²，D=0.40 mm
单孔流量 | 0.007407 L/min = 1.225×10⁻⁴ kg/s | 每个 inlet_jet_* 都是这个值。12 孔合计 1.470×10⁻³ kg/s，没有乘 216
热流 | 216 孔名义值加 5%，579282 W/m² | wall_heat 面积加权 579282 W/m²
槽向 | 单胞 Y=2.4 mm | 12×2.4 mm，Y 从 −14.4 mm 到 +14.4 mm。X 仍是 3.0 mm。孔心在每一格的局部中心
入口温度 | 313.15 K | 面积加权 313.14999 K
出口 | 压力出口表压 0，回流 313.15 K | 压力出口是 Y 两端。return_slot 与 return_slot:096 为壁面，热流 0。单胞报告里的出口是 return_slot，路径不同
网格 | — | 28005504 HEXA。边界层首层 2.5 μm、7 层。格与格之间为 interface。交界半肋改为 0.05 mm 均匀网格
格式 | — | 二阶。压力为二阶，动量、k、ω、温度为二阶迎风。这一切换发生在 iter 300 写盘之后。。单精度，4 进程，-gpgpu=1 只加速耦合 AMG

P_cell = 579282×7.20×10⁻⁶ = 4.17083 W。12 格 P_12 = 50.04996 W。两 die 按 216 孔：P_2die = 900.899 W。

一维孔口静压用 K=1.8：ΔP = 1.8×½ρU²。U=0.9825 m/s，Re_D=597，ΔP_1D=862.0 Pa。这条公式不含槽和 Y 向汇流。

## 2. 对照

项目 | 1D / 设定 | CFD iter 600 | 相对差 | 判断
入口温度 | 313.15 K | 313.14999 K | -0.000% | 契合
单孔 ṁ | 1.225×10⁻⁴ kg/s | 12 孔入口合计 0.00147002 kg/s，平均每孔 0.00012250 kg/s；Y 出口合计 0.00147004 kg/s | 每孔 +0.0013%；出口比入口 +0.00140% | 契合。质量守恒
热流 | 579282 W/m² | wall_heat 579282 W/m² | 0 | 契合
孔径 | D=0.40 mm | 圆孔 D=0.40 mm，28,005,504 HEXA | 0 | 契合
U | 0.9825 m/s | 入口 1 面积加权 0.98278 m/s | +0.029% | 契合
Re_D | 597 | 597.3 | +0.05% | 契合。限制： <2000，不用 Martin h
静压 ΔP | 孔口 K=1.8：862 Pa | 12 孔入口静压平均 1099.99 Pa，出口约 0，ΔP = 1099.99 Pa。单胞 iter 380 是 1087.09 Pa | +27.6% | 超出约 ±20%。一维几乎只有孔口；这条 12 格带还有槽、回液缝，以及沿 Y 汇到两端出口的沿程
能量温升 | P_cell/(ṁ cp)=8.147 K，出口 bulk 321.297 K | 两个 Y 出口按质量加权 321.597 K，温升 8.447 K。面积加权净 321.486 K | bulk 温升 +3.68% | 接近。ṁ_out·cp·ΔT / P_12 = 1.0368。出口面积小，面积加权和质量加权几乎相同
R(T_TIM−T_in) | 一维不从共轭场取 TIM 底 | 342.049 K。按 216 孔 0.03208 K/W。单胞 iter 380 是 0.031341 K/W | 不可比 | 已含固体，不加 R_TIM2、R_wall
R_conv | Martin 在 Re≈597 不适用 | (326.870−313.15)/900.899 = 0.01523 K/W | 不可比 | 不是湿面局部 h
R_c-in | R_TIM2+R_wall 仍是假设 | 0.02262–0.02662 K/W（叠在本次 R_conv 上） | 不可与 Martin 带比 | 假设叠加
R_j-in | 再加 R_pkg 0.008–0.012 | 0.03062–0.03862 K/W | 假设叠加 | 这是封装平均结温，不是芯片几何中心。设计未关闭

## 3. 差从哪里来

压降 CFD 比孔口一维高 238 Pa（+27.6%）。流量对应的孔口损失是 862 Pa。本场流体还要经过冲击、槽、回液缝，再沿 Y 汇到两端压力出口，所以孔口公式偏低。单胞 iter 380 的出口在 return_slot，ΔP 是 1087.09 Pa；本场 12 个入口平均 1099.99 Pa，两端孔低于中间孔，因为中间孔到 Y 出口的沿程更长。这是路径不同，不是残差没收敛。

质量加权出口温度 321.597 K。入口合计 0.00147002 kg/s，出口合计 0.00147004 kg/s，相对差 +0.00140%。ṁ_out·cp·ΔT = 51.8929 W，P_12 = 50.0500 W，比值 1.0368。单胞同一口径是 1.0015。本场比值离开 1 更多，写盘时两个出口仍有约 2.3% 面积回流，回流温度按 313.15 K 计，会改变质量加权。

TIM 底 342.049 K，单胞 iter 380 是 341.385 K。12 格不是周期单胞：Y 两端是出口和绝热固体端面，铜可以沿 Y 导热，所以底面不再像单胞那样只有 0.02 K 的面内温差。热阻仍按 216 孔功率来写，才能和单胞的 0.031341 K/W 放在一起看。Re_D<2000，R_c-in 和 R_j-in 还叠着假设的 R_TIM2、R_wall、R_pkg。

## 4. 不用的数

不用 iter 601–645。主计算在 645 步附近被停下，那一段没有写 case data。不用 i400、i500 当作本页结果；它们和 i600 一样是二阶场，本页只收 iter 600。不用把 return_slot 再当成压力出口。不用 Martin 关联式。单胞 iter 380 的 341.385 K 和 1087.09 Pa 留在第 3 节作参照。R_pkg 不能推出芯片几何中心的最高温度，只能给封装平均结温。
