bruce2012lu/AIDCtms_design202609/coolingplate/agent/practice01_0926/cycle-20260926/04_结构工艺装配.html

流程1 一维2 三维 CAD3 单孔 CFD4 结构工艺装配

# 4 · 三维结构、工艺与装配

CP-B300-JM-01 · 设计循环 2026-09-26 · 一维来自 design/calc/model.py

结构分析用 model.mech_checks：3 bar 表压下的两端固支板条，退火铜屈服取 70 MPa，弹性模量 110 GPa。这是送样前的解析筛选，不是 Mechanical 全场应力。

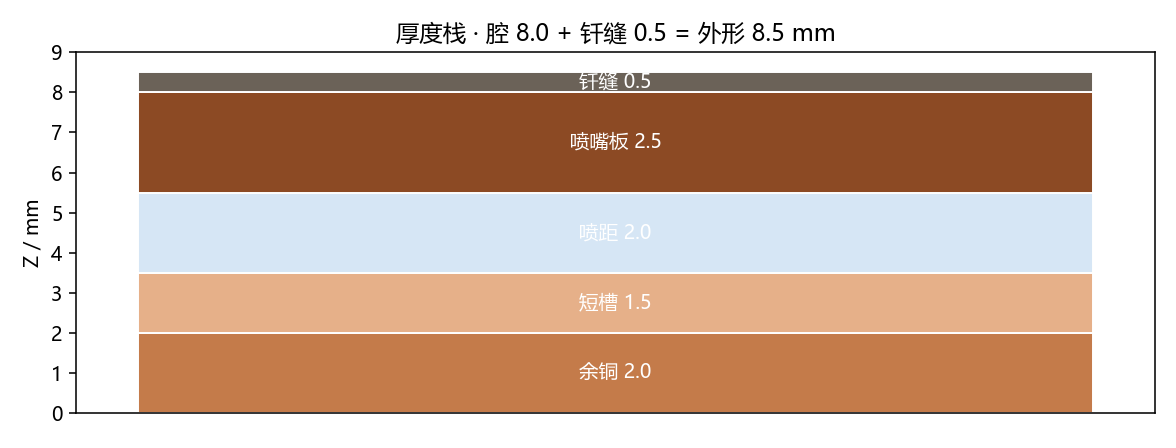
[picture p287: coolingplate/agent/practice01_0926/cycle-20260926/out/fig_stack.png]
厚度栈


## 承压

板条 | 应力 / MPa | 挠度 / μm | 屈服安全系数
余铜跨槽（跨 0.8 mm，t=2.0 mm） | 0.02 | 0.000 | 2917
盖板跨射流阵（跨 26 mm，t=2.5 mm） | 16.73 | 2.650 | 4
盖板跨 HBM 区（跨 11 mm，t=2.5 mm） | 2.90 | 0.080 | 24

估算铜质量约 442 g（包络体积填充率 82%，密度 8900 kg/m³）。盖板跨射流阵的跨距取阵面较大边，偏保守。

## 工艺

零件 | 路线
底板 | 紫铜 C11000 / TU1。余铜和外形 CNC。GPU 槽以铲齿或铣槽，深宽比 1.5/0.40 = 3.75，低于倒齿上限 5。齿壁 0.40 mm。
喷嘴板 | 机械微钻 D0.50，高于 0.30 mm 下限。系统过滤按最小孔径的 1/10，即不粗于 50 μm；现参数集写的是 25 μm。
钎缝 | 量产真空钎焊。焊前设阻流，焊后精铣接触面。平面度目标 0.05 mm，接触面 Ra 0.8 μm。
送样 | 螺接加密封圈，便于拆开看流道。内部隔肋贴合要单独做分区流阻，只测整板压降看不出内部短路。

激光焊或摩擦焊只能封外圈，封不到隔离肋，不能单独作为密封方案。整板金属打印不是出货路线。

## 装配

顺序 | Z / mm | 件
1 | 0–3.5 | 底板，芯片面在 z=0
2 | 3.5–5.5 | 喷距空腔。隔离肋在此高度把 GPU 横流隔开，并填到喷嘴板
3 | 5.5–8.0 | 喷嘴板。216 孔对准两颗 die
4 | 8.0–8.5 | 周边钎缝框

总装目标包围盒 95 × 75 × 8.5 mm。水嘴、UQD 和盖板静压箱不在这套实体里，装机前要另做接口。芯片朝下时，进液边朝托盘后面板；四块 GPU 冷板的串并联仍等水力 ICD。

和实测 asm_0921（12.5 mm 三层、128×D0.50、带静压箱）不是同一套结构。asm_0921 继续只作结构证据，不覆盖本轮一维几何。
