bruce2012lu/AIDCtms_design202609/coolingplate/design/calc/build_out.txt

宸插啓鍑? D:\agents2026\agents2026\agents\AIDCtms\coolingplate\design\NVIDIA_B300_寰€氶亾鍐插嚮鎹㈢儹鍐锋澘璁捐鎶ュ憡_v2.0_20260914.html
澶у皬: 322.8 KB
绔犺妭鏁? 16銆€琛ㄦ牸鏁? 59銆€鍐呭祵 SVG: 21銆€浣嶅浘: 5
