bruce2012lu/AIDCtms_design202609/coolingplate/design/calc/validate_out.txt

======================================================================
1. 鍥剧墖閾炬帴
======================================================================
  OK   assets/src/gb200_fig1_layout_heatflux.jpg
  OK   assets/src/hussain_fig1_jet_regions.jpg
  OK   assets/src/hussain_fig7_HD.jpg
  OK   assets/principle-skived-fin.png
  OK   assets/src/sciopen_fig8_fmhs.jpg
  鍏?5 寮狅紝缂哄け 0

======================================================================
2. 鏍囩閰嶅
======================================================================
  html         open=    1 close=    1
  head         open=    1 close=    1
  body         open=    1 close=    1
  header       open=    1 close=    1
  nav          open=    1 close=    1
  main         open=    1 close=    1
  footer       open=    1 close=    1
  section      open=   16 close=   16
  table        open=   59 close=   59
  thead        open=   59 close=   59
  tbody        open=   59 close=   59
  tr           open=  465 close=  465
  td           open= 1938 close= 1938
  th           open=  290 close=  290
  figure       open=    5 close=    5
  figcaption   open=    5 close=    5
  svg          open=   21 close=   21
  div          open=   60 close=   60
  p            open=   47 close=   47
  ul           open=    4 close=    4
  ol           open=    7 close=    7
  li           open=   51 close=   51
  dl           open=    0 close=    0
  h2           open=   16 close=   16
  h3           open=   75 close=   75
  h4           open=    6 close=    6
  code         open=   49 close=   49
  strong       open=  262 close=  262
  span         open=  146 close=  146
  defs         open=   16 close=   16
  text         open=  467 close=  467
  marker       open=   40 close=   40
  pattern      open=    3 close=    3
  g            open=    0 close=    0

======================================================================
3. 閿氱偣
======================================================================
  瀵艰埅閿氱偣鍏ㄩ儴鍙揪
  id 鎬绘暟 27

======================================================================
4. 娈嬬暀鍗犱綅绗?/ 寮傚父鍊?
======================================================================
  鏃犳畫鐣?

======================================================================
5. 鍏抽敭鏁板€间竴鑷存€э紙涓?model.py 瀵圭収锛?
======================================================================
  DP-A 鍔熺巼              1100 W  鍑虹幇 17 娆? OK
  澹?杩涙恫涓嬬晫               0.0202  鍑虹幇 8 娆? OK
  澹?杩涙恫涓婄晫               0.0355  鍑虹幇 6 娆? OK
  娴佷綋娓╁崌                   7.96  鍑虹幇 8 娆? OK
  瀛旈€?                   1.061  鍑虹幇 3 娆? OK
  瀛旈浄璇烘暟                    806  鍑虹幇 16 娆? OK
  HBM 娴侀€?               0.463  鍑虹幇 3 娆? OK
  闈㈢Н鏀惧ぇ                   4.25  鍑虹幇 3 娆? OK
  鑲嬫晥鐜?                  0.943  鍑虹幇 5 娆? OK
  R_wall               0.0034  鍑虹幇 6 娆? OK

======================================================================
6. 绔犺妭瀹屾暣鎬?
======================================================================
  OK   璁捐鐩爣
  OK   鑺墖瑙勬牸鏁版嵁
  OK   璁捐杈撳叆
  OK   璁捐娴佺▼
  OK   鎬ц兘璁捐
  OK   鏈烘璁捐
  OK   鍘熺悊鍥?
  OK   CAD 鍥剧焊
  OK   涓€缁存€ц兘璁＄畻
  OK   涓夌淮浠跨湡闇€姹?

======================================================================
鑷閫氳繃銆傛枃浠?NVIDIA_B300_寰€氶亾鍐插嚮鎹㈢儹鍐锋澘璁捐鎶ュ憡_v2.0_20260914.html锛?22.8 KB
鍐呭祵 SVG 21 涓紝琛ㄦ牸 59 涓紝浣嶅浘 5 寮?
