bruce2012lu/AIDCtms_design202609/Bp/temp/research-validation-pack/state.md

# research-validation-pack｜本轮研究状态

> 建立：2026-09-05
> 目的：为《算力冷却_验证与决策包_v1.0_20260905.html》提供可复算的证据与计算底稿
> 前序：`temp/research-compute-cooling-report/`（已从工作区删除，仍在 git HEAD 中；本轮通过 `git show HEAD:<path>` 读取，未改动其删除状态）

## 本轮的定位

前两轮已裁决 `SUFFICIENT`：公开渠道无法闭环 CDU 裸机成交价、四 SKU BOM、客户转化率与责任额度。因此本轮**不做泛化搜索**，只做两件事：

1. **定向补证三类实证锚点**（上市公司液冷毛利率与收入结构、价格趋势证据、责任与保险实践）；
2. **把四个未验证缺口转化为条件化、可验证、可执行的约束条件**（不预测，只倒推约束与判定阈值）。

## 文件索引

| 文件 | 内容 | 支撑主交付章节 |
|---|---|---|
| `findings/evidence-01-margin-anchors.md` | 21 项毛利率锚点台账；A1（曙光冷板 10.36%）的口径边界警示；对倒推模型的直接含义 | 第 1.2、1.3、3.6 章 |
| `findings/evidence-02-price-trend-and-liability.md` | 8 项降价压力信号（含"无价格时间序列"的否定裁决）；单位容量价格折算；9 项责任惯例；7 项漏液损失量级证据；保险承保与除外清单 | 第 1.4、1.5、4.1–4.5 章 |
| `findings/model-03-reverse-price-liability-cash.md` | 全部参数、公式、依据分级、逐项复算记录、模型失效条件 | 第 3、4、5、7 章 |
| `findings/recalc-04-verification.py` | HTML 结构/编码/锚点/重复 ID/表格列数校验 + 165 项数值独立复算 | 全文 |
| `findings/recalc-04-output.txt` | 上述脚本的执行结果（全部 OK，退出码 0） | — |
| `findings/recalc-05-structure-check.py` | CSS 类完整性 + Markdown 工具包表格/围栏/编码校验 | 工具包 |
| `findings/recalc-05-output.txt` | 上述脚本的执行结果（无未定义类、无未使用类、全部 Markdown OK） | — |

## 本轮补证的成败

| 目标 | 结果 | 置信度 |
|---|---|---:|
| 上市公司液冷毛利率与收入结构 | **成功**——4 家公司一手年报共 18 项毛利率，含唯一的纯冷板式液冷产品毛利率 | 0.90 |
| 同规格产品价格时间序列 | **失败（如实记录）**——无数据。取得 8 项方向性信号，其中 3 项一手 | 0.88（对否定结论本身） |
| 产品责任与保险实践 | **部分成功**——条款结构可证（含 1 份 SEC 申报原件）；额度普遍脱敏 | 0.85 / 0.55 |

## 最重要的三个新发现

1. **A1 = 10.36%**（曙光数创 2025 年冷板液冷产品毛利率，可独立复算并完全自洽），且 2026 H1 冷板收入 +290% 的同时归母净利 −7,340 万元、经营现金流 −2.42 亿元——**趋势向下，不是地板**。
2. **三家公司独立交叉验证：毛利在海外与服务里，不在国内裸设备里**。英维克境外 52.64% vs 境内 23.83%；申菱解决方案及服务 31.63% vs 设备 21.46%；曙光服务 51.02% vs 冷板产品 10.36%。
3. **两个运营商包价样本折算为元/kW 后收敛在 4.4% 以内**（684.75 / 715.00），首次使"价格上限"可以进入约束条件计算；而同边界成本下界为 840 元/kW——**价格可行域与国内运营商采购上限不重叠**。

## 纪律遵循

- 全部倒推回答"必须达到什么"，不回答"将会达到什么"；未把任何倒推结果写成预测。
- 未恢复任何此前删除的伪精确点值（市场份额、部件价值占比、通用毛利率、CDU 静态 ASP、SAM/SOM 亿元点值）。
- 全部参数标注依据分级（实绩／机构估计或第三方模型／三级待核／纯假设或推导／无数据）与 `confidence`、`valid_until`。
- 三级来源（责任上限 10%–20%、性能 LD 10%–15%、年降 5%–8%、海外 200–240 美元/kW、基板 3.5–5.0 万美元）全部保留等级标注，未写成行业事实，且已列入待替换清单。
- 倒推结论对项目不利（所需毛利率高于国内行业实证水平 4–27 个百分点）已如实呈现，并给出含"不进入"的五个应对选项。
- 未修改任何既有 HTML 报告与 BP（已用 `git hash-object` 校验与 HEAD 字节一致）；未提交 Git；未改动前序研究底稿的删除状态。

## 有效期与复核触发

- `valid_until: 2026-12-31`（价格与现金参数）／`2027-03-31`（责任结构）
- `invalidate_if:`
  - 四 SKU 书面报价取得（将替换 BOM 假设，第一优先）
  - 任一官方 CDU 分项中标价或合同价公开
  - 客户书面责任条款或付款条款取得
  - 曙光数创披露 2026 年冷板液冷产品分项毛利率
  - 英维克／申菱首次披露液冷专项收入或毛利
  - Ecolab／Eaton 首次披露 CoolIT／Boyd 独立液冷收入与利润
