bruce2012lu/AIDCtms_design202609/Bp/temp/research-validation-pack/findings/evidence-01-margin-anchors.md

# 证据 01｜上市公司披露的液冷相关毛利率锚点

> 取证时点：2026-09-05
> 取证范围：本轮只采纳公司正式披露（年报／半年报／季报／业绩公告）。集团整体毛利不得冒充液冷毛利。
> 用途：作为"缺口二（价格倒推）"的实证对照基准。
> 总体置信度：**0.90**（一手年报数据本身置信度 0.95+；口径归属判断置信度 0.88）

---

## 1. 结论先行

1. **公开渠道能拿到的唯一"纯冷板式液冷"产品毛利率是曙光数创的 10.36%（2025 年度）。** 该数字来自年报"按产品分类分析"表，`营业收入 298,639,495.45 − 营业成本 267,702,360.46 = 30,937,134.99`，除以收入得 **10.3594%**，与年报披露的 10.36% 完全自洽。这是全案最重要的实证锚点。`confidence: 0.95`
2. **同一家公司 2026 年上半年进一步恶化。** 冷板液冷收入同比 +290.09%、成为主要收入来源，但公司整体转为亏损：半年报营业收入 2.4594 亿元（+75.56%）、归母净利润 **−7,340 万元**（上年同期 −4,077 万元）、经营现金流净额 **−2.42 亿元**。冷板收入放量与亏损扩大同时发生。`confidence: 0.92`
3. **横向三家公司的一手披露指向同一个方向：毛利在"海外"和"服务/解决方案"里，不在"国内裸设备"里。** 这是本轮最有决策价值的新发现，且三家互相独立验证：
   - 英维克 2025：境外毛利率 **52.64%** vs 境内 **23.83%**（差 28.81 个百分点）
   - 申菱环境 2025：解决方案及服务毛利率 **31.63%** vs 设备 **21.46%**（差 10.17 个百分点）
   - 曙光数创 2025：服务毛利率 **51.02%** vs 冷板液冷产品 **10.36%**（差 40.66 个百分点）；境外 37.83% vs 西部 10.38%
   `confidence: 0.90`
4. **海外可比公司的"数据中心冷却"分部毛利在 20% 出头，且在扩产期下降。** Modine 数据中心分部 FY2027Q1（截至 2026-06-30 季度）毛利率 **20.2%**，同比 −960bp（上年 29.8%）；公司归因于北美扩产费用、供应链导致的生产低效、材料成本上升和质保费用上升。该分部含 chiller/CRAH 等设施侧产品，**不是纯液冷**。`confidence: 0.94`
5. **没有任何公司披露"纯 CDU 毛利率"。** Vertiv、Schneider、nVent、Ecolab/CoolIT、Eaton/Boyd 均未披露液冷收入或液冷毛利；台系（奇鋐、双鸿）明确不拆液冷收入，只能观察集团毛利 28%–33%。因此"CDU 毛利 40%–60%"在公开渠道**没有任何一手支持**，此前的删除决定应予维持。`confidence: 0.95`

---

## 2. 锚点台账

| ID | 公司／分部 | 期间 | 口径边界 | 是否纯液冷 | 毛利率 | 同比 | 来源等级 | 置信度 |
|---|---|---|---|---|---:|---:|---|---:|
| A1 | 曙光数创／**冷板液冷产品** | 2025 年度 | 产品口径；含冷板套件、液冷机柜、封闭通道、竖直分液单元、液冷换热单元、室外冷却设备、预制化管路；**服务另列** | **是（冷板式）** | **10.36%** | −15.48pct | 一级（年报） | 0.95 |
| A2 | 曙光数创／浸没液冷产品 | 2025 年度 | 产品口径 | 是（浸没） | 36.49% | −13.52pct | 一级（年报） | 0.95 |
| A3 | 曙光数创／模块化产品 | 2025 年度 | 产品口径 | 否 | 23.96% | +4.49pct | 一级（年报） | 0.95 |
| A4 | 曙光数创／配套产品 | 2025 年度 | 产品口径 | 部分 | 16.03% | +6.36pct | 一级（年报） | 0.95 |
| A5 | 曙光数创／**服务** | 2025 年度 | 服务口径；收入仅 762 万元 | 液冷相关服务 | **51.02%** | −25.05pct | 一级（年报） | 0.95 |
| A6 | 曙光数创／集团 | 2025 年度 | 集团 | 否 | 25.65% | −4.45pct | 一级（年报） | 0.95 |
| A7 | 曙光数创／分地区 | 2025 年度 | 北部／东部／西部／南部／境外 | 混合 | 30.49% / 14.71% / 10.38% / 23.86% / **37.83%** | — | 一级（年报） | 0.95 |
| A8 | 曙光数创／集团 | 2026 H1 | 集团；冷板收入占比显著提高 | 否 | **约 11.93%**（转述，待原件） | −7.56pct（转述） | 三级（财经媒体转述公司披露） | **0.70** |
| A9 | 英维克／**机房温控节能产品** | 2025 年度 | 含风冷（机房空调、列间、蒸发冷）与液冷；**不是纯液冷** | 否 | 28.36% | +1.39pct | 一级（年报） | 0.93 |
| A10 | 英维克／机柜温控节能产品 | 2025 年度 | 储能／通信机柜温控 | 否 | 27.24% | −4.24pct | 一级（年报） | 0.93 |
| A11 | 英维克／**分地区** | 2025 年度 | 境内 vs 境外，全产品混合 | 否 | 境内 **23.83%** / 境外 **52.64%** | −1.44pct / +3.17pct | 一级（年报） | 0.93 |
| A12 | 英维克／精密温控节能设备 | 2025 年度 | 行业口径 | 否 | 27.86% | −0.89pct | 一级（年报） | 0.93 |
| A13 | 申菱环境／**数据服务行业** | 2025 年度 | 含液冷、风冷、相变、主机四系列；**不是纯液冷** | 否 | 23.60% | +4.26pct | 一级（年报） | 0.93 |
| A14 | 申菱环境／**分产品** | 2025 年度 | 设备 vs 解决方案及服务 | 否 | 设备 **21.46%** / 解决方案及服务 **31.63%** | −1.47pct / +4.99pct | 一级（年报） | 0.93 |
| A15 | Modine／**Data Centers 分部** | FY2027 Q1（2026-04-01 至 2026-06-30） | 含 Airedale chiller、CRAH 等设施侧冷却；**不是纯液冷** | 否 | **20.2%** | −960bp | 二级（业绩公告） | 0.94 |
| A16 | Modine／集团 | FY2027 Q1 | 集团 | 否 | 20.8% | −340bp | 二级（业绩公告） | 0.94 |
| A17 | 奇鋐 AVC／集团 | 2026 Q2 | 集团；公司不拆液冷 | 否 | 32.57% | — | 三级（转录，需 MOPS 复核） | 0.75 |
| A18 | 双鸿 Auras／集团 | 2026 Q1 / Q2 | 集团；管理层称液冷占比 >55% | 否 | 29.7% / 28.42% | — | 三级（法说转录） | 0.72 |
| A19 | Ecolab／CoolIT | 交易时前瞻 | 公告称 "high-margin"，**未披露数值** | 是（较纯 DLC） | **无数据** | — | 二级 | — |
| A20 | Eaton／Boyd Thermal | 交易时预测 | 2026 液冷收入 15 亿美元预测；**未披露毛利** | 是（较纯液冷） | **无数据** | — | 二级 | — |
| A21 | Vertiv / Schneider / nVent | 2025–2026 | 均未披露液冷收入或液冷毛利 | — | **无数据** | — | 二级 | — |

---

## 3. 口径边界警示（使用锚点前必读）

### 3.1 A1（10.36%）到底是什么口径

曙光数创年报按产品分类披露，**服务（A5）单独成行**，因此 A1 的 267,702,360.46 元营业成本主要是**产品成本**。但该公司收入确认规则为"以项目完工后取得客户验收报告或验收单为时点一次性确认"，属项目制，其营业成本大概率**已包含项目实施／安装相关的直接成本**，而**不含**销售费用、管理费用、研发费用。

因此 A1 在本项目的成本桥中对应的位置是：

```
硬件毛利        > A1 对应位置 > 项目贡献毛利
（仅扣 BOM+制造）              （再扣安装/物流/渠道/质保/坏账）
```

即 **A1 = 10.36% 应被读作"扣除 BOM、制造与项目直接成本后的毛利"，比"硬件毛利"严格，比"项目贡献毛利"宽松。** 用它对照本项目的倒推结果时，最接近的可比层级是"硬件毛利 − 制造 − 部分安装"。**不得**把 10.36% 当成项目贡献毛利，也**不得**当成纯裸机硬件毛利。

### 3.2 不可比清单

- A9/A13 含大量风冷产品，**不能**当液冷毛利。风冷机房空调是成熟品类，毛利结构与液冷不同。
- A15 含 chiller/CRAH，属设施侧一次侧设备，与二次侧 CDU 不同价值链位置。
- A17/A18 为集团口径，且台系公司以冷板/manifold 代工为主，客户、地域和产品结构均与独立 CDU 供应商不同。
- A11 的境内／境外差异是**全产品混合**口径，不能直接读成"液冷海外毛利 52.64%"；但可支持"海外定价与毛利显著高于国内"的方向性结论。
- A8 为三级转述，且 11.93% 是**集团综合**毛利率而非冷板产品毛利率。必须回到 2026 年半年度报告原件确认冷板产品分项毛利率后才可使用。

### 3.3 A1 的下行反证

2026 H1 数据（结论 2）显示 A1 不是底部：冷板收入 +290% 的同时公司亏损扩大、经营现金流 −2.42 亿元。因此在倒推模型中**不应把 10.36% 当作"行业地板"**，而应视为"2025 年度的一个观测值，且趋势向下"。倒推时应额外测试 5%–8% 的下行情景。

---

## 4. 对倒推模型的直接含义

| 若倒推所需毛利率 | 与实证锚点的关系 | 判定 |
|---|---|---|
| ≤ 10% | 处于 A1 实证水平之内 | 与已披露的最纯可比样本一致，但该样本本身在亏损 → 仍不足以支撑固定费用 |
| 10%–21% | 高于 A1，低于 A13/A14 设备口径 | 需要证明本项目比曙光数创冷板业务显著更优（更高定价或更低成本），须有书面证据 |
| 21%–28% | 达到 A9/A14 混合口径水平 | 需要产品结构中含大比例风冷／方案服务，或定价能力显著更强 |
| > 28% | 超过所有国内一手披露的相关分部 | **只在海外市场（A11 境外 52.64%）有实证支持**；国内裸设备口径无任何一手支持 |
| > 40% | 无任何一手支持 | 此前删除"CDU 毛利 40%–60%"的决定维持；不得恢复 |

**核心判断：如果倒推出的所需毛利率落在 21% 以上，则该业务在国内运营商裸设备口径下不成立，必须依赖海外市场或服务/解决方案收入结构才可能成立。** 这不是价格预测，是约束条件。

---

## 5. 来源台账

| ID | 标题／机构 | 日期 | URL | 位置 | 等级 | 置信度 |
|---|---|---:|---|---|---|---:|
| S1 | 曙光数据基础设施创新技术（北京）股份有限公司 2025 年年度报告 | 2026-04-14 | http://static.cninfo.com.cn/finalpage/2026-04-14/1225104669.PDF | "收入构成 / 按产品分类分析 / 按区域分类分析" | 一级 | 0.95 |
| S2 | 曙光数创 2026 年半年度报告（及媒体转述） | 2026-08-25 | https://finance.sina.com.cn/stock/zqgd/2026-08-25/doc-inipqaak5466268.shtml | 半年报主要财务数据；冷板液冷 +290.09% | 三级（转述一级披露） | 0.80 |
| S3 | 深圳市英维克科技股份有限公司 2025 年年度报告 | 2026-04-21 | https://disc.static.szse.cn/disc/disk03/finalpage/2026-04-21/2f89a147-3bd6-43e1-9a24-b6d0fbac0641.PDF | "分行业／分产品／分地区／分销售模式" | 一级 | 0.93 |
| S4 | 广东申菱环境系统股份有限公司 2025 年年度报告 | 2026-04-27 | https://disc.static.szse.cn/disc/disk03/finalpage/2026-04-27/66d8c358-5299-4978-a3a2-327bf46dc1bc.PDF | "分行业／分产品／分地区"；数据服务板块说明 | 一级 | 0.93 |
| S5 | Modine Reports First Quarter Fiscal 2027 Results | 2026-07-29 | https://investors.modine.com/news/news-details/2026/Modine-Reports-First-Quarter-Fiscal-2027-Results/default.aspx | Data Centers segment；Gross profit 表 | 二级 | 0.94 |
| S6 | Modine FY2027 Q1 Earnings Call Transcript | 2026-07-30 | https://www.roic.ai/quote/MOD/transcripts/2027-year/1-quarter | 管理层关于 20% EBITDA 水平与 30% 毛利目标的表述 | 三级（转录） | 0.75 |

---

## 6. 有效期与失效条件

- `valid_until: 2026-11-30`
- `invalidate_if:`
  - 曙光数创 2026 年半年度报告／三季报披露冷板液冷产品分项毛利率（将替换 A8，并可能修正 A1 的趋势判断）
  - 英维克／申菱披露液冷专项收入或液冷分部毛利率（将首次形成国内"纯液冷"第二样本）
  - Ecolab 或 Eaton 首次披露 CoolIT／Boyd 独立液冷收入与利润（将形成海外纯液冷首个实绩样本）
  - Modine 数据中心分部毛利率回升至 25% 以上或继续下探至 15% 以下
  - 任一公司披露纯 CDU 产品毛利率
