bruce2012lu/AIDCtms_design202609/Bp/temp/research-validation-pack/findings/evidence-02-price-trend-and-liability.md

# 证据 02｜液冷价格趋势与产品责任／保险实践

> 取证时点：2026-09-05
> 用途：支撑"缺口二（价格可行域）"与"缺口三（责任敞口与封顶）"
> 总体置信度：价格趋势 **0.62**（无一手时间序列）；责任／保险结构 **0.85**（结构可证，额度不可证）

---

# 第一部分｜价格趋势

## 1. 核心裁决

**不存在可核验的同规格液冷产品公开价格时间序列。** 本轮未取得任何"同一容量、同一工况、同一供货边界"的产品在两个以上时点的公开成交价。因此：

- **禁止**写"CDU 价格年降 X%"并标为事实；
- **允许**写"存在多项独立的降价压力信号，但无公开价格时间序列可量化降幅"；
- 唯一可量化、可复算的价格上限证据仍是两个 2026 年运营商采购样本的**包价折算单位容量价格**（见 §3）。

`confidence: 0.88`（对"无时间序列"这一否定结论本身）

## 2. 降价压力信号（全部为方向性证据，不可量化）

| ID | 信号 | 证据内容 | 来源等级 | 置信度 | 可否量化 |
|---|---|---|---|---:|---|
| P1 | **最纯可比公司的冷板毛利实测下滑** | 曙光数创冷板液冷毛利率 2025 年 10.36%，同比 −15.48pct；年报明确归因"冷板液冷处于市场导入期，市场竞争较为激烈" | 一级（年报） | 0.95 | 毛利率可量化；价格降幅不可分离（量、结构、成本同时变化） |
| P2 | **扩产期毛利压缩在海外同样发生** | Modine 数据中心分部毛利率由 29.8% 降至 20.2%，归因含"材料成本上升、质保费用上升、扩产低效" | 二级（业绩公告） | 0.94 | 毛利率可量化；不能归因于单一价格因素 |
| P3 | **产能急剧扩张** | 奇鋐液冷模组月产能计划由 20 万件增至 100 万件、manifold 由 1,000 增至 7,000；2026/2027 CapEx 150/170 亿新台币；nVent 三年新增液冷面积 >40 万平方英尺 | 二级（公司披露／转录） | 0.82 | 产能可量化；对价格的传导不可量化 |
| P4 | **进入门槛的工艺环节较低** | 冷板依赖 CNC、快接依靠精密车削、Manifold 以焊接为主；标准化（OCP Deschutes、Redfish、参考架构）扩大可替换供应商范围 | 三级（行业媒体）＋二级（OCP 规范存在） | 0.70 | 不可量化 |
| P5 | **集中招标压价** | 券商研报汇总称集中招标模式下产品年均降价 5%–8%，低端散热组件毛利率普遍不足 15% | **三级（二手研报汇总）** | **0.45** | **不得引用为事实**；只作线索 |
| P6 | **国内外价格水平差异** | 二手来源称国内 CDU 单价被压缩至 1,000 元/kW 甚至更低，海外北美项目维持 200–240 美元/kW | **三级（行业自媒体）** | **0.40** | **不得引用为事实**；但与 P7、A11 方向一致，可作交叉线索 |
| P7 | **一手交叉印证：境内外毛利差** | 英维克 2025 年境外毛利率 52.64% vs 境内 23.83%（一手年报） | 一级（年报） | 0.93 | 可量化，且**独立于 P6** 支持"海外定价显著更高"的结论 |
| P8 | **客户压价表态（传导链）** | 芯片厂利润空间受压时会要求 CDU／冷板／歧管供应商分担成本降幅（二手判断）；Modine 单一战略客户以 40 亿美元产能协议 + 1.65 亿美元预付款锁定供应（一手），说明大客户在用"量换价+锁产能" | P8a 三级 0.40；P8b 二级 0.90 | 0.65 | 产能协议金额可量化；价格条款未公开 |

**P6 的处理纪律：** 该数据点如果为真，是本案最重要的价格信息之一；但来源为行业自媒体，且未给出样本、期间与供货边界。处理方式：**作为客户访谈与渠道询价的验证问题写入工具包**（见《客户访谈提纲》Q-价格组），不进入任何计算的基准值，只在敏感性分析的高位情景中作为"待验证参照"标注。

## 3. 唯一可复算的价格上限证据：单位容量价格

将已核验的两个 2026 年运营商采购样本按"总价 ÷ 总容量"折算为单位容量价格，可得到**同边界（CDU + 二次管路 + 工质 + 安装调试）的包价上限**：

| 样本 | 数量 × 容量 | 总容量 | 公开金额（不含税） | 单位容量价格 | 金额性质 |
|---|---|---:|---:|---:|---|
| 广东移动佛山三水 | 6 × 420 kW | 2,520 kW | 1,725,576.99 元 | **684.75 元/kW** | 总价最高限价（含废液收集推车、储液桶、304 不锈钢二次管路、系统调测、运输就位对接、深化设计） |
| 江苏移动南京科创 C2 | 12 × 500 kW | 6,000 kW | 4,290,000 元 | **715.00 元/kW** | 项目预估金额（含二次管路、附件、工质、安装） |

复算：`1,725,576.99 ÷ 2,520 = 684.7528`；`4,290,000 ÷ 6,000 = 715.0000`。

**为什么"元/kW"比"万元/台"更有用：** 前一轮把总价除以台数得到 28.76 万元/台、35.75 万元/套，两个数看起来相差 24%，容易被解释为"容量不同导致的正常差异"。折算为元/kW 后，两个来自不同省份、不同容量、不同时点的样本落在 **684.75 与 715.00** 之间，差异仅 4.4%。**两个独立样本在单位容量价格上高度收敛，这显著提升了"该价格水平代表国内运营商真实采购水平"的置信度。** `confidence: 0.85`

**使用边界（强制）：**
1. 这是**包价**（含管路、工质、安装、深化设计），裸机 CDU 单位价格必然**低于**此数。
2. 这是**限价／预估**，不是中标价；实际成交可能更低（限价机制下投标折扣普遍存在），不可能更高。
3. 两个样本均为 **420/500 kW 大容量档**。小容量 CDU 的固定内容（泵、PLC、HMI、机柜、钣金）不随容量线性缩减，因此 100/200 kW 的元/kW **应显著高于** 685–715，具体高多少**无数据**，不得插值。
4. 因此该数只能作为 **300–500 kW 档、国内运营商渠道、含配套包**的价格上限使用。

## 4. 反向证据（可能推高价格的因素）

| 因素 | 证据 | 是否可量化 |
|---|---|---|
| 海外市场定价显著更高 | 英维克境外毛利率 52.64%（一手）；PPC RFI 要求 DDP、当地服务、关键备件、≥5 年经验——这些要求本身构成价格溢价的成本基础 | 毛利率可量化；价格溢价不可量化 |
| 五年质保、2N 冗余、认证品牌泵阀、全球备件、产品责任险的项目 | C-DAC 要求 5 年现场综合质保、8h 响应、72h 换件——这类边界的报价必然高于运营商 2 年质保样本 | 不可量化，须同边界书面报价 |
| 高热流密度／新平台首发期 | GB300 155 kW peak、Dell 特定配置 264 kW；新平台首发期可靠性验证与服务能力仍能维持溢价 | 不可量化 |
| 服务／解决方案收入结构 | 申菱解决方案及服务 31.63% vs 设备 21.46%；曙光服务 51.02% vs 冷板产品 10.36% | 可量化（毛利率差） |

---

# 第二部分｜产品责任与保险实践

## 5. 核心裁决

1. **"责任上限"在数据中心合同中是普遍存在的机制，其常见形式是"合同价的一定百分比"，但具体额度在几乎所有可查合同中被脱敏或不公开。** `confidence: 0.90`
2. **间接／后果性损失（利润、收入、数据、商业机会）通常被双方互相排除，但排除的例外项（carve-outs）是谈判焦点，且例外项在公开合同中同样被脱敏。** `confidence: 0.90`
3. **"合同价封顶 + 排除间接损失"不是新进入者可以默认获得的条件。** C-DAC 2024 澄清中，供应商提出的该文本被采购人从附加条款中**删除**，改为适用 GeM 标准责任条款。这是一个明确的反证。`confidence: 0.90`
4. **冷却液泄漏在标准财产险条款下可能被作为"污染"或"渐变渗漏"除外，需要专门的数据中心险种才能把"冷却液释放"明确列为承保的直接财产损失。** `confidence: 0.72`（来源为保险经纪与行业分析，非保单原件）
5. **两相／浸没使用含氟工质时，环境责任市场普遍带有 PFAS 除外条款。** `confidence: 0.70`（同上）

## 6. 责任上限与损害赔偿的市场惯例（分级引用）

| ID | 惯例内容 | 证据与来源 | 等级 | 置信度 | 引用纪律 |
|---|---|---|---|---:|---|
| L1 | 承包商通常不接受"使用损失、利润损失"等间接／后果性损失；双方可约定排除，或以"整体合同价的一定百分比"设上限 | Reed Smith，《Liability clauses in data center construction contracts》 | 二级（律所专业评论） | 0.85 | 可引用为"市场惯例的方向"，**不可**引用为具体比例 |
| L2 | 业主常要求上限例外（unlimited liability carve-outs），常见例外包括重大过失、故意不当行为、保险赔款、知识产权侵权；数据中心场景中业主会试图把数据丢失与网络安全事件加入例外，而承包商强烈抵制，理由是**单次事件的责任可达数千万至数亿美元，远超项目价值和可获得的保险额度** | 同 L1 | 二级 | 0.85 | **本条是本案最重要的责任结论之一**，可直接引用其定性论述 |
| L3 | 数据中心 EPC 合同中，性能违约金（Performance LD）通常封顶在合同价 **10%–15%**（宽者 5%–25%）；整体累计责任上限常见落在 **10%–20%** 区间；迟延违约金按日计并设总额上限 | 《The Definitive Guide to AI Data Centers》§2.4，转引 Womble Bond Dickinson 与 2025 年 EPC 市场实践 | **三级（行业指引，二手转引）** | **0.55** | 只能写成"行业指引转引的区间"，**必须标注转引来源与等级**；不得写成法规或标准 |
| L4 | 按"原因 + 控制权 + 验收状态"划分冷却液泄漏责任，而非按"设备归谁" | Digi Power X–Cerebras《Data Center Colocation and MSA》Art. 11.2(b)–(c)，SEC 申报，生效 2026-05-04 | **一级（监管申报合同）** | 0.97 | 可直接引用为条款结构范本 |
| L5 | 间接／附带／后果性／惩罚性／特殊损害原则上排除；存在累计责任上限；**排除的例外与上限金额均被 `[***]` 脱敏** | 同 L4，Art. 12.1–12.3 | 一级 | 0.96 | 可引用结构，**不得**推断金额 |
| L6 | 保险与赔偿义务背靠背：要求 CGL、财产全险、雇主责任、超额责任险；CGL 须覆盖合同赔偿义务；互列附加被保险人；进场前提供保险凭证 | 同 L4，Art. 10.1–10.3 | 一级 | 0.96 | 可引用为投保清单 |
| L7 | 客户设备／人员／承包商造成设施损坏（含冷却液泄漏、设备故障、不当安装或拆除）由客户修复 | 同 L4，§14.2(b) | 一级 | 0.95 | 可引用为反向责任条款 |
| L8 | 迟延违约金可由"每周 0.5%、最高 10%"下调至"最高 5% 的未税基础合同额" | C-DAC《Annexure B – Corrigendum, GEM/2024/B/5031803》，2024-07 | 一级（采购人原件） | 0.93 | 可引用为 LD 上限的谈判先例 |
| L9 | 供应商自拟"责任限于合同总价 + 排除间接/特殊损失"被采购人删除，改为适用 GeM 标准责任条款；货物在成功安装、调试并由最终用户接收前，风险与责任仍由供应商承担 | 同 L8 | 一级 | 0.90 | **关键反证**：责任封顶不是必然可得 |

## 7. 漏液损失量级证据（用于最坏情景标定）

| ID | 损失量级 | 内容 | 来源等级 | 置信度 | 使用方式 |
|---|---|---|---|---:|---|
| D1 | **单块 GPU 基板 3.5–5.0 万美元** | 约 50 ml 冷却液滴到带电 GPU 基板上，典型导致基板更换成本 3.5–5.0 万美元／块；高密配置下可短路相邻基板 | **三级（印度保险行业分析文章）** | **0.55** | 作为"单点最小损失"的量级参照，须标注等级；决策中应以客户实际机型的备件价格替换 |
| D2 | **单柜数百万美元** | GPU 整柜单价"数百万美元级"，一柜部分损坏即为七位数美元不可恢复损失 | 三级（多篇行业文章一致） | 0.60 | 与 D5 的独立模型交叉验证后使用 |
| D3 | **CDU／Manifold 故障可级联 32–72 柜** | CDU 泵失效、板换污堵或 Manifold 法兰破裂可影响整个 POD（32–72 柜） | 三级 | 0.55 | 用于"级联敞口"的上限情景 |
| D4 | **实际事故：东南亚，2025 年** | 高密机房上方管路爆裂，约十余个 GPU 服务器机柜停运；地面积水需人工刮除；未披露具体赔付 | 三级（行业博客，未具名） | 0.50 | 只作"该风险已实际发生"的存在性证据，**不用于金额** |
| D5 | **独立模型交叉验证：单柜 IT 资产约 2,060 万元** | Epoch AI 一 GW AI 数据中心 TCO 模型给出 servers 21.2 美元/W；按 135 kW/柜（Lenovo GB300 TDP，一级原厂规格）计：`21.2 × 135,000 = 2,862,000 美元 ≈ 2,061 万元`（汇率 7.2） | 二级（第三方研究模型）＋一级（原厂功率规格） | 0.75 | **本案采用此路径**：与 D2 的"数百万美元"量级一致，但方法透明、可复算、可替换参数 |
| D6 | **停机与监管的后果远超设备损失** | Equinix 新加坡 2023-10 冷却故障导致 DBS／花旗约两日中断、约 250 万笔支付交易失败；新加坡金管局对 DBS 施加 1.8 倍操作风险资本乘数，约相当于 16 亿新元额外监管资本 | 三级（转述监管行动） | 0.65 | 用于说明"间接损失排除条款为何是生存前提"，**不作为赔付金额基准** |
| D7 | **业务中断保险的"修复期"口径缺口** | 标准 BI 条款只赔"period of restoration"（漏液湿三柜与地板下约 4–6 周），但客户已把工作负载迁走，客户流失、SLA 罚款与声誉损失持续远超修复期 | 三级（律所分析的二手转述） | 0.55 | 用于设计"间接损失排除"必须覆盖的项目清单 |

## 8. 保险承保与除外结构（作为投保询价清单）

来源：保险经纪／行业风险分析（**三级**，`confidence: 0.60`）。必须以保险公司正式条款和报价替换。

**必须确认为"承保"的：**
- 冷却液释放（水／乙二醇／PG25／含氟工质）造成的**直接财产损失**明确列为承保，而非按"污染"或"渐变渗漏"除外
- 合同赔偿义务（contractual liability）在 CGL 下有效覆盖
- 安装工程一切险（CAR）覆盖安装、调试、试运行期间
- 附加被保险人、代位求偿权放弃、保险凭证
- 超额责任险（excess/umbrella）的触发层与限额

**必须书面确认的除外与限制：**
- 渐变渗漏／逐步劣化（gradual seepage / gradual deterioration）——冷板点蚀腐蚀在 18 个月运行后发生，可能被认定为"劣化"而非"突发意外"，机器损坏险的渐变除外可能触发
- 污染责任（pollution）与 PFAS 除外（两相／含氟工质）
- 产品召回、纯经济损失、工艺／工作质量（workmanship）除外
- 责任在"电子设备险（EEI）"与"机器损坏险（M&BD）"之间的灰区归属——快接微渗损坏电子件时两个保单可能互相推诿
- 免赔额（每次事故／年度累计）、分项限额（sublimit）、赔偿限额是否为"每次事故"或"累计"

## 9. 来源台账

| ID | 标题／机构 | 日期 | URL | 等级 | 置信度 |
|---|---|---:|---|---|---:|
| T1 | Reed Smith，Liability clauses in data center construction contracts | 滚动，访问 2026-09-05 | https://www.reedsmith.com/articles/data-centers-bytes-and-rights/liability-clauses-in-data-center-construction-contracts/ | 二级（律所评论） | 0.85 |
| T2 | Data Centre Review，The importance of liability contracts in data centre construction | 2025-06 | https://datacentrereview.com/2025/06/the-importance-of-liability-contracts-in-data-centre-construction/ | 三级 | 0.60 |
| T3 | The Definitive Guide to AI Data Centers §2.4 The Contract Stack | 滚动，访问 2026-09-05 | https://aidatacenterguide.com/part-2-project-delivery-schedule-procurement-contracts-and-risk/2-4-the-contract-stack-and-commercial-legal-framework | 三级（行业指引，转引 Womble Bond Dickinson） | 0.55 |
| T4 | Digi Power X–Cerebras Data Center Colocation and Master Services Agreement | 生效 2026-05-04；SEC 申报 2026-05-08 | https://www.sec.gov/Archives/edgar/data/1854368/000121390026053566/ea028958501ex10-1.htm | **一级** | 0.97 |
| T5 | C-DAC Annexure B – Corrigendum, Tender GEM/2024/B/5031803 | 2024-07 | https://www.cdac.in/index.aspx?dynamicId=NTIwOTcyMDc%3D&id=tenders_viewpdf | **一级** | 0.93 |
| T6 | C-DAC Integrated DCLC Solutions Tender | 2022-12-13 | https://www.cdac.in/index.aspx?dynamicId=NjY4MzIzMjM%3D&id=tenders_viewpdf | **一级** | 0.96 |
| T7 | NextGuard，AI Data Center Insurance: Coverage Gaps 2026 | 2026 | https://www.nextguardinsurance.com/florida-insurance-blog/ai-data-center-insurance-coverage-gaps-2026 | 三级（经纪商营销） | 0.55 |
| T8 | Sarvada，Data Centre Advanced Cooling Insurance（印度 hyperscale） | 滚动，访问 2026-09-05 | https://sarvada.ai/industry-risk-profiles/data-centre-advanced-cooling-insurance-india | 三级 | 0.55 |
| T9 | StormBag，The Data Center BI Coverage Gap Liquid Cooling Just Opened / Containment Playbook | 2026 | https://stormbag.co/blogs/stormbag-flood-protection-blog/the-insurance-industry-has-a-liquid-cooling-problem | 三级（产品营销） | 0.50 |
| T10 | Epoch AI，Total cost of ownership of a one-gigawatt AI data center | 更新 2026-05-14 | （见 v3.2 报告来源 K 系列） | 二级（第三方研究模型） | 0.75 |
| T11 | Lenovo GB300 Product Guide, Table 27 | 2026-08-13 | https://lenovopress.lenovo.com/lp2357.pdf | 一级（原厂规格） | 0.95 |

---

## 10. 有效期与失效条件

- 价格趋势 `valid_until: 2026-12-31`；`invalidate_if:` 取得任一官方 CDU 分项中标价、任一同规格产品两个时点的公开价格、或运营商公布单价最高限价附件
- 责任／保险 `valid_until: 2027-03-31`；`invalidate_if:` 取得一份未脱敏的液冷设备供货合同责任条款、一份保险公司正式数据中心液冷保单条款、或 GeM／国内标准责任条款修订
- **D1、L3、P5、P6 为三级来源，任何进入董事会材料的引用必须保留等级标注和置信度**
