bruce2012lu/AIDCtms_design202609/Bp/temp/research-validation-pack/findings/model-03-reverse-price-liability-cash.md

# 模型 03｜倒推价格、责任敞口与现金模型的完整参数、公式与独立复算

> 建立时点：2026-09-05
> 性质：**全部为本报告模型（M）**。所有输入按"实证／可比公司／纯假设"三级标注依据。
> 用途：主交付《算力冷却_验证与决策包_v1.0》的计算底稿，供独立复算。
> 复算环境：Python 3.13；所有结果已逐项复算并与正文一致。

---

## 0. 参数依据分级图例

| 标记 | 含义 | 处理纪律 |
|---|---|---|
| **【实证】** | 来自一手披露／官方招标文件，可复核 | 可作基准 |
| **【可比】** | 来自可比公司分部或邻近行业披露，口径不完全一致 | 需标注口径差异 |
| **【假设】** | 纯管理层假设，无外部证据 | **必须由 RFQ／访谈替换后才能进入决策** |
| **【推导】** | 由上述三类经公式推出 | 公式必须公开 |

---

## 1. 缺口二：倒推所需价格

### 1.1 固定费用口径（两档）

来源：BP v2.1 §10 资金用途表（阶段 1 上限 800 万元）。**【实证】**（内部预算文件）

| 科目 | 阶段 1（万元） | 是否费用性 | 纳入 F1 | 纳入 F2 |
|---|---:|---|---|---|
| 核心团队与专项工程 | 220 | 是 | ✔ 220 | ✔ 220 |
| 产品 NRE／软件／IP | 115 | 是（一次性） | ✔ 115 | ✘ |
| 样机／物料／工装 | 130 | 是（一次性） | ✔ 130 | ✘ |
| 测试／认证／客户验证 | 95 | 是 | ✔ 95 | ✔ 50（经常性部分） |
| 供应商 NPI／授权制造 | 50 | 是 | ✔ 50 | ✔ 20（经常性部分） |
| PoC／订单营运资金 | 110 | **否（可回收）** | ✘ | ✘ |
| 保险／法务／网络安全／服务 | 30 | 是 | ✔ 30 | ✔ 30 |
| 董事会预备金 | 50 | 是（备用） | ✔ 50 | ✘ |
| **合计** | **800** | | **F1 = 690** | **F2 = 320** |

- `F1 = 800 − 110 = 690 万元/年`：阶段一需由毛利或注资覆盖的**全部费用性支出**（含一次性 NRE 与样机）
- `F2 = 220 + 50 + 20 + 30 = 320 万元/年`：**稳态经常性固定费用**（团队 + 持续测试认证 + 供应商质量 + 保险法务）

F2 是判断"业务能否自我维持"的正确分母；F1 是判断"阶段一能否靠自身回收"的分母。**两者都必须报告，只报 F2 会低估投入，只报 F1 会低估稳态可行性。**

### 1.2 单位容量成本结构（200 kW 档，同边界＝招标包价边界）

口径对齐说明：为与 §1.3 的招标实证价格可比，本表覆盖范围与招标包一致，即 **CDU 本体 + 二次管路 + 工质 + 安装调试**。

| 成本项 | 元/kW | 依据 | 说明 |
|---|---:|---|---|
| BOM（泵组、板换、阀件、过滤/脱气/补液、PLC/HMI/VFD、传感、机架钣金、管件、工质、线束、漏液检测） | **400 / 650 / 900** | **【假设】** | 三档；按 §1.6 工程量级自校验得到的合理区间，中值 650 |
| 制造／装配／耐压气密／冲洗／FAT | 100 | **【假设】** | 待试制工时卡替换 |
| 安装／SAT／差旅／整改 | 150 | **【假设】** | 新进入者无既有服务网络，此项显著高于在位者 |
| 物流／关税／保险 | 50 | **【假设】** | 国内口径 |
| 渠道／EPC 分成 | 40 | **【假设】** | 直销可为 0，但不得默认为 0 |
| 预期质保准备（2 年） | 70 | **【假设】** | 无故障率数据，纯假设 |
| 预期坏账／LD | 30 | **【假设】** | 无 CDU 专属坏账率 |
| **非 BOM 小计** | **440** | **【推导】** | `100+150+50+40+70+30 = 440` |
| **同边界总成本** | **840 / 1,090 / 1,340** | **【推导】** | BOM 三档 + 440 |

复算：`400+440=840`；`650+440=1090`；`900+440=1340` ✔

### 1.3 实证价格上限（同边界）

| 样本 | 单位容量价格 | 依据 |
|---|---:|---|
| 广东移动佛山三水 6×420 kW，1,725,576.99 元 | **684.75 元/kW** | **【实证】** `1,725,576.99 ÷ 2,520 = 684.7528` |
| 江苏移动南京科创 12×500 kW，4,290,000 元 | **715.00 元/kW** | **【实证】** `4,290,000 ÷ 6,000 = 715.0000` |
| 海外参照（北美 200–240 美元/kW，汇率 7.2） | 1,440–1,730 元/kW | **【假设／三级待核】** 来源为行业自媒体，仅作参照 |

### 1.4 第一个核心矛盾

```
最乐观 BOM 情景下的同边界总成本  = 840 元/kW
国内运营商包价上限（两样本收敛） = 685–715 元/kW
```

**即：即使 BOM 落在假设区间的最低端，同边界总成本仍高于国内运营商包价上限约 17%–23%。** 在中值 BOM（650）下，总成本为包价上限的 **1.52–1.59 倍**。

复算：`840 ÷ 715 = 1.175`；`840 ÷ 684.75 = 1.227`；`1,090 ÷ 715 = 1.524`；`1,090 ÷ 684.75 = 1.592` ✔

**要在 715 元/kW 的价格下取得非负项目贡献，BOM 必须 ≤ 275 元/kW**（`715 − 440 = 275`），即比假设中值低 **58%**（`1 − 275/650 = 57.7%`）。

### 1.5 三种可能的解释（必须全部呈现，不得只留有利的一种）

| # | 解释 | 可检验性 | 检验方法 |
|---|---|---|---|
| **H1** | 成本假设偏高：真实 BOM 可能在 275–450 元/kW | **可在 4–6 周内以近零成本检验** | 四 SKU 关键件书面询价（工具包一） |
| **H2** | 招标样本不可外推：包价上限可能由在位者的平台摊销、垂直整合、既有服务网络与低边际固定成本支撑，或为进入运营商框架的战略性低价 | 可部分检验 | 客户/渠道访谈取得分项成交价；观察在位者盈利（曙光冷板 10.36% 且 2026H1 亏损扩大，支持"低价+微利"假说） |
| **H3** | 国内运营商裸设备渠道对新进入者结构性不成立 | 由 H1、H2 的检验结果反推 | 若 H1 检验后 BOM > 450 元/kW，则 H3 成立，业务重心必须转向海外／服务／非运营商渠道 |

**H2 的支持证据（一手）：** 曙光数创冷板液冷毛利率 10.36%，2026 H1 冷板收入 +290% 而归母净利 −7,340 万元、经营现金流 −2.42 亿元。这与"在位者在该价格带上仅取得极薄毛利甚至亏损"一致。**这条证据同时意味着：即使新进入者能把成本压到在位者水平，该渠道的回报也不足以支撑独立业务的固定费用。**

### 1.6 BOM 假设的工程量级自校验（【假设】的合理性检查，非证据）

200 kW CDU 关键件粗量级（人民币，仅用于判断 400–900 元/kW 区间是否荒谬）：

| 关键件 | 量级 |
|---|---|
| 板式换热器（200 kW，ATD ~5K） | 8,000–20,000 |
| 泵组 2 台（N+1，15–25 m³/h @ 3 bar） | 12,000–40,000 |
| VFD × 2 | 4,000–10,000 |
| PLC + HMI | 5,000–15,000 |
| 传感器（流量、压力、温度、电导率、漏液） | 5,000–15,000 |
| 阀件／过滤／脱气／定压补液 | 8,000–20,000 |
| 机柜／钣金／管件／保温 | 10,000–25,000 |
| 电气／线束／配电 | 5,000–12,000 |
| 工质（PG25，数百升） | 3,000–10,000 |
| **合计** | **60,000–167,000** |
| **折单位容量** | **300–835 元/kW** |

**结论：假设区间 400–900 元/kW 与工程量级一致，中值 650 略偏保守但不荒谬；而"BOM ≤ 275 元/kW"落在工程量级区间之外（低于 300 下界），意味着在 715 元/kW 包价下取得正贡献在物理上极为困难，除非规模采购、垂直整合或简化冗余。** 这进一步支持 H2/H3 而非 H1 的极端版本。

### 1.7 倒推所需毛利率与盈亏平衡容量

公式：

```
CM_intensity = P_netrev − C_total                （元/kW）
CM_rate      = CM_intensity ÷ P_netrev
BE_capacity  = F ÷ CM_intensity                  （kW/年）
```

以中值成本 `C_total = 1,090 元/kW` 计：

| 价格 P（元/kW） | CM 强度（元/kW） | CM 率 | BE @F2=320 万（MW/年） | BE @F1=690 万（MW/年） |
|---:|---:|---:|---:|---:|
| 685（佛山实证上限） | **−405** | 负 | 无盈亏平衡点 | 无盈亏平衡点 |
| 715（南京实证上限） | **−375** | 负 | 无盈亏平衡点 | 无盈亏平衡点 |
| 840 | −250 | 负 | 无 | 无 |
| 1,090 | 0 | 0% | ∞ | ∞ |
| 1,200 | 110 | 9.2% | **29.09** | 62.73 |
| 1,440（海外参照低位） | 350 | 24.3% | **9.14** | 19.71 |
| 1,500 | 410 | 27.3% | **7.80** | 16.83 |
| 1,730（海外参照高位） | 640 | 37.0% | **5.00** | 10.78 |
| 1,800 | 710 | 39.4% | 4.51 | 9.72 |

复算样例：`1,500 − 1,090 = 410`；`410 ÷ 1,500 = 27.33%`；`3,200,000 ÷ 410 = 7,805 kW = 7.80 MW`；`6,900,000 ÷ 410 = 16,829 kW = 16.83 MW` ✔

### 1.8 第二个核心矛盾：倒推所需毛利率 vs 实证锚点

| 情景 | 所需 CM 率 | 实证对照 | 判定 |
|---|---:|---|---|
| P = 1,200 元/kW，容量 29 MW/年 | 9.2% | 曙光冷板 10.36% | 毛利率可达，但 **29 MW/年 的容量不可达**（见 §3.4） |
| P = 1,500 元/kW，容量 7.8 MW/年 | **27.3%** | 曙光冷板 10.36%；申菱设备 21.46%；Modine 数据中心 20.2% | **所需毛利率高于所有国内一手披露的相关口径**，仅英维克境外 52.64% 可支持 |
| P = 1,730 元/kW，容量 5.0 MW/年 | **37.0%** | 无国内一手支持 | 仅海外市场可能 |

**结论（必须如实呈现）：能让阶段一固定费用在可达容量下平衡的价格，其对应的所需毛利率是 27%–37%，而国内可比公司一手披露的相关毛利率是 10.36%–23.60%。倒推所需毛利率显著高于国内行业实证水平，缺口约 4–27 个百分点。唯一有一手实证支持该毛利率水平的是海外市场（英维克境外 52.64%）与服务/解决方案收入（申菱 31.63%、曙光服务 51.02%）。**

### 1.9 敏感性（龙卷风数据表）

基准：`P = 1,500 元/kW`，`BOM = 650`，`C_total = 1,090`，`CM = 410 元/kW`，`F2 = 320 万元`

| 变量 | 变动 | CM 强度（元/kW） | 相对基准 | BE @F2（MW/年） |
|---|---|---:|---:|---:|
| **ASP** | −20%（1,200） | **110** | −73.2% | 29.09 |
| **ASP** | +20%（1,800） | **710** | +73.2% | 4.51 |
| **BOM** | +15%（747.5） | 312.5 | −23.8% | 10.24 |
| **BOM** | −15%（552.5） | 507.5 | +23.8% | 6.31 |
| **销量** | ±50% | 410（不变） | 0% | 7.80（不变） |

复算：`1,200−1,090=110`，`110/410−1 = −73.17%`；`1,800−1,090=710`，`710/410−1 = +73.17%`；`650×1.15=747.5`，`1,500−(747.5+440)=312.5`，`312.5/410−1 = −23.78%`；`650×0.85=552.5`，`1,500−992.5=507.5`，`507.5/410−1 = +23.78%` ✔

**排序（对项目贡献的影响力）：ASP（±73%）> BOM（±24%）> 销量（0%，但影响缺口绝对额）。**

销量的正确解读：销量不改变单位贡献强度和盈亏平衡点，只改变"距离盈亏平衡有多远"。在 P=1,500、V=4 MW/年（约 20 台 200 kW）时：年贡献 `4,000 × 410 = 164 万元`，对 F2=320 万元的缺口为 **−156 万元**；V±50% 使缺口在 **−238 万元 至 −74 万元** 之间。**在任何 ±50% 的销量情景下，阶段一均不能达到 F2 盈亏平衡。**

复算：`4,000 kW × 410 元/kW = 1,640,000 元 = 164 万元`；`164 − 320 = −156`；`2,000×410=82 万元 → 82−320 = −238`；`6,000×410=246 万元 → 246−320 = −74` ✔

### 1.10 价格可行域（200 kW 档，同边界）

| 区间（元/kW） | 判定 |
|---|---|
| **< 840** | 在最乐观 BOM（400）下仍为负贡献 → **必然亏损** |
| 840–1,090 | 仅当 BOM 落在假设区间下半部时贡献为正，且无法覆盖任何固定费用 → **不可接单** |
| 1,090–1,440 | 贡献为正（0–350 元/kW），F2 盈亏平衡需 9.1–∞ MW/年 → **容量不可达** |
| 1,440–1,730 | 贡献 350–640 元/kW，F2 盈亏平衡需 5.0–9.1 MW/年 → **可讨论区，但需 24%–37% 毛利率，国内无实证支持** |
| **> 1,730** | F2 盈亏平衡 < 5 MW/年 → 可行，但已高于任何可核验的国内价格水平 |

**国内运营商实证包价上限 685–715 元/kW 落在"必然亏损"区间内，且低于可行域下界（840）约 15%–19%。**

---

## 2. 缺口三：责任敞口量化

### 2.1 单台 200 kW CDU 服务的 IT 资产价值

| 输入 | 值 | 依据 |
|---|---|---|
| 机柜 IT 功率（GB300 NVL72 TDP） | 135 kW | **【实证】** Lenovo GB300 Product Guide, Table 27（一级原厂规格） |
| 液冷占比 | 约 90% → 液体负荷 121.5 kW/柜 | **【实证／推导】** 同上；`135 × 0.90 = 121.5` |
| 服务器价值强度 | 21.2 美元/W | **【可比】** Epoch AI 一 GW AI 数据中心 TCO 模型（二级，第三方模型） |
| 汇率 | 7.2 元/美元 | **【假设】** |

**推导：**
```
单柜服务器价值 = 21.2 × 135,000 = 2,862,000 美元 = 2,060.6 万元
200 kW CDU 覆盖柜数 = 200 ÷ 121.5 = 1.646 柜
单台 200 kW CDU 服务的 IT 资产价值 = 1.646 × 2,060.6 = 3,392 万元
```
复算：`21.2×135000 = 2,862,000`；`×7.2 = 20,606,400 元 = 2,060.64 万元`；`200/121.5 = 1.6461`；`1.6461 × 2,060.64 = 3,392.0 万元` ✔

**交叉验证：** 独立三级来源称"GPU 整柜数百万美元级"，与本模型 286 万美元/柜一致。两条路径独立且量级吻合。

**低密度改造情景（对照）：** 40 kW/柜液体负荷、5 柜、通用服务器约 5 美元/W → 单柜 `40,000×5×7.2 = 144 万元`，5 柜合计 **720 万元**。敞口相差 4.7 倍，**说明客户分层直接决定责任敞口量级**。

### 2.2 敞口与合同额、毛利的比例

以国内实证包价上限计：`合同额 = 715 × 200 ÷ 10,000 = 14.30 万元`；`毛利 = 14.30 × 10.36% = 1.4815 万元`

| 事故情景 | 潜在损失 | ÷ 合同额 | ÷ 项目毛利 |
|---|---:|---:|---:|
| 单块 GPU 基板损坏（3.5–5.0 万美元，三级） | 25.2–36.0 万元 | **1.8–2.5 倍** | **17–24 倍** |
| 单柜 IT 资产全损 | 2,060.6 万元 | **144 倍** | **1,391 倍** |
| 200 kW CDU 覆盖范围全损（1.65 柜） | 3,392 万元 | **237 倍** | **2,290 倍** |
| POD 级级联（32–72 柜，三级） | 6.6 亿–14.8 亿元 | 4,600–10,400 倍 | 44,500–100,300 倍 |
| 行业惯例责任上限（合同价 10%–20%，三级指引） | 1.43–2.86 万元 | 0.1–0.2 倍 | 1.0–1.9 倍 |

复算：`715×200/10000 = 14.30`；`14.30×0.1036 = 1.48148`；`35,000×7.2/10,000 = 25.2`；`50,000×7.2/10,000 = 36.0`；`25.2/1.48148 = 17.01`；`36.0/1.48148 = 24.30`；`2,060.64/14.30 = 144.10`；`2,060.64/1.48148 = 1,390.9`；`3,392/14.30 = 237.2`；`3,392/1.48148 = 2,289.6`；`2,060.64×32 = 65,940 万元 = 6.59 亿`；`2,060.64×72 = 148,366 万元 = 14.84 亿` ✔

### 2.3 关键洞察（可直接用于董事会）

1. **一次 50 ml 的冷却液滴落造成的单块基板更换成本，就等于整个合同额的 1.8–2.5 倍、整个项目毛利的 17–24 倍。** 即：**在最小可想象的事故中，供应商已经赔掉了 17–24 个同规模项目的全部毛利。**
2. **行业惯例的"合同价 10%–20% 责任上限"在此业务中对客户毫无意义**——1.43–2.86 万元的上限连一块基板都赔不起。因此客户的理性诉求必然是**不封顶或设超级上限**，而这是新进入者绝对不能接受的。**这意味着责任谈判不是"争取更好条件"，而是"业务是否存在"的判定。**
3. **责任封顶不是谈判技巧，是业务成立的前提条件。** 若无法取得书面责任上限 + 间接损失排除 + 可投保确认，则单个项目的尾部损失可以在一次事故中消灭整个阶段一预算（800 万元）的 2.6 倍（单柜全损 2,060.6 万元 ÷ 800 万元 = 2.58 倍）。
4. **技术故障隔离是唯一能降低敞口本身（而非转移敞口）的手段。** 合同上限、保险、供应商追偿都只是转移；把"每个 CDU 覆盖的 IT 资产价值"从 3,392 万元降到 720 万元（低密度改造客户）是 4.7 倍的敞口削减，比任何条款谈判都有效。**这直接决定阶段一的客户选择：优先低密度存量改造，而非高密 GB300 集群。**

复算：`2,060.64/800 = 2.576` ✔；`3,392/720 = 4.71` ✔

### 2.4 责任控制四层设计

| 层 | 手段 | 作用 | 是否降低敞口本身 | 可得性证据 |
|---|---|---|---|---|
| 1 合同 | 累计责任上限（≤ 合同价）、间接损失排除、按"原因+控制权+验收状态"归责、迟延 LD ≤ 5% | 转移 | 否 | Digi Power X–Cerebras Art. 11.2/12.1–12.3（一级，结构可证、额度脱敏）；C-DAC 2024 **拒绝**供应商自拟封顶（一级，反证） |
| 2 保险 | 产品责任/CGL（覆盖合同赔偿义务）、冷却液释放明列承保、CAR、超额责任、附加被保险人、代位求偿放弃 | 转移 | 否 | Digi Power X–Cerebras Art. 10（一级）；除外结构（三级，待保单原件） |
| 3 供应商追偿 | UQD／泵／软管／板换背靠背质保、PCN 控制、批次可追溯、供应商产品责任险及附加被保险人 | 转移 | 否 | C-DAC 漏项与风险承担条款（一级）可作范本 |
| 4 技术隔离 | 逐柜/逐回路隔离阀、托盘+排水、漏液检测联动自动切断、负压二次回路选项、双回路拓扑、UQD 扭矩管控与循环寿命追踪、水质监测（氯离子阈值）、泵冗余自动切换 | **降低** | **是** | OCP CDU 指导 FAT/SAT 项（二级）；行业分析指出多数设计仍为单回路（三级） |

### 2.5 红线条款（无法达成即不接单）

| ID | 条款 | 依据 |
|---|---|---|
| R1 | 累计责任上限有明示金额，且 ≤ 含服务合同总价 | Reed Smith 市场惯例（二级）；Digi Power X 存在上限（一级） |
| R2 | 明示排除间接／后果性损失：利润、收入、数据、算力机会、客户流失、SLA 罚款、监管资本 | Digi Power X Art. 12.1（一级）；Equinix/MAS 事件说明后果规模（三级） |
| R3 | 责任按"原因 + 控制权 + 验收状态"分配，不按"设备归谁" | Digi Power X Art. 11.2(b)(c)（一级） |
| R4 | 一次侧水质失控、异物、误操作导致二次侧污染，责任在设施方 | Digi Power X Art. 11.2(b)（一级） |
| R5 | 客户或第三方安装/拆装 UQD、不当运维造成的漏液不计入供应商责任 | Digi Power X §14.2(b)（一级） |
| R6 | 客户要求的赔偿义务必须在保险可承保范围内，免赔额与除外责任书面确认 | Digi Power X Art. 10（一级） |
| R7 | 迟延 LD ≤ 合同价 5%，且与责任上限**合并**计算而非叠加 | C-DAC 2024 Corrigendum（一级） |
| R8 | PG 未达标以性能扣款为限，不触发终止或全额退货 | 行业指引（三级），须逐项谈判 |

---

## 3. 缺口四：现金模型

### 3.1 付款条款参数来源（全部【实证】）

| 参数 | 值 | 来源 |
|---|---|---|
| 预付款 | 最高 30%，需同额银行保函，有效 12 个月 | C-DAC DCLC，p.12 §12（一级） |
| 到货实物核验后累计 | 至 80%，30 天信用期 | 同上 |
| 安装/调试/测试+验收报告后 | +10% | 同上 |
| 末款 | +10%，凭 3% PBG 释放；PBG 覆盖 5 年质保，有效 62 个月 | 同上 |
| 履约保证金 | 未税合同额 5% | 同上；江苏移动为成交含税额 5% |
| 中国运营商交期 | 订单后 45 个自然日到货 | 浙江移动框架（B 级镜像，0.90） |
| 中国运营商质保 | 终验报告后 ≥24 个月 | 同上 |
| 安装调试全周期 | 16 周（整套供货+安装+调试+测试） | C-DAC（一级） |
| EPC 付款尾部 | 延伸至带载运行 6 个月、投运满 1 年；"以收到最终客户付款为前提" | TCIL 2024（一级） |
| 邻近行业分段付款 | 30/30/35/5，5% 质量保函有效至 60 个月质保期结束后一个月 | 中石油济柴（B 级，0.78，仅作结构旁证） |

### 3.2 单项目峰值现金占用（按每 MW CDU 容量）

现金支出（元/kW → 万元/MW）：`BOM 650 → 65`；`安装/SAT 150 → 15`；`物流 50 → 5`

| 价格情景 | 合同额（万元/MW） | 履约保证金 5%（万元） | **峰值现金占用（万元/MW）** |
|---|---:|---:|---:|
| P = 715（实证上限） | 71.5 | 3.58 | **88.6** |
| P = 1,200 | 120.0 | 6.00 | **91.0** |
| P = 1,500 | 150.0 | 7.50 | **92.5** |

公式：`峰值 = BOM现金 + 安装现金 + 物流现金 + 履约保证金 = 65 + 15 + 5 + 0.05 × 合同额`
复算：`65+15+5+0.05×120 = 91.0` ✔

**本模型采用 91 万元/MW 作为峰值现金占用基准。** 该峰值出现在"安装完成至终验回款到账"之间，即最早第 12 周、最晚可延至第 36 周以后。

**假设：无客户预付款。** 依据：佛山/南京/浙江三个运营商公开文件均未见预付款条款；C-DAC 的 30% 预付款需要同额银行保函（占用授信，本身有成本）。**若能取得 30% 预付款，峰值可下降约 `0.30 × 合同额`（P=1,200 时为 36 万元/MW，降幅 40%）——这使"争取预付款"成为现金层面最高杠杆的单一谈判目标。**
复算：`0.30 × 120 = 36`；`36/91 = 39.6%` ✔

### 3.3 800 万元预算下的并行项目数（硬约束）

BP v2.1 §10 明确"PoC／订单营运资金 110 万元，仅用于已签项目"。

| 可用营运资金口径 | 金额（万元） | ÷ 91 万元/MW | 并行容量 |
|---|---:|---:|---|
| 严格口径（仅 PoC/订单营运资金 110） | 110 | **1.21 MW** | **约 1 个 1 MW 项目，或 6 台 200 kW** |
| 含董事会预备金（110 + 50） | 160 | **1.76 MW** | 约 1 个 1.7 MW 项目；**不足以支撑 2 个并行 1 MW 项目并保留缓冲** |
| 全部预算（800，实际不可用，690 已承诺） | 800 | 8.79 MW | 仅作上限参照 |

复算：`110/91 = 1.209`；`160/91 = 1.758`；`800/91 = 8.791` ✔

**年吞吐量：** 单项目现金占用周期按"下单→回款"约 28 周（W0 下单、W6 出厂、W7 到货、W12 SAT、W16 终验、W20 回款，加 8 周缓冲）：

```
年吞吐 = 1 MW × (52 ÷ 28) = 1.86 MW/年
```
复算：`52/28 = 1.857` ✔

**与盈亏平衡对照：**

| 项 | 值 |
|---|---|
| 阶段一现金约束下的年交付能力 | **1.86 MW/年** |
| F2 盈亏平衡所需容量（P=1,500） | 7.80 MW/年 |
| **达成率** | **23.8%** |

复算：`1.86/7.80 = 23.8%` ✔

**结论：阶段一 800 万元预算在结构上不可能达到盈亏平衡——即使全部执行成功，交付容量也只有 F2 盈亏平衡点的约 24%。这不是失败，而是阶段一的正确定位：阶段一买的是证据，不是利润。因此阶段一的目标必须写成证据里程碑，绝不能写成收入或台数目标。** 任何把阶段一设成"收入 X 万元"的目标，都在数学上要求突破现金约束。

### 3.4 §1.7 中"29 MW/年"情景的可达性裁决

在 P=1,200 元/kW（已高于实证上限 68%）时，F2 盈亏平衡需 29.09 MW/年。对照公开采购样本规模：

| 公开样本 | 容量 |
|---|---|
| 广东移动佛山 | 2.52 MW |
| 江苏移动南京 | 6.00 MW |
| 浙江移动框架（全部，两家分） | 15.00 MW（68% 份额 = 10.2 MW，跨约 2.25 年 ≈ 4.5 MW/年） |
| 联通中卫 DC7（EPC POD，非 CDU 裸机） | 24.00 MW |

`29.09 MW/年` 相当于**每年独家中标接近 5 个南京规模的项目，或约 6.5 倍浙江移动框架多数份额的年化量**。在无 OEM 指定、无全球服务、无历史业绩的条件下，该容量不可达。
复算：`29.09/6.00 = 4.85`；`29.09/4.5 = 6.46` ✔

### 3.5 现金安全三条底线

| # | 底线 | 公式 | 阶段一取值（1 MW 已签） |
|---|---|---|---|
| **B1 最低现金余额** | `≥ 单项目峰值占用 × 已签MW + 3个月经常性固定费用` | `91 × 1 + 320 ÷ 4 = 91 + 80 = 171 万元` | **≥ 171 万元**；建议董事会批准 **200 万元** 留 17% 缓冲 |
| **B2 最大并行项目数** | `⌊(可用营运资金 − B1缓冲) ÷ 单项目峰值占用⌋` | `⌊(160 − 0) ÷ 91⌋ = 1` | **1 个 1 MW 级项目；第二个项目必须等第一个回款到账后才可签约** |
| **B3 最长可承受回款延迟** | `(可用营运资金 − 单项目峰值占用) ÷ 每周经常性支出` | `(160 − 91) ÷ (320 ÷ 52) = 69 ÷ 6.154 = 11.2 周` | **11 周**。超过即触发现金红线 |

复算：`320/4 = 80`；`91+80 = 171`；`171×1.17 = 200`；`320/52 = 6.1538`；`(160−91)/6.1538 = 11.21` ✔

### 3.6 B3 与实测验收周期的冲突（关键风险）

| 已核验的验收/付款尾部 | 周期 |
|---|---|
| C-DAC：供货+安装+调试+测试 | 16 周 |
| 中国运营商：终验后质保起算，但终验日期未公开 | 无数据 |
| TCIL：全项目 214 天；付款延伸至带载运行 6 个月、投运满 1 年 | 30–52 周 |
| 联通中卫：以"第三方验证测试 + 最终客户验收"为完成标准 | 无数据，但结构上可长 |

**B3 = 11 周的容忍度，显著低于已核验合同中出现的验收与付款尾部（16 周至 52 周）。** 即：**按公开合同条款的常见结构，阶段一的现金结构在单个项目上就会被击穿。** 因此：

- **争取预付款不是优化项，是生存条件。** 30% 预付款可把峰值从 91 万降到 55 万元/MW，B3 从 11.2 周延长到 `(160−55)/6.154 = 17.1 周`。
- **拒绝"pay-when-paid"背靠背条款是红线。** TCIL 式"以收到最终客户付款为前提"会把回款不确定性无限延长。
- **必须把自身收款绑定到"CDU 到货 + SAT"，而不是最终客户验收或投运周年。**

复算：`0.30×120 = 36`；`91−36 = 55`；`(160−55)/6.1538 = 17.06 周` ✔

### 3.7 13 周滚动现金表模板（结构，数值待填）

| 行 | 科目 | W1 | W2 | … | W13 | 数据来源 |
|---|---|---|---|---|---|---|
| 1 | 期初现金 | | | | | 上周期末 |
| 2 | 客户预付款 | | | | | 合同付款表 |
| 3 | 到货/初验里程碑收款 | | | | | 合同付款表 × 收款概率 |
| 4 | 终验/尾款收款 | | | | | 同上 |
| 5 | 质保金/PBG 释放 | | | | | 保函到期表 |
| 6 | **收款小计** | | | | | `2+3+4+5` |
| 7 | 关键件供应商预付 | | | | | PO 排程 |
| 8 | 供应商账期付款 | | | | | PO 排程 |
| 9 | 工资与社保税费 | | | | | 编制表 |
| 10 | 制造/FAT 费用 | | | | | 试制计划 |
| 11 | 安装/SAT/差旅 | | | | | 项目排程 |
| 12 | 物流/关税/保险 | | | | | 运价与报关 |
| 13 | NRE/软件/IP | | | | | 合同里程碑 |
| 14 | 测试/认证/第三方 | | | | | 测试报价 |
| 15 | 保函手续费与授信占用 | | | | | 银行费率 |
| 16 | 保险保费 | | | | | 保险报价 |
| 17 | 质保服务与备件 | | | | | 服务成本模型 |
| 18 | CapEx | | | | | CapEx 审批表 |
| 19 | 税款（增值税/所得税） | | | | | 税务测算 |
| 20 | **支出小计** | | | | | `7…19 求和` |
| 21 | **净现金流** | | | | | `6 − 20` |
| 22 | **期末现金** | | | | | `1 + 21` |
| 23 | 履约保证金/保函占用余额 | | | | | 保函台账 |
| 24 | **可动用现金** | | | | | `22 − 23` |
| 25 | 最低现金余额（B1） | 171 | 171 | | 171 | 本模型 |
| 26 | **安全余量** | | | | | `24 − 25` |
| 27 | 红线告警 | | | | | `26 < 0 → 停止签约` |

**强制压力情景（每周更新时必跑）：**
1. 终验延迟 +30 / +60 / +90 天
2. 客户预付款 0% / 30%（含保函成本）
3. 尾款 5% / 10% / 20% 被质保金或 PBG 替代
4. 关键件 100% 预付 / 30 天账期 / 60 天账期
5. 一次 FAT 失败 + 一次现场整改
6. 框架订单只兑现 50% / 75% / 100%
7. 一次重大漏液直接财产损失（按 §2.2 情景，且保险赔款在承保确认前不计入现金流入）

---

## 4. 全部公式汇总（供独立复算）

```
# 缺口二
F1 = 阶段一费用性支出总额 = 800 − 110 = 690                       （万元/年）
F2 = 稳态经常性固定费用 = 220 + 50 + 20 + 30 = 320                 （万元/年）
C_nonBOM  = 100 + 150 + 50 + 40 + 70 + 30 = 440                    （元/kW）
C_total   = BOM + C_nonBOM                                          （元/kW）
CM_int    = P_netrev − C_total                                      （元/kW）
CM_rate   = CM_int ÷ P_netrev
BE_cap    = F × 10,000 ÷ CM_int                                     （kW/年，F 单位万元）
P_floor   = C_total                                                 （零贡献价格下界）
BOM_max   = P_target − C_nonBOM                                     （给定价格下的 BOM 上限）
单位容量价格 = 项目总价 ÷ (台数 × 单台额定容量)                     （元/kW）

# 缺口三
液体负荷/柜   = 机柜 IT 功率 × HCR
覆盖柜数      = CDU 额定容量 ÷ 液体负荷每柜
单柜 IT 价值  = 服务器价值强度(美元/W) × 机柜功率(W) × 汇率
敞口          = 覆盖柜数 × 单柜 IT 价值
敞口倍数_合同 = 敞口 ÷ 合同额
敞口倍数_毛利 = 敞口 ÷ (合同额 × 毛利率)

# 缺口四
峰值现金/MW   = BOM现金 + 安装现金 + 物流现金 + 履约保证金 − 预付款
              = 65 + 15 + 5 + 0.05×合同额 − 预付比例×合同额        （万元/MW）
并行容量      = 可用营运资金 ÷ 峰值现金每MW                         （MW）
年吞吐        = 并行容量 × (52 ÷ 项目现金周期周数)                  （MW/年）
B1 最低现金   = 峰值现金每MW × 已签MW + F2 ÷ 4
B2 最大并行   = FLOOR(可用营运资金 ÷ 峰值现金每MW)
B3 延迟容忍   = (可用营运资金 − 峰值现金占用) ÷ (F2 ÷ 52)           （周）
```

---

## 5. 模型的失效条件

| 触发 | 影响 | 动作 |
|---|---|---|
| 四 SKU 书面报价显示 BOM ≤ 450 元/kW | §1.4 的矛盾缓解，可行域下界降至 ≤890 元/kW | 重跑 §1.7、§1.10 |
| 四 SKU 书面报价显示 BOM > 900 元/kW | 矛盾加剧，H3 成立 | 建议 G1 判 No-Go 或转向海外/服务 |
| 取得任一官方 CDU 分项中标价 | §1.3 的实证上限被替换为真实成交价 | 重跑全部价格章节 |
| 取得客户书面付款条款含预付款 | §3.2 峰值下降，§3.5 三条底线放宽 | 重跑 §3.2–3.6 |
| 取得客户书面责任上限与保险确认 | §2.5 红线部分闭合 | 更新责任裁决 |
| 客户机型确定（非 GB300 级） | §2.1 敞口重算，可能下降 4.7 倍 | 重跑 §2.1–2.3 |
| 曙光数创披露 2026 冷板分项毛利率 | §1.8 的实证对照基准更新 | 重跑 §1.8 |

`valid_until: 2026-12-31`（价格与现金参数）；`2027-03-31`（责任结构）
