bruce2012lu/AIDCtms_design202609/solutions/assets/src_pdf_pages/scrub/_qa/cc05_tr.png

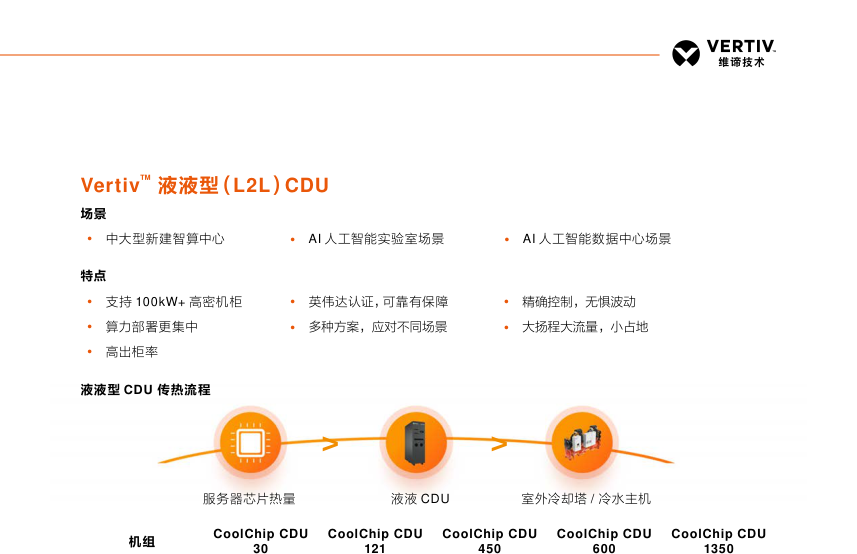
solutions/assets/src_pdf_pages/scrub/_qa/cc05_tr.png
