bruce2012lu/AIDCtms_design202609/solutions/assets/src_pdf_pages/scrub/_qa/coolchip_p05_c1.png

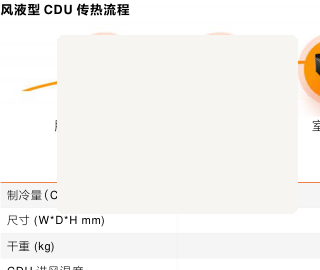
solutions/assets/src_pdf_pages/scrub/_qa/coolchip_p05_c1.png
