bruce2012lu/AIDCtms_design202609/solutions/assets/src_pdf_pages/scrub/_qa/orig_ai10_cdu.png

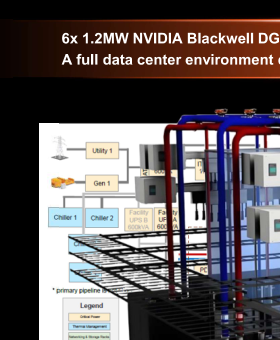
solutions/assets/src_pdf_pages/scrub/_qa/orig_ai10_cdu.png
