bruce2012lu/AIDCtms_design202609/solutions/assets/src_pdf_pages/scrub/_qa/orig_cc01_cab.png

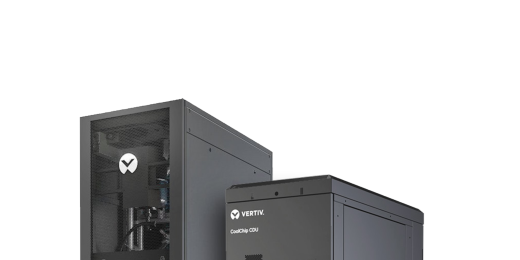
solutions/assets/src_pdf_pages/scrub/_qa/orig_cc01_cab.png
