bruce2012lu/AIDCtms_design202609/solutions/assets/src_pdf_pages/scrub/_qa/test_red_title.png

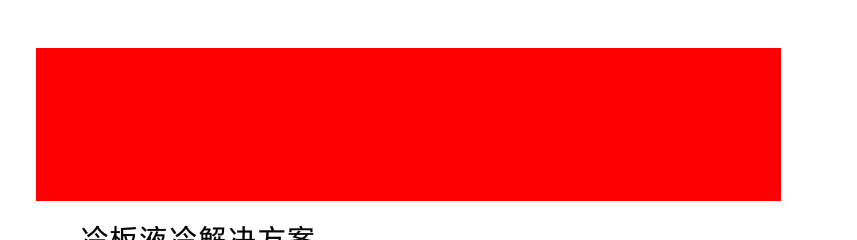
solutions/assets/src_pdf_pages/scrub/_qa/test_red_title.png
