bruce2012lu/AIDCtms_design202609/solutions/23 - How to get AI ready 重构AI算力工厂的液冷底座  - 0808.pdf

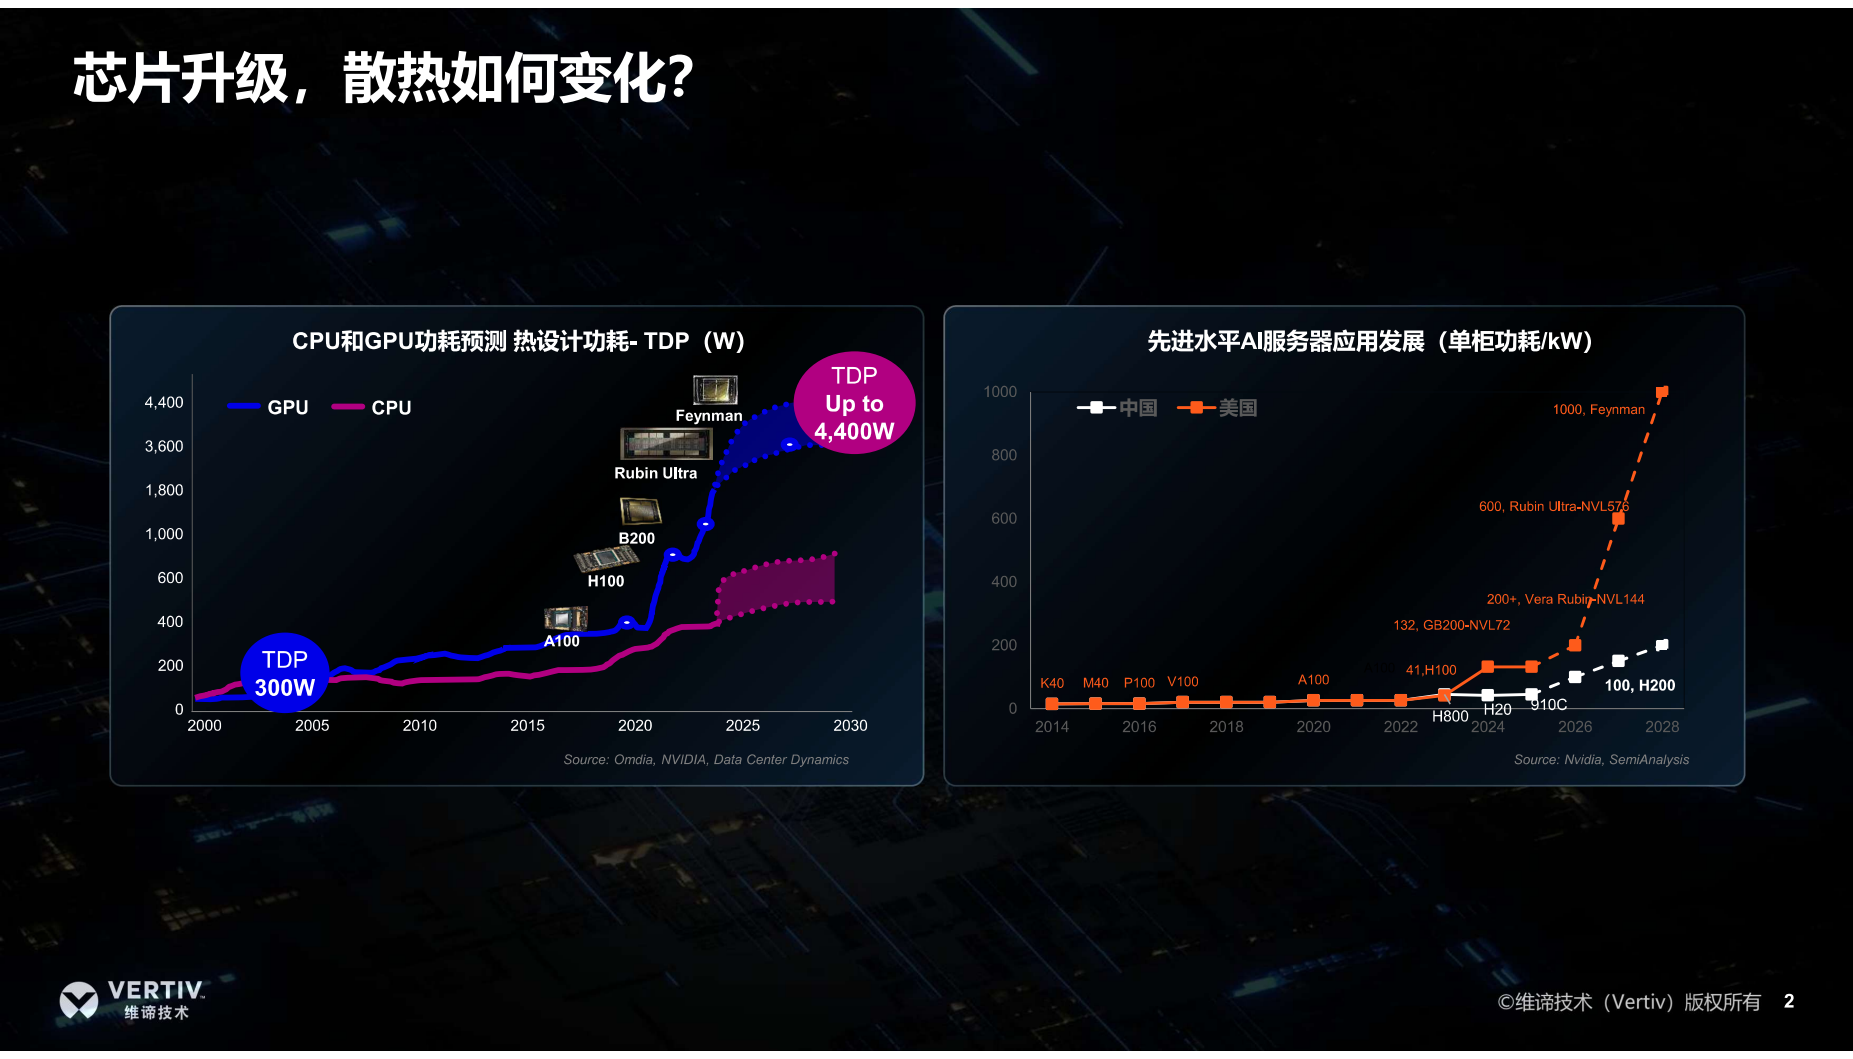
[picture p304: page 1]

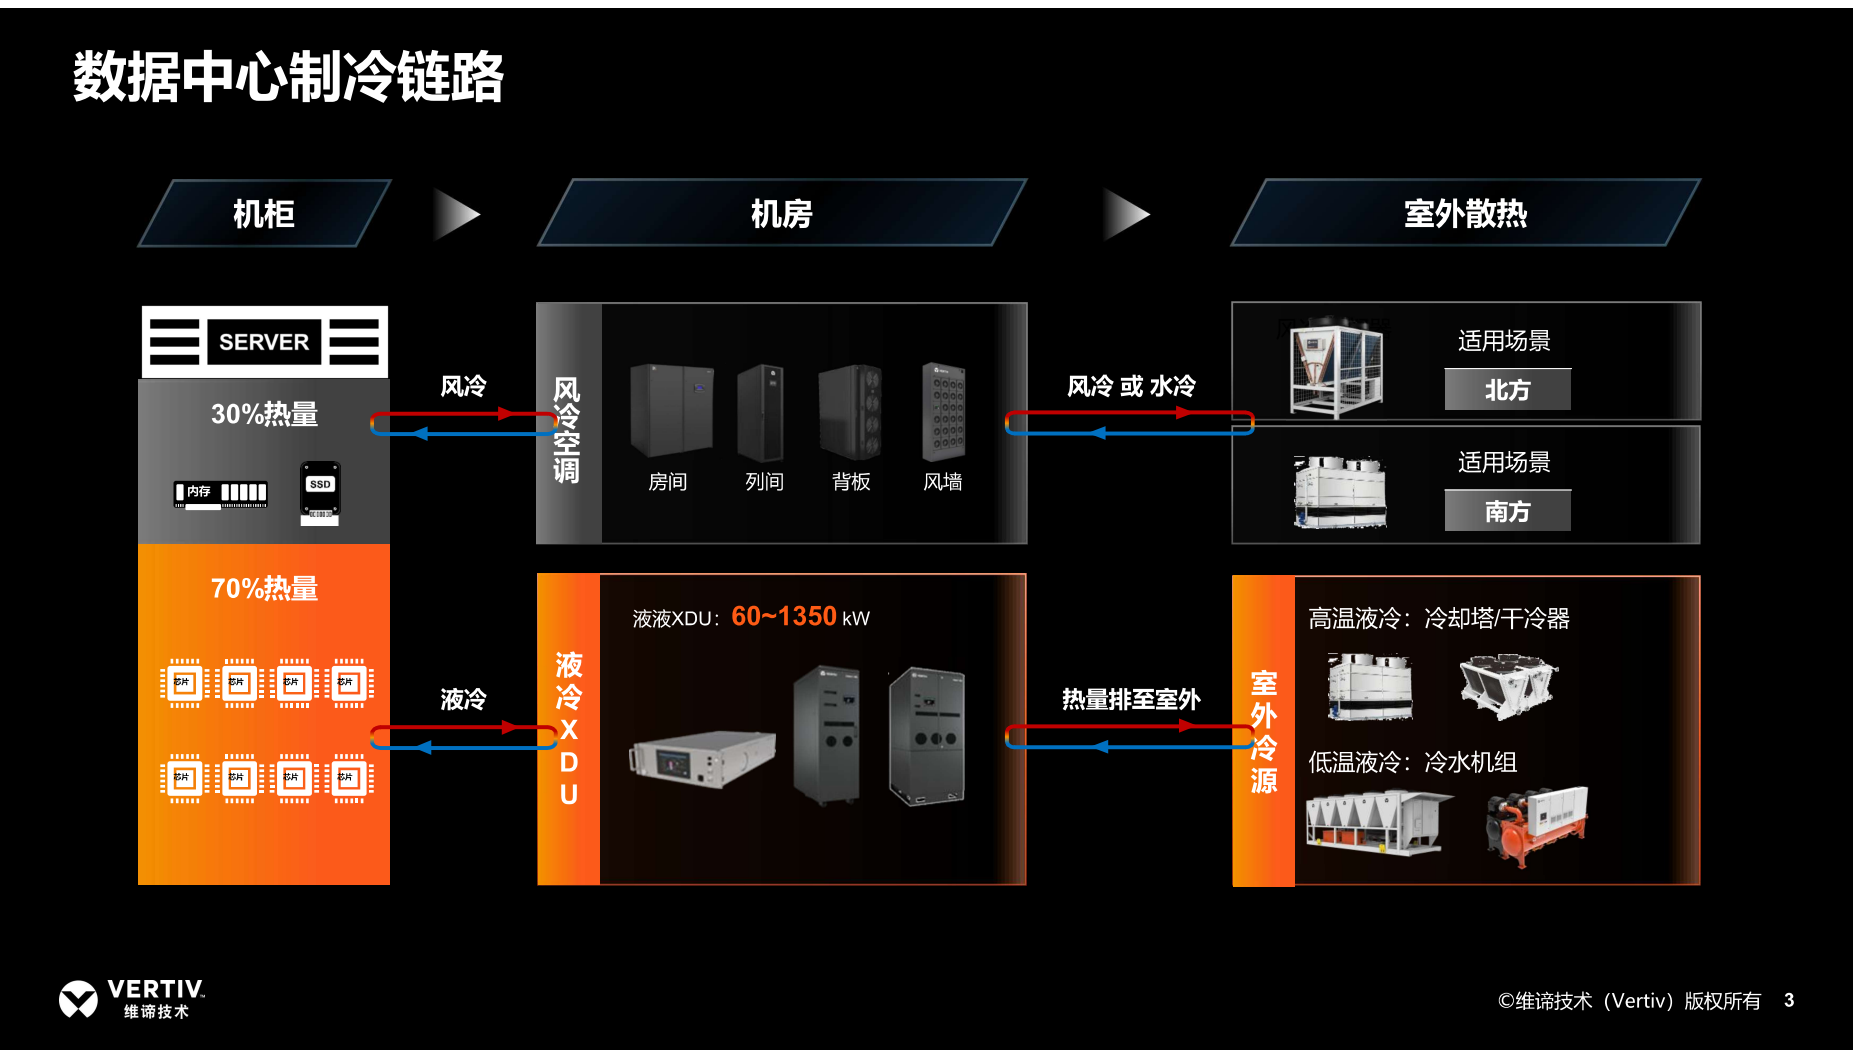
[picture p305: page 2]

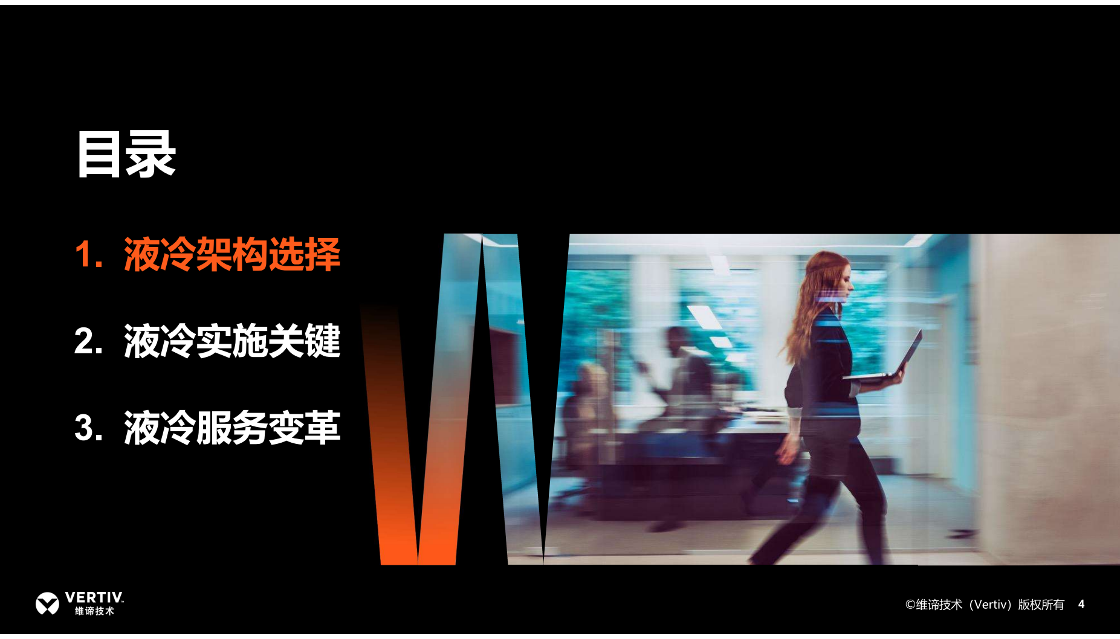
[picture p306: page 3]

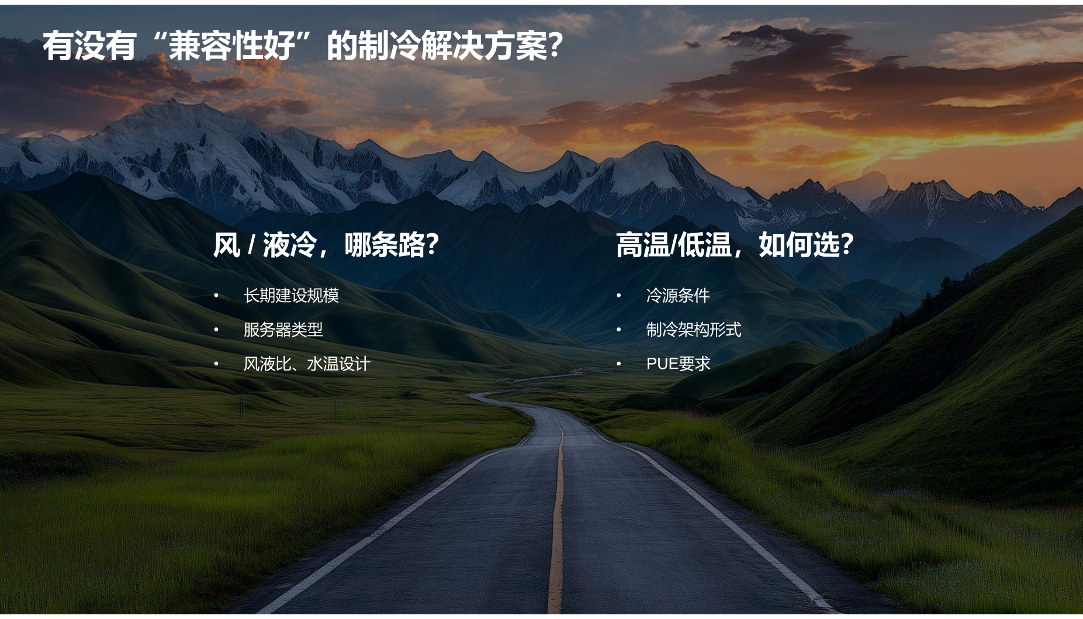
[picture p307: page 4]

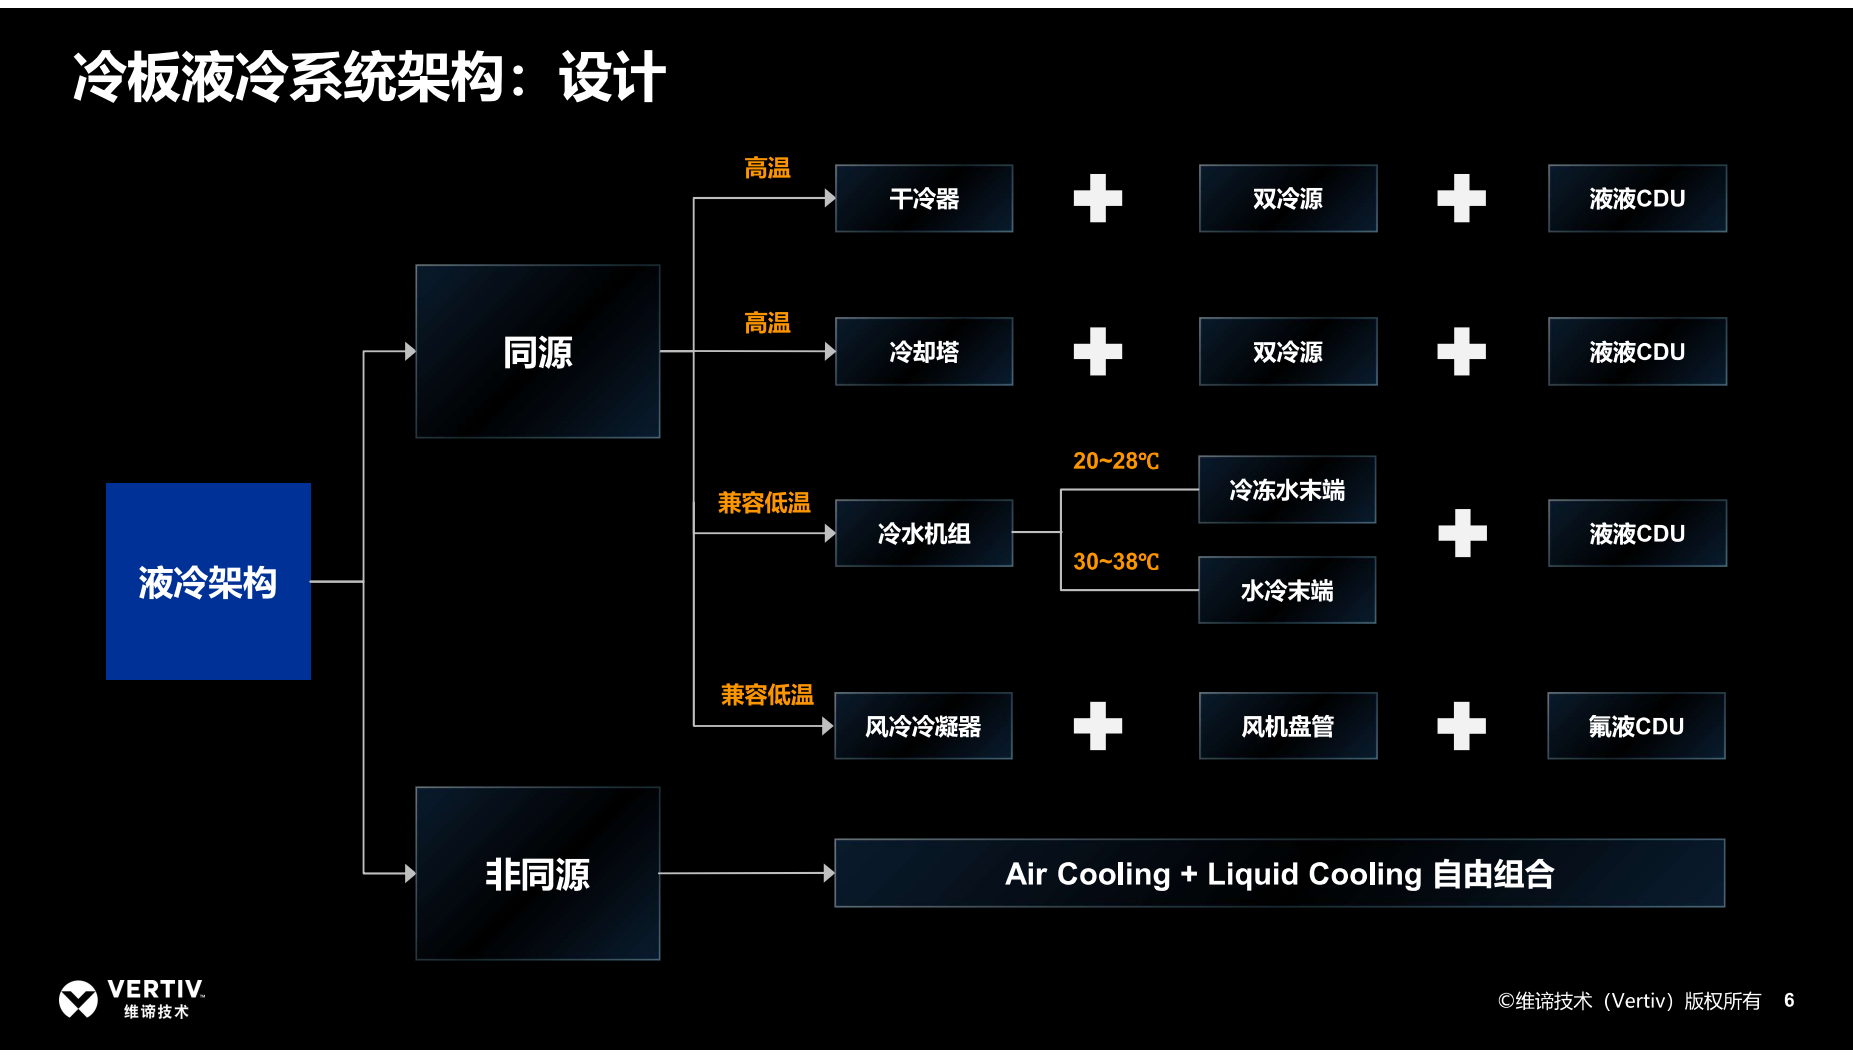
[picture p308: page 5]

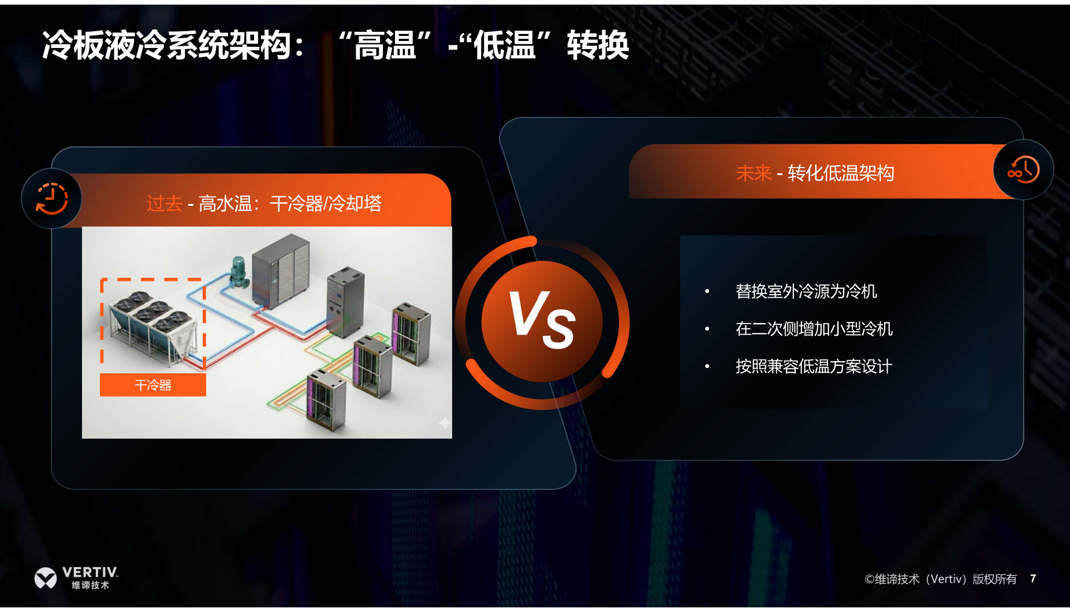
[picture p309: page 6]

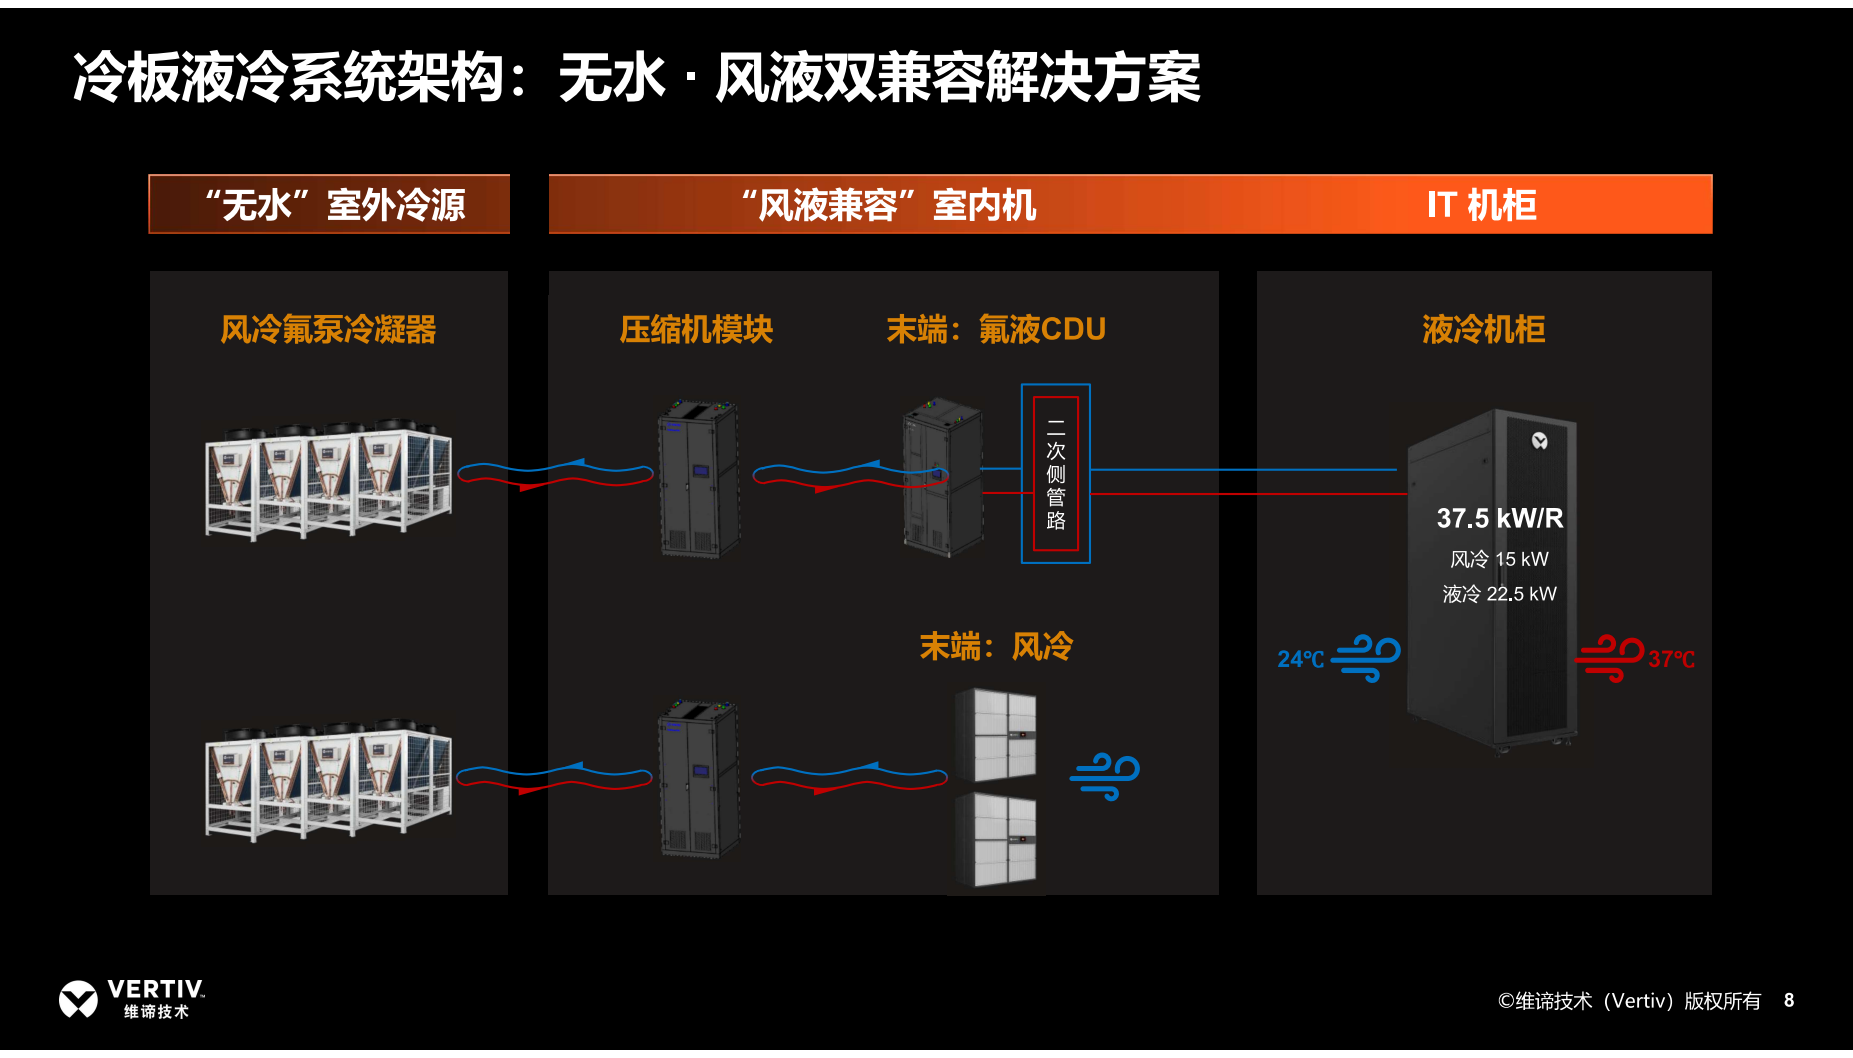
[picture p310: page 7]

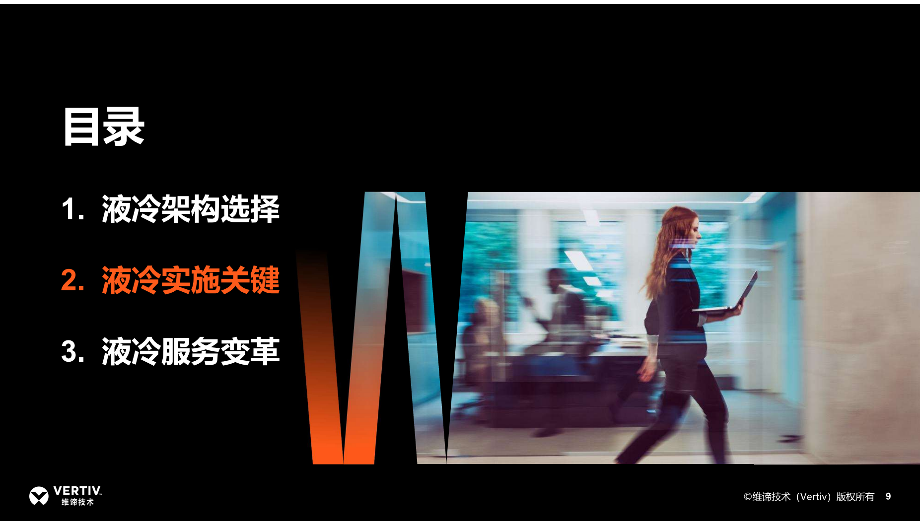
[picture p311: page 8]

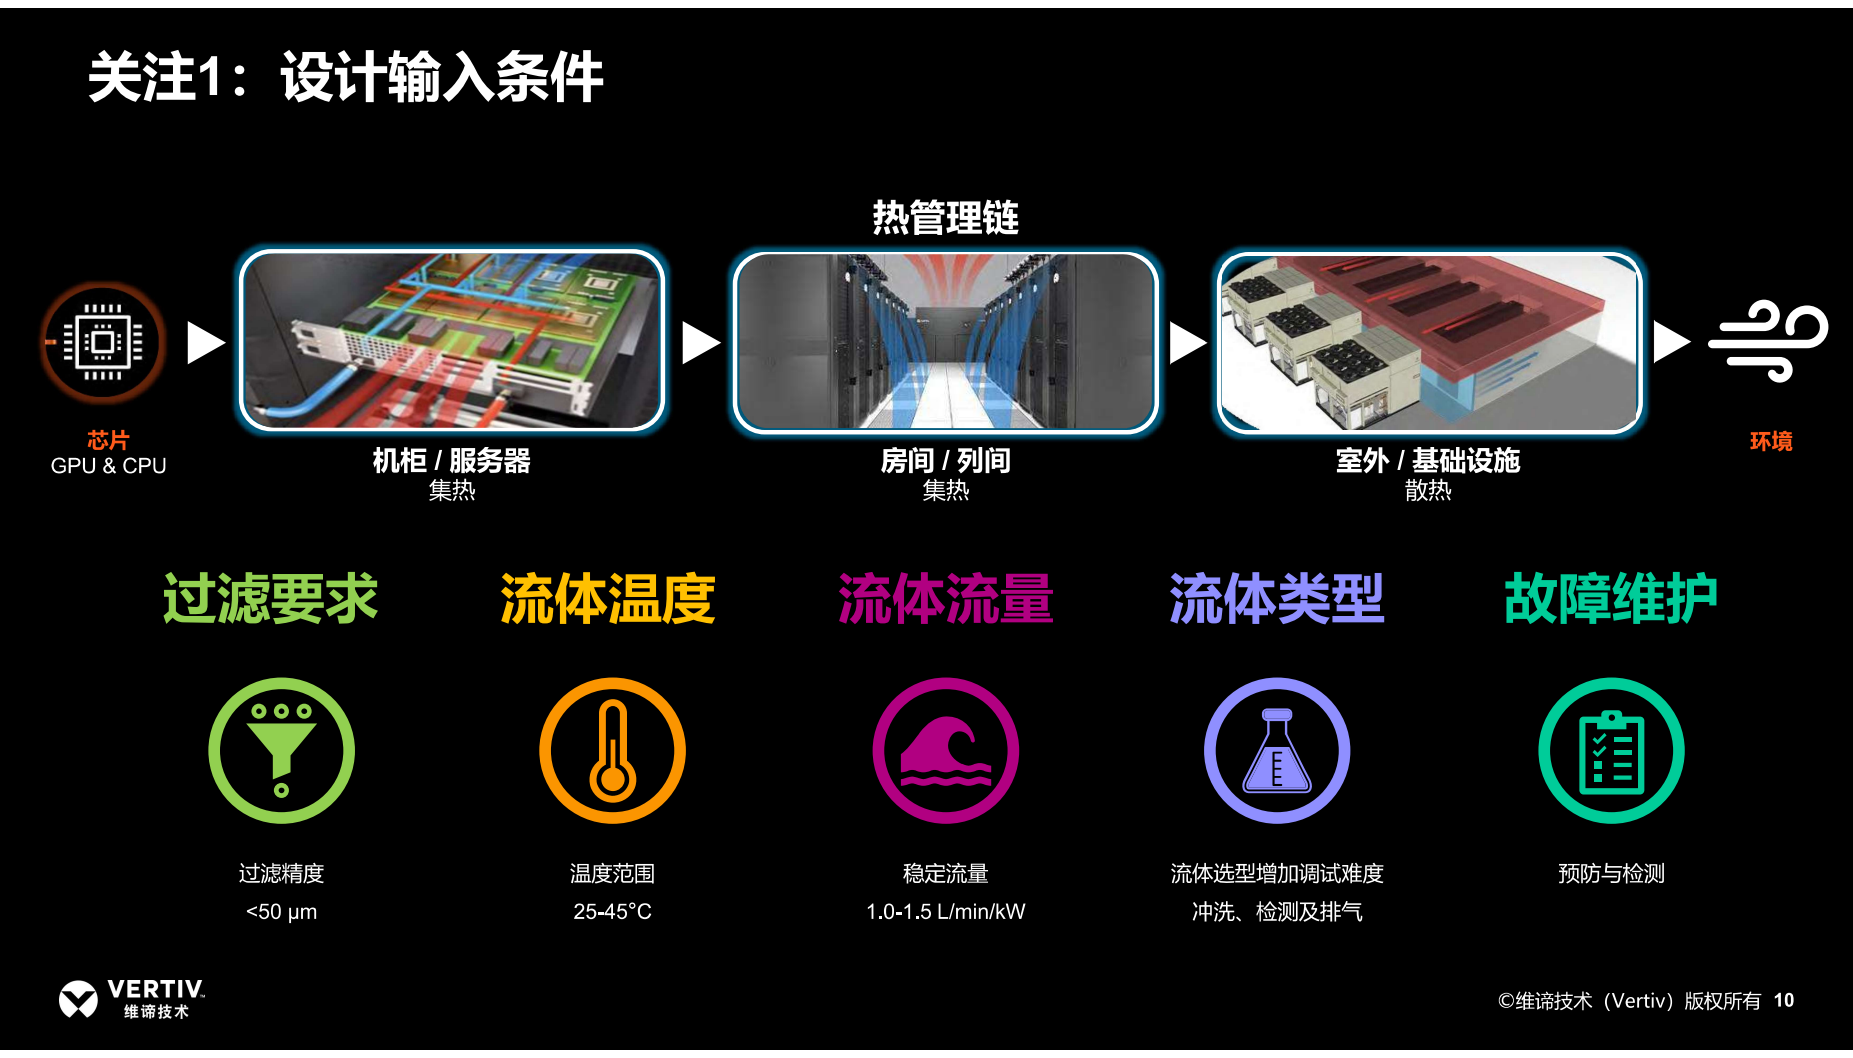
[picture p312: page 9]

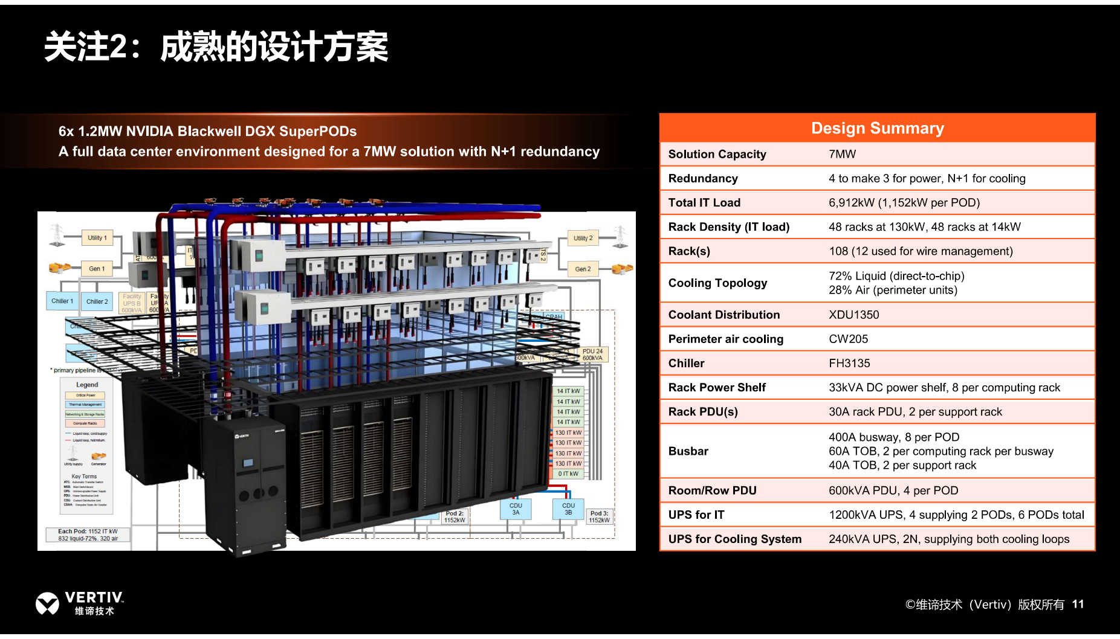
[picture p313: page 10]

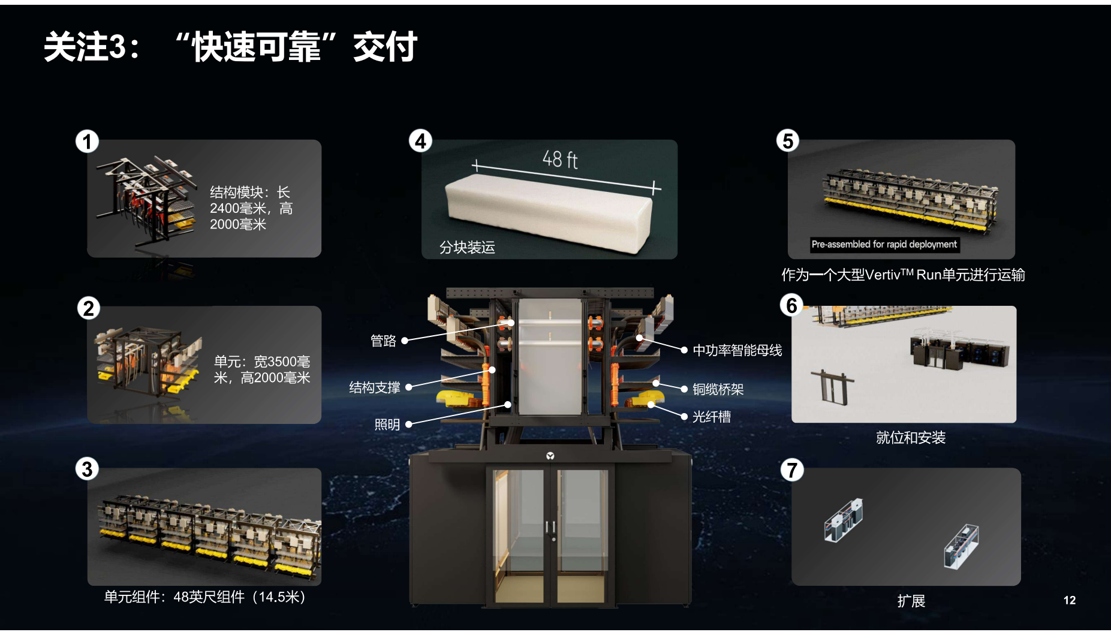
[picture p314: page 11]

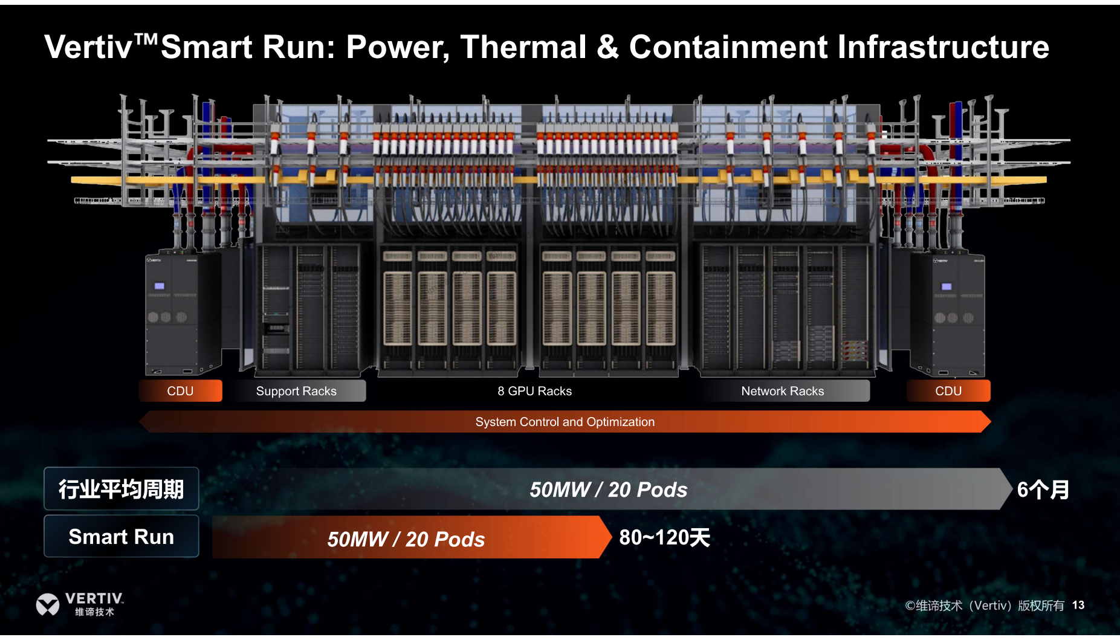
[picture p315: page 12]

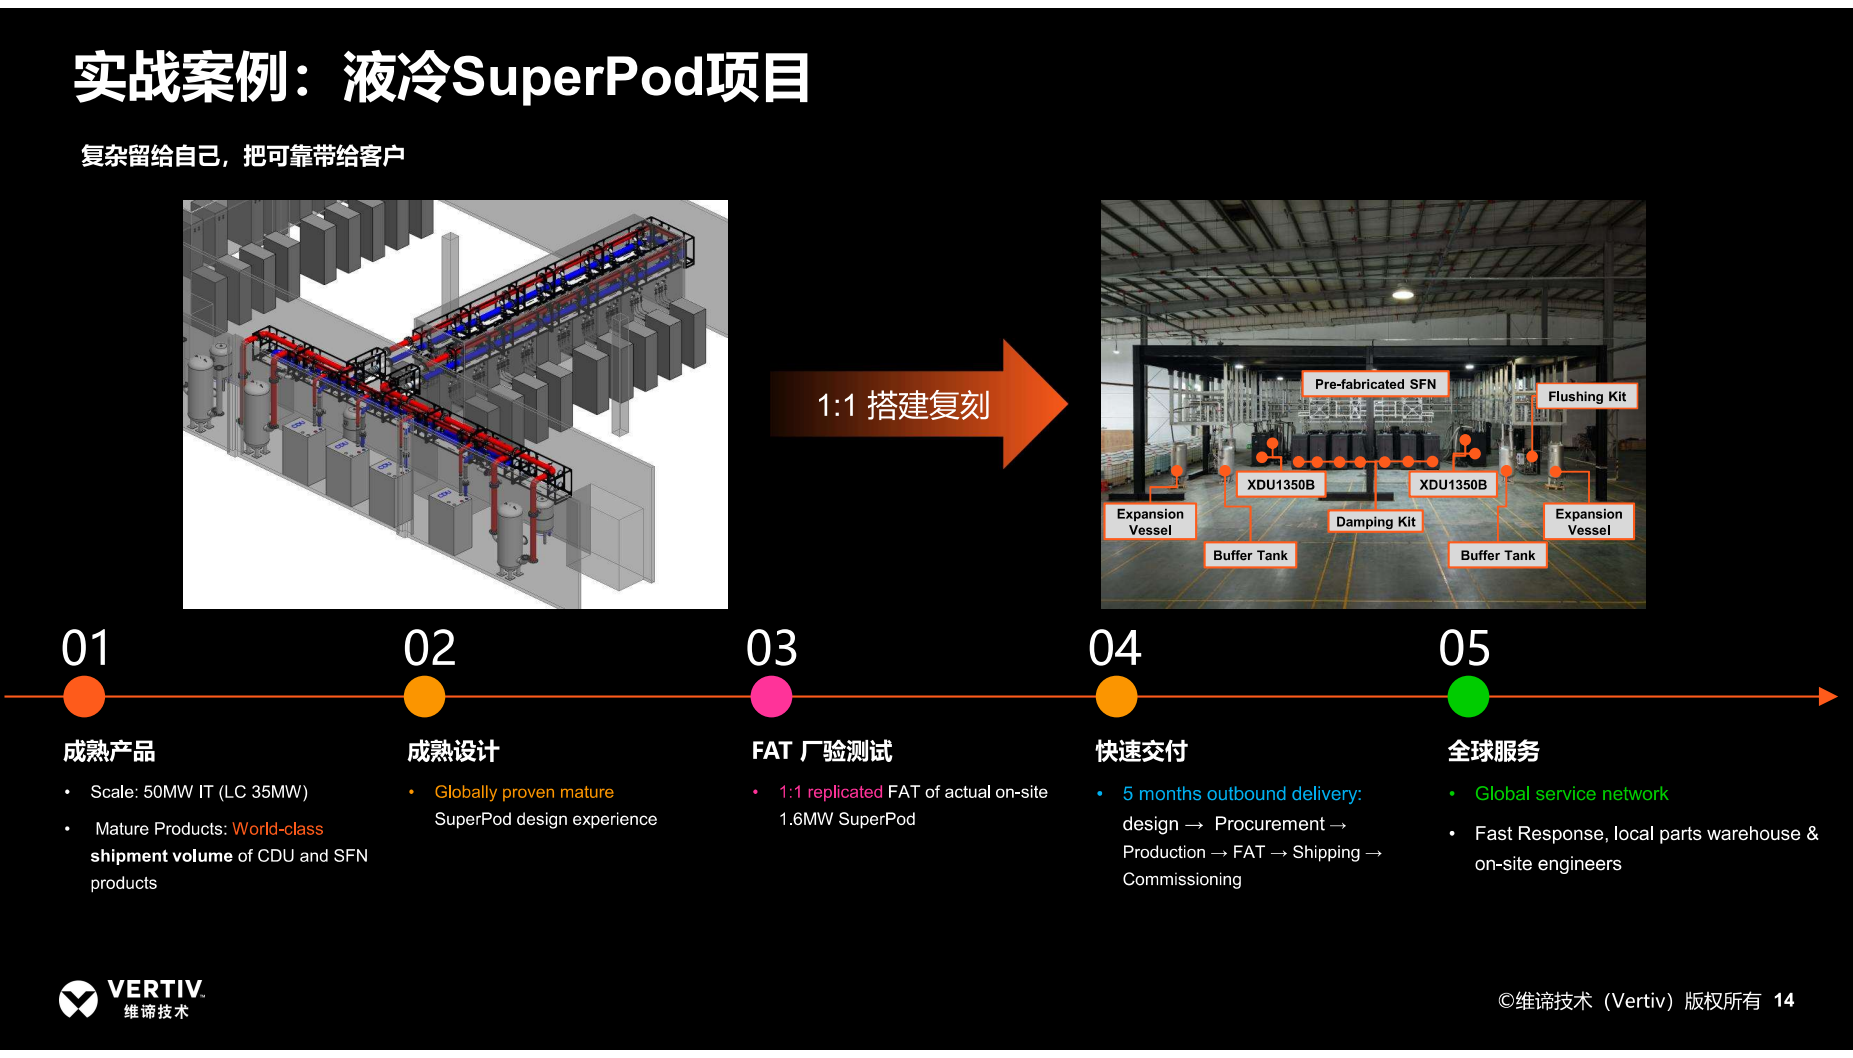
[picture p316: page 13]

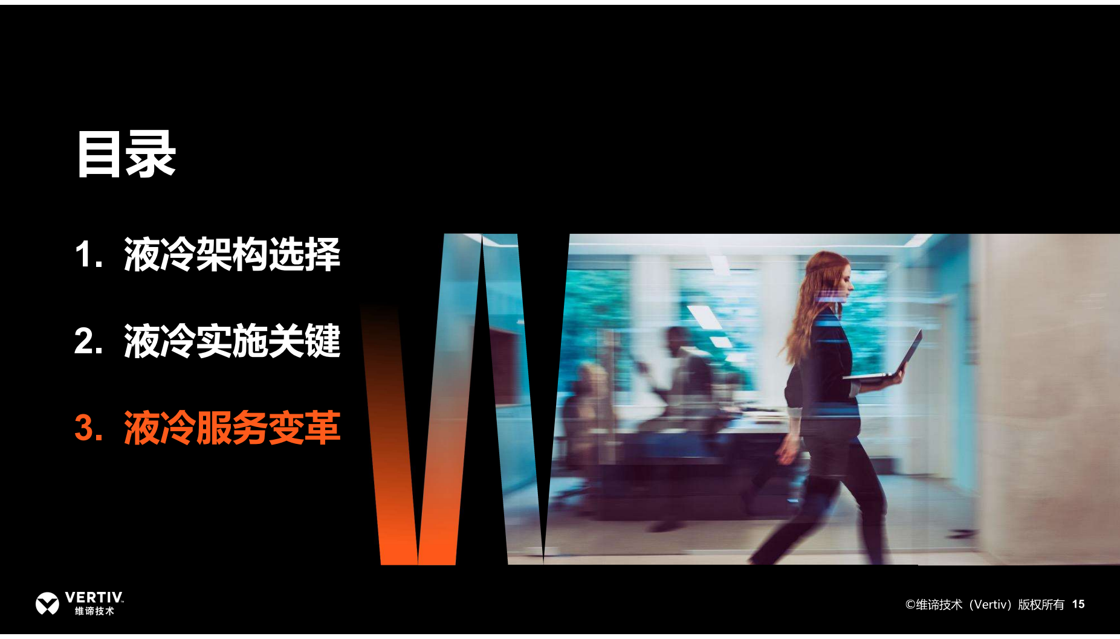
[picture p317: page 14]

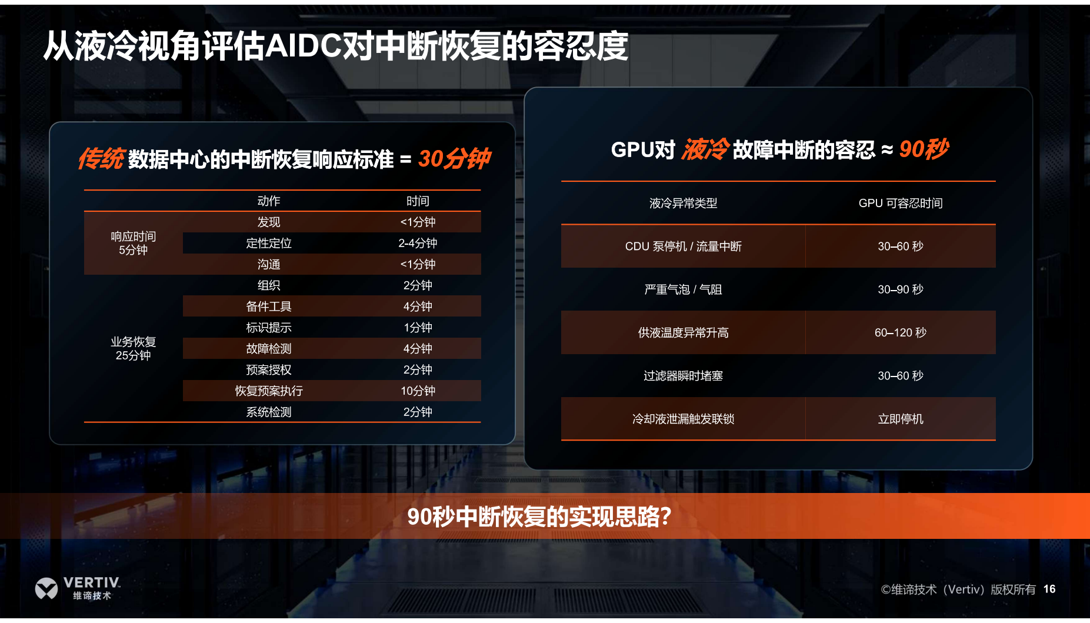
[picture p318: page 15]

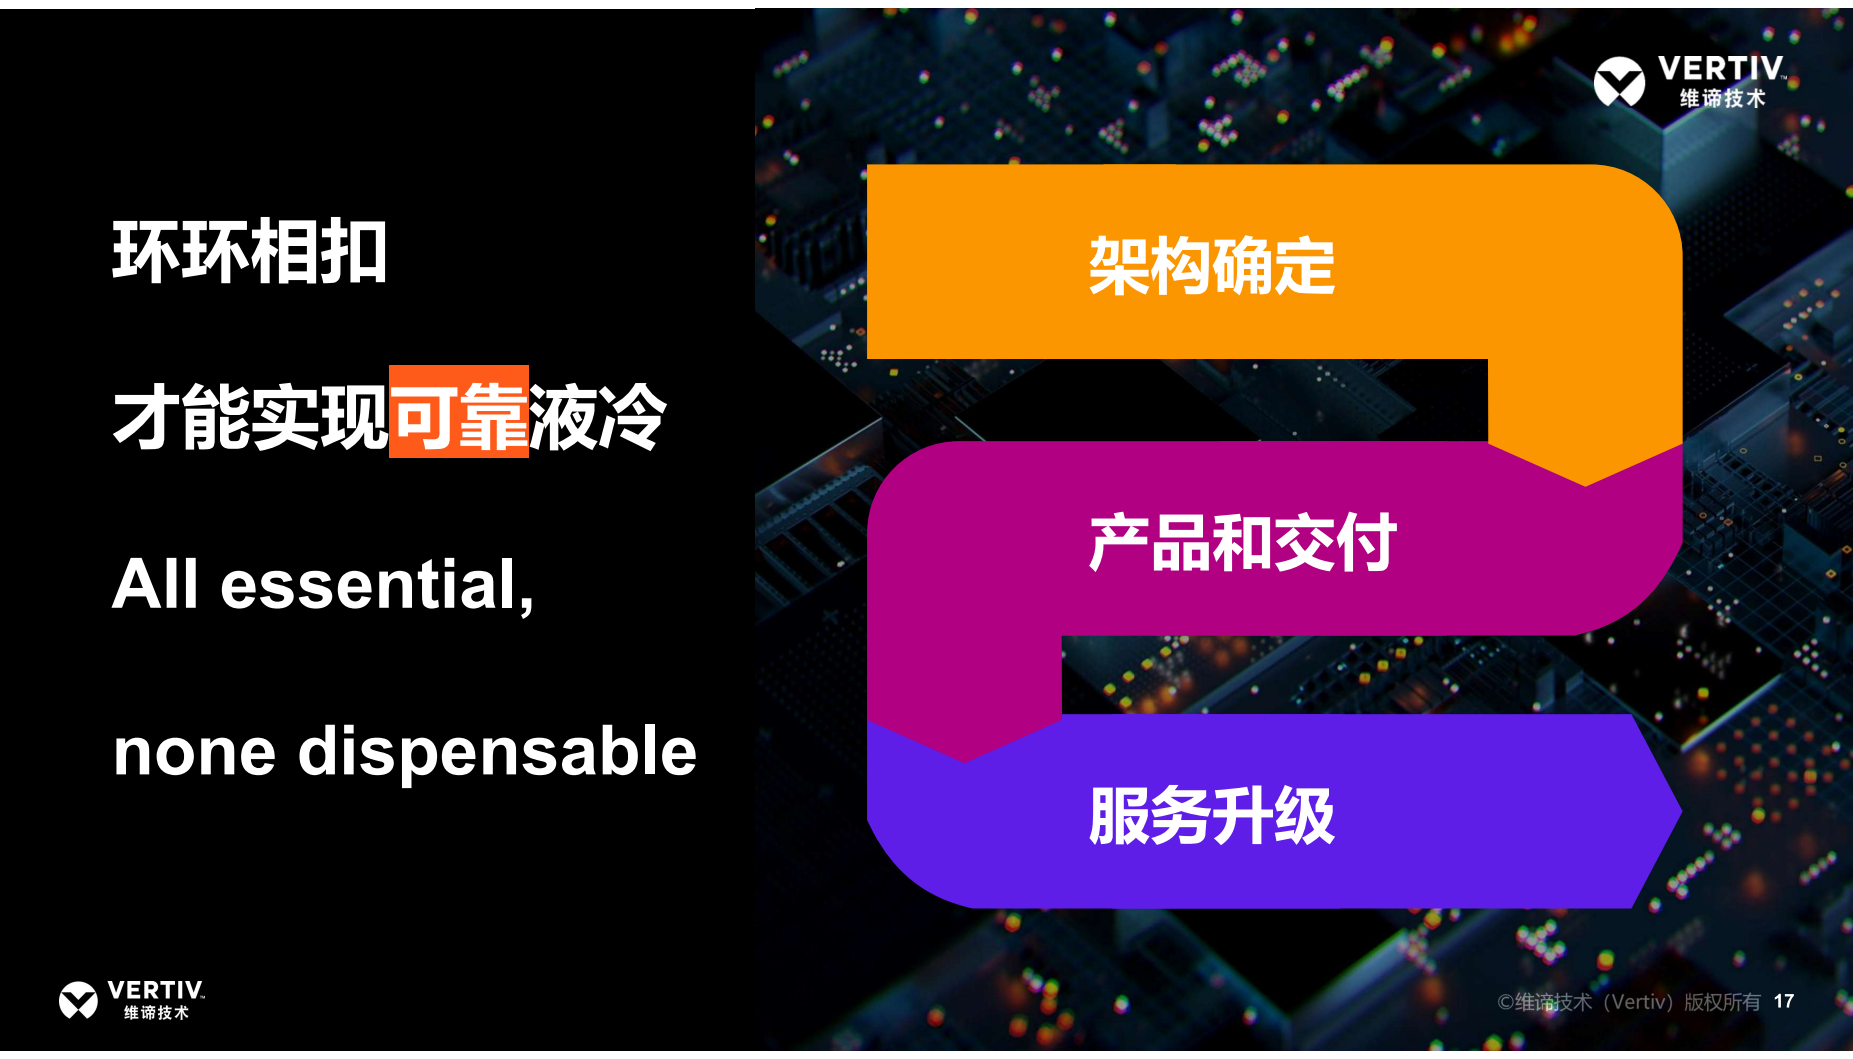
[picture p319: page 16]

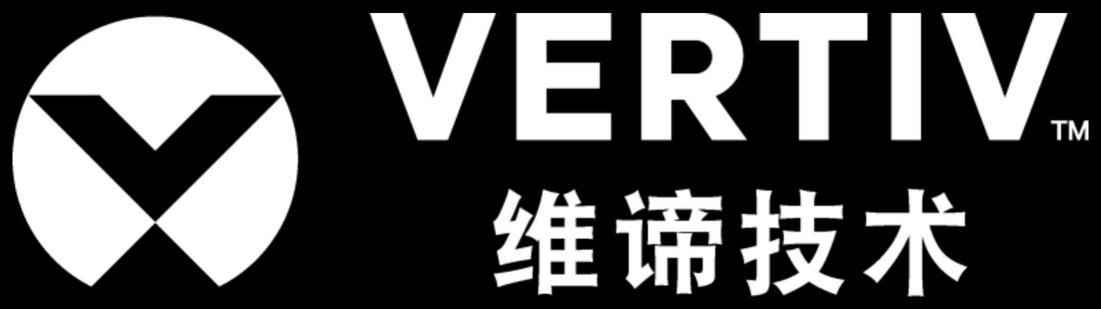
[picture p320: figure]
