bruce2012lu/AIDCtms_design202609/(commit log)

2026-10-02 feat(AIDCtms): 同步本地目录 1/278（.gitignore），排除超过 20MB 的单体文件
2026-10-02 feat(AIDCtms): 同步本地目录 2/278（20260906汇报），排除超过 20MB 的单体文件
2026-10-02 feat(AIDCtms): 同步本地目录 3/278（20260906汇报），排除超过 20MB 的单体文件
2026-10-02 feat(AIDCtms): 同步本地目录 4/278（Bp），排除超过 20MB 的单体文件
2026-10-02 feat(AIDCtms): 同步本地目录 5/278（Bp），排除超过 20MB 的单体文件
2026-10-02 feat(AIDCtms): 同步本地目录 6/278（Bp），排除超过 20MB 的单体文件
2026-10-02 feat(AIDCtms): 同步本地目录 7/278（Bp），排除超过 20MB 的单体文件
2026-10-02 feat(AIDCtms): 同步本地目录 8/278（Bp），排除超过 20MB 的单体文件
2026-10-02 feat(AIDCtms): 同步本地目录 9/278（Bp），排除超过 20MB 的单体文件
2026-10-02 feat(AIDCtms): 同步本地目录 10/278（Bp），排除超过 20MB 的单体文件
2026-10-02 feat(AIDCtms): 同步本地目录 11/278（Bp），排除超过 20MB 的单体文件
2026-10-02 feat(AIDCtms): 同步本地目录 12/278（Bp），排除超过 20MB 的单体文件
2026-10-02 feat(AIDCtms): 同步本地目录 13/278（Bp），排除超过 20MB 的单体文件
2026-10-02 feat(AIDCtms): 同步本地目录 14/278（Bp），排除超过 20MB 的单体文件
2026-10-02 feat(AIDCtms): 同步本地目录 15/278（Bp），排除超过 20MB 的单体文件
2026-10-02 feat(AIDCtms): 同步本地目录 16/278（Bp），排除超过 20MB 的单体文件
2026-10-02 feat(AIDCtms): 同步本地目录 17/278（Bp），排除超过 20MB 的单体文件
2026-10-02 feat(AIDCtms): 同步本地目录 18/278（Bp），排除超过 20MB 的单体文件
    [cell_d040_assembly.step, cell_d040_base.step, cell_d040_lid.step, cell_d050_assembly.step, cell_d050_base.step, cell_d050_lid.step]
2026-10-02 feat(AIDCtms): 同步本地目录 19/278（coolingplate），排除超过 20MB 的单体文件
    [plate_assembly.step]
2026-10-02 feat(AIDCtms): 同步本地目录 20/278（coolingplate），排除超过 20MB 的单体文件
    [plate_base.step]
2026-10-02 feat(AIDCtms): 同步本地目录 21/278（coolingplate），排除超过 20MB 的单体文件
    [plate_nozzle.step, plate_seal.step]
2026-10-02 feat(AIDCtms): 同步本地目录 22/278（coolingplate），排除超过 20MB 的单体文件
2026-10-02 feat(AIDCtms): 同步本地目录 23/278（coolingplate），排除超过 20MB 的单体文件
2026-10-02 feat(AIDCtms): 同步本地目录 24/278（coolingplate），排除超过 20MB 的单体文件
2026-10-02 feat(AIDCtms): 同步本地目录 25/278（coolingplate），排除超过 20MB 的单体文件
2026-10-02 feat(AIDCtms): 同步本地目录 26/278（coolingplate），排除超过 20MB 的单体文件
2026-10-02 feat(AIDCtms): 同步本地目录 27/278（coolingplate），排除超过 20MB 的单体文件
2026-10-02 feat(AIDCtms): 同步本地目录 28/278（coolingplate），排除超过 20MB 的单体文件
2026-10-02 feat(AIDCtms): 同步本地目录 29/278（coolingplate），排除超过 20MB 的单体文件
2026-10-02 feat(AIDCtms): 同步本地目录 30/278（coolingplate），排除超过 20MB 的单体文件
2026-10-02 feat(AIDCtms): 同步本地目录 31/278（coolingplate），排除超过 20MB 的单体文件
2026-10-02 feat(AIDCtms): 同步本地目录 32/278（coolingplate），排除超过 20MB 的单体文件
2026-10-02 feat(AIDCtms): 同步本地目录 33/278（coolingplate），排除超过 20MB 的单体文件
2026-10-02 feat(AIDCtms): 同步本地目录 34/278（coolingplate），排除超过 20MB 的单体文件
2026-10-02 feat(AIDCtms): 同步本地目录 35/278（coolingplate），排除超过 20MB 的单体文件
2026-10-02 feat(AIDCtms): 同步本地目录 36/278（coolingplate），排除超过 20MB 的单体文件
2026-10-02 feat(AIDCtms): 同步本地目录 37/278（coolingplate），排除超过 20MB 的单体文件
2026-10-02 feat(AIDCtms): 同步本地目录 38/278（coolingplate），排除超过 20MB 的单体文件
2026-10-02 feat(AIDCtms): 同步本地目录 39/278（coolingplate），排除超过 20MB 的单体文件
2026-10-02 feat(AIDCtms): 同步本地目录 40/278（coolingplate），排除超过 20MB 的单体文件
2026-10-02 feat(AIDCtms): 同步本地目录 41/278（coolingplate），排除超过 20MB 的单体文件
2026-10-02 feat(AIDCtms): 同步本地目录 42/278（coolingplate），排除超过 20MB 的单体文件
2026-10-02 feat(AIDCtms): 同步本地目录 43/278（coolingplate），排除超过 20MB 的单体文件
2026-10-02 feat(AIDCtms): 同步本地目录 44/278（coolingplate），排除超过 20MB 的单体文件
2026-10-02 feat(AIDCtms): 同步本地目录 45/278（coolingplate），排除超过 20MB 的单体文件
2026-10-02 feat(AIDCtms): 同步本地目录 46/278（coolingplate），排除超过 20MB 的单体文件
2026-10-02 feat(AIDCtms): 同步本地目录 47/278（coolingplate），排除超过 20MB 的单体文件
2026-10-02 feat(AIDCtms): 同步本地目录 48/278（coolingplate），排除超过 20MB 的单体文件
2026-10-02 feat(AIDCtms): 同步本地目录 49/278（coolingplate），排除超过 20MB 的单体文件
2026-10-02 feat(AIDCtms): 同步本地目录 50/278（coolingplate），排除超过 20MB 的单体文件
2026-10-02 feat(AIDCtms): 同步本地目录 51/278（coolingplate），排除超过 20MB 的单体文件
2026-10-02 feat(AIDCtms): 同步本地目录 52/278（coolingplate），排除超过 20MB 的单体文件
2026-10-02 feat(AIDCtms): 同步本地目录 53/278（coolingplate），排除超过 20MB 的单体文件
2026-10-02 feat(AIDCtms): 同步本地目录 54/278（coolingplate），排除超过 20MB 的单体文件
2026-10-02 feat(AIDCtms): 同步本地目录 55/278（coolingplate），排除超过 20MB 的单体文件
2026-10-02 feat(AIDCtms): 同步本地目录 56/278（coolingplate），排除超过 20MB 的单体文件
2026-10-02 feat(AIDCtms): 同步本地目录 57/278（coolingplate），排除超过 20MB 的单体文件
2026-10-02 feat(AIDCtms): 同步本地目录 58/278（coolingplate），排除超过 20MB 的单体文件
2026-10-02 feat(AIDCtms): 同步本地目录 59/278（coolingplate），排除超过 20MB 的单体文件
2026-10-02 feat(AIDCtms): 同步本地目录 60/278（coolingplate），排除超过 20MB 的单体文件
2026-10-02 feat(AIDCtms): 同步本地目录 61/278（coolingplate），排除超过 20MB 的单体文件
2026-10-02 feat(AIDCtms): 同步本地目录 62/278（coolingplate），排除超过 20MB 的单体文件
2026-10-02 feat(AIDCtms): 同步本地目录 63/278（coolingplate），排除超过 20MB 的单体文件
2026-10-02 feat(AIDCtms): 同步本地目录 64/278（coolingplate），排除超过 20MB 的单体文件
2026-10-02 feat(AIDCtms): 同步本地目录 65/278（coolingplate），排除超过 20MB 的单体文件
2026-10-02 feat(AIDCtms): 同步本地目录 66/278（coolingplate），排除超过 20MB 的单体文件
2026-10-02 feat(AIDCtms): 同步本地目录 67/278（coolingplate），排除超过 20MB 的单体文件
2026-10-02 feat(AIDCtms): 同步本地目录 68/278（coolingplate），排除超过 20MB 的单体文件
2026-10-02 feat(AIDCtms): 同步本地目录 69/278（coolingplate），排除超过 20MB 的单体文件
2026-10-02 feat(AIDCtms): 同步本地目录 70/278（coolingplate），排除超过 20MB 的单体文件
2026-10-02 feat(AIDCtms): 同步本地目录 71/278（coolingplate），排除超过 20MB 的单体文件
2026-10-02 feat(AIDCtms): 同步本地目录 72/278（coolingplate），排除超过 20MB 的单体文件
2026-10-02 feat(AIDCtms): 同步本地目录 73/278（coolingplate），排除超过 20MB 的单体文件
2026-10-02 feat(AIDCtms): 同步本地目录 74/278（coolingplate），排除超过 20MB 的单体文件
2026-10-02 feat(AIDCtms): 同步本地目录 75/278（coolingplate），排除超过 20MB 的单体文件
2026-10-02 feat(AIDCtms): 同步本地目录 76/278（coolingplate），排除超过 20MB 的单体文件
2026-10-02 feat(AIDCtms): 同步本地目录 77/278（coolingplate），排除超过 20MB 的单体文件
2026-10-02 feat(AIDCtms): 同步本地目录 78/278（coolingplate），排除超过 20MB 的单体文件
2026-10-02 feat(AIDCtms): 同步本地目录 79/278（coolingplate），排除超过 20MB 的单体文件
2026-10-02 feat(AIDCtms): 同步本地目录 80/278（coolingplate），排除超过 20MB 的单体文件
2026-10-02 feat(AIDCtms): 同步本地目录 81/278（coolingplate），排除超过 20MB 的单体文件
2026-10-02 feat(AIDCtms): 同步本地目录 82/278（coolingplate），排除超过 20MB 的单体文件
2026-10-02 feat(AIDCtms): 同步本地目录 83/278（coolingplate），排除超过 20MB 的单体文件
2026-10-02 feat(AIDCtms): 同步本地目录 84/278（coolingplate），排除超过 20MB 的单体文件
2026-10-02 feat(AIDCtms): 同步本地目录 85/278（coolingplate），排除超过 20MB 的单体文件
2026-10-02 feat(AIDCtms): 同步本地目录 86/278（coolingplate），排除超过 20MB 的单体文件
2026-10-02 feat(AIDCtms): 同步本地目录 87/278（coolingplate），排除超过 20MB 的单体文件
2026-10-02 feat(AIDCtms): 同步本地目录 88/278（coolingplate），排除超过 20MB 的单体文件
2026-10-02 feat(AIDCtms): 同步本地目录 89/278（coolingplate），排除超过 20MB 的单体文件
2026-10-02 feat(AIDCtms): 同步本地目录 90/278（coolingplate），排除超过 20MB 的单体文件
2026-10-02 feat(AIDCtms): 同步本地目录 91/278（coolingplate），排除超过 20MB 的单体文件
2026-10-02 feat(AIDCtms): 同步本地目录 92/278（coolingplate），排除超过 20MB 的单体文件
2026-10-02 feat(AIDCtms): 同步本地目录 93/278（coolingplate），排除超过 20MB 的单体文件
2026-10-02 feat(AIDCtms): 同步本地目录 94/278（coolingplate），排除超过 20MB 的单体文件
2026-10-02 feat(AIDCtms): 同步本地目录 95/278（coolingplate），排除超过 20MB 的单体文件
2026-10-02 feat(AIDCtms): 同步本地目录 96/278（coolingplate），排除超过 20MB 的单体文件
2026-10-02 feat(AIDCtms): 同步本地目录 97/278（coolingplate），排除超过 20MB 的单体文件
2026-10-02 feat(AIDCtms): 同步本地目录 98/278（coolingplate），排除超过 20MB 的单体文件
2026-10-02 feat(AIDCtms): 同步本地目录 99/278（coolingplate），排除超过 20MB 的单体文件
2026-10-02 feat(AIDCtms): 同步本地目录 100/278（coolingplate），排除超过 20MB 的单体文件
2026-10-02 feat(AIDCtms): 同步本地目录 101/278（coolingplate），排除超过 20MB 的单体文件
2026-10-02 feat(AIDCtms): 同步本地目录 102/278（coolingplate），排除超过 20MB 的单体文件
2026-10-02 feat(AIDCtms): 同步本地目录 103/278（coolingplate），排除超过 20MB 的单体文件
2026-10-02 feat(AIDCtms): 同步本地目录 104/278（coolingplate），排除超过 20MB 的单体文件
    [asm_0921.stp]
2026-10-02 feat(AIDCtms): 同步本地目录 105/278（coolingplate），排除超过 20MB 的单体文件
    [CP-B300-JM-01_JM01-100_base_plate.step]
2026-10-02 feat(AIDCtms): 同步本地目录 106/278（coolingplate），排除超过 20MB 的单体文件
    [CP-B300-JM-01_JM01-200_nozzle_plate.step, CP-B300-JM-01_JM01-400_seal_frame.step]
2026-10-02 feat(AIDCtms): 同步本地目录 107/278（coolingplate），排除超过 20MB 的单体文件
    [CP-B300-JM-01_assembly.step]
2026-10-02 feat(AIDCtms): 同步本地目录 108/278（coolingplate），排除超过 20MB 的单体文件
    [CP-B300-JM-01_assembly.stl]
2026-10-02 feat(AIDCtms): 同步本地目录 109/278（coolingplate），排除超过 20MB 的单体文件
    [CP-B300-JM-01_top_view.dxf]
2026-10-02 feat(AIDCtms): 同步本地目录 110/278（coolingplate），排除超过 20MB 的单体文件
    [plate_cu.stp, plate_die.stp, plate_hbm.stp, plate_pkg.stp, plate_return.stp, plate_supply.stp]
2026-10-02 feat(AIDCtms): 同步本地目录 111/278（coolingplate），排除超过 20MB 的单体文件
    [tray_gpu.stp, tray_grace.stp, tray_pcb.stp, tray_rear.stp, tray_return.stp, tray_supply.stp]
2026-10-02 feat(AIDCtms): 同步本地目录 112/278（coolingplate），排除超过 20MB 的单体文件
2026-10-02 feat(AIDCtms): 同步本地目录 113/278（coolingplate），排除超过 20MB 的单体文件
    [GB300_冷板液冷热量与流量分配表_PG25_20260929.xlsx, GPU_射流冲击微通道冷板_尺寸核实2计算.xlsx, GPU射流冲击微通道冷板_尺寸核实2.xlsx, GraceCPU冷板_尺寸核实2.xlsx, Grace_CPU冷板_尺寸核实2计算.xlsx, HBM_微通道冷板_尺寸核实2计算.xlsx, HBM微通道冷板_1D设计计算_20260929.xlsx, HBM微通道冷板_尺寸核实2.xlsx]
2026-10-02 feat(AIDCtms): 同步本地目录 114/278（coolingplate），排除超过 20MB 的单体文件
2026-10-02 feat(AIDCtms): 同步本地目录 115/278（coolingplate），排除超过 20MB 的单体文件
    [01_DR0_输入追溯.xlsx, 02_DR1_方案权衡.xlsx, 03_DR2_一维性能核算.xlsx, 04_DR3_仿真图纸与试验门.xlsx]
2026-10-02 feat(AIDCtms): 同步本地目录 116/278（coolingplate），排除超过 20MB 的单体文件
2026-10-02 feat(AIDCtms): 同步本地目录 117/278（coolingplate），排除超过 20MB 的单体文件
2026-10-02 feat(AIDCtms): 同步本地目录 118/278（coolingplate），排除超过 20MB 的单体文件
2026-10-02 feat(AIDCtms): 同步本地目录 119/278（coolingplate），排除超过 20MB 的单体文件
2026-10-02 feat(AIDCtms): 同步本地目录 120/278（coolingplate），排除超过 20MB 的单体文件
2026-10-02 feat(AIDCtms): 同步本地目录 121/278（coolingplate），排除超过 20MB 的单体文件
2026-10-02 feat(AIDCtms): 同步本地目录 122/278（coolingplate），排除超过 20MB 的单体文件
2026-10-02 feat(AIDCtms): 同步本地目录 123/278（coolingplate），排除超过 20MB 的单体文件
2026-10-02 feat(AIDCtms): 同步本地目录 124/278（coolingplate），排除超过 20MB 的单体文件
2026-10-02 feat(AIDCtms): 同步本地目录 125/278（coolingplate），排除超过 20MB 的单体文件
2026-10-02 feat(AIDCtms): 同步本地目录 126/278（coolingplate），排除超过 20MB 的单体文件
2026-10-02 feat(AIDCtms): 同步本地目录 127/278（coolingplate），排除超过 20MB 的单体文件
2026-10-02 feat(AIDCtms): 同步本地目录 128/278（coolingplate），排除超过 20MB 的单体文件
2026-10-02 feat(AIDCtms): 同步本地目录 129/278（coolingplate），排除超过 20MB 的单体文件
2026-10-02 feat(AIDCtms): 同步本地目录 130/278（coolingplate），排除超过 20MB 的单体文件
2026-10-02 feat(AIDCtms): 同步本地目录 131/278（coolingplate），排除超过 20MB 的单体文件
2026-10-02 feat(AIDCtms): 同步本地目录 132/278（coolingplate），排除超过 20MB 的单体文件
2026-10-02 feat(AIDCtms): 同步本地目录 133/278（coolingplate），排除超过 20MB 的单体文件
2026-10-02 feat(AIDCtms): 同步本地目录 134/278（coolingplate），排除超过 20MB 的单体文件
2026-10-02 feat(AIDCtms): 同步本地目录 135/278（coolingplate），排除超过 20MB 的单体文件
2026-10-02 feat(AIDCtms): 同步本地目录 136/278（coolingplate），排除超过 20MB 的单体文件
2026-10-02 feat(AIDCtms): 同步本地目录 137/278（coolingplate），排除超过 20MB 的单体文件
2026-10-02 feat(AIDCtms): 同步本地目录 138/278（coolingplate），排除超过 20MB 的单体文件
2026-10-02 feat(AIDCtms): 同步本地目录 139/278（coolingplate），排除超过 20MB 的单体文件
2026-10-02 feat(AIDCtms): 同步本地目录 140/278（coolingplate），排除超过 20MB 的单体文件
2026-10-02 feat(AIDCtms): 同步本地目录 141/278（coolingplate），排除超过 20MB 的单体文件
2026-10-02 feat(AIDCtms): 同步本地目录 142/278（coolingplate），排除超过 20MB 的单体文件
2026-10-02 feat(AIDCtms): 同步本地目录 143/278（coolingplate），排除超过 20MB 的单体文件
2026-10-02 feat(AIDCtms): 同步本地目录 144/278（coolingplate），排除超过 20MB 的单体文件
2026-10-02 feat(AIDCtms): 同步本地目录 145/278（coolingplate），排除超过 20MB 的单体文件
2026-10-02 feat(AIDCtms): 同步本地目录 146/278（coolingplate），排除超过 20MB 的单体文件
2026-10-02 feat(AIDCtms): 同步本地目录 147/278（coolingplate），排除超过 20MB 的单体文件
2026-10-02 feat(AIDCtms): 同步本地目录 148/278（coolingplate），排除超过 20MB 的单体文件
2026-10-02 feat(AIDCtms): 同步本地目录 149/278（coolingplate），排除超过 20MB 的单体文件
2026-10-02 feat(AIDCtms): 同步本地目录 150/278（coolingplate），排除超过 20MB 的单体文件
2026-10-02 feat(AIDCtms): 同步本地目录 151/278（coolingplate），排除超过 20MB 的单体文件
2026-10-02 feat(AIDCtms): 同步本地目录 152/278（coolingplate），排除超过 20MB 的单体文件
2026-10-02 feat(AIDCtms): 同步本地目录 153/278（coolingplate），排除超过 20MB 的单体文件
2026-10-02 feat(AIDCtms): 同步本地目录 154/278（coolingplate），排除超过 20MB 的单体文件
2026-10-02 feat(AIDCtms): 同步本地目录 155/278（coolingplate），排除超过 20MB 的单体文件
2026-10-02 feat(AIDCtms): 同步本地目录 156/278（coolingplate），排除超过 20MB 的单体文件
2026-10-02 feat(AIDCtms): 同步本地目录 157/278（coolingplate），排除超过 20MB 的单体文件
2026-10-02 feat(AIDCtms): 同步本地目录 158/278（coolingplate），排除超过 20MB 的单体文件
2026-10-02 feat(AIDCtms): 同步本地目录 159/278（coolingplate），排除超过 20MB 的单体文件
2026-10-02 feat(AIDCtms): 同步本地目录 160/278（coolingplate），排除超过 20MB 的单体文件
2026-10-02 feat(AIDCtms): 同步本地目录 161/278（coolingplate），排除超过 20MB 的单体文件
2026-10-02 feat(AIDCtms): 同步本地目录 162/278（coolingplate），排除超过 20MB 的单体文件
2026-10-02 feat(AIDCtms): 同步本地目录 163/278（coolingplate），排除超过 20MB 的单体文件
2026-10-02 feat(AIDCtms): 同步本地目录 164/278（coolingplate），排除超过 20MB 的单体文件
2026-10-02 feat(AIDCtms): 同步本地目录 165/278（coolingplate），排除超过 20MB 的单体文件
2026-10-02 feat(AIDCtms): 同步本地目录 166/278（coolingplate），排除超过 20MB 的单体文件
2026-10-02 feat(AIDCtms): 同步本地目录 167/278（coolingplate），排除超过 20MB 的单体文件
2026-10-02 feat(AIDCtms): 同步本地目录 168/278（coolingplate），排除超过 20MB 的单体文件
2026-10-02 feat(AIDCtms): 同步本地目录 169/278（coolingplate），排除超过 20MB 的单体文件
2026-10-02 feat(AIDCtms): 同步本地目录 170/278（coolingplate），排除超过 20MB 的单体文件
2026-10-02 feat(AIDCtms): 同步本地目录 171/278（coolingplate），排除超过 20MB 的单体文件
2026-10-02 feat(AIDCtms): 同步本地目录 172/278（coolingplate），排除超过 20MB 的单体文件
2026-10-02 feat(AIDCtms): 同步本地目录 173/278（coolingplate），排除超过 20MB 的单体文件
2026-10-02 feat(AIDCtms): 同步本地目录 174/278（coolingplate），排除超过 20MB 的单体文件
2026-10-02 feat(AIDCtms): 同步本地目录 175/278（coolingplate），排除超过 20MB 的单体文件
2026-10-02 feat(AIDCtms): 同步本地目录 176/278（coolingplate），排除超过 20MB 的单体文件
2026-10-02 feat(AIDCtms): 同步本地目录 177/278（coolingplate），排除超过 20MB 的单体文件
2026-10-02 feat(AIDCtms): 同步本地目录 178/278（coolingplate），排除超过 20MB 的单体文件
2026-10-02 feat(AIDCtms): 同步本地目录 179/278（coolingplate），排除超过 20MB 的单体文件
2026-10-02 feat(AIDCtms): 同步本地目录 180/278（coolingplate），排除超过 20MB 的单体文件
2026-10-02 feat(AIDCtms): 同步本地目录 181/278（coolingplate），排除超过 20MB 的单体文件
2026-10-02 feat(AIDCtms): 同步本地目录 182/278（coolingplate），排除超过 20MB 的单体文件
2026-10-02 feat(AIDCtms): 同步本地目录 183/278（coolingplate），排除超过 20MB 的单体文件
2026-10-02 feat(AIDCtms): 同步本地目录 184/278（coolingplate），排除超过 20MB 的单体文件
2026-10-02 feat(AIDCtms): 同步本地目录 185/278（coolingplate），排除超过 20MB 的单体文件
2026-10-02 feat(AIDCtms): 同步本地目录 186/278（coolingplate），排除超过 20MB 的单体文件
2026-10-02 feat(AIDCtms): 同步本地目录 187/278（coolingplate），排除超过 20MB 的单体文件
2026-10-02 feat(AIDCtms): 同步本地目录 188/278（coolingplate），排除超过 20MB 的单体文件
2026-10-02 feat(AIDCtms): 同步本地目录 189/278（coolingplate），排除超过 20MB 的单体文件
2026-10-02 feat(AIDCtms): 同步本地目录 190/278（coolingplate），排除超过 20MB 的单体文件
2026-10-02 feat(AIDCtms): 同步本地目录 191/278（coolingplate），排除超过 20MB 的单体文件
2026-10-02 feat(AIDCtms): 同步本地目录 192/278（coolingplate），排除超过 20MB 的单体文件
2026-10-02 feat(AIDCtms): 同步本地目录 193/278（coolingplate），排除超过 20MB 的单体文件
2026-10-02 feat(AIDCtms): 同步本地目录 194/278（coolingplate），排除超过 20MB 的单体文件
2026-10-02 feat(AIDCtms): 同步本地目录 195/278（coolingplate），排除超过 20MB 的单体文件
2026-10-02 feat(AIDCtms): 同步本地目录 196/278（coolingplate），排除超过 20MB 的单体文件
2026-10-02 feat(AIDCtms): 同步本地目录 197/278（coolingplate），排除超过 20MB 的单体文件
2026-10-02 feat(AIDCtms): 同步本地目录 198/278（coolingplate），排除超过 20MB 的单体文件
2026-10-02 feat(AIDCtms): 同步本地目录 199/278（coolingplate），排除超过 20MB 的单体文件
2026-10-02 feat(AIDCtms): 同步本地目录 200/278（coolingplate），排除超过 20MB 的单体文件
2026-10-02 feat(AIDCtms): 同步本地目录 201/278（coolingplate），排除超过 20MB 的单体文件
2026-10-02 feat(AIDCtms): 同步本地目录 202/278（coolingplate），排除超过 20MB 的单体文件
2026-10-02 feat(AIDCtms): 同步本地目录 203/278（coolingplate），排除超过 20MB 的单体文件
2026-10-02 feat(AIDCtms): 同步本地目录 204/278（coolingplate），排除超过 20MB 的单体文件
2026-10-02 feat(AIDCtms): 同步本地目录 205/278（coolingplate），排除超过 20MB 的单体文件
2026-10-02 feat(AIDCtms): 同步本地目录 206/278（coolingplate），排除超过 20MB 的单体文件
2026-10-02 feat(AIDCtms): 同步本地目录 207/278（coolingplate），排除超过 20MB 的单体文件
2026-10-02 feat(AIDCtms): 同步本地目录 208/278（coolingplate），排除超过 20MB 的单体文件
2026-10-02 feat(AIDCtms): 同步本地目录 209/278（coolingplate），排除超过 20MB 的单体文件
2026-10-02 feat(AIDCtms): 同步本地目录 210/278（coolingplate），排除超过 20MB 的单体文件
2026-10-02 feat(AIDCtms): 同步本地目录 211/278（coolingplate），排除超过 20MB 的单体文件
2026-10-02 feat(AIDCtms): 同步本地目录 212/278（coolingplate），排除超过 20MB 的单体文件
2026-10-02 feat(AIDCtms): 同步本地目录 213/278（coolingplate），排除超过 20MB 的单体文件
2026-10-02 feat(AIDCtms): 同步本地目录 214/278（coolingplate），排除超过 20MB 的单体文件
2026-10-02 feat(AIDCtms): 同步本地目录 215/278（coolingplate），排除超过 20MB 的单体文件
2026-10-02 feat(AIDCtms): 同步本地目录 216/278（coolingplate），排除超过 20MB 的单体文件
2026-10-02 feat(AIDCtms): 同步本地目录 217/278（coolingplate），排除超过 20MB 的单体文件
2026-10-02 feat(AIDCtms): 同步本地目录 218/278（coolingplate），排除超过 20MB 的单体文件
2026-10-02 feat(AIDCtms): 同步本地目录 219/278（coolingplate），排除超过 20MB 的单体文件
2026-10-02 feat(AIDCtms): 同步本地目录 220/278（coolingplate），排除超过 20MB 的单体文件
2026-10-02 feat(AIDCtms): 同步本地目录 221/278（coolingplate），排除超过 20MB 的单体文件
2026-10-02 feat(AIDCtms): 同步本地目录 222/278（coolingplate），排除超过 20MB 的单体文件
    [cu_fins.stp, cu_floor.stp, ov_base.stp, ov_cpu.stp, ov_die.stp, ov_lid.stp, ov_mem.stp, ov_memrib.stp]
2026-10-02 feat(AIDCtms): 同步本地目录 223/278（coolingplate），排除超过 20MB 的单体文件
2026-10-02 feat(AIDCtms): 同步本地目录 224/278（coolingplate），排除超过 20MB 的单体文件
2026-10-02 feat(AIDCtms): 同步本地目录 225/278（coolingplate），排除超过 20MB 的单体文件
2026-10-02 feat(AIDCtms): 同步本地目录 226/278（coolingplate），排除超过 20MB 的单体文件
2026-10-02 feat(AIDCtms): 同步本地目录 227/278（coolingplate），排除超过 20MB 的单体文件
2026-10-02 feat(AIDCtms): 同步本地目录 228/278（coolingplate），排除超过 20MB 的单体文件
2026-10-02 feat(AIDCtms): 同步本地目录 229/278（coolingplate），排除超过 20MB 的单体文件
2026-10-02 feat(AIDCtms): 同步本地目录 230/278（coolingplate），排除超过 20MB 的单体文件
2026-10-02 feat(AIDCtms): 同步本地目录 231/278（coolingplate），排除超过 20MB 的单体文件
2026-10-02 feat(AIDCtms): 同步本地目录 232/278（coolingplate），排除超过 20MB 的单体文件
2026-10-02 feat(AIDCtms): 同步本地目录 233/278（coolingplate），排除超过 20MB 的单体文件
2026-10-02 feat(AIDCtms): 同步本地目录 234/278（coolingplate），排除超过 20MB 的单体文件
2026-10-02 feat(AIDCtms): 同步本地目录 235/278（coolingplate），排除超过 20MB 的单体文件
2026-10-02 feat(AIDCtms): 同步本地目录 236/278（coolingplate），排除超过 20MB 的单体文件
2026-10-02 feat(AIDCtms): 同步本地目录 237/278（coolingplate），排除超过 20MB 的单体文件
2026-10-02 feat(AIDCtms): 同步本地目录 238/278（solutions），排除超过 20MB 的单体文件
2026-10-02 feat(AIDCtms): 同步本地目录 239/278（solutions），排除超过 20MB 的单体文件
2026-10-02 feat(AIDCtms): 同步本地目录 240/278（solutions），排除超过 20MB 的单体文件
2026-10-02 feat(AIDCtms): 同步本地目录 241/278（solutions），排除超过 20MB 的单体文件
2026-10-02 feat(AIDCtms): 同步本地目录 242/278（solutions），排除超过 20MB 的单体文件
2026-10-02 feat(AIDCtms): 同步本地目录 243/278（solutions），排除超过 20MB 的单体文件
2026-10-02 feat(AIDCtms): 同步本地目录 244/278（solutions），排除超过 20MB 的单体文件
2026-10-02 feat(AIDCtms): 同步本地目录 245/278（solutions），排除超过 20MB 的单体文件
2026-10-02 feat(AIDCtms): 同步本地目录 246/278（solutions），排除超过 20MB 的单体文件
2026-10-02 feat(AIDCtms): 同步本地目录 247/278（solutions），排除超过 20MB 的单体文件
2026-10-02 feat(AIDCtms): 同步本地目录 248/278（solutions），排除超过 20MB 的单体文件
2026-10-02 feat(AIDCtms): 同步本地目录 249/278（solutions），排除超过 20MB 的单体文件
2026-10-02 feat(AIDCtms): 同步本地目录 250/278（solutions），排除超过 20MB 的单体文件
2026-10-02 feat(AIDCtms): 同步本地目录 251/278（solutions），排除超过 20MB 的单体文件
2026-10-02 feat(AIDCtms): 同步本地目录 252/278（solutions），排除超过 20MB 的单体文件
2026-10-02 feat(AIDCtms): 同步本地目录 253/278（solutions），排除超过 20MB 的单体文件
2026-10-02 feat(AIDCtms): 同步本地目录 254/278（solutions），排除超过 20MB 的单体文件
2026-10-02 feat(AIDCtms): 同步本地目录 255/278（solutions），排除超过 20MB 的单体文件
2026-10-02 feat(AIDCtms): 同步本地目录 256/278（solutions），排除超过 20MB 的单体文件
2026-10-02 feat(AIDCtms): 同步本地目录 257/278（solutions），排除超过 20MB 的单体文件
2026-10-02 feat(AIDCtms): 同步本地目录 258/278（solutions），排除超过 20MB 的单体文件
2026-10-02 feat(AIDCtms): 同步本地目录 259/278（solutions），排除超过 20MB 的单体文件
2026-10-02 feat(AIDCtms): 同步本地目录 260/278（solutions），排除超过 20MB 的单体文件
2026-10-02 feat(AIDCtms): 同步本地目录 261/278（solutions），排除超过 20MB 的单体文件
2026-10-02 feat(AIDCtms): 同步本地目录 262/278（solutions），排除超过 20MB 的单体文件
2026-10-02 feat(AIDCtms): 同步本地目录 263/278（solutions），排除超过 20MB 的单体文件
2026-10-02 feat(AIDCtms): 同步本地目录 264/278（solutions），排除超过 20MB 的单体文件
2026-10-02 feat(AIDCtms): 同步本地目录 265/278（solutions），排除超过 20MB 的单体文件
2026-10-02 feat(AIDCtms): 同步本地目录 266/278（solutions），排除超过 20MB 的单体文件
2026-10-02 feat(AIDCtms): 同步本地目录 267/278（solutions），排除超过 20MB 的单体文件
2026-10-02 feat(AIDCtms): 同步本地目录 268/278（solutions），排除超过 20MB 的单体文件
2026-10-02 feat(AIDCtms): 同步本地目录 269/278（solutions），排除超过 20MB 的单体文件
2026-10-02 feat(AIDCtms): 同步本地目录 270/278（solutions），排除超过 20MB 的单体文件
2026-10-02 feat(AIDCtms): 同步本地目录 271/278（solutions），排除超过 20MB 的单体文件
2026-10-02 feat(AIDCtms): 同步本地目录 272/278（solutions），排除超过 20MB 的单体文件
2026-10-02 feat(AIDCtms): 同步本地目录 273/278（solutions），排除超过 20MB 的单体文件
2026-10-02 feat(AIDCtms): 同步本地目录 274/278（solutions），排除超过 20MB 的单体文件
2026-10-02 feat(AIDCtms): 同步本地目录 275/278（solutions），排除超过 20MB 的单体文件
2026-10-02 feat(AIDCtms): 同步本地目录 276/278（solutions），排除超过 20MB 的单体文件
2026-10-02 feat(AIDCtms): 同步本地目录 277/278（solutions），排除超过 20MB 的单体文件
2026-10-02 feat(AIDCtms): 同步本地目录 278/278（solutions），排除超过 20MB 的单体文件
